pvrezende/Dashboard/public/img/rosqueadeira.png

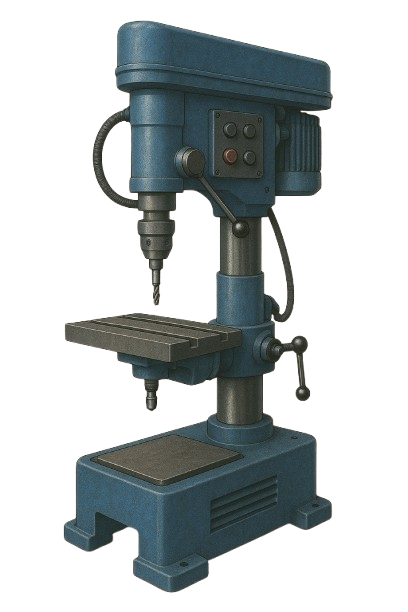
public/img/rosqueadeira.png
