pvrezende/Dashboard/public/img/torno.png

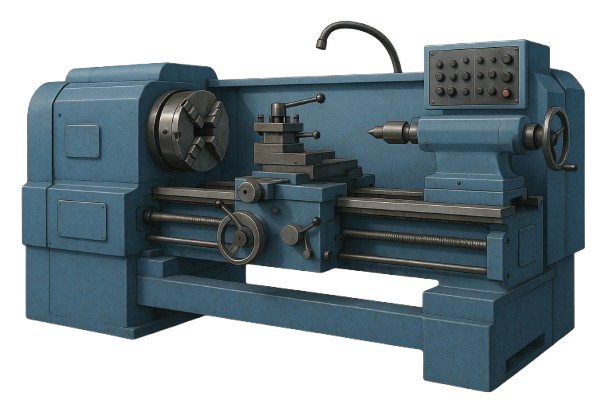
public/img/torno.png
