pvrezende/Dashboard/uploads/anexo-1752686390000-433832440.pdf

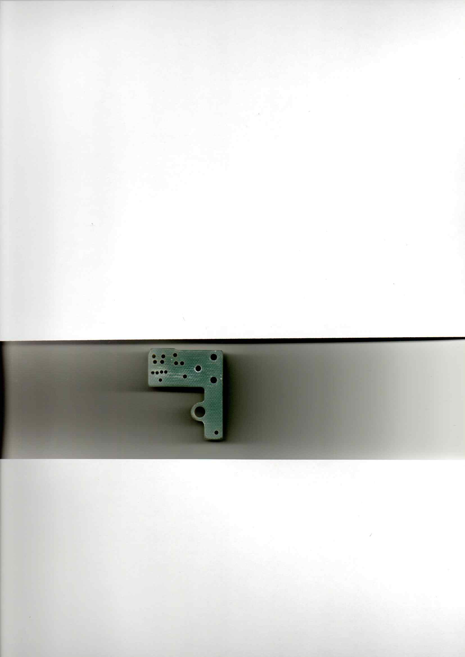
[picture p3: page 1]
