pvrezende/Dashboard/public/img/fresagem.png

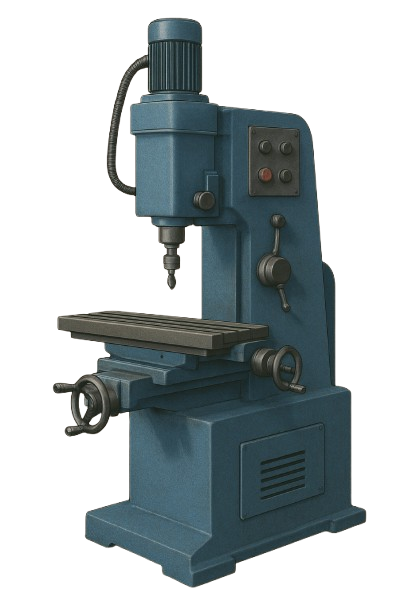
public/img/fresagem.png
