pvrezende/Dashboard/public/img/serra.png

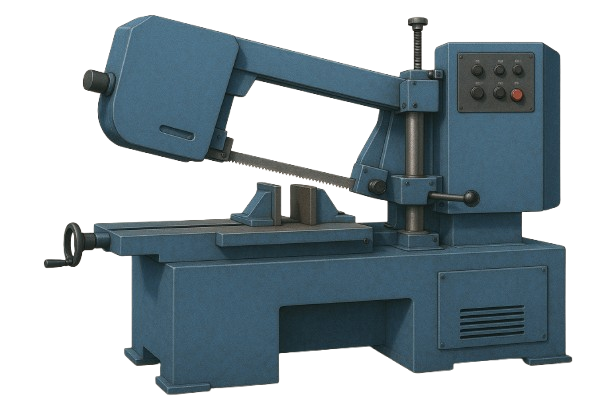
public/img/serra.png
