pvrezende/Dashboard/public/img/usinagem.png

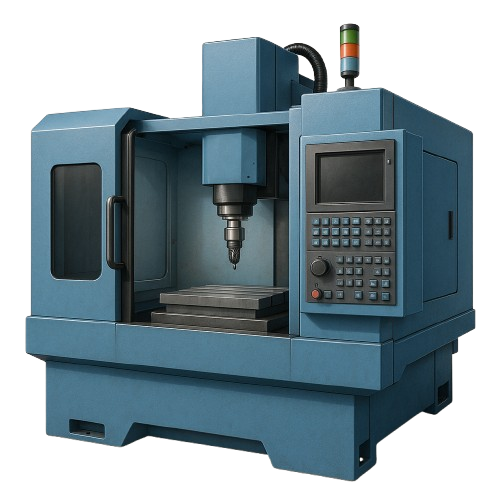
public/img/usinagem.png
