pvrezende/Dashboard/uploads/anexo-1753989220200-650113671.png

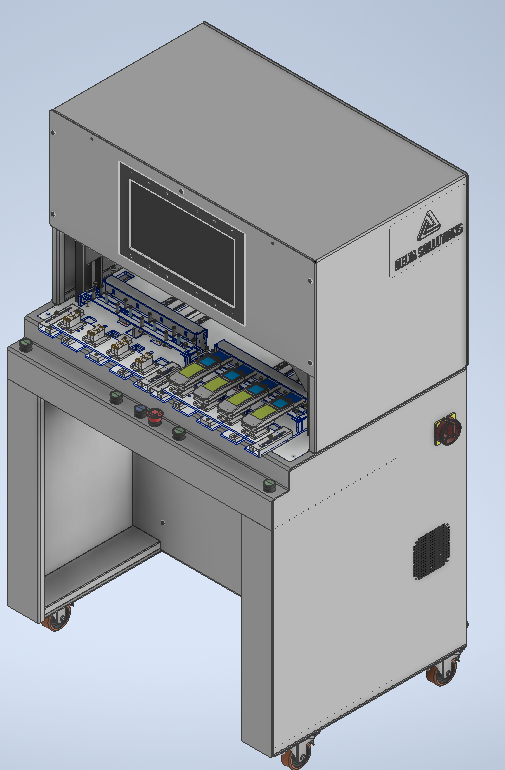
uploads/anexo-1753989220200-650113671.png
