pvrezende/Dashboard/uploads/shoppingFiles-1759435416785-901316125.xlsx

DOCUMENTO DE ESPECIFICAÇÃO DE COMPRAS |  |  |  | DATA: | 2024-10-07 | Codigo/ Revisão: FO-PR-005.A9/03
 |  |  |  | AREA SOLICITTANTE: | Automação
 |  |  |  | SOLICITANTE: | Matheus Coelho Cardoso
 |  |  |  | PROJETO: | TESTADOR DE CONTROLE - MIDEA
ITEM | CÓDIGO DO FABRICANTE | DESCRIÇÃO COMPLETA DO ITEM | U.M. | QUANTIDADE | FOTO DO ITEM | JUSTIFICATIVA DE AQUISIÇÃO | VALOR UNITÁRIO | VALOR TOTAL | STATUS
 | Ou Link | (Em caso de itens internacionais descrição em inglês)
1 | https://produto.mercadolivre.com.br/MLB-3895741120-modulo-pwm-de-alta-potncia-mosfet-400w-15a-_JM | Módulo Pwm De Alta Potência Mosfet 400w 15a |  | 10 |  | Relé PWM | R$15.99 | R$159.90
2 | https://produto.mercadolivre.com.br/MLB-2219533485-fonte-de-alimentaco-chaveada-120w-24v-5a-110-220v-_JM | Fonte De Alimentação Chaveada 120w 24v 5a 110-220v |  | 2 |  | Alimentação de 24V | R$33.90 | R$67.80
 | https://produto.mercadolivre.com.br/MLB-3361664873-fonte-chaveada-3v-colmeia-5a-industrial-bivolt-_JM | Fonte Chaveada 3v Colméia 5a Industrial Bivolt |  | 2 |  | Alimentação 3V | R$69.90 | R$139.80
 | https://www.mercadolivre.com.br/fonte-de-alimentaco-chaveada-500w-48v-10a-127-220v-bivolt/p/MLB29554100 | Fonte De Alimentação Chaveada 500w 48v 10a 127-220v Bivolt |  | 2 |  | Alimentação de 48V | R$125.00 | R$150.00
3 | https://www.mercadolivre.com.br/fonte-chaveada-5v-10a-50w-luckfoyu-tb-1605-bivolt-colmeia/p/MLB27683408 | Fonte Chaveada 5v 10a 50w Luckfoyu Tb-1605 Bivolt Colmeia |  | 2 |  | Alimentação de 5V | R$90.00 | R$180.00
 | https://produto.mercadolivre.com.br/MLB-3699531706-placa-mega-2560-pro-mini-atmega2560-compativel-com-arduino-_JM | Placa Mega 2560 Pro Mini Atmega2560 (compatível Com Arduino) |  | 2 |  | Microcontrolador | R$149.00 | R$298.00
 | https://produto.mercadolivre.com.br/MLB-1458934990-placa-nano-v3-com-suporte-borne-cabo-usb-compativel-arduino-_JM | Placa Nano V3 Com Suporte Borne, Cabo Usb Compatível Arduino |  | 8 |  | Arduinos Nano | R$53.57 | R$428.56
 | https://www.mercadolivre.com.br/boto-emergncia-cogumelo-vermelho-com-trava-1nf-22mm-1un/p/MLB29551151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 | Botão Emergência Cogumelo Vermelho Com Trava 1nf 22mm - 1un |  | 2 |  | Parada de Emergência | R$21.65 | R$43.30
 | https://www.mercadolivre.com.br/botao-de-impulso-plastico-verde-22mm-1na-brasiltec/p/MLB32004990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 | Botao De Impulso Plastico Verde 22mm 1na Brasiltec |  | 4 |  | Acionamento | R$17.50 | R$70.00
 | https://oceantech-automation.com.br/produtos/easy-servo-22kgf-nema-23-2-2n-m/ | Kit Motor De Passo 22kgf.cm Com Encoder (easy Servo)+ Driver |  | 2 |  | Servo Driver +Motor | R$640.00 | R$1280.00
 | https://produto.mercadolivre.com.br/MLB-3294397093-valvula-solenoidemola-52-vias-rosca-14-pneumatica-24v-dc-_JM | Válvula Solenoide/mola 5/2 Vias Rosca 1/4 Pneumática 24v Dc |  | 2 |  | Acionamento e Segurança do Pistão | R$63.89 | R$127.78
 | (NÃO ACHEI NA INTERNET PRA VENDA) | PLACA BORNE MEGA |  | 2 |  | Placa Borne para arduino mega |  | R$0.00
 | https://produto.mercadolivre.com.br/MLB-4553267862-micro-pc-lenovo-m900-i5-6500t-ddr4-16gb-ssd-512gb-wifi-_JM | Micro Pc Lenovo M900 I5-6500t, Ddr4 16gb, Ssd 512gb, Wifi |  | 2 |  | Mini-PC | R$1599.00 | R$3198.00
 | https://produto.mercadolivre.com.br/MLB-2727300538-tela-lcd-de-7-polegadas-para-raspberry-pi4-touch-1024x600-_JM | Tela Lcd De 7 Polegadas Para Raspberry Pi4 Touch 1024x600 |  | 2 |  | Tela | R$549.00 | R$1098.00
 | https://produto.mercadolivre.com.br/MLB-4379692838-kit-525x-resistores-17-valores-14w-1-0-ohm-1m-ohm-_JM | Kit 525x Resistores 17 Valores 1/4w 1% 0 Ohm ~ 1m Ohm |  | 2 |  | Kit de resistores | R$62.00 | R$124.00
 | https://produto.mercadolivre.com.br/MLB-1292249125-4x-fim-de-curso-optico-impressora-3d-cabo-50cm-endstop-_JM | 4x Fim De Curso Óptico Impressora 3d Cabo 50cm Endstop |  | 2 |  | Sensor optico | R$42.40 | R$84.80
 | https://www.mercadolivre.com.br/modulo-rele-1-canal-led-indicador-para-arduino-pi-pic-5v10a/p/MLB35503346 | Modulo Rele 1 Canal Led Indicador Para Arduino Pi Pic 5v/10a |  | 2 |  | Relé acionamento GND | R$12.35 | R$24.70
 | https://www.mercadolivre.com.br/chave-gangorra-iluminada-liga-desliga-4-polos-110220v/p/MLB23519608 | Chave Gangorra Iluminada Liga Desliga 4 Pólos 110/220v |  | 2 |  | Usinagem de peças para máquina | R$11.30 | R$22.60
 | Sinaleiro Led Vermelho Monobloco 127/220v 22mm | MercadoLivre (https://produto.mercadolivre.com.br/MLB-3207978312-sinaleiro-led-vermelho-monobloco-127220v-22mm-_JM) | Sinaleiro De Led Vermelho Weg 22mm 220vca Ip54 Cew-sm1-d23 |  | 2 |  | Sinalizador LED | R$15.00 | R$30.00
 | https://produto.mercadolivre.com.br/MLB-1710785661-par-conector-mike-gx12-plug-macho-fmea-6-pinos-cabo-cabo-_JM | Par Conector Mike Gx12 Plug Macho + Fêmea 6 Pinos Cabo-cabo |  | 2 |  | Conector Mike | R$32.81 | R$65.62
 | https://produto.mercadolivre.com.br/MLB-2751476071-micro-ventilador-cooler-80x80x25-cooler-24v-020a-80mm-_JM | Micro Ventilador Cooler 80x80x25 Cooler 24v 0,20a 80mm |  | 1 |  | Ventoinha | R$19.00 | R$19.00
 | https://www.mercadolivre.com.br/webcam-full-hd-logitech-c920s-com-microfone-embutido-cor-preto/p/MLB18351904 | Webcam Full Hd Logitech C920s Com Microfone Embutido Cor Preto |  | 8 |  | Câmeras | R$499.00 | R$3992.00
 | https://produto.mercadolivre.com.br/MLB-4545673406-borne-saki-de-passagem-25mm-eletrico-kit-100-unidades-_JM | Borne Saki De Passagem 2,5mm Elétrico - Kit 100 Unidades |  | 1 |  | Bornes | R$163.00 | R$163.00
 | https://produto.mercadolivre.com.br/MLB-3649127615-kit-alicate-crimpar-descascador-1200-terminais-ilhos-tubular-_JM | Kit Alicate Crimpar Descascador 1200 Terminais Ilhós Tubular |  | 1 |  | Materiais para manusear | R$124.99 | R$124.99
 | https://www.mercadolivre.com.br/ugreen-cabo-de-celular-carga-rapida-turbo-micro-usb-v8-1m/p/MLB22989129 | Ugreen Cabo De Celular Carga Rápida Turbo Micro Usb V8 1m |  | 4 |  | 1 Cabo pro arduino, outro cabo pro PC | R$29.35 | R$117.40
 | https://produto.mercadolivre.com.br/MLB-1773070278-conexo-pneumatica-emenda-passa-muro-unio-painel-6mm-4pcs-_JM | Conexão Pneumática Emenda Passa Muro União Painel Ø6mm 4pçs |  | 2 |  | Conexão Pneumatica | R$37.04 | R$74.08
 | https://www.mercadolivre.com.br/tomada-p-moveis-embutir-margirius-2p-t-branca-20a-250v/p/MLB22760926 | Tomada P/ Moveis Embutir Margirius 2p T Branca 20a 250v |  | 2 |  | Tomada pra fixar a alimentação do PC | R$16.97 | R$33.94
 |  |  |  |  |  |  |  | R$0.00
 |  |  |  |  |  |  |  | R$0.00
 |  |  |  |  |  |  |  | R$0.00
 |  |  |  |  |  |  |  | R$0.00
 |  |  |  |  |  |  |  | R$0.00
 |  |  |  |  |  |  | R$3.00 | R$0.00
 |  |  |  |  |  |  | R$4.00 | R$0.00
 |  |  |  |  |  |  | R$5.00 | R$0.00
