pvrezende/Dashboard/uploads/shoppingFiles-1759509647916-797304005.xlsx

Fornecedor | Material ou Produto | Quantidade | Valor Unitário (R$) | Valor Total (R$)
Fornecedor TechSoft | Licença Sistema ERP | 10 | 1200 | 12000
Fornecedor CloudX | Serviço de Hospedagem Cloud | 12 | 300 | 3600
Fornecedor HardPlus | Notebooks para Desenvolvedores | 5 | 4500 | 22500
Metalúrgica Alfa | Chapas de Aço Inox (m²) | 15 | 250 | 3750
Parafusos & Cia | Parafusos Allen M6 (caixa c/ 100) | 20 | 80 | 1600
Rolamentos Mundial | Rolamentos Industriais SKF 6205 | 50 | 45 | 2250
Usinagem Express | Serviço de Usinagem de Peças | 1 | 3500 | 3500
Pneumática Brasil | Cilindro Pneumático Dupla Ação | 10 | 180 | 1800
