pvrezende/Dashboard/uploads/anexo-1755619367089-582211943.stp

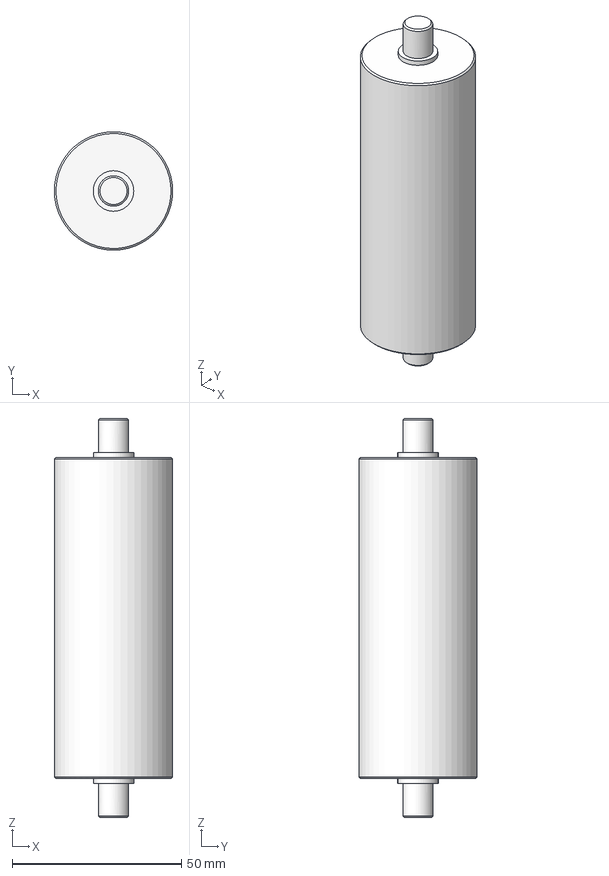
[picture p8: CAD file, 2025-12-10]
uploads/anexo-1755619367089-582211943.stp
35.0 x 35.0 x 118.0 mm
