pvrezende/Dashboard/uploads/anexo-1755977767421-222420170.stp

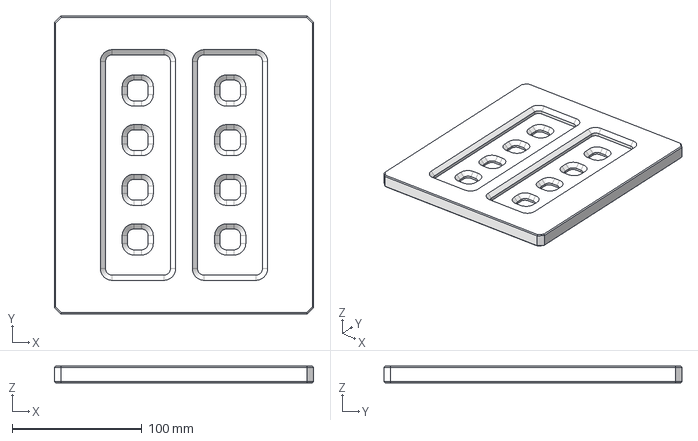
[picture p9: CAD file, 2025-12-10]
uploads/anexo-1755977767421-222420170.stp
200.0 x 230.0 x 13.0 mm
