pvrezende/Dashboard/uploads/anexo-1759258993743-352252495.stp

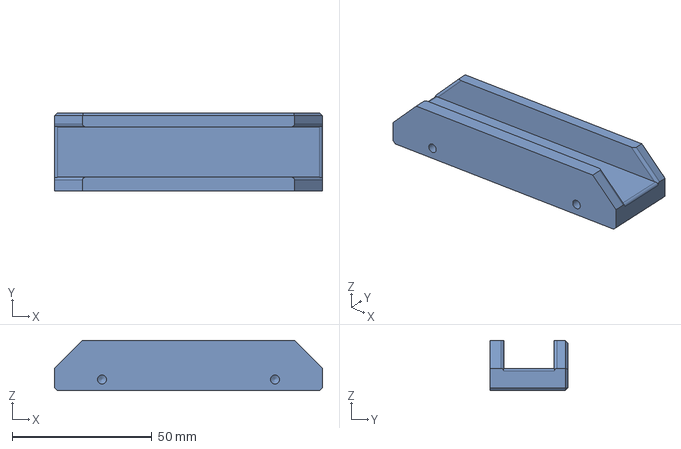
[picture p10: CAD file, 2025-12-10]
uploads/anexo-1759258993743-352252495.stp
96.0 x 28.0 x 18.0 mm
