pvrezende/Dashboard/uploads/anexo-1759407413389-112260703.stp

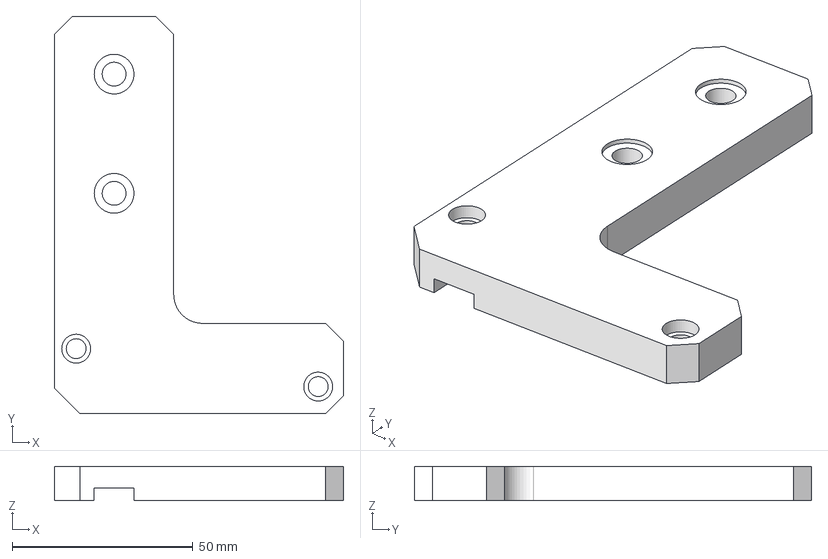
[picture p11: CAD file, 2025-12-10]
uploads/anexo-1759407413389-112260703.stp
80.0 x 110.0 x 9.50 mm
