pvrezende/Dashboard/uploads/anexo-1755277294046-452424517.stp

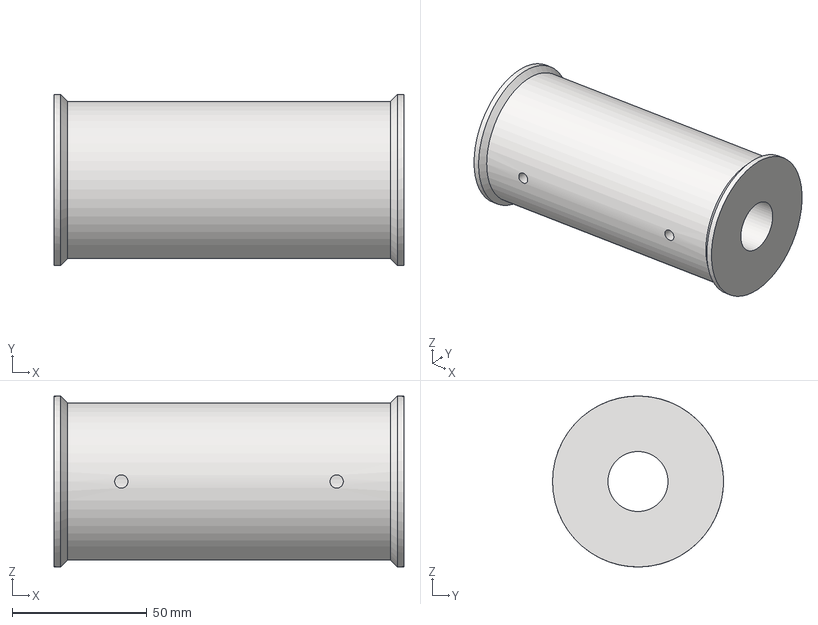
[picture p12: CAD file, 2025-12-10]
uploads/anexo-1755277294046-452424517.stp
130.0 x 63.5 x 63.5 mm
