pvrezende/Dashboard/uploads/anexo-1756152582463-837896890.stp

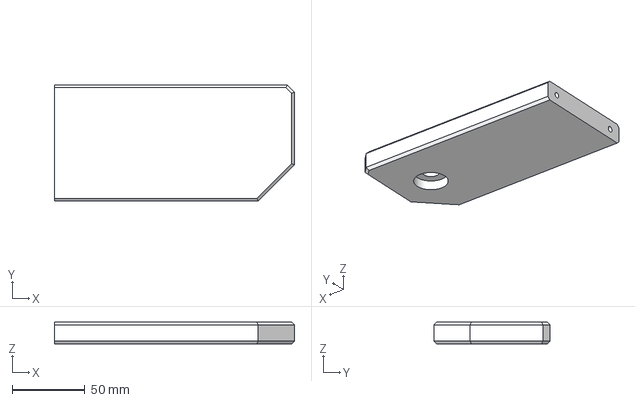
[picture p13: CAD file, 2025-12-10]
uploads/anexo-1756152582463-837896890.stp
165.0 x 80.0 x 15.0 mm
