pvrezende/Dashboard/uploads/anexo-1756211929346-225866010.stp

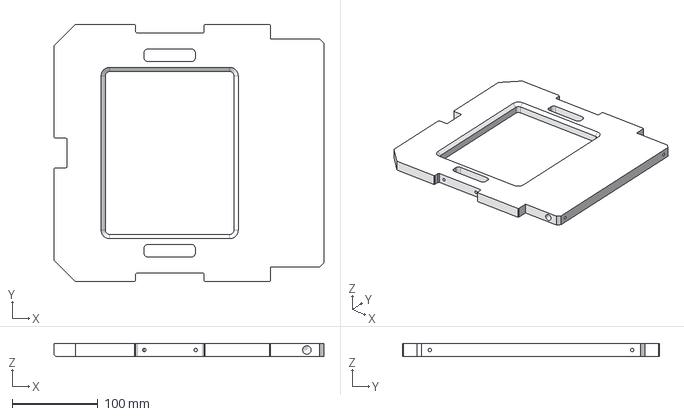
[picture p14: CAD file, 2025-12-10]
uploads/anexo-1756211929346-225866010.stp
315.0 x 300.0 x 15.0 mm
