pvrezende/Dashboard/uploads/anexo-1757349374916-749535354.stp

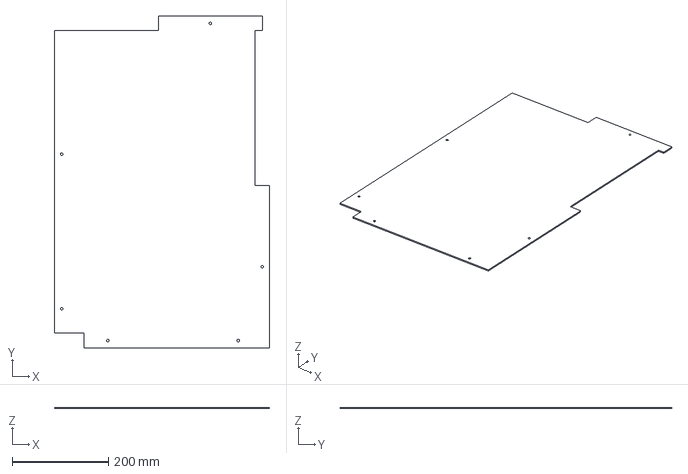
[picture p15: CAD file, 2025-12-10]
uploads/anexo-1757349374916-749535354.stp
447.5 x 690.0 x 3.00 mm
