pvrezende/Dashboard/uploads/anexo-1757426994277-990236841.stp

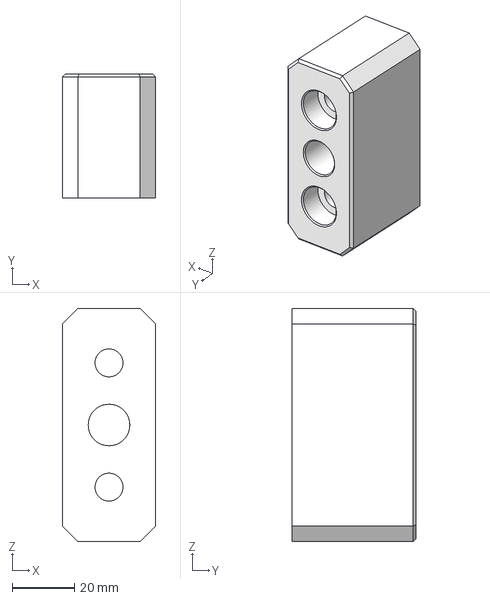
[picture p16: CAD file, 2025-12-10]
uploads/anexo-1757426994277-990236841.stp
30.0 x 40.0 x 75.0 mm
