pvrezende/Dashboard/uploads/anexo-1757960000784-294846937.stp

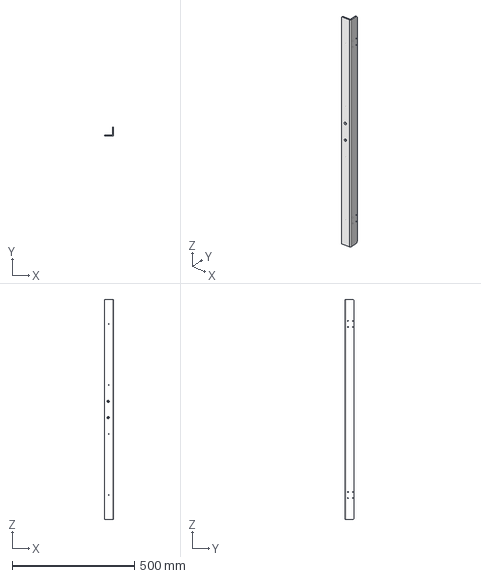
[picture p17: CAD file, 2025-12-10]
uploads/anexo-1757960000784-294846937.stp
38.0 x 38.0 x 900.0 mm
