pvrezende/Dashboard/uploads/anexo-1757949830074-938760294.stp

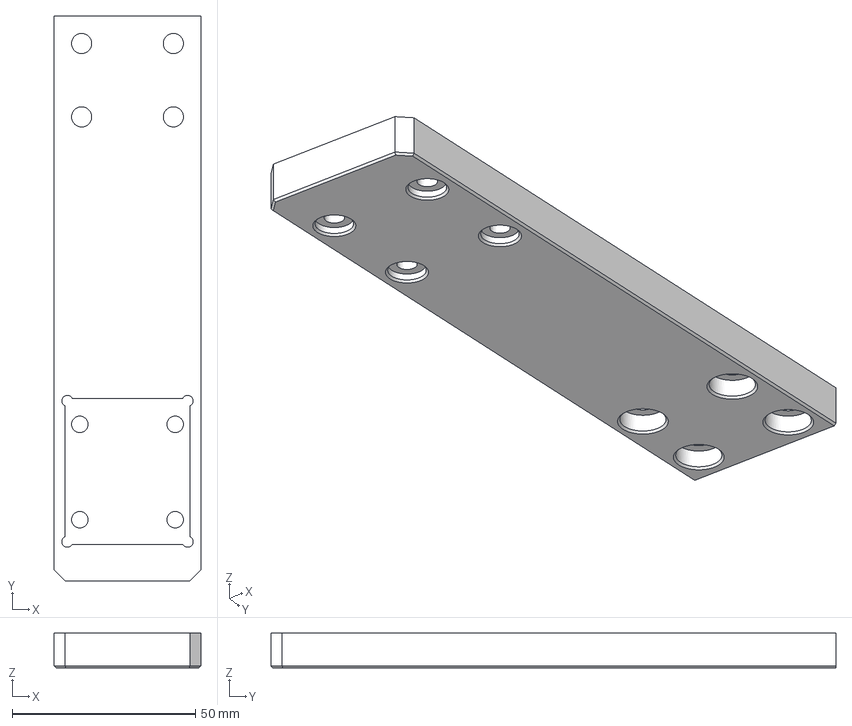
[picture p18: CAD file, 2025-12-10]
uploads/anexo-1757949830074-938760294.stp
40.0 x 154.0 x 9.50 mm
