pvrezende/Dashboard/uploads/anexo-1756295821508-154803163.stp

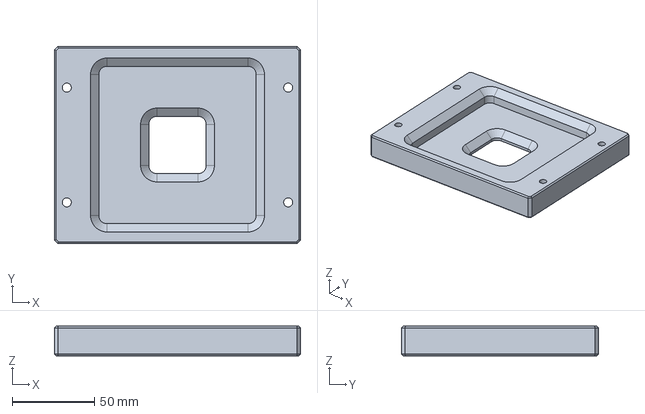
[picture p19: CAD file, 2025-12-10]
uploads/anexo-1756295821508-154803163.stp
150.0 x 120.0 x 18.0 mm
