pvrezende/Dashboard/uploads/anexo-1759337285169-542138132.stp

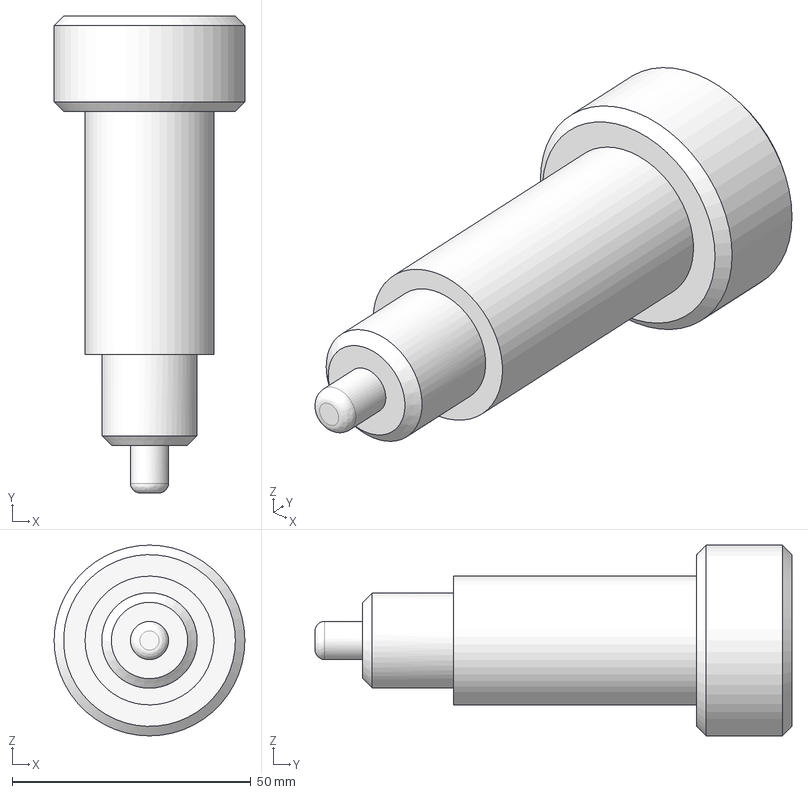
[picture p20: CAD file, 2025-12-10]
uploads/anexo-1759337285169-542138132.stp
40.0 x 100.0 x 40.0 mm
