pvrezende/Dashboard/uploads/anexo-1759334856701-153851195.stp

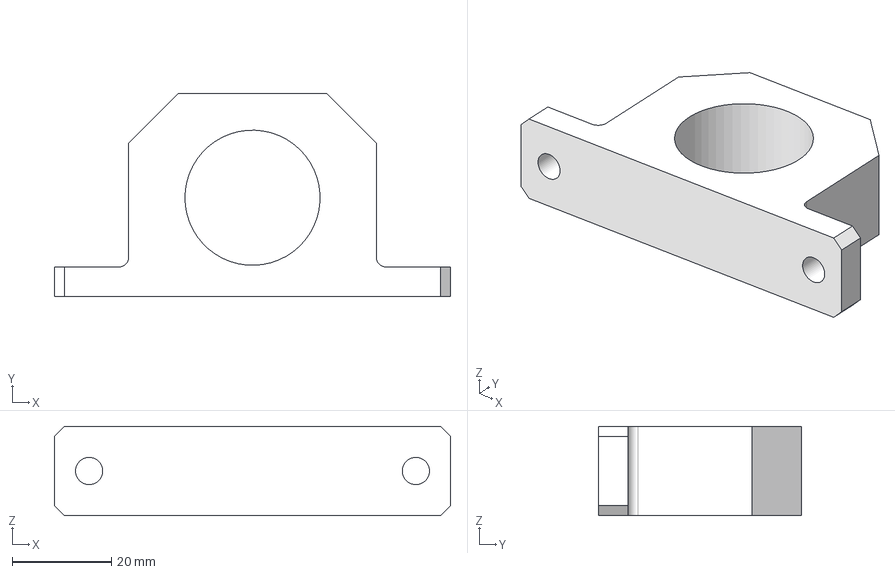
[picture p21: CAD file, 2025-12-10]
uploads/anexo-1759334856701-153851195.stp
80.0 x 41.1 x 18.0 mm
