pvrezende/Dashboard/uploads/anexo-1755618676830-448197962.stp

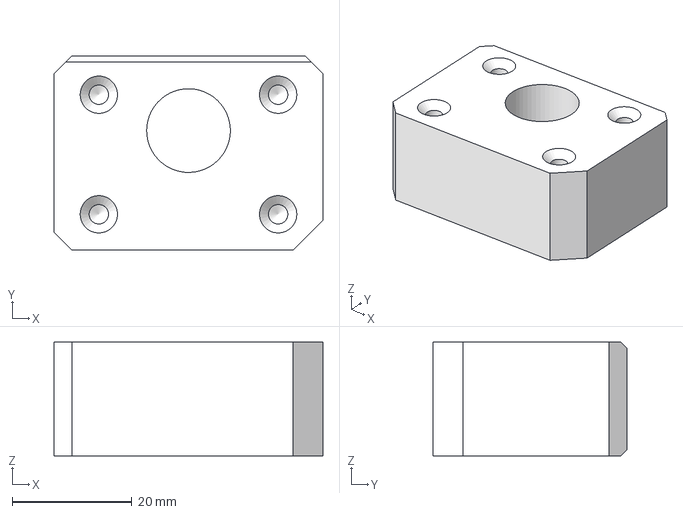
[picture p22: CAD file, 2025-12-10]
uploads/anexo-1755618676830-448197962.stp
45.0 x 32.5 x 19.0 mm
