pvrezende/Dashboard/uploads/anexo-1756234700509-750401032.stp

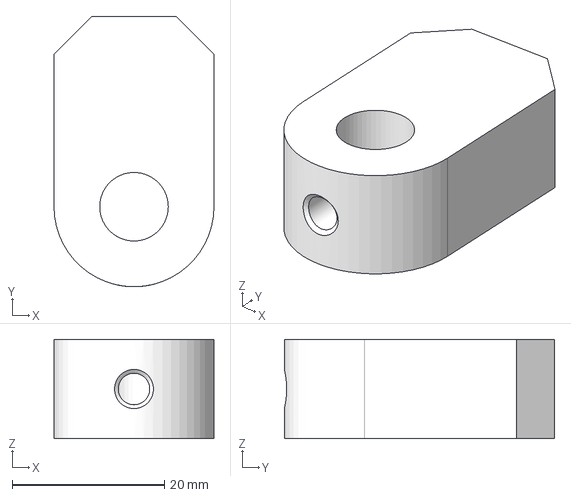
[picture p23: CAD file, 2025-12-10]
uploads/anexo-1756234700509-750401032.stp
21.0 x 35.5 x 13.0 mm
