pvrezende/Dashboard/uploads/anexo-1759334679638-42704749.stp

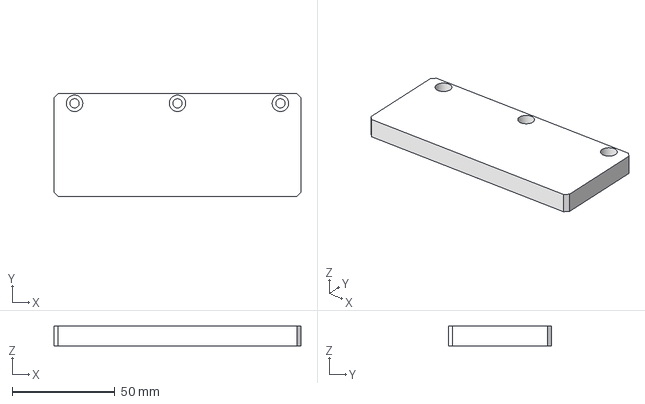
[picture p25: CAD file, 2025-12-10]
uploads/anexo-1759334679638-42704749.stp
120.0 x 50.0 x 9.50 mm
