pvrezende/Dashboard/uploads/anexo-1756231120353-109292809.stp

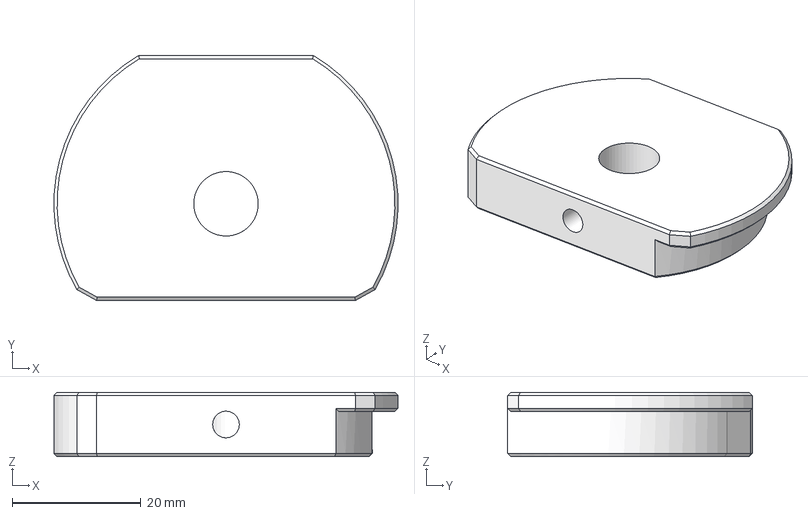
[picture p26: CAD file, 2025-12-10]
uploads/anexo-1756231120353-109292809.stp
53.4 x 38.0 x 10.0 mm
