pvrezende/Dashboard/uploads/anexo-1757434504783-396487660.stp

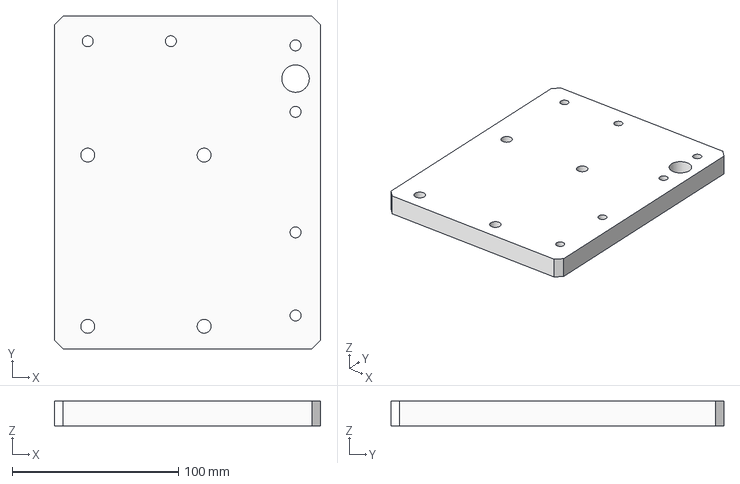
[picture p27: CAD file, 2025-12-10]
uploads/anexo-1757434504783-396487660.stp
160.0 x 200.0 x 15.0 mm
