pvrezende/Dashboard/uploads/anexo-1759259124389-321376581.stp

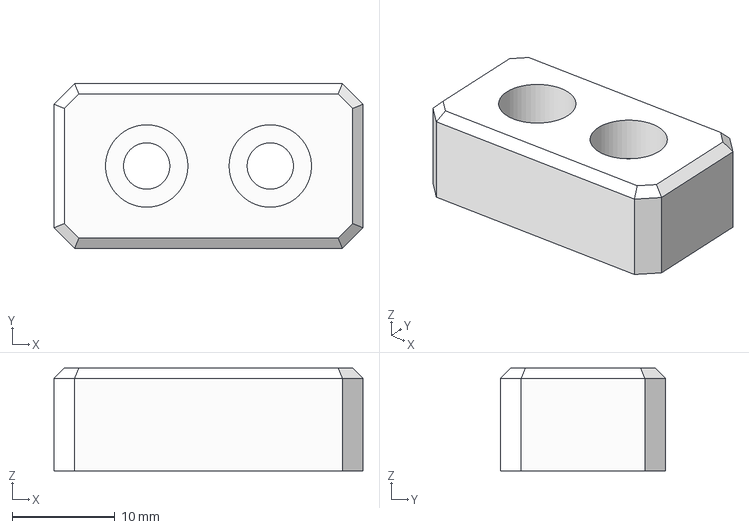
[picture p28: CAD file, 2025-12-10]
uploads/anexo-1759259124389-321376581.stp
30.0 x 16.0 x 10.0 mm
