pvrezende/Dashboard/uploads/anexo-1759259096695-601353581.stp

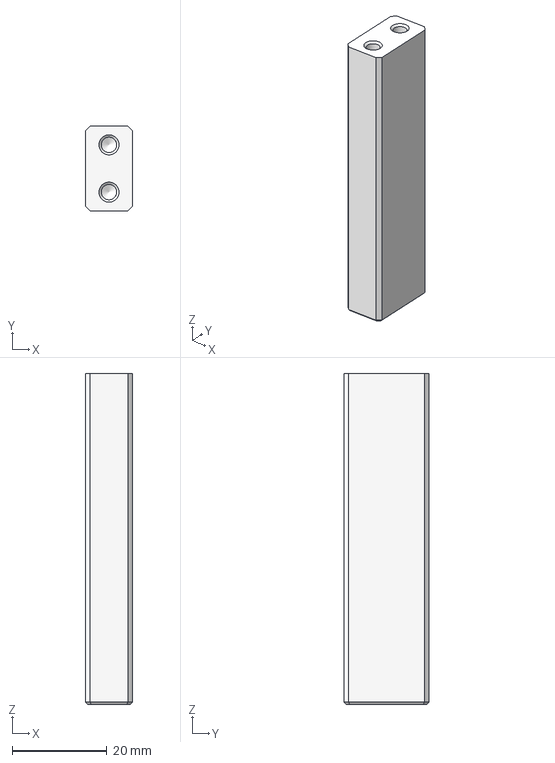
[picture p29: CAD file, 2025-12-10]
uploads/anexo-1759259096695-601353581.stp
10.0 x 18.0 x 70.0 mm
