pvrezende/Dashboard/uploads/anexo-1756388202260-343038873.stp

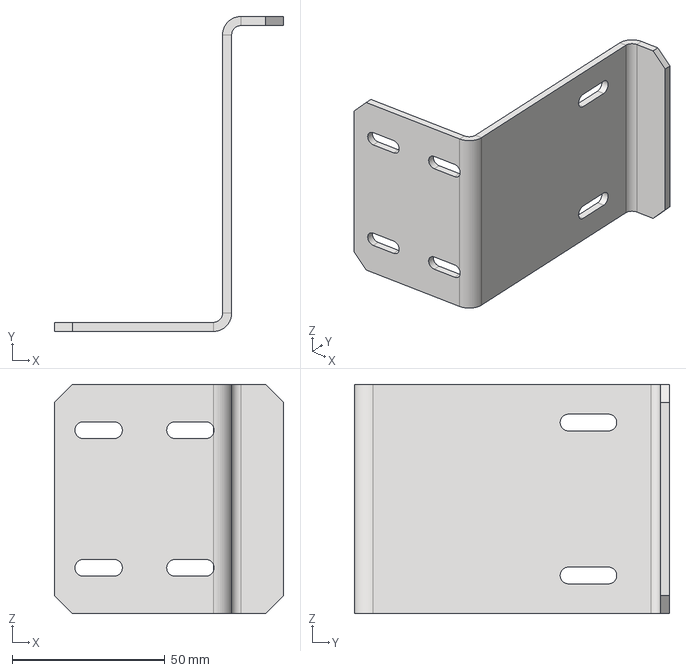
[picture p30: CAD file, 2025-12-10]
uploads/anexo-1756388202260-343038873.stp
75.0 x 103.0 x 75.0 mm
