pvrezende/Dashboard/uploads/anexo-1756215425746-165723948.stp

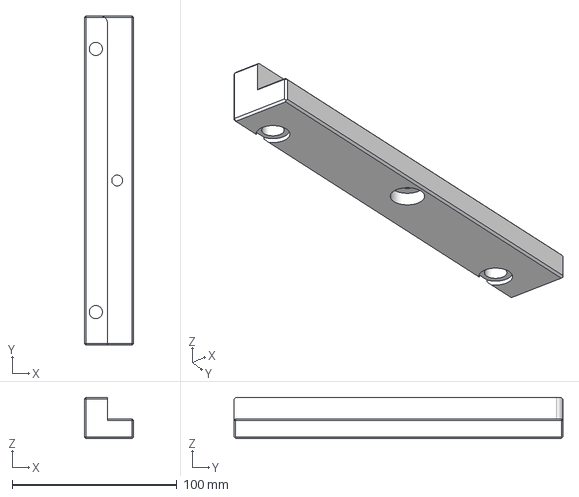
[picture p31: CAD file, 2025-12-10]
uploads/anexo-1756215425746-165723948.stp
30.0 x 200.0 x 25.0 mm
