pvrezende/Dashboard/uploads/anexo-1755282715223-240659663.stp

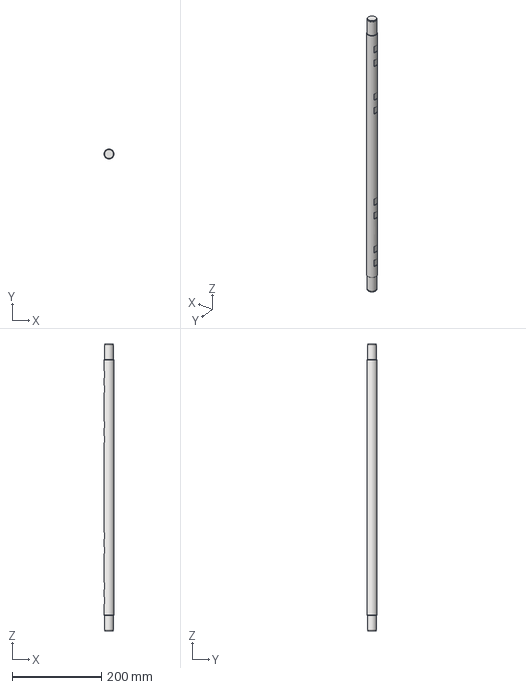
[picture p32: CAD file, 2025-12-10]
uploads/anexo-1755282715223-240659663.stp
22.3 x 22.3 x 644.0 mm
