pvrezende/Dashboard/uploads/anexo-1758050456845-185655093.stp

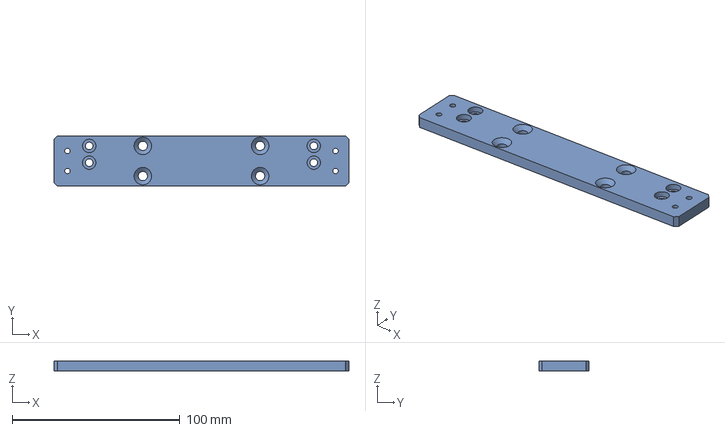
[picture p33: CAD file, 2025-12-10]
uploads/anexo-1758050456845-185655093.stp
176.0 x 30.0 x 6.00 mm
