pvrezende/Dashboard/uploads/anexo-1757961930850-707648905.stp

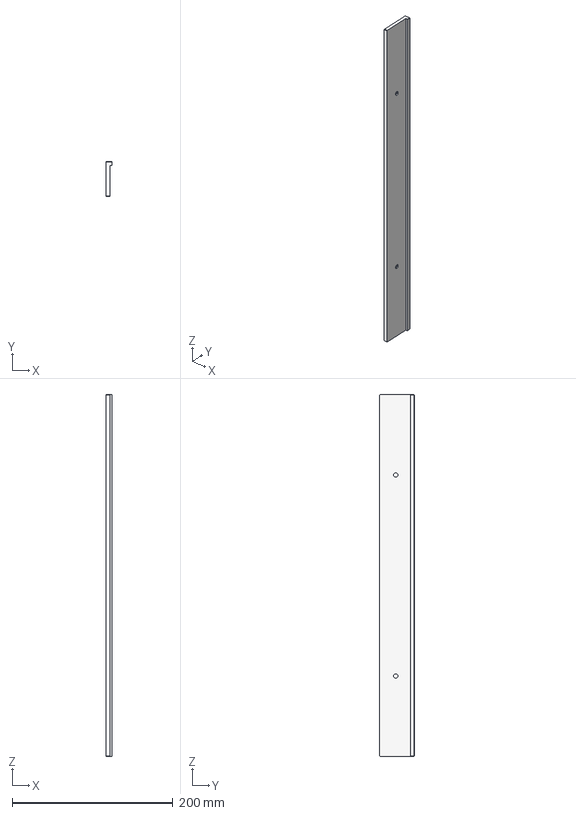
[picture p34: CAD file, 2025-12-10]
uploads/anexo-1757961930850-707648905.stp
8.00 x 43.0 x 450.0 mm
