pvrezende/Dashboard/uploads/anexo-1757965723555-153832355.stp

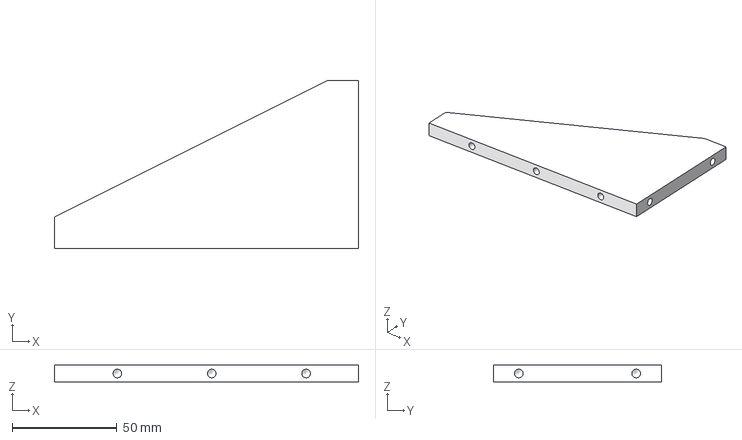
[picture p35: CAD file, 2025-12-10]
uploads/anexo-1757965723555-153832355.stp
145.0 x 80.0 x 8.00 mm
