pvrezende/Dashboard/uploads/anexo-1757431539895-93531511.stp

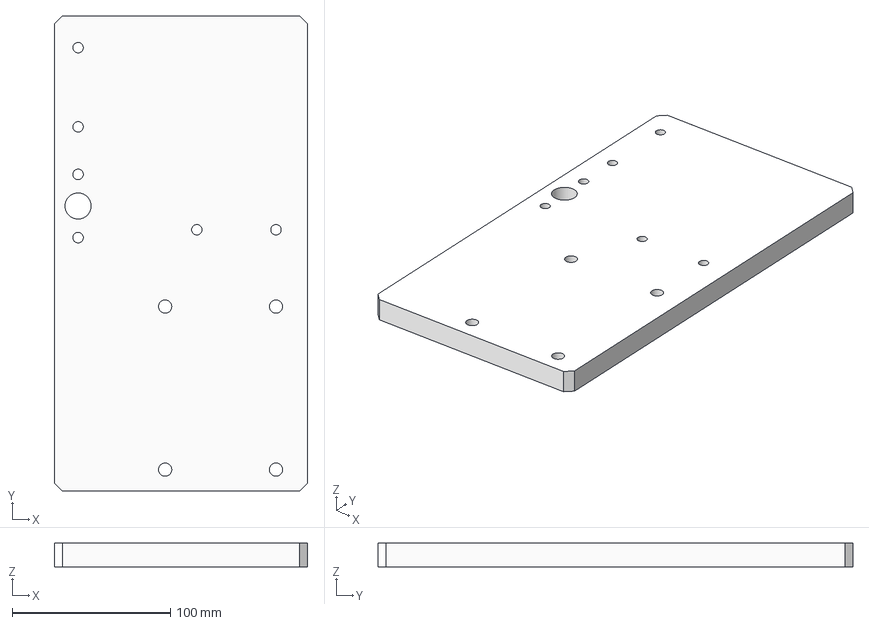
[picture p36: CAD file, 2025-12-10]
uploads/anexo-1757431539895-93531511.stp
160.0 x 300.0 x 15.0 mm
