pvrezende/Dashboard/uploads/anexo-1759258910165-679916647.stp

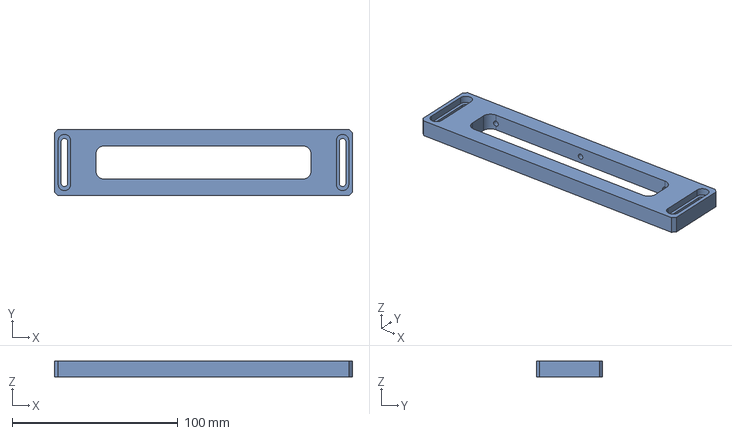
[picture p37: CAD file, 2025-12-10]
uploads/anexo-1759258910165-679916647.stp
180.0 x 40.0 x 9.50 mm
