pvrezende/Dashboard/uploads/anexo-1755960413573-520957161.stp

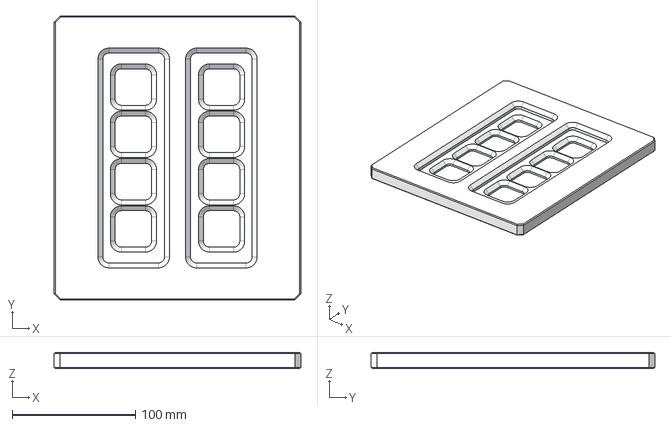
[picture p38: CAD file, 2025-12-10]
uploads/anexo-1755960413573-520957161.stp
200.0 x 230.0 x 13.0 mm
