pvrezende/Dashboard/uploads/anexo-1757965014062-793213751.stp

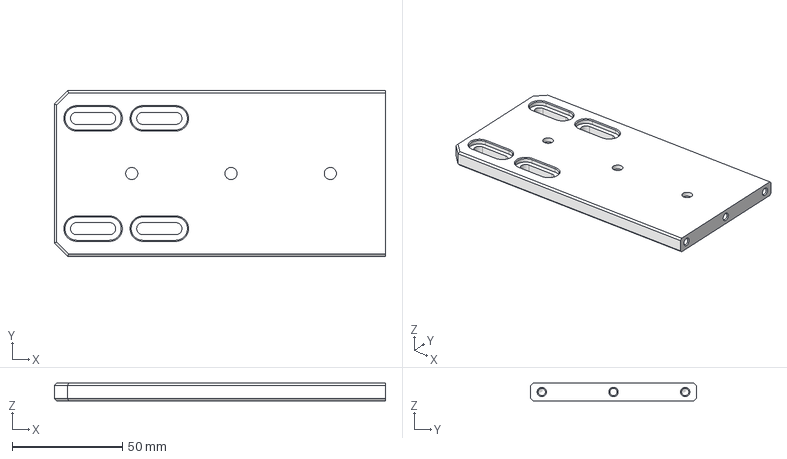
[picture p39: CAD file, 2025-12-10]
uploads/anexo-1757965014062-793213751.stp
150.0 x 75.0 x 8.00 mm
