pvrezende/Dashboard/uploads/anexo-1759335141929-791300150.stp

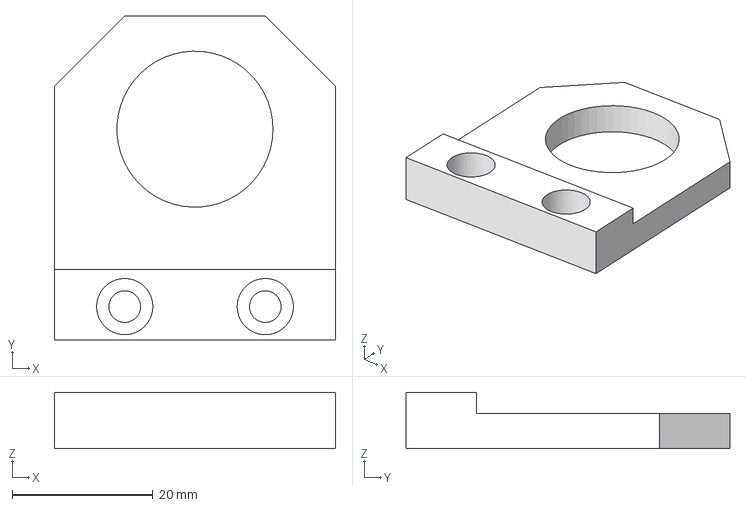
[picture p40: CAD file, 2025-12-10]
uploads/anexo-1759335141929-791300150.stp
40.0 x 46.1 x 8.00 mm
