pvrezende/Dashboard/uploads/anexo-1756920070701-269722857.stp

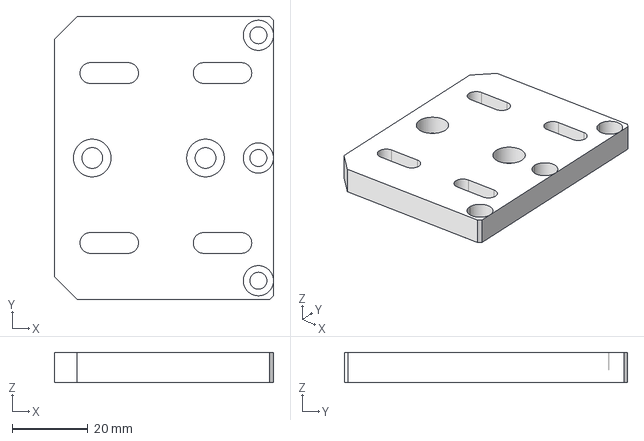
[picture p41: CAD file, 2025-12-10]
uploads/anexo-1756920070701-269722857.stp
58.0 x 75.0 x 8.00 mm
