pvrezende/Dashboard/uploads/anexo-1759942525839-402847594.stp

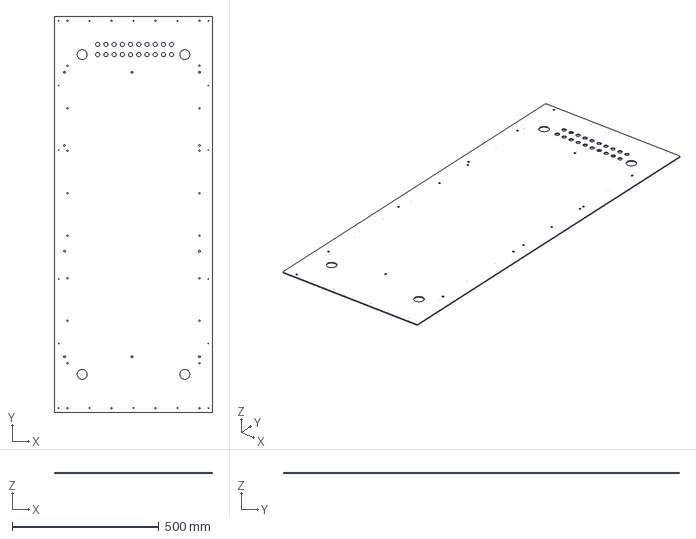
[picture p42: CAD file, 2025-12-10]
uploads/anexo-1759942525839-402847594.stp
540.0 x 1350.0 x 3.00 mm
