pvrezende/Dashboard/uploads/anexo-1755710686019-132028354.stp

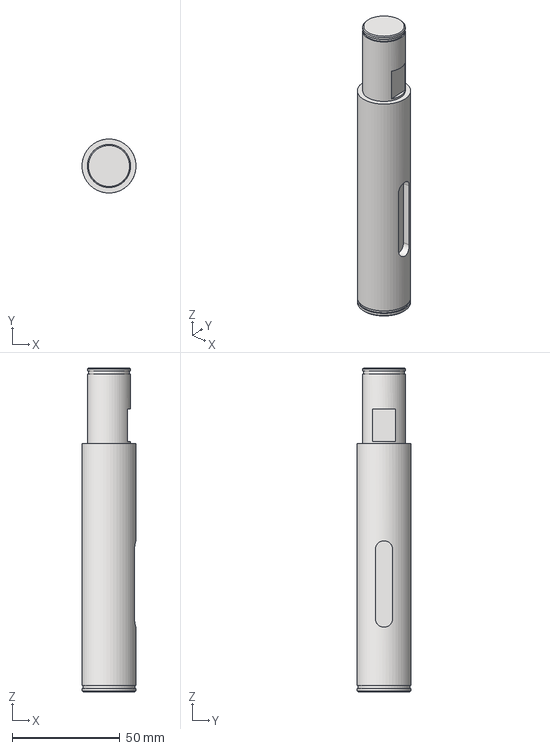
[picture p43: CAD file, 2025-12-10]
uploads/anexo-1755710686019-132028354.stp
25.0 x 25.0 x 150.0 mm
