pvrezende/Dashboard/uploads/anexo-1757962896268-849463138.stp

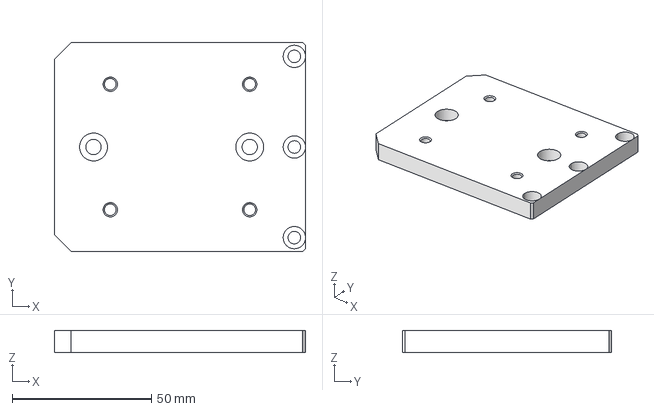
[picture p44: CAD file, 2025-12-10]
uploads/anexo-1757962896268-849463138.stp
90.0 x 75.0 x 8.00 mm
