pvrezende/Dashboard/uploads/anexo-1756301396644-289295940.stp

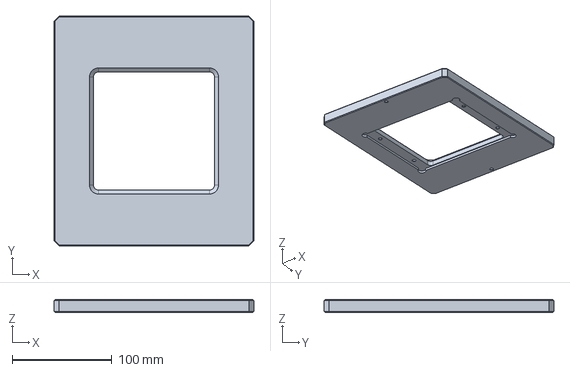
[picture p45: CAD file, 2025-12-10]
uploads/anexo-1756301396644-289295940.stp
200.0 x 230.0 x 13.0 mm
