pvrezende/Dashboard/uploads/anexo-1757945405982-827387971.stp

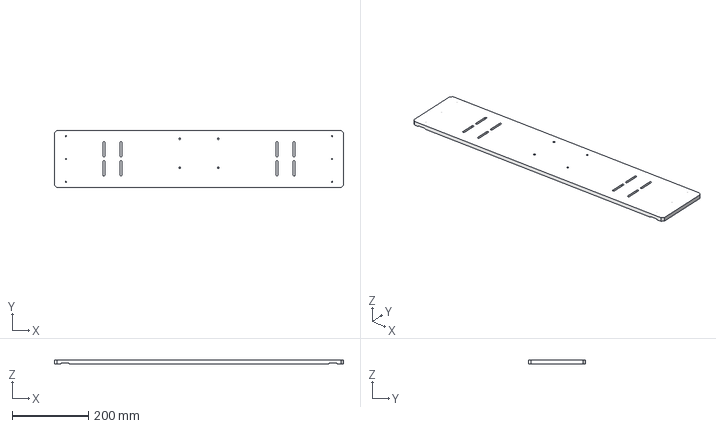
[picture p46: CAD file, 2025-12-10]
uploads/anexo-1757945405982-827387971.stp
760.0 x 150.0 x 10.0 mm
