pvrezende/Dashboard/uploads/anexo-1755284090802-26278536.stp

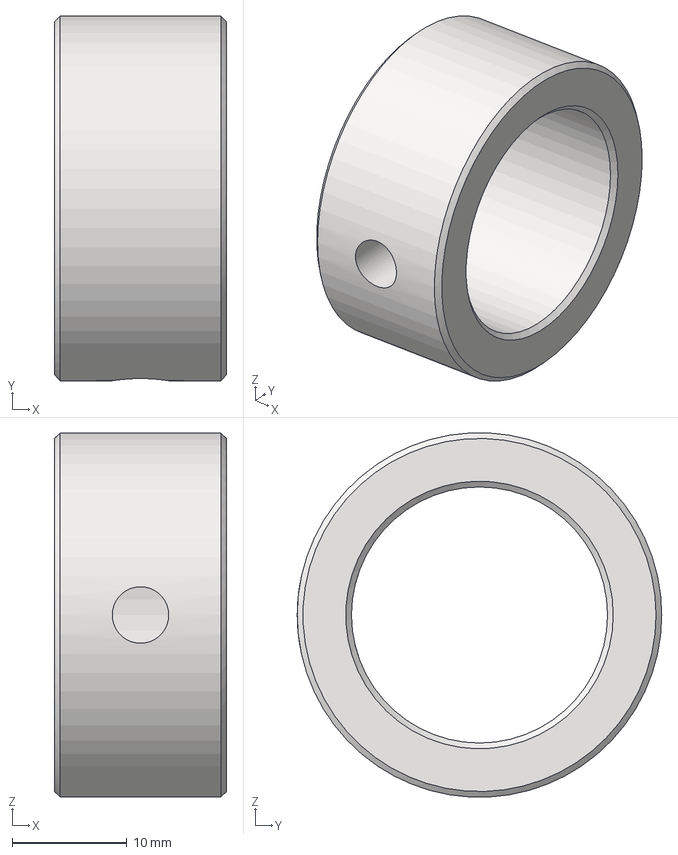
[picture p47: CAD file, 2025-12-10]
uploads/anexo-1755284090802-26278536.stp
15.0 x 31.8 x 31.7 mm
