pvrezende/Dashboard/uploads/anexo-1759334826198-582539110.stp

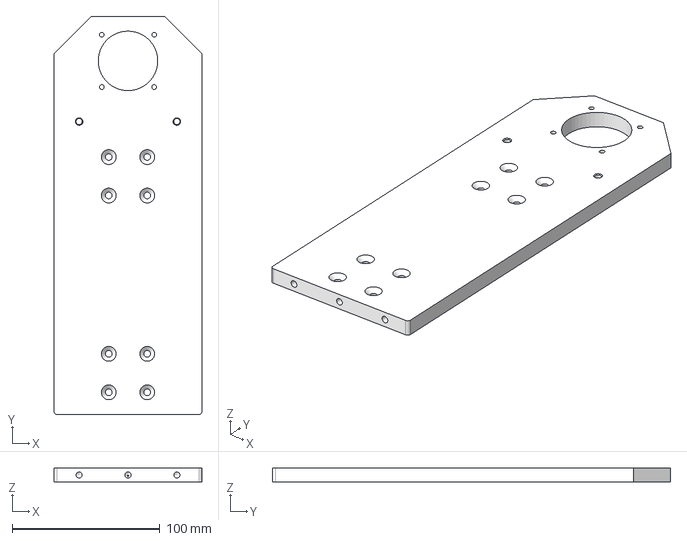
[picture p48: CAD file, 2025-12-10]
uploads/anexo-1759334826198-582539110.stp
100.0 x 269.0 x 9.50 mm
