pvrezende/Dashboard/uploads/anexo-1759334594509-304653331.stp

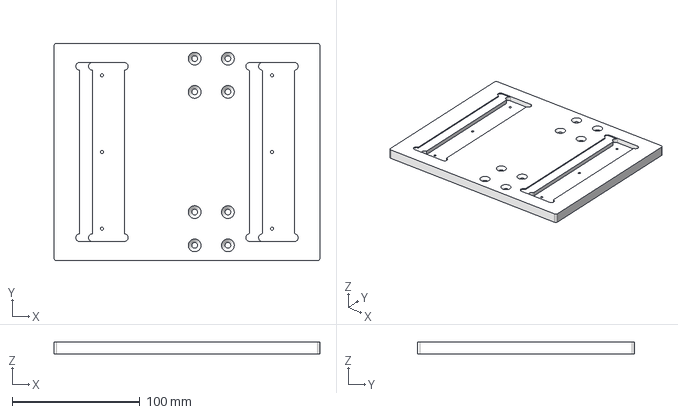
[picture p49: CAD file, 2025-12-10]
uploads/anexo-1759334594509-304653331.stp
208.0 x 170.0 x 9.50 mm
