pvrezende/Dashboard/uploads/anexo-1759334713700-940634273.stp

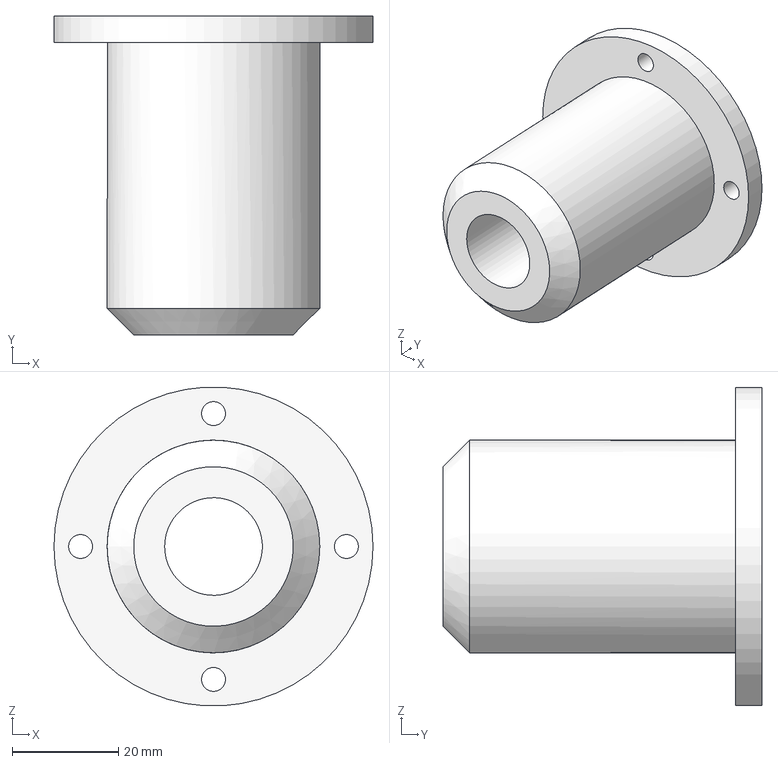
[picture p50: CAD file, 2025-12-10]
uploads/anexo-1759334713700-940634273.stp
60.0 x 60.0 x 59.9 mm
