pvrezende/Dashboard/uploads/anexo-1759963900780-953849092.stp

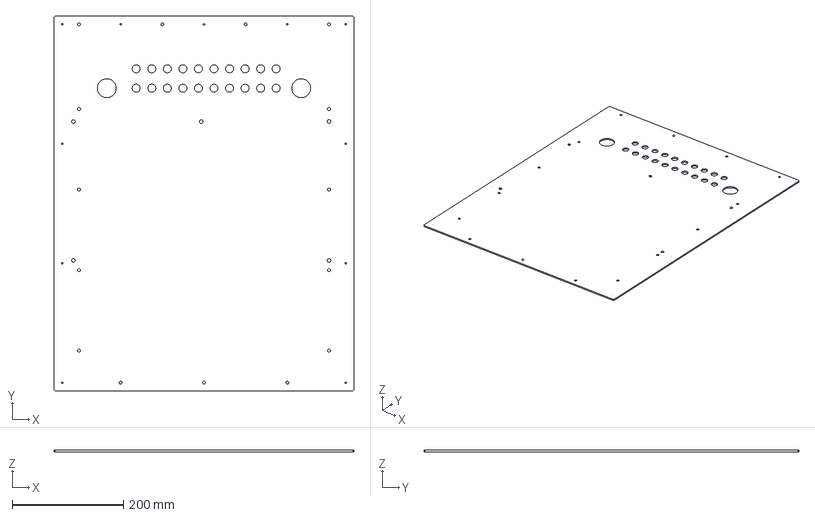
[picture p51: CAD file, 2025-12-10]
uploads/anexo-1759963900780-953849092.stp
540.0 x 675.0 x 3.00 mm
