pvrezende/Dashboard/uploads/anexo-1759435704824-352473999.stp

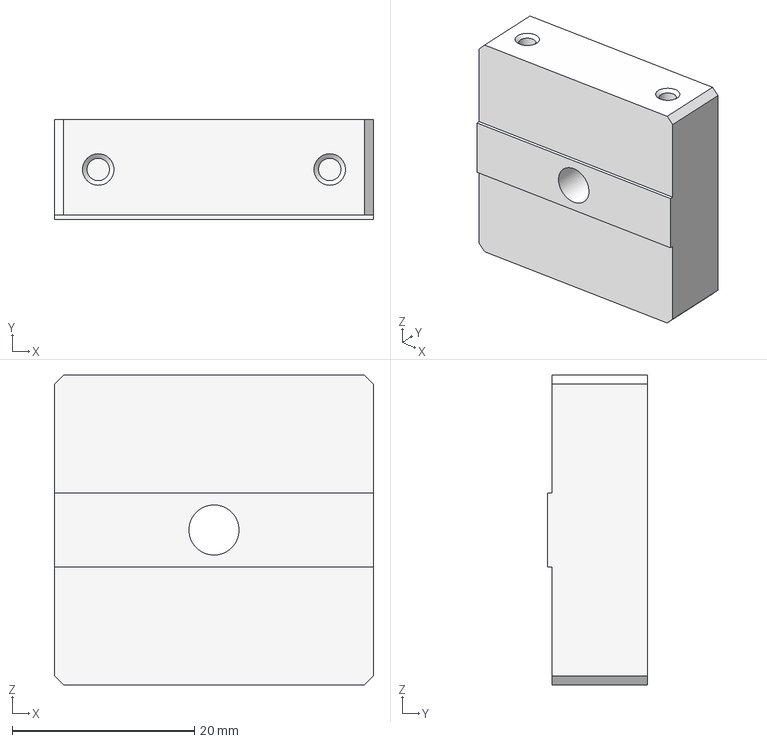
[picture p52: CAD file, 2025-12-10]
uploads/anexo-1759435704824-352473999.stp
35.0 x 11.0 x 34.0 mm
