pvrezende/Dashboard/uploads/anexo-1756920077284-315783341.stp

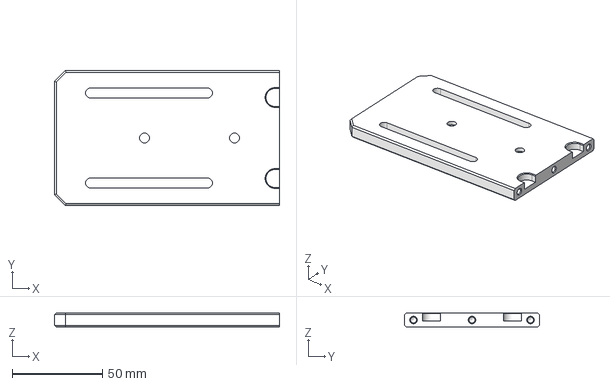
[picture p53: CAD file, 2025-12-10]
uploads/anexo-1756920077284-315783341.stp
125.0 x 75.0 x 8.00 mm
