pvrezende/Dashboard/uploads/anexo-1758555997940-475271792.stp

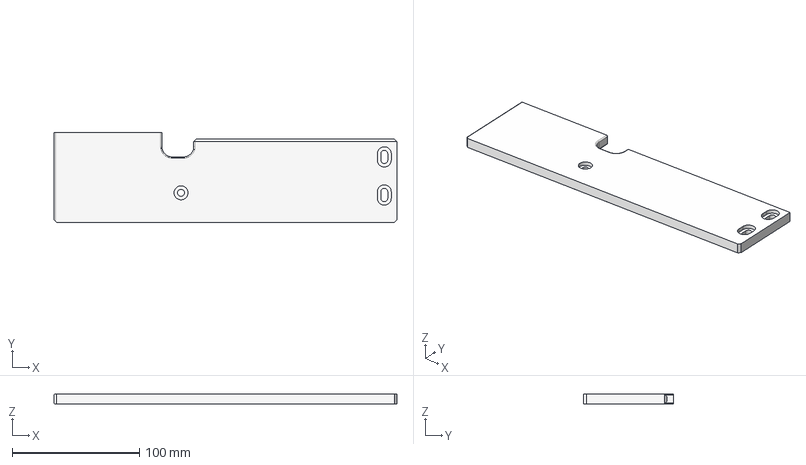
[picture p54: CAD file, 2025-12-10]
uploads/anexo-1758555997940-475271792.stp
270.0 x 70.5 x 8.00 mm
