pvrezende/Dashboard/uploads/anexo-1759258943508-12196623.stp

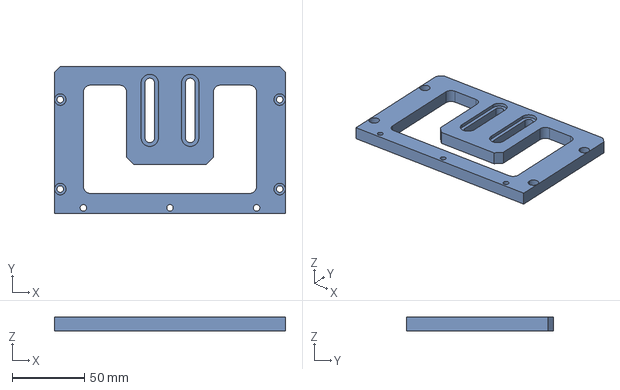
[picture p55: CAD file, 2025-12-10]
uploads/anexo-1759258943508-12196623.stp
160.0 x 102.0 x 9.50 mm
