pvrezende/Dashboard/uploads/anexo-1759334547615-96912203.stp

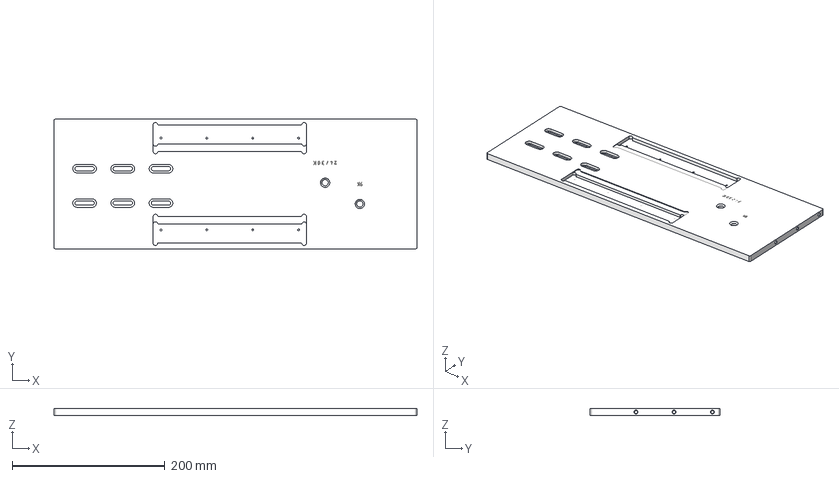
[picture p57: CAD file, 2025-12-10]
uploads/anexo-1759334547615-96912203.stp
475.0 x 170.0 x 9.50 mm
