pvrezende/Dashboard/uploads/anexo-1759437949928-755583433.stp

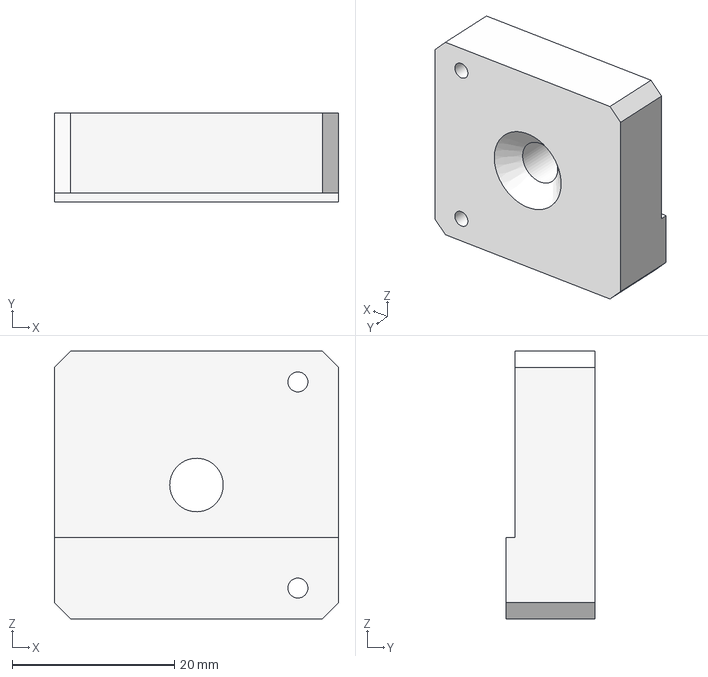
[picture p58: CAD file, 2025-12-10]
uploads/anexo-1759437949928-755583433.stp
35.0 x 11.0 x 33.0 mm
