pvrezende/Dashboard/uploads/anexo-1758135511730-156368243.stp

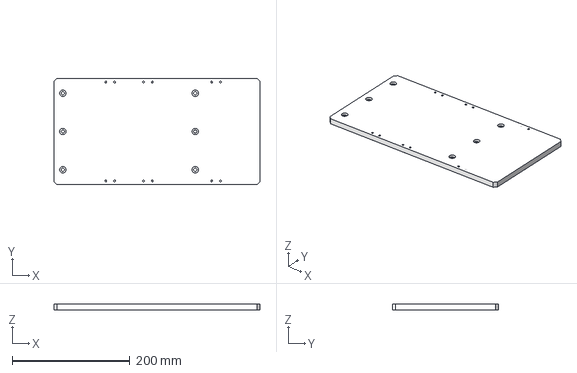
[picture p59: CAD file, 2025-12-10]
uploads/anexo-1758135511730-156368243.stp
350.0 x 180.0 x 9.50 mm
