pvrezende/Dashboard/uploads/anexo-1757946678741-464317667.stp

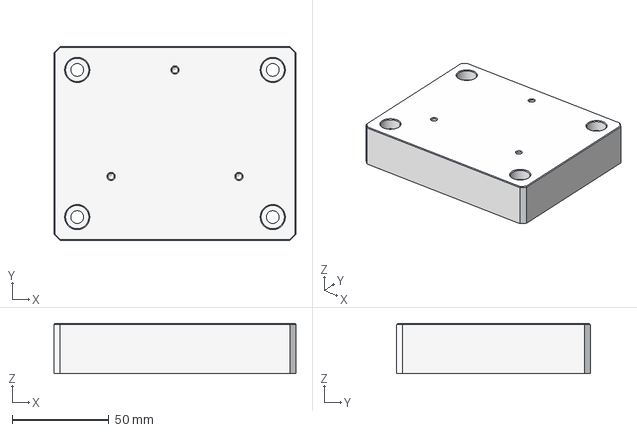
[picture p60: CAD file, 2025-12-10]
uploads/anexo-1757946678741-464317667.stp
125.0 x 100.0 x 26.0 mm
