pvrezende/Dashboard/uploads/anexo-1756210813488-745523543.stp

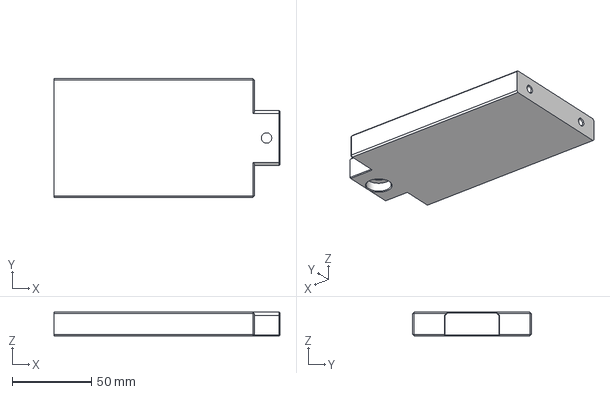
[picture p61: CAD file, 2025-12-10]
uploads/anexo-1756210813488-745523543.stp
142.8 x 75.0 x 15.0 mm
