pvrezende/Dashboard/uploads/anexo-1756228790973-410421975.stp

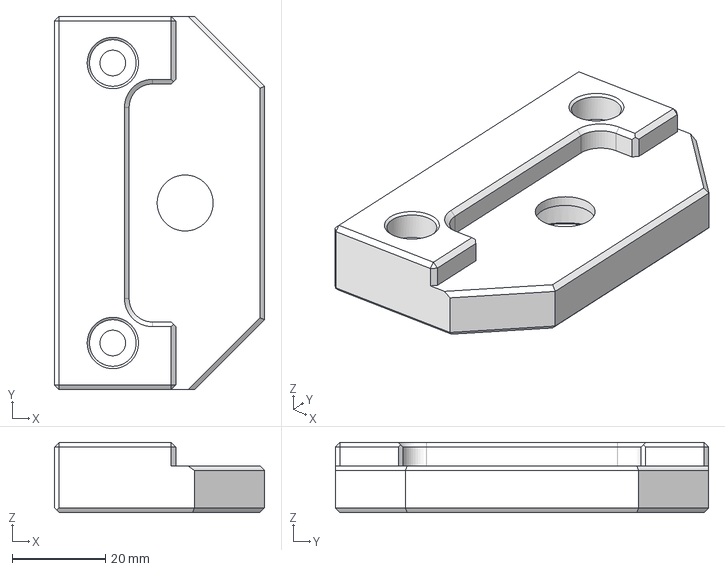
[picture p62: CAD file, 2025-12-10]
uploads/anexo-1756228790973-410421975.stp
45.0 x 80.0 x 15.0 mm
