pvrezende/Dashboard/uploads/anexo-1759335113068-788158933.stp

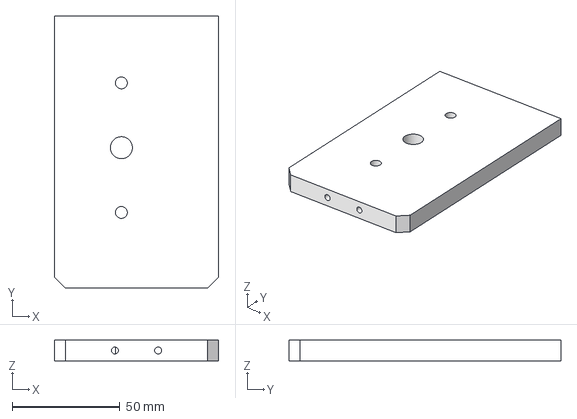
[picture p63: CAD file, 2025-12-10]
uploads/anexo-1759335113068-788158933.stp
76.0 x 126.0 x 9.50 mm
