pvrezende/Dashboard/uploads/anexo-1759432640523-292378508.stp

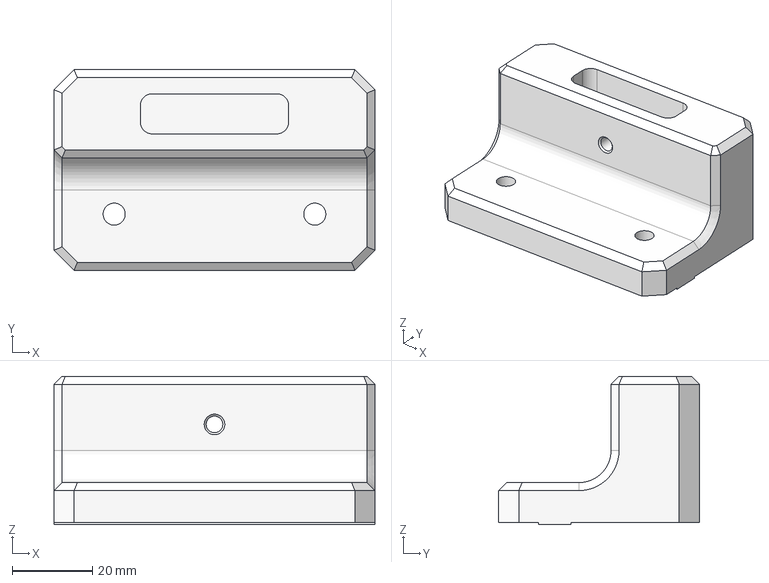
[picture p64: CAD file, 2025-12-10]
uploads/anexo-1759432640523-292378508.stp
80.0 x 50.0 x 37.0 mm
