pvrezende/Dashboard/uploads/anexo-1759335357282-104254621.stp

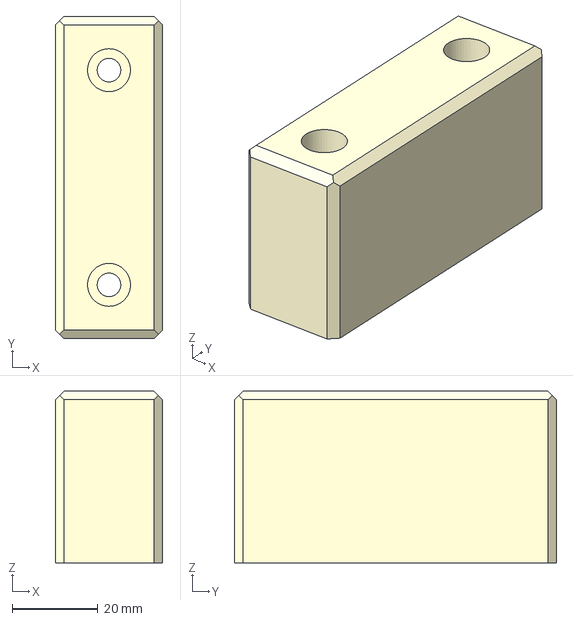
[picture p65: CAD file, 2025-12-10]
uploads/anexo-1759335357282-104254621.stp
25.0 x 75.0 x 40.0 mm
