pvrezende/Dashboard/uploads/anexo-1756297610844-194376924.stp

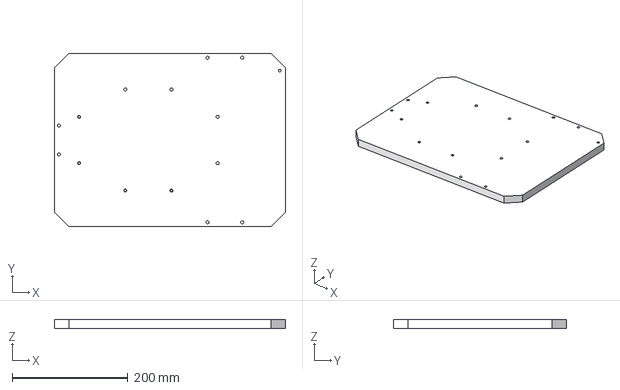
[picture p66: CAD file, 2025-12-10]
uploads/anexo-1756297610844-194376924.stp
400.0 x 300.0 x 15.0 mm
