pvrezende/Dashboard/uploads/anexo-1759335221474-754293433.stp

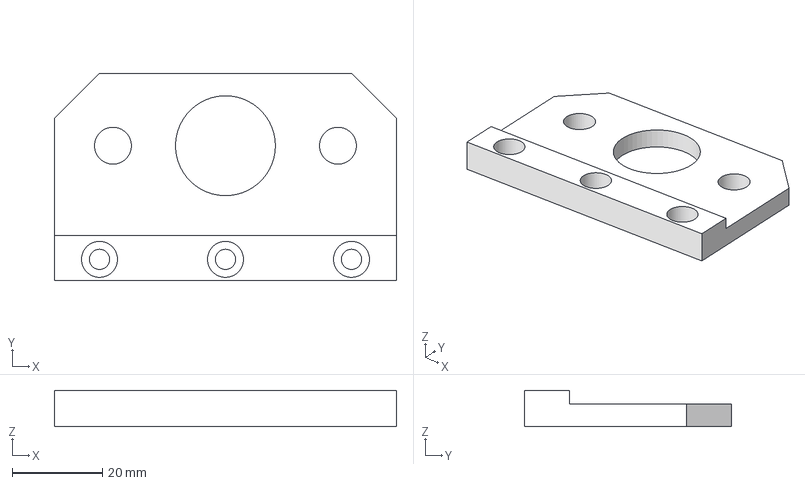
[picture p67: CAD file, 2025-12-10]
uploads/anexo-1759335221474-754293433.stp
76.0 x 46.1 x 8.00 mm
