pvrezende/Dashboard/uploads/anexo-1756920082647-276222125.stp

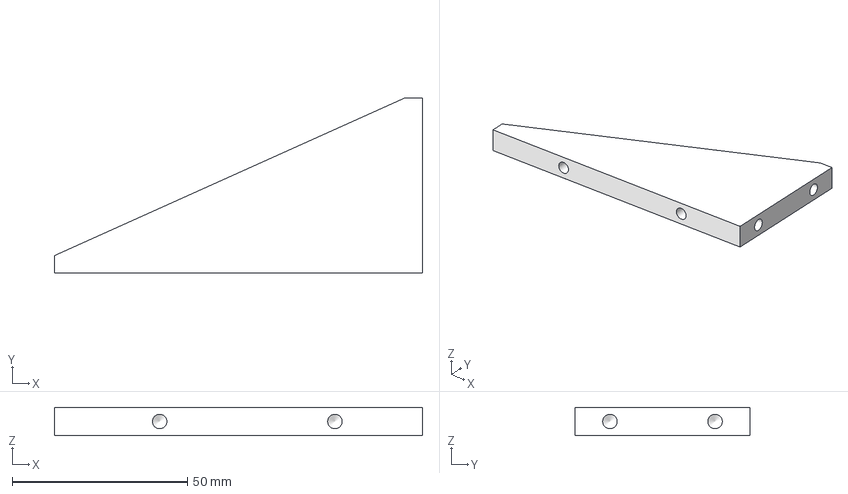
[picture p70: CAD file, 2025-12-10]
uploads/anexo-1756920082647-276222125.stp
105.0 x 50.0 x 8.00 mm
