pvrezende/Dashboard/uploads/anexo-1759334989191-909982024.stp

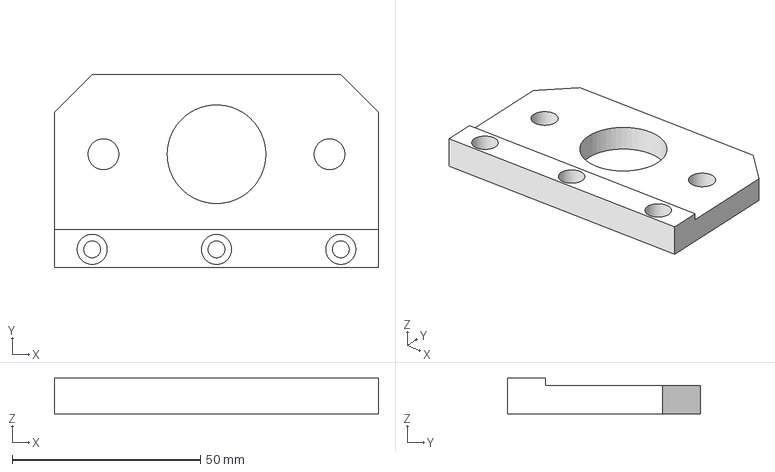
[picture p71: CAD file, 2025-12-10]
uploads/anexo-1759334989191-909982024.stp
86.0 x 51.1 x 9.50 mm
