pvrezende/Dashboard/uploads/anexo-1759407375107-412707076.stp

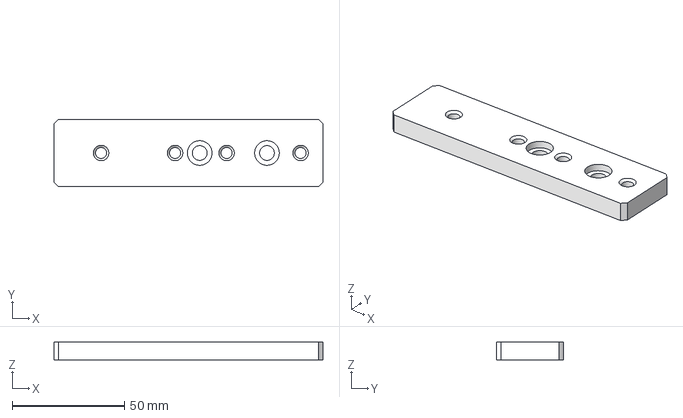
[picture p72: CAD file, 2025-12-10]
uploads/anexo-1759407375107-412707076.stp
120.0 x 30.0 x 8.00 mm
