pvrezende/Dashboard/uploads/anexo-1758549584420-658292167.stp

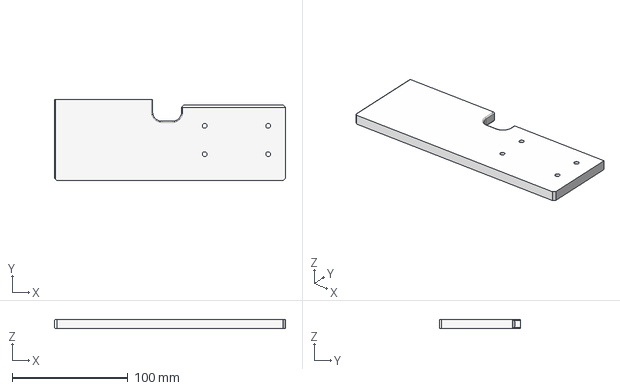
[picture p73: CAD file, 2025-12-10]
uploads/anexo-1758549584420-658292167.stp
200.0 x 70.5 x 8.00 mm
