pvrezende/Dashboard/uploads/anexo-1755620439878-759110121.stp

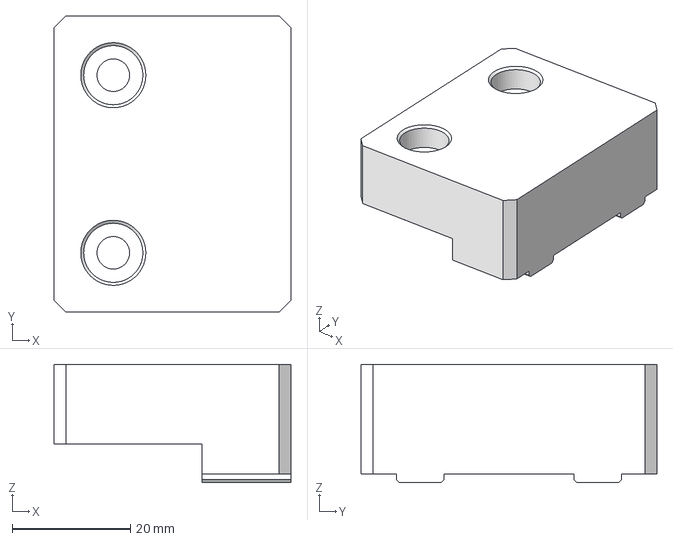
[picture p74: CAD file, 2025-12-10]
uploads/anexo-1755620439878-759110121.stp
40.0 x 50.0 x 20.0 mm
