pvrezende/Dashboard/(list of files, cad)

Other CAD files:
uploads/anexo-1756300203626-372849154.dwg
uploads/anexo-1755207723829-851298491.dwg
uploads/anexo-1756300366868-655113684.dwg
uploads/anexo-1756299749053-431599762.dwg
uploads/anexo-1757349369244-147135781.stp
uploads/anexo-1755977748348-672768302.stp
uploads/anexo-1755961721986-401825739.stp
uploads/anexo-1756392930473-783721214.dwg
uploads/anexo-1757689401082-137748192.dwg
uploads/anexo-1756303920654-768753859.stp
uploads/anexo-1756304509252-801308734.stp
uploads/anexo-1756388579732-116487602.dwg
uploads/anexo-1757435883144-365542811.stp
uploads/anexo-1755779397143-174385703.dwg
uploads/anexo-1756217301987-242266938.stp
uploads/anexo-1757432362297-431868836.stp
uploads/anexo-1756232515020-591331202.stp
uploads/anexo-1751643780337-355326594.dwg
uploads/anexo-1755961231381-717178888.stp
uploads/anexo-1759963781752-276285255.stp
uploads/anexo-1756302615128-791763898.stp
uploads/anexo-1758558685478-553491660.stp
uploads/anexo-1755977759114-412362983.stp
uploads/anexo-1756387456192-507777841.dwg
uploads/anexo-1756153958557-860773813.stp
uploads/anexo-1756299407525-825977218.dwg
uploads/anexo-1756305218704-330817245.stp
uploads/anexo-1756299374634-590915554.dwg
uploads/anexo-1751643768782-981930391.ipt
uploads/anexo-1753897428863-523399233.ipt
uploads/anexo-1753907579141-375331155.ipt
uploads/anexo-1753908394499-345636678.ipt
uploads/anexo-1753908779612-905146315.ipt
uploads/anexo-1753910552024-620583933.ipt
uploads/anexo-1753971729075-584286076.ipt
uploads/anexo-1754420265863-396477189.ipt
uploads/anexo-1754422505167-806029136.ipt
uploads/anexo-1754422539386-620684753.ipt
uploads/anexo-1754422569798-657018658.ipt
uploads/anexo-1754422599704-605467282.ipt
uploads/anexo-1754422631074-107505424.ipt
uploads/anexo-1754422679669-690528054.ipt
uploads/anexo-1754422701041-950043789.ipt
uploads/anexo-1754422727170-996949353.ipt
uploads/anexo-1754422754688-425430613.ipt
uploads/anexo-1754423014976-630523356.ipt
uploads/anexo-1754423031244-732493164.ipt
uploads/anexo-1755006239862-860619563.ipt
uploads/anexo-1755010958453-725234080.ipt
uploads/anexo-1755205028045-389999059.ipt
uploads/anexo-1755206565969-586536802.ipt
uploads/anexo-1755206613653-319775010.ipt
uploads/anexo-1755207512079-588485038.ipt
uploads/anexo-1755207557614-718809512.ipt
uploads/anexo-1755207574393-241125360.ipt
uploads/anexo-1755207626596-610985999.ipt
uploads/anexo-1755207641967-389559920.ipt
uploads/anexo-1755207688089-659143010.ipt
uploads/anexo-1755207715065-577295790.ipt
uploads/anexo-1755314687706-750312177.ipt
uploads/anexo-1755560499260-743064328.ipt
uploads/anexo-1755560568248-523500181.ipt
uploads/anexo-1755560634065-592579861.ipt
uploads/anexo-1755696794208-699378692.ipt
uploads/anexo-1755696847017-331000417.ipt
uploads/anexo-1755696919672-76768441.ipt
uploads/anexo-1755696969405-772619462.ipt
uploads/anexo-1755697093386-116873469.ipt
uploads/anexo-1755707839950-661687136.ipt
uploads/anexo-1755707896904-171446462.ipt
uploads/anexo-1755803577410-225455707.ipt
uploads/anexo-1755803648504-815081187.ipt
uploads/anexo-1755803748621-397410311.ipt
uploads/anexo-1755803773167-919470550.ipt
uploads/anexo-1755803934164-857622090.ipt
uploads/anexo-1755803969108-392910435.ipt
uploads/anexo-1755804018227-62746786.ipt
uploads/anexo-1755804103169-677855955.ipt
uploads/anexo-1755804159244-310923707.ipt
uploads/anexo-1755804201299-580387785.ipt
uploads/anexo-1755804436452-378456198.ipt
uploads/anexo-1755813444175-96442970.ipt
uploads/anexo-1755813500905-252303710.ipt
uploads/anexo-1755813710468-331937631.ipt
uploads/anexo-1755914041545-695033593.ipt
uploads/anexo-1756300762230-178304470.ipt
uploads/anexo-1756300777670-200904543.ipt
uploads/anexo-1757357936863-717887668.ipt
uploads/anexo-1757526830170-522576730.ipt
uploads/anexo-1757526846927-782003059.ipt
uploads/anexo-1757526866638-720850390.ipt
uploads/anexo-1757526876305-836211998.ipt
uploads/anexo-1757527381737-271611043.ipt
uploads/anexo-1757527400336-228696747.ipt
uploads/anexo-1757527473732-449181096.ipt
uploads/anexo-1757527495063-318803733.ipt
uploads/anexo-1757527775228-722110043.ipt
uploads/anexo-1757527792884-57061088.ipt
uploads/anexo-1757527805135-191212089.ipt
uploads/anexo-1757527814716-556836205.ipt
uploads/anexo-1757528384928-691329855.ipt
uploads/anexo-1757528397471-139017825.ipt
uploads/anexo-1757529200444-259637612.ipt
uploads/anexo-1758047851012-646131586.ipt
uploads/anexo-1758047897241-910664960.ipt
uploads/anexo-1758047940594-921075273.ipt
uploads/anexo-1758047993662-798985046.ipt
uploads/anexo-1758048014912-30405820.ipt
uploads/anexo-1758048048067-370268048.ipt
uploads/anexo-1758048083122-454527524.ipt
uploads/anexo-1758048139580-252901002.ipt
uploads/anexo-1758048182493-388655873.ipt
uploads/anexo-1758121991289-676144996.ipt
uploads/anexo-1758121992707-362455479.ipt
uploads/anexo-1758289755091-807226654.ipt
uploads/anexo-1758289819741-96146206.ipt
uploads/anexo-1758292559580-811773616.ipt
uploads/anexo-1759251913523-311285220.ipt
uploads/anexo-1759348857727-224855999.ipt
uploads/anexo-1759432069464-765632784.ipt
uploads/anexo-1759432082484-824966847.ipt
uploads/anexo-1759872512688-108245096.ipt
uploads/anexo-1759873716402-493271901.ipt
uploads/anexo-1759875354367-710581602.ipt
uploads/anexo-1759923695826-660965248.ipt
