pvrezende/Dashboard/uploads/anexo-1751643795369-149919795.pdf

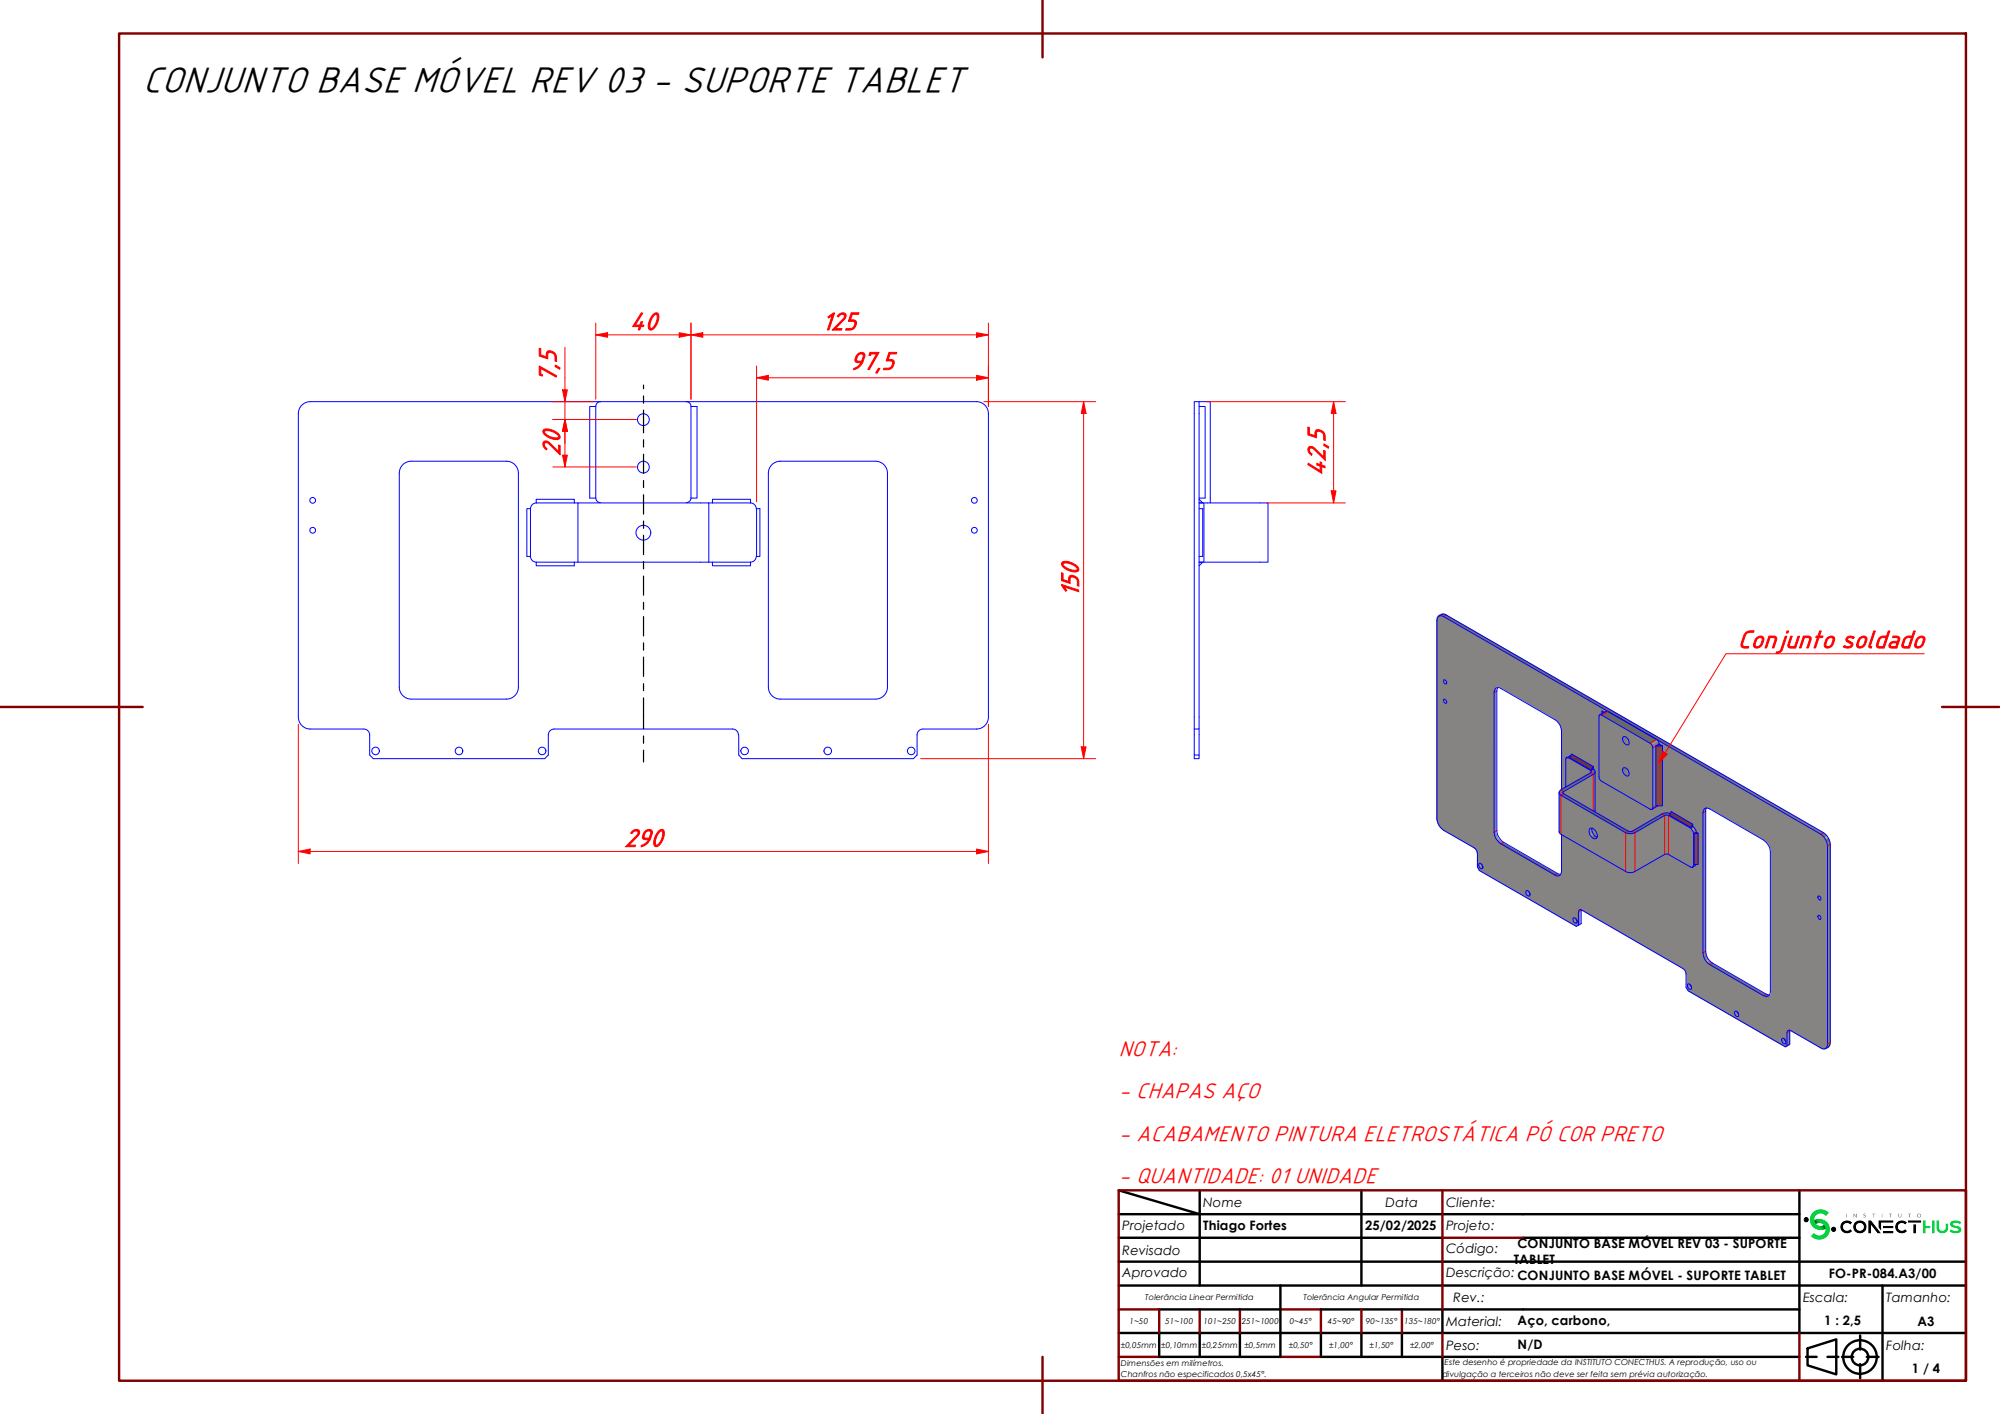
[picture p75: page 1]
- QUANTIDADE: 01 UNIDADE; Conjunto soldado

CONJUNTO BASE MÓVEL REV 03 - SUPORTE TABLET

- CHAPAS AÇO
- ACABAMENTO PINTURA ELETROSTÁTICA PÓ COR PRETO

Nome | Data | Cliente:

Projetado | Thiago Fortes | 25/02/2025 | Projeto:
Revisado | | | CONJUNTO BASE MÓVEL REV 03 - SUPORTE Código: TABLET

Aprovado | | | CONJUNTO BASE MÓVEL - SUPORTE TABLET Descrição: | FO-PR-084.A3/00

Tolerância Linear Permitida | Tolerância Angular Permitida | Rev.: | Escala: 1 : 2,5 | Tamanho: A3

0~45° | 45~90° | | Material: Aço, carbono,

±0,05mm | ±0,10mm | ±0,25mm | ±0,5mm | ±0,50° | ±1,00° | ±1,50° | Peso: N/D | Folha: 1 / 4

Dimensões em milímetros. Chanfros não especificados 0,5x45°. | | | | | | | Este desenho é propriedade da INSTITUTO CONECTHUS. A reprodução, uso ou divulgação a terceiros não deve ser feita sem prévia autorização.

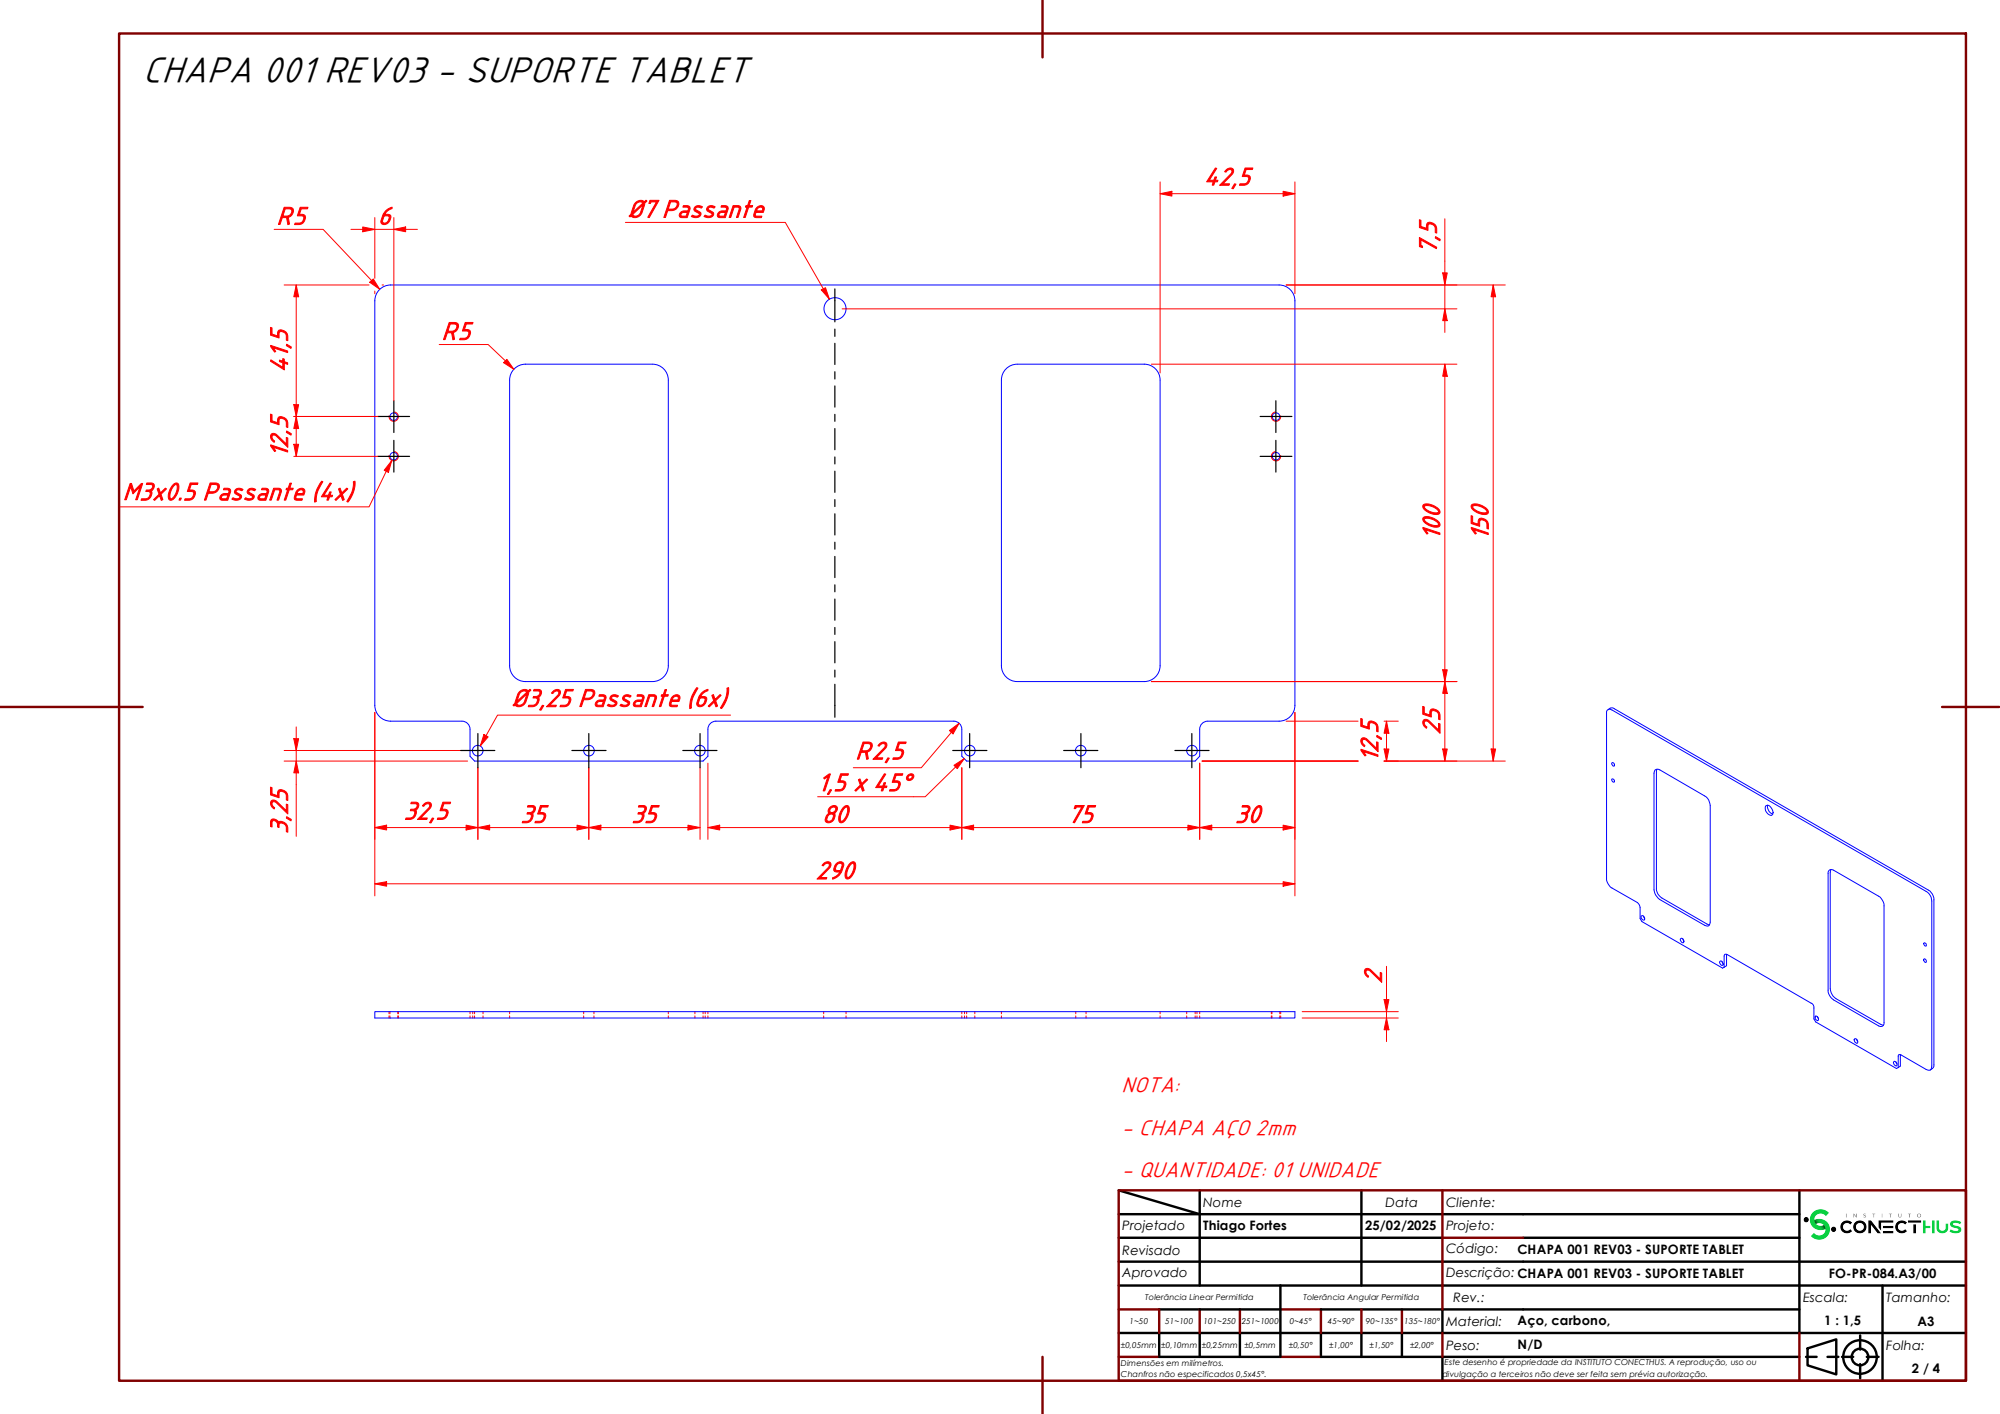
[picture p76: page 2]
Ø7 Passante; M3x0.5 Passante (4x); Ø3,25 Passante (6x); - CHAPA AÇO 2mm; - QUANTIDADE: 01 UNIDADE

CHAPA 001 REV03 - SUPORTE TABLET

Nome | Data | Cliente:

Projetado | Thiago Fortes | 25/02/2025 | Projeto:
Revisado | | | Código: CHAPA 001 REV03 - SUPORTE TABLET

Aprovado | | | Descrição: CHAPA 001 REV03 - SUPORTE TABLET | FO-PR-084.A3/00

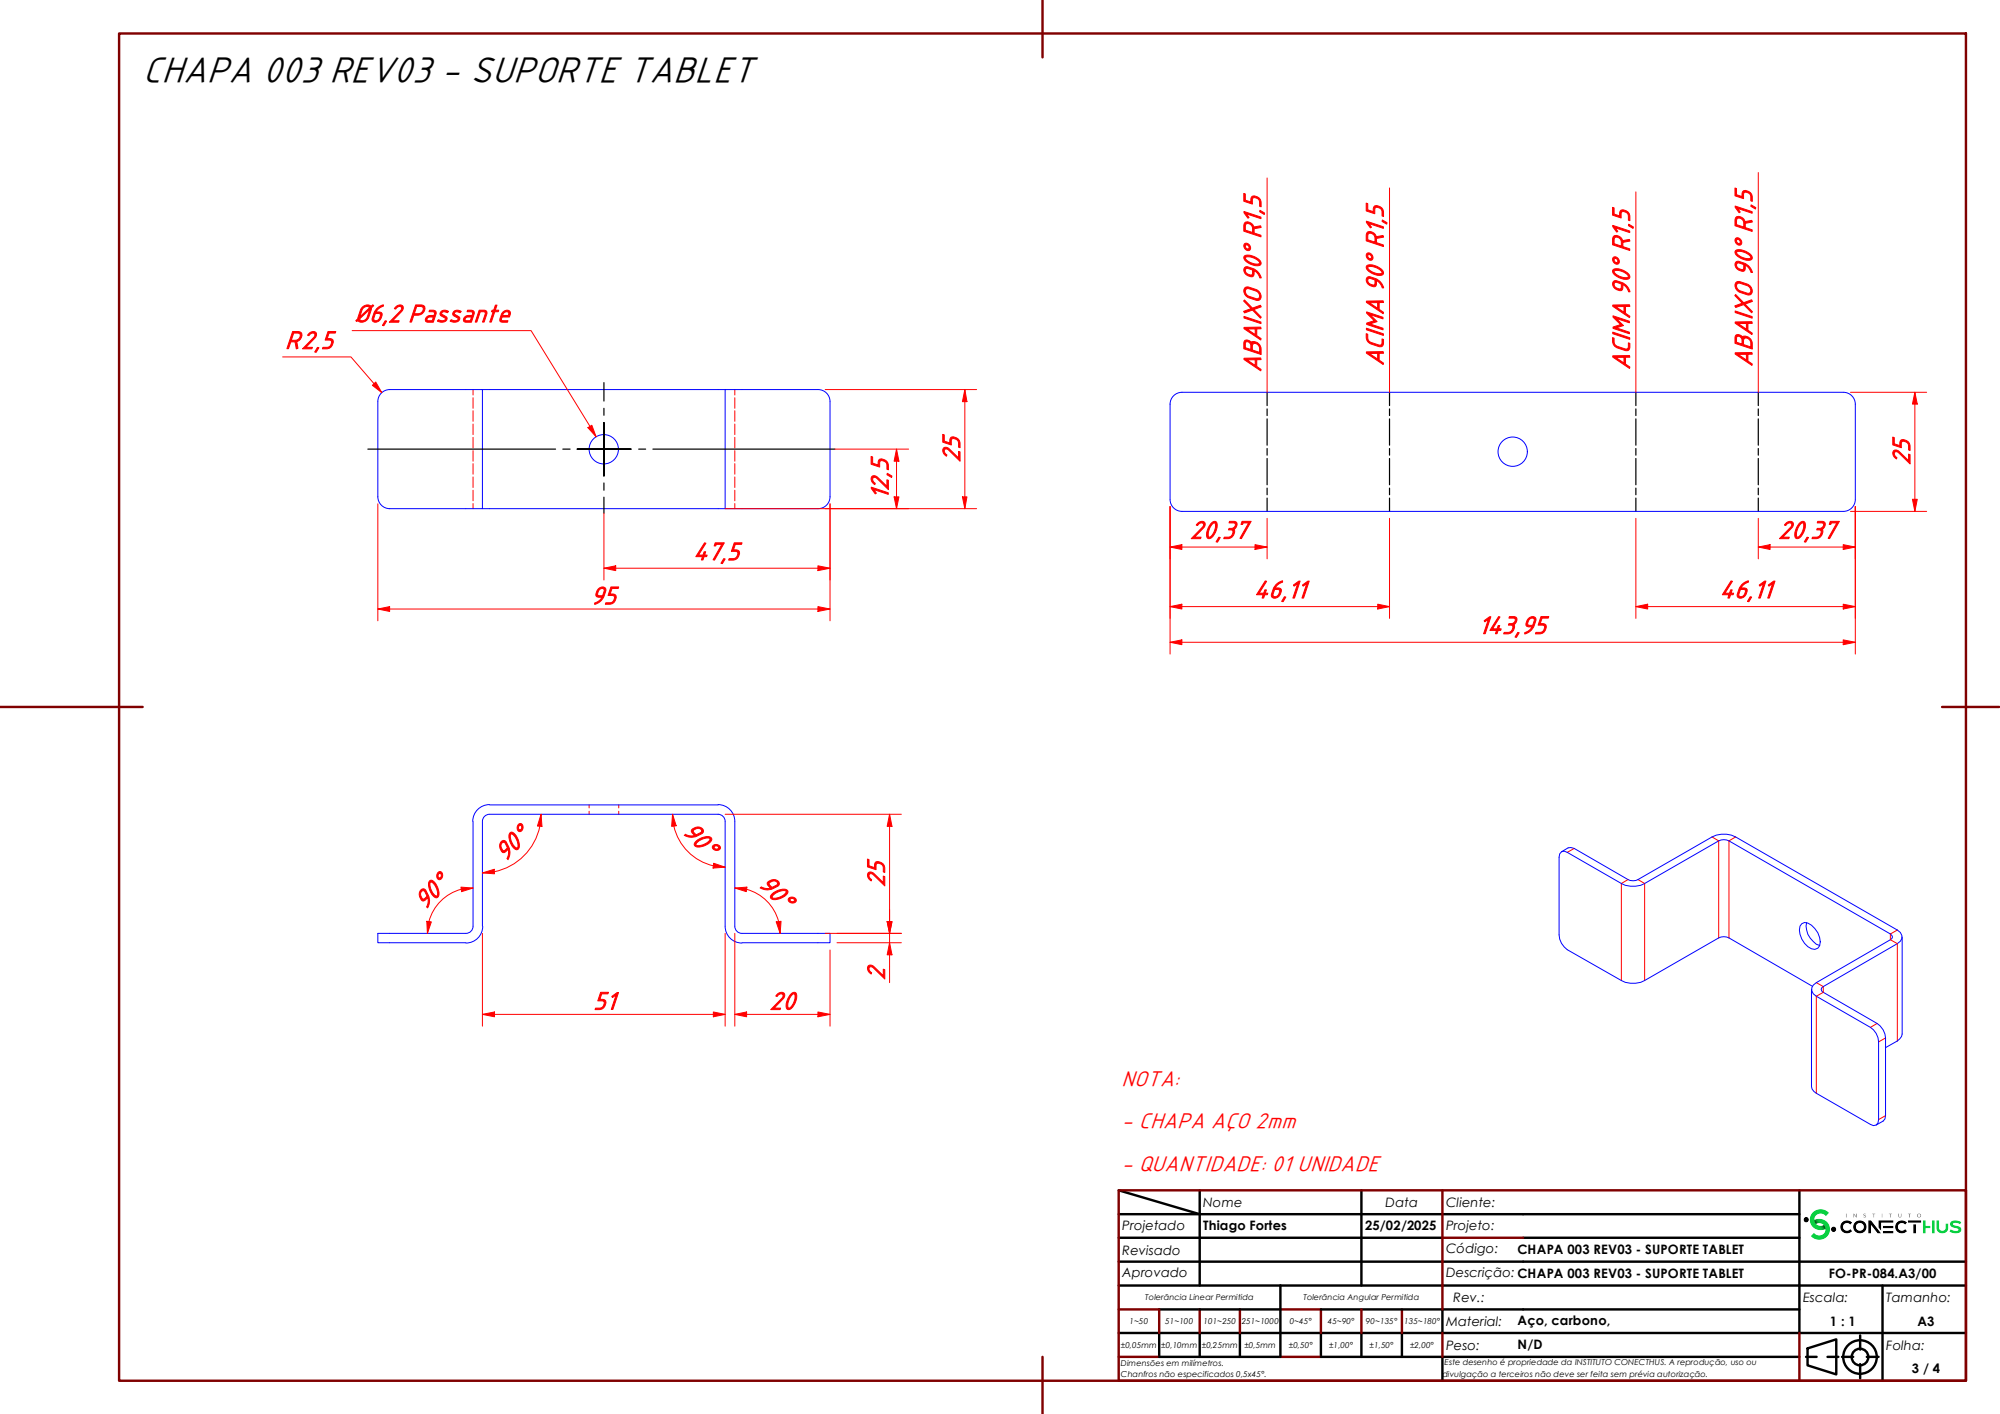
[picture p77: page 3]
Ø6,2 Passante; - CHAPA AÇO 2mm; - QUANTIDADE: 01 UNIDADE; ABAIXO 90; ACIMA 90

CHAPA 003 REV03 - SUPORTE TABLET

Nome | Data | Cliente:

Projetado | Thiago Fortes | 25/02/2025 | Projeto:
Revisado | | | Código: CHAPA 003 REV03 - SUPORTE TABLET

Aprovado | | | Descrição: CHAPA 003 REV03 - SUPORTE TABLET | FO-PR-084.A3/00

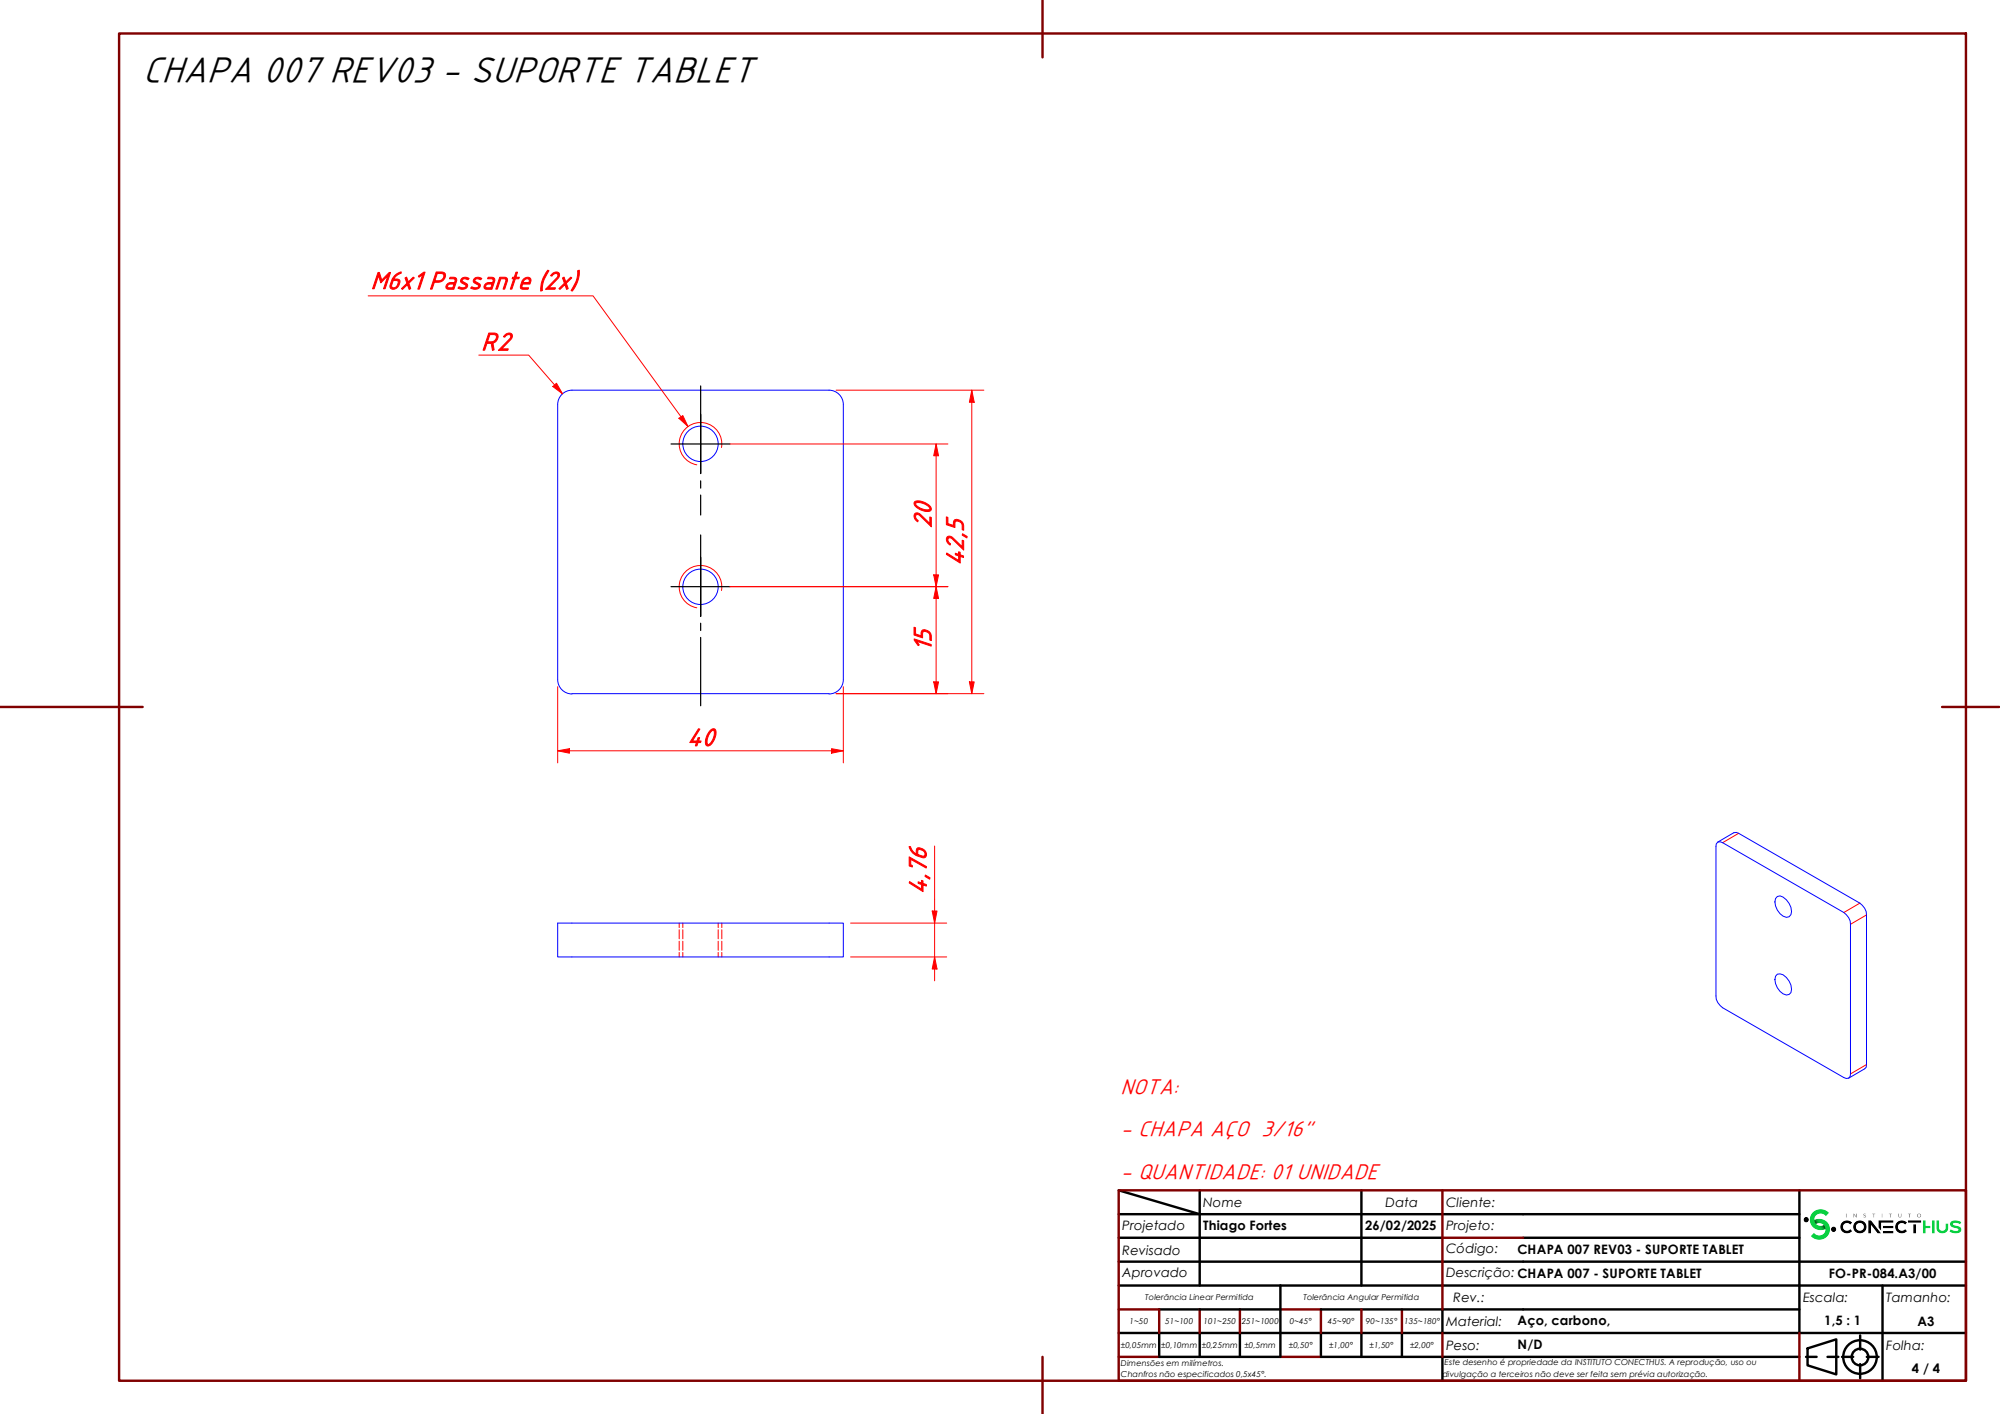
[picture p78: page 4]
- CHAPA AÇO 3/16"; - QUANTIDADE: 01 UNIDADE; M6x1 Passante (2x)

CHAPA 007 REV03 - SUPORTE TABLET

Nome | Data | Cliente:

Projetado | Thiago Fortes | 26/02/2025 | Projeto:
Revisado | | | Código: CHAPA 007 REV03 - SUPORTE TABLET

Aprovado | | | Descrição: CHAPA 007 - SUPORTE TABLET | FO-PR-084.A3/00
