pvrezende/Dashboard/uploads/anexo-1752159655271-445577570.pdf

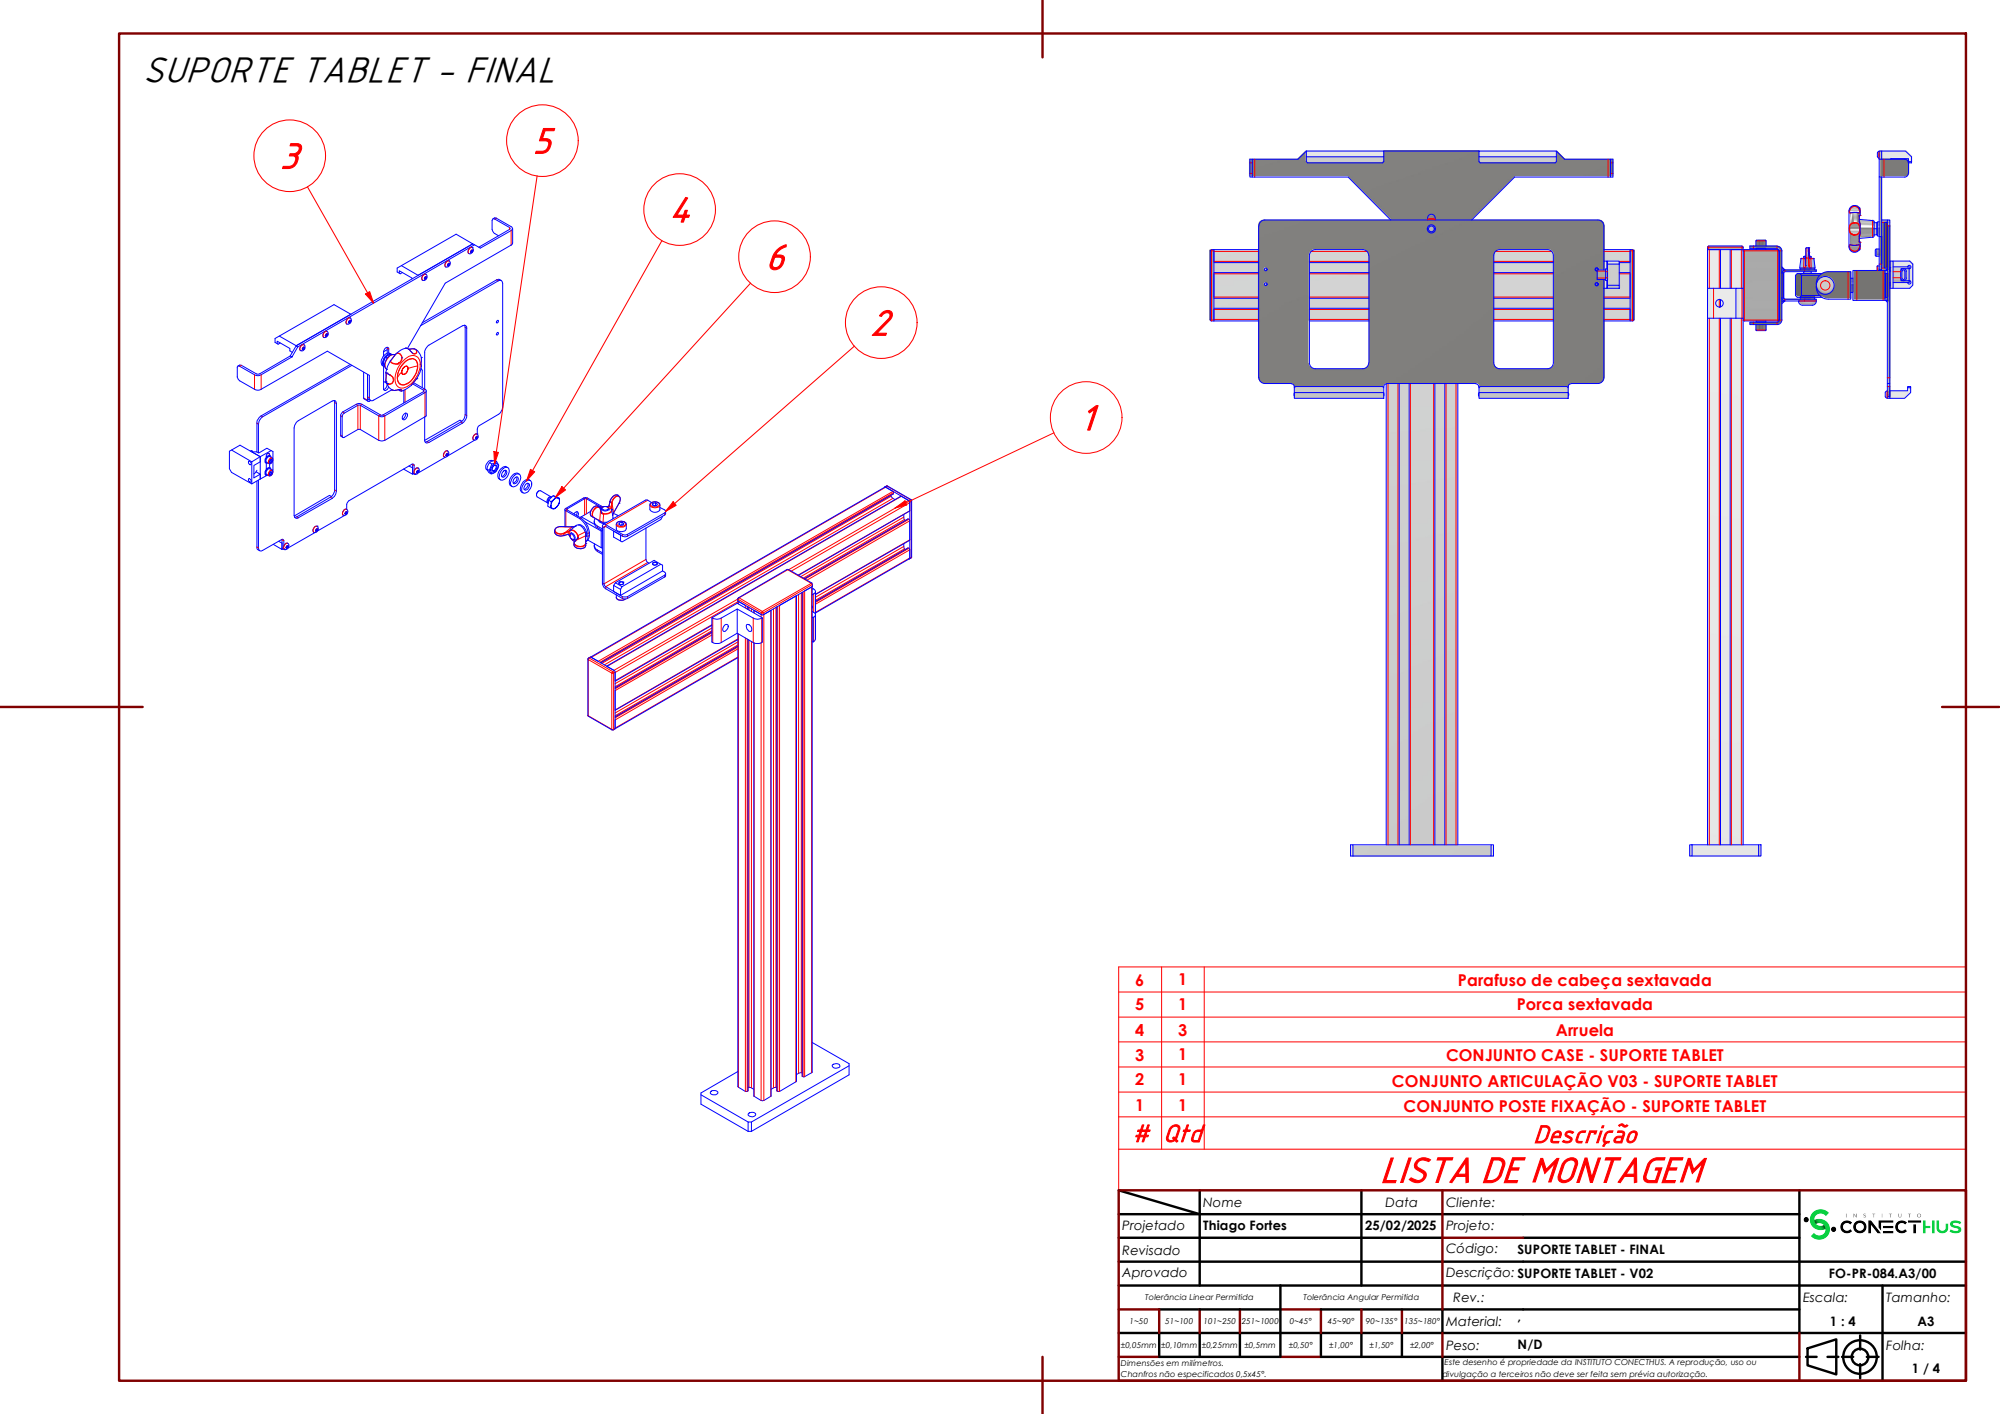
[picture p79: page 1]

SUPORTE TABLET - FINAL

6 | 1 | Parafuso de cabeça sextavada
5 | 1 | Porca sextavada
4 | 3 | Arruela
3 | 1 | CONJUNTO CASE - SUPORTE TABLET
2 | 1 | CONJUNTO ARTICULAÇÃO V03 - SUPORTE TABLET
1 | 1 | CONJUNTO POSTE FIXAÇÃO - SUPORTE TABLET
# Qtd | | Descrição

LISTA DE MONTAGEM

Nome | Data | Cliente:

Projetado | Thiago Fortes | 25/02/2025 | Projeto:
Revisado | | | Código: SUPORTE TABLET - FINAL

Aprovado | | | Descrição: SUPORTE TABLET - V02 | FO-PR-084.A3/00

Tolerância Linear Permitida | Tolerância Angular Permitida | Rev.: | Escala: 1 : 4 | Tamanho: A3

0~45° | 45~90° | | M , aterial:

±0,05mm | ±0,10mm | ±0,25mm | ±0,5mm | ±0,50° | ±1,00° | ±1,50° | Peso: N/D | Folha: 1 / 4

Dimensões em milímetros. Chanfros não especificados 0,5x45°. | | | | | | | Este desenho é propriedade da INSTITUTO CONECTHUS. A reprodução, uso ou divulgação a terceiros não deve ser feita sem prévia autorização.

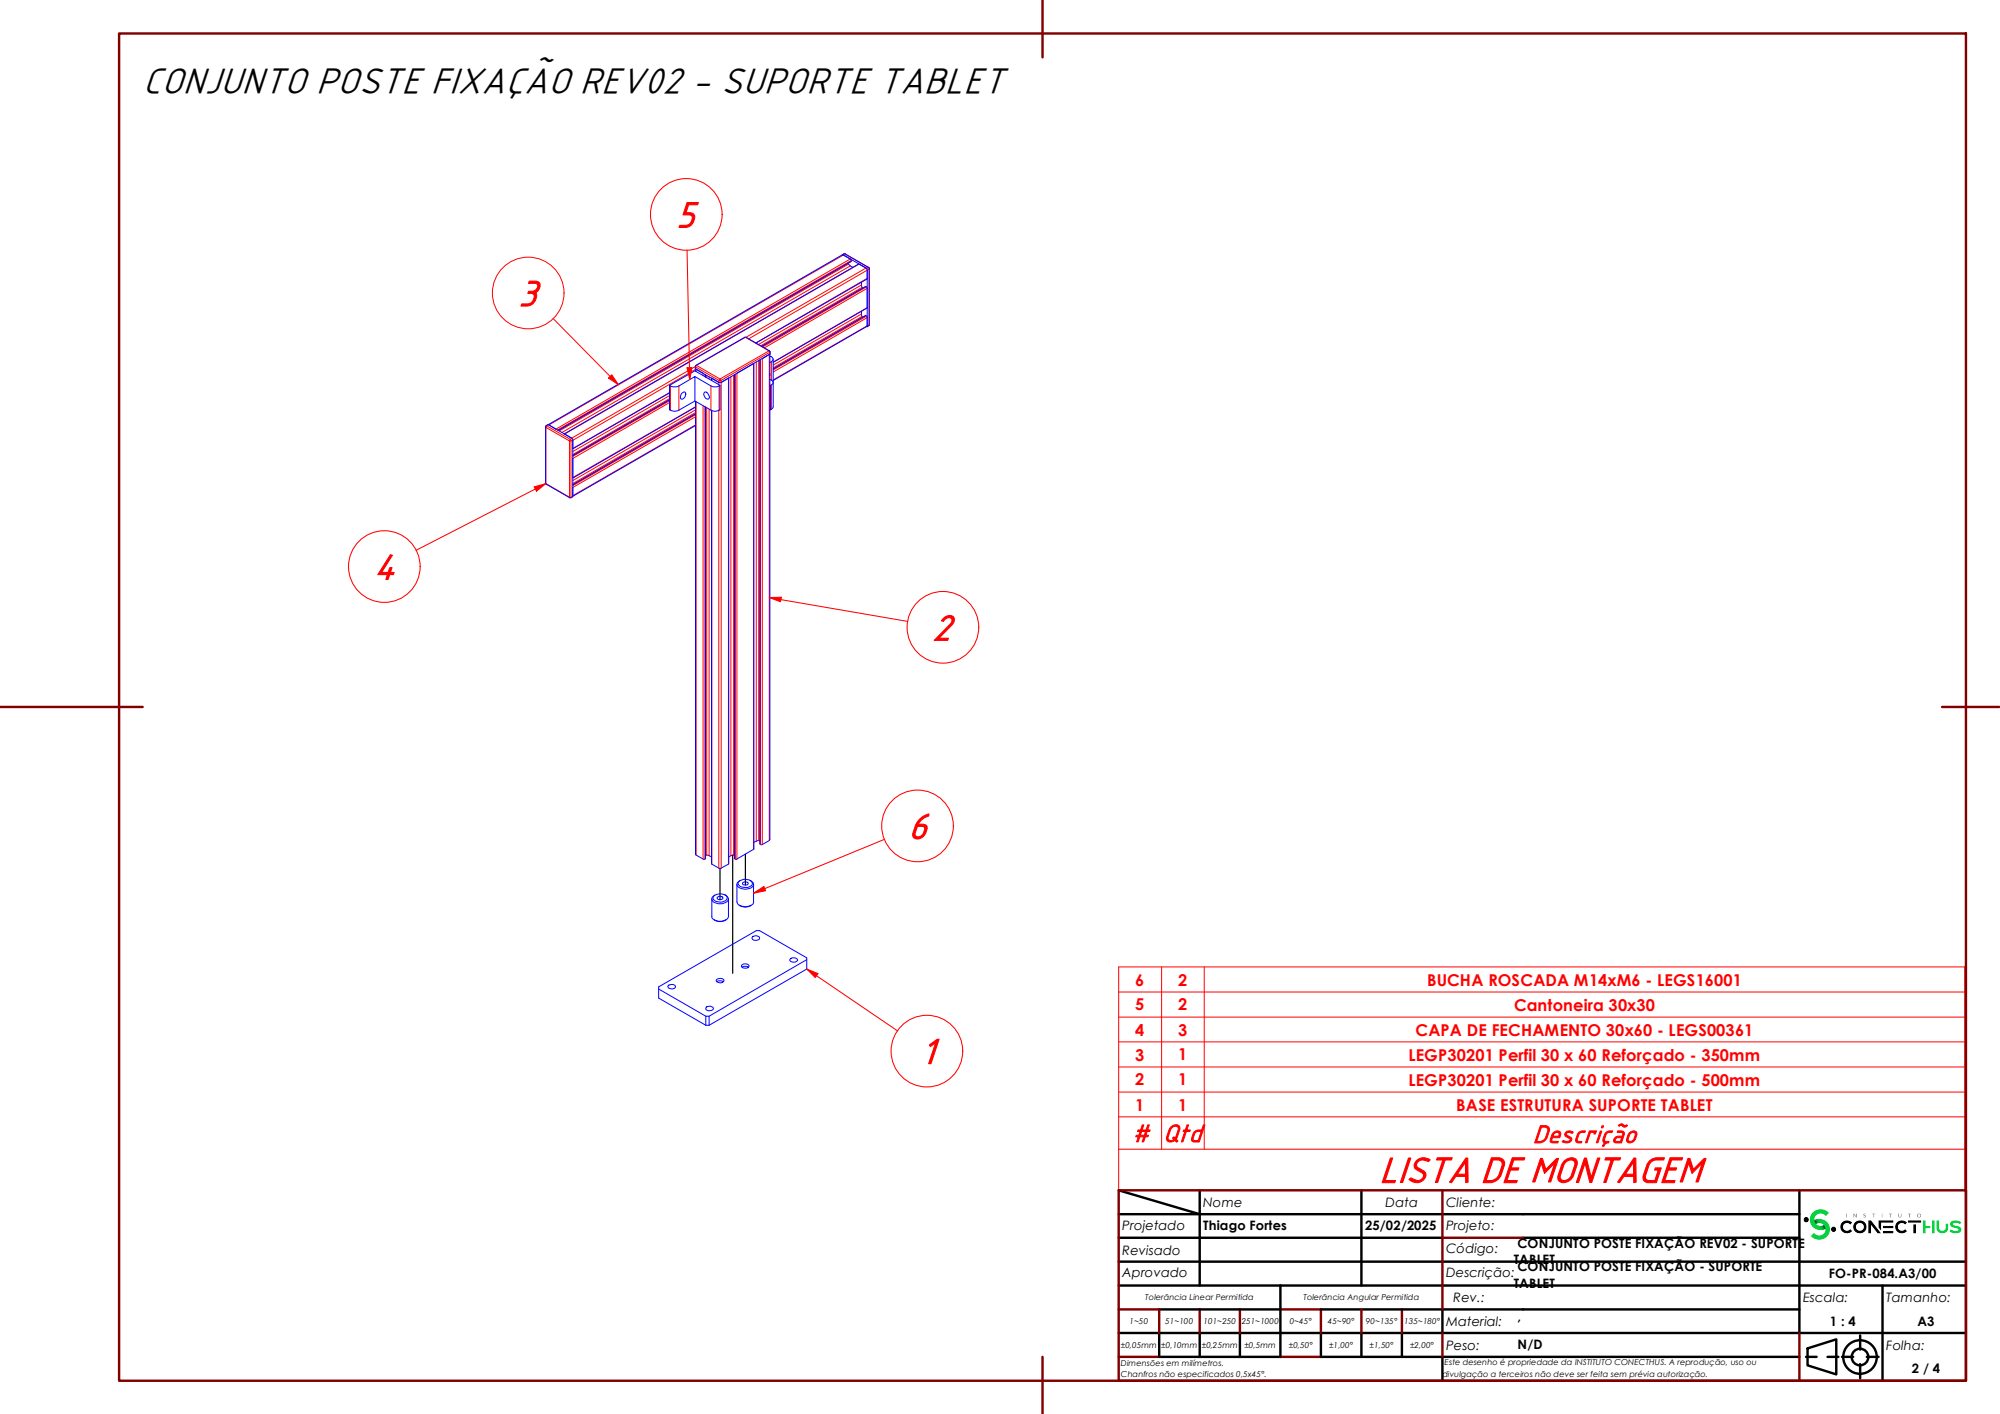
[picture p80: page 2]

CONJUNTO POSTE FIXAÇÃO REV02 - SUPORTE TABLET

6 | 2 | BUCHA ROSCADA M14xM6 - LEGS16001
5 | 2 | Cantoneira 30x30
4 | 3 | CAPA DE FECHAMENTO 30x60 - LEGS00361
3 | 1 | LEGP30201 Perfil 30 x 60 Reforçado - 350mm
2 | 1 | LEGP30201 Perfil 30 x 60 Reforçado - 500mm
1 | 1 | BASE ESTRUTURA SUPORTE TABLET
# Qtd | | Descrição

LISTA DE MONTAGEM

Nome | Data | Cliente:

Projetado | Thiago Fortes | 25/02/2025 | Projeto:
Revisado | | | CONJUNTO POSTE FIXAÇÃO REV02 - SUPORTE Código: TABLET
Aprovado | | | CONJUNTO POSTE FIXAÇÃO - SUPORTE Descrição: TABLET | FO-PR-084.A3/00

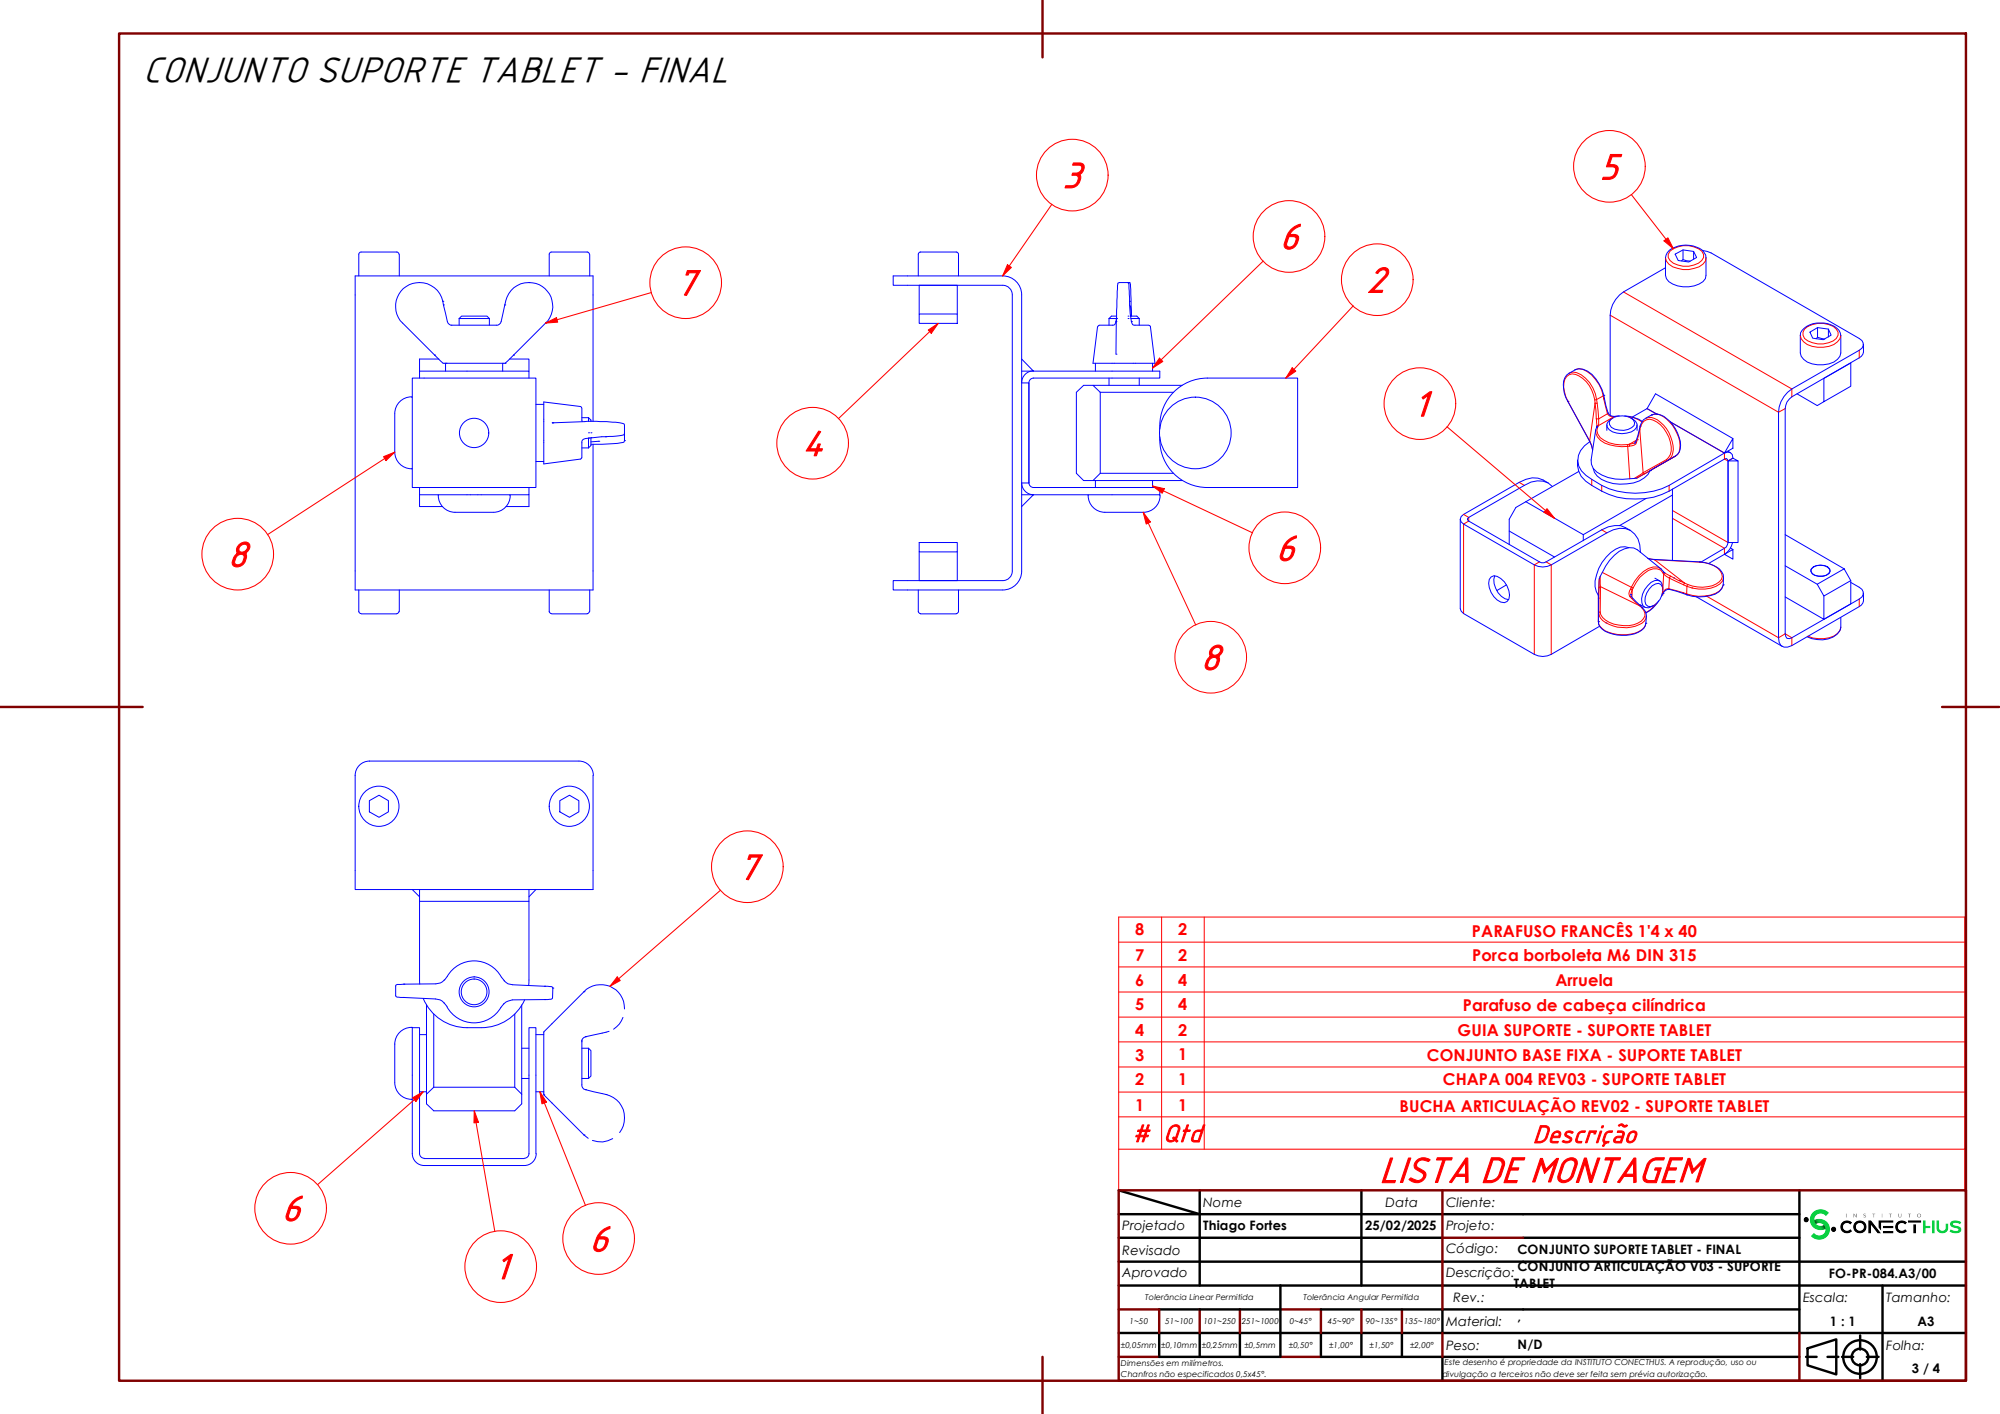
[picture p81: page 3]

CONJUNTO SUPORTE TABLET - FINAL

8 | 2 | PARAFUSO FRANCÊS 1'4 x 40
7 | 2 | Porca borboleta M6 DIN 315
6 | 4 | Arruela
5 | 4 | Parafuso de cabeça cilíndrica
4 | 2 | GUIA SUPORTE - SUPORTE TABLET
3 | 1 | CONJUNTO BASE FIXA - SUPORTE TABLET
2 | 1 | CHAPA 004 REV03 - SUPORTE TABLET
1 | 1 | BUCHA ARTICULAÇÃO REV02 - SUPORTE TABLET
# Qtd | | Descrição

LISTA DE MONTAGEM

Nome | Data | Cliente:

Projetado | Thiago Fortes | 25/02/2025 | Projeto:
Revisado | | | Código: CONJUNTO SUPORTE TABLET - FINAL
Aprovado | | | CONJUNTO ARTICULAÇÃO V03 - SUPORTE Descrição: TABLET | FO-PR-084.A3/00

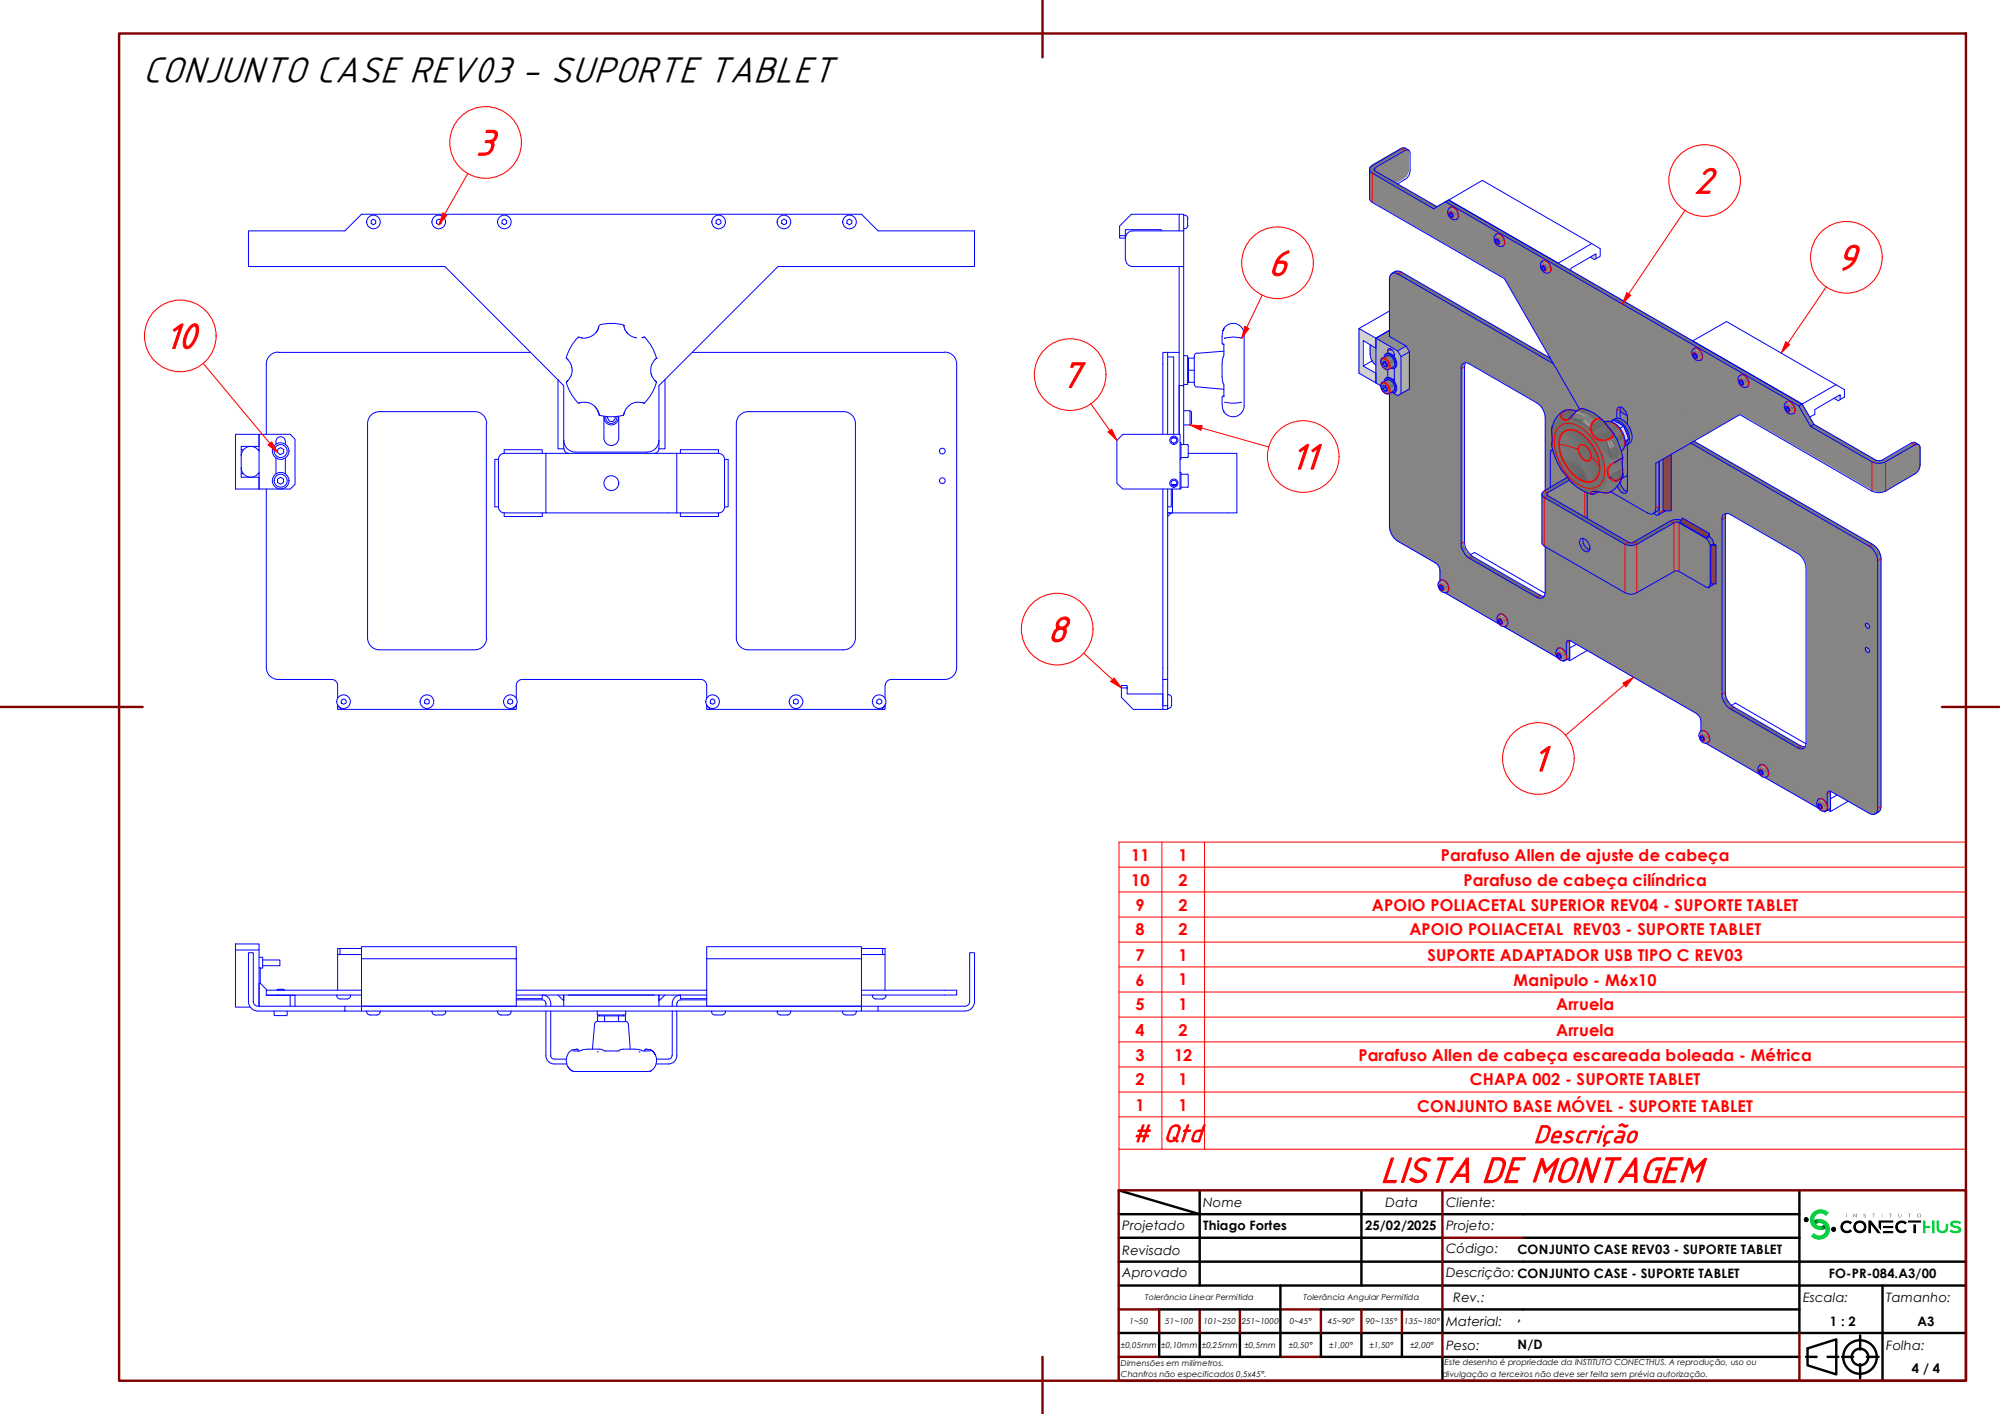
[picture p82: page 4]

CONJUNTO CASE REV03 - SUPORTE TABLET

11 | 1 | Parafuso Allen de ajuste de cabeça
10 | 2 | Parafuso de cabeça cilíndrica
9 | 2 | APOIO POLIACETAL SUPERIOR REV04 - SUPORTE TABLET
8 | 2 | APOIO POLIACETAL REV03 - SUPORTE TABLET
7 | 1 | SUPORTE ADAPTADOR USB TIPO C REV03
6 | 1 | Manipulo - M6x10
5 | 1 | Arruela
4 | 2 | Arruela
3 | 12 | Parafuso Allen de cabeça escareada boleada - Métrica
2 | 1 | CHAPA 002 - SUPORTE TABLET
1 | 1 | CONJUNTO BASE MÓVEL - SUPORTE TABLET
# Qtd | | Descrição

LISTA DE MONTAGEM

Nome | Data | Cliente:

Projetado | Thiago Fortes | 25/02/2025 | Projeto:
Revisado | | | Código: CONJUNTO CASE REV03 - SUPORTE TABLET

Aprovado | | | Descrição: CONJUNTO CASE - SUPORTE TABLET | FO-PR-084.A3/00
