pvrezende/Dashboard/uploads/anexo-1752853845808-228996785.pdf

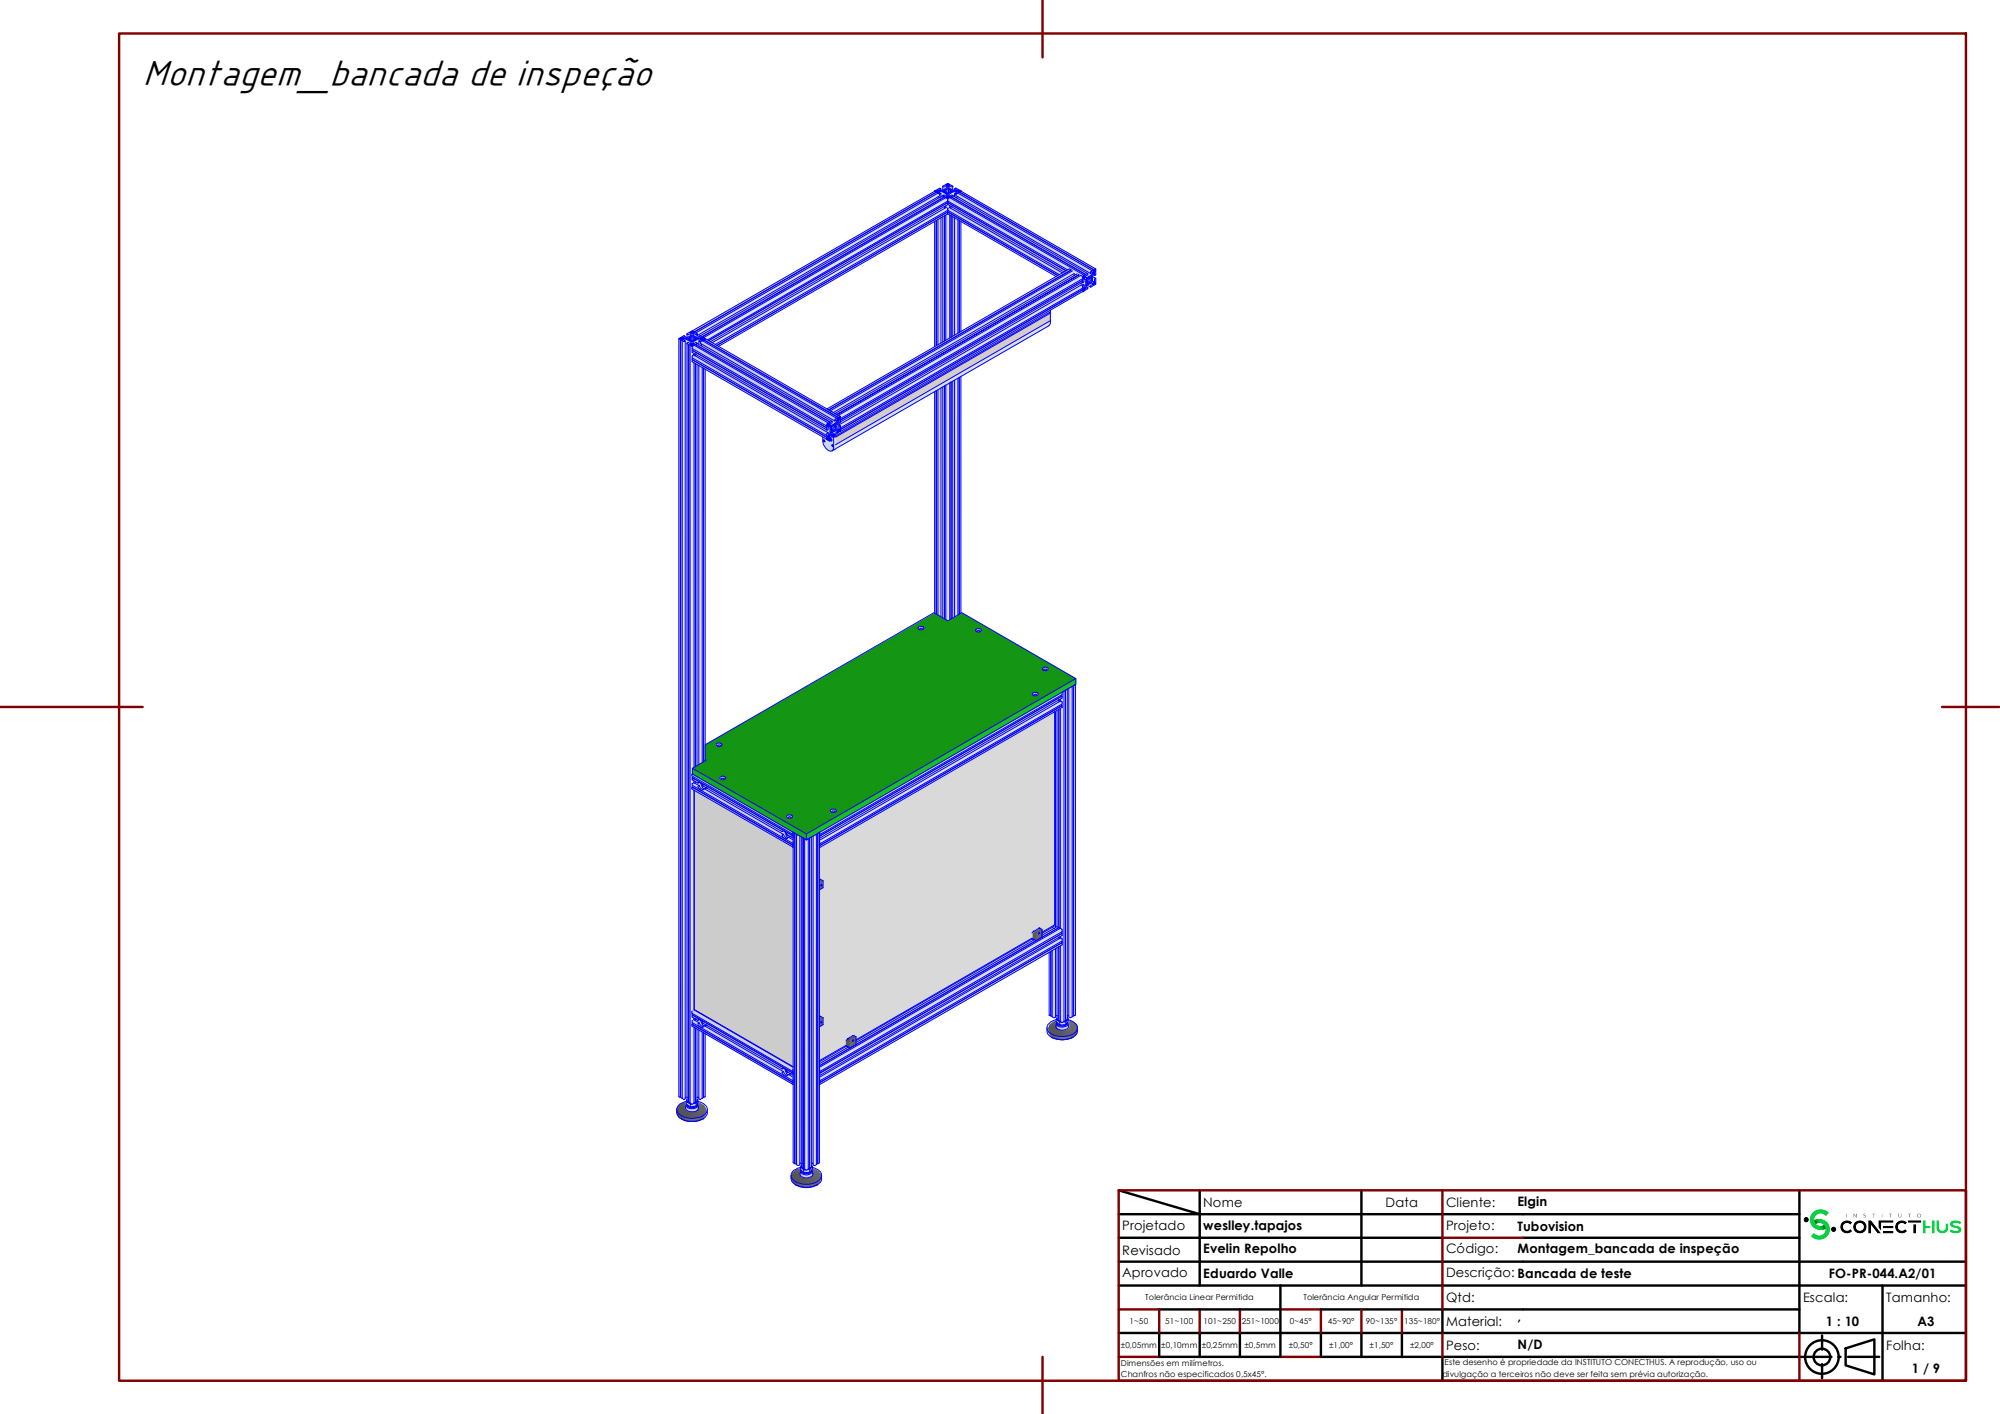
[picture p83: page 1]
Montagem_bancada de inspeção

Nome | Data | Cliente: Elgin

Projetado | weslley.tapajos | | Projeto: Tubovision
Revisado | Evelin Repolho | | Código: Montagem_bancada de inspeção

Aprovado | Eduardo Valle | | Descrição: Bancada de teste | FO-PR-044.A2/01

Tolerância Linear Permitida | Tolerância Angular Permitida | Qtd: | Escala: 1 : 10 | Tamanho: A3

0~45° | 45~90° | M , aterial:

Dimensões em milímetros. Chanfros não especificados 0,5x45°. | Peso: N/D Este desenho é propriedade da INSTITUTO CONECTHUS. A reprodução, uso ou divulgação a terceiros não deve ser feita sem prévia autorização. | | Folha: 1 / 9

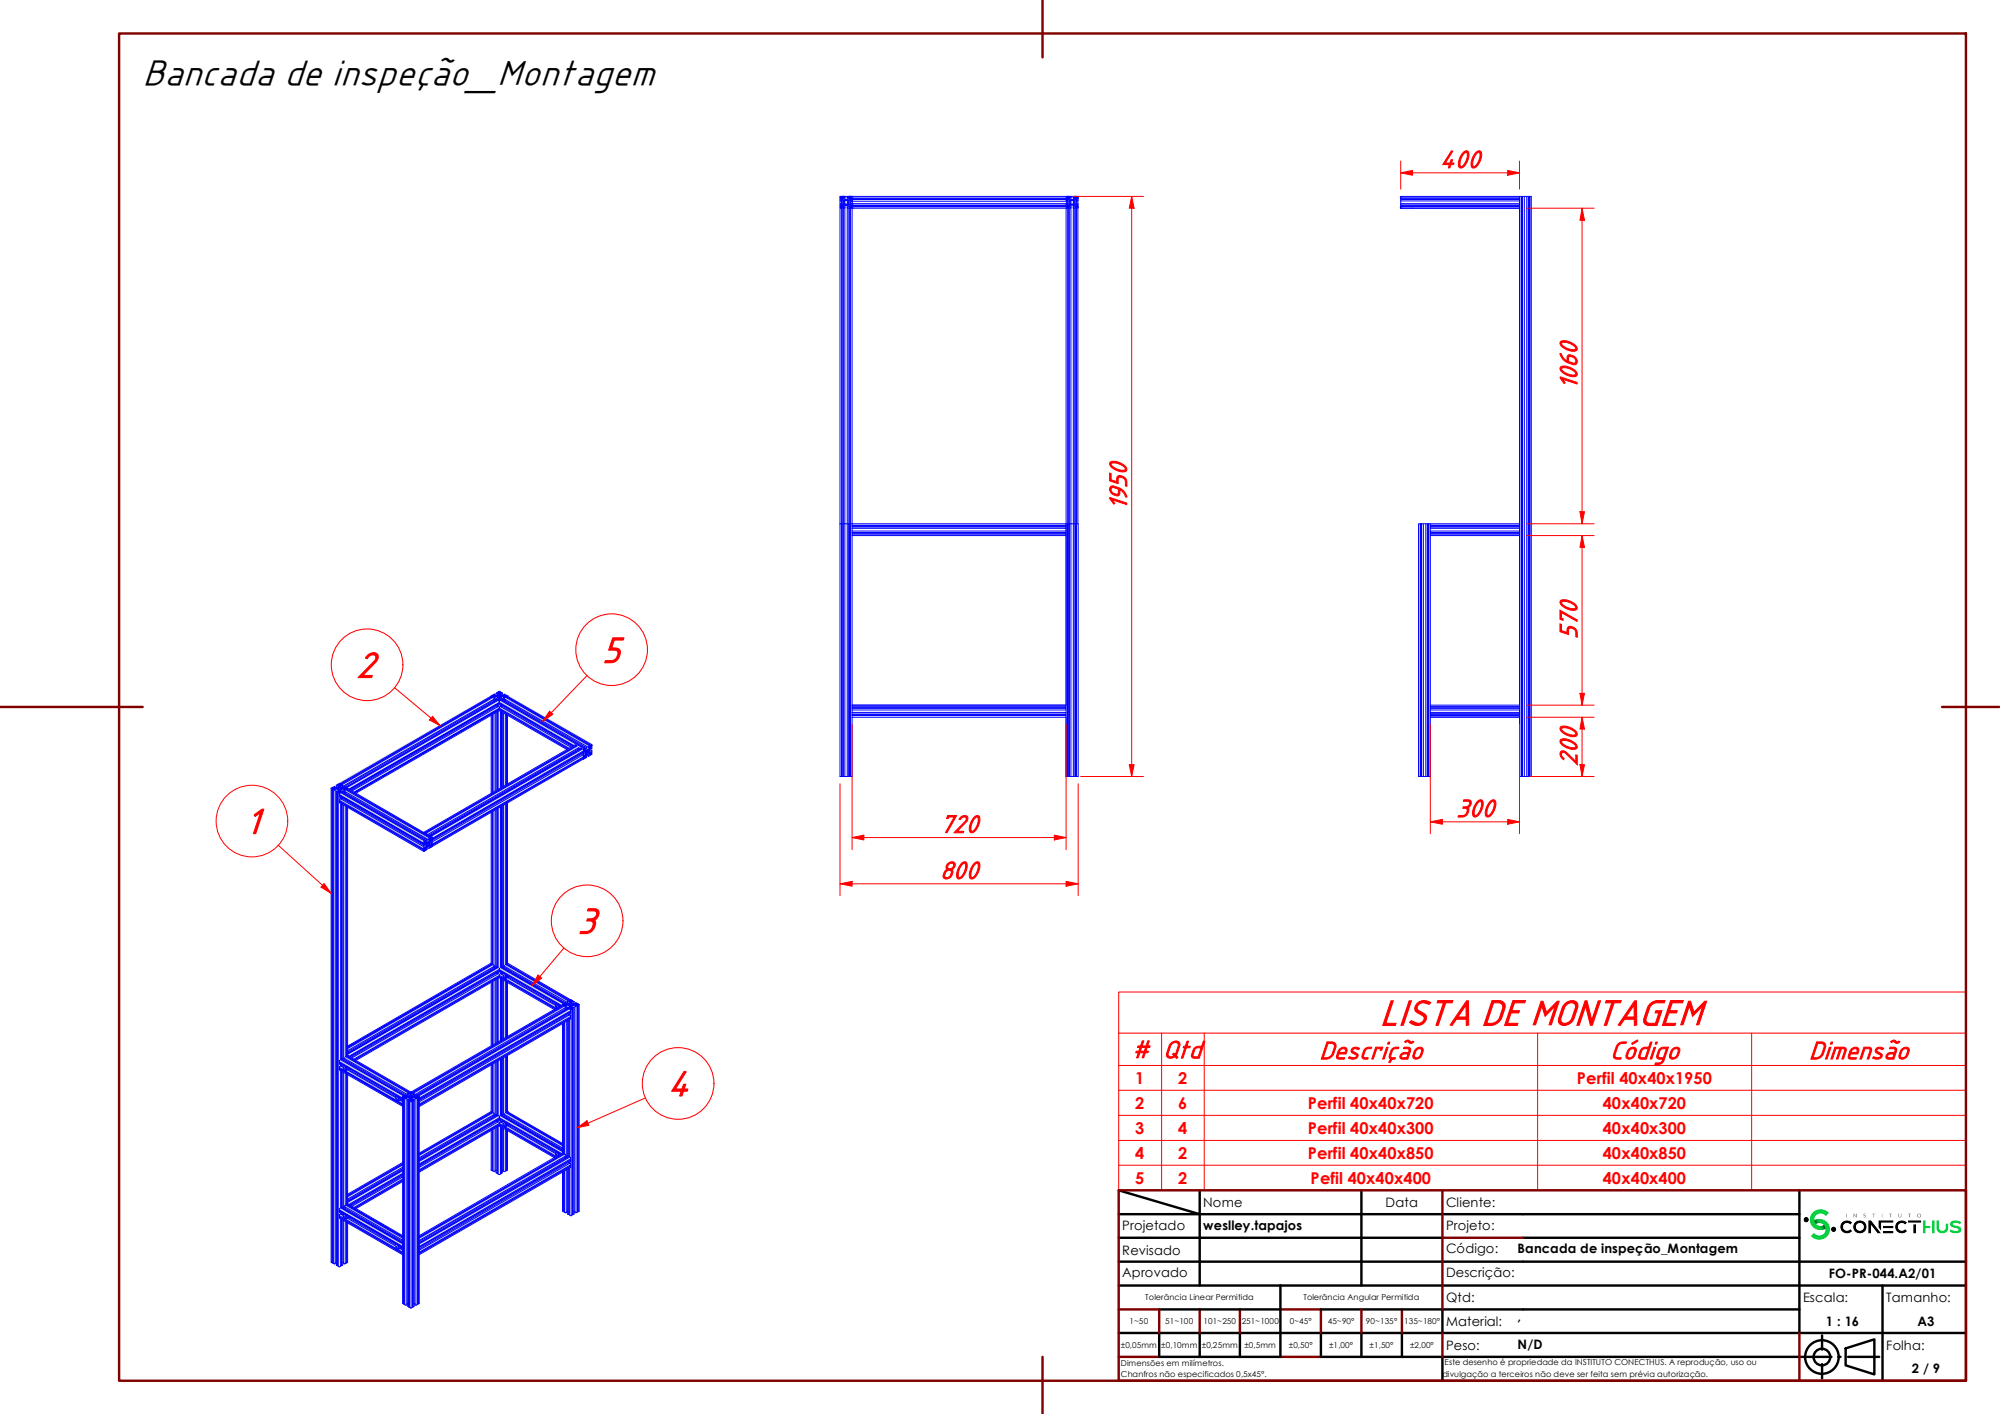
[picture p84: page 2]
Bancada de inspeção_Montagem

LISTA DE MONTAGEM

# Qtd | | Descrição | Código | Dimensão

1 | 2 | | Perfil 40x40x1950
2 | 6 | Perfil 40x40x720 | 40x40x720
3 | 4 | Perfil 40x40x300 | 40x40x300
4 | 2 | Perfil 40x40x850 | 40x40x850
5 | 2 | Pefil 40x40x400 | 40x40x400

Nome | Data | Cliente:

Projetado | weslley.tapajos | | Projeto:
Revisado | | | Código: Bancada de inspeção_Montagem

Aprovado | | | Descrição: | FO-PR-044.A2/01

M , aterial:

Peso: N/D | 2 / 9

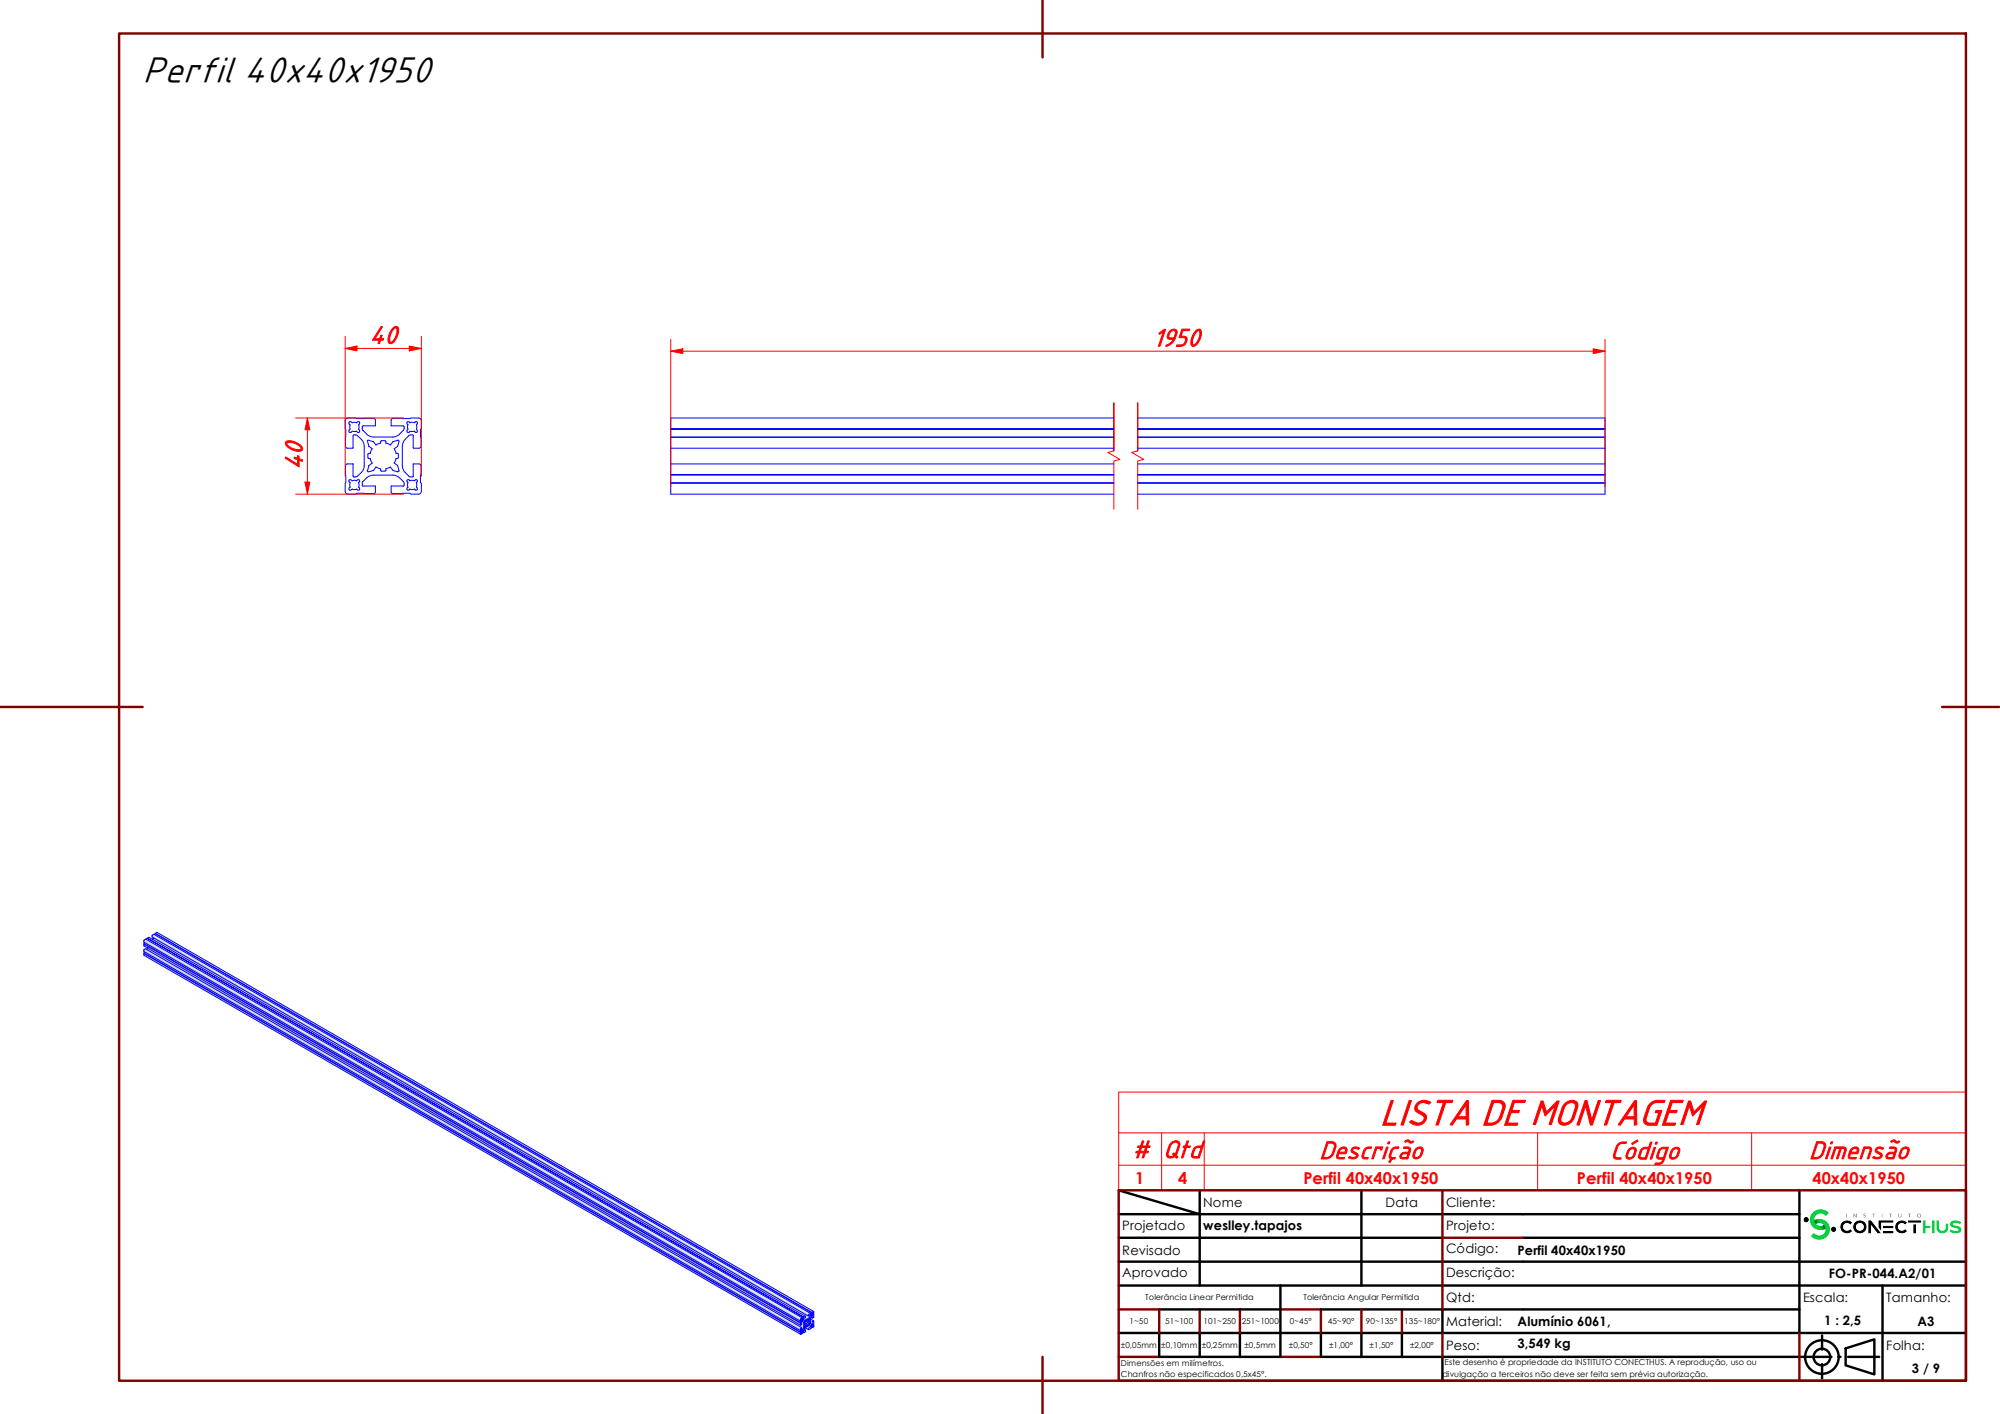
[picture p85: page 3]
Perfil 40x40x1950

LISTA DE MONTAGEM

# Qtd | | Descrição | Código | Dimensão

1 | 4 | Perfil 40x40x1950 | Perfil 40x40x1950 | 40x40x1950

Nome | Data | Cliente:

Projetado | weslley.tapajos | | Projeto:
Revisado | | | Código: Perfil 40x40x1950

Aprovado | | | Descrição: | FO-PR-044.A2/01

Material: Alumínio 6061,
Peso: 3,549 kg | 3 / 9

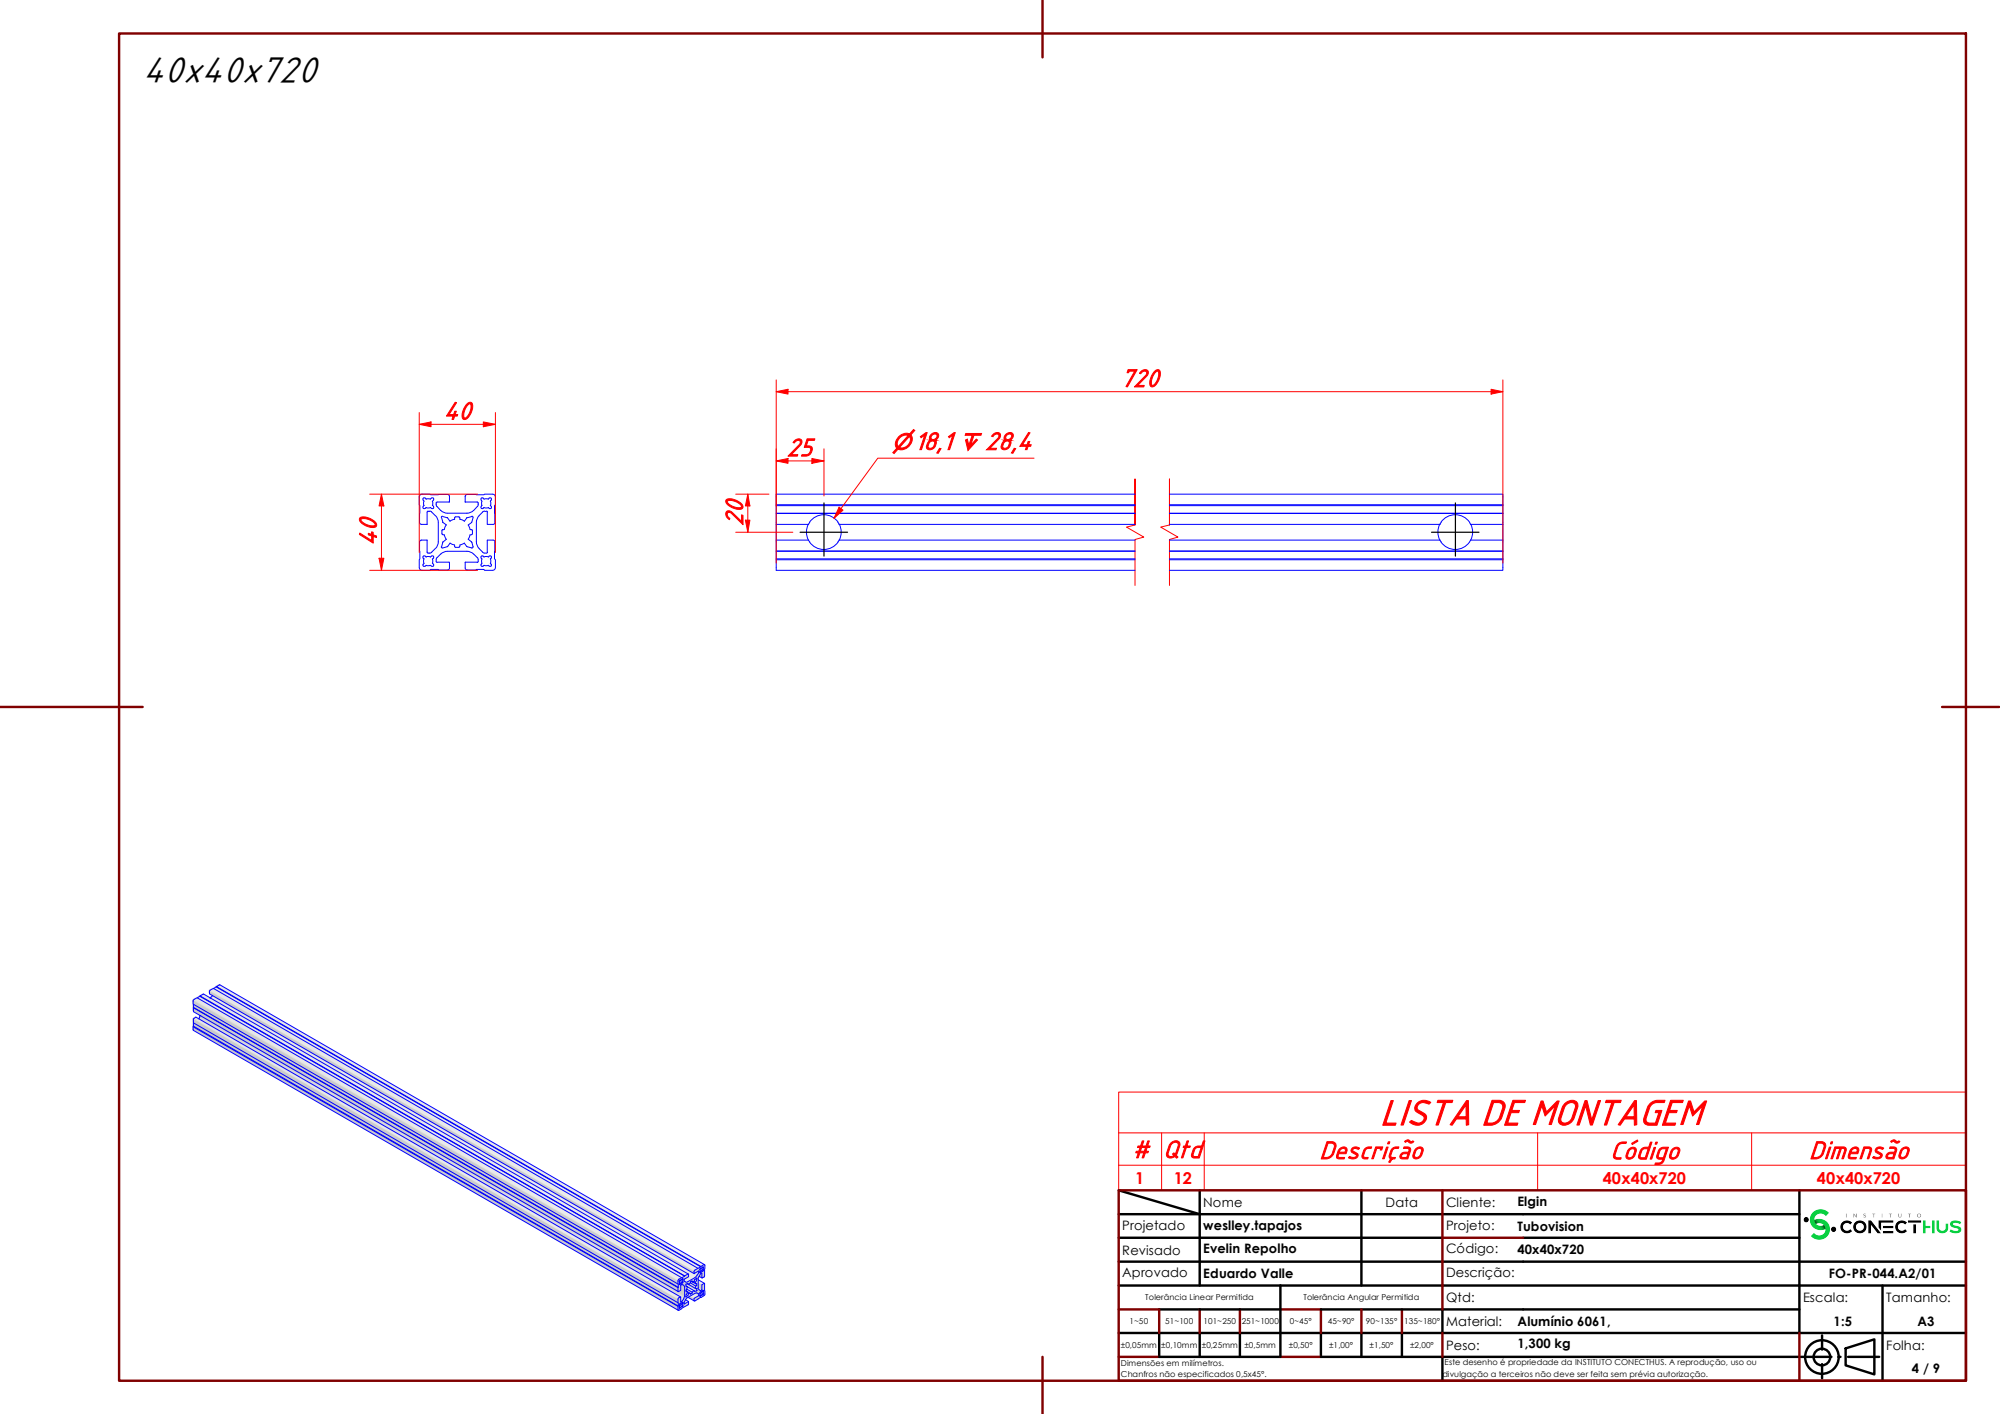
[picture p86: page 4]

LISTA DE MONTAGEM

# Qtd | | Descrição | Código | Dimensão

Nome | Data | Cliente: Elgin

Projetado | weslley.tapajos | | Projeto: Tubovision
Revisado | Evelin Repolho | | Código: 40x40x720

Aprovado | Eduardo Valle | | Descrição: | FO-PR-044.A2/01

Peso: 1,300 kg | | 4 / 9

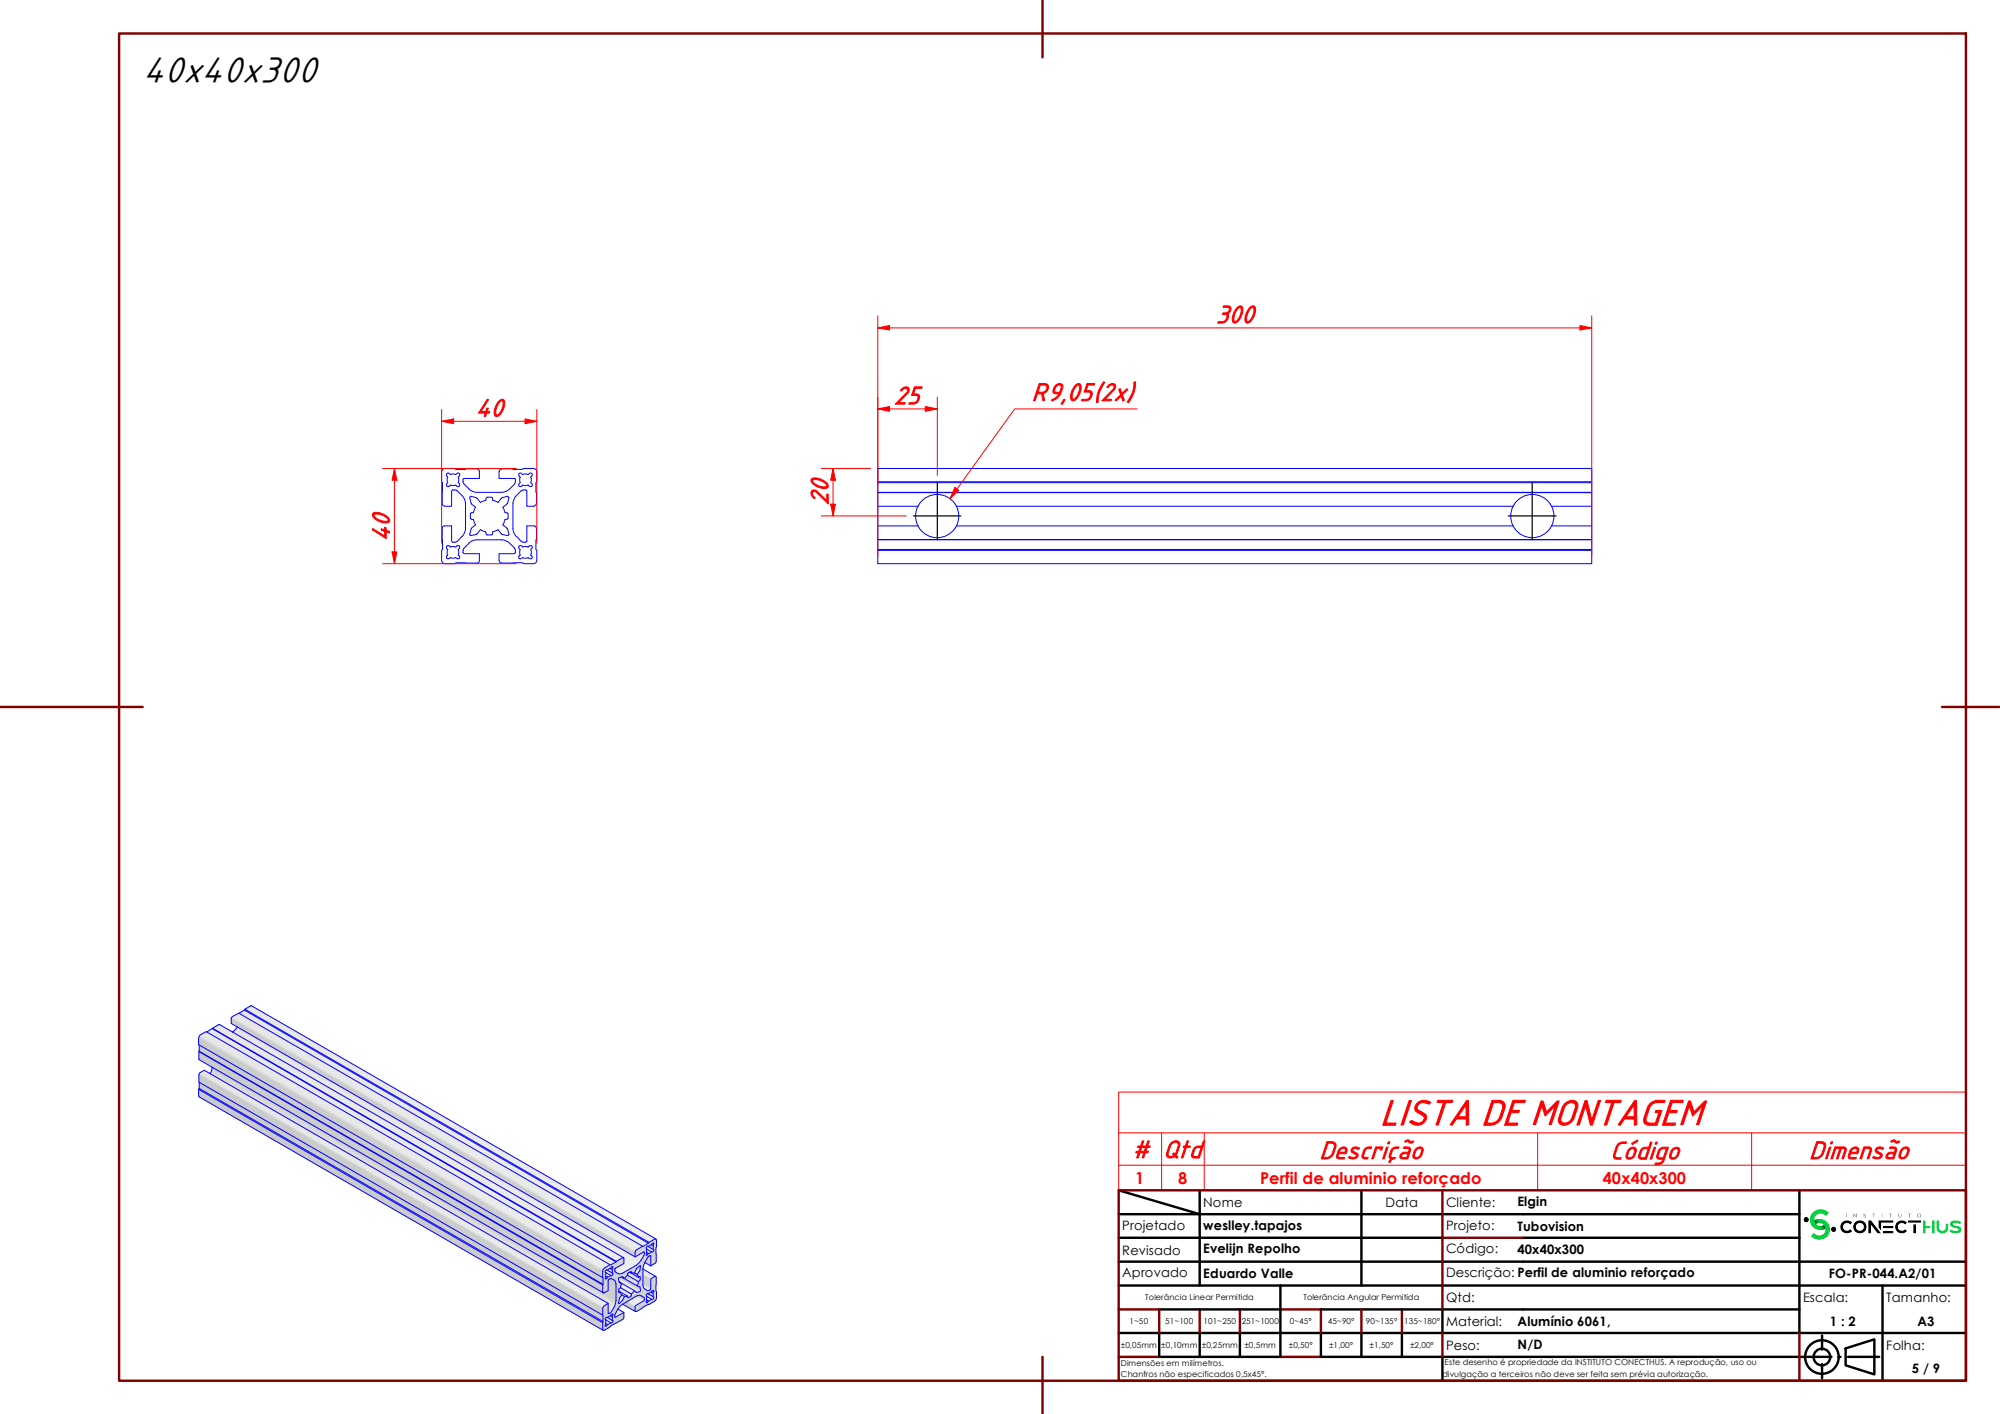
[picture p87: page 5]

LISTA DE MONTAGEM

# Qtd | | Descrição | Código | Dimensão

1 | 8 | Perfil de aluminio reforçado | 40x40x300

Nome | Data | Cliente: Elgin

Projetado | weslley.tapajos | | Projeto: Tubovision
Revisado | Evelijn Repolho | | Código: 40x40x300

Aprovado | Eduardo Valle | | Descrição: Perfil de aluminio reforçado | FO-PR-044.A2/01

Peso: N/D | | 5 / 9

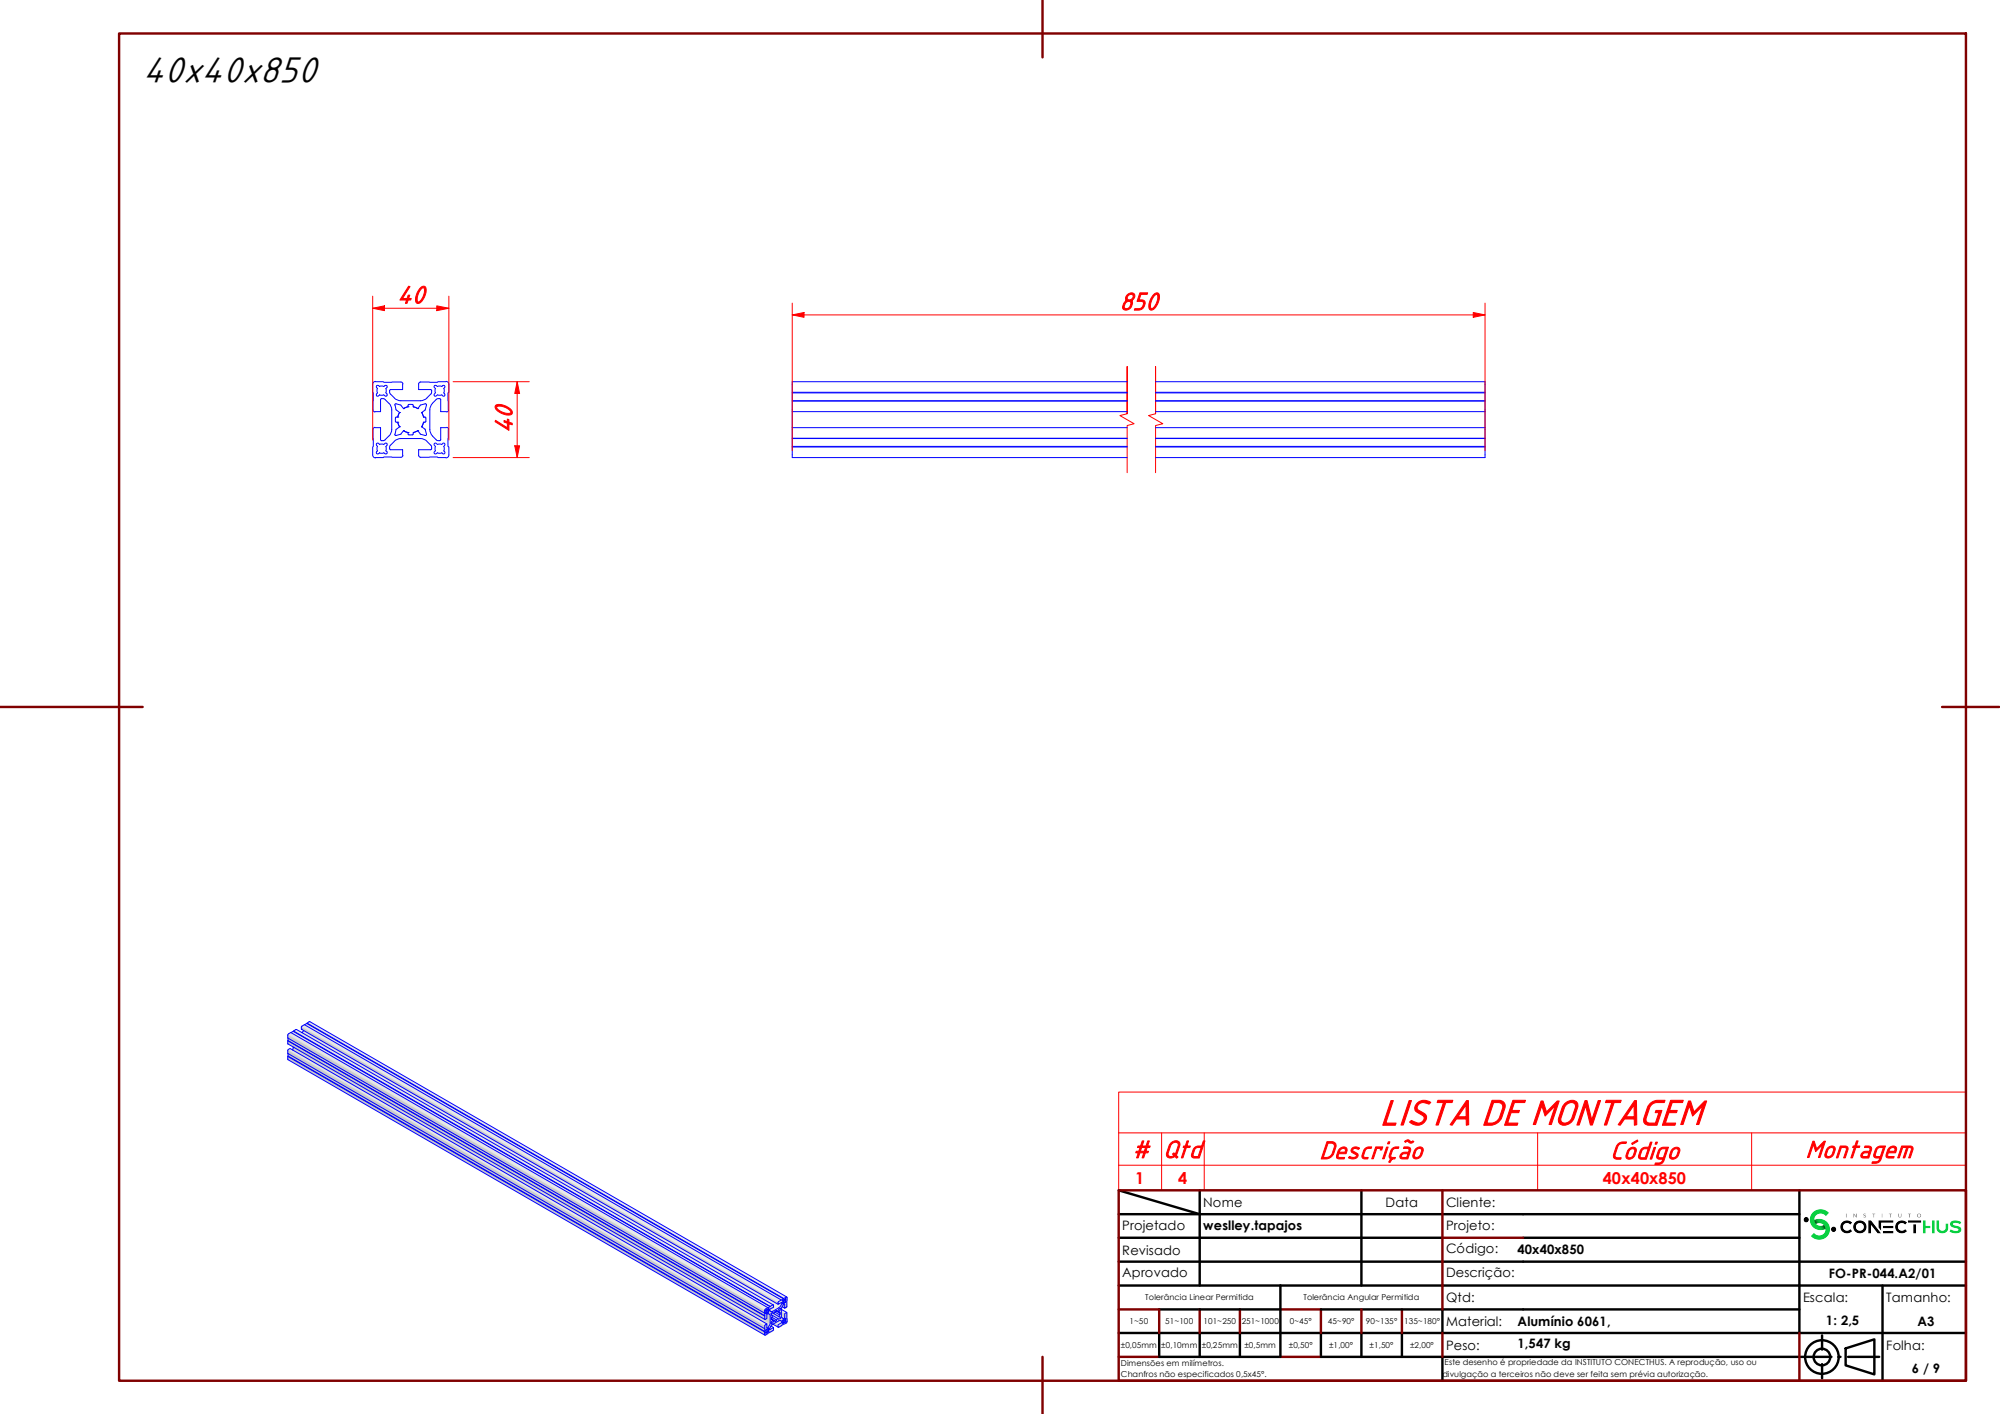
[picture p88: page 6]

LISTA DE MONTAGEM

# Qtd | | Descrição | Código | Montagem

Nome | Data | Cliente:

Projetado | weslley.tapajos | | Projeto:
Revisado | | | Código: 40x40x850

Aprovado | | | Descrição: | FO-PR-044.A2/01

Peso: 1,547 kg | | 6 / 9

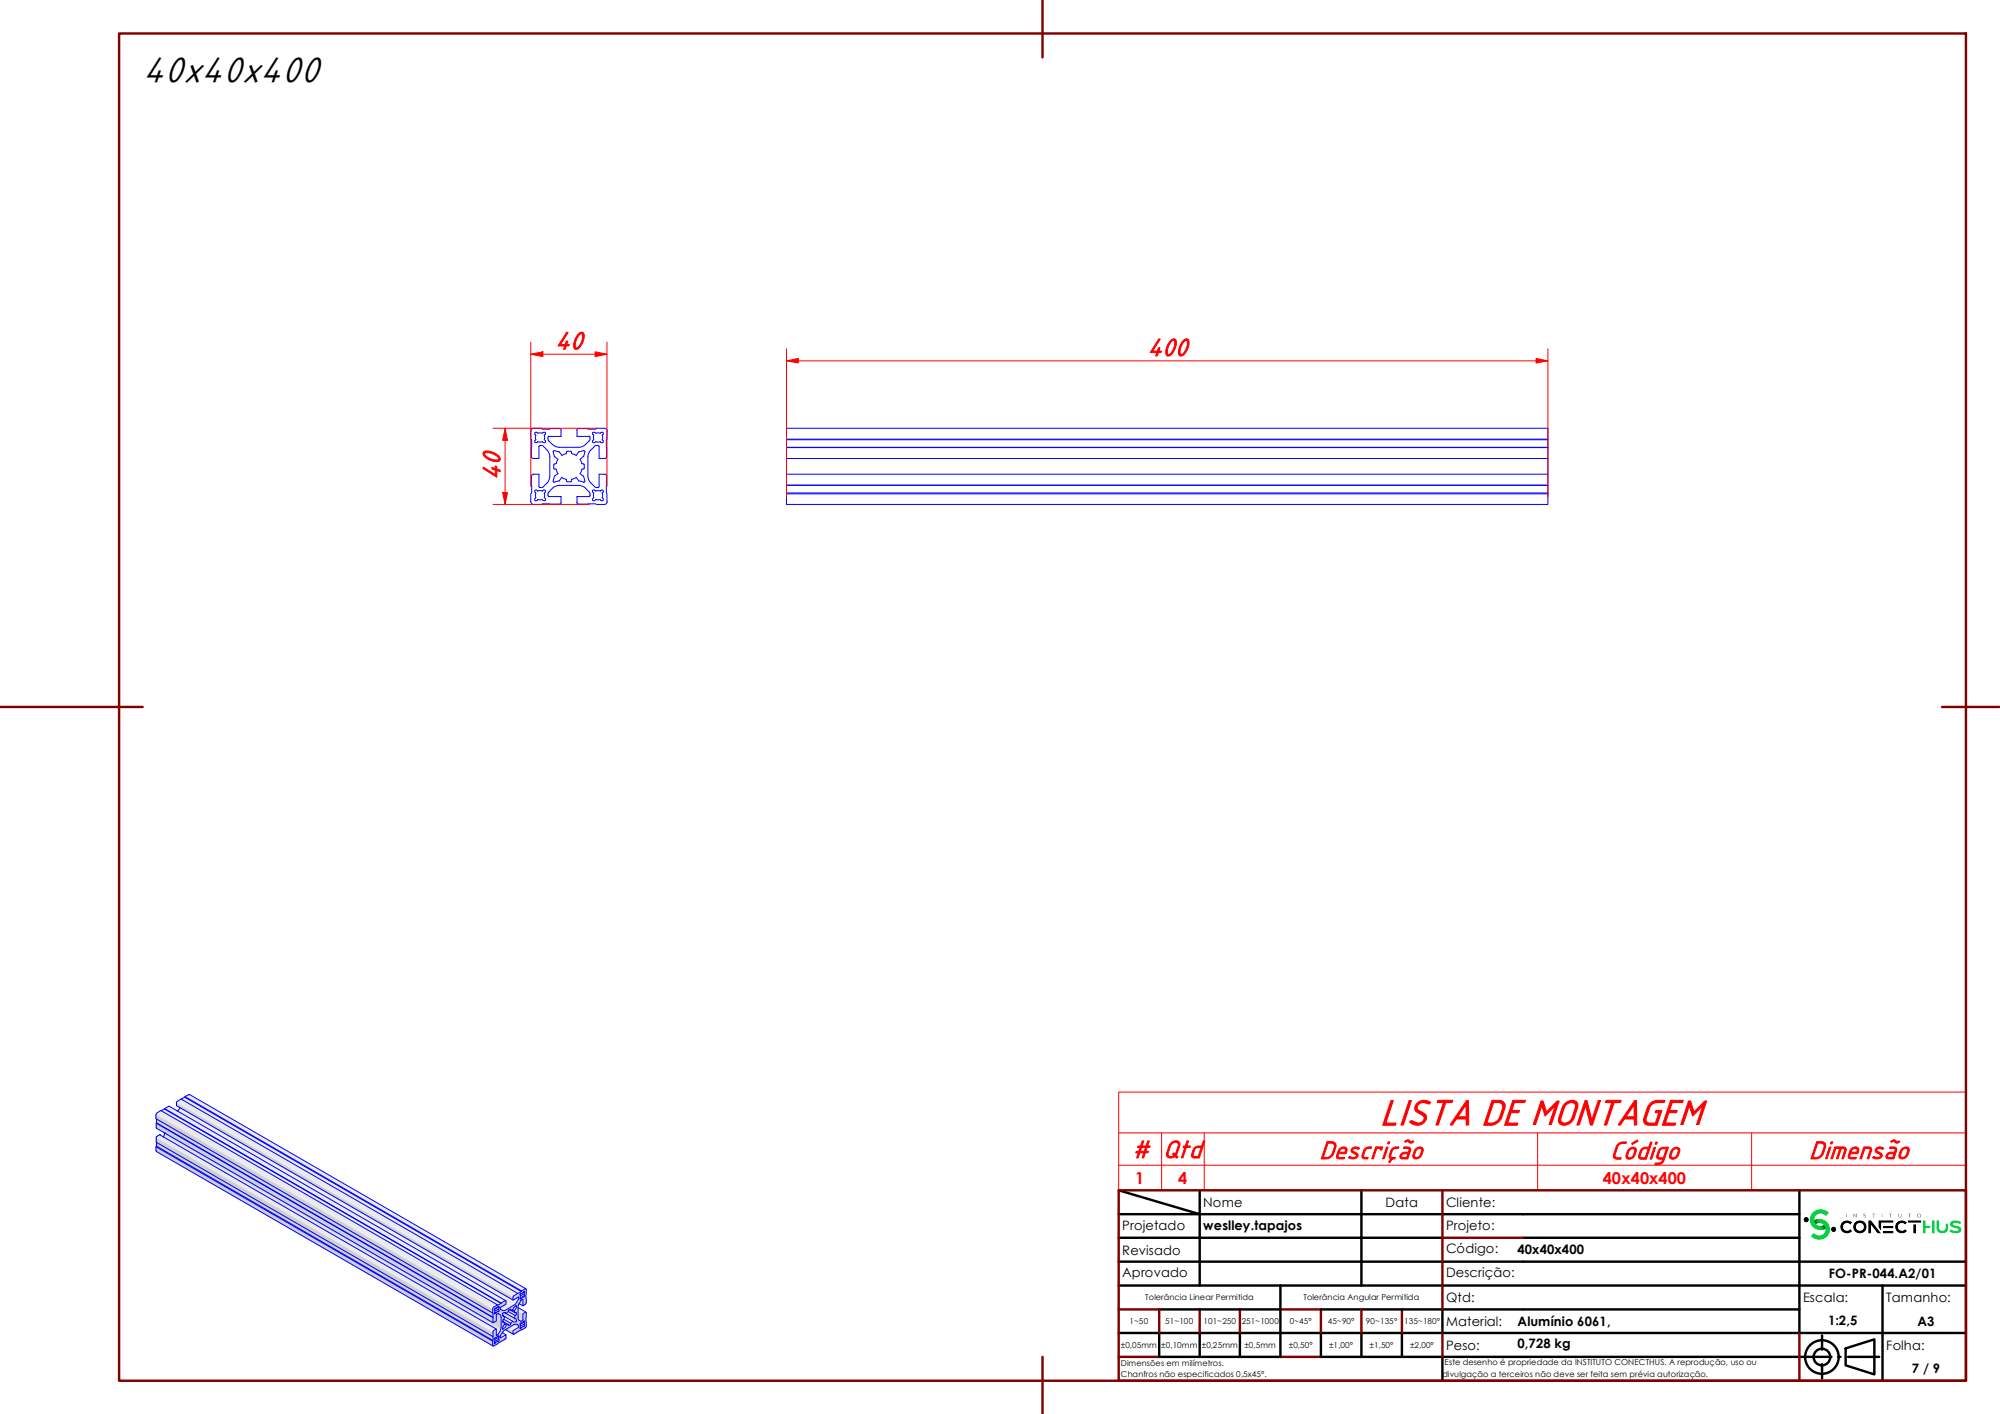
[picture p89: page 7]

LISTA DE MONTAGEM

# Qtd | | Descrição | Código | Dimensão

Nome | Data | Cliente:

Projetado | weslley.tapajos | | Projeto:
Revisado | | | Código: 40x40x400

Aprovado | | | Descrição: | FO-PR-044.A2/01

Peso: 0,728 kg | | 7 / 9

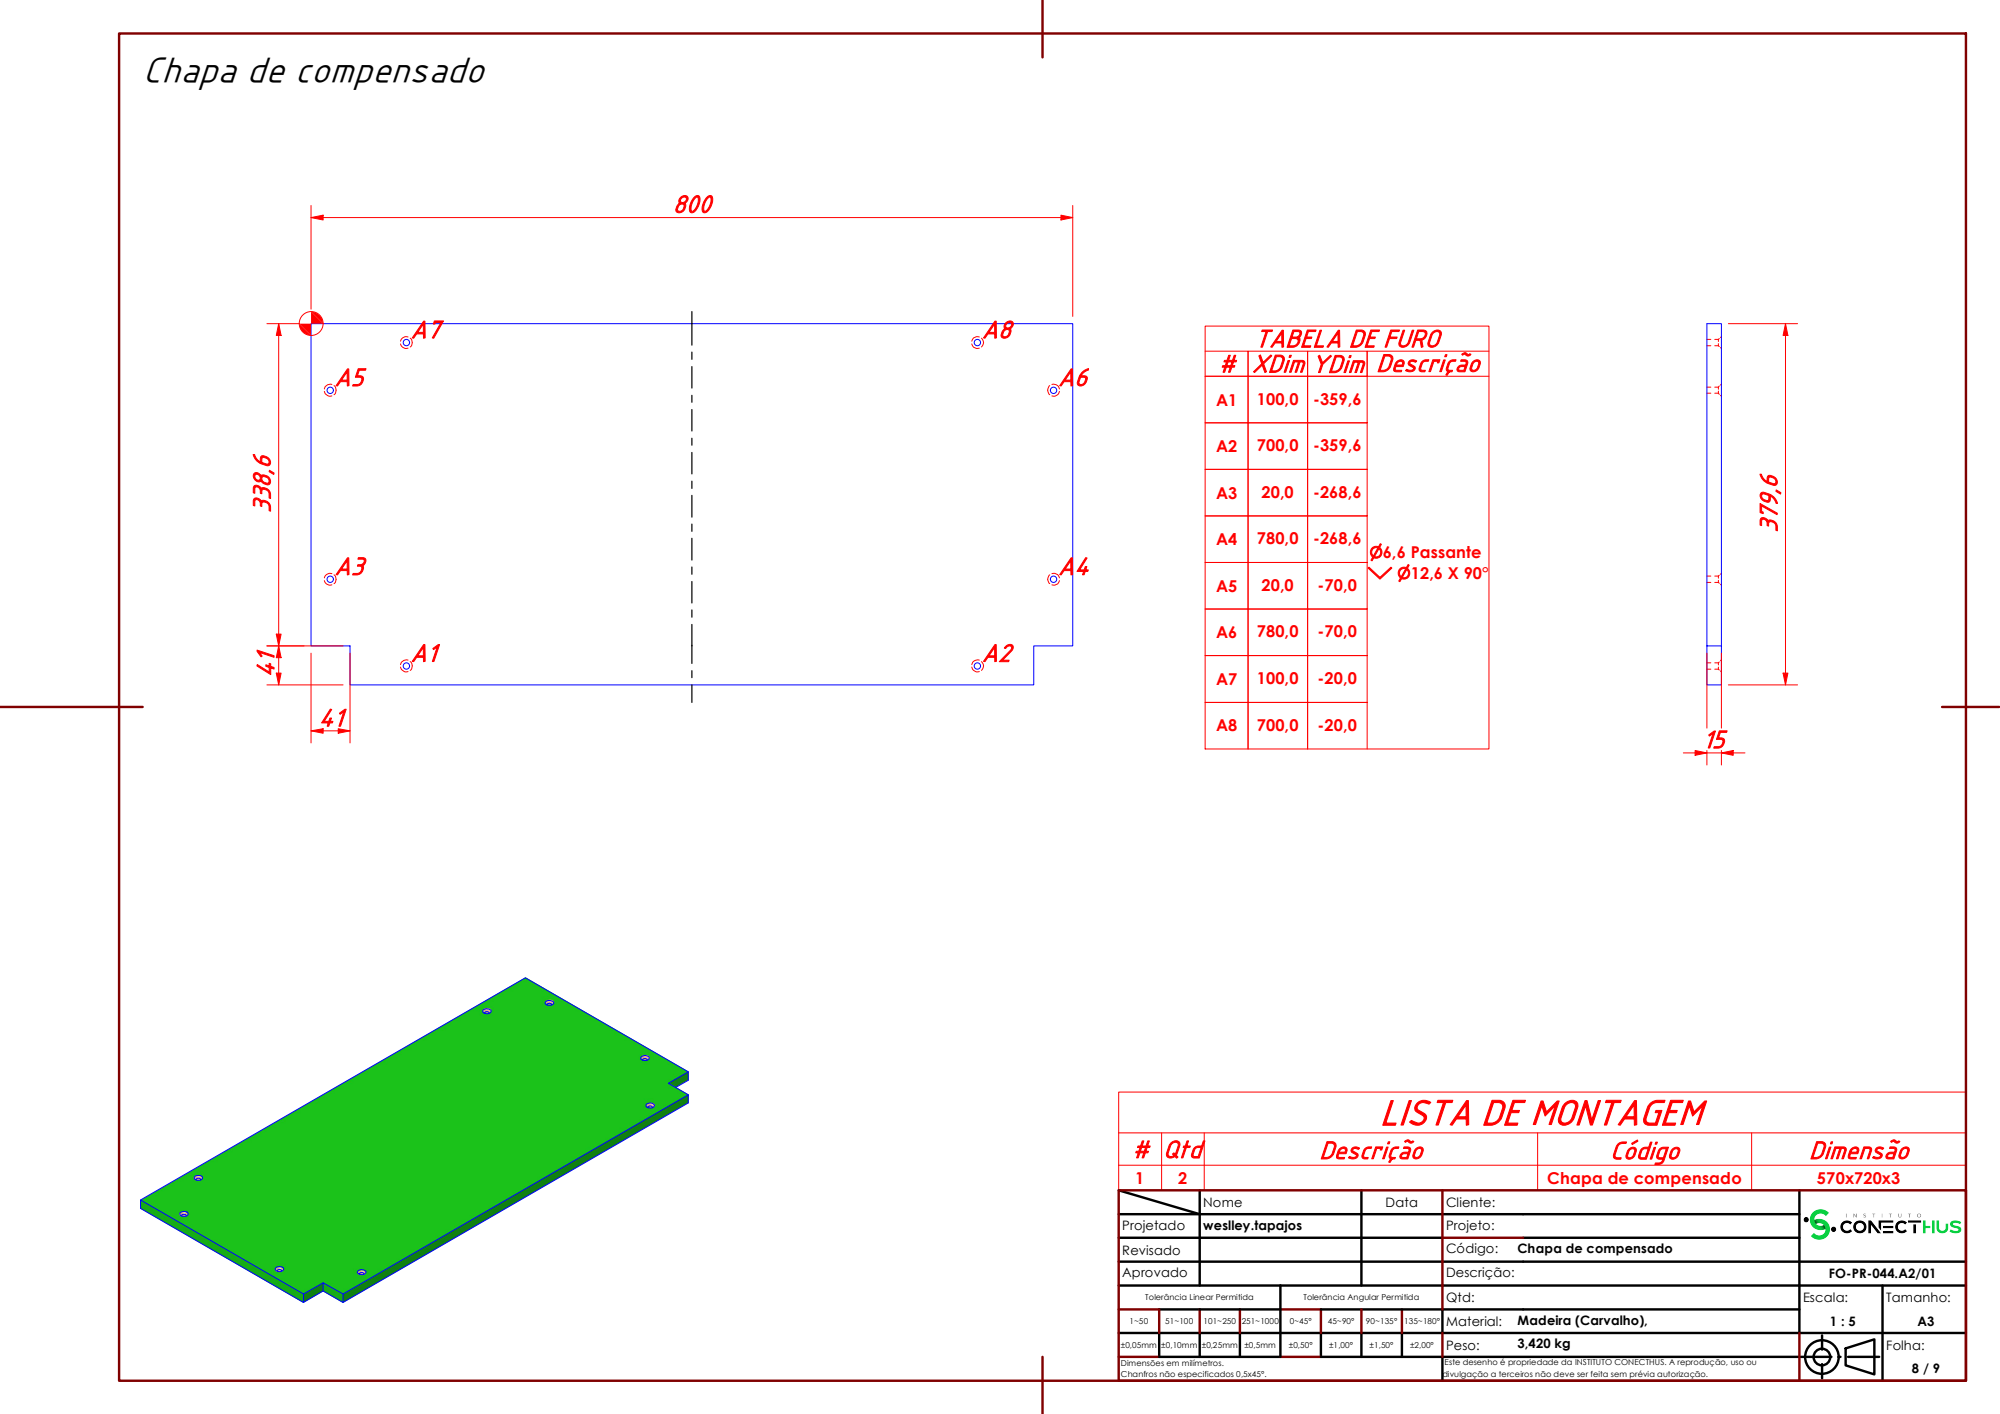
[picture p90: page 8]

Chapa de compensado

TABELA DE FURO

# | XDim YDim Descrição

A1 | 100,0 | -359,6 | ⌀6,6 Passante ⌵ ⌀12,6 X 90°

LISTA DE MONTAGEM

# Qtd | | Descrição | Código | Dimensão

1 | 2 | | Chapa de compensado | 570x720x3

Nome | Data | Cliente:

Projetado | weslley.tapajos | | Projeto:
Revisado | | | Código: Chapa de compensado

Aprovado | | | Descrição: | FO-PR-044.A2/01

Material: Madeira (Carvalho),
Peso: 3,420 kg | 8 / 9

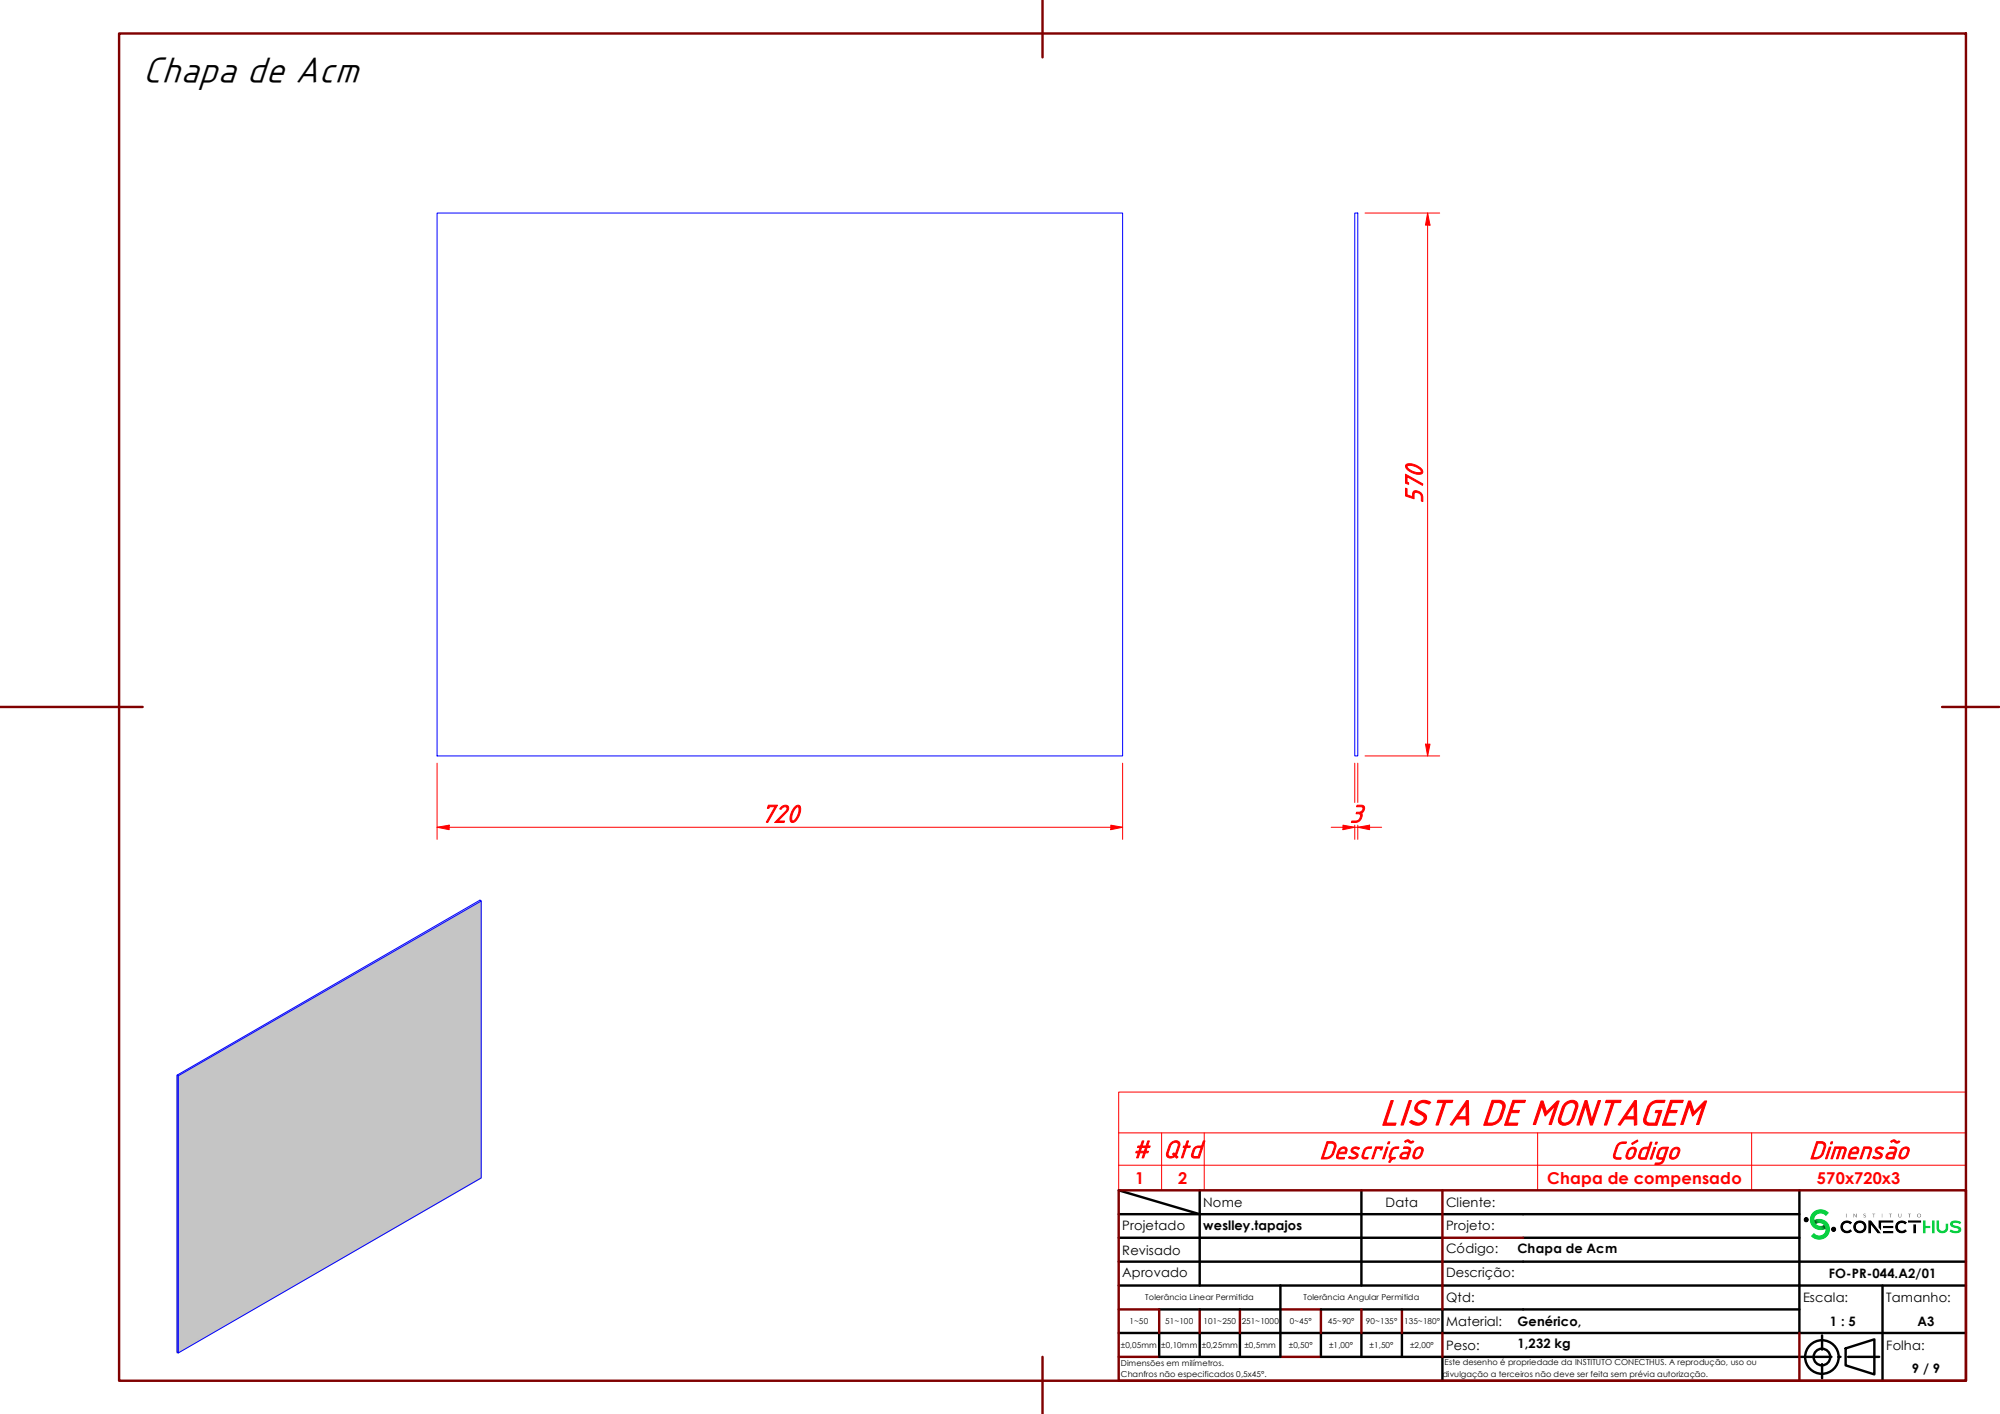
[picture p91: page 9]

Chapa de Acm

LISTA DE MONTAGEM

# Qtd | | Descrição | Código | Dimensão

1 | 2 | | Chapa de compensado | 570x720x3

Nome | Data | Cliente:

Projetado | weslley.tapajos | | Projeto:
Revisado | | | Código: Chapa de Acm

Aprovado | | | Descrição: | FO-PR-044.A2/01

Material: Genérico,
Peso: 1,232 kg | 9 / 9
