pvrezende/Dashboard/uploads/anexo-1753897478666-53587863.pdf

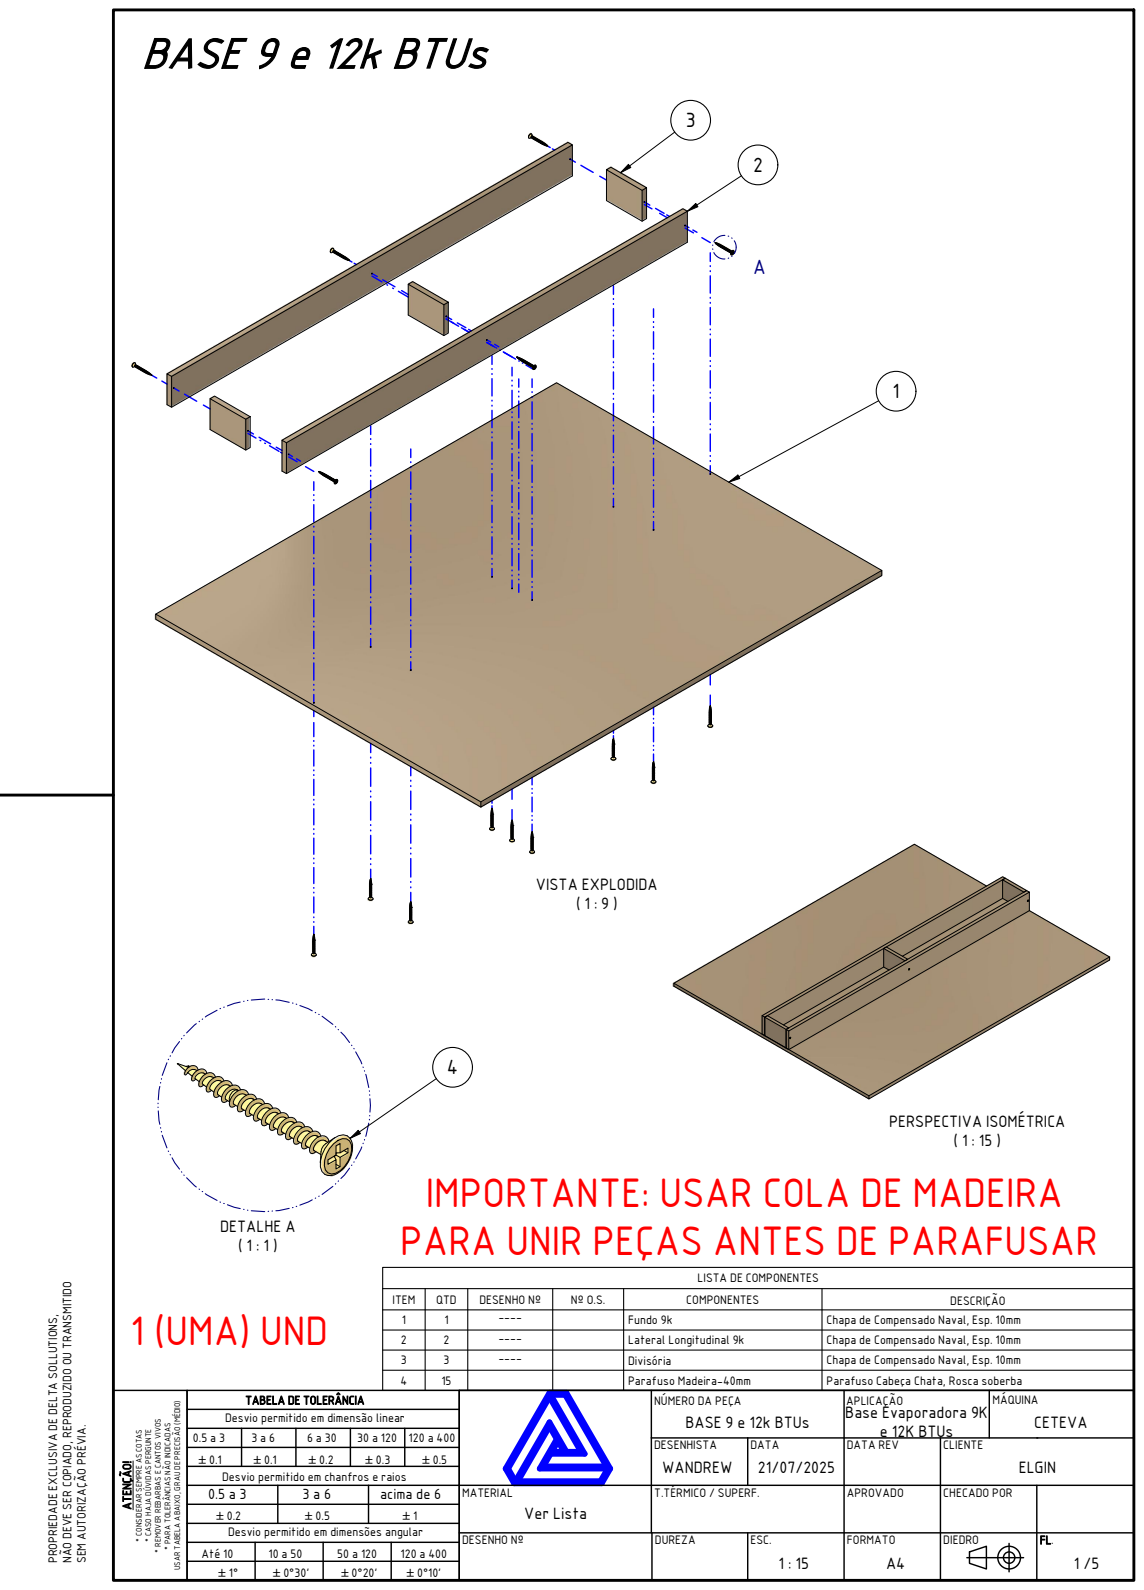
[picture p92: page 1]
PERSPECTIVA ISOMÉTRICA; VISTA EXPLODIDA ( 1 : 9 ); DETALHE A ( 1 : 1 ); BASE 9 e 12k BTUs

IMPORTANTE: USAR COLA DE MADEIRA
PARA UNIR PEÇAS ANTES DE PARAFUSAR

NÃO DEVE SER COPIADO, REPRODUZIDO OU TRANSMITIDO
1 (UMA) UND

LISTA DE COMPONENTES

ITEM | QTD | DESENHO Nº | Nº O.S. | COMPONENTES | DESCRIÇÃO
1 | 1 | ---- | | Fundo 9k | Chapa de Compensado Naval, Esp. 10mm
2 | 2 | ---- | | Lateral Longitudinal 9k | Chapa de Compensado Naval, Esp. 10mm
3 | 3 | ---- | | Divisória | Chapa de Compensado Naval, Esp. 10mm

PROPRIEDADE EXCLUSIVA DE DELTA SOLLUTIONS,

4 | 15 | | | Parafuso Madeira-40mm | Parafuso Cabeça Chata, Rosca soberba

USAR TABELA ABAIXO, GRAU DE PRECISÃO (MÉDIO)

TABELA DE TOLERÂNCIA | | NÚMERO DA PEÇA BASE 9 e 12k BTUs | APLICAÇÃO Base Evaporadora 9K e 12K BTUs | MÁQUINA CETEVA

Desvio permitido em dimensão linear

SEM AUTORIZAÇÃO PRÉVIA.

* CONSIDERAR SEMPRE AS COTAS

* CASO HAJA DÚVIDAS PERGUNTE

* REMOVER REBARBAS E CANTOS VIVOS

* PARA TOLERÂNCIAS NÃO INDICADAS

0.5 a 3 | 3 a 6 | 6 a 30 | 30 a 120 | 120 a 400
`0.1 | `0.1 | `0.2 | `0.3 | `0.5

DESENHISTA WANDREW | DATA 21/07/2025 | DATA REV | CLIENTE ELGIN

Desvio permitido em chanfros e raios

0.5 a 3 | 3 a 6 | acima de 6 | MATERIAL Ver Lista | T.TÉRMICO / SUPERF. | APROVADO | CHECADO POR

Desvio permitido em dimensões angular

DESENHO Nº | DUREZA | ESC. 1 : 15 | FORMATO A4 | DIEDRO | FL.

Até 10 | 10 a 50 | 50 a 120 | 120 a 400
`1° | `0°30' | `0°20' | `0°10'

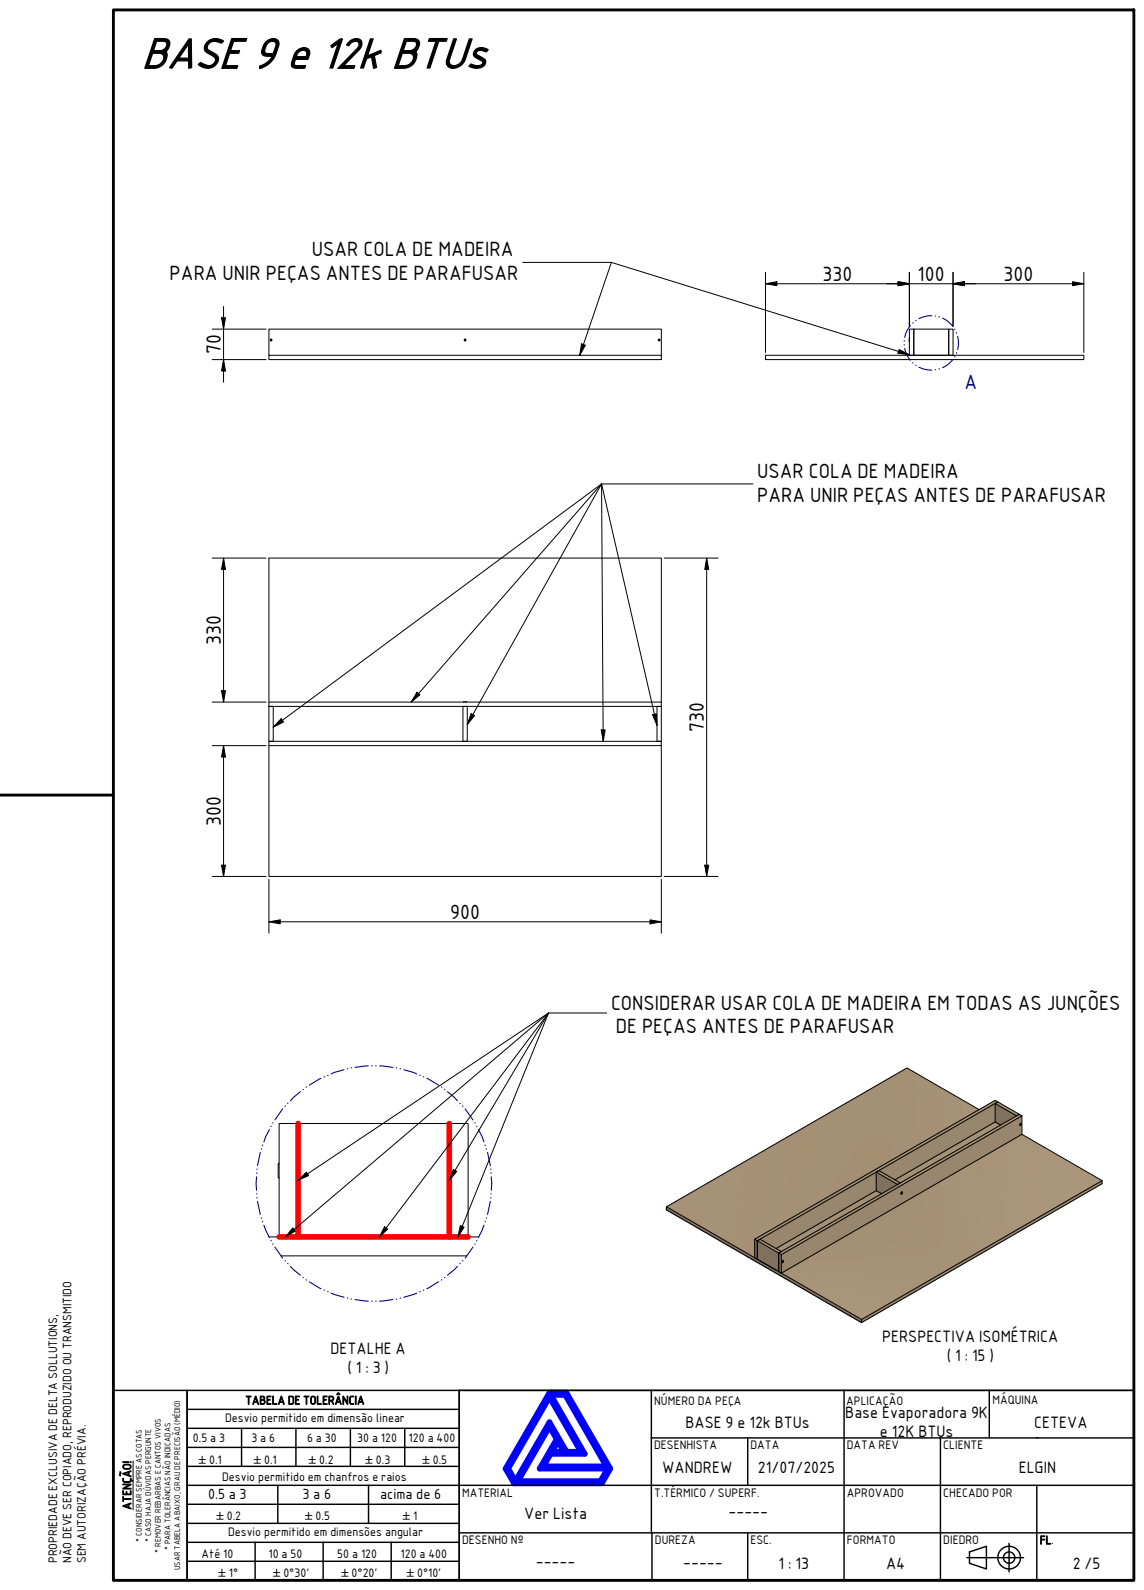
[picture p93: page 2]
PERSPECTIVA ISOMÉTRICA; DETALHE A ( 1 : 3 ); BASE 9 e 12k BTUs; NÚMERO DA PEÇA; APLICAÇÃO; MÁQUINA; Base Evaporadora 9K e 12K BTUs

USAR COLA DE MADEIRA

PARA UNIR PEÇAS ANTES DE PARAFUSAR

CONSIDERAR USAR COLA DE MADEIRA EM TODAS AS JUNÇÕES
DE PEÇAS ANTES DE PARAFUSAR

NÃO DEVE SER COPIADO, REPRODUZIDO OU TRANSMITIDO

PROPRIEDADE EXCLUSIVA DE DELTA SOLLUTIONS,

USAR TABELA ABAIXO, GRAU DE PRECISÃO (MÉDIO)

TABELA DE TOLERÂNCIA
Desvio permitido em dimensão linear

SEM AUTORIZAÇÃO PRÉVIA.

* CONSIDERAR SEMPRE AS COTAS

* CASO HAJA DÚVIDAS PERGUNTE

* REMOVER REBARBAS E CANTOS VIVOS

* PARA TOLERÂNCIAS NÃO INDICADAS

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

DESENHISTA WANDREW | DATA 21/07/2025 | DATA REV | CLIENTE ELGIN

Desvio permitido em chanfros e raios

MATERIAL Ver Lista | T.TÉRMICO / SUPERF. ----- | APROVADO

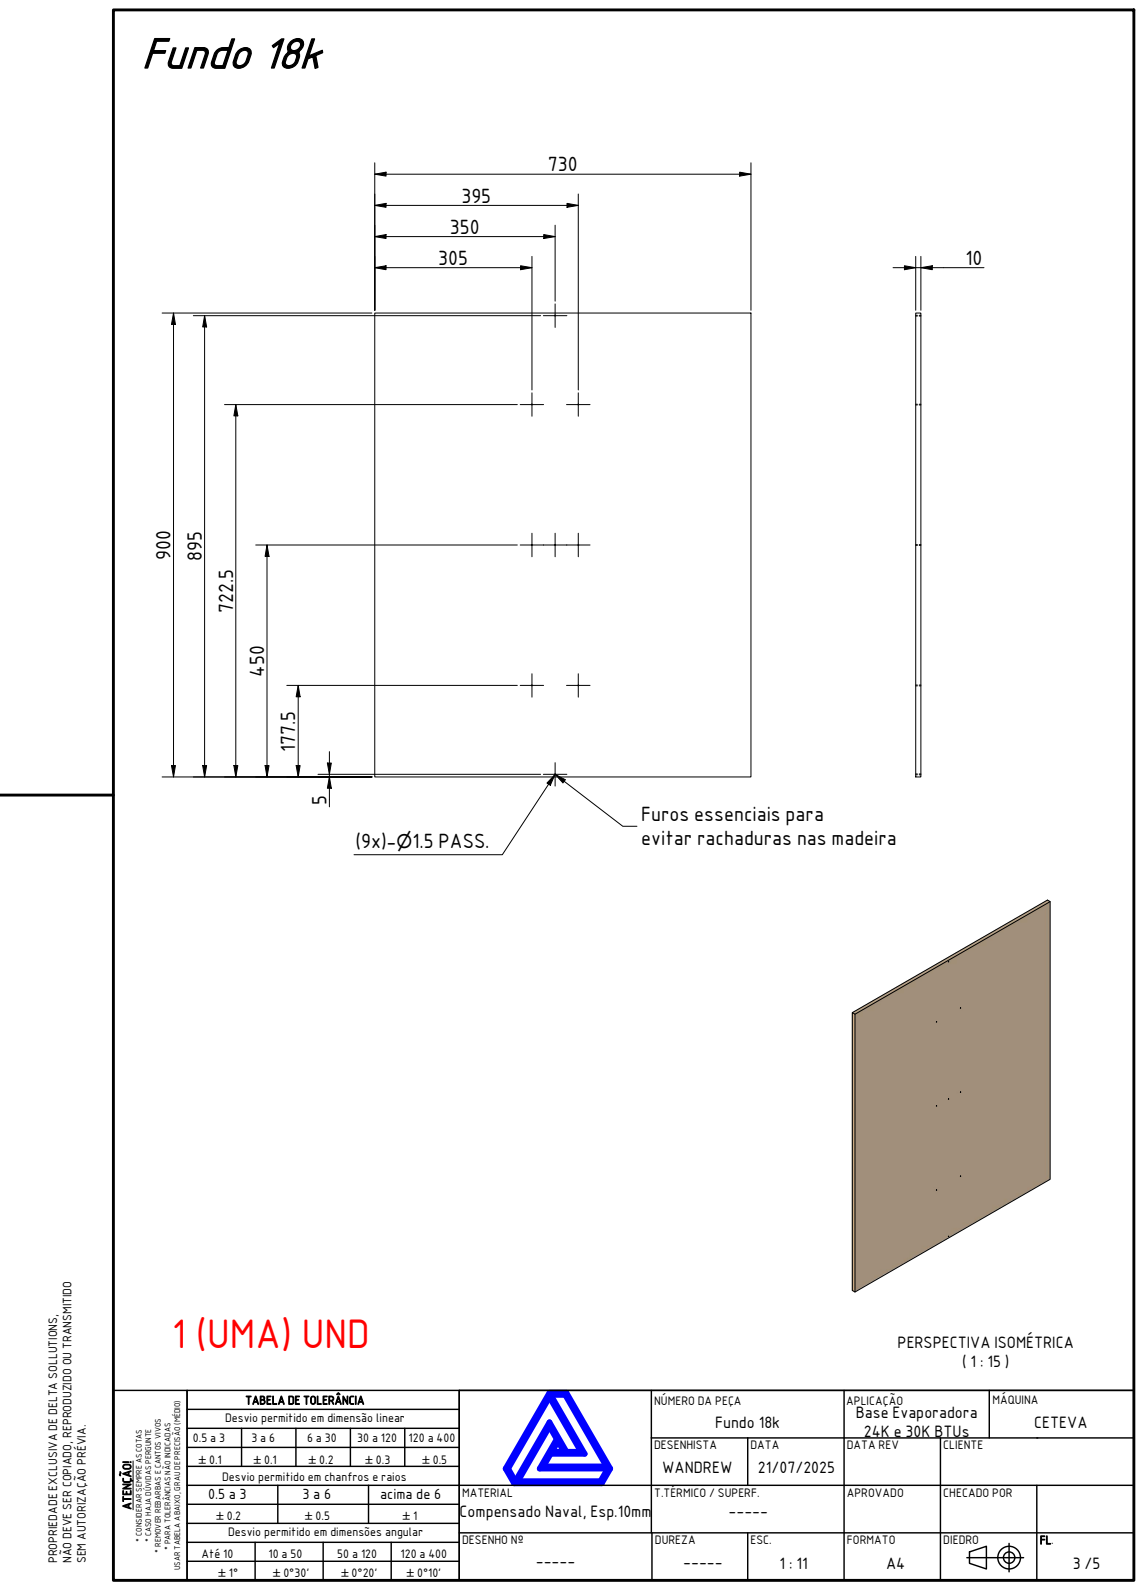
[picture p94: page 3]
PERSPECTIVA ISOMÉTRICA; Fundo 18k; NÚMERO DA PEÇA; APLICAÇÃO; MÁQUINA; Base Evaporadora 24K e 30K BTUs; 1 (UMA) UND; (9x)-⌀1.5 PASS.

Furos essenciais para
evitar rachaduras nas madeira

NÃO DEVE SER COPIADO, REPRODUZIDO OU TRANSMITIDO

PROPRIEDADE EXCLUSIVA DE DELTA SOLLUTIONS,

USAR TABELA ABAIXO, GRAU DE PRECISÃO (MÉDIO)

TABELA DE TOLERÂNCIA
Desvio permitido em dimensão linear

SEM AUTORIZAÇÃO PRÉVIA.

* CONSIDERAR SEMPRE AS COTAS

* CASO HAJA DÚVIDAS PERGUNTE

* REMOVER REBARBAS E CANTOS VIVOS

* PARA TOLERÂNCIAS NÃO INDICADAS

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

DESENHISTA WANDREW | DATA 21/07/2025 | DATA REV | CLIENTE

Desvio permitido em chanfros e raios

MATERIAL Compensado Naval, Esp.10mm | T.TÉRMICO / SUPERF. | APROVADO

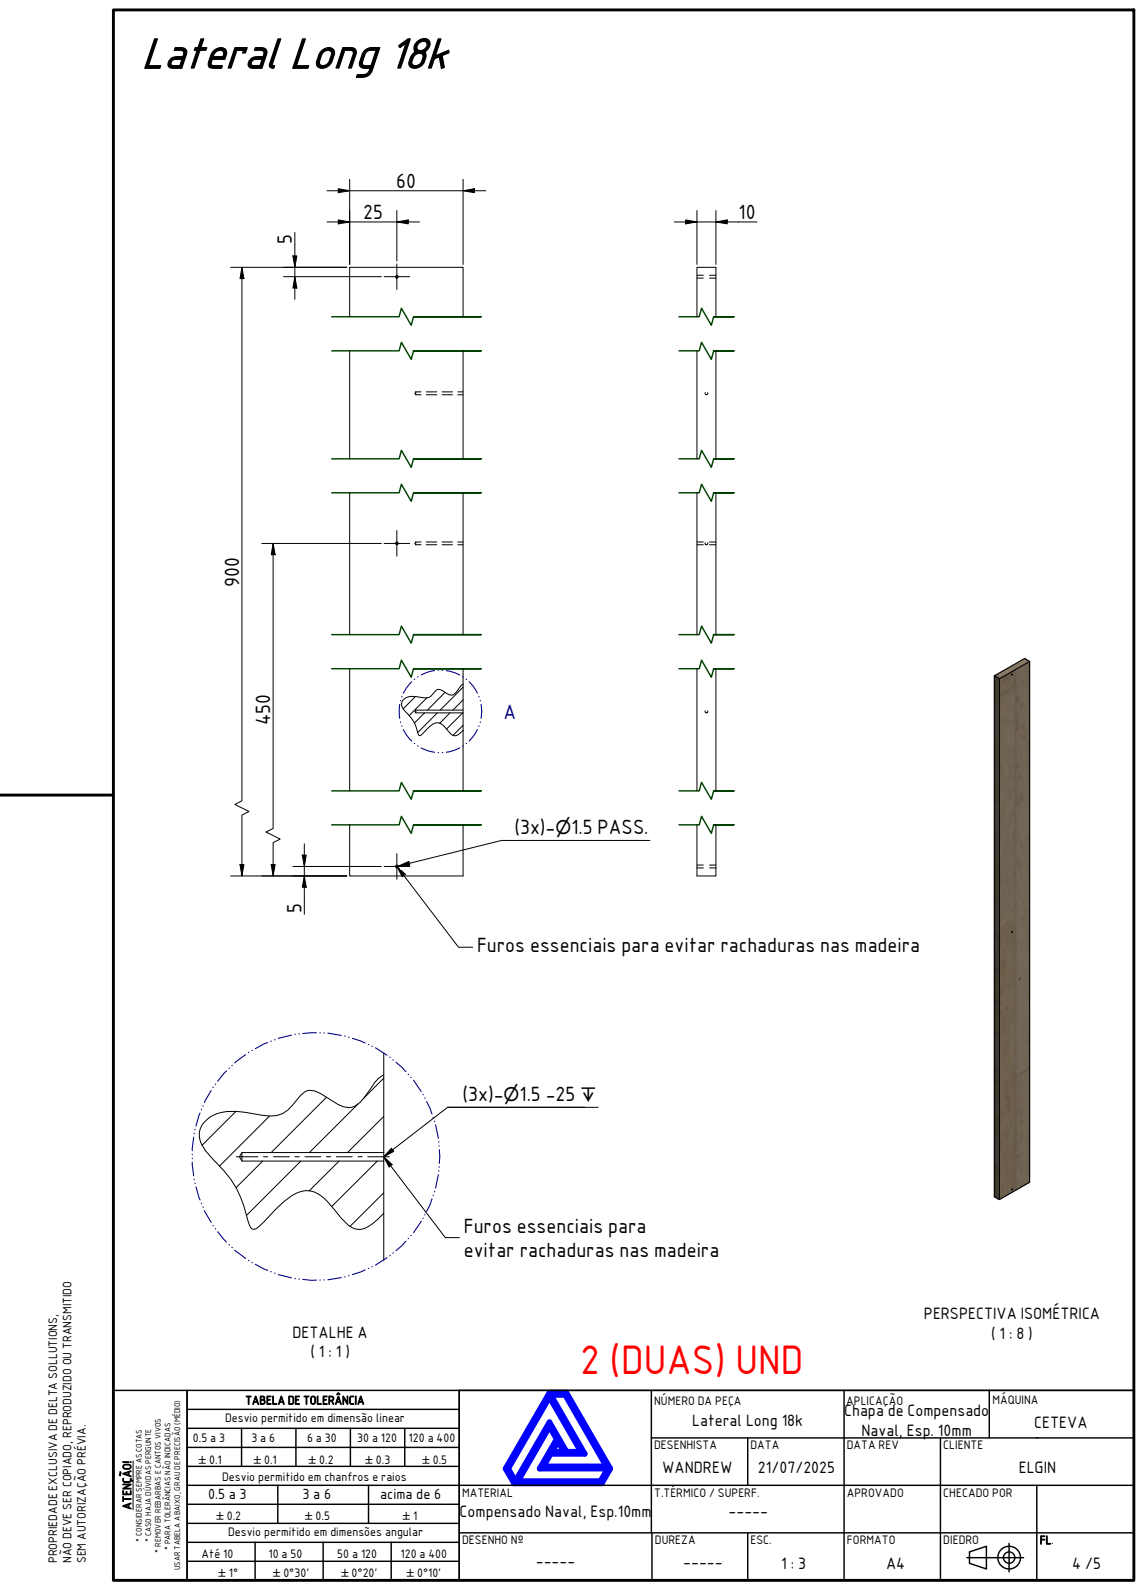
[picture p95: page 4]
PERSPECTIVA ISOMÉTRICA; DETALHE A; Lateral Long 18k; NÚMERO DA PEÇA; APLICAÇÃO; MÁQUINA; 2 (DUAS) UND; (3x)-⌀1.5 PASS.

Furos essenciais para evitar rachaduras nas madeira

Furos essenciais para
evitar rachaduras nas madeira

NÃO DEVE SER COPIADO, REPRODUZIDO OU TRANSMITIDO

PROPRIEDADE EXCLUSIVA DE DELTA SOLLUTIONS,

USAR TABELA ABAIXO, GRAU DE PRECISÃO (MÉDIO)

TABELA DE TOLERÂNCIA
Desvio permitido em dimensão linear

Chapa de Compensado
Naval, Esp. 10mm

SEM AUTORIZAÇÃO PRÉVIA.

* CONSIDERAR SEMPRE AS COTAS

* CASO HAJA DÚVIDAS PERGUNTE

* REMOVER REBARBAS E CANTOS VIVOS

* PARA TOLERÂNCIAS NÃO INDICADAS

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

DESENHISTA WANDREW | DATA 21/07/2025 | DATA REV | CLIENTE ELGIN

Desvio permitido em chanfros e raios

MATERIAL | T.TÉRMICO / SUPERF. | APROVADO

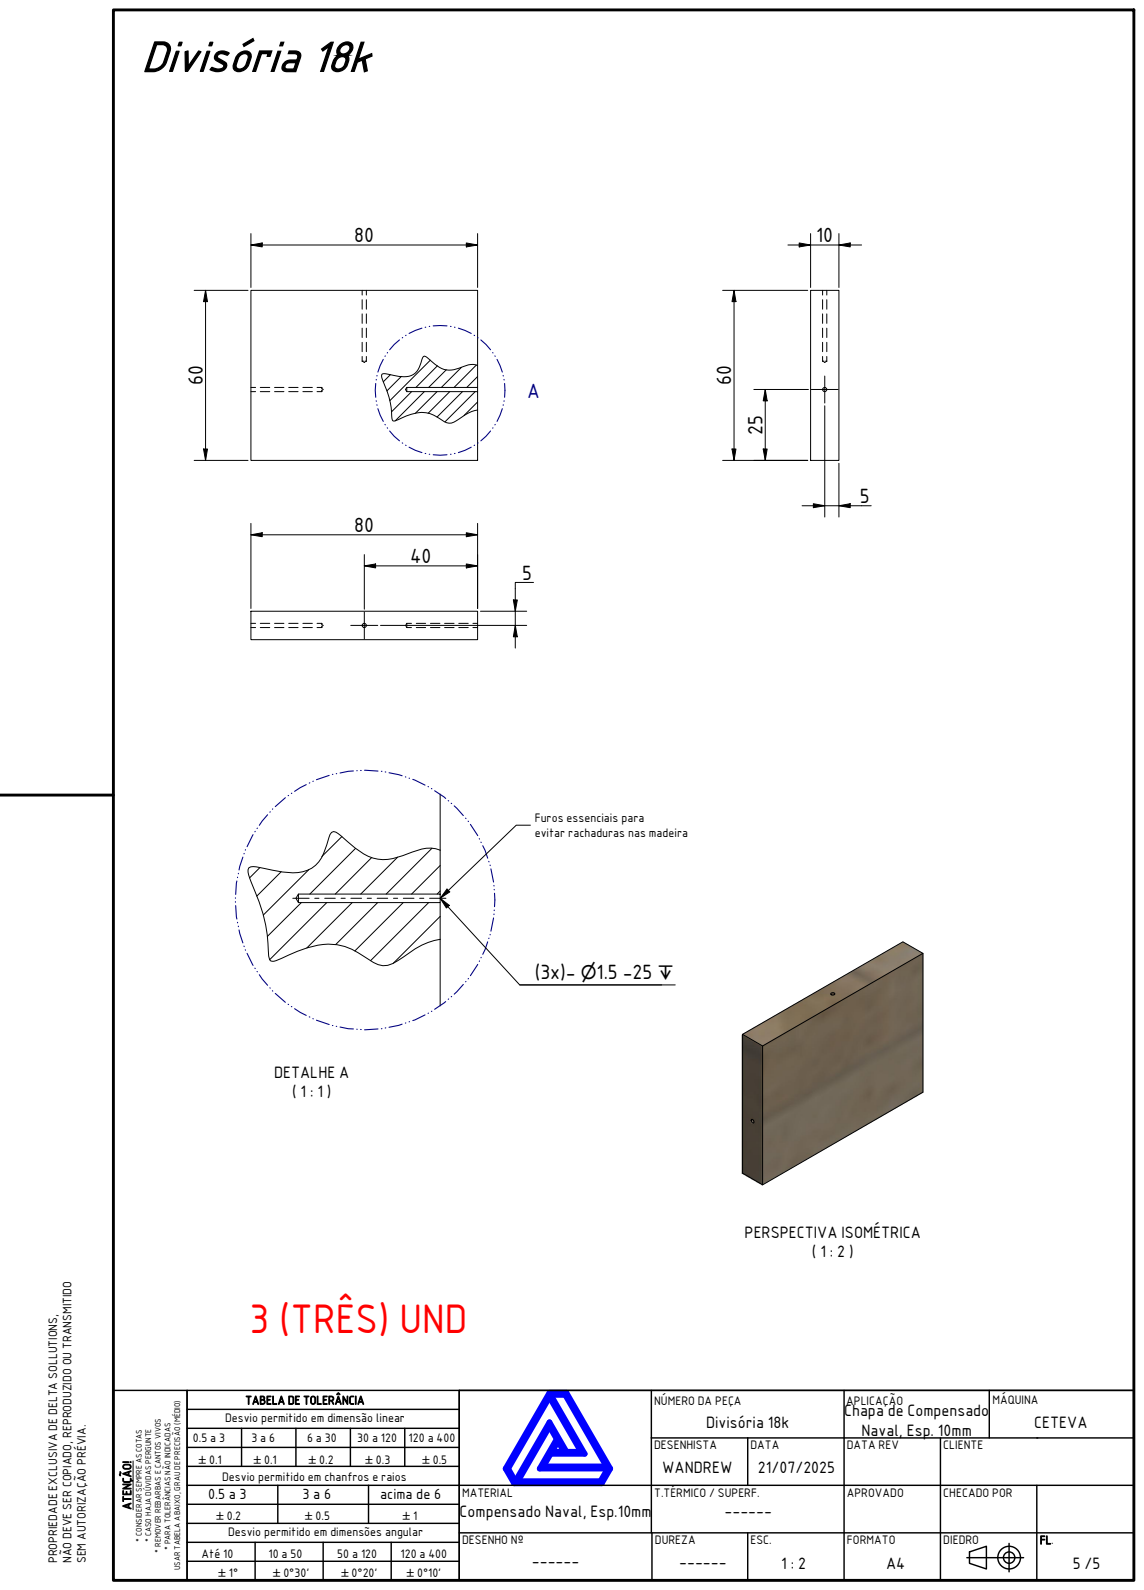
[picture p96: page 5]
PERSPECTIVA ISOMÉTRICA; DETALHE A ( 1 : 1 ); Divisória 18k; NÚMERO DA PEÇA; APLICAÇÃO; MÁQUINA; 3 (TRÊS) UND

Furos essenciais para
evitar rachaduras nas madeira

NÃO DEVE SER COPIADO, REPRODUZIDO OU TRANSMITIDO

PROPRIEDADE EXCLUSIVA DE DELTA SOLLUTIONS,

USAR TABELA ABAIXO, GRAU DE PRECISÃO (MÉDIO)

TABELA DE TOLERÂNCIA
Desvio permitido em dimensão linear

Chapa de Compensado
Naval, Esp. 10mm

SEM AUTORIZAÇÃO PRÉVIA.

* CONSIDERAR SEMPRE AS COTAS

* CASO HAJA DÚVIDAS PERGUNTE

* REMOVER REBARBAS E CANTOS VIVOS

* PARA TOLERÂNCIAS NÃO INDICADAS

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

DESENHISTA WANDREW | DATA 21/07/2025 | DATA REV | CLIENTE

Desvio permitido em chanfros e raios

MATERIAL | T.TÉRMICO / SUPERF. ------ | APROVADO
