pvrezende/Dashboard/uploads/anexo-1753902788569-329054379.pdf

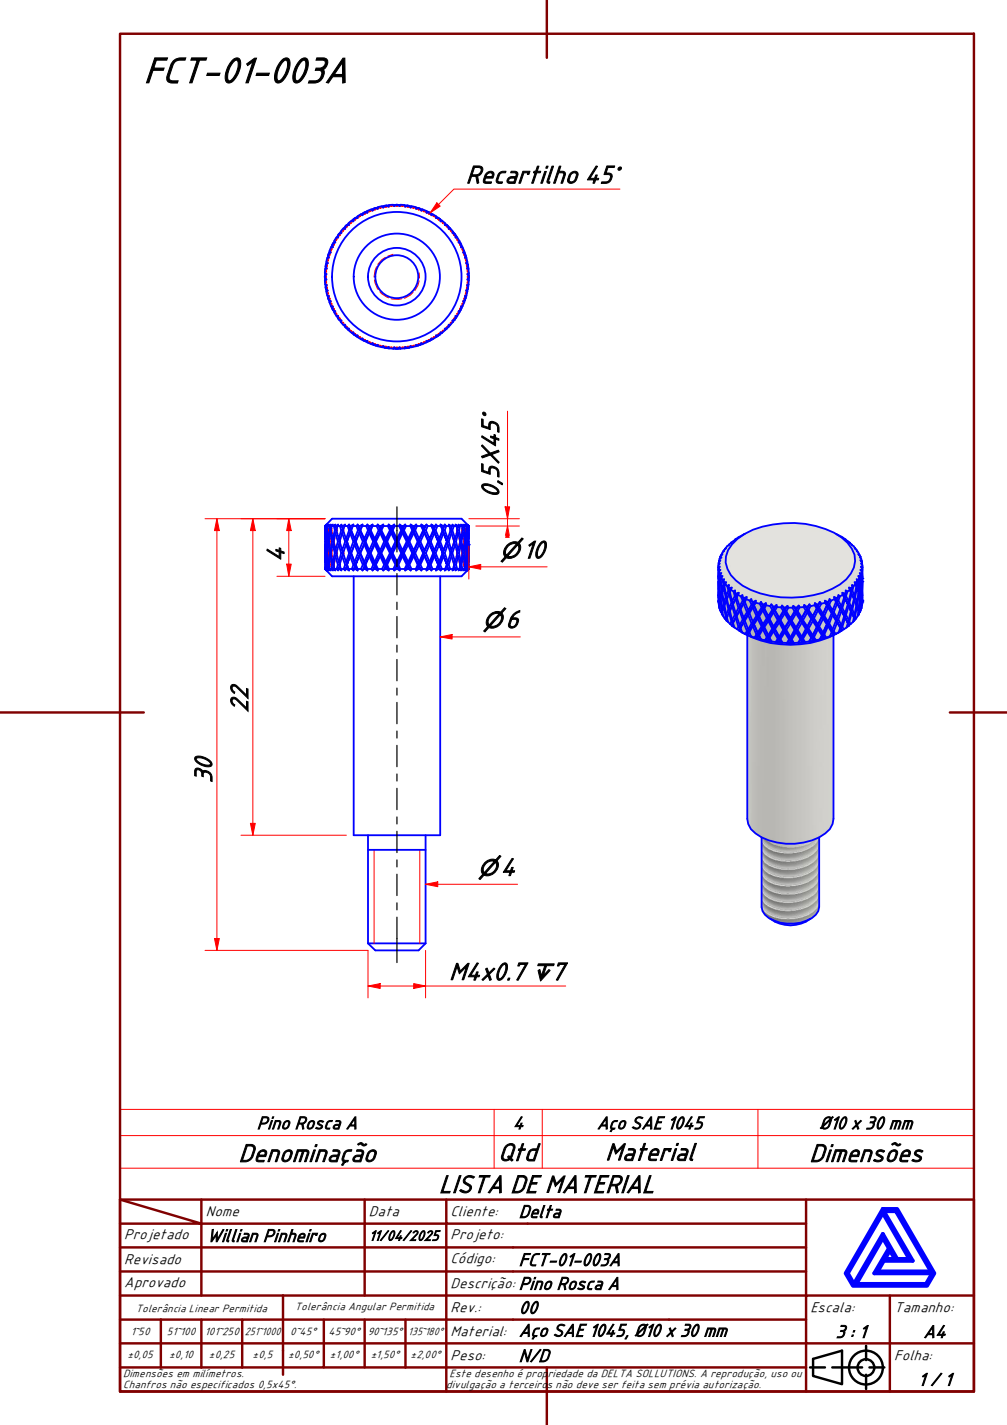
[picture p99: page 1]
Recartilho 45~

Pino Rosca A | 4 | Aço SAE 1045 | Ø10 x 30 mm
Denominação | Qtd | Material | Dimensões

LISTA DE MATERIAL

Projetado | Nome | Data | Cliente: Delta

Willian Pinheiro | 11/04/2025 | Projeto:

Revisado | | | Código: FCT-01-003A
Aprovado | | | Pino Rosca A Descrição:
Tolerância Linear Permitida | Tolerância Angular Permitida | Rev.: 00 | Escala: 3 : 1 | Tamanho: A4

1~50 | 51~100 | 101~250 | 251~1000 | 0~45° | 45~90° | 90~135° 135~180° | | Material: Aço SAE 1045, Ø10 x 30 mm
±0,05 | ±0,10 | ±0,25 | ±0,5 | ±0,50° | ±1,00° | ±1,50° | ±2,00° | Peso: N/D | Folha: 1 / 1
Chanfros não especificados 0,5x45°. | | Este desenho é propriedade da DELTA SOLLUTIONS. A reprodução, uso ou divulgação a terceiros não deve ser feita sem prévia autorização.

Dimensões em milímetros.
