pvrezende/Dashboard/uploads/anexo-1753907612233-17269929.pdf

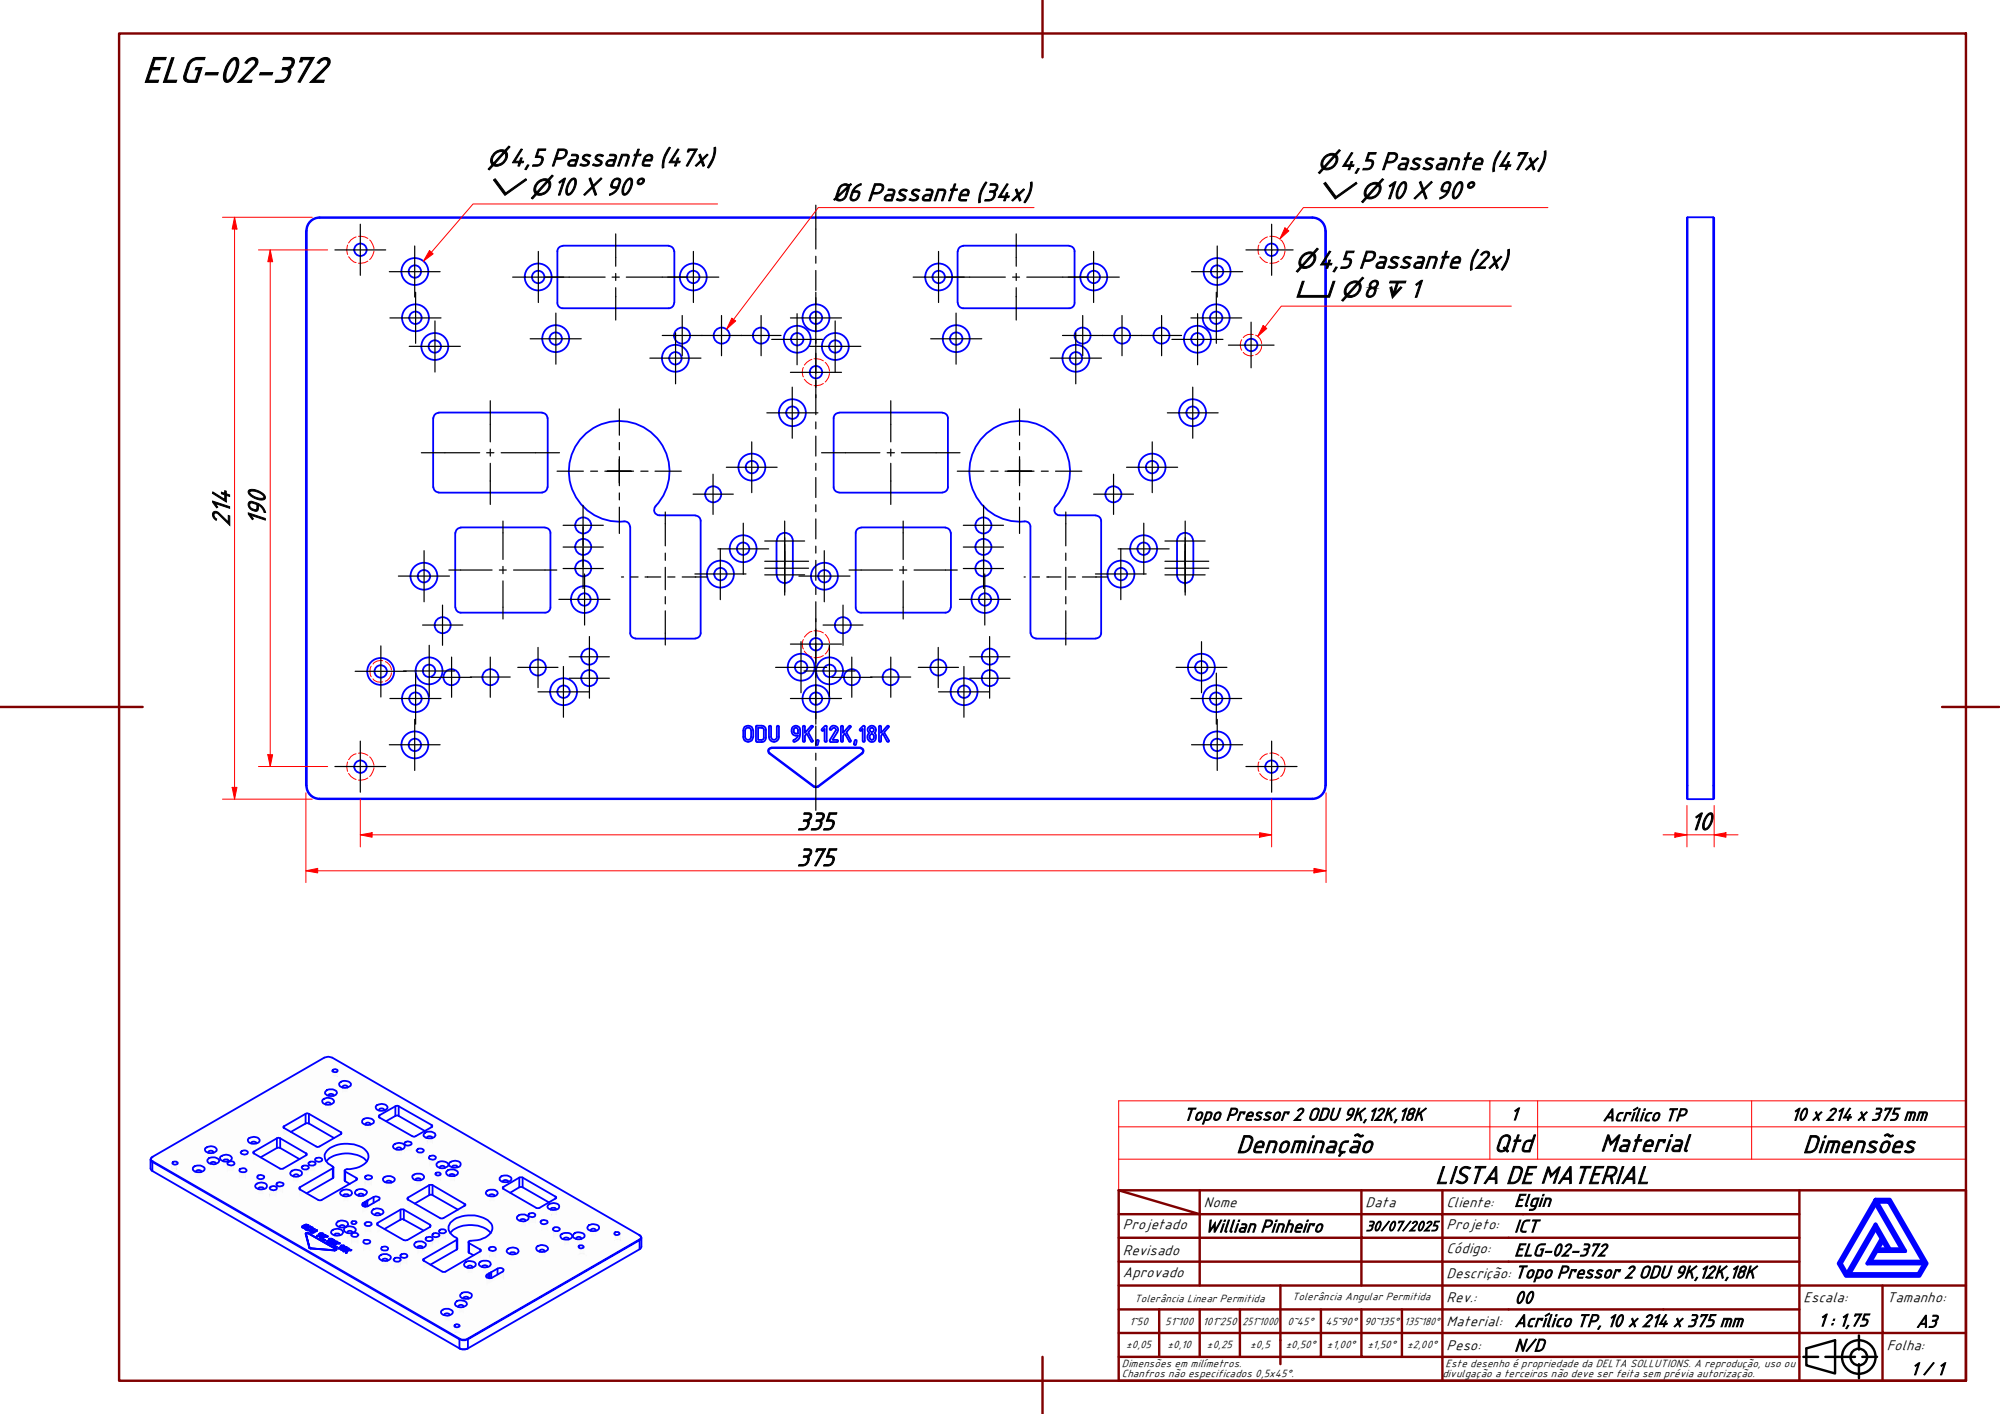
[picture p100: page 1]
⌀ 4,5 Passante (47x) ⌵ ⌀ 10 X 90°; ⌀ 4,5 Passante (2x) ⌴ ⌀ 8 ↧ 1; ⌀ 4,5 Passante (47x); Ø6 Passante (34x)

Topo Pressor 2 ODU 9K,12K,18K | 1 | Acrílico TP | 10 x 214 x 375 mm
Denominação | Qtd | Material | Dimensões

LISTA DE MATERIAL

Projetado | Nome | Data | Cliente: Elgin

Willian Pinheiro | 30/07/2025 | Projeto: ICT

Revisado | | | Código: ELG-02-372
Aprovado | | | Topo Pressor 2 ODU 9K,12K,18K Descrição:
Tolerância Linear Permitida | Tolerância Angular Permitida | Rev.: 00 | Escala: 1 : 1,75 | Tamanho: A3

1~50 | 51~100 | 101~250 | 251~1000 | 0~45° | 45~90° | 90~135° 135~180° | | Material: Acrílico TP, 10 x 214 x 375 mm
±0,05 | ±0,10 | ±0,25 | ±0,5 | ±0,50° | ±1,00° | ±1,50° | ±2,00° | Peso: N/D | Folha: 1 / 1
Chanfros não especificados 0,5x45°. | | | | | | | | Este desenho é propriedade da DELTA SOLLUTIONS. A reprodução, uso ou divulgação a terceiros não deve ser feita sem prévia autorização.

Dimensões em milímetros.
