pvrezende/Dashboard/uploads/anexo-1753908418481-164507317.pdf

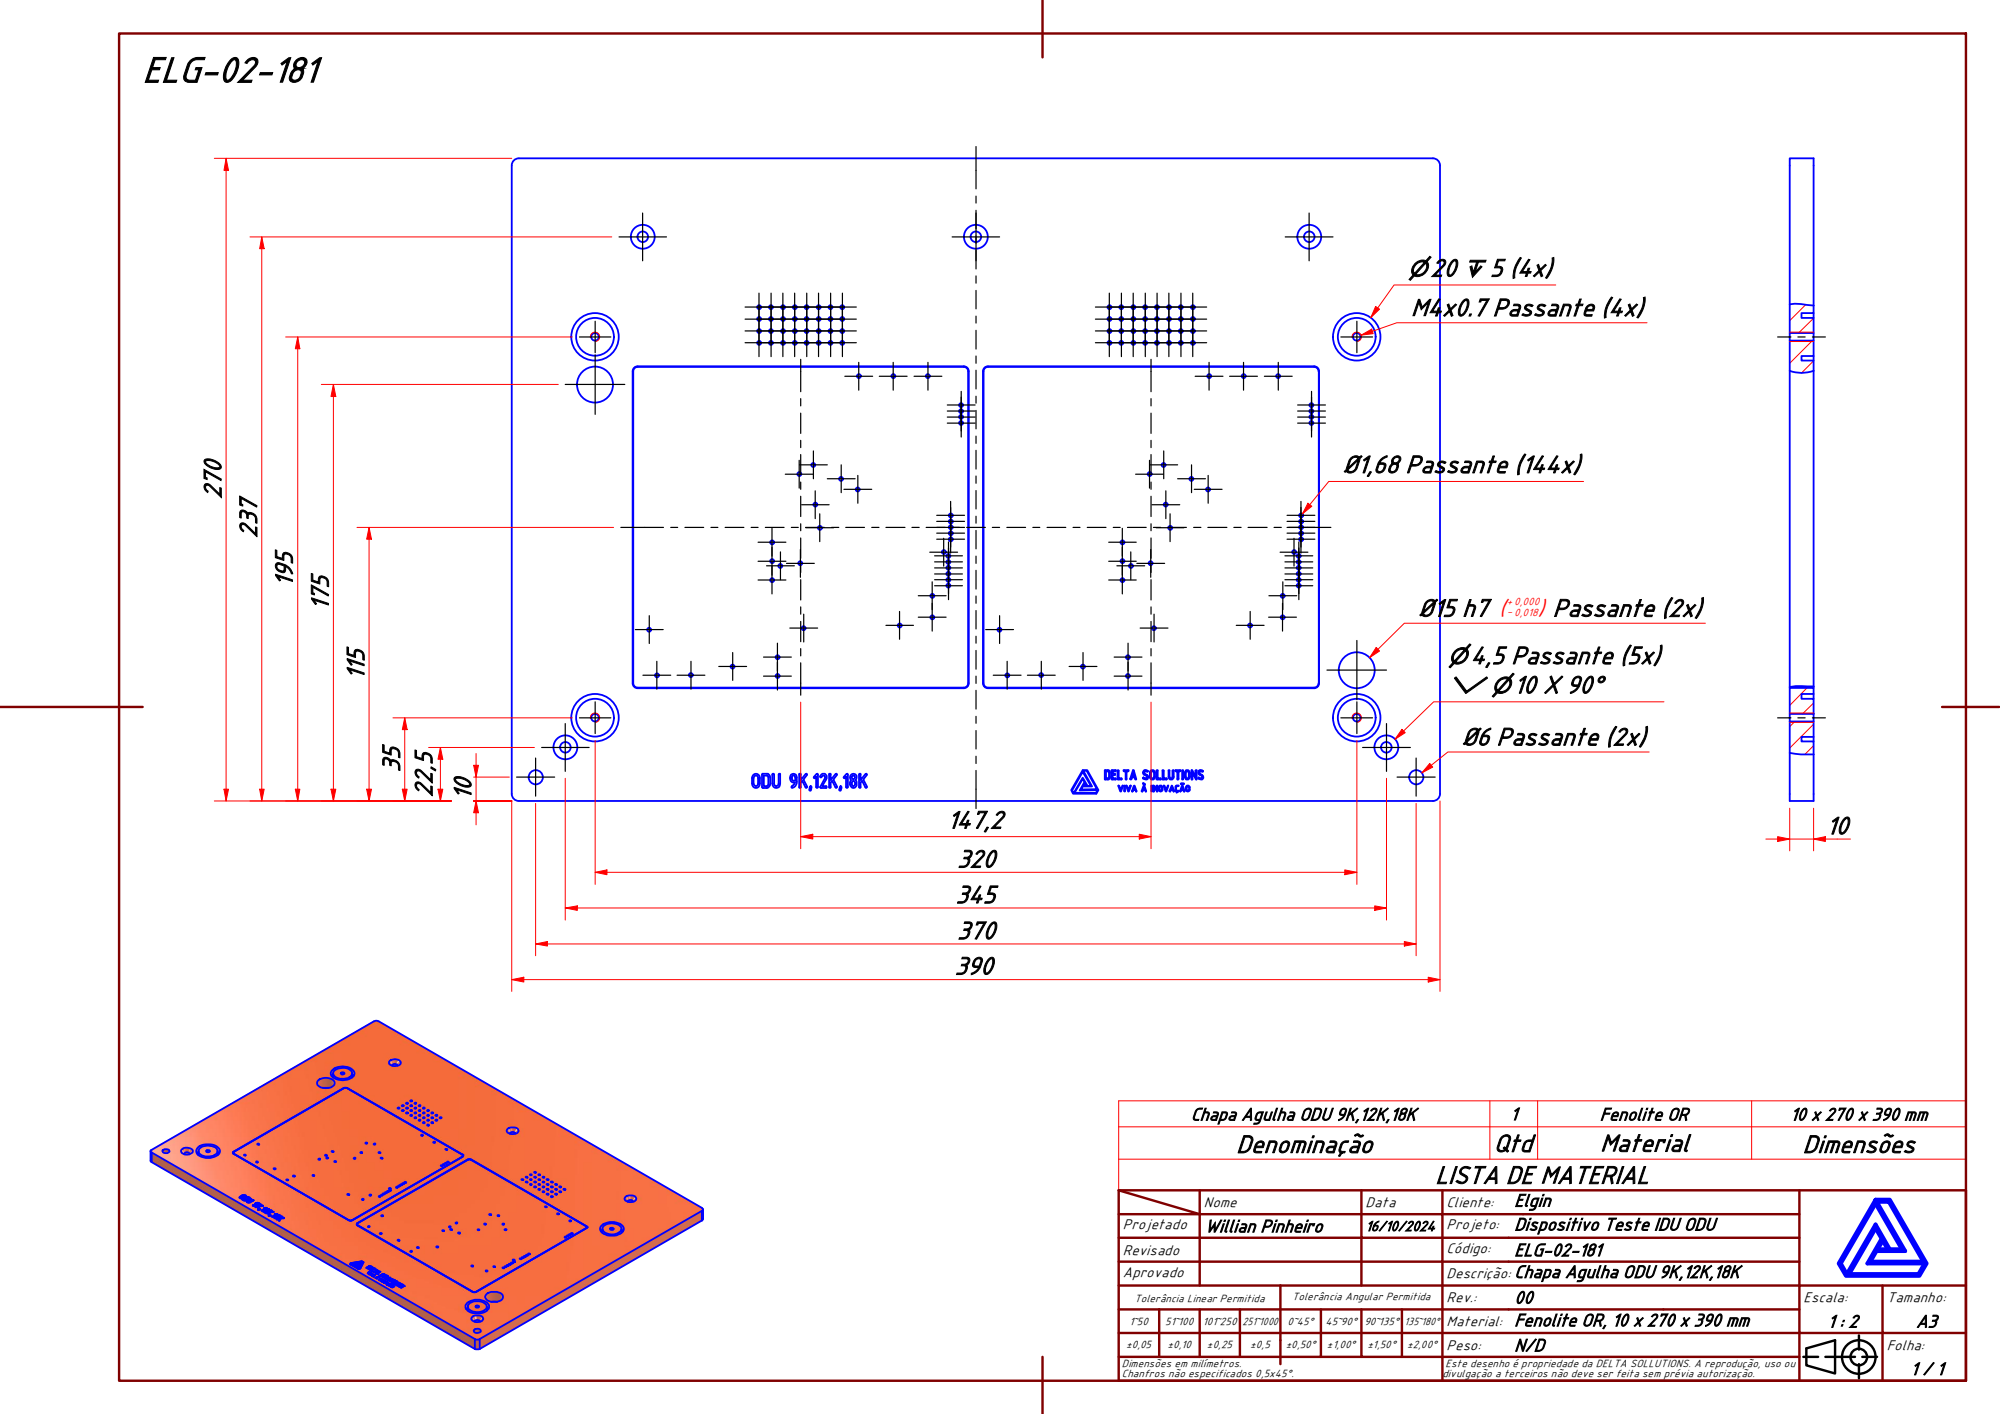
[picture p101: page 1]
Passante (2x); Ø6 Passante (2x); M4x0.7 Passante (4x); ⌀ 4,5 Passante (5x) ⌵ ⌀ 10 X 90°; Ø1,68 Passante (144x)

Chapa Agulha ODU 9K,12K,18K | 1 | Fenolite OR | 10 x 270 x 390 mm
Denominação | Qtd | Material | Dimensões

LISTA DE MATERIAL

Projetado | Nome | Data | Cliente: Elgin

Willian Pinheiro | 16/10/2024 | Projeto: Dispositivo Teste IDU ODU

Revisado | | | Código: ELG-02-181
Aprovado | | | Chapa Agulha ODU 9K,12K,18K Descrição:
Tolerância Linear Permitida | Tolerância Angular Permitida | Rev.: 00 | Escala: 1 : 2 | Tamanho: A3

1~50 | 51~100 | 101~250 | 251~1000 | 0~45° | 45~90° | 90~135° 135~180° | | Material: Fenolite OR, 10 x 270 x 390 mm
±0,05 | ±0,10 | ±0,25 | ±0,5 | ±0,50° | ±1,00° | ±1,50° | ±2,00° | Peso: N/D | Folha: 1 / 1
Chanfros não especificados 0,5x45°. | | | | | | | | Este desenho é propriedade da DELTA SOLLUTIONS. A reprodução, uso ou divulgação a terceiros não deve ser feita sem prévia autorização.

Dimensões em milímetros.
