pvrezende/Dashboard/uploads/anexo-1753908796619-514889876.pdf

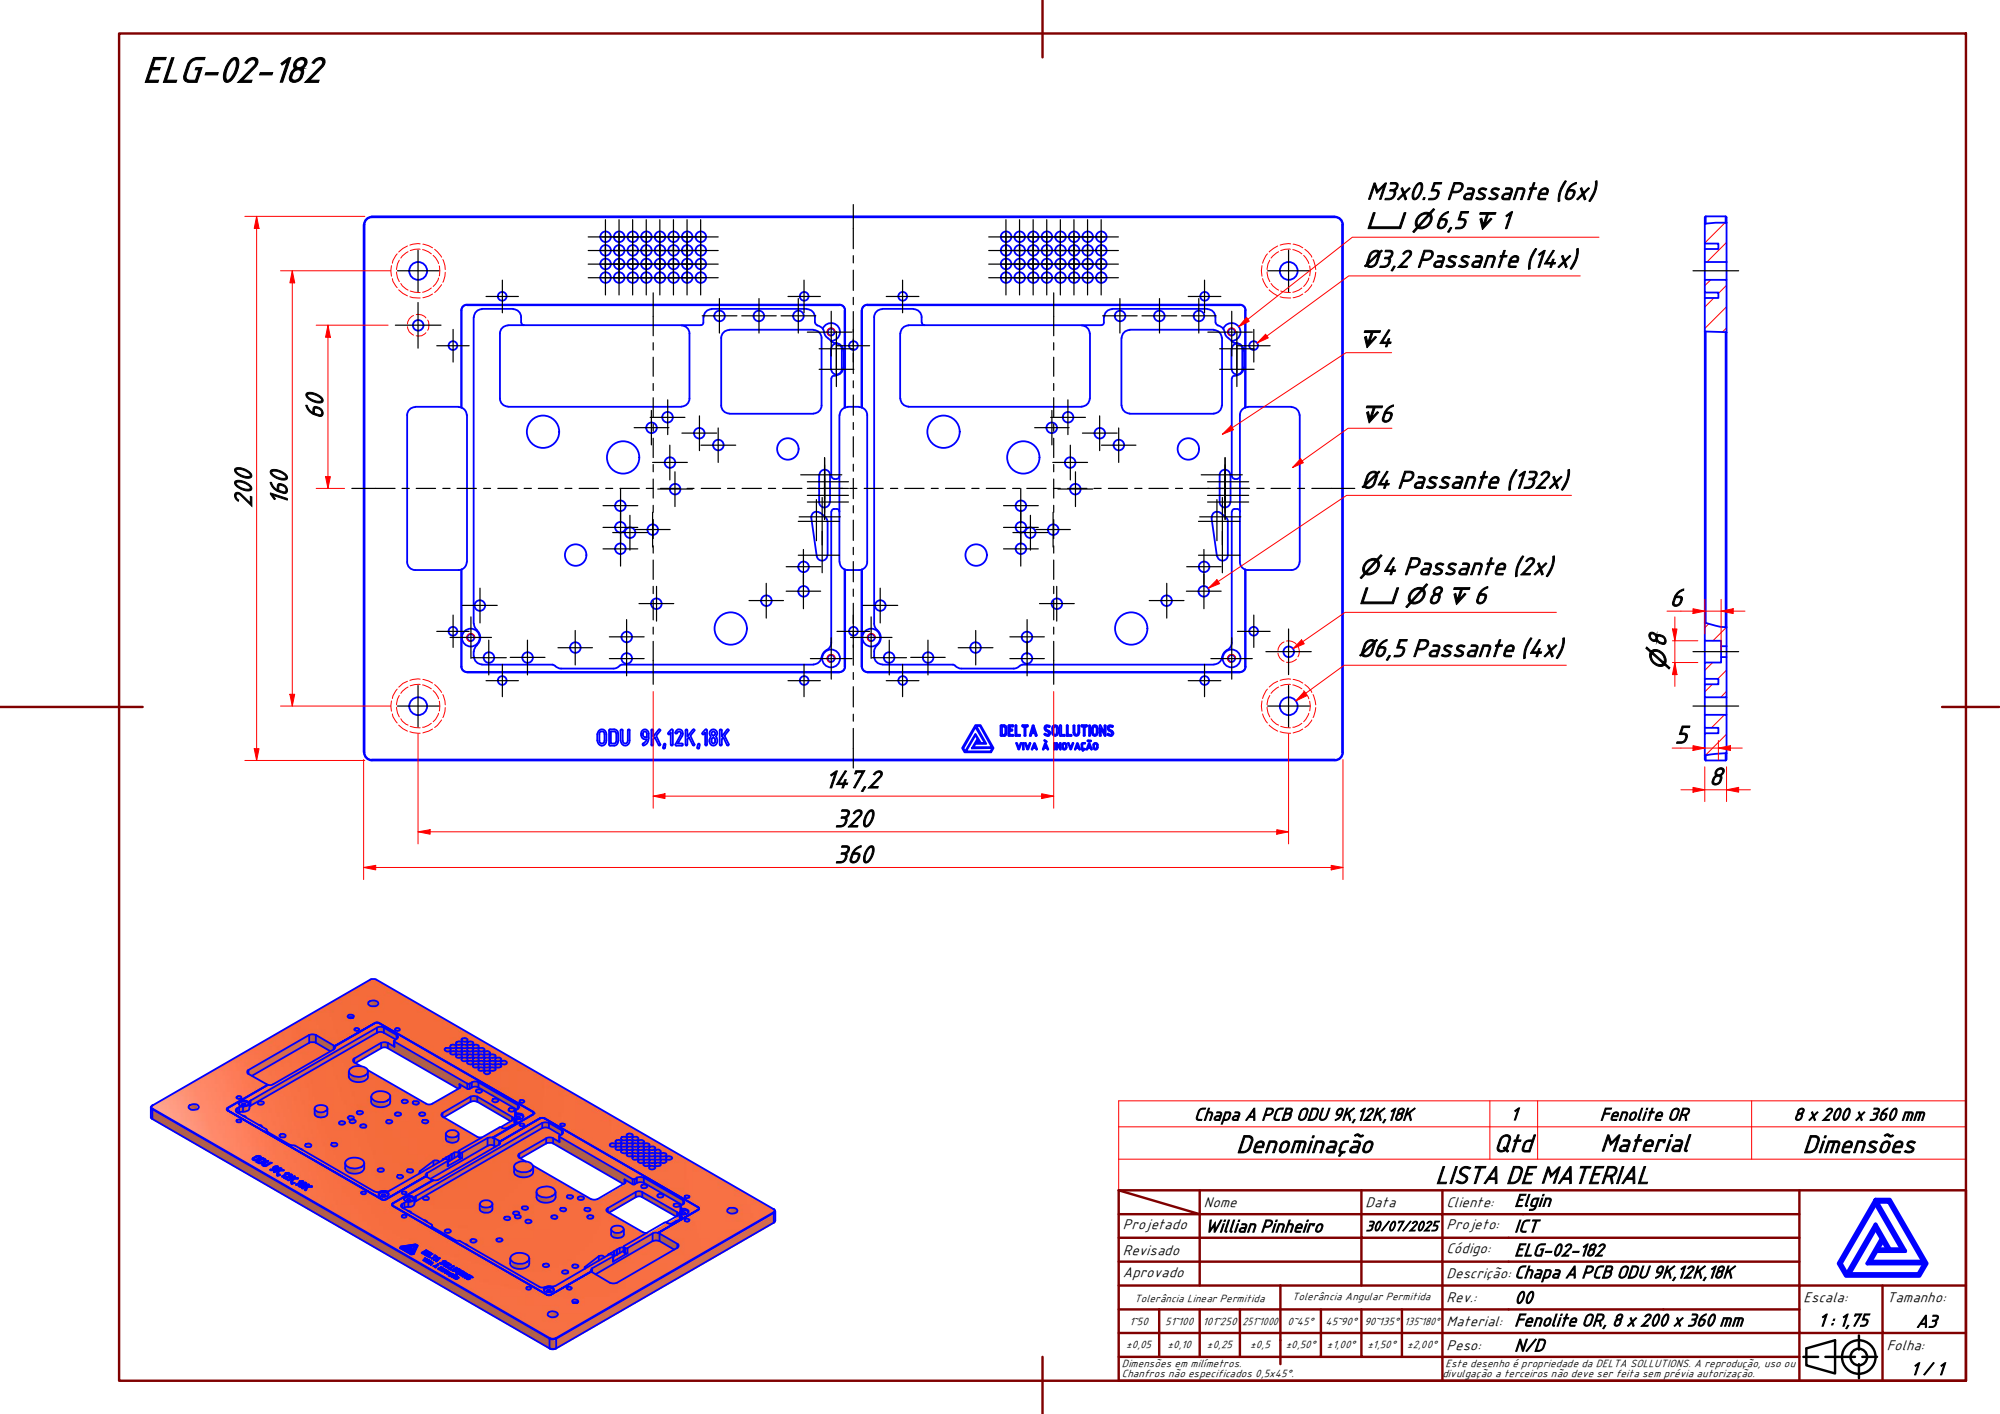
[picture p102: page 1]
Ø6,5 Passante (4x); ⌀ 4 Passante (2x) ⌴ ⌀ 8 ↧ 6; Ø3,2 Passante (14x); M3x0.5 Passante (6x) ⌴ ⌀ 6,5 ↧ 1; Ø4 Passante (132x)

Chapa A PCB ODU 9K,12K,18K | 1 | Fenolite OR | 8 x 200 x 360 mm
Denominação | Qtd | Material | Dimensões

LISTA DE MATERIAL

Projetado | Nome | Data | Cliente: Elgin

Willian Pinheiro | 30/07/2025 | Projeto: ICT

Revisado | | | Código: ELG-02-182
Aprovado | | | Chapa A PCB ODU 9K,12K,18K Descrição:
Tolerância Linear Permitida | Tolerância Angular Permitida | Rev.: 00 | Escala: 1 : 1,75 | Tamanho: A3

1~50 | 51~100 | 101~250 | 251~1000 | 0~45° | 45~90° | 90~135° 135~180° | | Material: Fenolite OR, 8 x 200 x 360 mm
±0,05 | ±0,10 | ±0,25 | ±0,5 | ±0,50° | ±1,00° | ±1,50° | ±2,00° | Peso: N/D | Folha: 1 / 1
Chanfros não especificados 0,5x45°. | | | | | | | | Este desenho é propriedade da DELTA SOLLUTIONS. A reprodução, uso ou divulgação a terceiros não deve ser feita sem prévia autorização.

Dimensões em milímetros.
