pvrezende/Dashboard/uploads/anexo-1753910565624-54018373.pdf

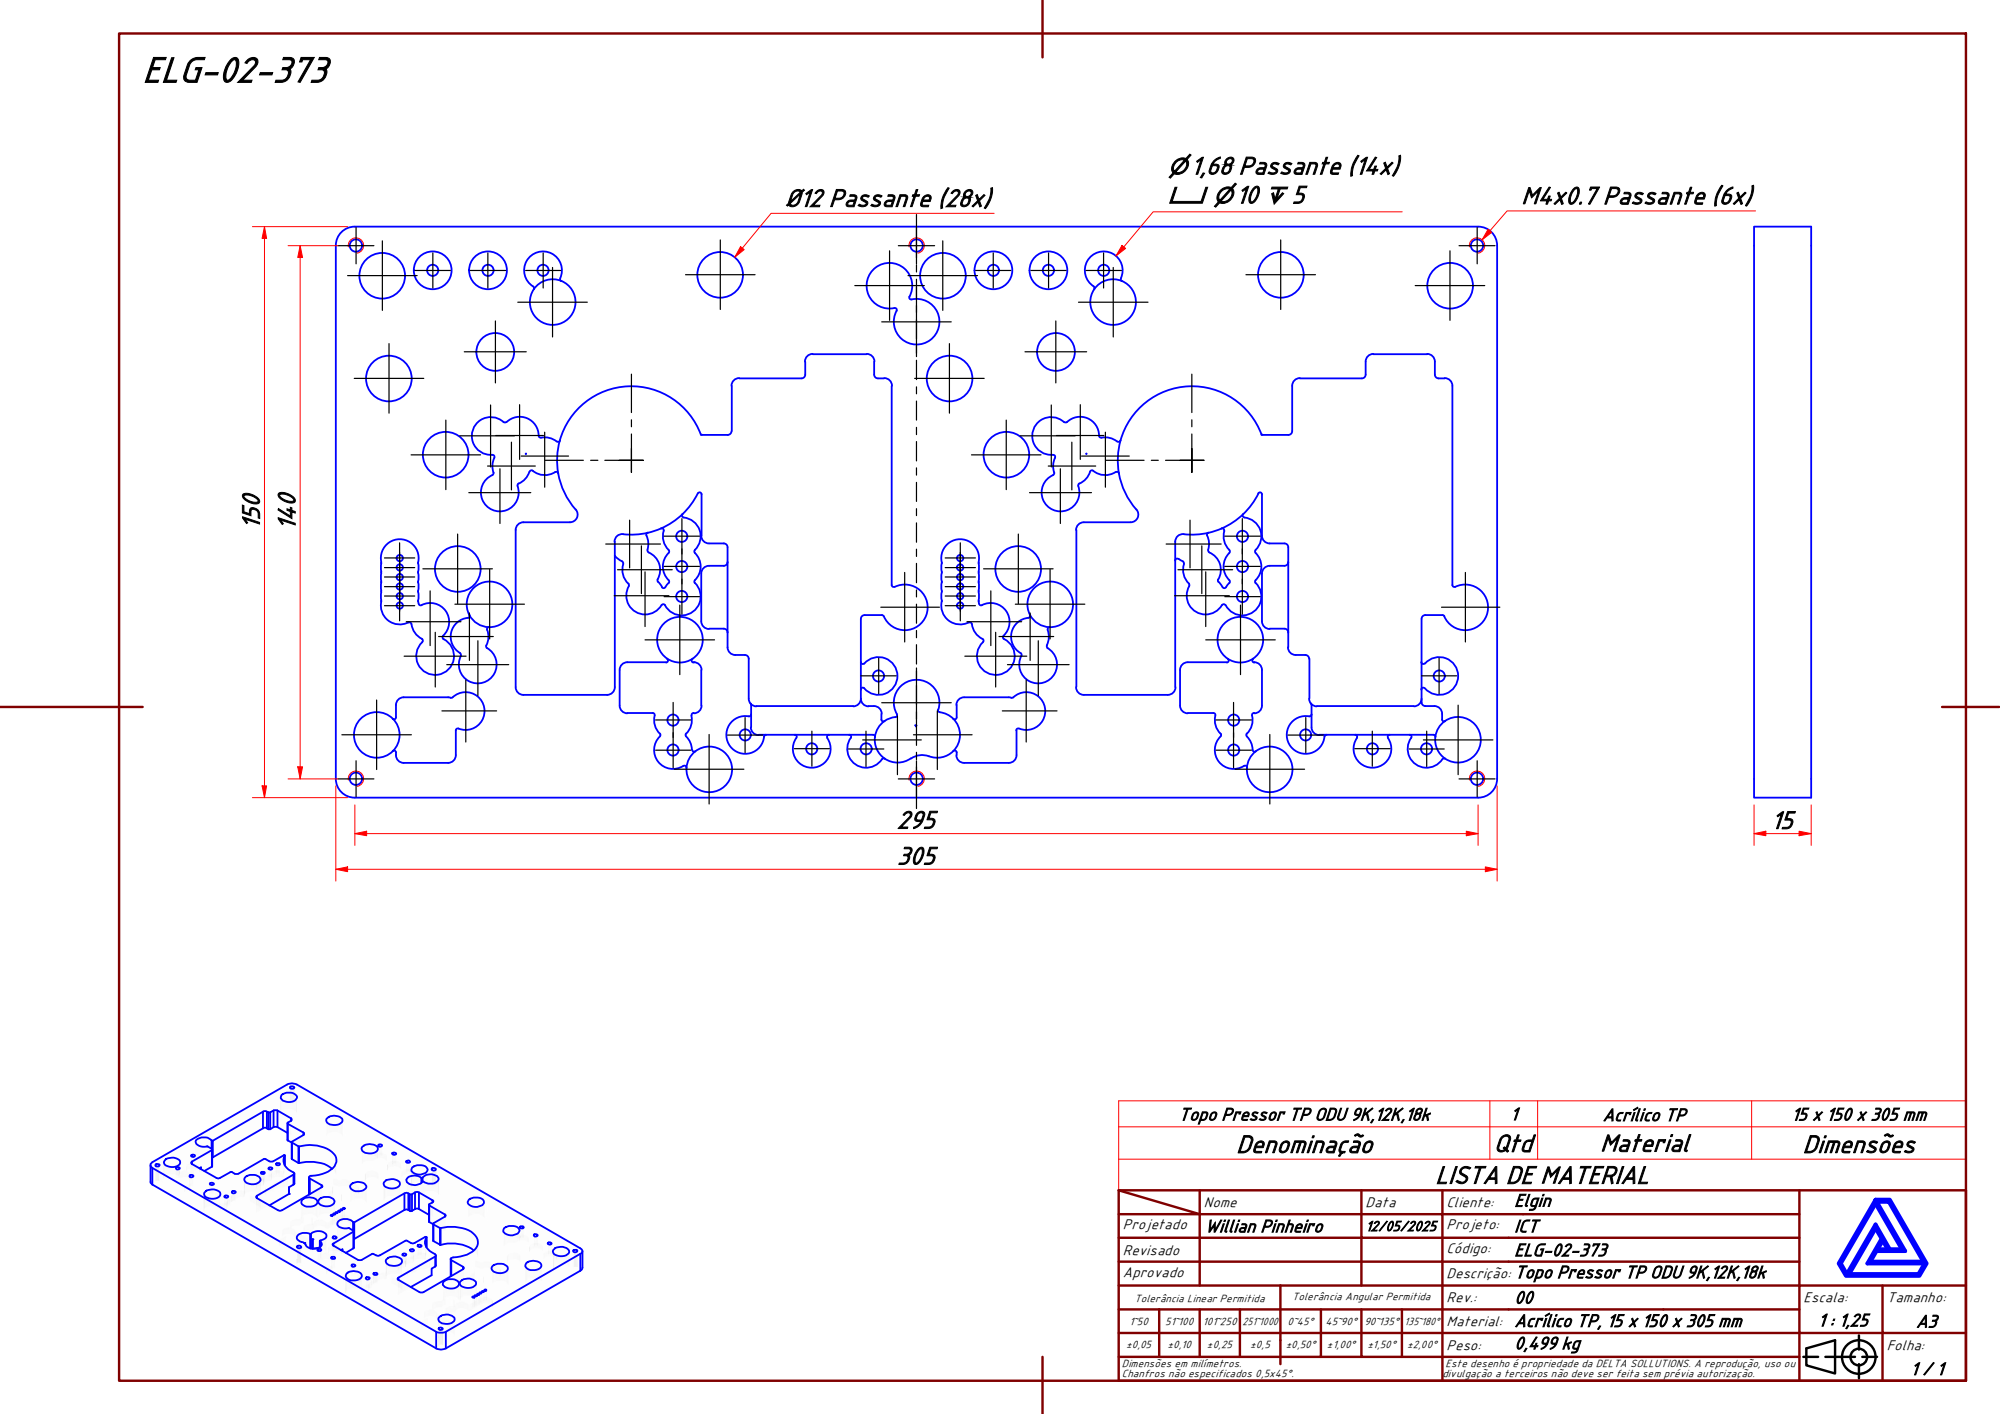
[picture p103: page 1]
M4x0.7 Passante (6x); ⌀ 1,68 Passante (14x); Ø12 Passante (28x)

Topo Pressor TP ODU 9K,12K,18k | 1 | Acrílico TP | 15 x 150 x 305 mm
Denominação | Qtd | Material | Dimensões

LISTA DE MATERIAL

Projetado | Nome | Data | Cliente: Elgin

Willian Pinheiro | 12/05/2025 | Projeto: ICT

Revisado | | | Código: ELG-02-373
Aprovado | | | Topo Pressor TP ODU 9K,12K,18k Descrição:
Tolerância Linear Permitida | Tolerância Angular Permitida | Rev.: 00 | Escala: 1 : 1,25 | Tamanho: A3

1~50 | 51~100 | 101~250 | 251~1000 | 0~45° | 45~90° | 90~135° 135~180° | | Material: Acrílico TP, 15 x 150 x 305 mm
±0,05 | ±0,10 | ±0,25 | ±0,5 | ±0,50° | ±1,00° | ±1,50° | ±2,00° | 0,499 kg Peso: | Folha: 1 / 1

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

Dimensões em milímetros.
