pvrezende/Dashboard/uploads/anexo-1753971740522-685443056.pdf

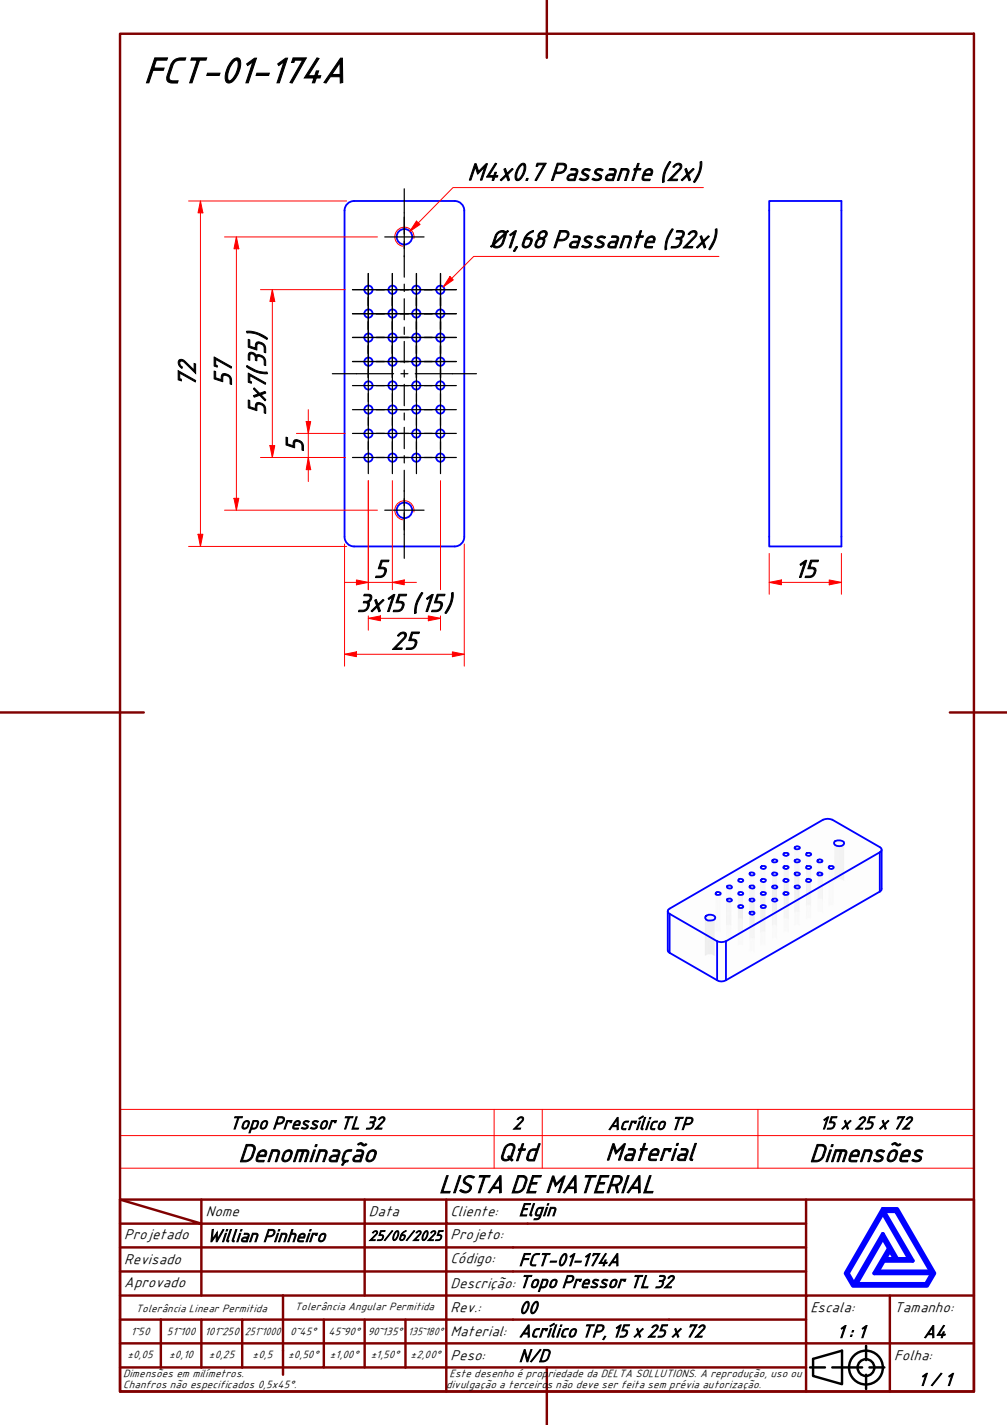
[picture p104: page 1]
M4x0.7 Passante (2x); Ø1,68 Passante (32x)

Topo Pressor TL 32 | 2 | Acrílico TP | 15 x 25 x 72
Denominação | Qtd | Material | Dimensões

LISTA DE MATERIAL

Projetado | Nome | Data | Cliente: Elgin

Willian Pinheiro | 25/06/2025 | Projeto:

Revisado | | | Código: FCT-01-174A
Aprovado | | | Topo Pressor TL 32 Descrição:
Tolerância Linear Permitida | Tolerância Angular Permitida | Rev.: 00 | Escala: 1 : 1 | Tamanho: A4

1~50 | 51~100 | 101~250 | 251~1000 | 0~45° | 45~90° | 90~135° 135~180° | | Material: Acrílico TP, 15 x 25 x 72
±0,05 | ±0,10 | ±0,25 | ±0,5 | ±0,50° | ±1,00° | ±1,50° | ±2,00° | Peso: N/D | Folha: 1 / 1
Chanfros não especificados 0,5x45°. | | Este desenho é propriedade da DELTA SOLLUTIONS. A reprodução, uso ou divulgação a terceiros não deve ser feita sem prévia autorização.

Dimensões em milímetros.
