pvrezende/Dashboard/uploads/anexo-1754420411650-971962797.pdf

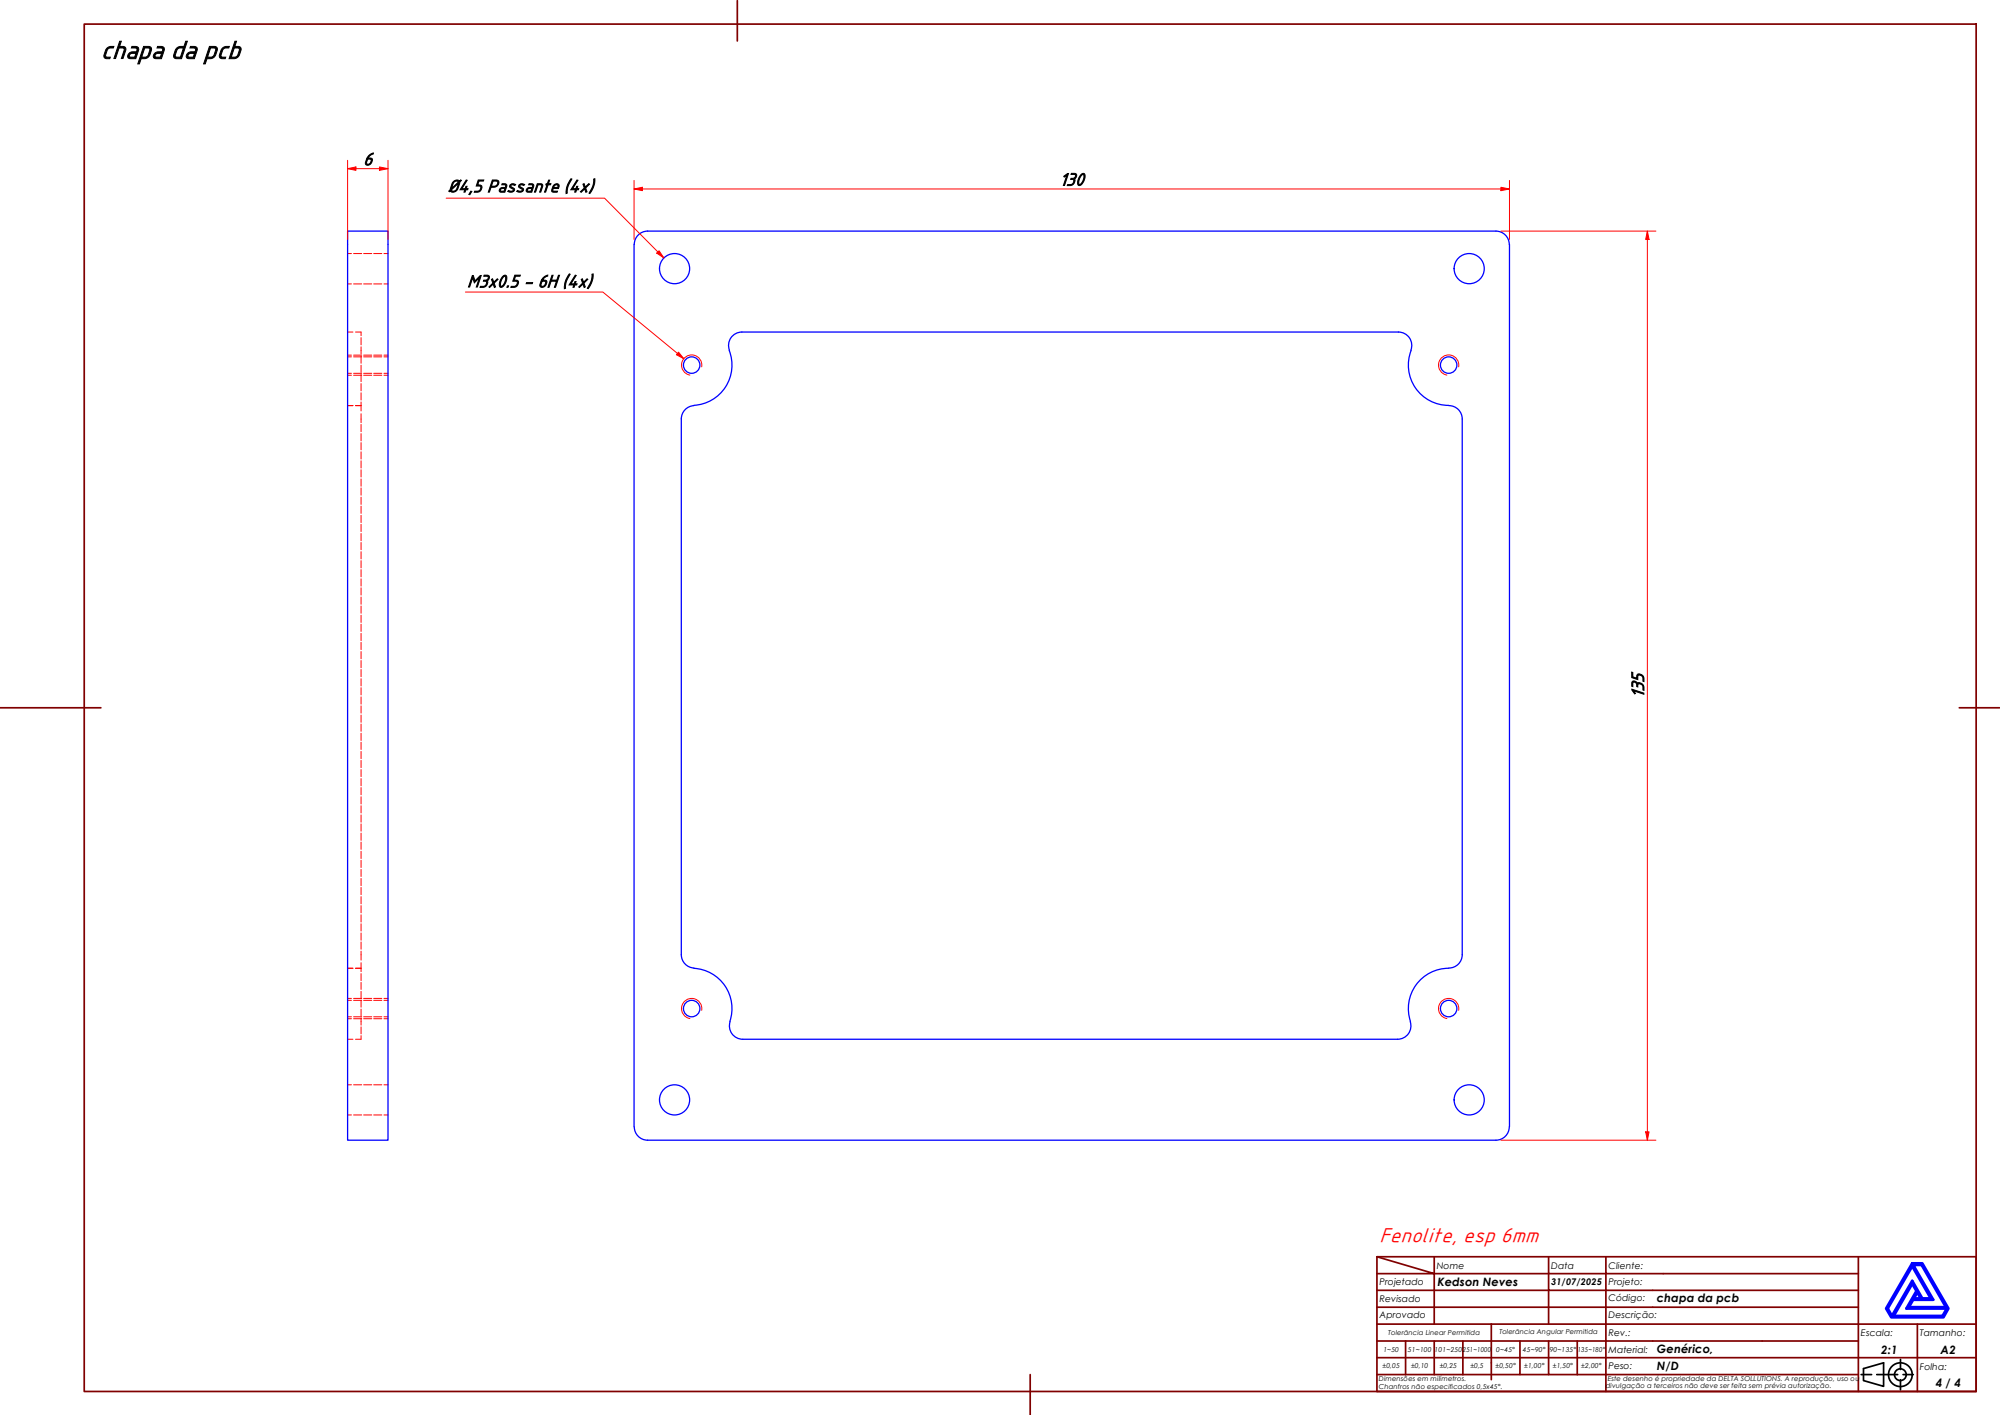
[picture p105: page 1]
Ø4,5 Passante (4x); Fenolite, esp 6mm

chapa da pcb

Projetado | Nome | Data | Cliente:

Kedson Neves | 31/07/2025 | Projeto:

Revisado | | | Código: chapa da pcb

Aprovado | | | Descrição:
Tolerância Linear Permitida | Tolerância Angular Permitida | Rev.: | Escala: 2:1 | Tamanho: A2

1~50 | 51~100 | 101~250 | 251~1000 | 0~45° | 45~90° | 90~135° 135~180° | | Genérico, Material:

±0,05 | ±0,10 | ±0,25 | ±0,5 | ±0,50° | ±1,00° | ±1,50° | ±2,00° | Peso: N/D | Folha: 4 / 4

Dimensões em milímetros.

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
