pvrezende/Dashboard/uploads/anexo-1754421963152-321463913.pdf

# DLT-01-231B

# M4x0.7 Passante (6x)

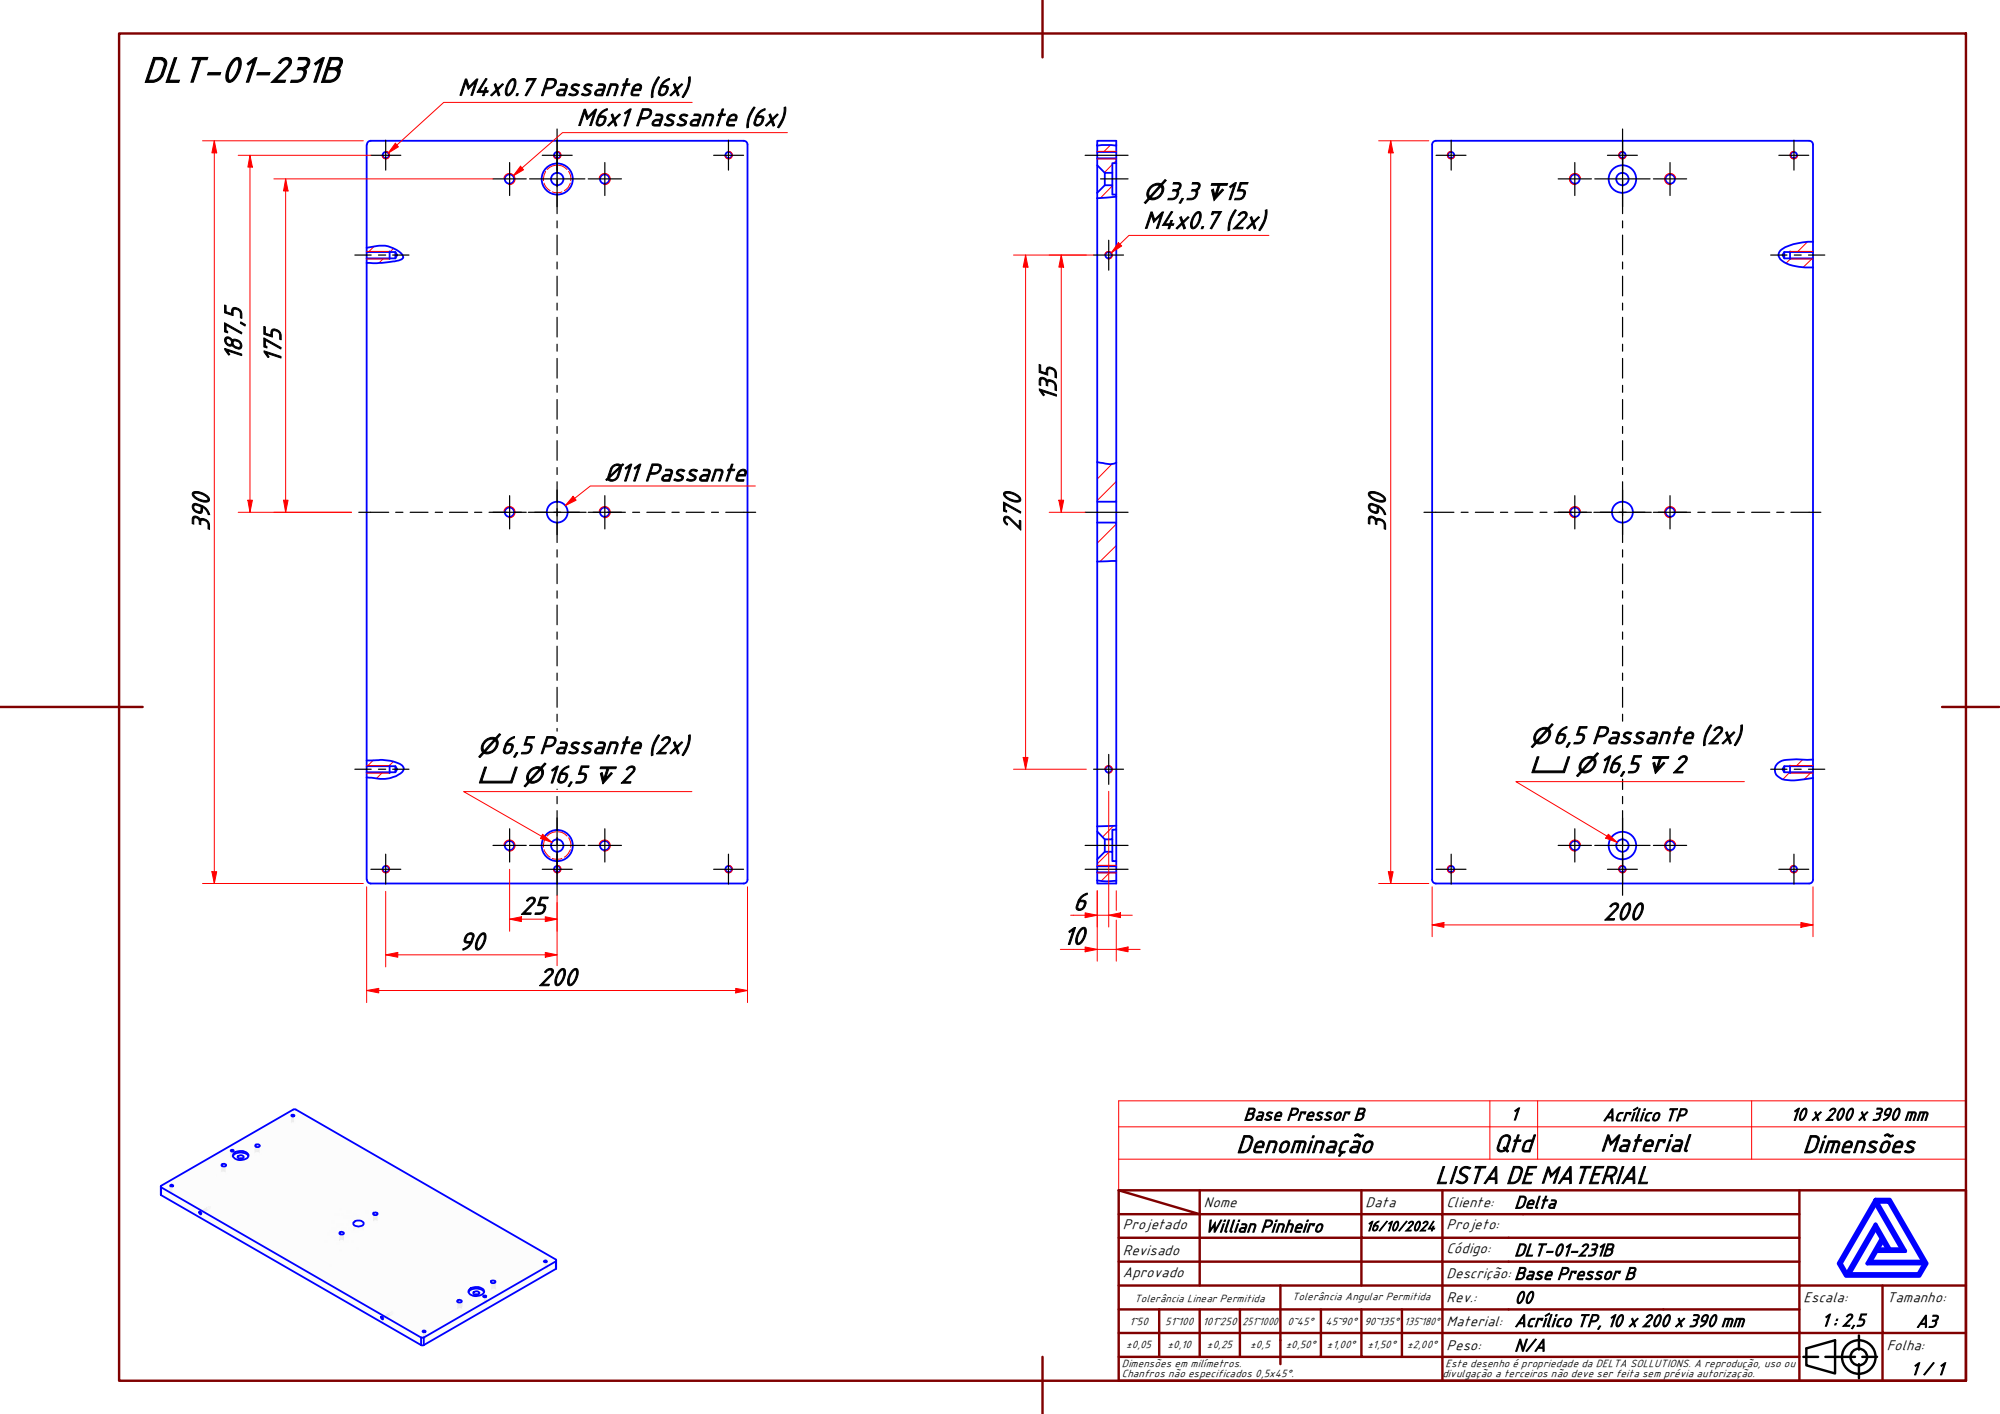
[picture p106: page 1]
Base Pressor B; Acrílico TP; Denominação; Qtd; Material; Dimensões; Folha:; Escala:; Tamanho:; Nome; Revisado; Projetado; Aprovado; Willian Pinheiro; Data; Rev.:; Delta; DLT-01-231B; M6x1 Passante (6x); Ø11 Passante; n 6,5 Passante (2x) v n 16,5 x 2

LISTA DE MATERIAL

Cliente:
Projeto:
Código:
Descrição:
Material:
Peso:
Este desenho é propriedade da DELTA SOLLUTIONS. A reprodução, uso ou
divulgação a terceiros não deve ser feita sem prévia autorização.

Tolerância Linear Permitida

Tolerância Angular Permitida

Acrílico TP, 10 x 200 x 390 mm

Dimensões em milímetros.
Chanfros não especificados 0,5x45°.

# DLT-01-232B

20

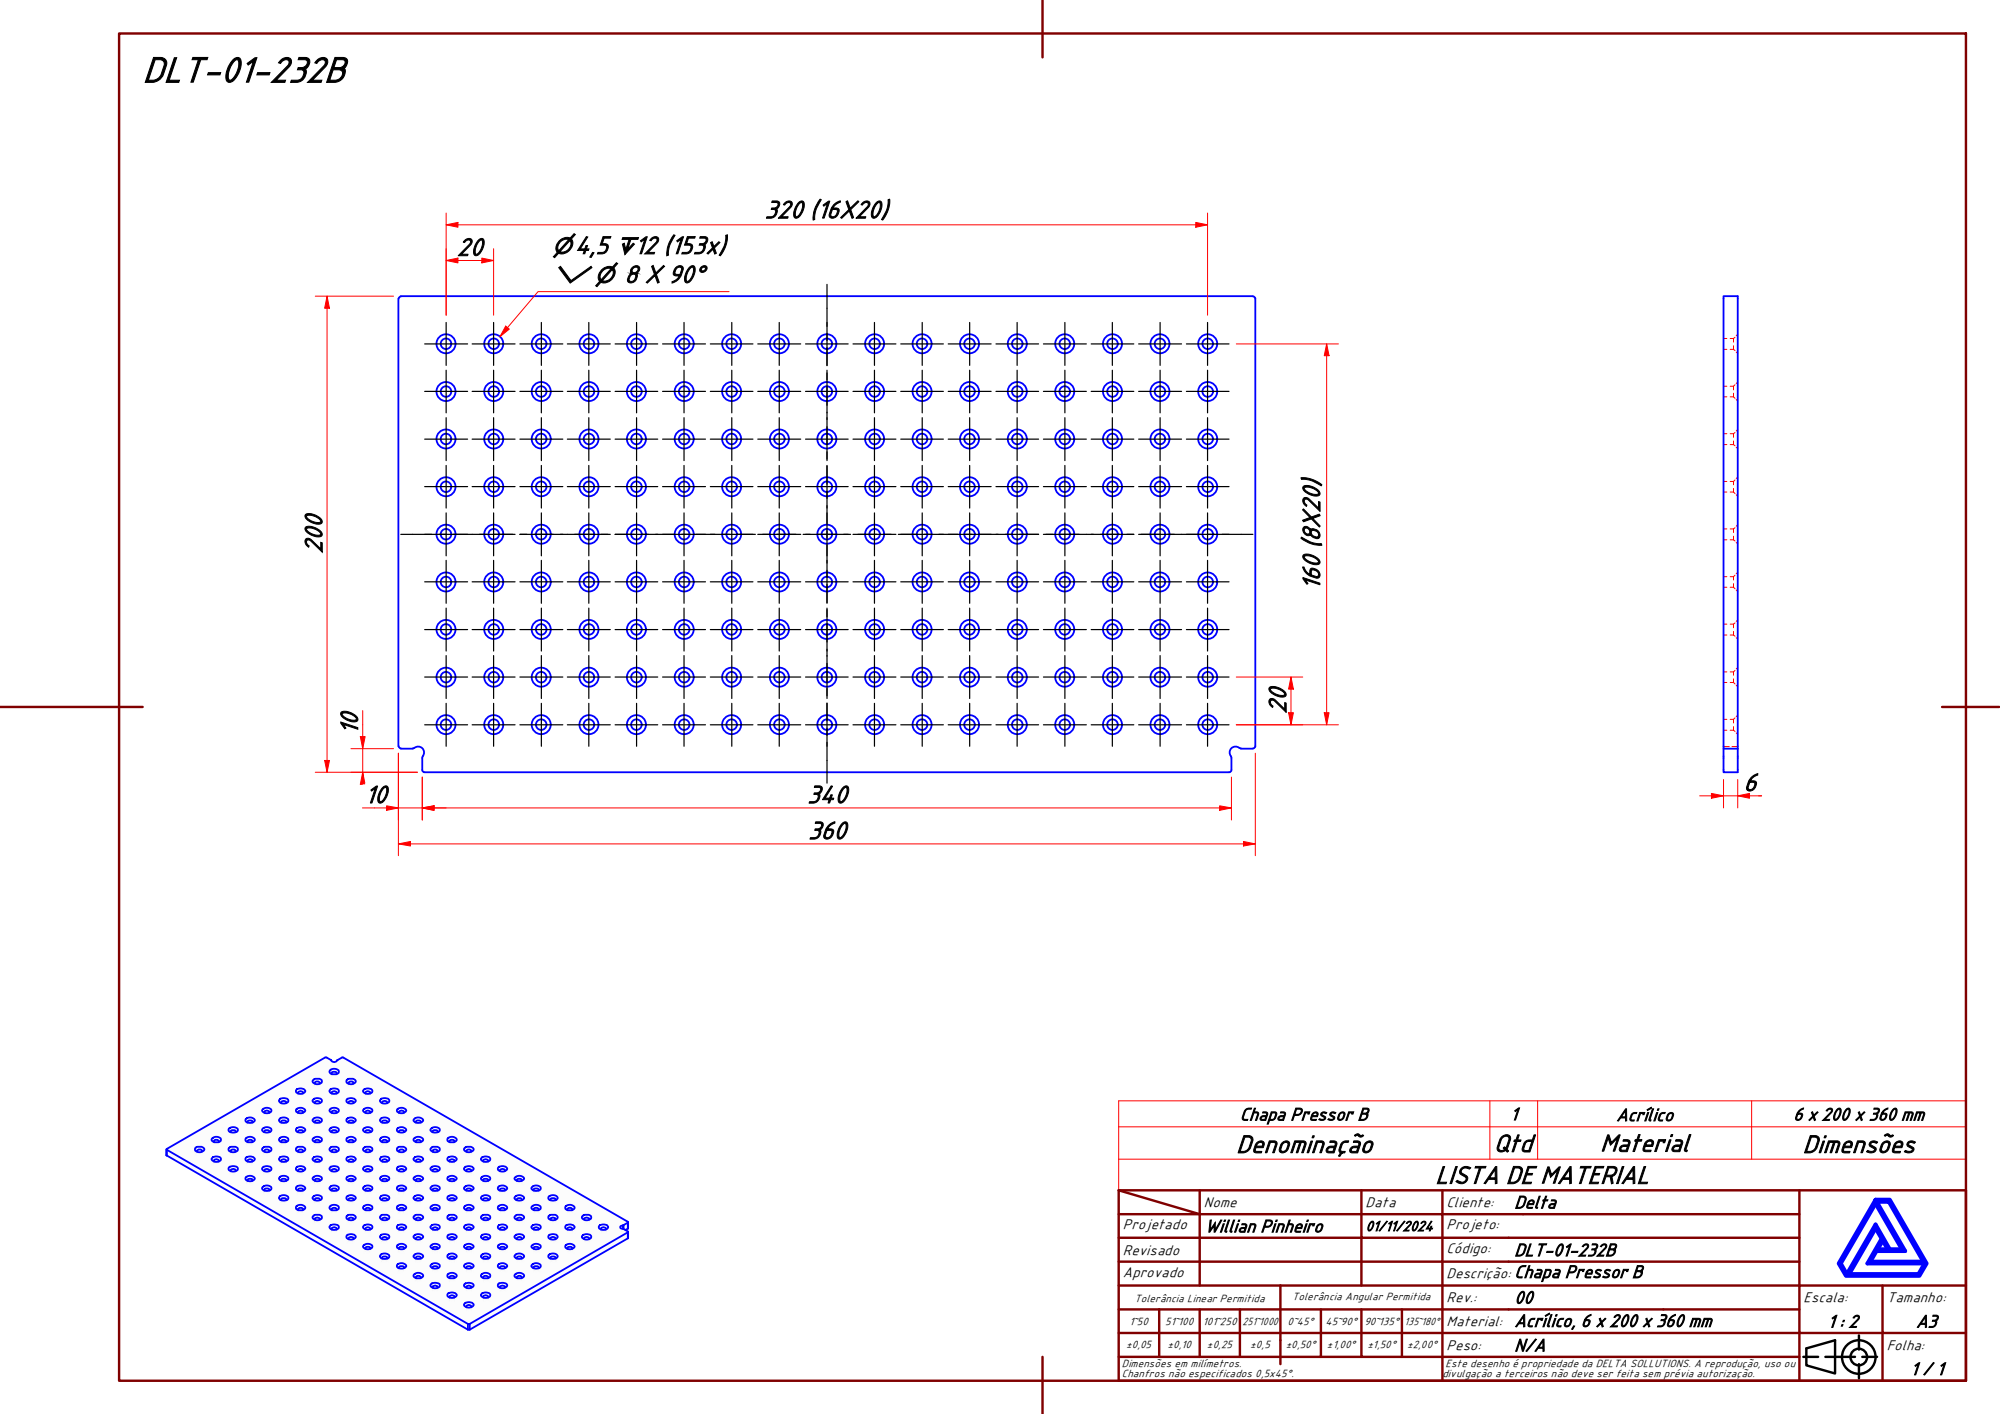
[picture p107: page 2]
Chapa Pressor B; Acrílico; Denominação; Qtd; Material; Dimensões; Nome; Revisado; Projetado; Aprovado; Willian Pinheiro; Cliente:; Descrição:; Código:; Projeto:; Data; Delta; DLT-01-232B; Acrílico, 6 x 200 x 360 mm

LISTA DE MATERIAL

# DLT-01-233

# n 4,5 Passante (3x)

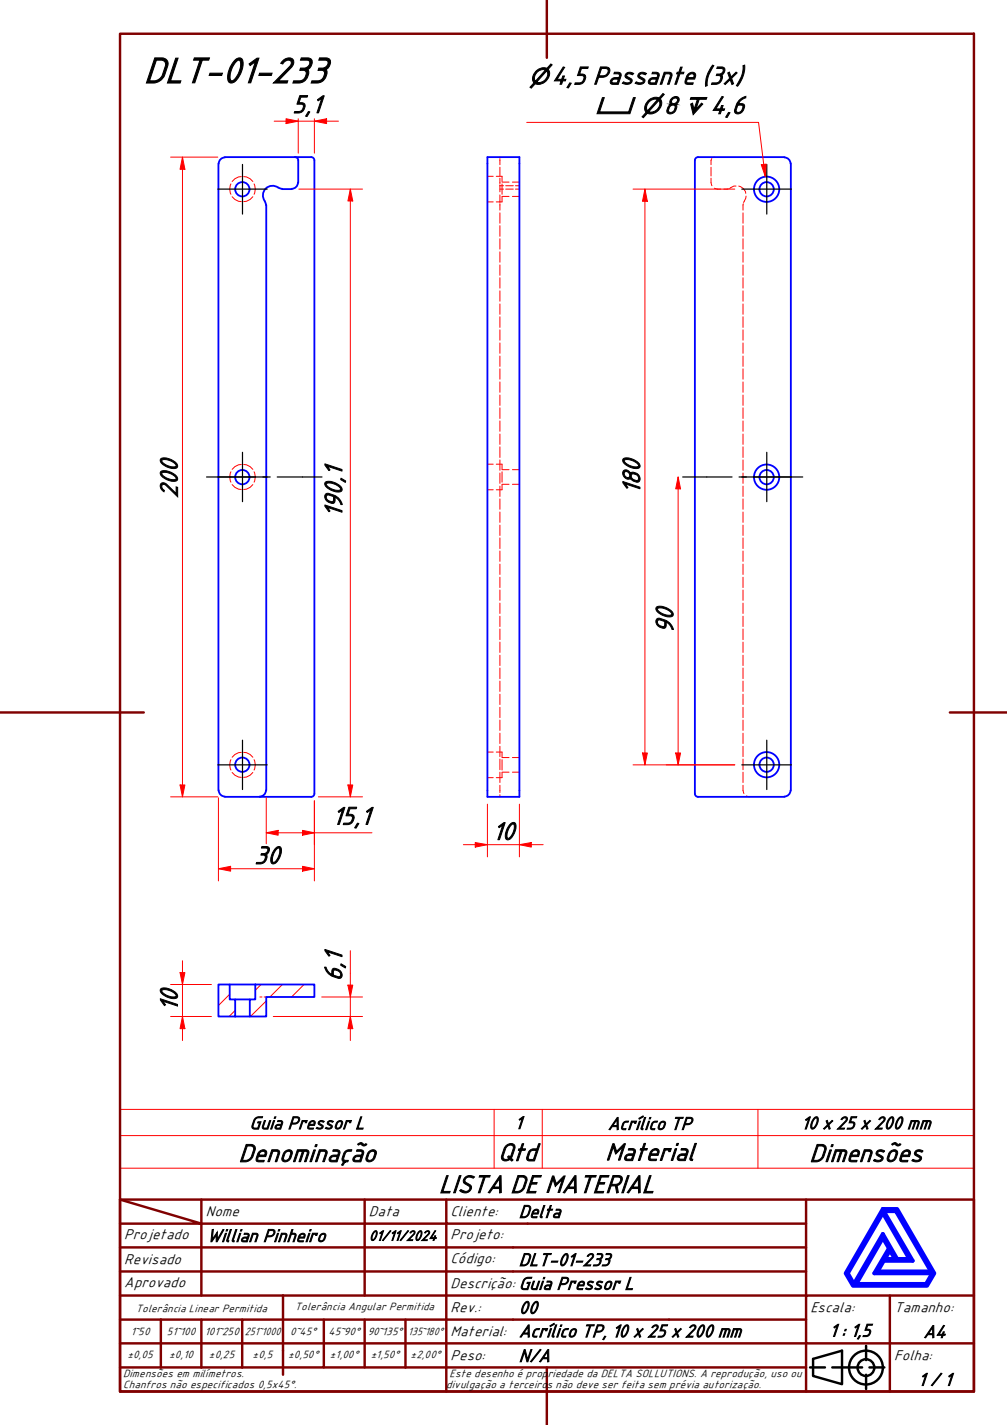
[picture p108: page 3]
Guia Pressor L; Acrílico TP; Denominação; Qtd; Material; Dimensões; Nome; Revisado; Projetado; Aprovado; Willian Pinheiro; Cliente:; Descrição:; Código:; Projeto:; Data; Delta; DLT-01-233

LISTA DE MATERIAL

Acrílico TP, 10 x 25 x 200 mm

# DLT-01-234

# n 4,5 Passante (3x)

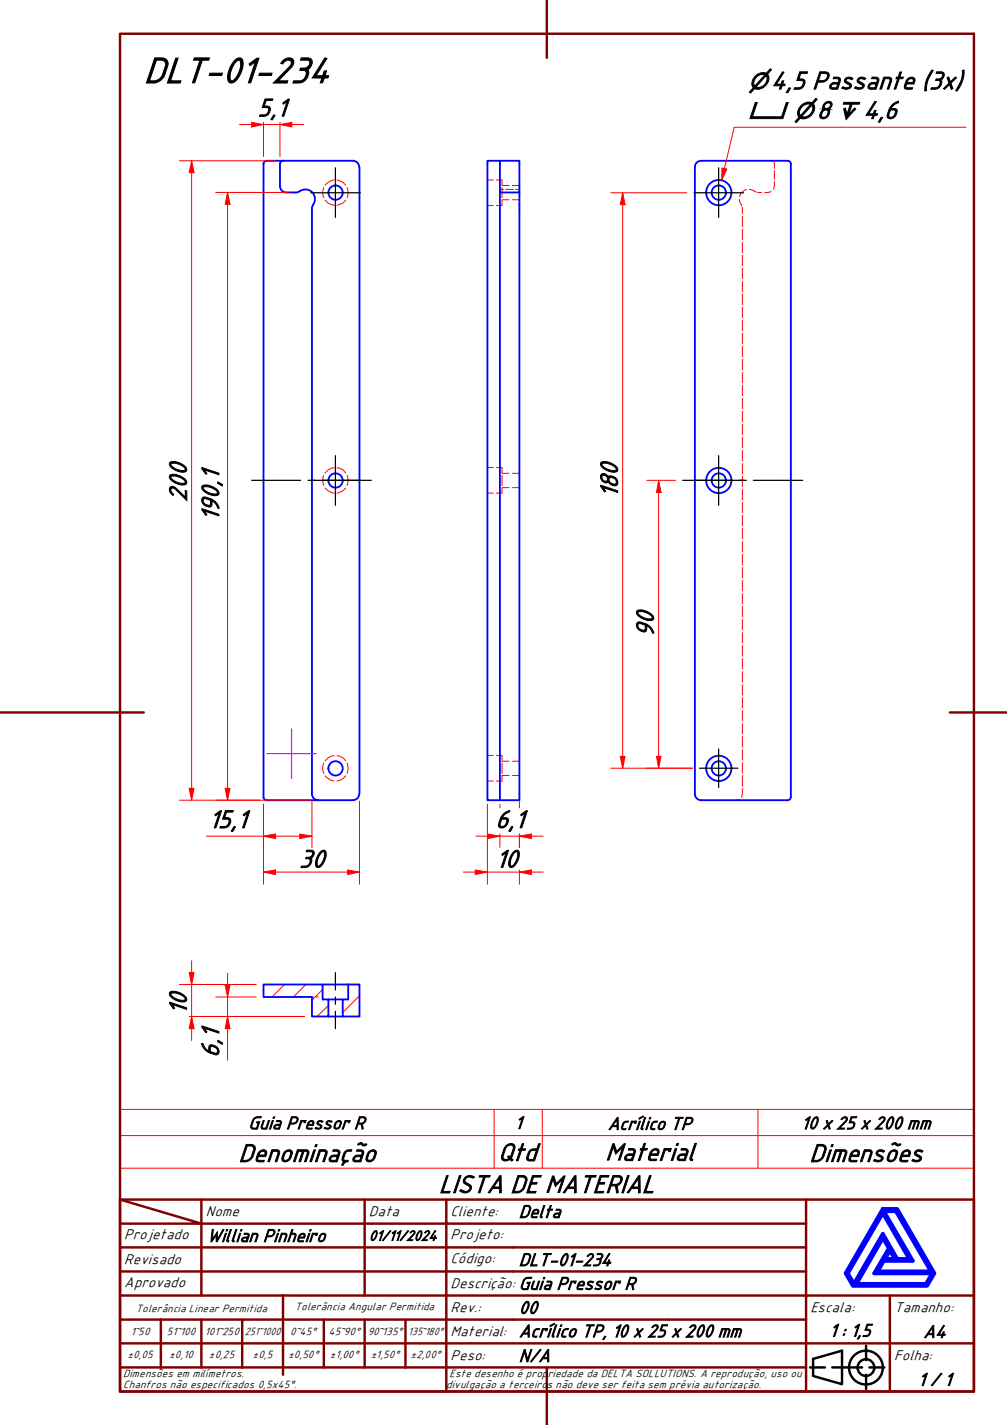
[picture p109: page 4]
Guia Pressor R; Acrílico TP; Denominação; Qtd; Material; Dimensões; Nome; Revisado; Projetado; Aprovado; Willian Pinheiro; Cliente:; Descrição:; Código:; Projeto:; Data; Delta; DLT-01-234

LISTA DE MATERIAL

Acrílico TP, 10 x 25 x 200 mm

# DLT-01-235B

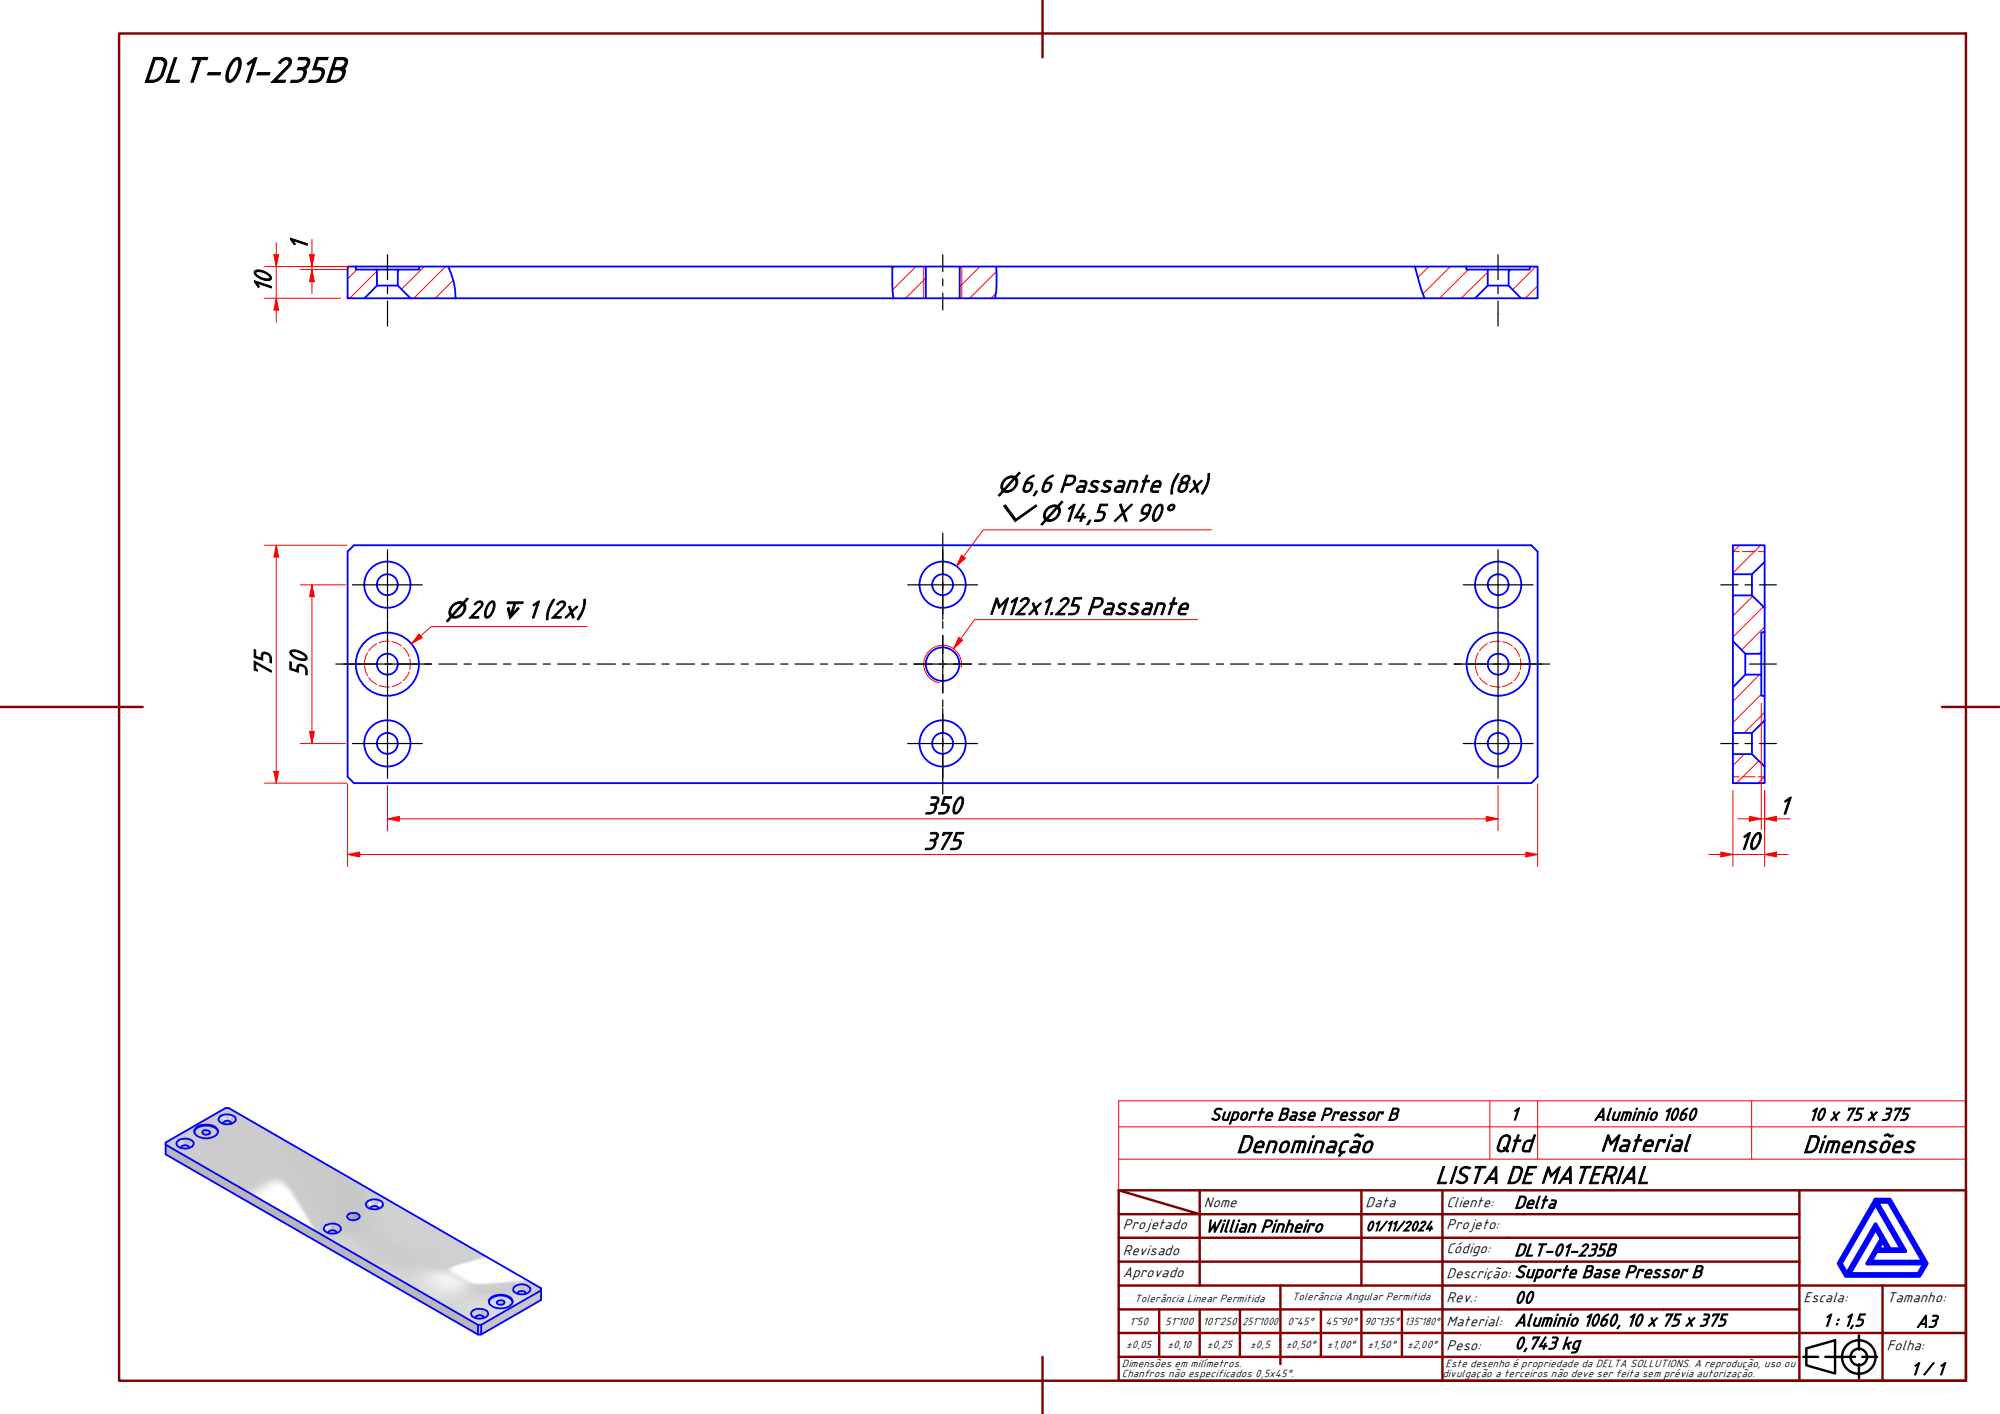
[picture p110: page 5]
Suporte Base Pressor B; Aluminio 1060; Denominação; Qtd; Material; Dimensões; Nome; Revisado; Projetado; Aprovado; Willian Pinheiro; Cliente:; Descrição:; Código:; Projeto:; Data; Delta; n 6,6 Passante (8x) w n 14,5 X 90°; M12x1.25 Passante

LISTA DE MATERIAL

DLT-01-235B
Suporte Base Pressor B

Aluminio 1060, 10 x 75 x 375
0,743 kg

# DLT-01-236B

n 20

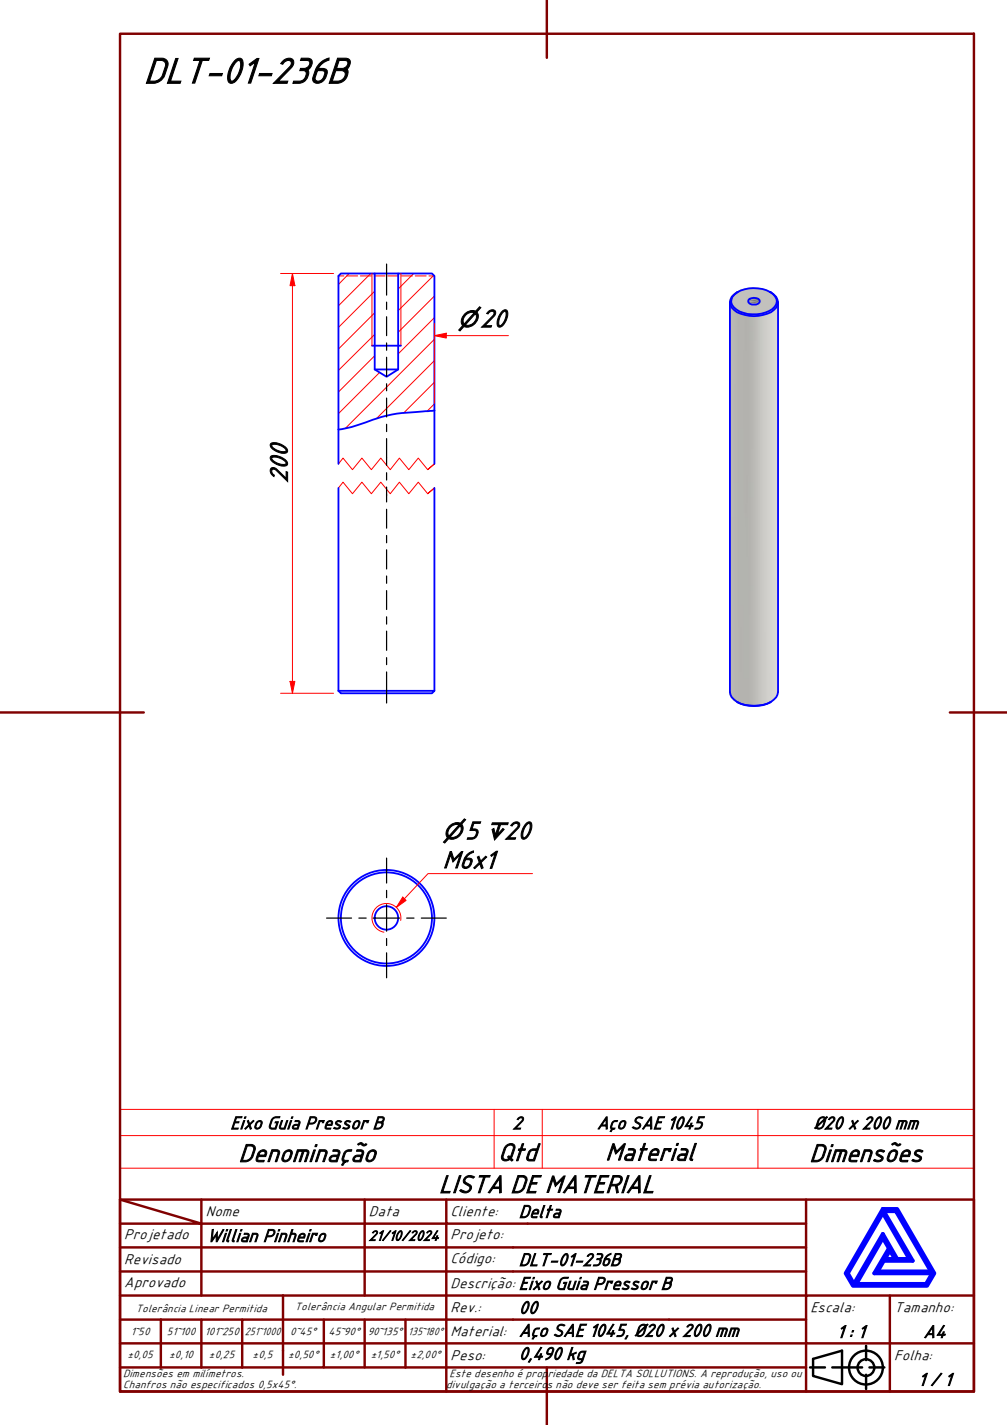
[picture p111: page 6]
Eixo Guia Pressor B; Aço SAE 1045; Denominação; Qtd; Material; Dimensões; Nome; Revisado; Projetado; Aprovado; Willian Pinheiro; Cliente:; Descrição:; Código:; Projeto:; Data; Delta

LISTA DE MATERIAL

DLT-01-236B
Eixo Guia Pressor B

Aço SAE 1045, Ø20 x 200 mm
0,490 kg

# DLT-01-237

9

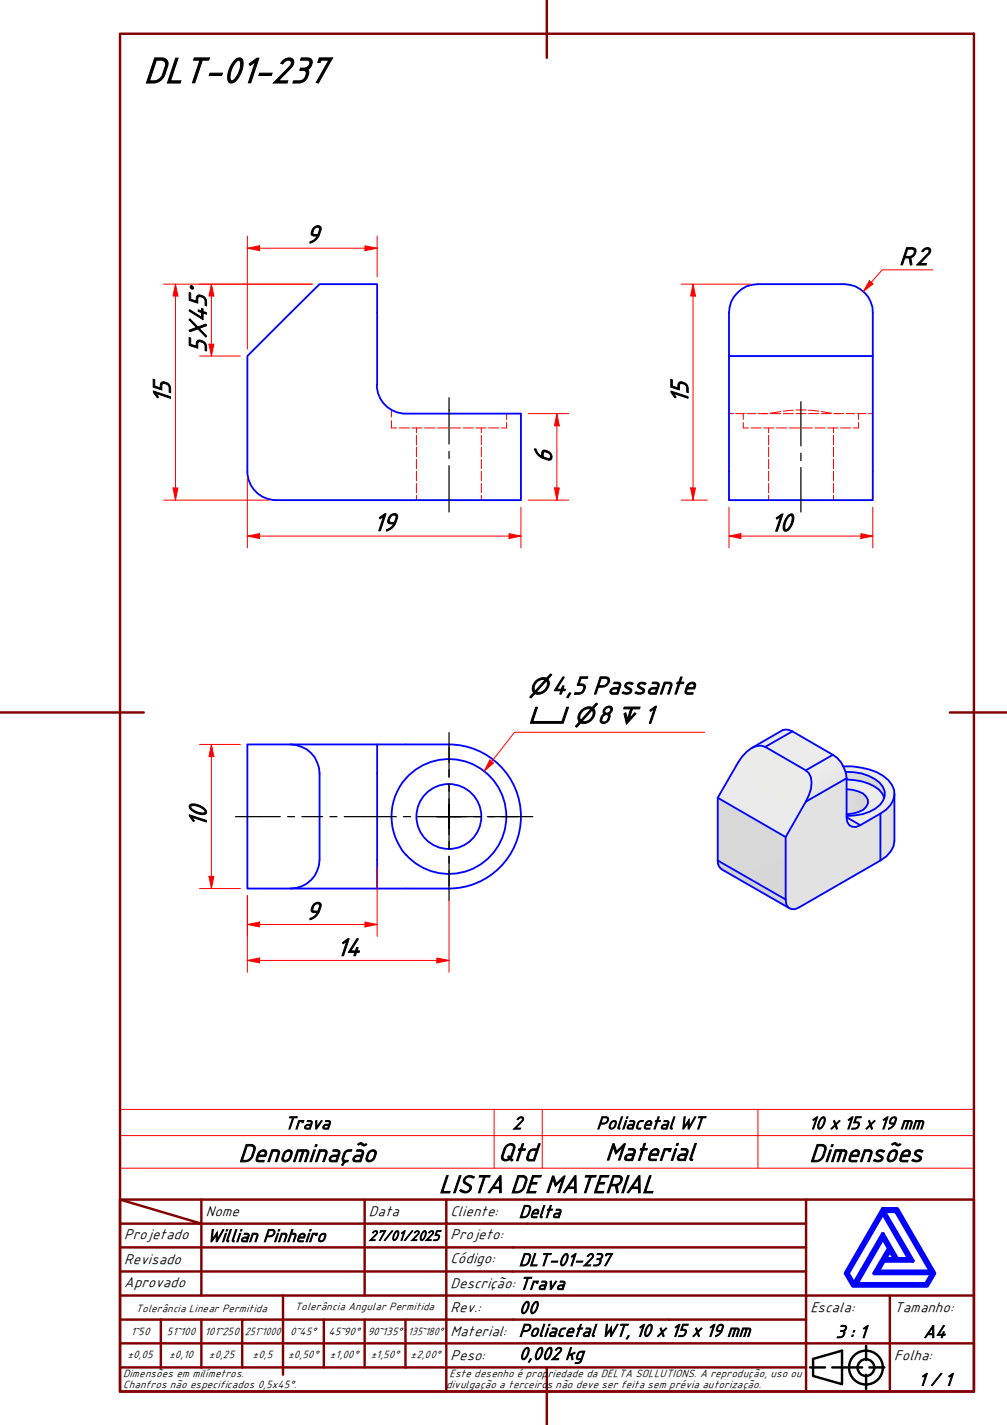
[picture p112: page 7]
Trava; Poliacetal WT; Denominação; Qtd; Material; Dimensões; Nome; Revisado; Projetado; Aprovado; Willian Pinheiro; Cliente:; Descrição:; Código:; Projeto:; Data; Delta; DLT-01-237; n 4,5 Passante v n 8 x 1

LISTA DE MATERIAL

Poliacetal WT, 10 x 15 x 19 mm
0,002 kg

# DLT-01-238B

n 10

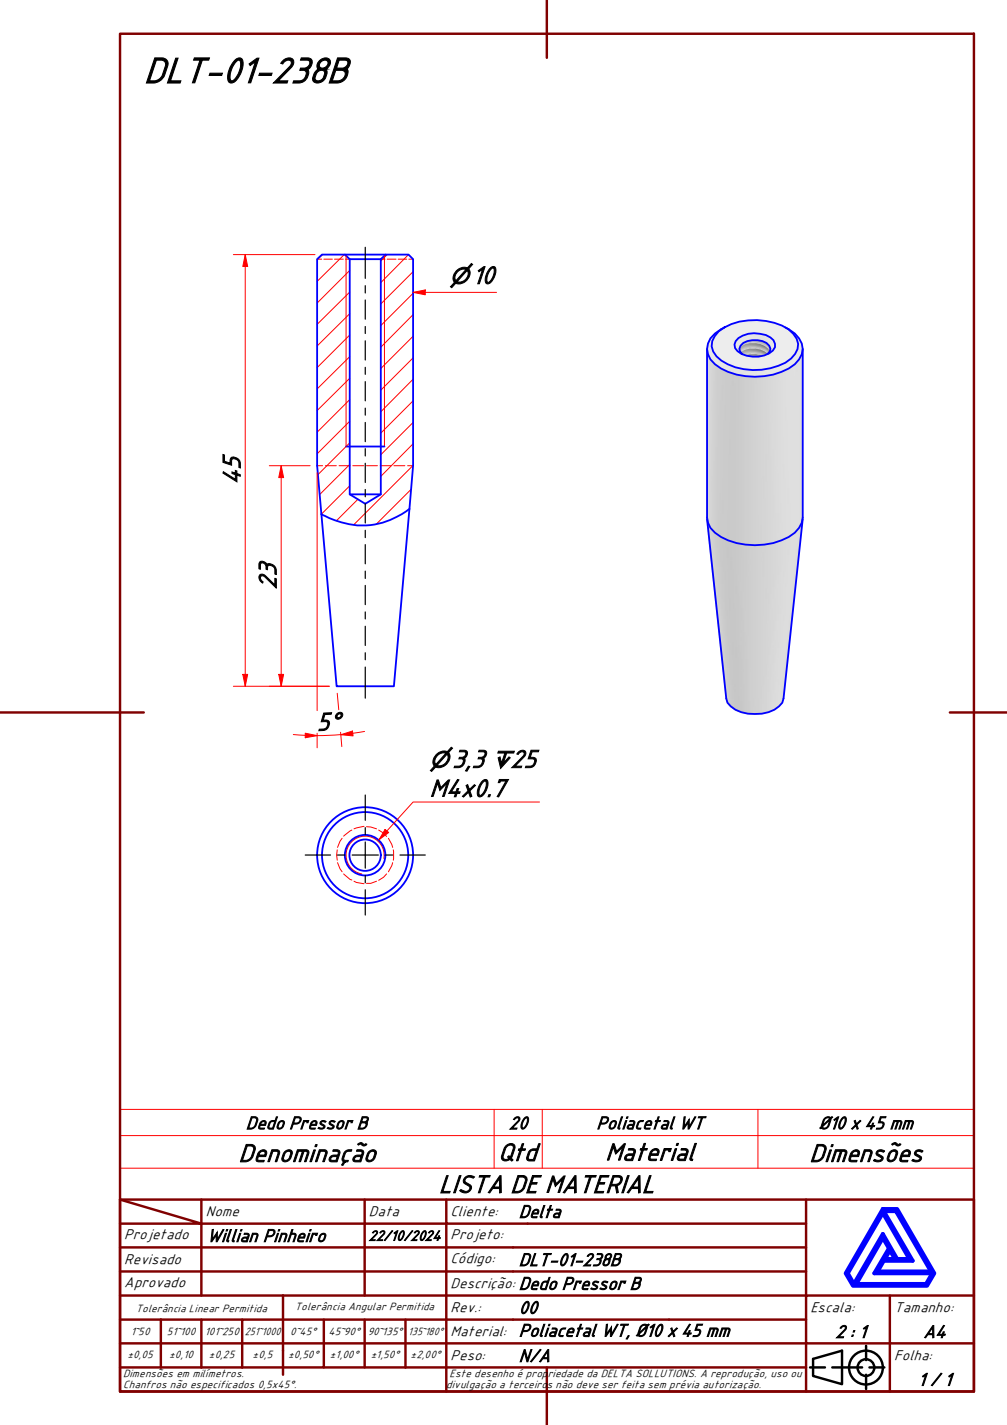
[picture p113: page 8]
Dedo Pressor B; Poliacetal WT; Denominação; Qtd; Material; Dimensões; Nome; Revisado; Projetado; Aprovado; Willian Pinheiro; Cliente:; Descrição:; Código:; Projeto:; Data; Delta; DLT-01-238B

LISTA DE MATERIAL

Poliacetal WT, Ø10 x 45 mm
