pvrezende/Dashboard/uploads/anexo-1754423061217-131169165.pdf

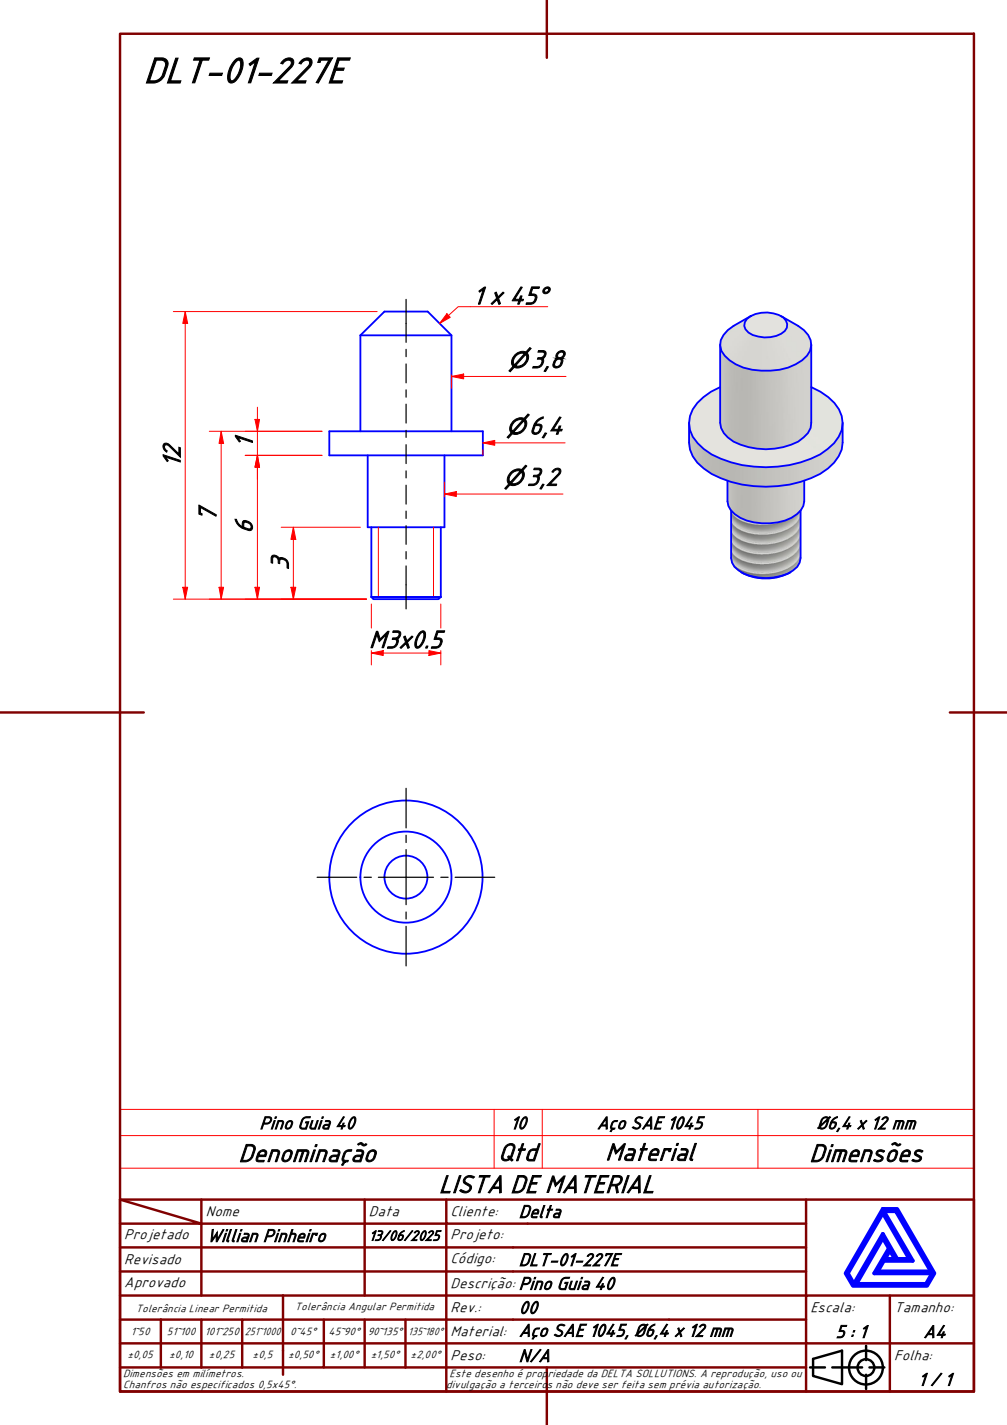
[picture p114: page 1]

Pino Guia 40 | 10 | Aço SAE 1045 | Ø6,4 x 12 mm
Denominação | Qtd | Material | Dimensões

LISTA DE MATERIAL

Projetado | Nome | Data | Cliente: Delta

Willian Pinheiro | 13/06/2025 | Projeto:

Revisado | | | Código: DLT-01-227E
Aprovado | | | Pino Guia 40 Descrição:
Tolerância Linear Permitida | Tolerância Angular Permitida | Rev.: 00 | Escala: 5 : 1 | Tamanho: A4

1~50 | 51~100 | 101~250 | 251~1000 | 0~45° | 45~90° | 90~135° 135~180° | | Material: Aço SAE 1045, Ø6,4 x 12 mm
±0,05 | ±0,10 | ±0,25 | ±0,5 | ±0,50° | ±1,00° | ±1,50° | ±2,00° | Peso: N/A | Folha: 1 / 1
Chanfros não especificados 0,5x45°. | | Este desenho é propriedade da DELTA SOLLUTIONS. A reprodução, uso ou divulgação a terceiros não deve ser feita sem prévia autorização.

Dimensões em milímetros.
