pvrezende/Dashboard/uploads/anexo-1754423129250-295077976.pdf

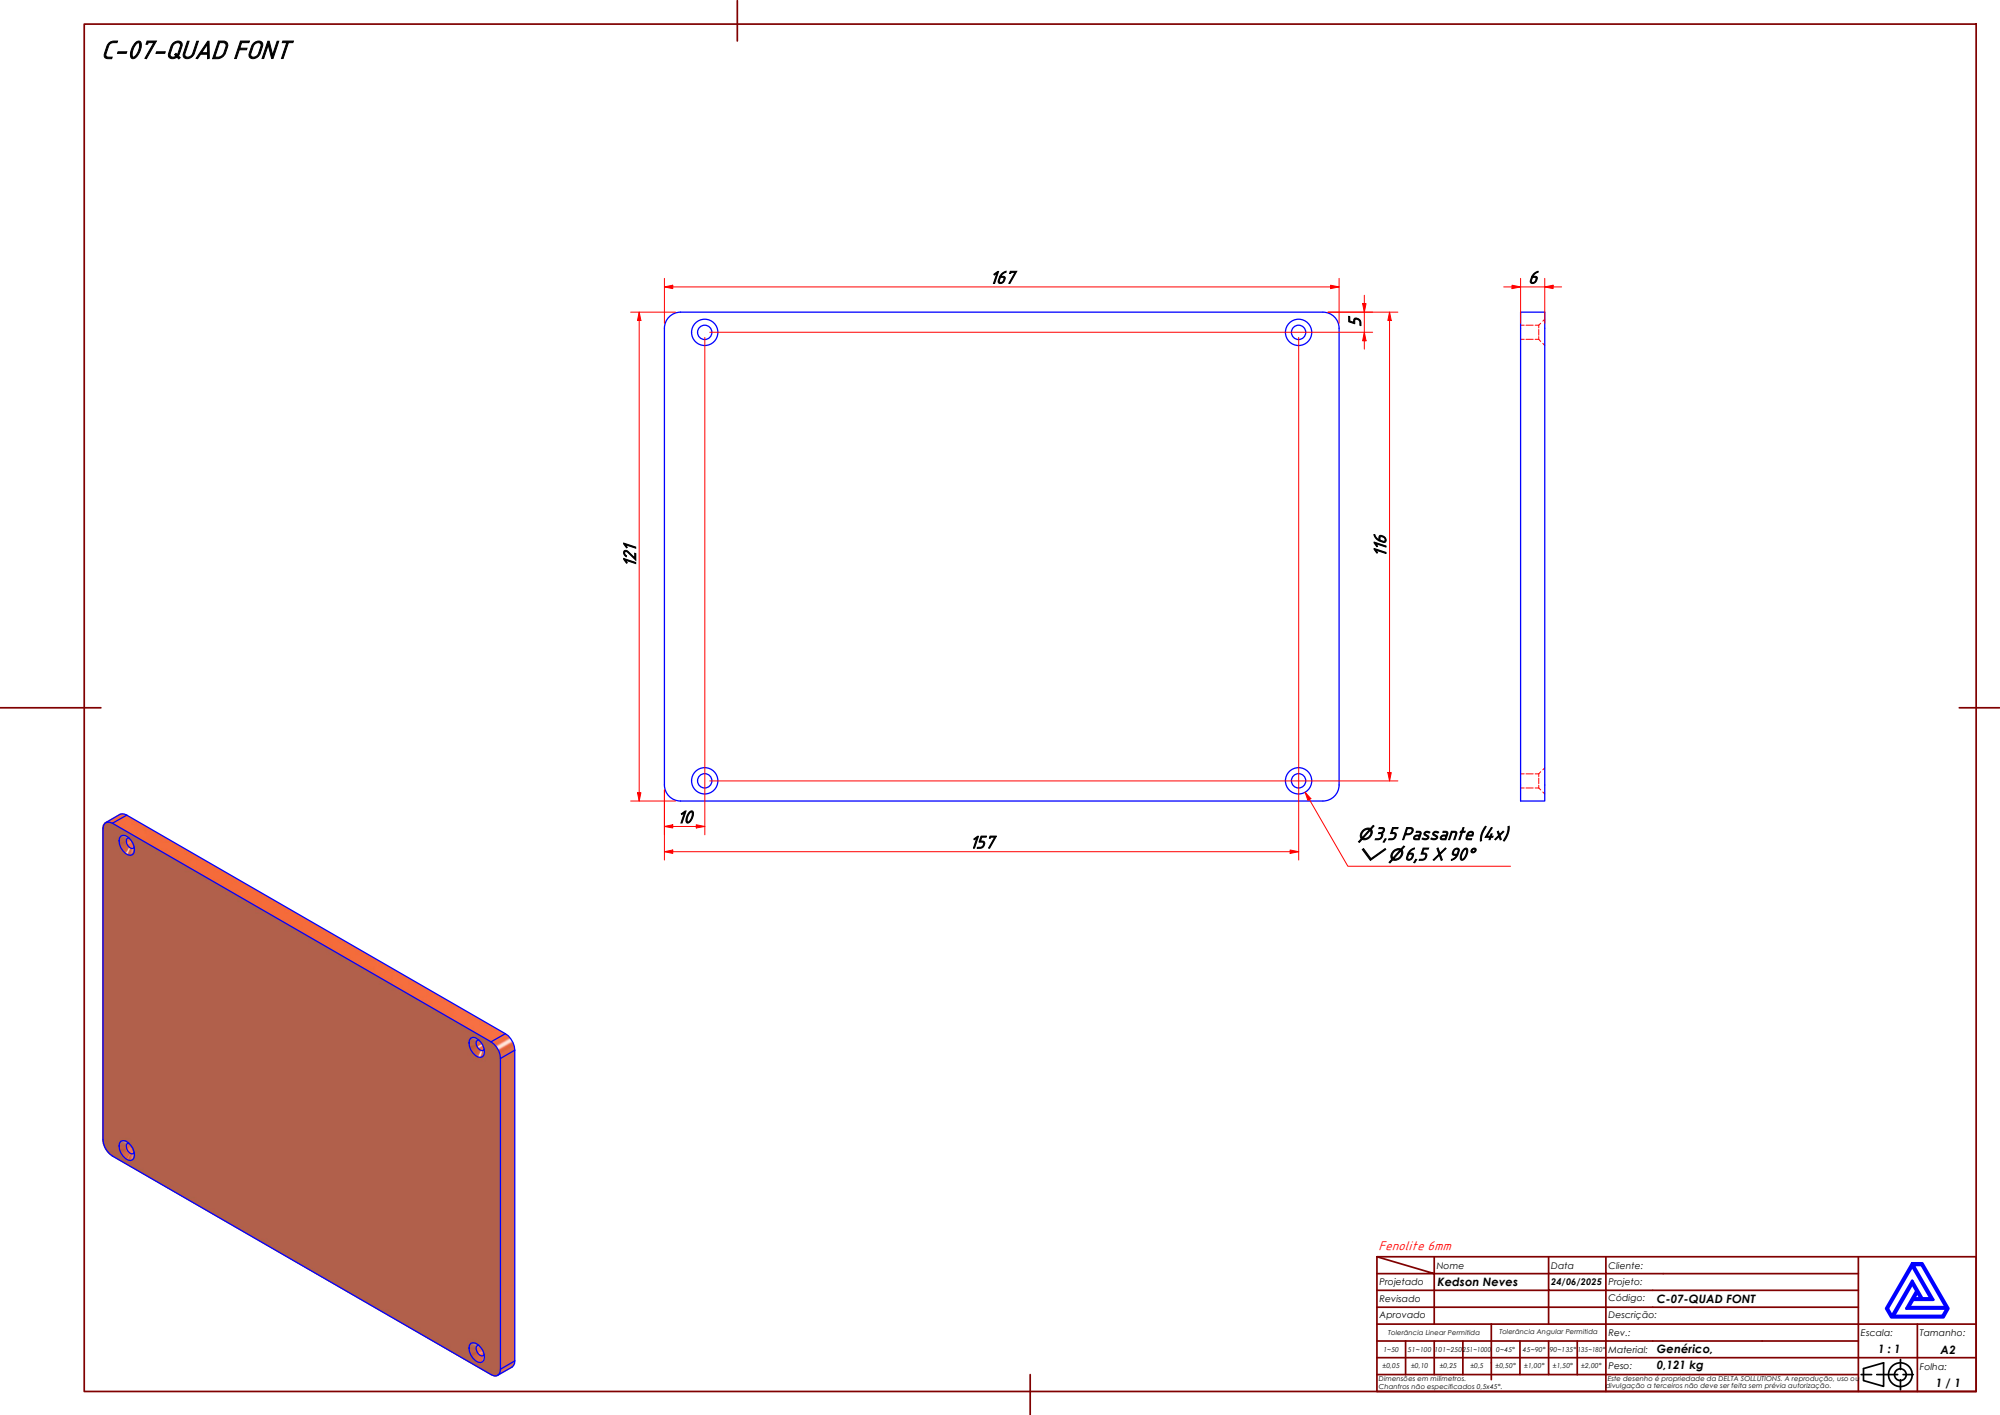
[picture p116: page 1]
C-07-QUAD FONT; ⌀ 3,5 Passante (4x) ⌵ ⌀ 6,5 X 90°; Fenolite 6mm

Projetado | Nome | Data | Cliente:

Kedson Neves | 24/06/2025 | Projeto:

Revisado | | | Código: C-07-QUAD FONT

Aprovado | | | Descrição:
Tolerância Linear Permitida | Tolerância Angular Permitida | Rev.: | Escala: 1 : 1 | Tamanho: A2

1~50 | 51~100 | 101~250 | 251~1000 | 0~45° | 45~90° | 90~135° 135~180° | | Genérico, Material:
±0,05 | ±0,10 | ±0,25 | ±0,5 | ±0,50° | ±1,00° | ±1,50° | ±2,00° | Peso: 0,121 kg | Folha: 1 / 1

Dimensões em milímetros.

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
