pvrezende/Dashboard/uploads/anexo-1755010821886-834416295.pdf

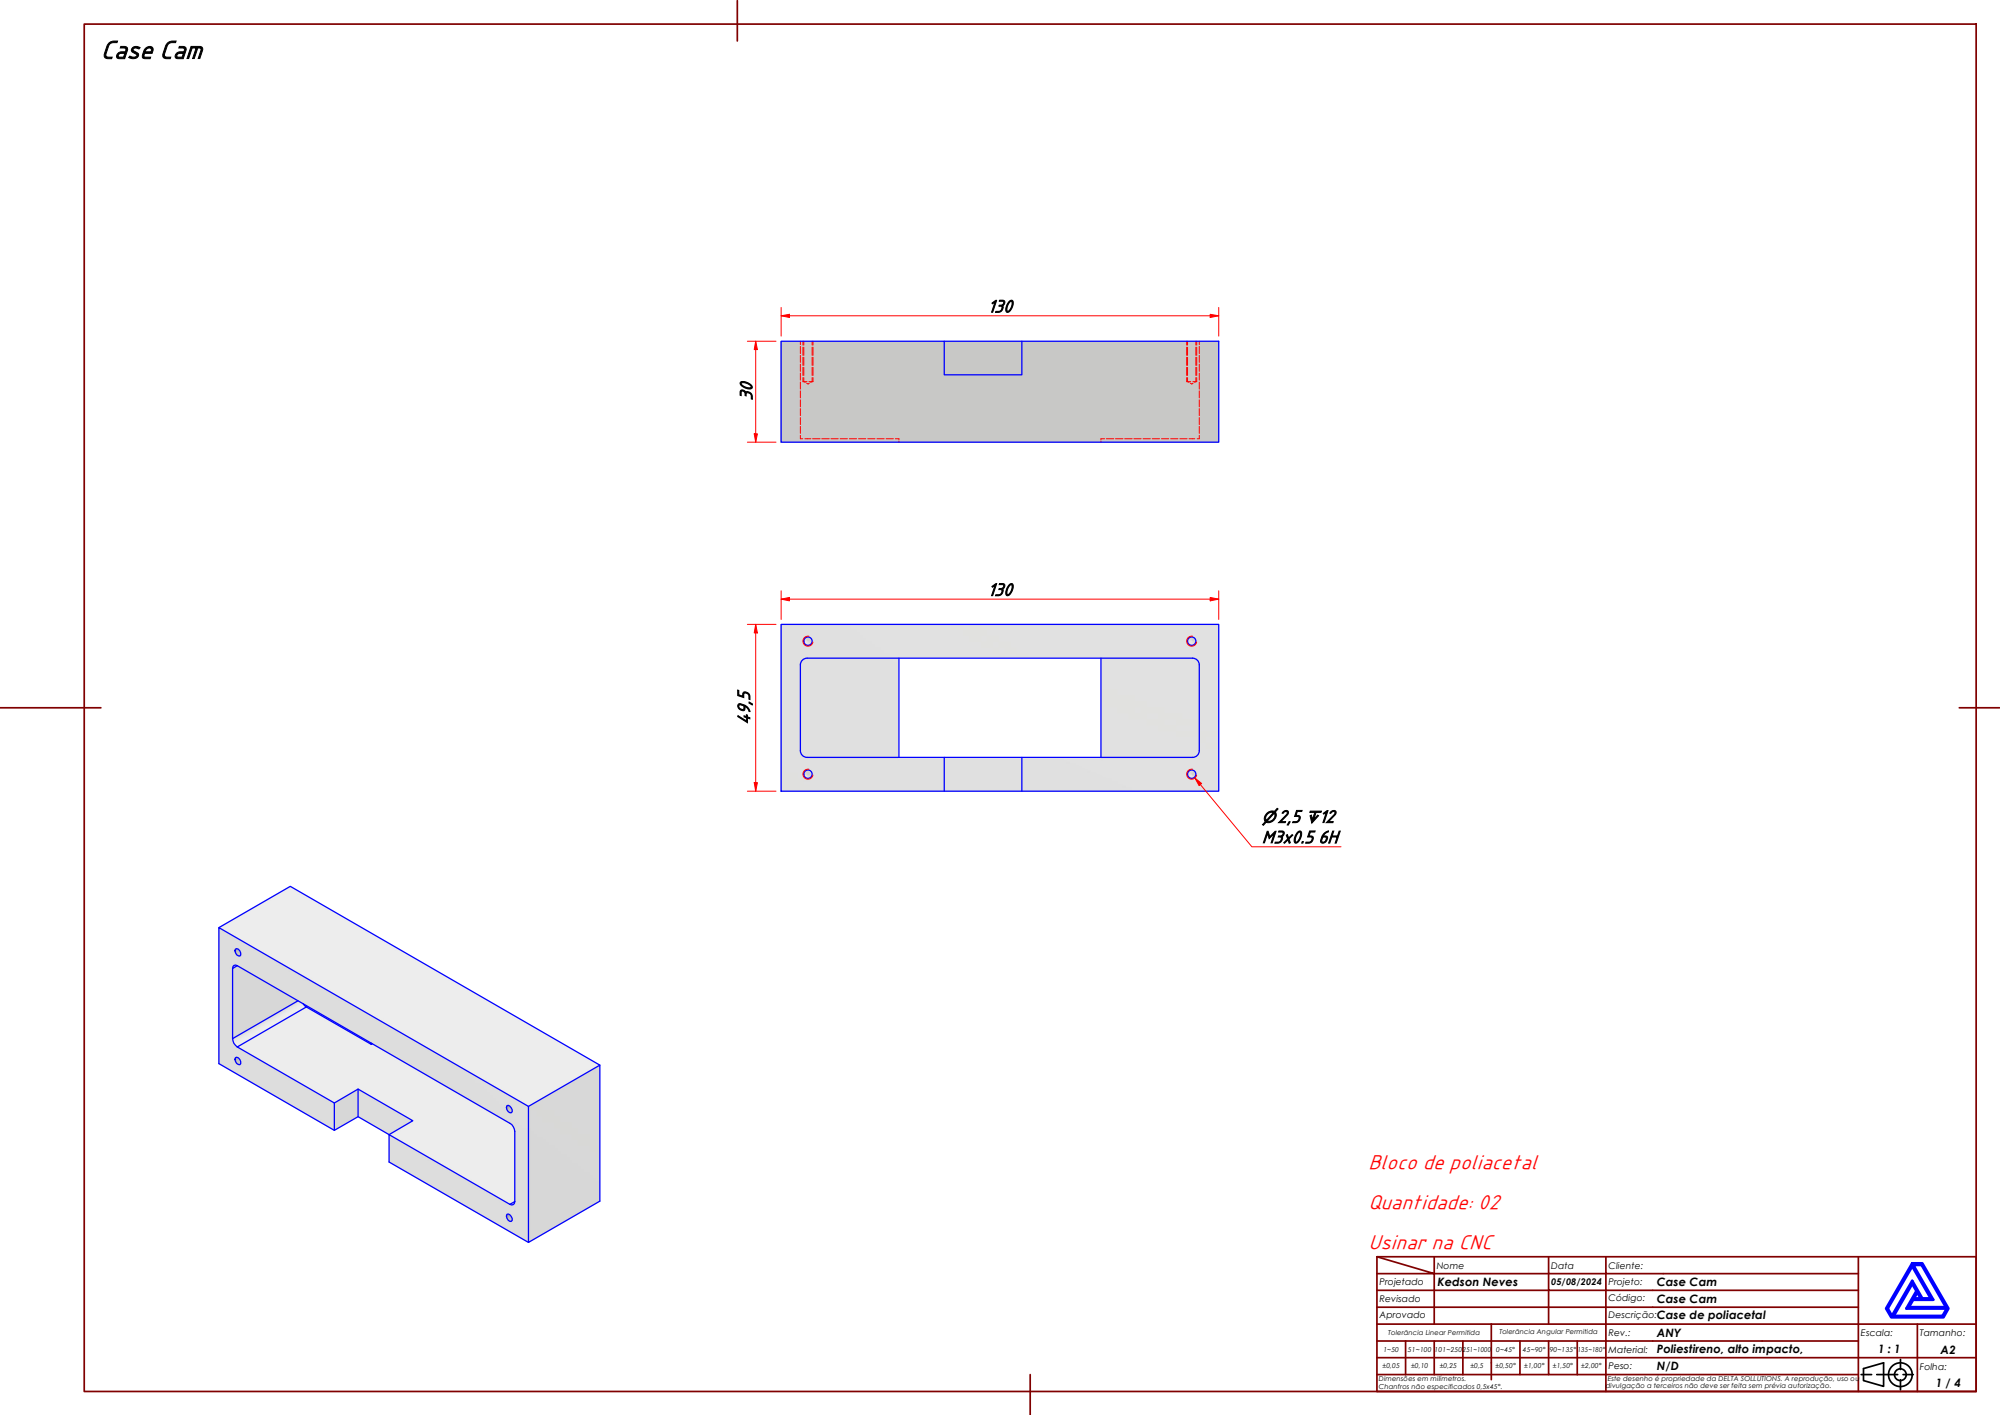
[picture p117: page 1]
Case Cam; Quantidade: 02

Bloco de poliacetal

Usinar na CNC

Projetado | Nome | Data | Cliente:

Kedson Neves | 05/08/2024 | Projeto: Case Cam

Revisado | | | Código: Case Cam
Aprovado | | | Descrição: Case de poliacetal
Tolerância Linear Permitida | Tolerância Angular Permitida | Rev.: ANY | Escala: 1 : 1 | Tamanho: A2

1~50 | 51~100 | 101~250 | | | | 90~135° 135~180° | | Poliestireno, alto impacto, Material:

±1,00° | | ±2,00° | Peso: N/D | Folha: 1 / 4

Dimensões em milímetros.

Chanfros não especificados 0,5x45°. | | | | | | | | Este desenho é propriedade da DELTA SOLLUTIONS. A reprodução, uso ou divulgação a terceiros não deve ser feita sem prévia autorização.

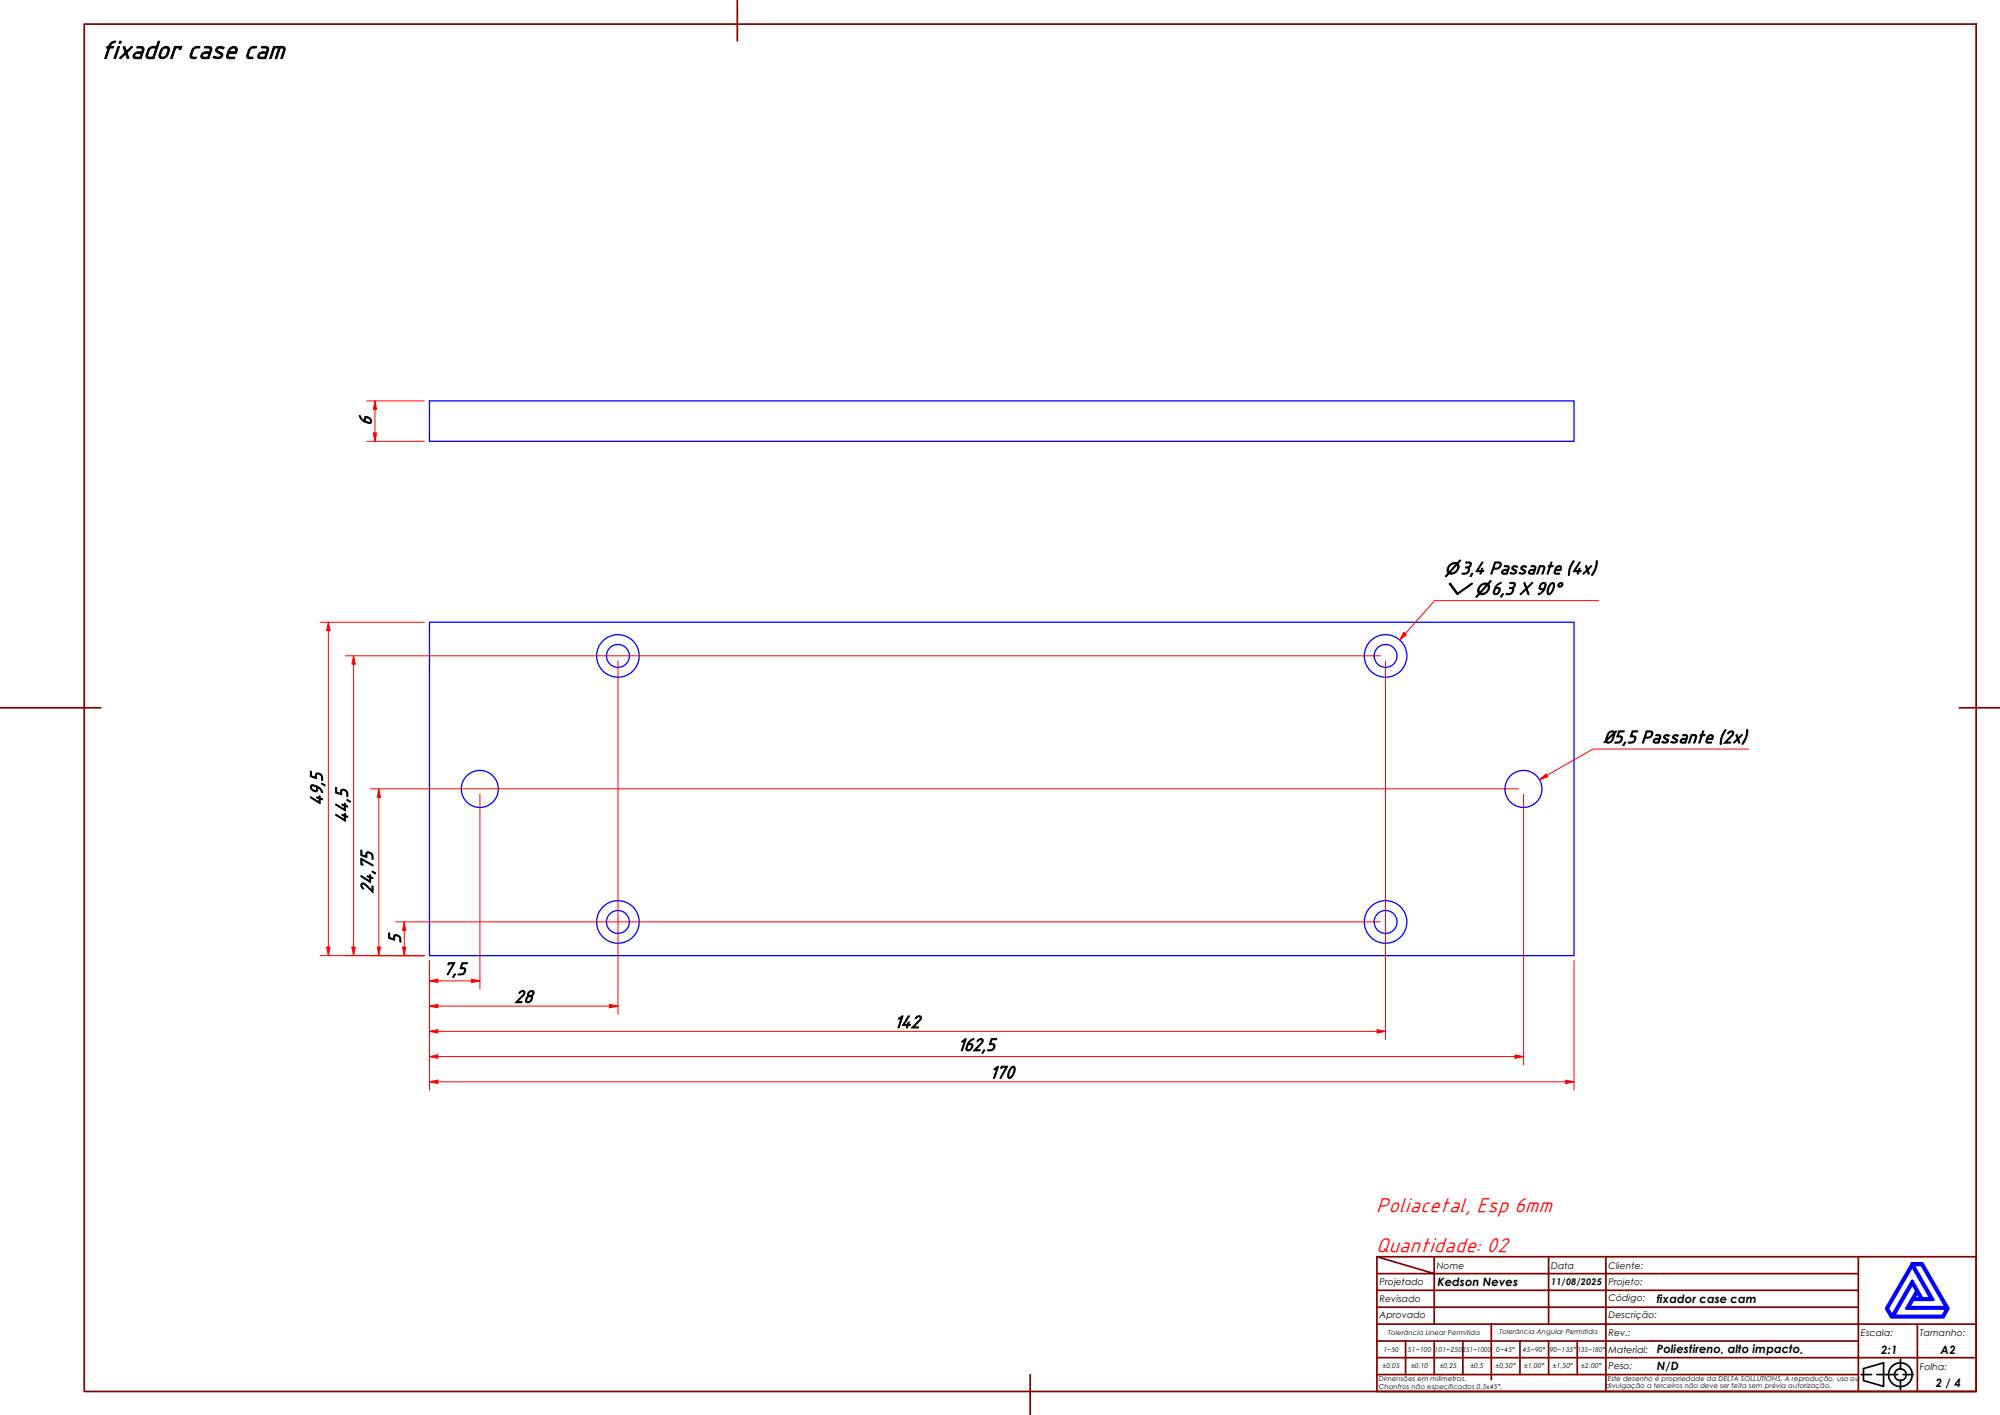
[picture p118: page 2]
⌀ 3,4 Passante (4x) ⌵ ⌀ 6,3 X 90°; Ø5,5 Passante (2x); Poliacetal, Esp 6mm; Quantidade: 02

fixador case cam

Projetado | Nome | Data | Cliente:

Kedson Neves | 11/08/2025 | Projeto:

Rev.: | 2:1

101~250 | | | Poliestireno, alto impacto,

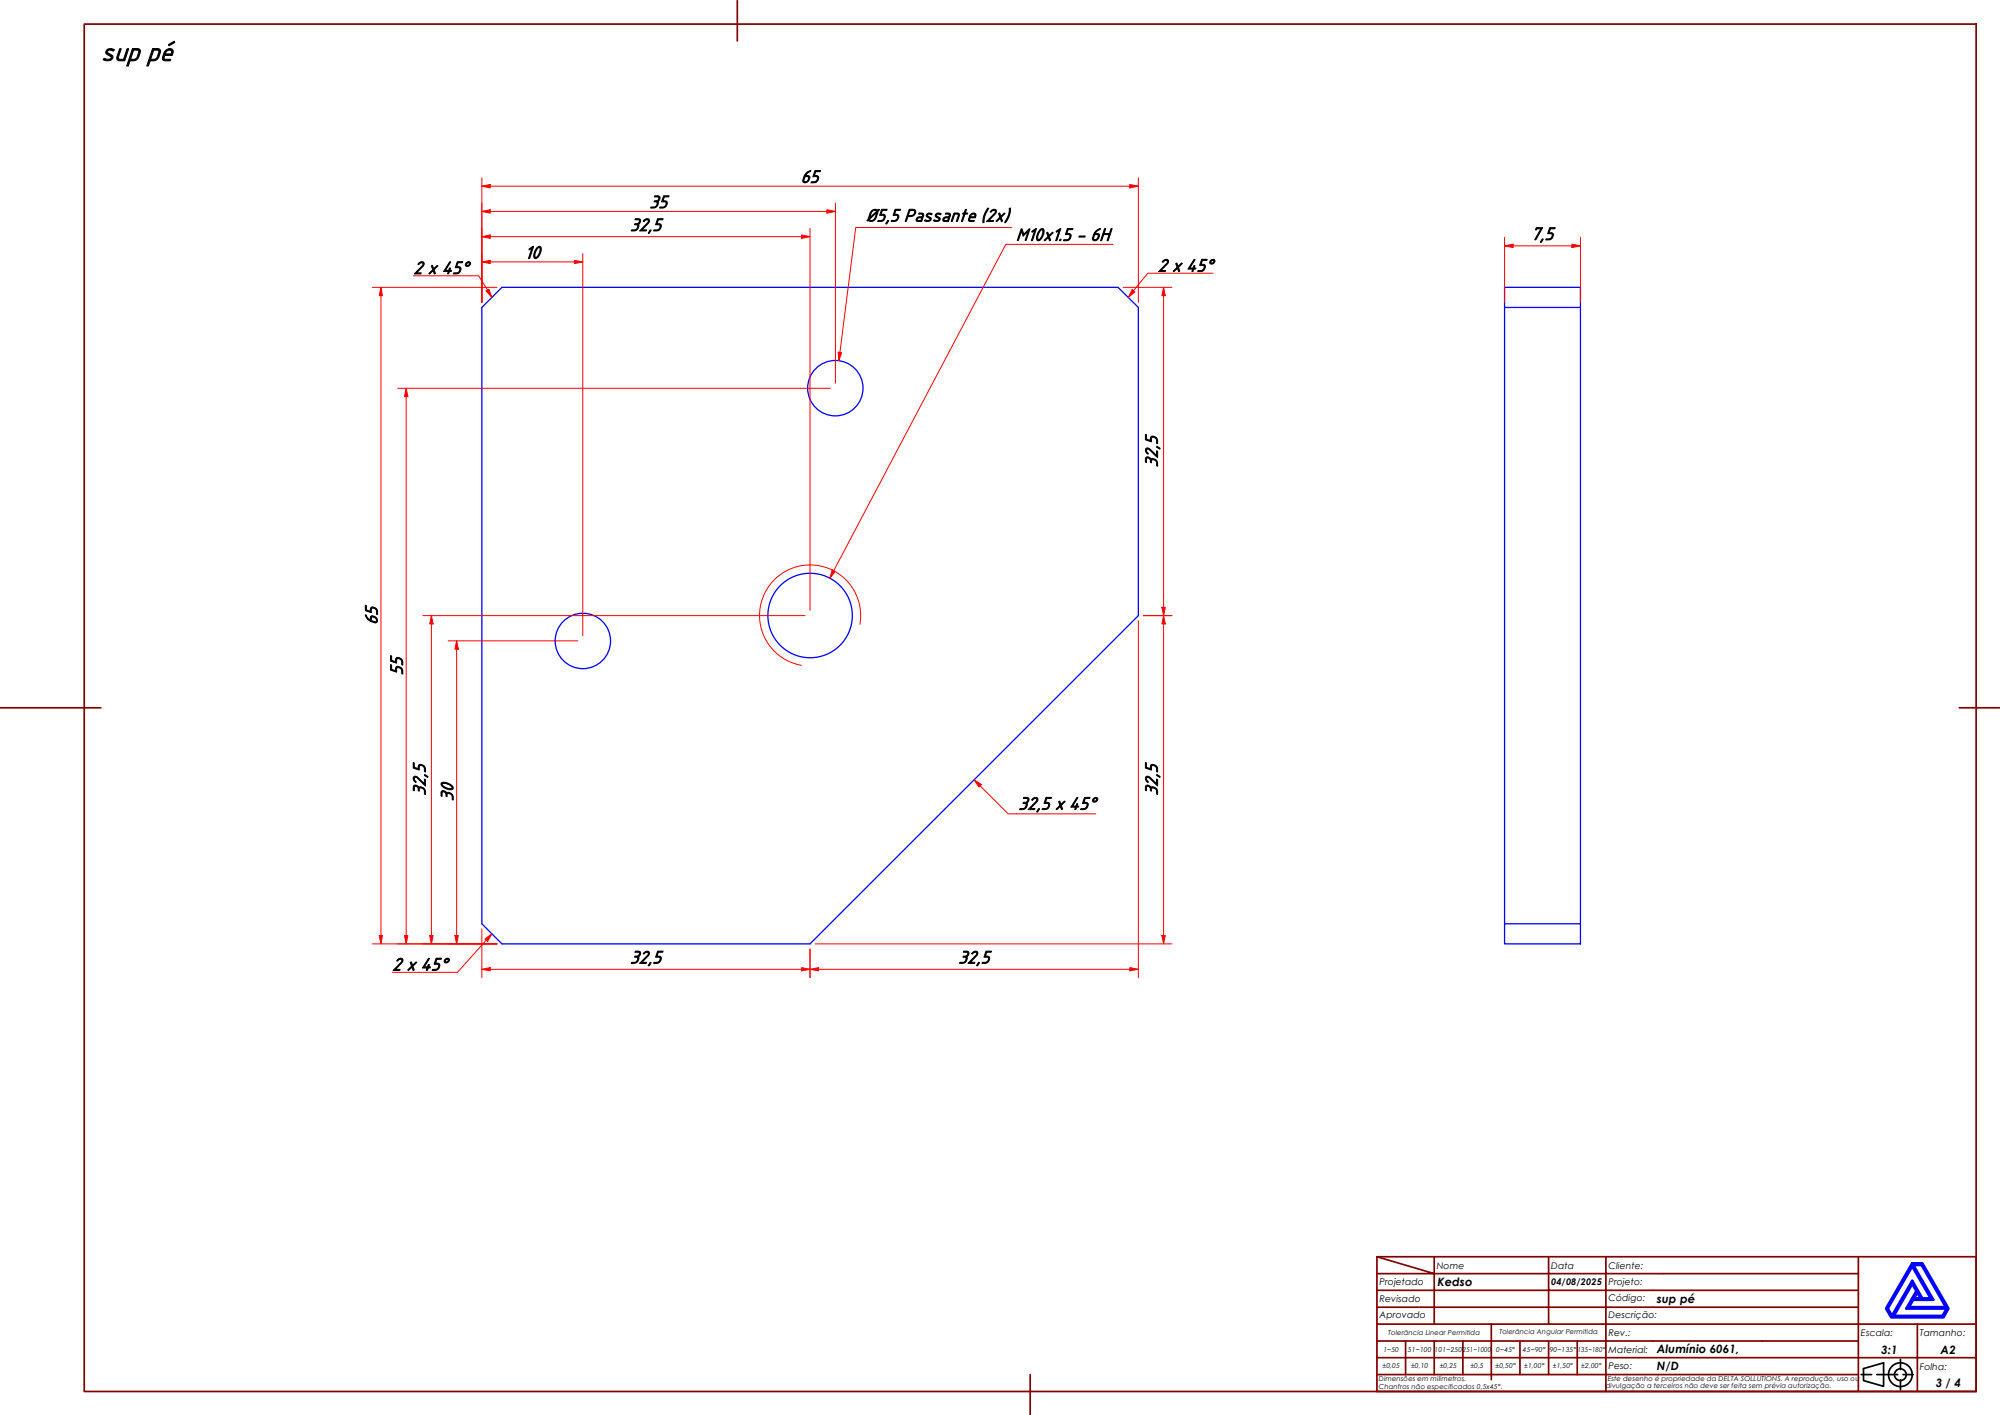
[picture p119: page 3]
sup pé; Ø5,5 Passante (2x)

Projetado | Nome | Data | Cliente:

Kedso | 04/08/2025 | Projeto:

sup pé

101~250 | | | Alumínio 6061,
3:1

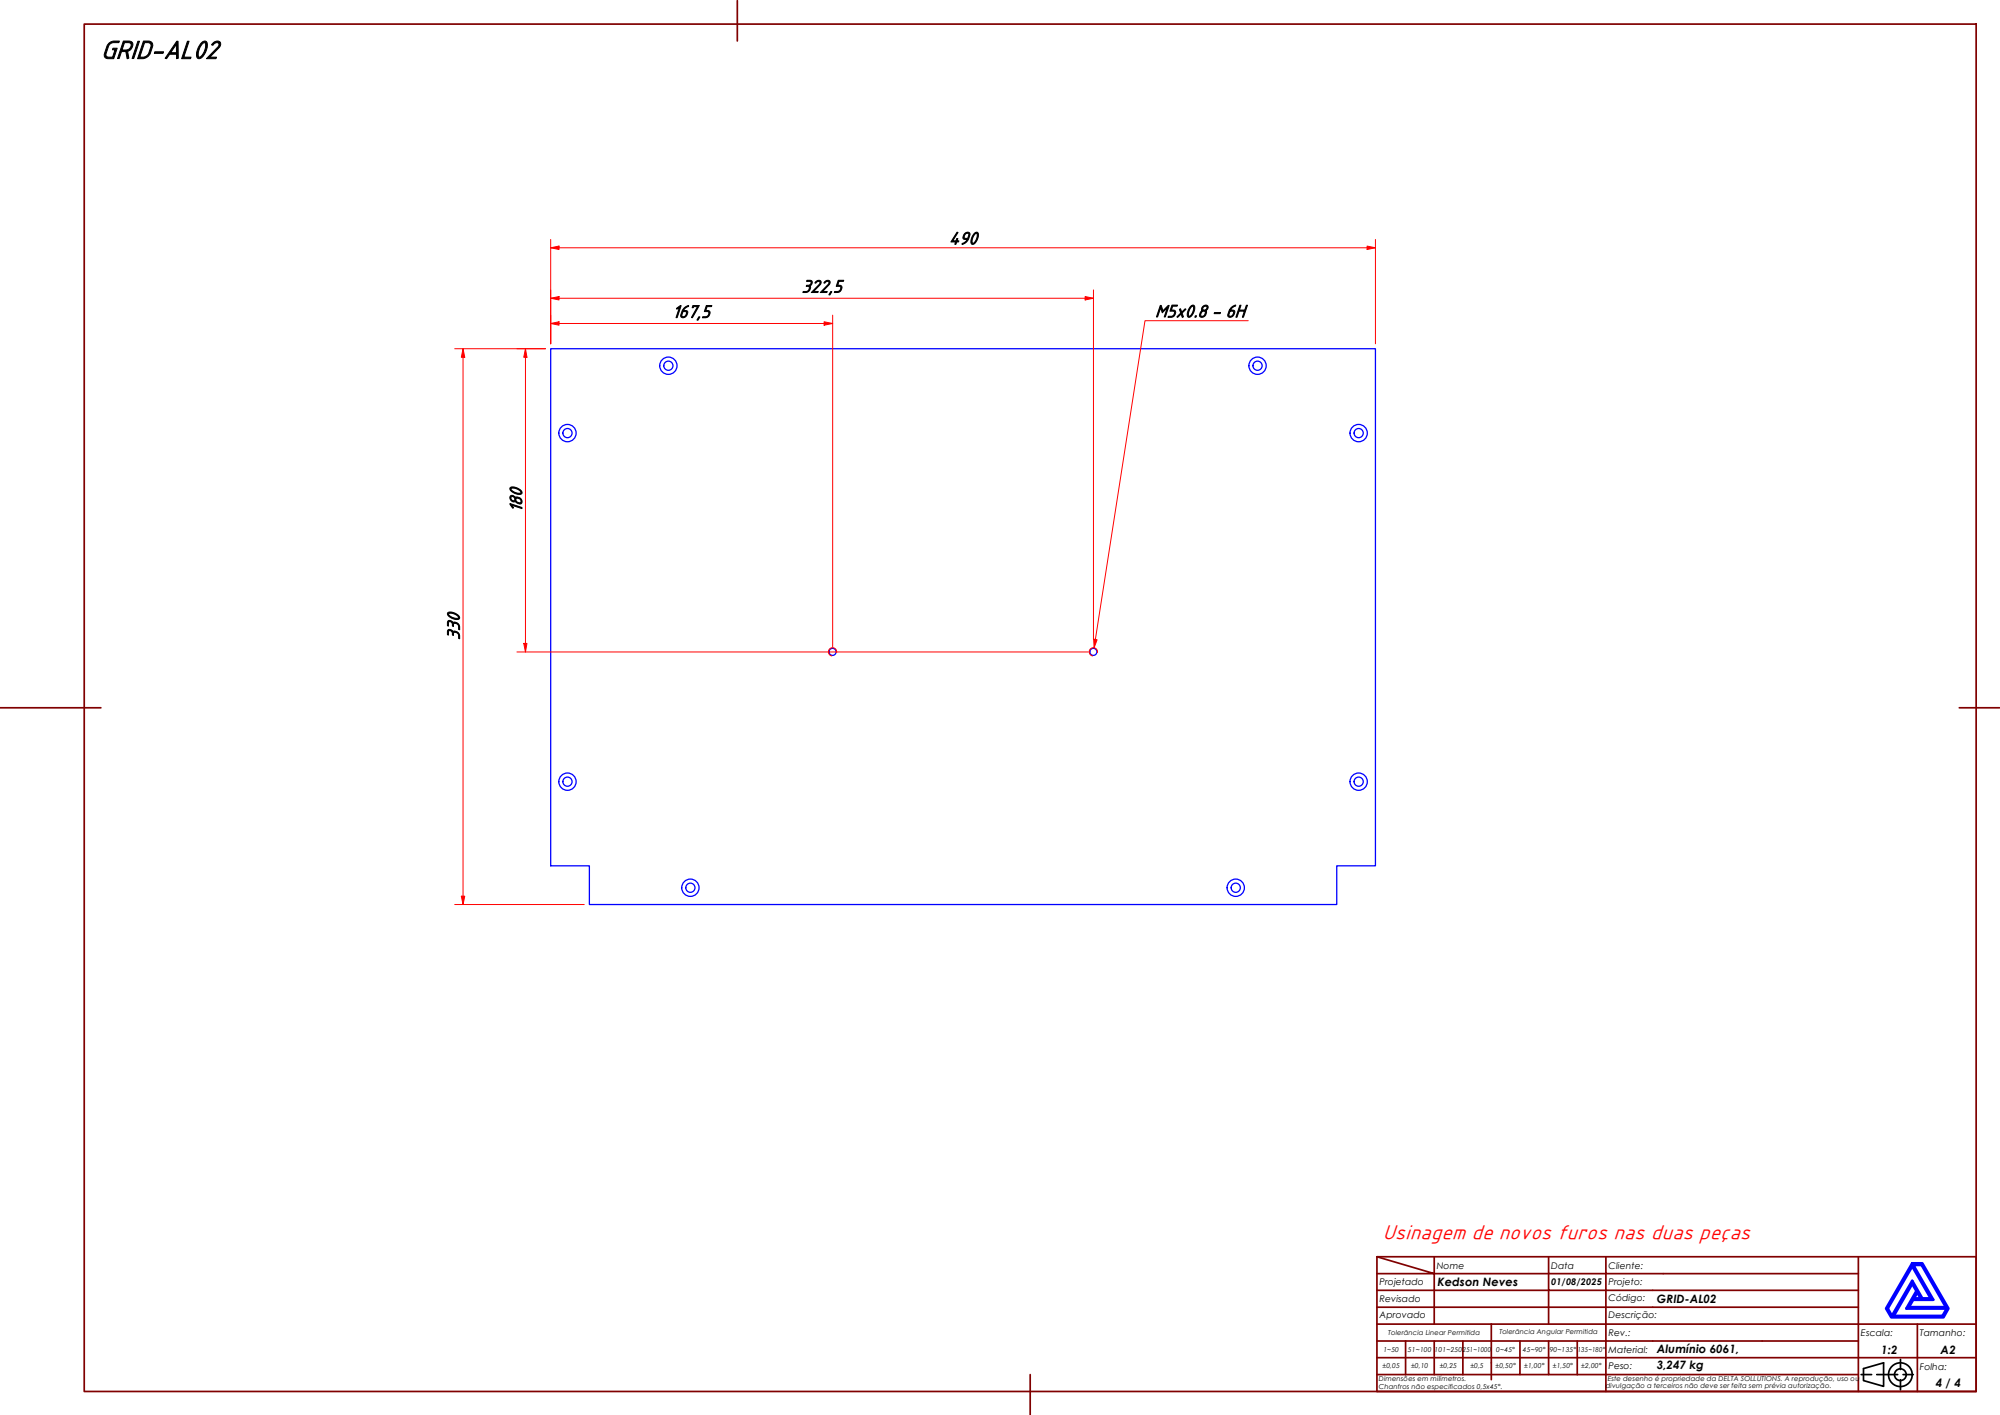
[picture p120: page 4]

Usinagem de novos furos nas duas peças

Projetado | Nome | Data | Cliente:

Kedson Neves | 01/08/2025 | Projeto:

GRID-AL02

101~250 | | Alumínio 6061,
1:2
