pvrezende/Dashboard/uploads/anexo-1755182310950-31331996.pdf

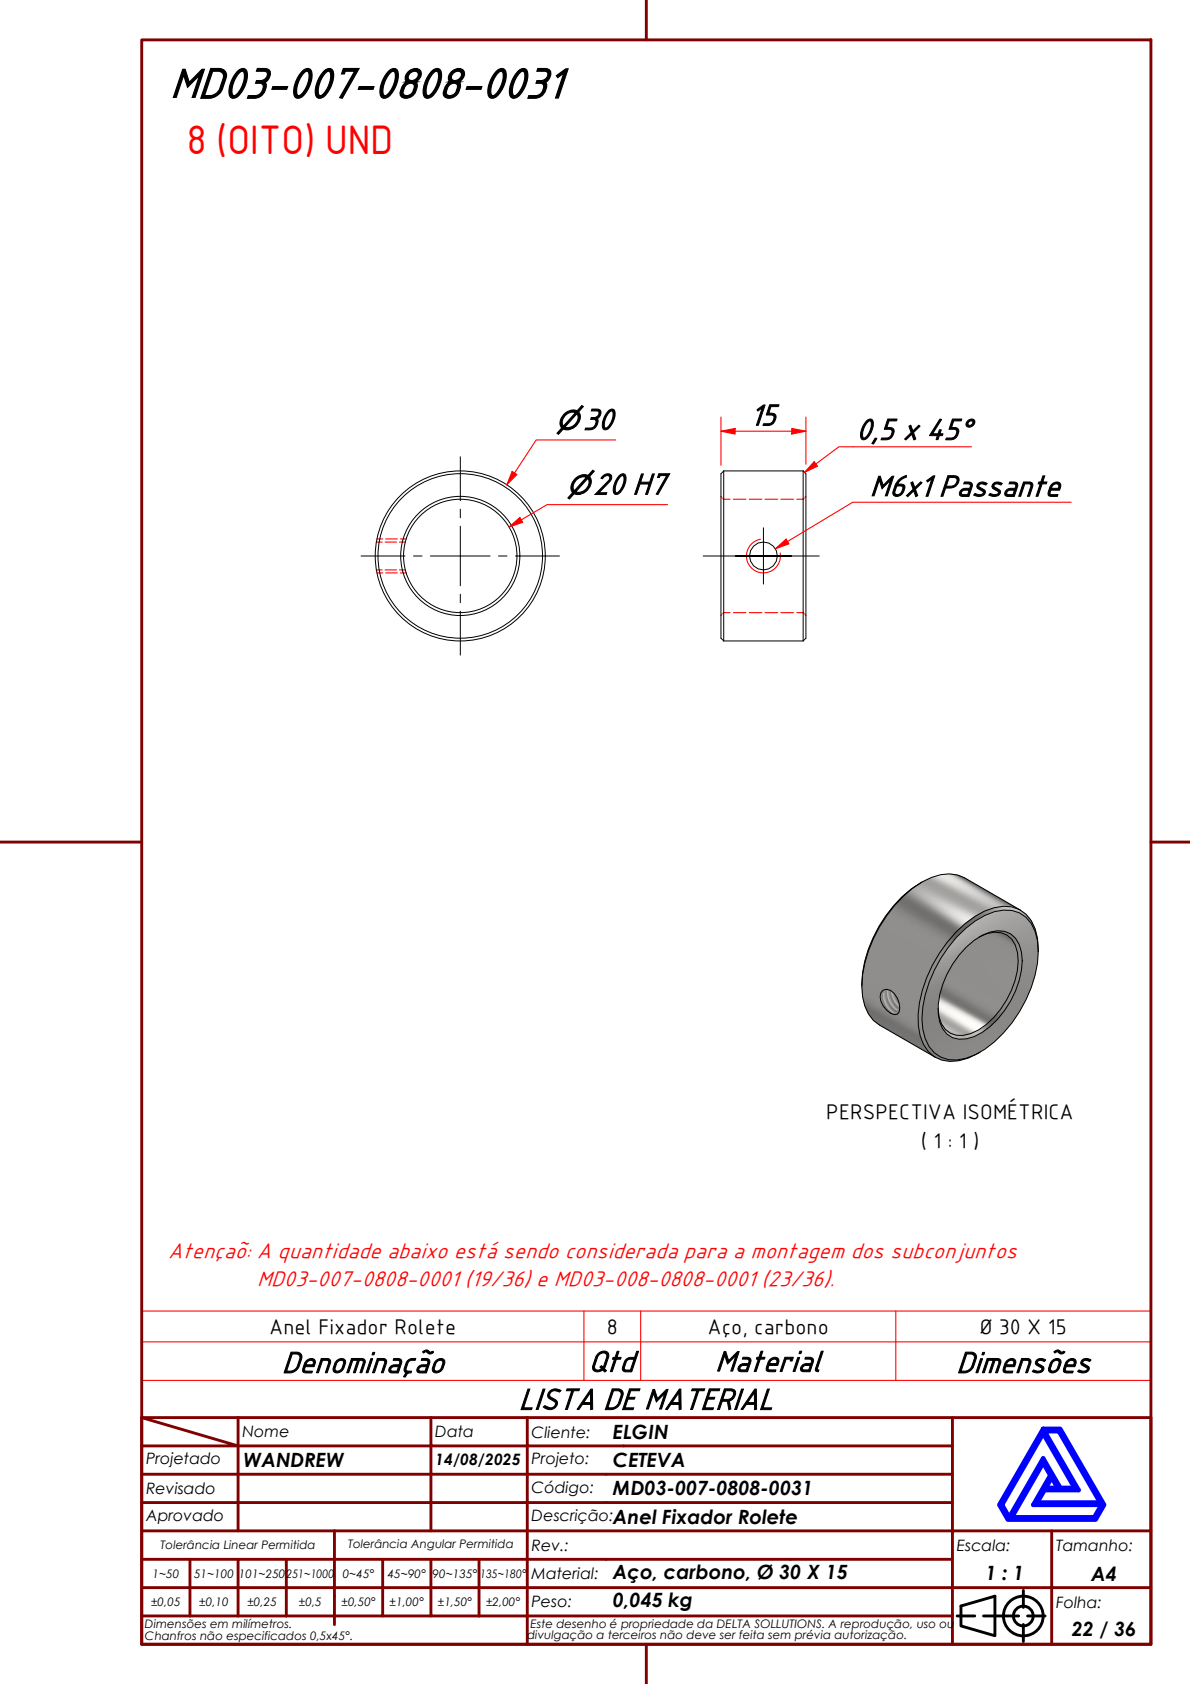
[picture p121: page 1]
PERSPECTIVA ISOMÉTRICA; 8 (OITO) UND; M6x1 Passante

Atençaõ: A quantidade abaixo está sendo considerada para a montagem dos subconjuntos

Anel Fixador Rolete | 8 | Aço, carbono | Ø 30 X 15
Denominação | Qtd | Material | Dimensões

LISTA DE MATERIAL

Projetado | Nome | Data | ELGIN Cliente:

WANDREW | 14/08/2025 | Projeto: CETEVA

Revisado | | | Código: MD03-007-0808-0031

Aprovado | | | Descrição: Anel Fixador Rolete
Tolerância Linear Permitida | Tolerância Angular Permitida | Rev.: | Escala: 1 : 1 | Tamanho: A4

1~50 | 51~100 | 101~250 | 251~1000 | 0~45° | 45~90° | 90~135° 135~180° | | Material: Aço, carbono, Ø 30 X 15
±0,05 | ±0,10 | ±0,25 | ±0,5 | ±0,50° | ±1,00° | ±1,50° | ±2,00° | 0,045 kg Peso: | Folha: 22 / 36

Dimensões em milímetros.

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
