pvrezende/Dashboard/uploads/anexo-1755205000780-339079271.pdf

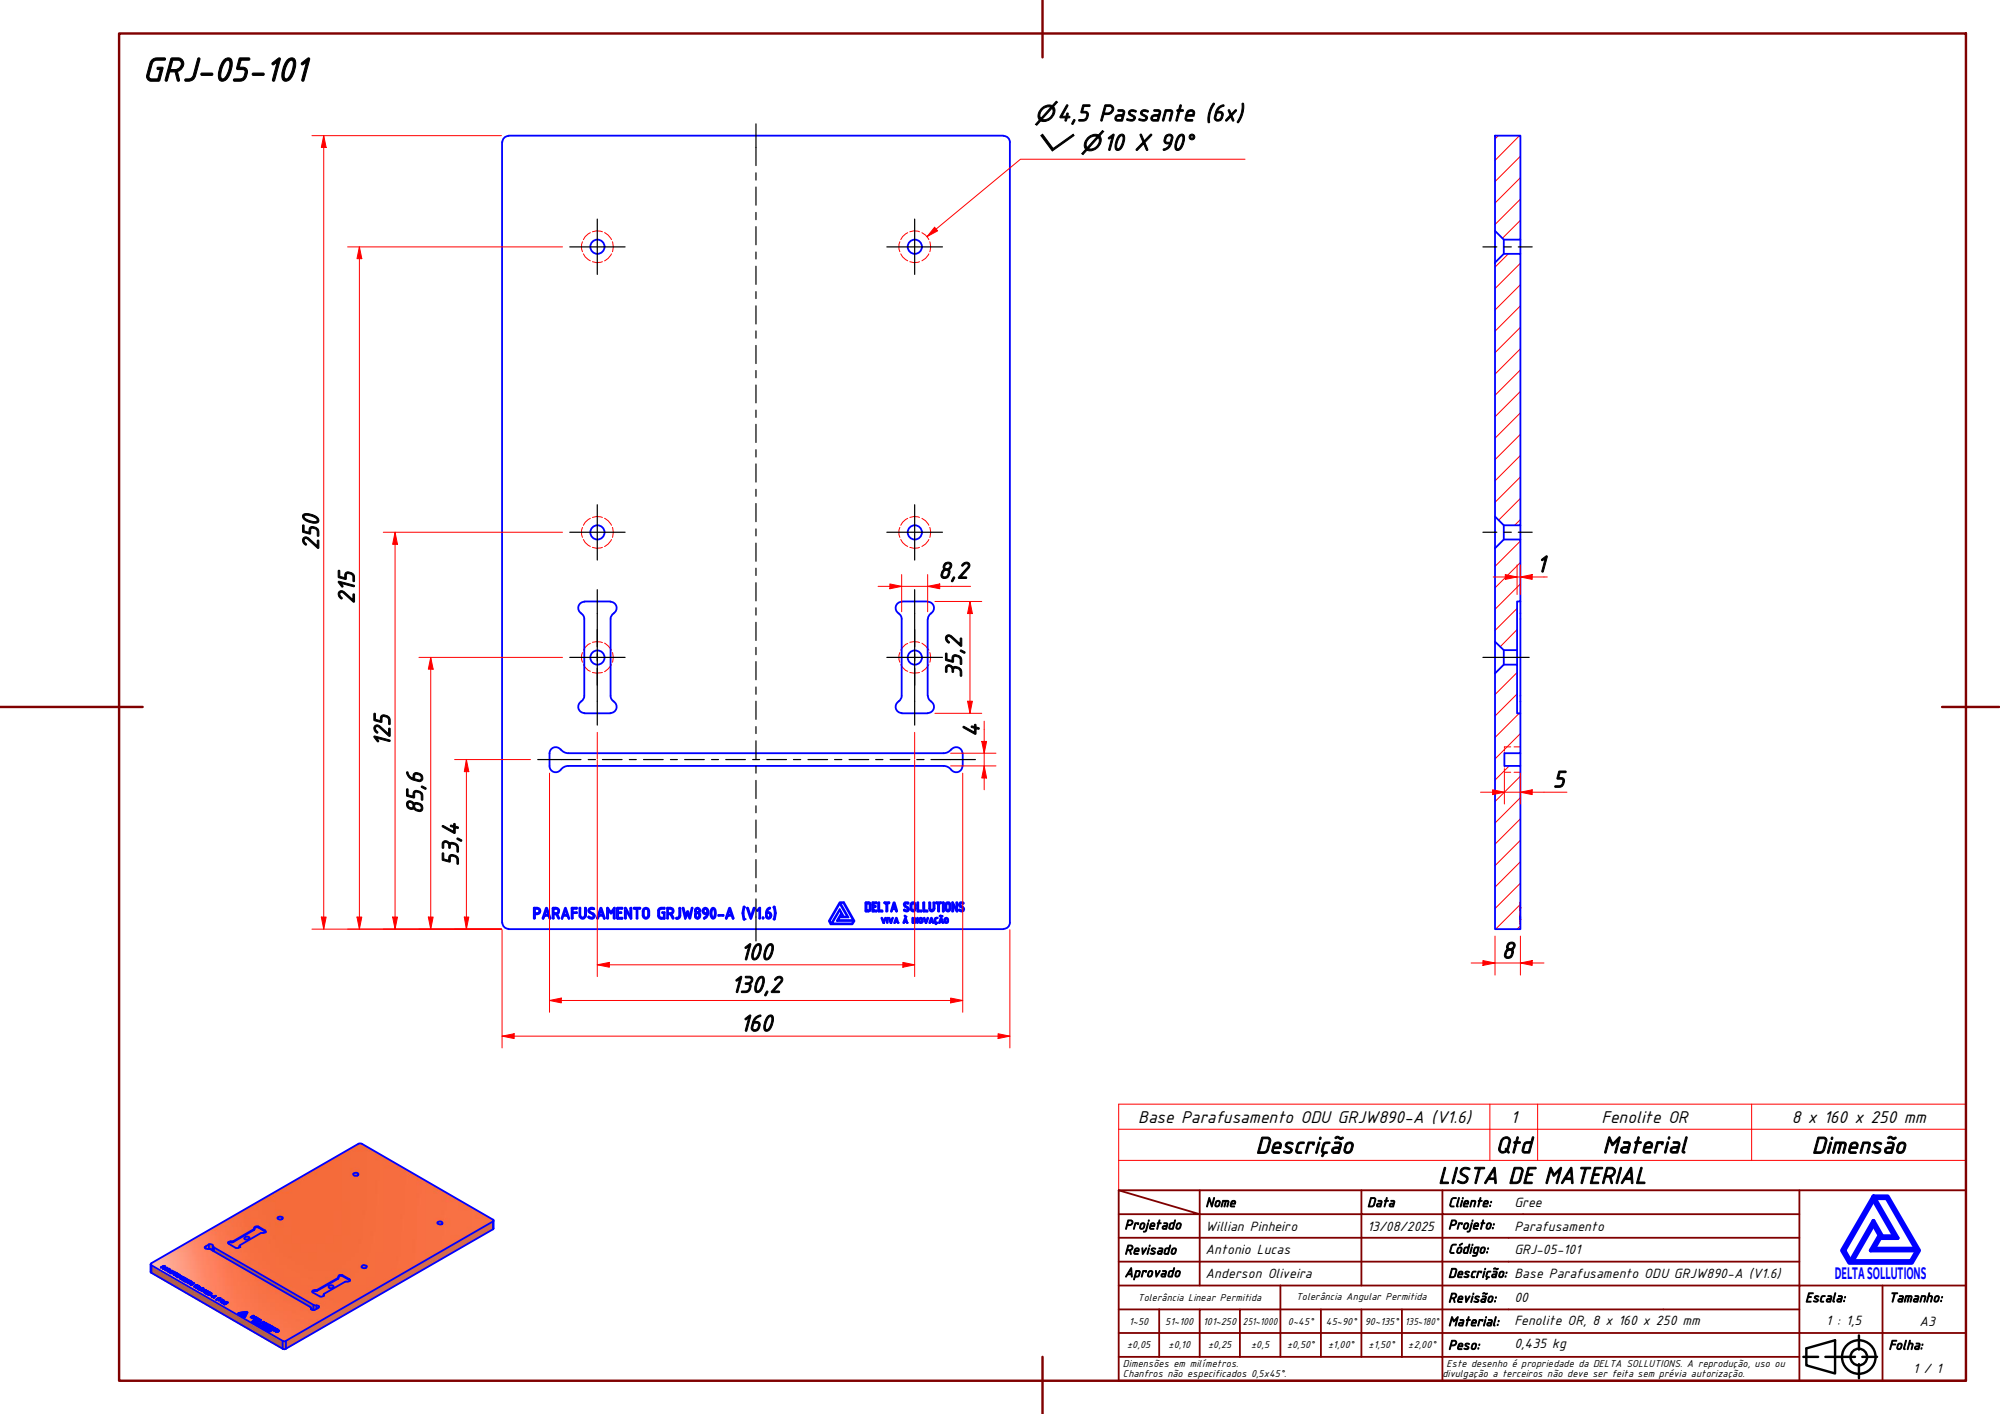
[picture p122: page 1]
⌀ 4,5 Passante (6x) ⌵ ⌀ 10 X 90°

Base Parafusamento ODU GRJW890-A (V1.6) | 1 | Fenolite OR | 8 x 160 x 250 mm

Descrição | Qtd | Material | Dimensão

LISTA DE MATERIAL

Projetado | Nome | Data | Cliente: Gree | | DELTA SOLLUTIONS

Willian Pinheiro | 13/08/2025 | Projeto: Parafusamento

Revisado | Antonio Lucas | | Código: GRJ-05-101

Aprovado | Anderson Oliveira | | Descrição: Base Parafusamento ODU GRJW890-A (V1.6)

Tolerância Linear Permitida | Tolerância Angular Permitida | Revisão: 00 | Escala: 1 : 1,5 | Tamanho: A3

1~50 | 51~100 | 101~250 | 251~1000 | 0~45° | 45~90° | 90~135° | 135~180° | Material: Fenolite OR, 8 x 160 x 250 mm

±0,05 | ±0,10 | ±0,25 | ±0,5 | ±0,50° | ±1,00° | ±1,50° | ±2,00° | Peso: 0,435 kg | Folha: 1 / 1

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
