pvrezende/Dashboard/uploads/anexo-1755206580162-498938564.pdf

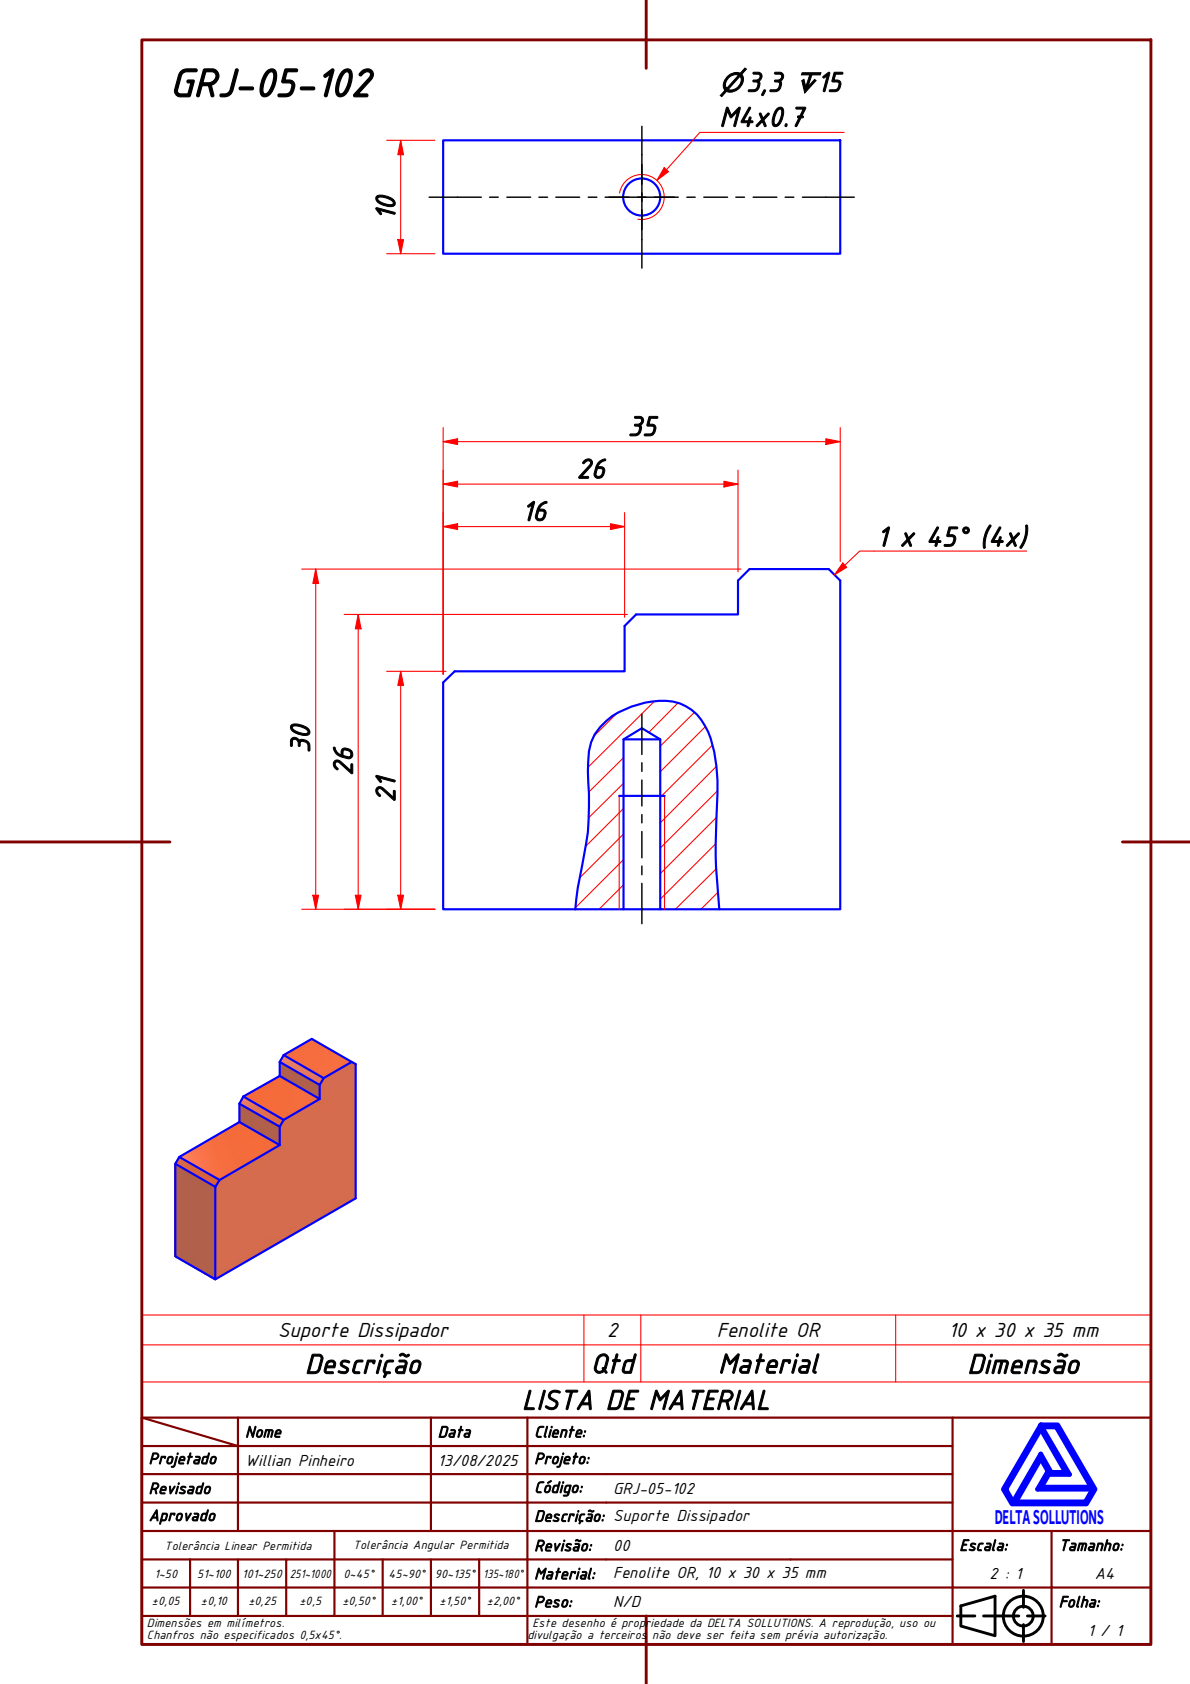
[picture p123: page 1]

Suporte Dissipador | 2 | Fenolite OR | 10 x 30 x 35 mm
Descrição | Qtd | Material | Dimensão

LISTA DE MATERIAL

Projetado | Nome | Data | Cliente: | | DELTA SOLLUTIONS

Willian Pinheiro | 13/08/2025 | Projeto:

Revisado | | | Código: GRJ-05-102

Aprovado | | | Descrição: Suporte Dissipador

Tolerância Linear Permitida | Tolerância Angular Permitida | Revisão: 00 | Escala: 2 : 1 | Tamanho: A4

1~50 | 51~100 | 101~250 | 251~1000 | 0~45° | 45~90° | 90~135° | 135~180° | Material: Fenolite OR, 10 x 30 x 35 mm

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
