pvrezende/Dashboard/uploads/anexo-1755206600350-181854117.pdf

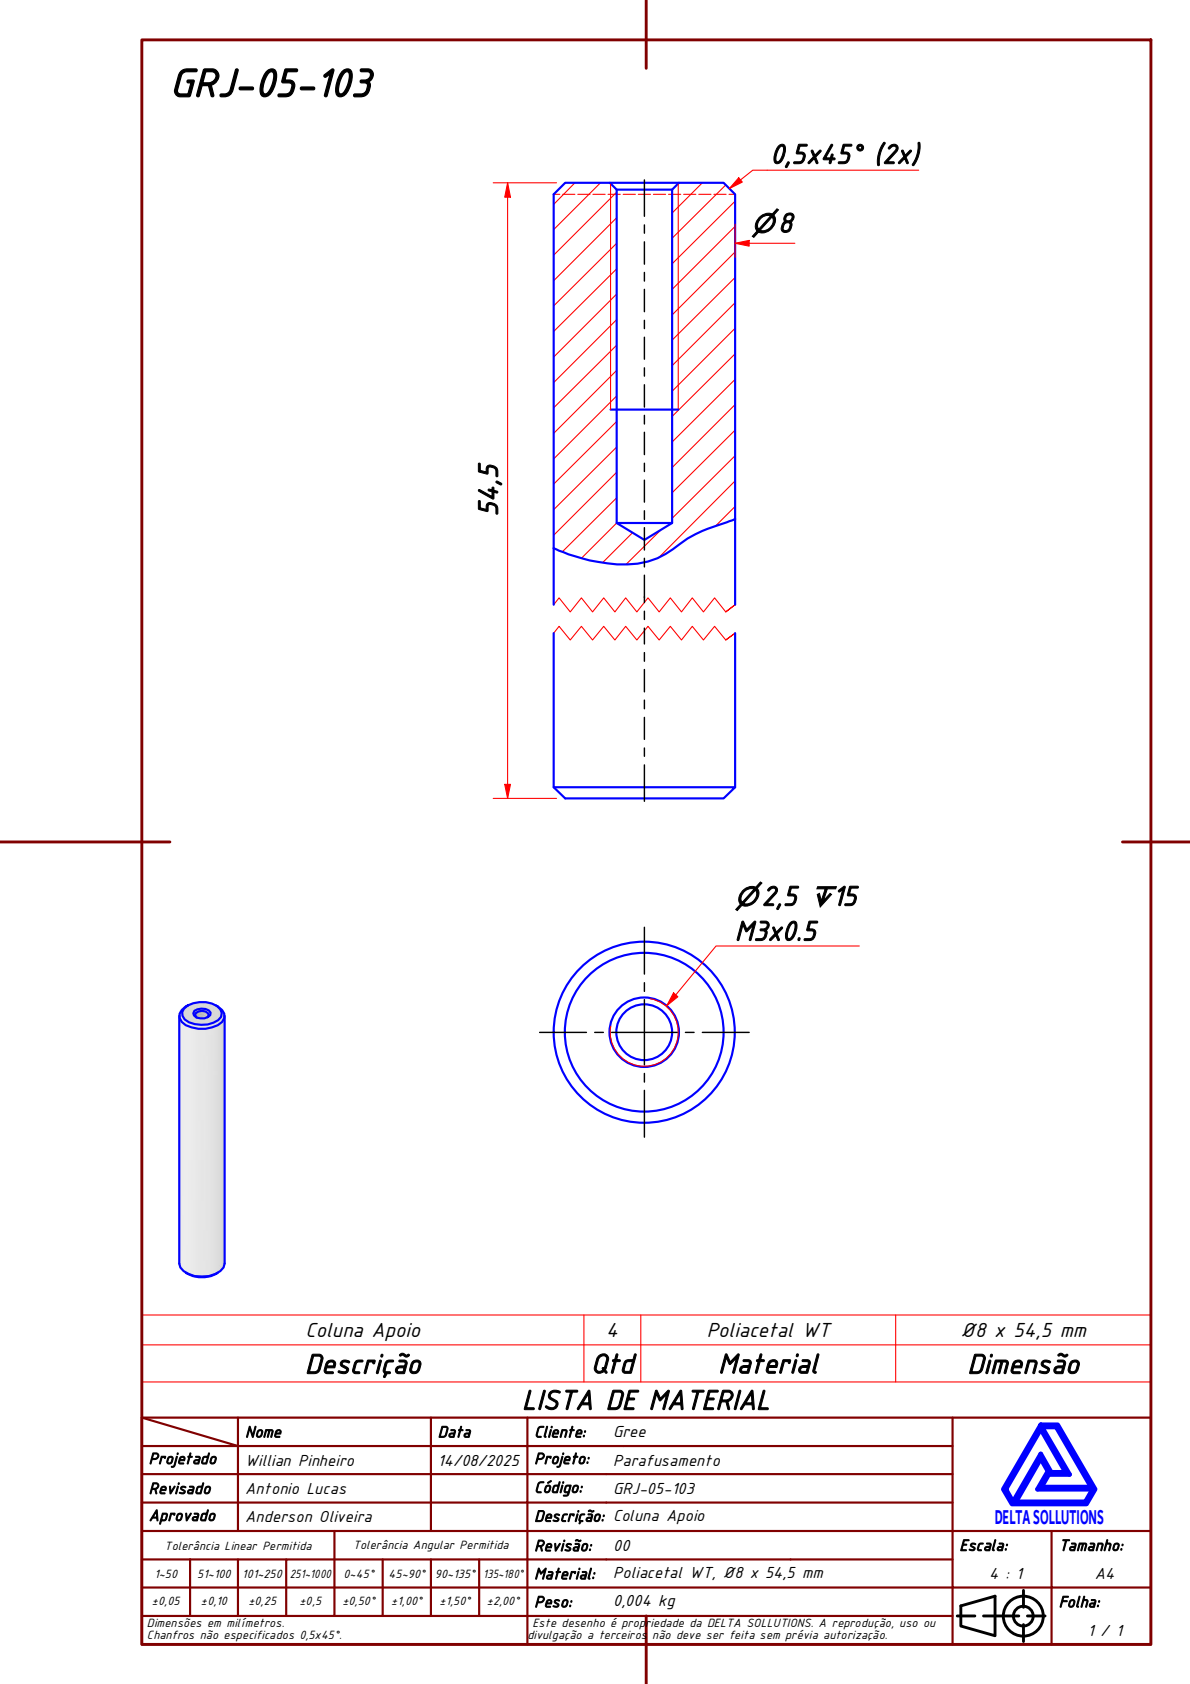
[picture p124: page 1]

Coluna Apoio | 4 | Poliacetal WT | Ø8 x 54,5 mm
Descrição | Qtd | Material | Dimensão

LISTA DE MATERIAL

Projetado | Nome | Data | Cliente: Gree | | DELTA SOLLUTIONS

Willian Pinheiro | 14/08/2025 | Projeto: Parafusamento

Revisado | Antonio Lucas | | Código: GRJ-05-103

Aprovado | Anderson Oliveira | | Descrição: Coluna Apoio

Tolerância Linear Permitida | Tolerância Angular Permitida | Revisão: 00 | Escala: 4 : 1 | Tamanho: A4

1~50 | 51~100 | 101~250 | 251~1000 | 0~45° | 45~90° | 90~135° | 135~180° | Material: Poliacetal WT, Ø8 x 54,5 mm

±0,05 | ±0,10 | ±0,25 | ±0,5 | ±0,50° | ±1,00° | ±1,50° | ±2,00° | Peso: 0,004 kg | Folha: 1 / 1

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
