pvrezende/Dashboard/uploads/anexo-1755207531590-808838062.pdf

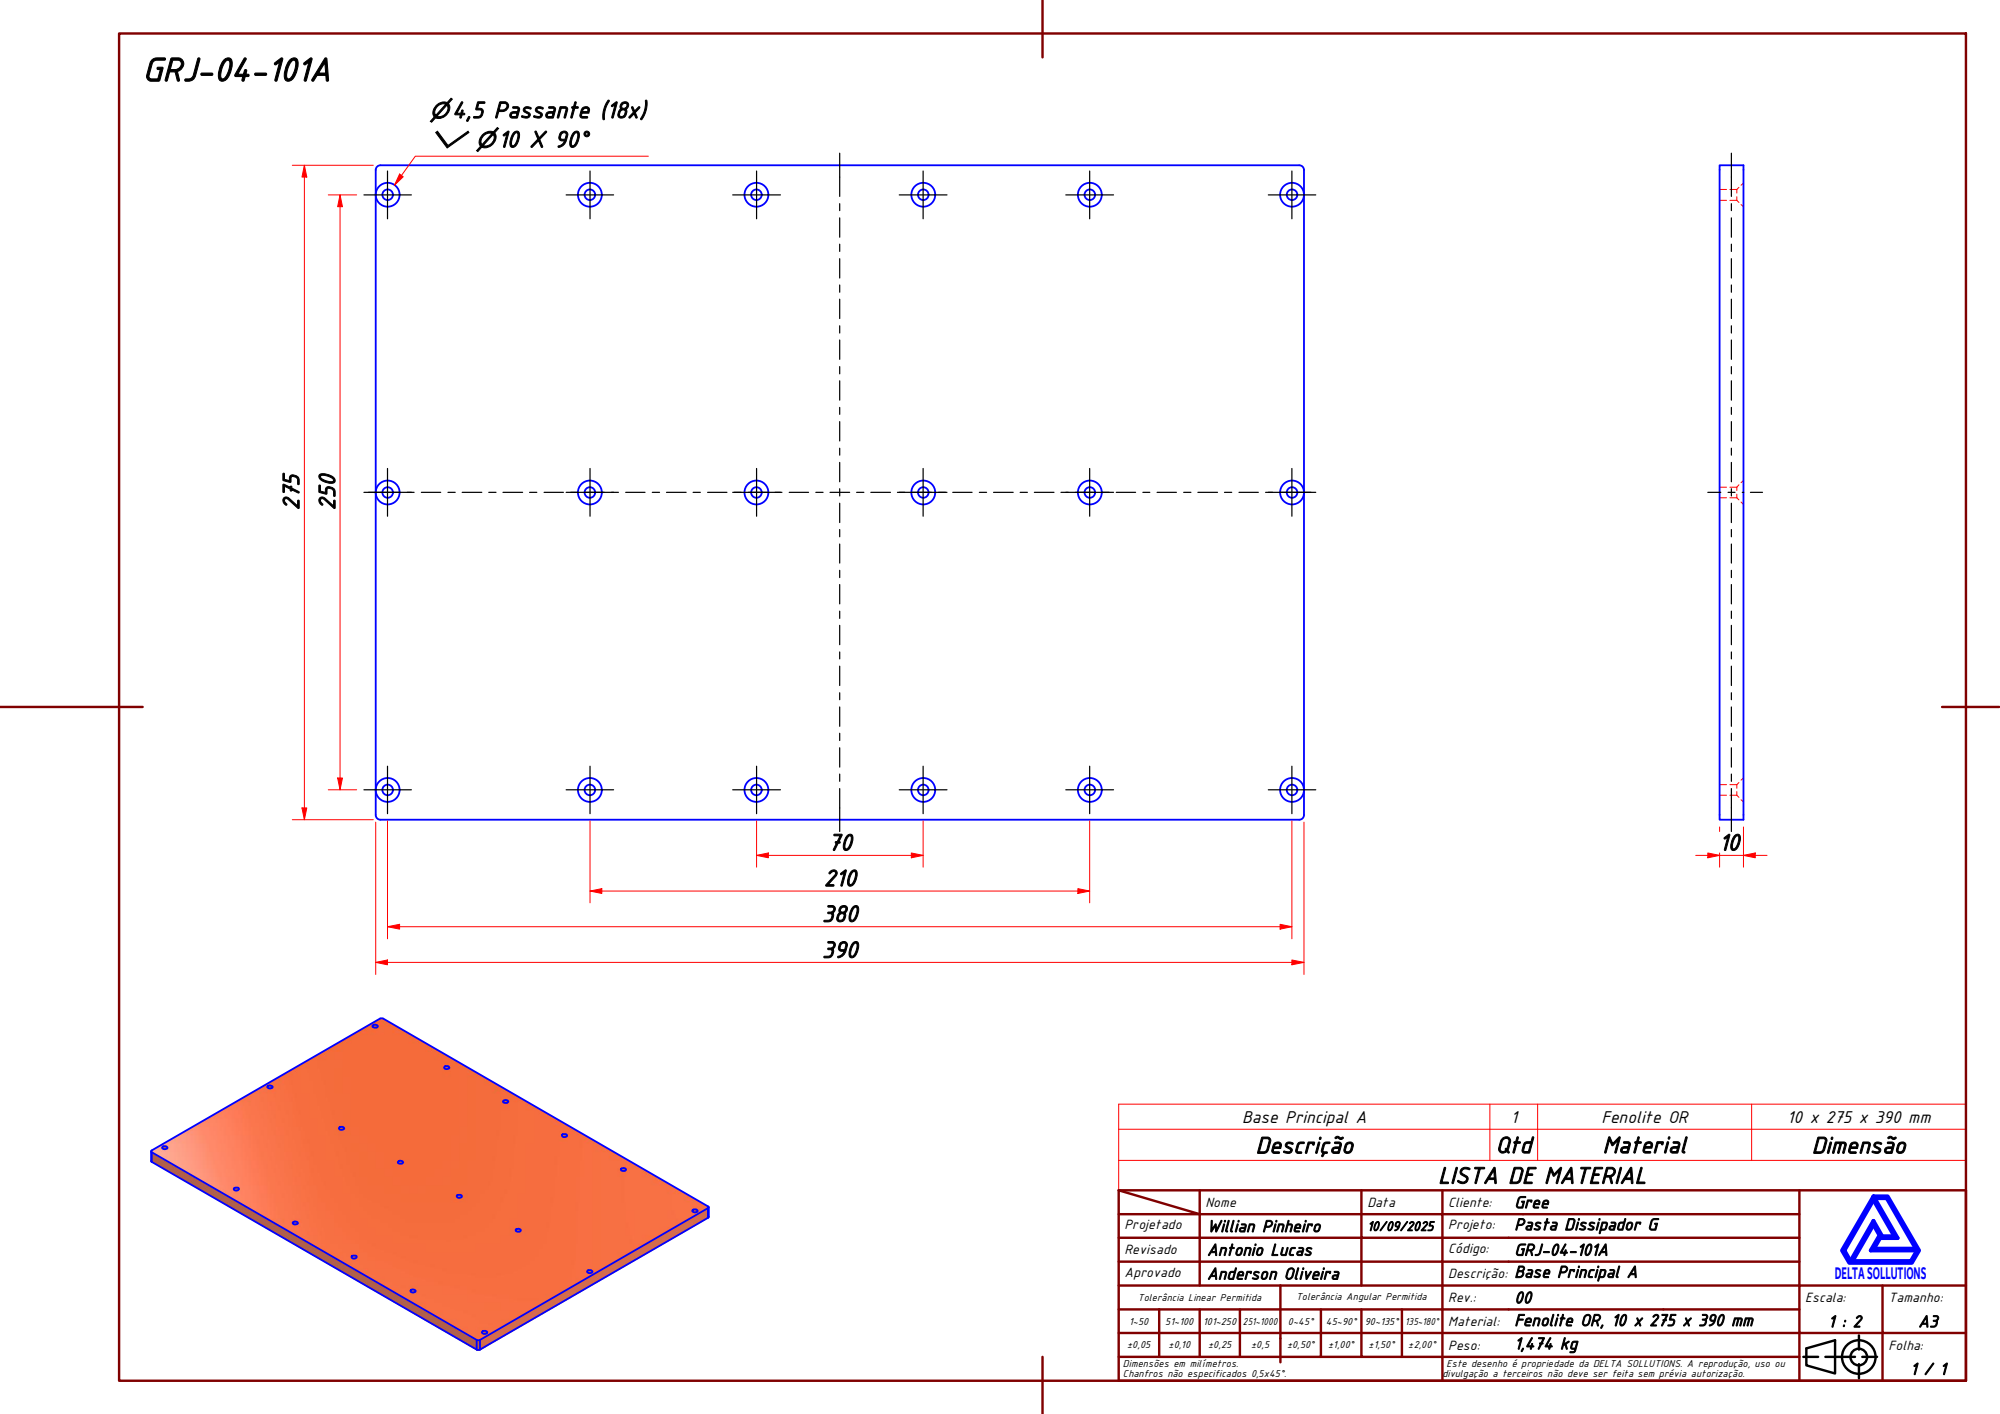
[picture p125: page 1]
⌀ 4,5 Passante (18x) ⌵ ⌀ 10 X 90°

Base Principal A | 1 | Fenolite OR | 10 x 275 x 390 mm
Descrição | Qtd | Material | Dimensão

LISTA DE MATERIAL

Projetado | Nome | Data | Gree Cliente: | | DELTA SOLLUTIONS

Willian Pinheiro | 10/09/2025 | Projeto: Pasta Dissipador G

Revisado | Antonio Lucas | | Código: GRJ-04-101A

Aprovado | Anderson Oliveira | | Base Principal A Descrição:
Tolerância Linear Permitida | Tolerância Angular Permitida | Rev.: 00 | Escala: 1 : 2 | Tamanho: A3

1~50 | 51~100 | 101~250 | 251~1000 | 0~45° | 45~90° | 90~135° | 135~180° | Material: Fenolite OR, 10 x 275 x 390 mm

±0,05 | ±0,10 | ±0,25 | ±0,5 | ±0,50° | ±1,00° | ±1,50° | ±2,00° | Peso: 1,474 kg | Folha: 1 / 1

Dimensões em milímetros.

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
