pvrezende/Dashboard/uploads/anexo-1755207672185-721261515.pdf

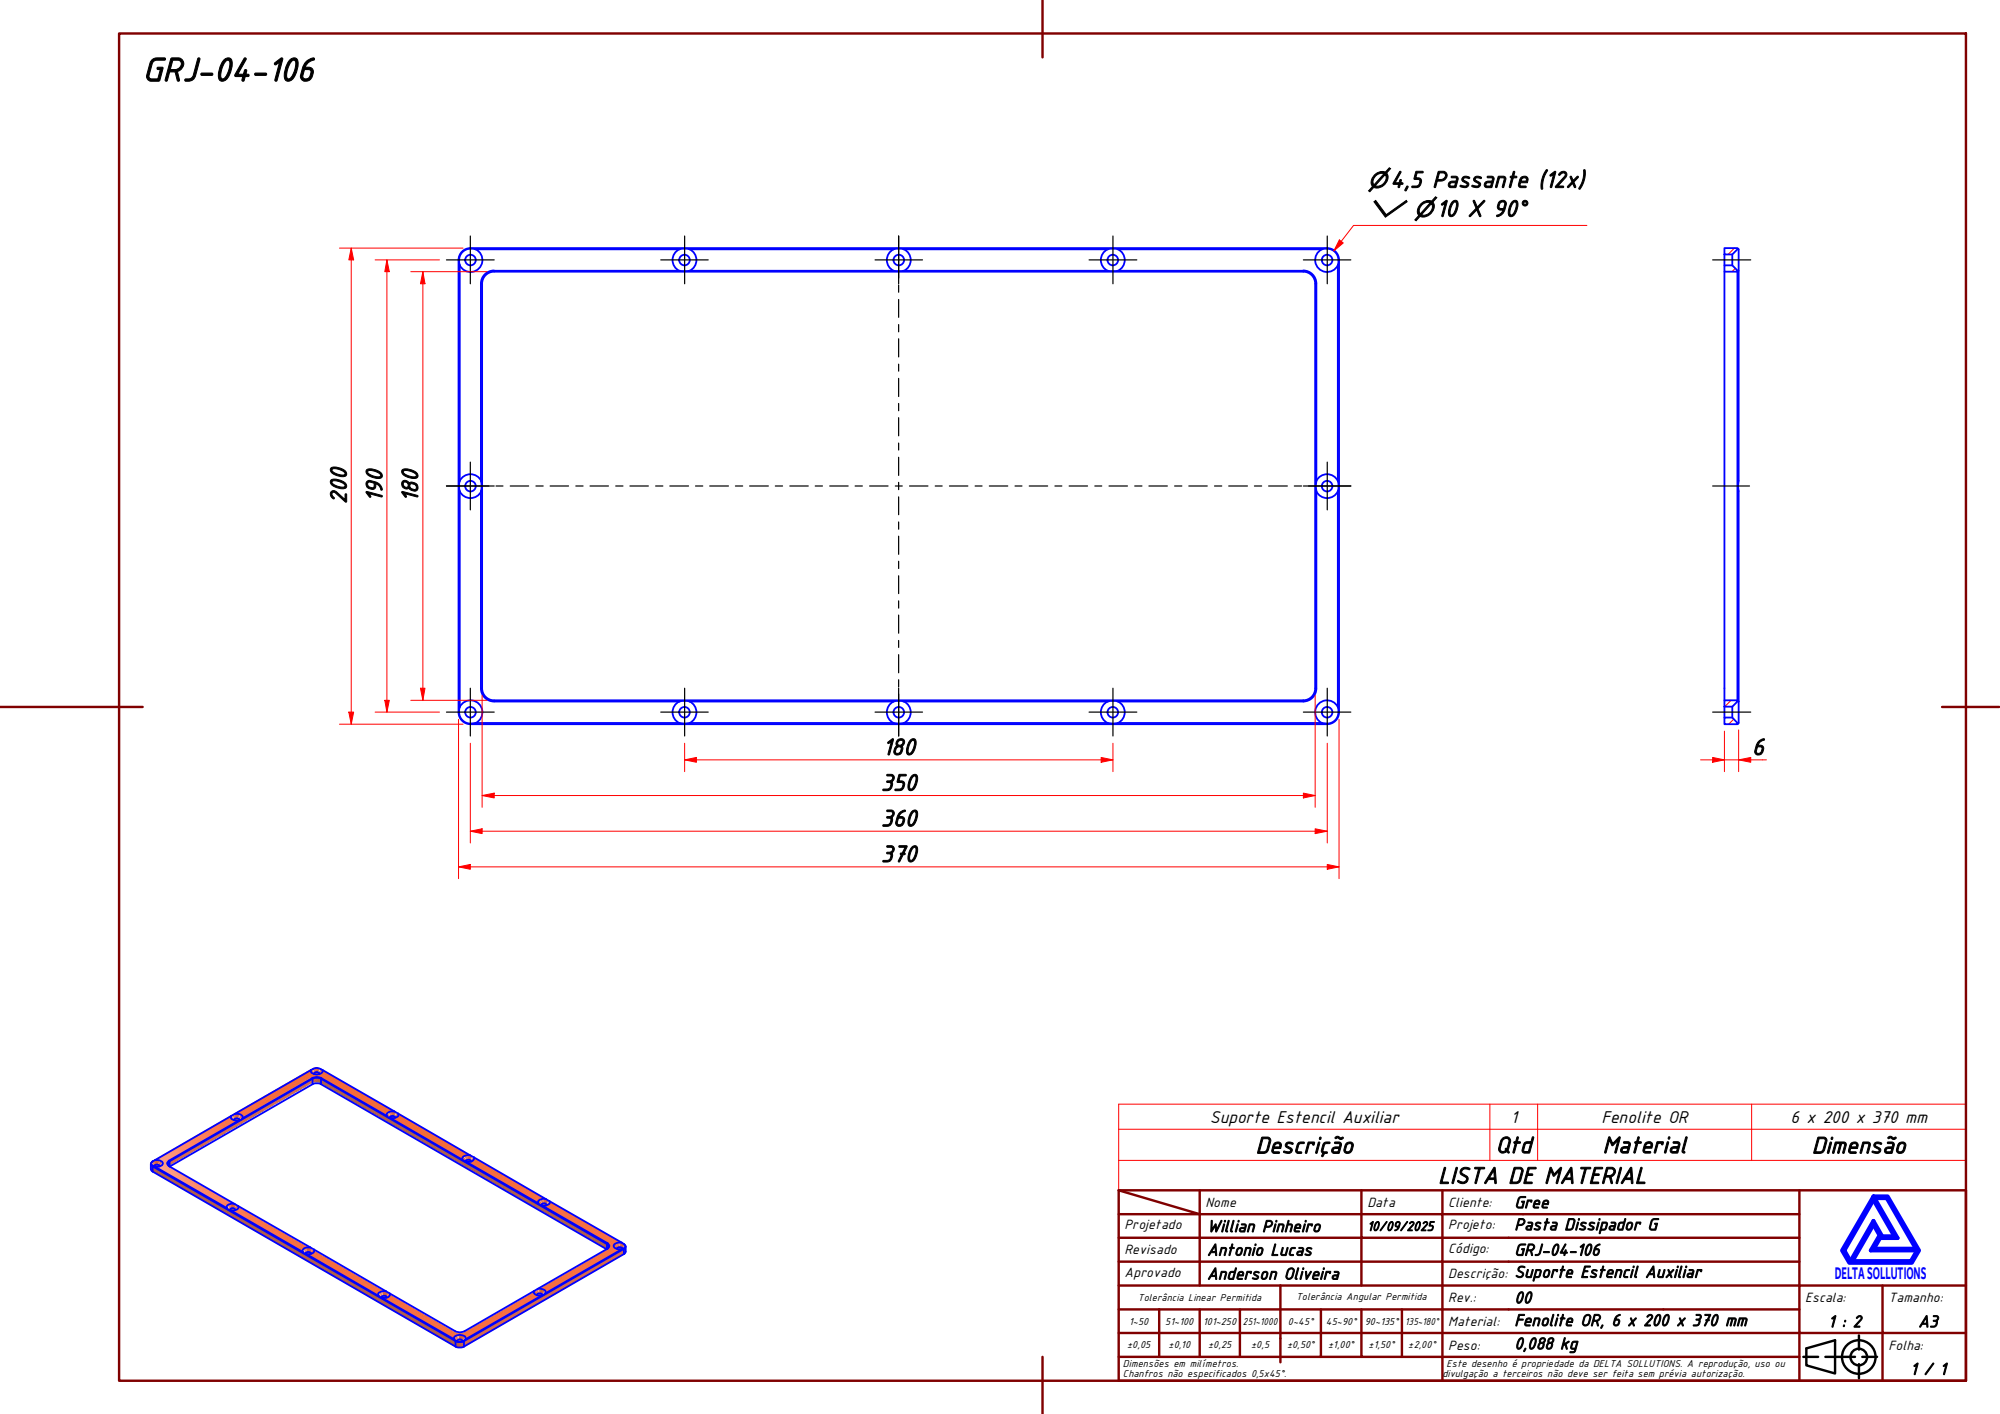
[picture p128: page 1]
⌀ 4,5 Passante (12x) ⌵ ⌀ 10 X 90°

Suporte Estencil Auxiliar | 1 | Fenolite OR | 6 x 200 x 370 mm
Descrição | Qtd | Material | Dimensão

LISTA DE MATERIAL

Projetado | Nome | Data | Gree Cliente: | | DELTA SOLLUTIONS

Willian Pinheiro | 10/09/2025 | Projeto: Pasta Dissipador G

Revisado | Antonio Lucas | | Código: GRJ-04-106

Aprovado | Anderson Oliveira | | Suporte Estencil Auxiliar Descrição:
Tolerância Linear Permitida | Tolerância Angular Permitida | Rev.: 00 | Escala: 1 : 2 | Tamanho: A3

1~50 | 51~100 | 101~250 | 251~1000 | 0~45° | 45~90° | 90~135° | 135~180° | Material: Fenolite OR, 6 x 200 x 370 mm

±0,05 | ±0,10 | ±0,25 | ±0,5 | ±0,50° | ±1,00° | ±1,50° | ±2,00° | Peso: 0,088 kg | Folha: 1 / 1

Dimensões em milímetros.

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
