pvrezende/Dashboard/uploads/anexo-1755207735695-363101173.pdf

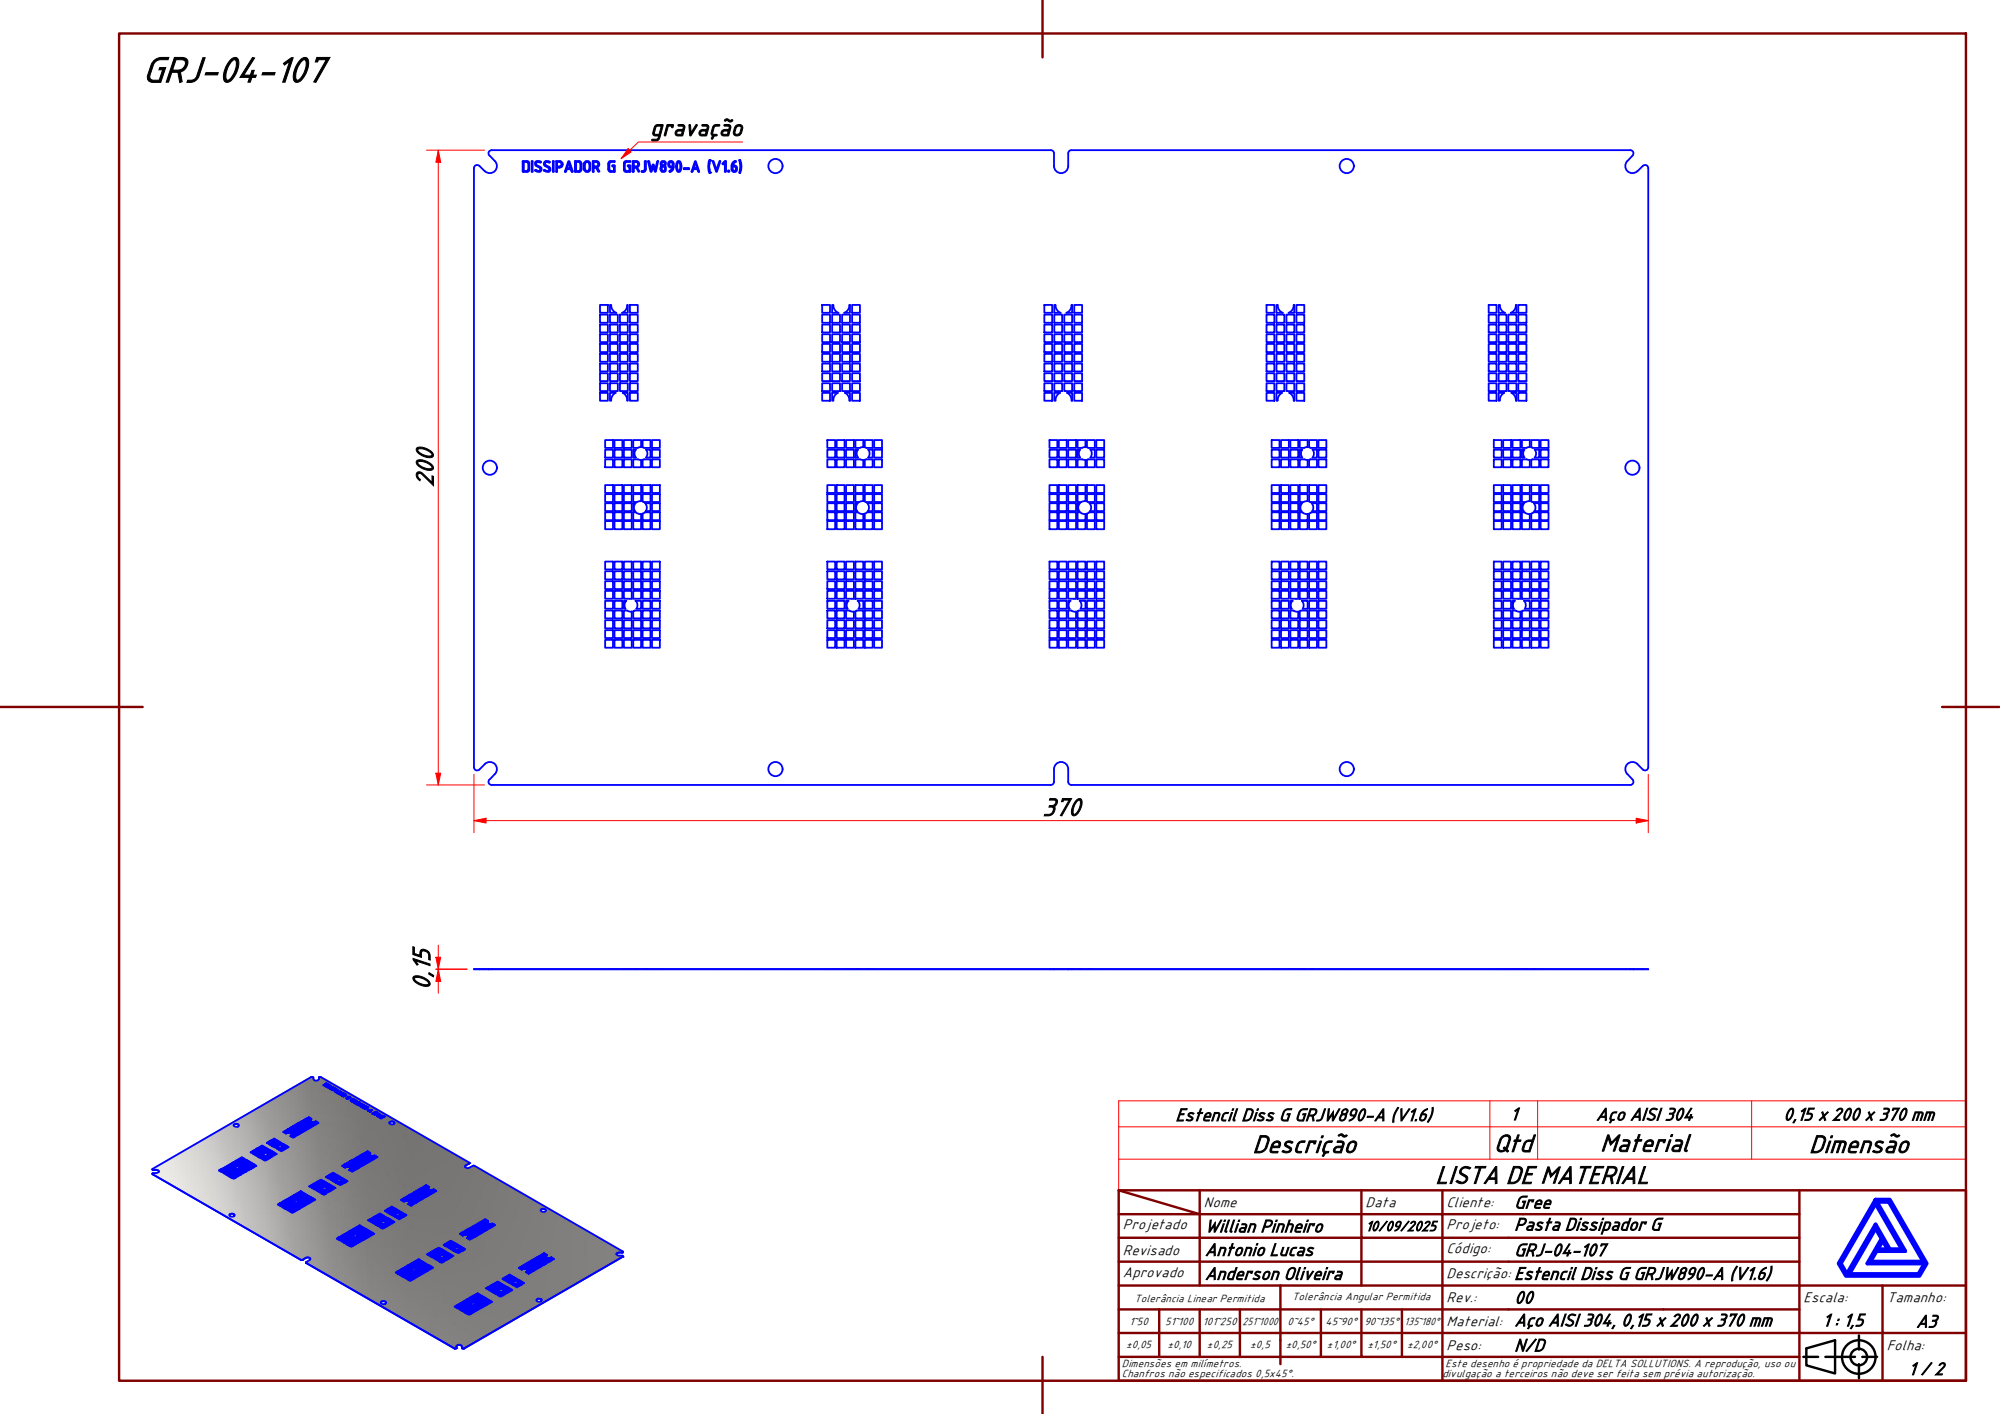
[picture p129: page 1]

Estencil Diss G GRJW890-A (V1.6) | 1 | Aço AISI 304 | 0,15 x 200 x 370 mm

Descrição | Qtd | Material | Dimensão

LISTA DE MATERIAL

Projetado | Nome | Data | Cliente: Gree

Willian Pinheiro | 10/09/2025 | Projeto: Pasta Dissipador G

Revisado | Antonio Lucas | | Código: GRJ-04-107
Aprovado | Anderson Oliveira | | Estencil Diss G GRJW890-A (V1.6) Descrição:
Tolerância Linear Permitida | Tolerância Angular Permitida | Rev.: 00 | Escala: 1 : 1,5 | Tamanho: A3

1~50 | 51~100 | 101~250 | 251~1000 | 0~45° | 45~90° | 90~135° 135~180° | | Material: Aço AISI 304, 0,15 x 200 x 370 mm
±0,05 | ±0,10 | ±0,25 | ±0,5 | ±0,50° | ±1,00° | ±1,50° | ±2,00° | Peso: N/D | Folha: 1 / 2
Chanfros não especificados 0,5x45°. | | | | | | | | Este desenho é propriedade da DELTA SOLLUTIONS. A reprodução, uso ou divulgação a terceiros não deve ser feita sem prévia autorização.

Dimensões em milímetros.

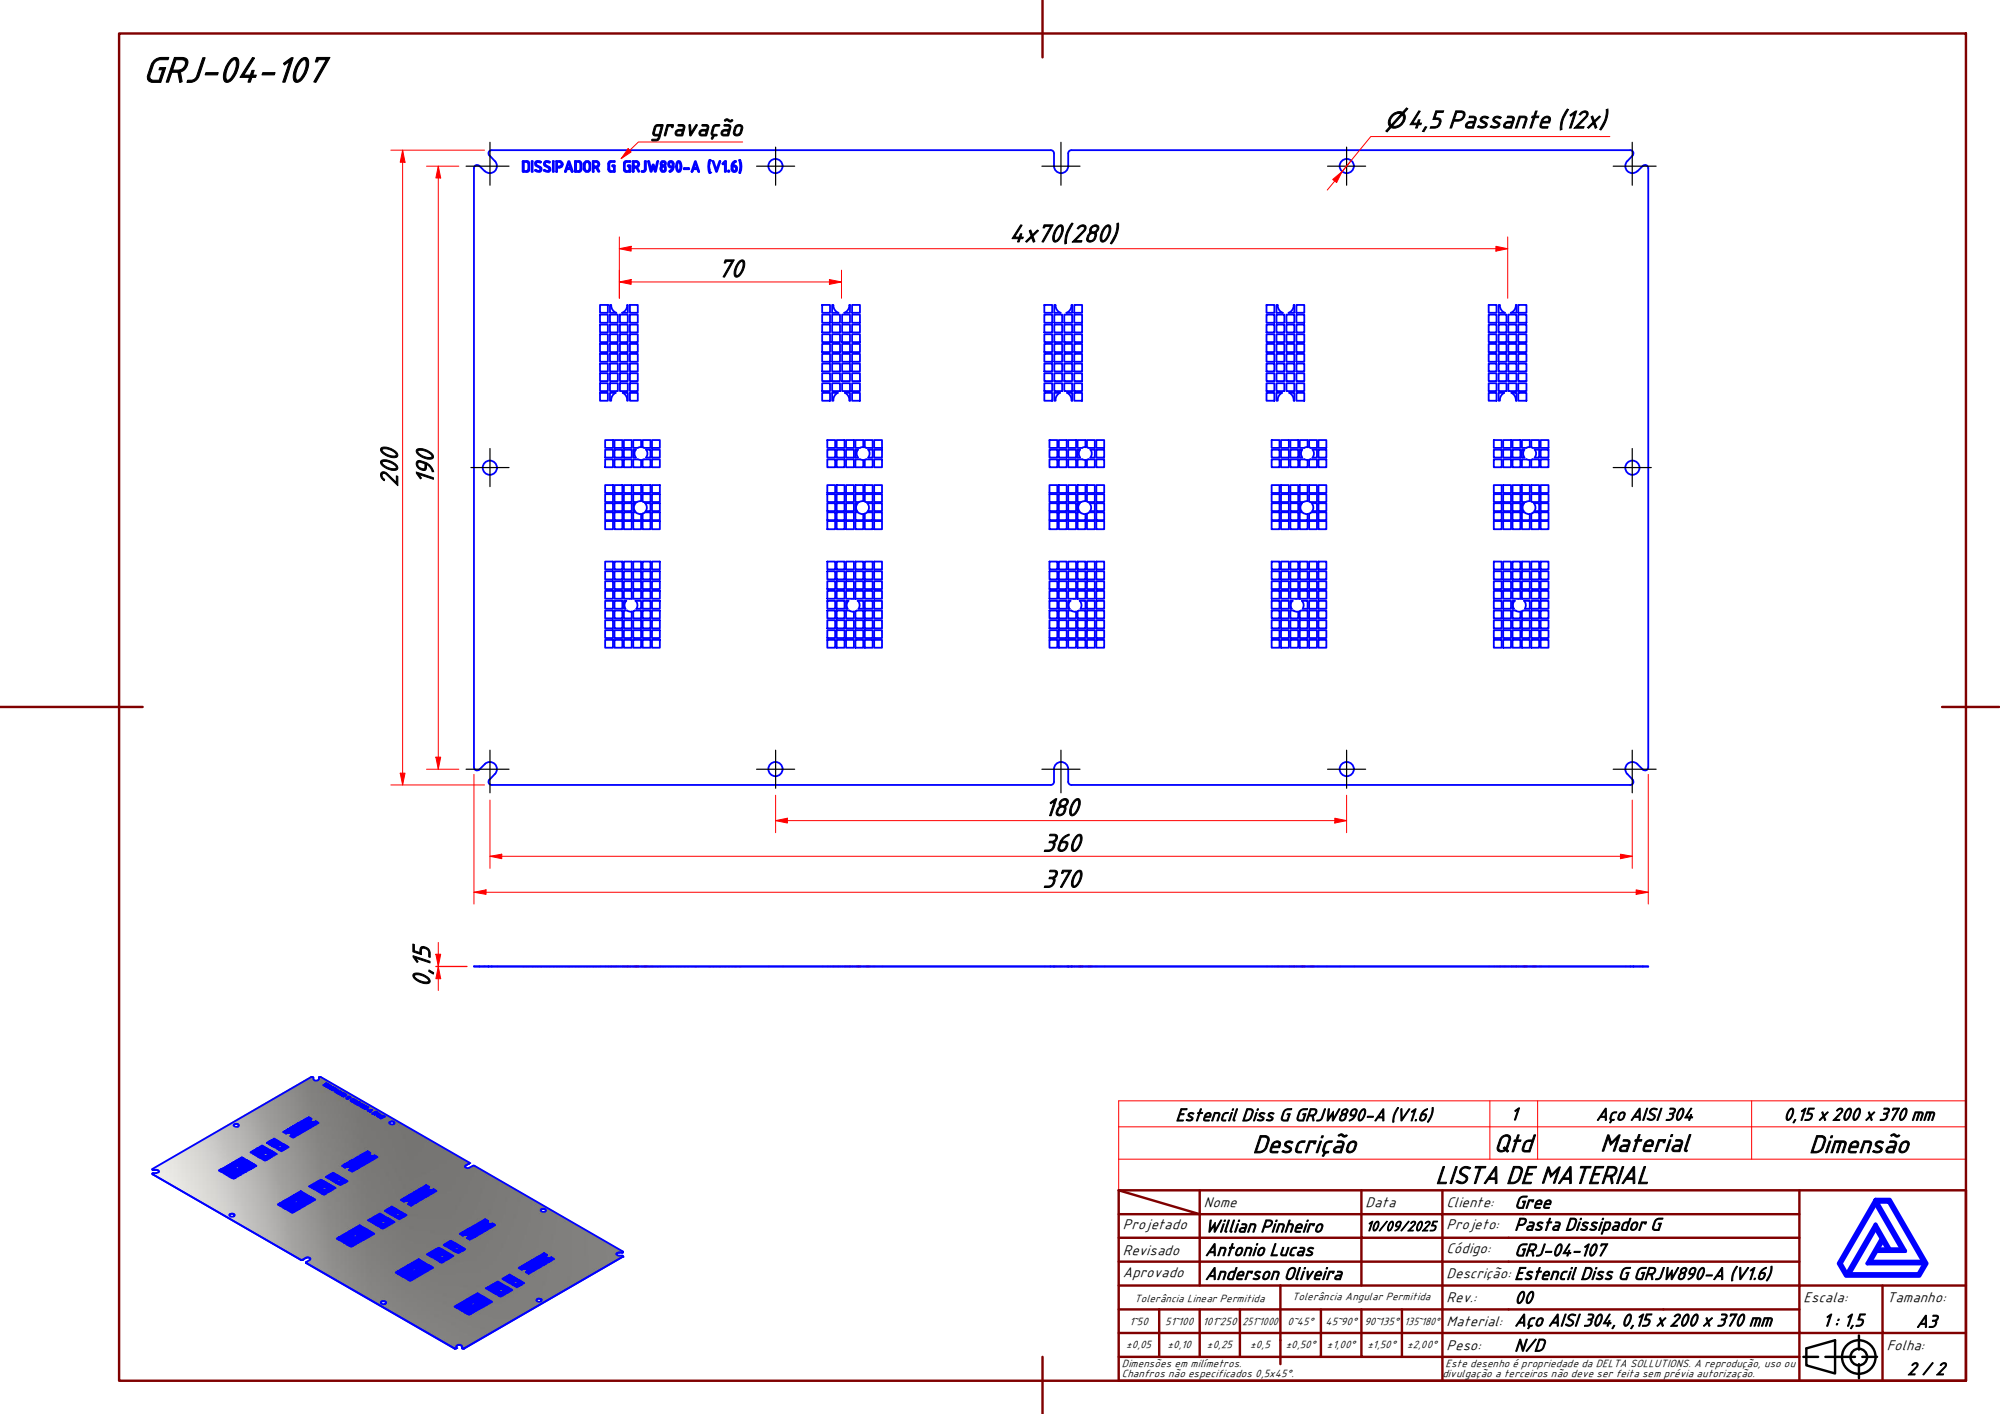
[picture p130: page 2]
⌀ 4,5 Passante (12x)

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

Descrição | Qtd | Material | Dimensão

LISTA DE MATERIAL

Projetado | Nome | Data | Cliente: Gree

Willian Pinheiro | 10/09/2025 | Projeto: Pasta Dissipador G

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

1~50 | 51~100 | 101~250 | 251~1000 | 0~45° | 45~90° | 90~135° 135~180° | | Material: Aço AISI 304, 0,15 x 200 x 370 mm
±0,05 | ±0,10 | ±0,25 | ±0,5 | ±0,50° | ±1,00° | ±1,50° | ±2,00° | Peso: N/D | Folha: 2 / 2
Chanfros não especificados 0,5x45°. | | | | | | | | Este desenho é propriedade da DELTA SOLLUTIONS. A reprodução, uso ou divulgação a terceiros não deve ser feita sem prévia autorização.

Dimensões em milímetros.
