pvrezende/Dashboard/uploads/anexo-1755263926340-187863126.pdf

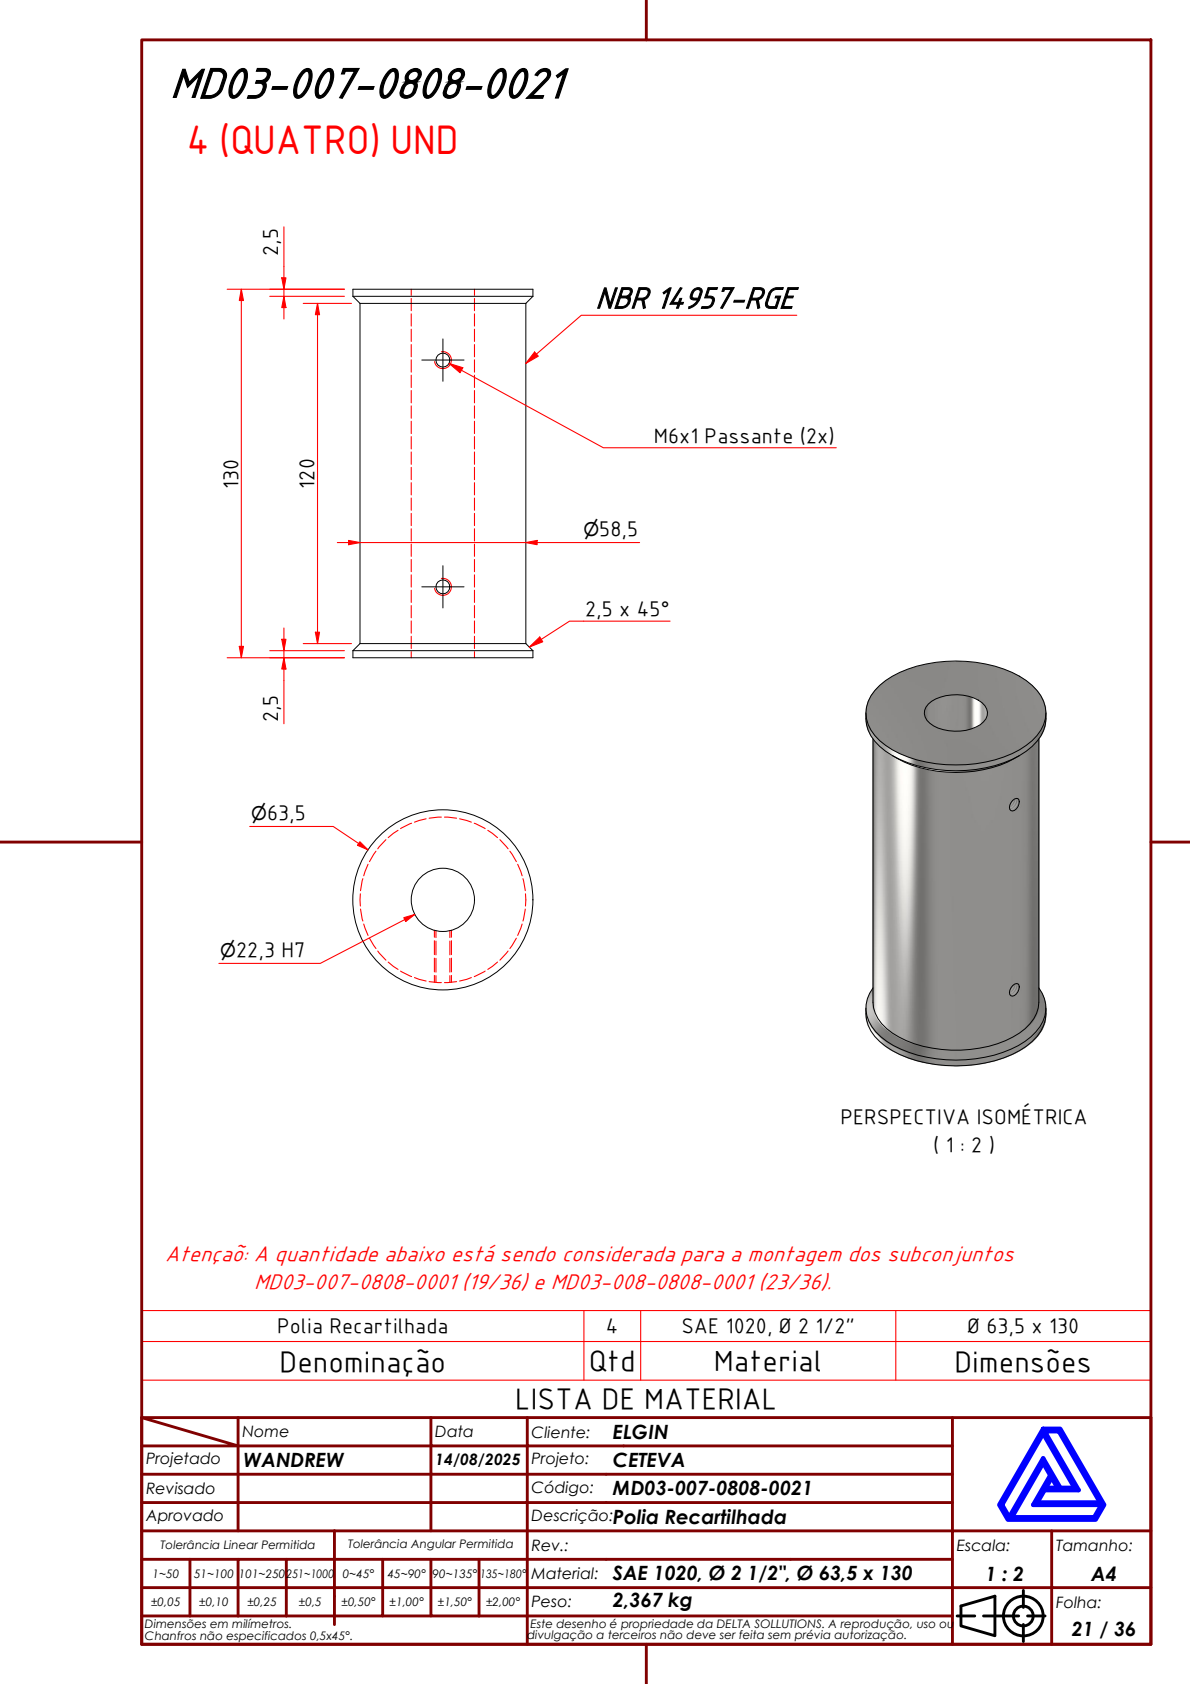
[picture p131: page 1]
PERSPECTIVA ISOMÉTRICA; 4 (QUATRO) UND; M6x1 Passante (2x); NBR 14957-RGE

Atençaõ: A quantidade abaixo está sendo considerada para a montagem dos subconjuntos

Polia Recartilhada | 4 | SAE 1020, Ø 2 1/2" | Ø 63,5 x 130
Denominação | Qtd | Material | Dimensões

LISTA DE MATERIAL

Projetado | Nome | Data | ELGIN Cliente:

WANDREW | 14/08/2025 | Projeto: CETEVA

Revisado | | | Código: MD03-007-0808-0021

Aprovado | | | Descrição: Polia Recartilhada
Tolerância Linear Permitida | Tolerância Angular Permitida | Rev.: | Escala: 1 : 2 | Tamanho: A4

1~50 | 51~100 | 101~250 | 251~1000 | 0~45° | 45~90° | 90~135° 135~180° | | Material: SAE 1020, Ø 2 1/2", Ø 63,5 x 130
±0,05 | ±0,10 | ±0,25 | ±0,5 | ±0,50° | ±1,00° | ±1,50° | ±2,00° | 2,367 kg Peso: | Folha: 21 / 36

Dimensões em milímetros.

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
