pvrezende/Dashboard/uploads/anexo-1755282655961-81065801.pdf

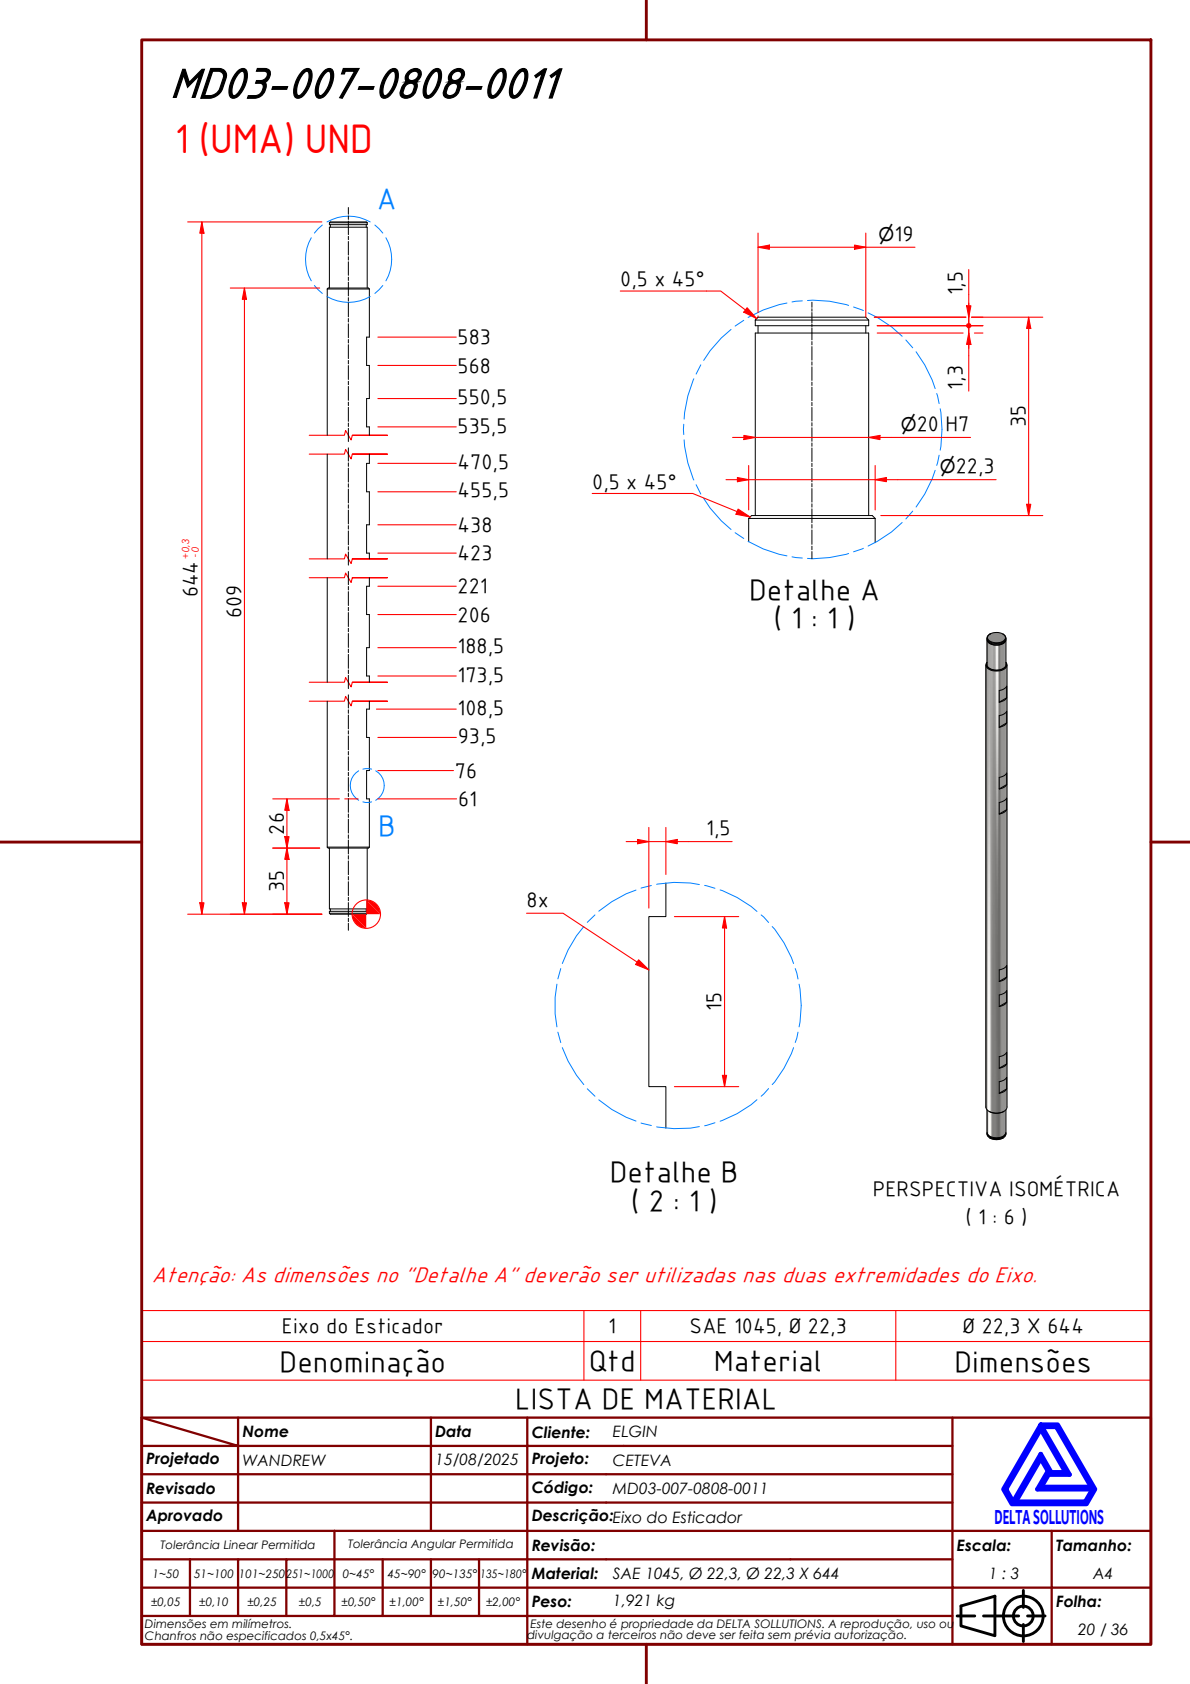
[picture p132: page 1]
PERSPECTIVA ISOMÉTRICA; Detalhe A ( 1 : 1 ); Detalhe B ( 2 : 1 ); 1 (UMA) UND

Atenção: As dimensões no "Detalhe A" deverão ser utilizadas nas duas extremidades do Eixo.

Eixo do Esticador | 1 | SAE 1045, Ø 22,3 | Ø 22,3 X 644
Denominação | Qtd | Material | Dimensões

LISTA DE MATERIAL

Projetado | Nome | Data | Cliente: ELGIN | | DELTA SOLLUTIONS

WANDREW | 15/08/2025 | Projeto: CETEVA

Revisado | | | Código: MD03-007-0808-0011

Aprovado | | | Descrição: Eixo do Esticador

Tolerância Linear Permitida | Tolerância Angular Permitida | Revisão: | Escala: 1 : 3 | Tamanho: A4

1~50 | 51~100 | 101~250 | 251~1000 | 0~45° | 45~90° | 90~135° 135~180° | | Material: SAE 1045, Ø 22,3, Ø 22,3 X 644
±0,05 | ±0,10 | ±0,25 | ±0,5 | ±0,50° | ±1,00° | ±1,50° | ±2,00° | Peso: 1,921 kg | Folha: 20 / 36

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
