pvrezende/Dashboard/uploads/anexo-1755283943849-80767861.pdf

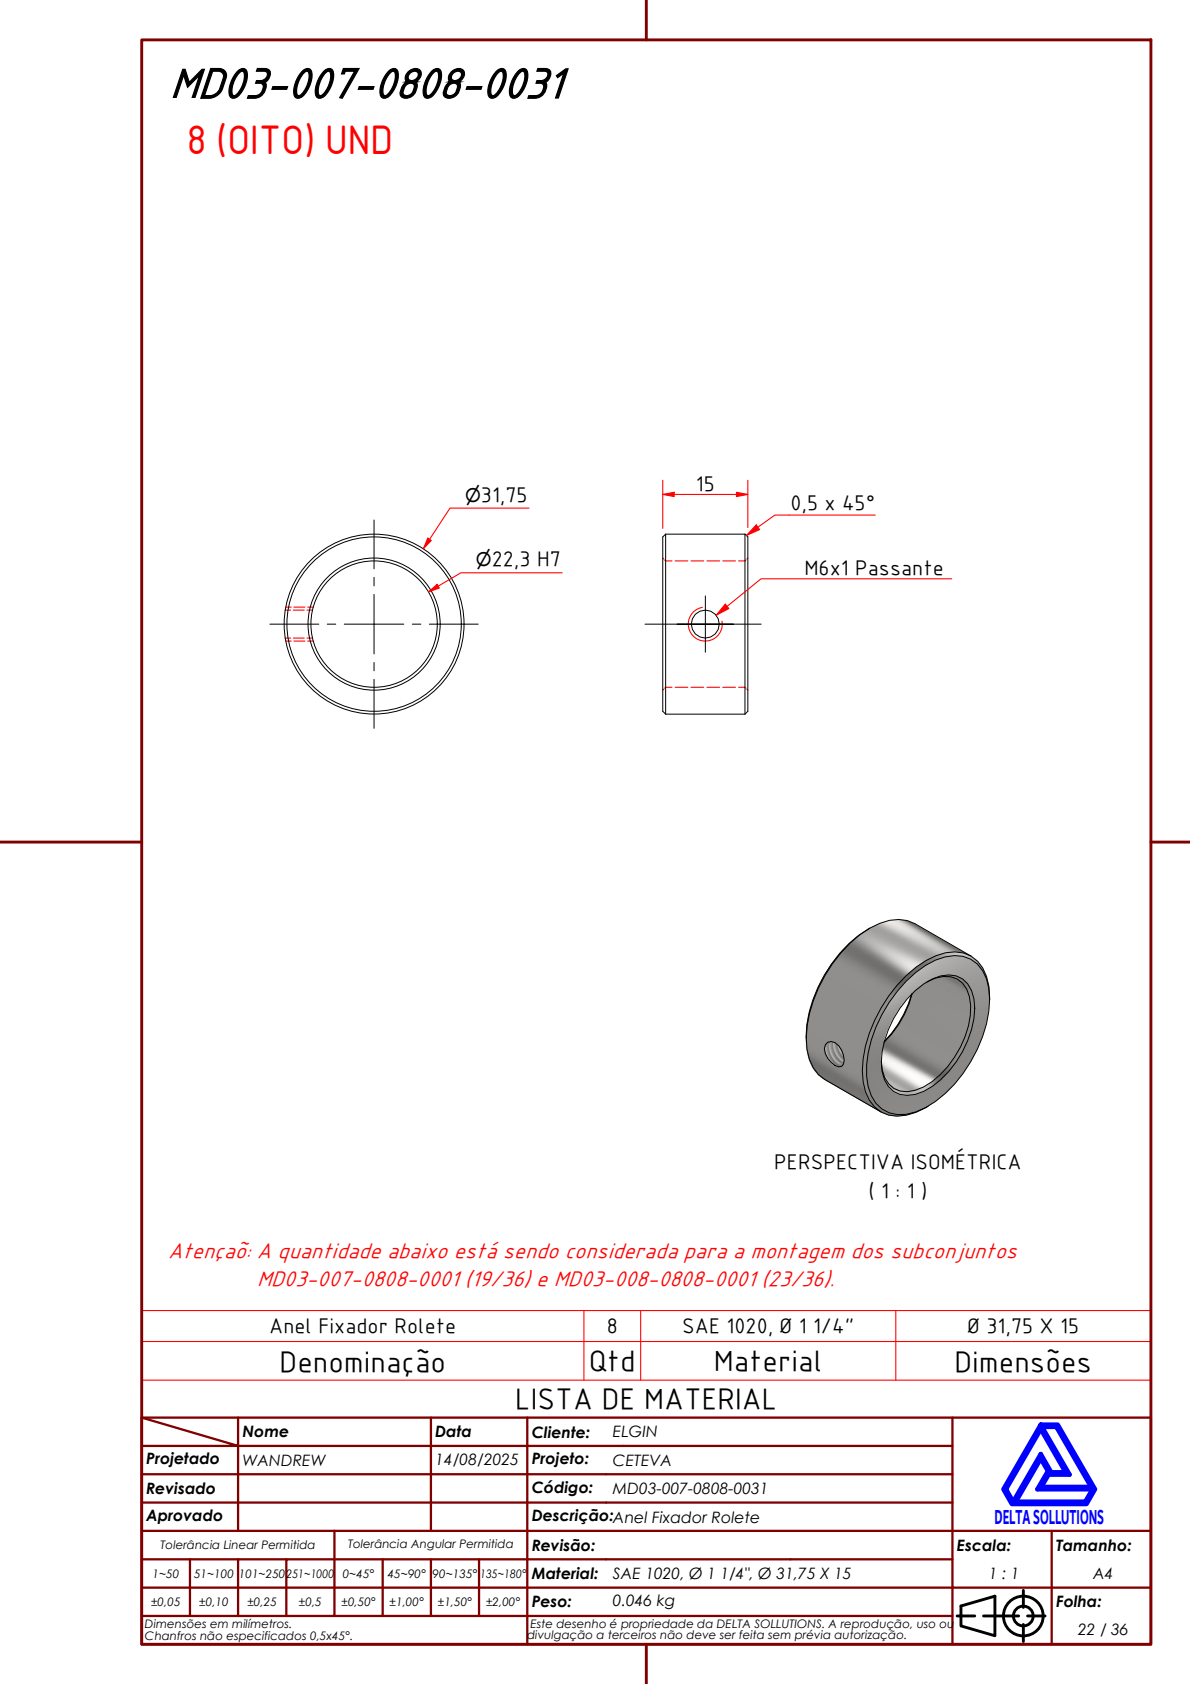
[picture p133: page 1]
PERSPECTIVA ISOMÉTRICA; 8 (OITO) UND; M6x1 Passante

Atençaõ: A quantidade abaixo está sendo considerada para a montagem dos subconjuntos

Anel Fixador Rolete | 8 | SAE 1020, Ø 1 1/4" | Ø 31,75 X 15
Denominação | Qtd | Material | Dimensões

LISTA DE MATERIAL

Projetado | Nome | Data | Cliente: ELGIN | | DELTA SOLLUTIONS

WANDREW | 14/08/2025 | Projeto: CETEVA

Revisado | | | Código: MD03-007-0808-0031

Aprovado | | | Descrição: Anel Fixador Rolete

Tolerância Linear Permitida | Tolerância Angular Permitida | Revisão: | Escala: 1 : 1 | Tamanho: A4

1~50 | 51~100 | 101~250 | 251~1000 | 0~45° | 45~90° | 90~135° 135~180° | | Material: SAE 1020, Ø 1 1/4", Ø 31,75 X 15
±0,05 | ±0,10 | ±0,25 | ±0,5 | ±0,50° | ±1,00° | ±1,50° | ±2,00° | Peso: 0.046 kg | Folha: 22 / 36

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
