pvrezende/Dashboard/uploads/anexo-1755314674623-281470734.pdf

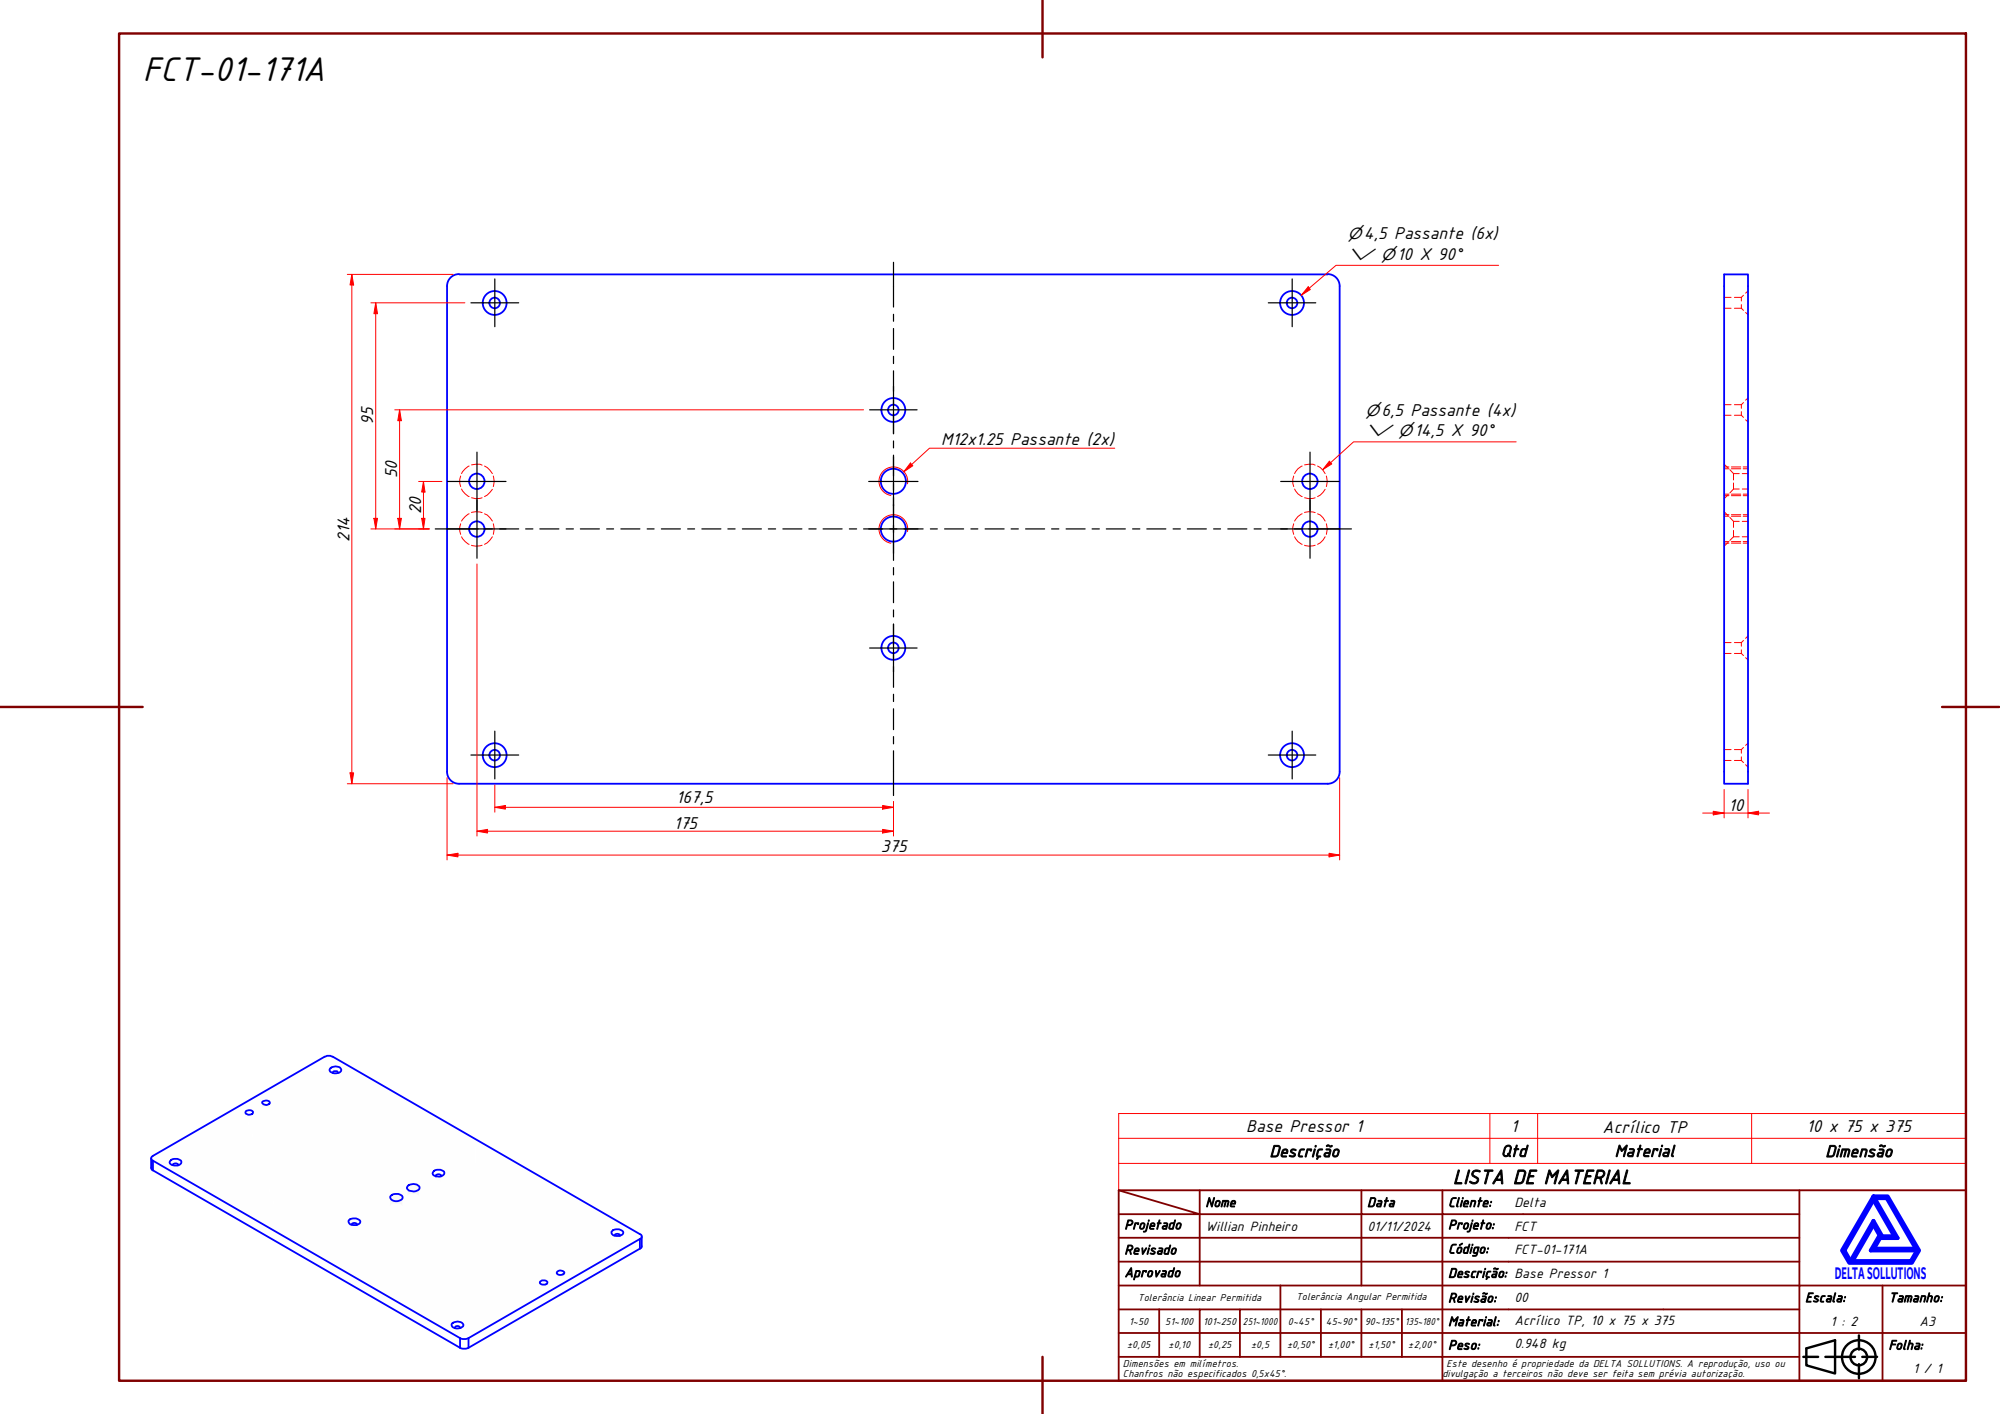
[picture p134: page 1]
M12x1.25 Passante (2x); ⌀ 4,5 Passante (6x) ⌵ ⌀ 10 X 90°; ⌀ 6,5 Passante (4x) ⌵ ⌀ 14,5 X 90°

Base Pressor 1 | 1 | Acrílico TP | 10 x 75 x 375
Descrição | Qtd | Material | Dimensão

LISTA DE MATERIAL

Projetado | Nome | Data | Cliente: Delta | | DELTA SOLLUTIONS

Willian Pinheiro | 01/11/2024 | Projeto: FCT

Revisado | | | Código: FCT-01-171A

Aprovado | | | Descrição: Base Pressor 1

Tolerância Linear Permitida | Tolerância Angular Permitida | Revisão: 00 | Escala: 1 : 2 | Tamanho: A3

1~50 | 51~100 | 101~250 | 251~1000 | 0~45° | 45~90° | 90~135° | 135~180° | Material: Acrílico TP, 10 x 75 x 375

±0,05 | ±0,10 | ±0,25 | ±0,5 | ±0,50° | ±1,00° | ±1,50° | ±2,00° | Peso: 0.948 kg | Folha: 1 / 1

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
