pvrezende/Dashboard/uploads/anexo-1755560470410-782723669.pdf

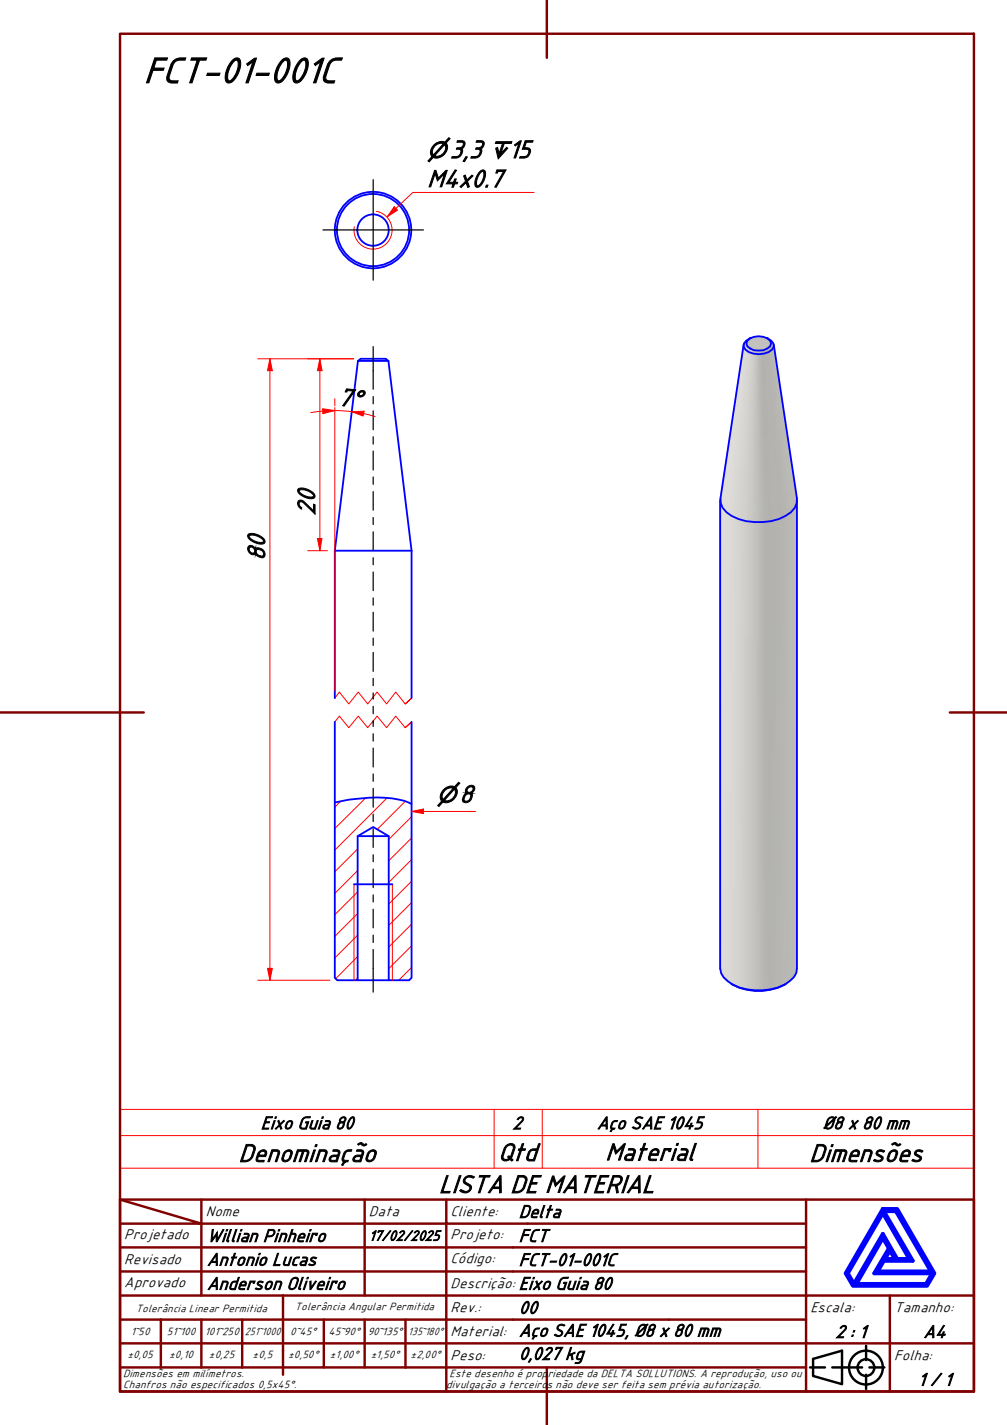
[picture p135: page 1]

Eixo Guia 80 | 2 | Aço SAE 1045 | Ø8 x 80 mm
Denominação | Qtd | Material | Dimensões

LISTA DE MATERIAL

Projetado | Nome | Data | Cliente: Delta

Willian Pinheiro | 17/02/2025 | Projeto: FCT

Revisado | Antonio Lucas | | Código: FCT-01-001C
Aprovado | Anderson Oliveiro | | Eixo Guia 80 Descrição:
Tolerância Linear Permitida | Tolerância Angular Permitida | Rev.: 00 | Escala: 2 : 1 | Tamanho: A4

1~50 | 51~100 | 101~250 | 251~1000 | 0~45° | 45~90° | 90~135° 135~180° | | Material: Aço SAE 1045, Ø8 x 80 mm
±0,05 | ±0,10 | ±0,25 | ±0,5 | ±0,50° | ±1,00° | ±1,50° | ±2,00° | 0,027 kg Peso: | Folha: 1 / 1

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

Dimensões em milímetros.
