pvrezende/Dashboard/uploads/anexo-1755560615862-714143424.pdf

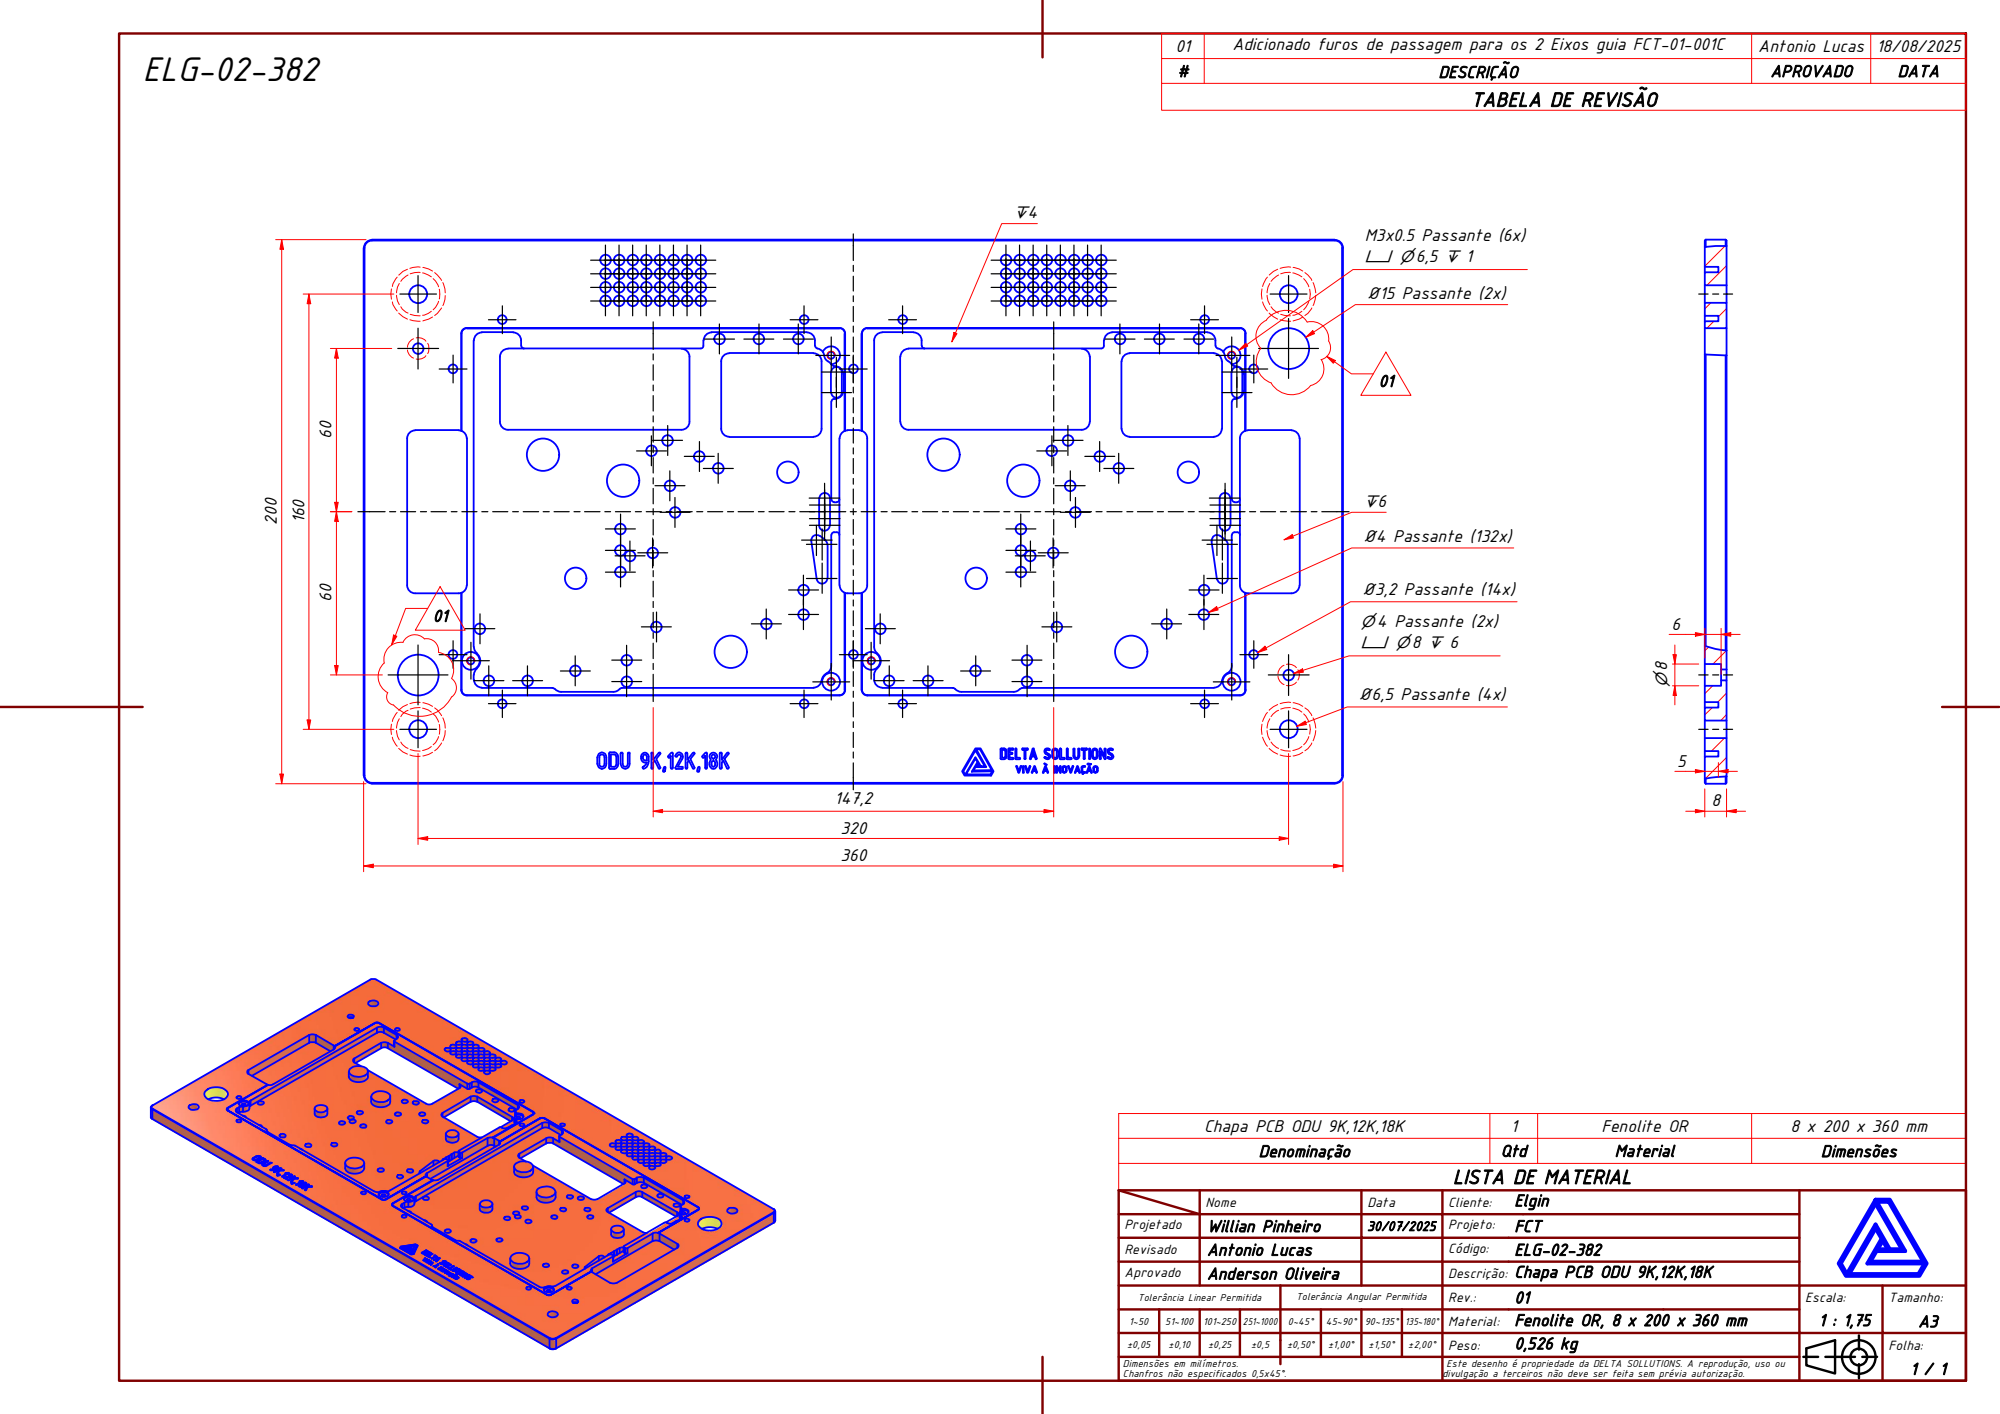
[picture p136: page 1]
Ø6,5 Passante (4x); ⌀ 4 Passante (2x) ⌴ ⌀ 8 ↧ 6; Ø3,2 Passante (14x); M3x0.5 Passante (6x) ⌴ ⌀ 6,5 ↧ 1; Ø4 Passante (132x); Ø15 Passante (2x)

01 | Adicionado furos de passagem para os 2 Eixos guia FCT-01-001C | Antonio Lucas | 18/08/2025
# | DESCRIÇÃO | APROVADO | DATA

TABELA DE REVISÃO

Chapa PCB ODU 9K,12K,18K | 1 | Fenolite OR | 8 x 200 x 360 mm

Denominação | Qtd | Material | Dimensões

LISTA DE MATERIAL

Projetado | Nome | Data | Elgin Cliente:

Willian Pinheiro | 30/07/2025 | Projeto: FCT

Revisado | Antonio Lucas | | Código: ELG-02-382

Aprovado | Anderson Oliveira | | Chapa PCB ODU 9K,12K,18K Descrição:
Tolerância Linear Permitida | Tolerância Angular Permitida | Rev.: 01 | Escala: 1 : 1,75 | Tamanho: A3

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

±0,05 | ±0,10 | ±0,25 | ±0,5 | ±0,50° | ±1,00° | ±1,50° | ±2,00° | Peso: 0,526 kg | Folha: 1 / 1

Dimensões em milímetros.

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
