pvrezende/Dashboard/uploads/anexo-1755614885548-539179821.pdf

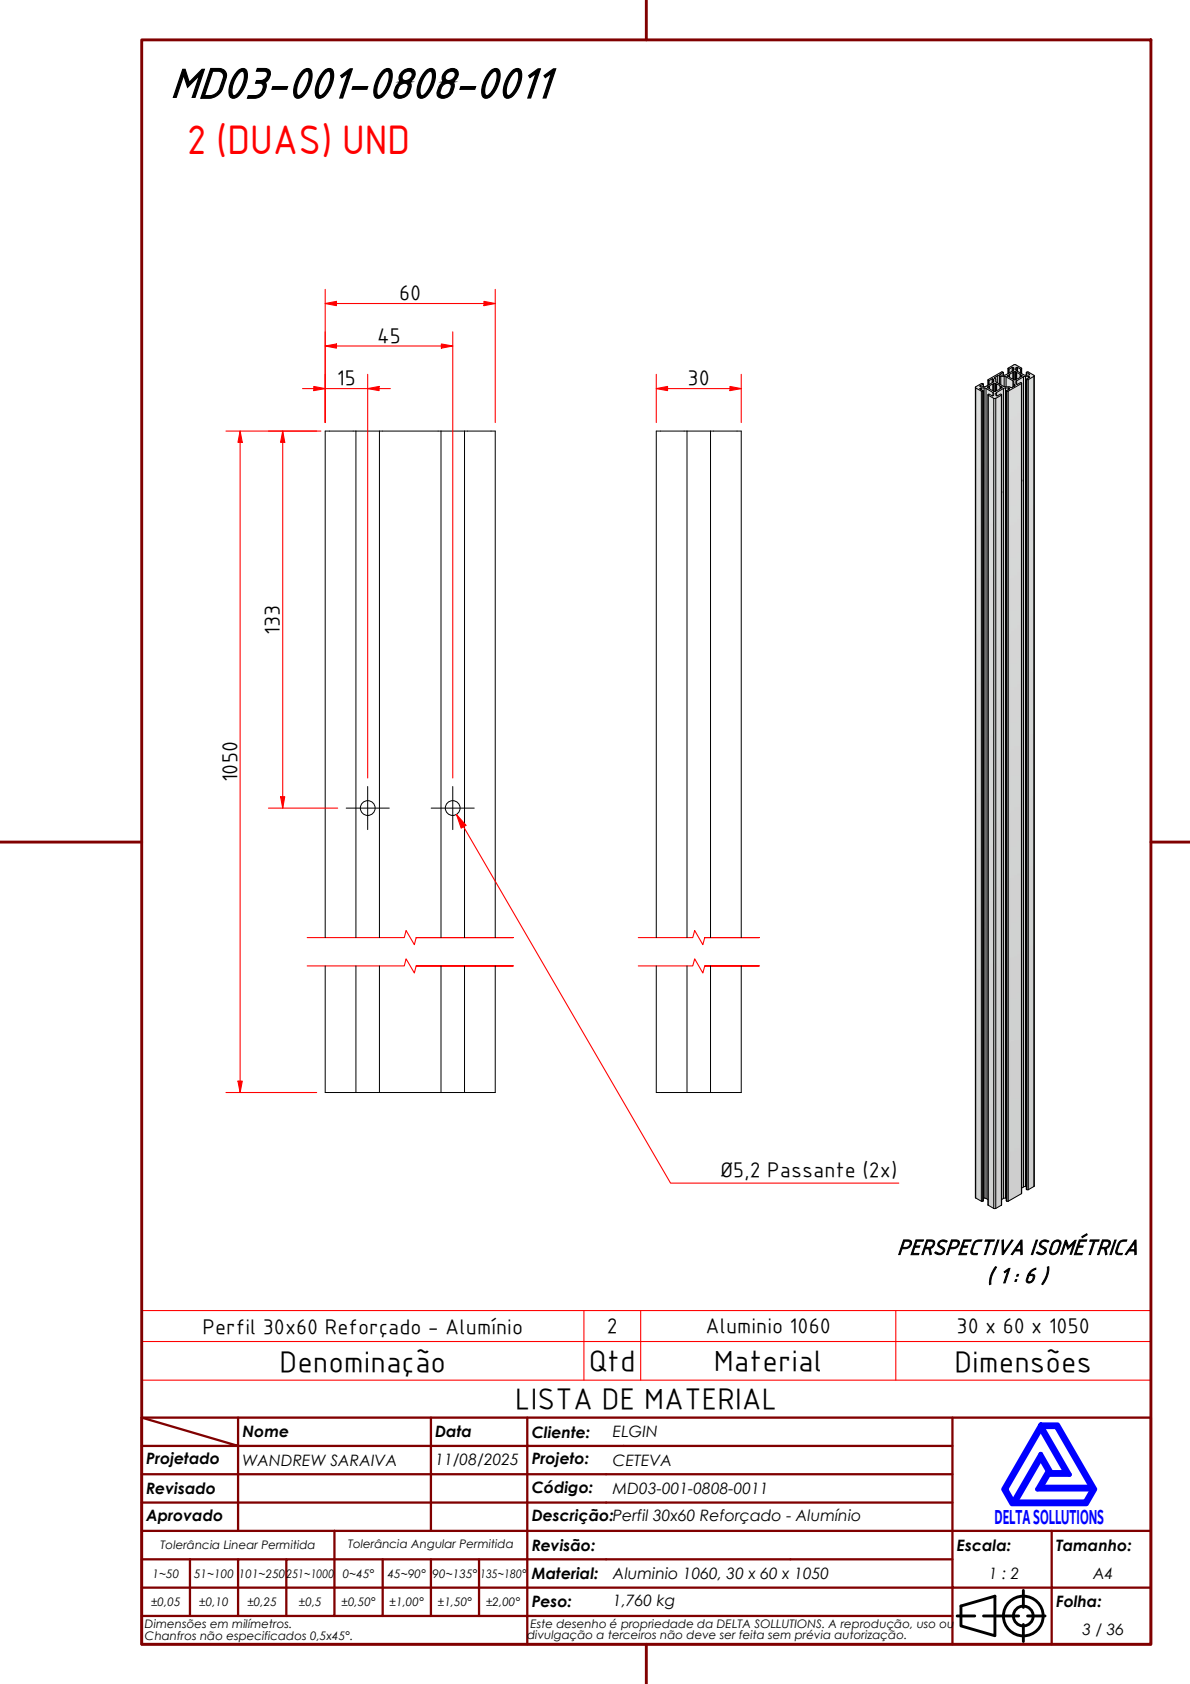
[picture p137: page 1]
PERSPECTIVA ISOMÉTRICA; 2 (DUAS) UND; Ø5,2 Passante (2x)

Perfil 30x60 Reforçado - Alumínio | 2 | Aluminio 1060 | 30 x 60 x 1050
Denominação | Qtd | Material | Dimensões

LISTA DE MATERIAL

Projetado | Nome | Data | Cliente: ELGIN | | DELTA SOLLUTIONS

WANDREW SARAIVA | 11/08/2025 | Projeto: CETEVA

Revisado | | | Código: MD03-001-0808-0011

Aprovado | | | Perfil 30x60 Reforçado - Alumínio Descrição:

Tolerância Linear Permitida | Tolerância Angular Permitida | Revisão: | Escala: 1 : 2 | Tamanho: A4

1~50 | 51~100 | 101~250 | 251~1000 | 0~45° | 45~90° | 90~135° 135~180° | | Material: Aluminio 1060, 30 x 60 x 1050
±0,05 | ±0,10 | ±0,25 | ±0,5 | ±0,50° | ±1,00° | ±1,50° | ±2,00° | Peso: 1,760 kg | Folha: 3 / 36

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
