pvrezende/Dashboard/uploads/anexo-1755614939702-724172208.pdf

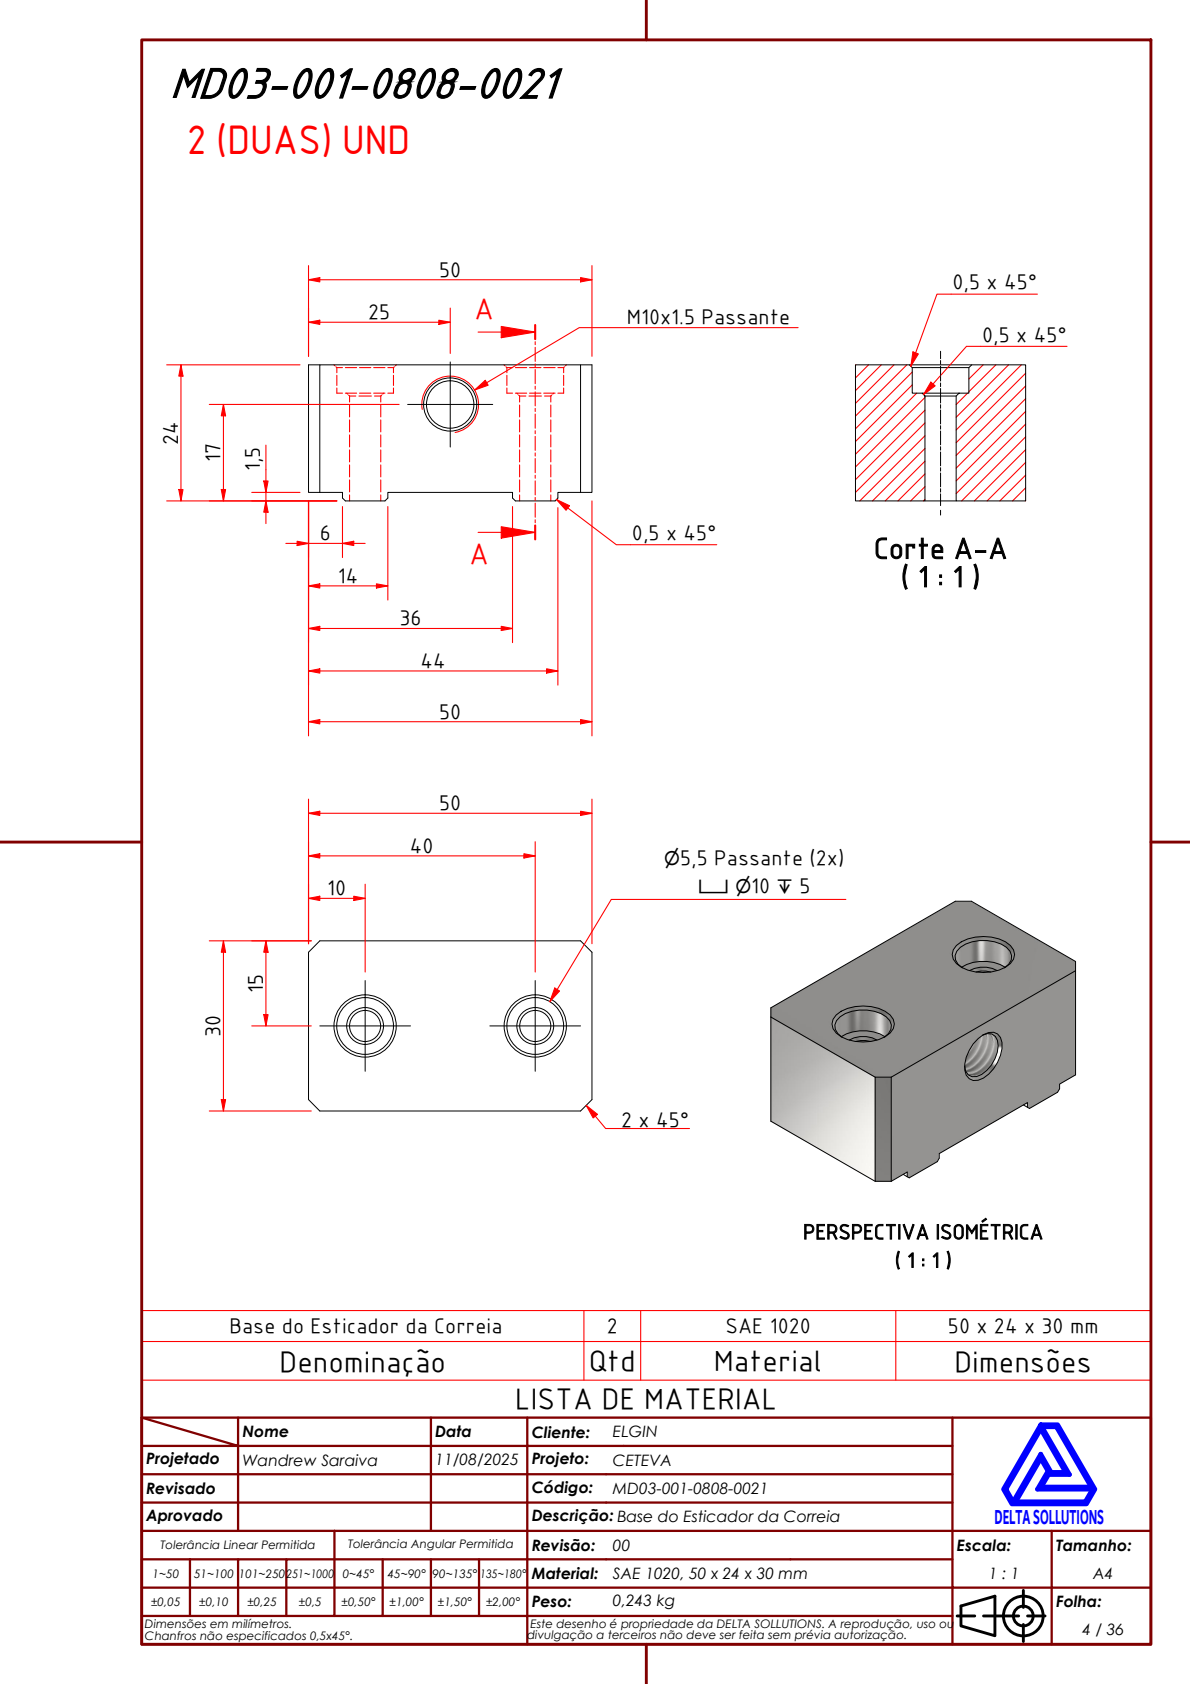
[picture p138: page 1]
PERSPECTIVA ISOMÉTRICA; Corte A-A ( 1 : 1 ); 2 (DUAS) UND; M10x1.5 Passante; ⌀5,5 Passante (2x) ⌴ ⌀10 ↧ 5

Base do Esticador da Correia | 2 | SAE 1020 | 50 x 24 x 30 mm
Denominação | Qtd | Material | Dimensões

LISTA DE MATERIAL

Projetado | Nome | Data | Cliente: ELGIN | | DELTA SOLLUTIONS

Wandrew Saraiva | 11/08/2025 | Projeto: CETEVA

Revisado | | | Código: MD03-001-0808-0021

Aprovado | | | Descrição: Base do Esticador da Correia

Tolerância Linear Permitida | Tolerância Angular Permitida | Revisão: 00 | Escala: 1 : 1 | Tamanho: A4

1~50 | 51~100 | 101~250 | 251~1000 | 0~45° | 45~90° | 90~135° 135~180° | | Material: SAE 1020, 50 x 24 x 30 mm
±0,05 | ±0,10 | ±0,25 | ±0,5 | ±0,50° | ±1,00° | ±1,50° | ±2,00° | Peso: 0,243 kg | Folha: 4 / 36

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
