pvrezende/Dashboard/uploads/anexo-1755618542630-73055914.pdf

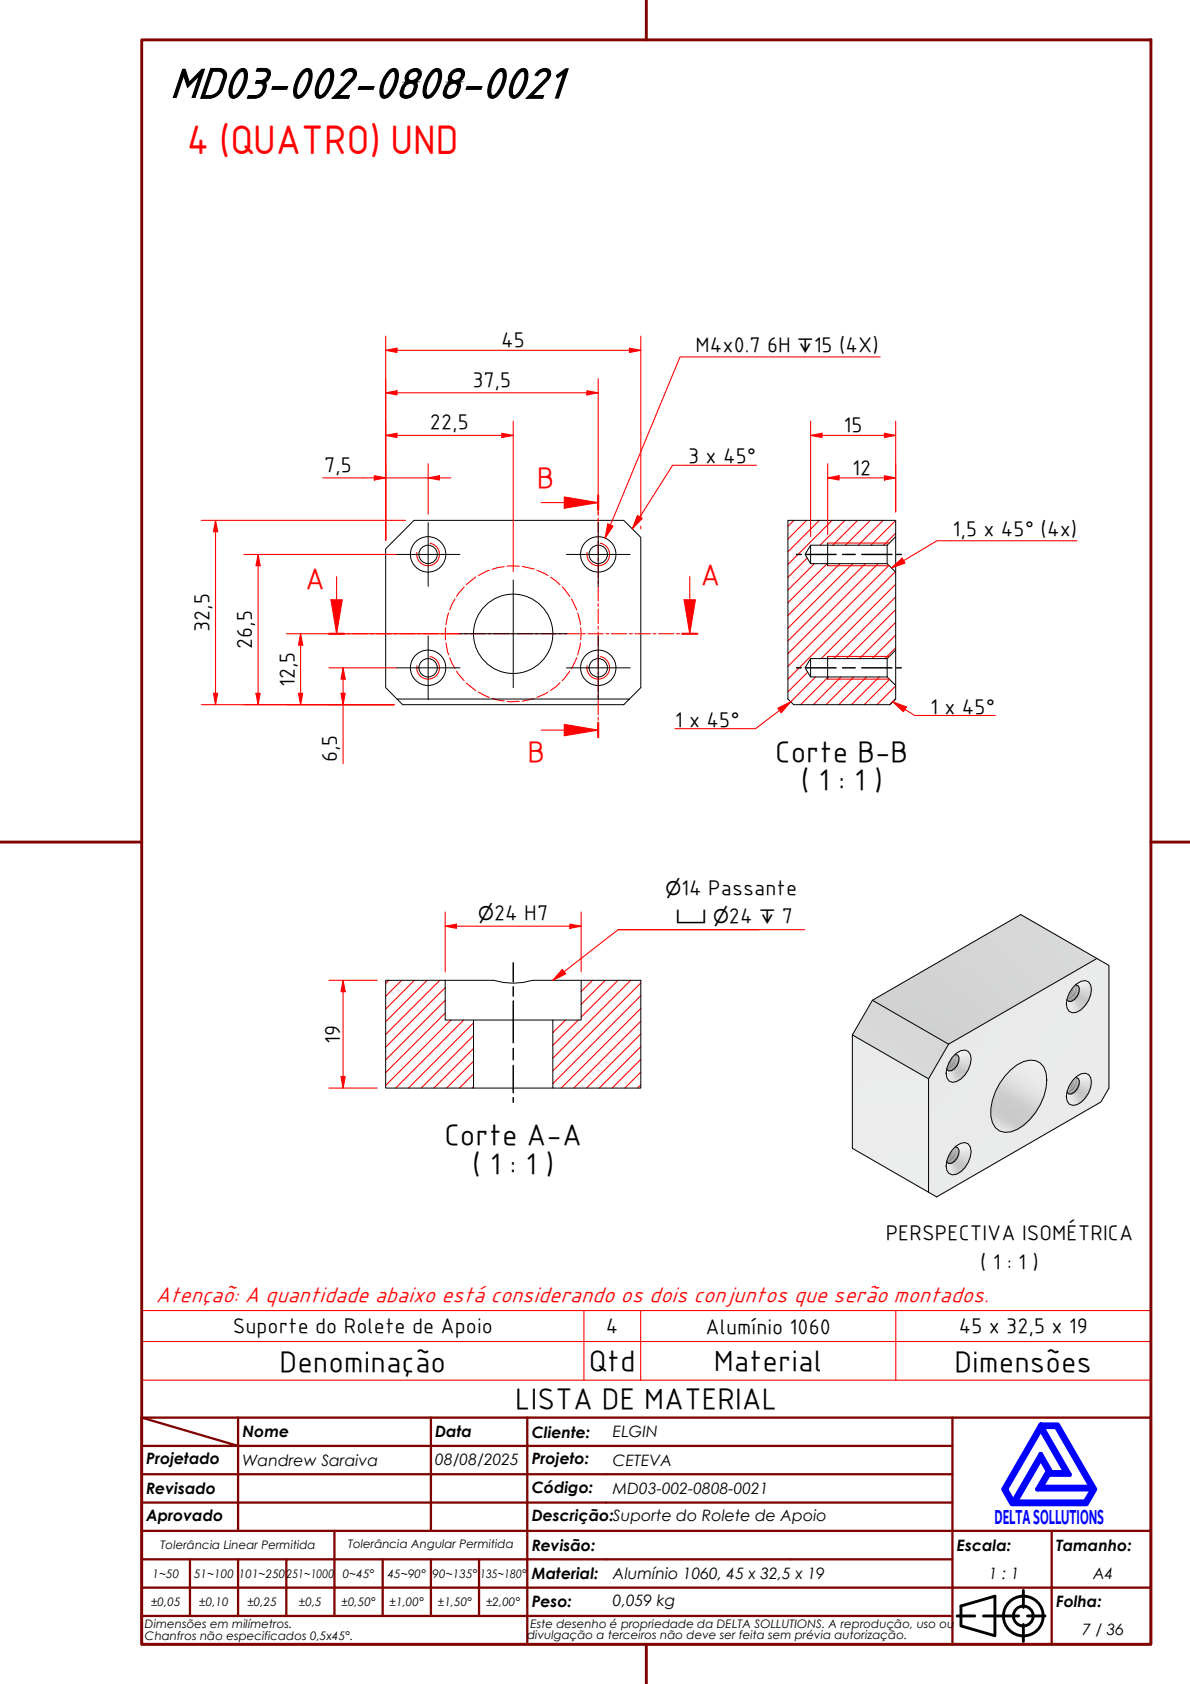
[picture p139: page 1]
Corte A-A ( 1 : 1 ); PERSPECTIVA ISOMÉTRICA; Corte B-B ( 1 : 1 ); 4 (QUATRO) UND; ⌀14 Passante ⌴ ⌀24 ↧ 7

Atençaõ: A quantidade abaixo está considerando os dois conjuntos que serão montados.

Suporte do Rolete de Apoio | 4 | Alumínio 1060 | 45 x 32,5 x 19
Denominação | Qtd | Material | Dimensões

LISTA DE MATERIAL

Projetado | Nome | Data | Cliente: ELGIN | | DELTA SOLLUTIONS

Wandrew Saraiva | 08/08/2025 | Projeto: CETEVA

Revisado | | | Código: MD03-002-0808-0021

Aprovado | | | Descrição: Suporte do Rolete de Apoio

Tolerância Linear Permitida | Tolerância Angular Permitida | Revisão: | Escala: 1 : 1 | Tamanho: A4

1~50 | 51~100 | 101~250 | 251~1000 | 0~45° | 45~90° | 90~135° 135~180° | | Material: Alumínio 1060, 45 x 32,5 x 19
±0,05 | ±0,10 | ±0,25 | ±0,5 | ±0,50° | ±1,00° | ±1,50° | ±2,00° | Peso: 0,059 kg | Folha: 7 / 36

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
