pvrezende/Dashboard/uploads/anexo-1755619329686-466632472.pdf

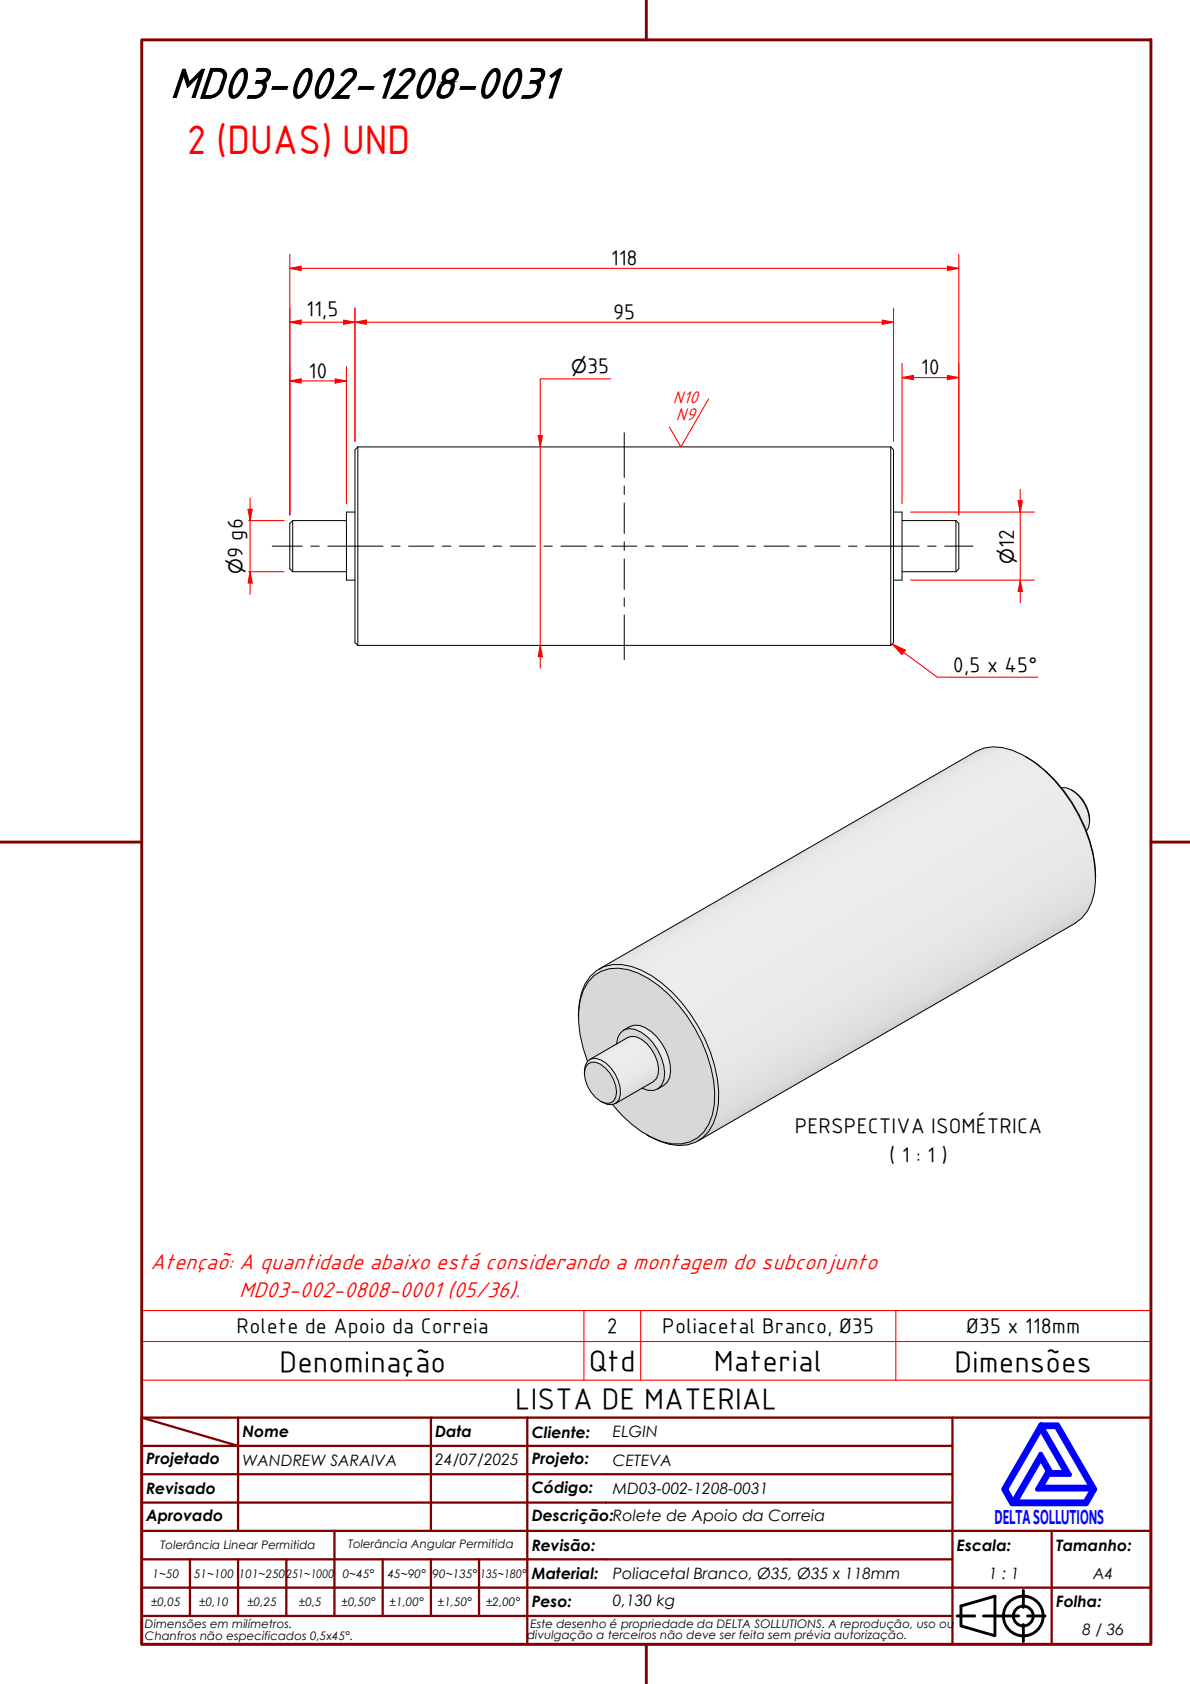
[picture p140: page 1]
PERSPECTIVA ISOMÉTRICA; 2 (DUAS) UND

Atençaõ: A quantidade abaixo está considerando a montagem do subconjunto

Rolete de Apoio da Correia | 2 | Poliacetal Branco, Ø35 | Ø35 x 118mm
Denominação | Qtd | Material | Dimensões

LISTA DE MATERIAL

Projetado | Nome | Data | Cliente: ELGIN | | DELTA SOLLUTIONS

WANDREW SARAIVA | 24/07/2025 | Projeto: CETEVA

Revisado | | | Código: MD03-002-1208-0031

Aprovado | | | Descrição: Rolete de Apoio da Correia

Tolerância Linear Permitida | Tolerância Angular Permitida | Revisão: | Escala: 1 : 1 | Tamanho: A4

1~50 | 51~100 | 101~250 | 251~1000 | 0~45° | 45~90° | 90~135° 135~180° | | Material: Poliacetal Branco, Ø35, Ø35 x 118mm
±0,05 | ±0,10 | ±0,25 | ±0,5 | ±0,50° | ±1,00° | ±1,50° | ±2,00° | Peso: 0,130 kg | Folha: 8 / 36

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
