pvrezende/Dashboard/uploads/anexo-1755620276909-704813279.pdf

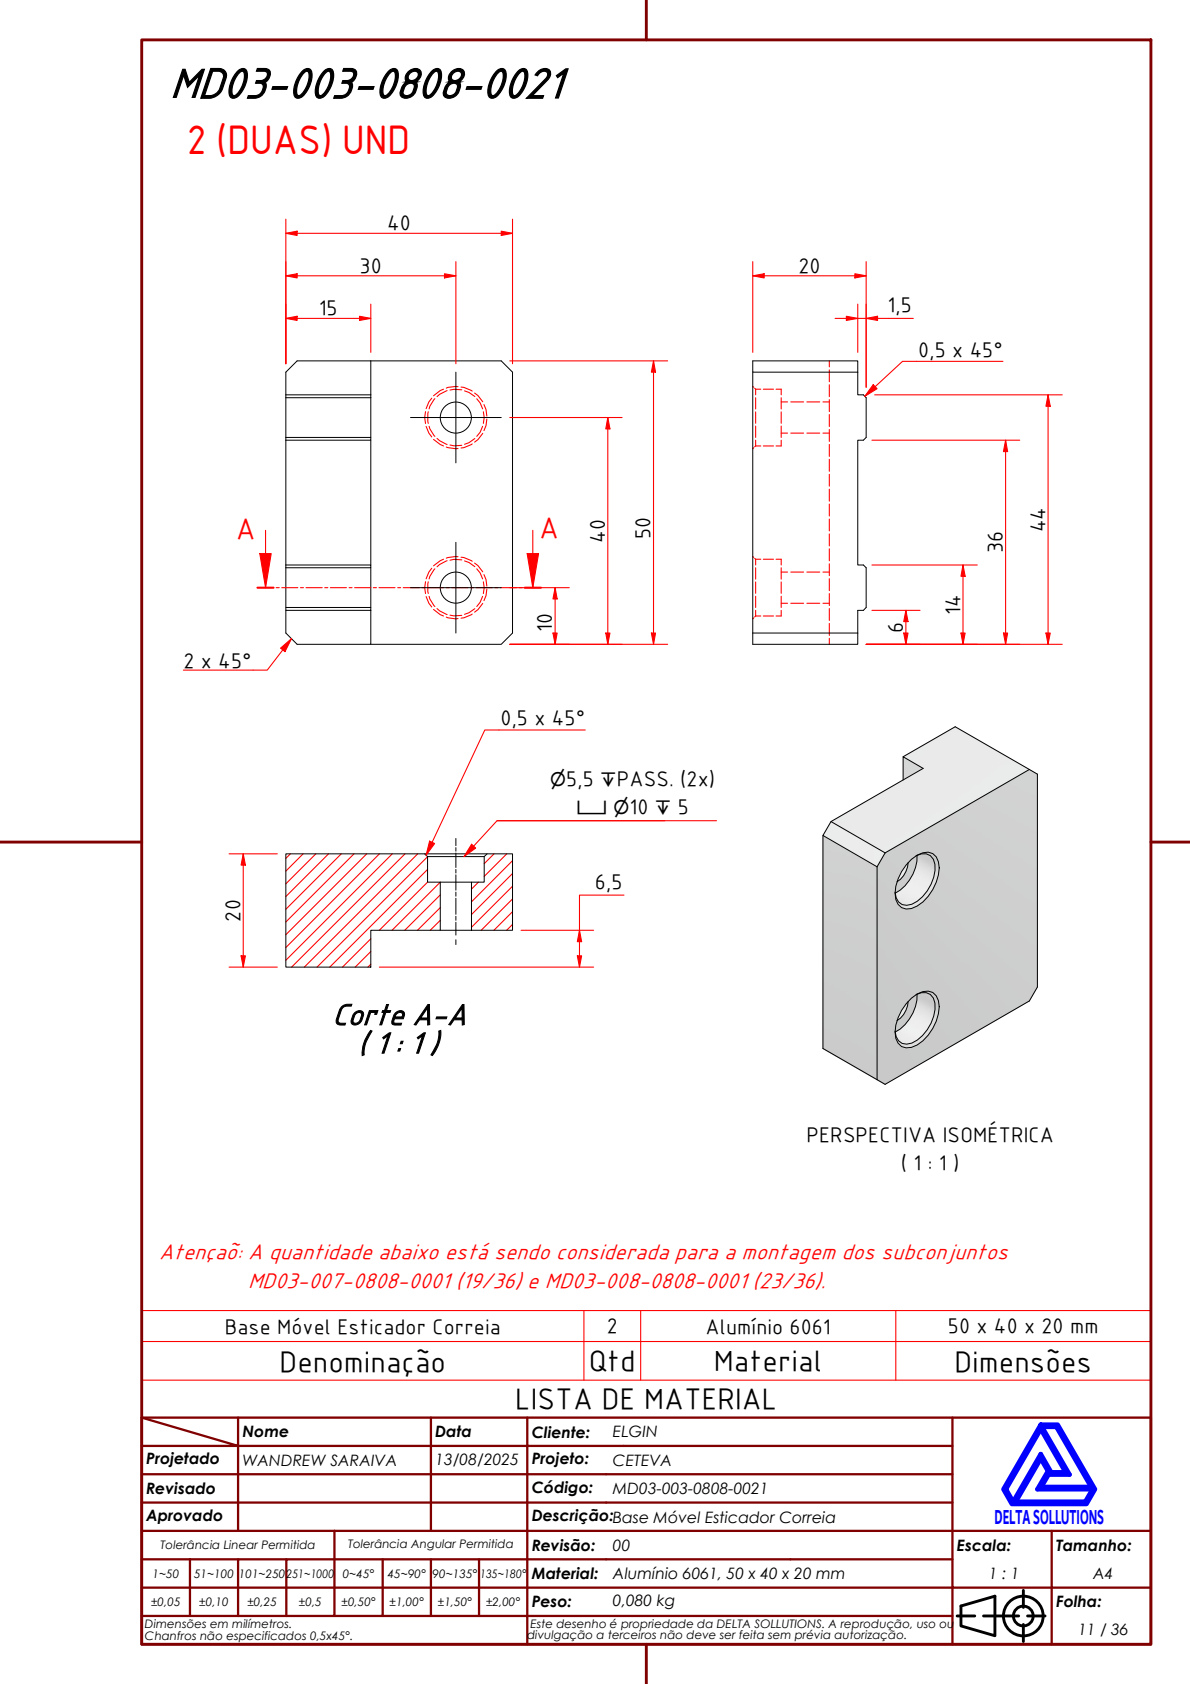
[picture p141: page 1]
PERSPECTIVA ISOMÉTRICA; Corte A-A ( 1 : 1 ); 2 (DUAS) UND; ⌀5,5 ↧PASS. (2x) ⌴ ⌀10 ↧ 5

Atençaõ: A quantidade abaixo está sendo considerada para a montagem dos subconjuntos

Base Móvel Esticador Correia | 2 | Alumínio 6061 | 50 x 40 x 20 mm
Denominação | Qtd | Material | Dimensões

LISTA DE MATERIAL

Projetado | Nome | Data | Cliente: ELGIN | | DELTA SOLLUTIONS

WANDREW SARAIVA | 13/08/2025 | Projeto: CETEVA

Revisado | | | Código: MD03-003-0808-0021

Aprovado | | | Descrição: Base Móvel Esticador Correia

Tolerância Linear Permitida | Tolerância Angular Permitida | Revisão: 00 | Escala: 1 : 1 | Tamanho: A4

1~50 | 51~100 | 101~250 | 251~1000 | 0~45° | 45~90° | 90~135° 135~180° | | Material: Alumínio 6061, 50 x 40 x 20 mm
±0,05 | ±0,10 | ±0,25 | ±0,5 | ±0,50° | ±1,00° | ±1,50° | ±2,00° | Peso: 0,080 kg | Folha: 11 / 36

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
