pvrezende/Dashboard/uploads/anexo-1755638368175-566173506.pdf

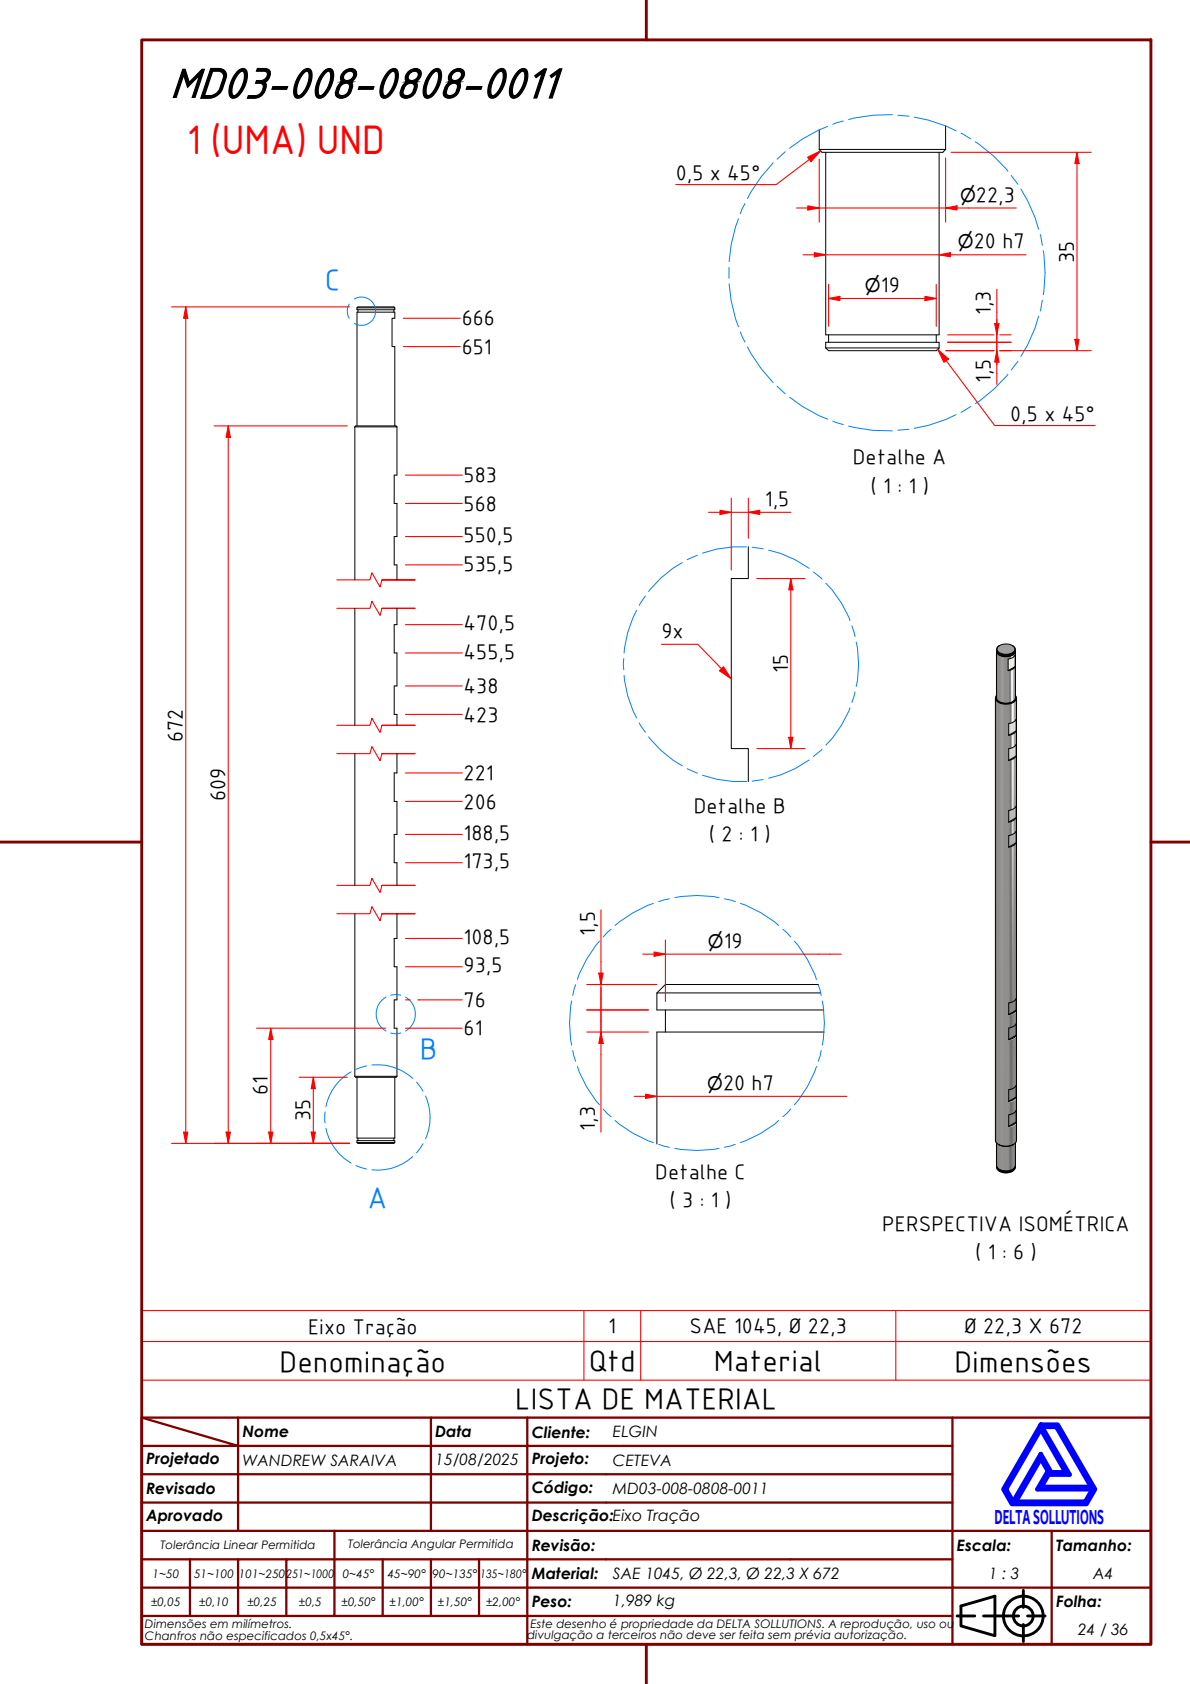
[picture p142: page 1]
PERSPECTIVA ISOMÉTRICA; Detalhe A ( 1 : 1 ); Detalhe B ( 2 : 1 ); Detalhe C; 1 (UMA) UND

Eixo Tração | 1 | SAE 1045, Ø 22,3 | Ø 22,3 X 672
Denominação | Qtd | Material | Dimensões

LISTA DE MATERIAL

Projetado | Nome | Data | Cliente: ELGIN | | DELTA SOLLUTIONS

WANDREW SARAIVA | 15/08/2025 | Projeto: CETEVA

Revisado | | | Código: MD03-008-0808-0011

Aprovado | | | Descrição: Eixo Tração

Tolerância Linear Permitida | Tolerância Angular Permitida | Revisão: | Escala: 1 : 3 | Tamanho: A4

1~50 | 51~100 | 101~250 | 251~1000 | 0~45° | 45~90° | 90~135° 135~180° | | Material: SAE 1045, Ø 22,3, Ø 22,3 X 672
±0,05 | ±0,10 | ±0,25 | ±0,5 | ±0,50° | ±1,00° | ±1,50° | ±2,00° | Peso: 1,989 kg | Folha: 24 / 36

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
