pvrezende/Dashboard/uploads/anexo-1755692262153-734813458.pdf

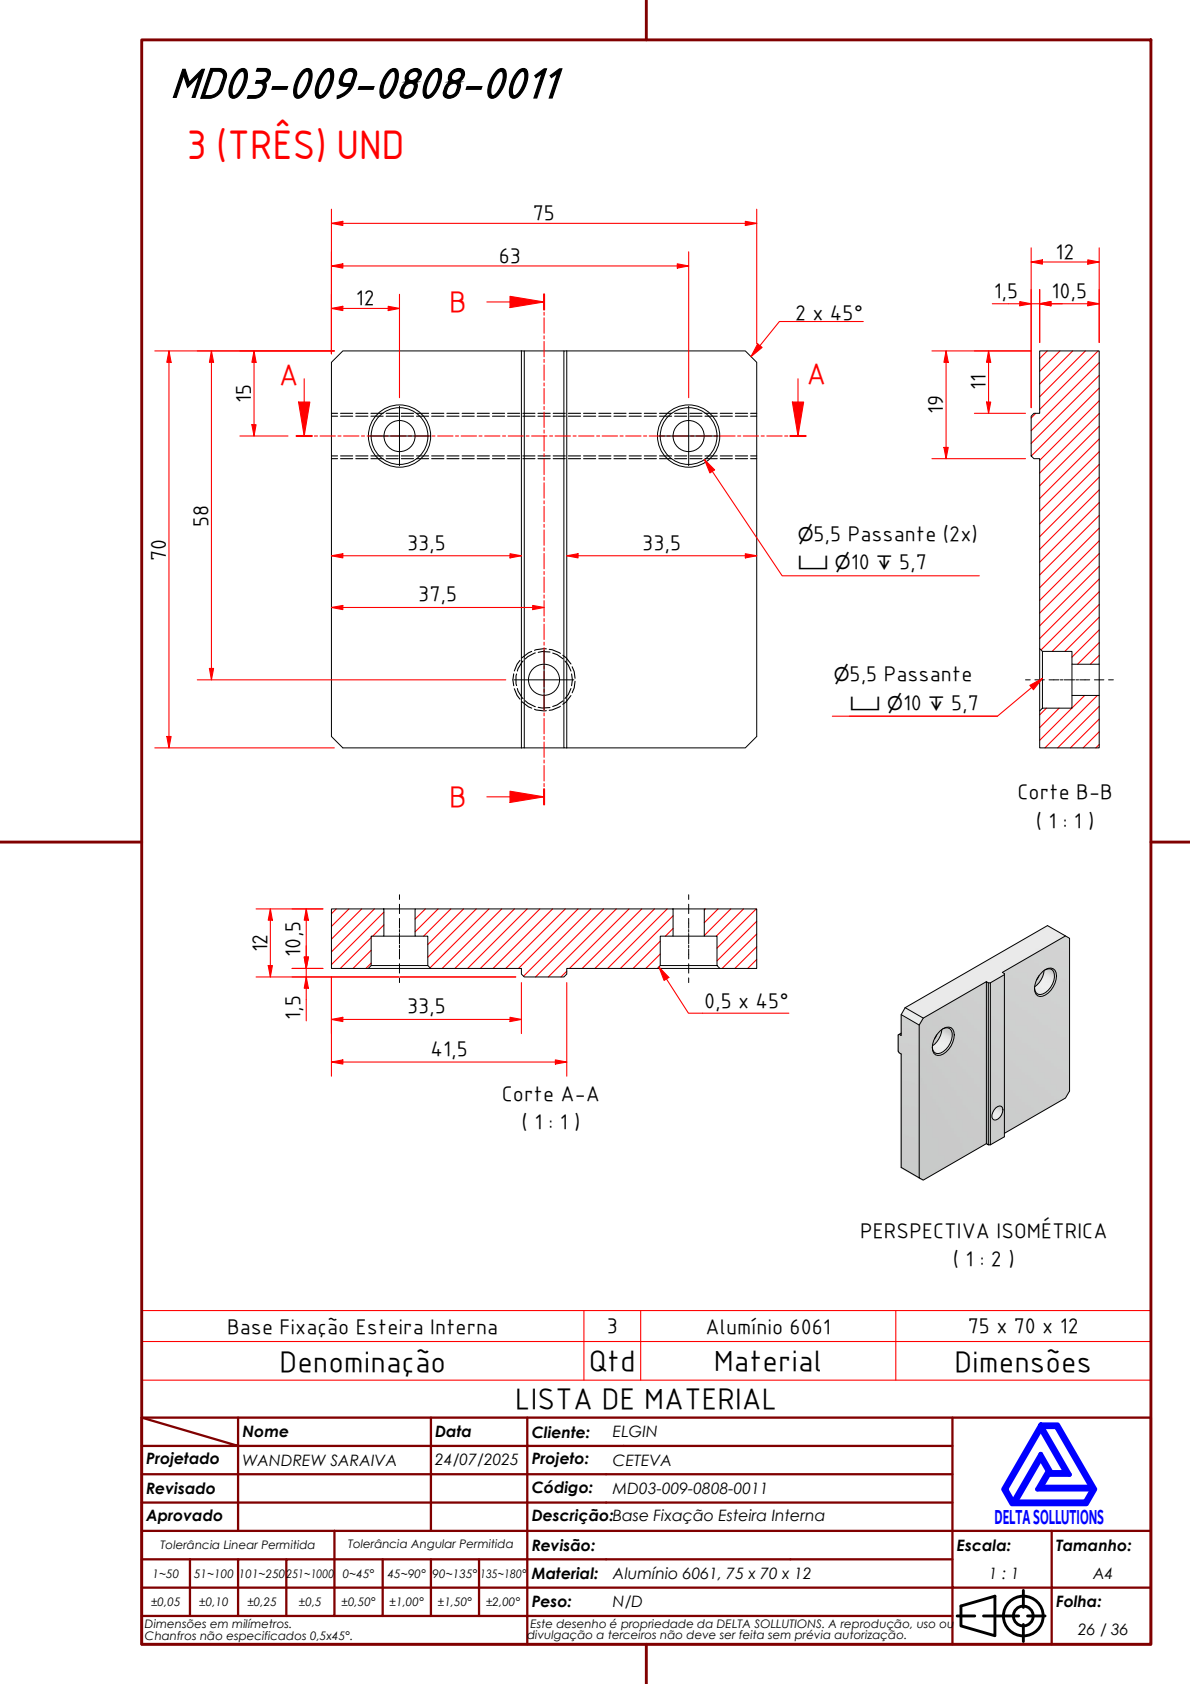
[picture p143: page 1]
PERSPECTIVA ISOMÉTRICA; Corte A-A ( 1 : 1 ); Corte B-B ( 1 : 1 ); 3 (TRÊS) UND; ⌀5,5 Passante (2x) ⌴ ⌀10 ↧ 5,7; ⌀5,5 Passante ⌴ ⌀10 ↧ 5,7

Base Fixação Esteira Interna | 3 | Alumínio 6061 | 75 x 70 x 12
Denominação | Qtd | Material | Dimensões

LISTA DE MATERIAL

Projetado | Nome | Data | Cliente: ELGIN

WANDREW SARAIVA | 24/07/2025 | Projeto: CETEVA

Revisado | | | Código: MD03-009-0808-0011 | | DELTA SOLLUTIONS

Aprovado | | | Descrição: Base Fixação Esteira Interna

Tolerância Linear Permitida | Tolerância Angular Permitida | Revisão: | Escala: 1 : 1 | Tamanho: A4

1~50 | 51~100 | 101~250 | 251~1000 | 0~45° | 45~90° | 90~135° 135~180° | | Material: Alumínio 6061, 75 x 70 x 12

±0,05 | ±0,10 | ±0,25 | ±0,5 | ±0,50° | ±1,00° | ±1,50° | ±2,00° | Peso: N/D | Folha: 26 / 36

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
