pvrezende/Dashboard/uploads/anexo-1755696607328-188033799.pdf

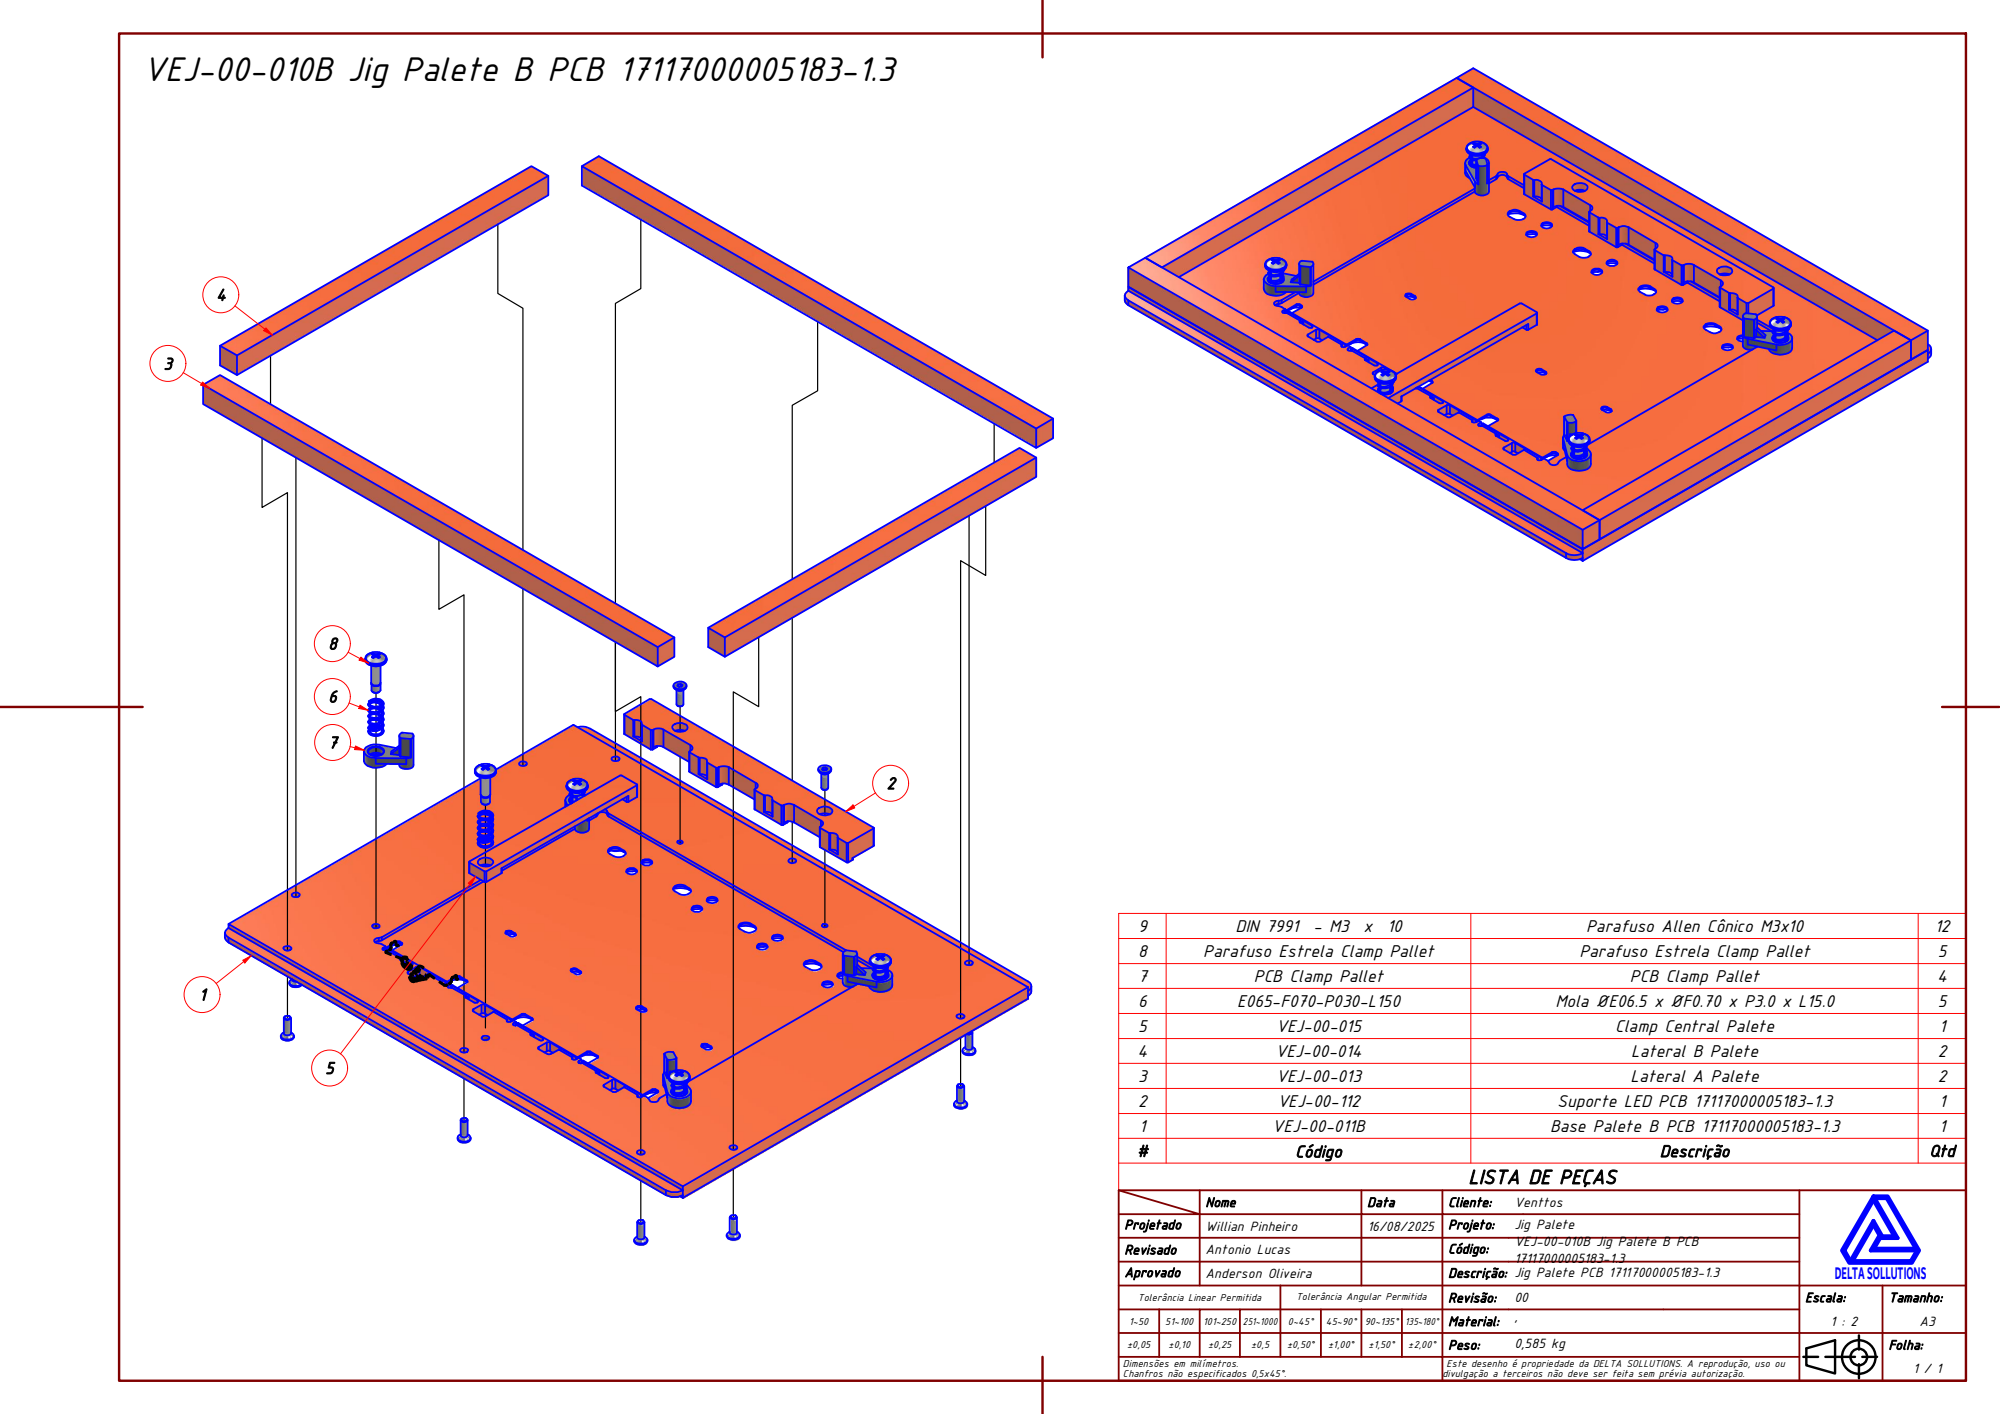
[picture p144: page 1]

VEJ-00-010B Jig Palete B PCB 17117000005183-1.3

9 | DIN 7991 - M3 x 10 | Parafuso Allen Cônico M3x10 | 12
8 | Parafuso Estrela Clamp Pallet | Parafuso Estrela Clamp Pallet | 5
7 | PCB Clamp Pallet | PCB Clamp Pallet | 4
6 | E065-F070-P030-L150 | Mola ØE06.5 x ØF0.70 x P3.0 x L15.0 | 5
5 | VEJ-00-015 | Clamp Central Palete | 1
4 | VEJ-00-014 | Lateral B Palete | 2
3 | VEJ-00-013 | Lateral A Palete | 2
2 | VEJ-00-112 | Suporte LED PCB 17117000005183-1.3 | 1
1 | VEJ-00-011B | Base Palete B PCB 17117000005183-1.3 | 1
# | Código | Descrição | Qtd

LISTA DE PEÇAS

Projetado | Nome | Data | Cliente: Venttos | | DELTA SOLLUTIONS

Willian Pinheiro | 16/08/2025 | Projeto: Jig Palete

Revisado | Antonio Lucas | | VEJ-00-010B Jig Palete B PCB Código: 17117000005183-1.3

Aprovado | Anderson Oliveira | | Descrição: Jig Palete PCB 17117000005183-1.3

Tolerância Linear Permitida | Tolerância Angular Permitida | Revisão: 00 | Escala: 1 : 2 | Tamanho: A3

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

±0,05 | ±0,10 | ±0,25 | ±0,5 | ±0,50° | ±1,00° | ±1,50° | ±2,00° | Peso: 0,585 kg | Folha: 1 / 1

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
