pvrezende/Dashboard/uploads/anexo-1755696776265-68003031.pdf

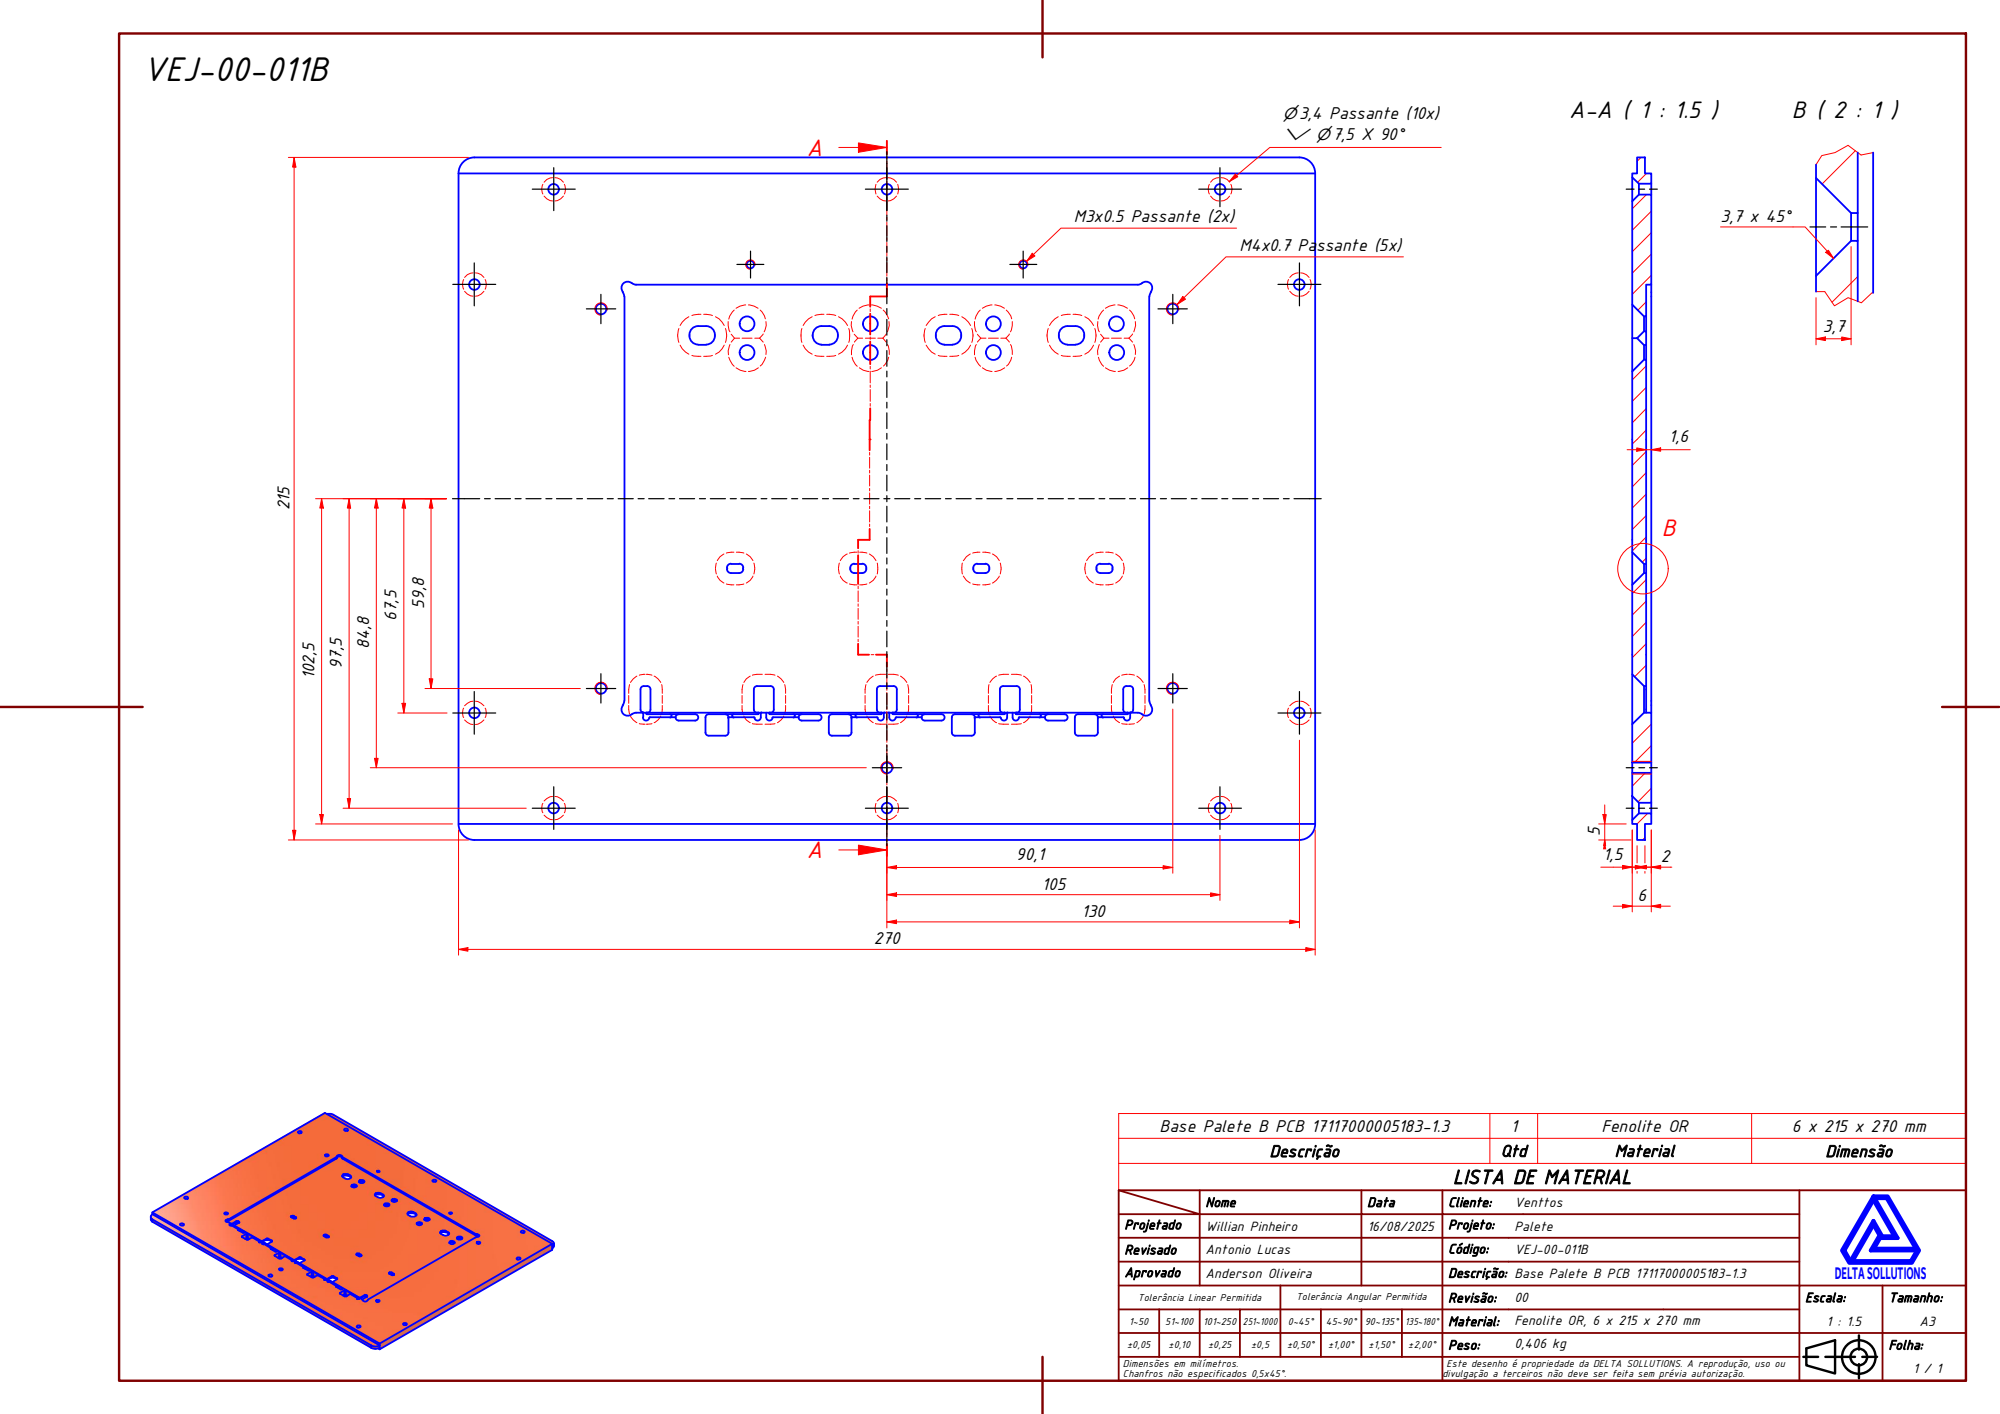
[picture p145: page 1]
⌀ 3,4 Passante (10x) ⌵ ⌀ 7,5 X 90°; M4x0.7 Passante (5x); M3x0.5 Passante (2x)

Base Palete B PCB 17117000005183-1.3 | 1 | Fenolite OR | 6 x 215 x 270 mm

Descrição | Qtd | Material | Dimensão

LISTA DE MATERIAL

Projetado | Nome | Data | Cliente: Venttos | | DELTA SOLLUTIONS

Willian Pinheiro | 16/08/2025 | Projeto: Palete

Revisado | Antonio Lucas | | Código: VEJ-00-011B

Aprovado | Anderson Oliveira | | Descrição: Base Palete B PCB 17117000005183-1.3

Tolerância Linear Permitida | Tolerância Angular Permitida | Revisão: 00 | Escala: 1 : 1.5 | Tamanho: A3

1~50 | 51~100 | 101~250 | 251~1000 | 0~45° | 45~90° | 90~135° | 135~180° | Material: Fenolite OR, 6 x 215 x 270 mm

±0,05 | ±0,10 | ±0,25 | ±0,5 | ±0,50° | ±1,00° | ±1,50° | ±2,00° | Peso: 0,406 kg | Folha: 1 / 1

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
