pvrezende/Dashboard/uploads/anexo-1755696858132-934853387.pdf

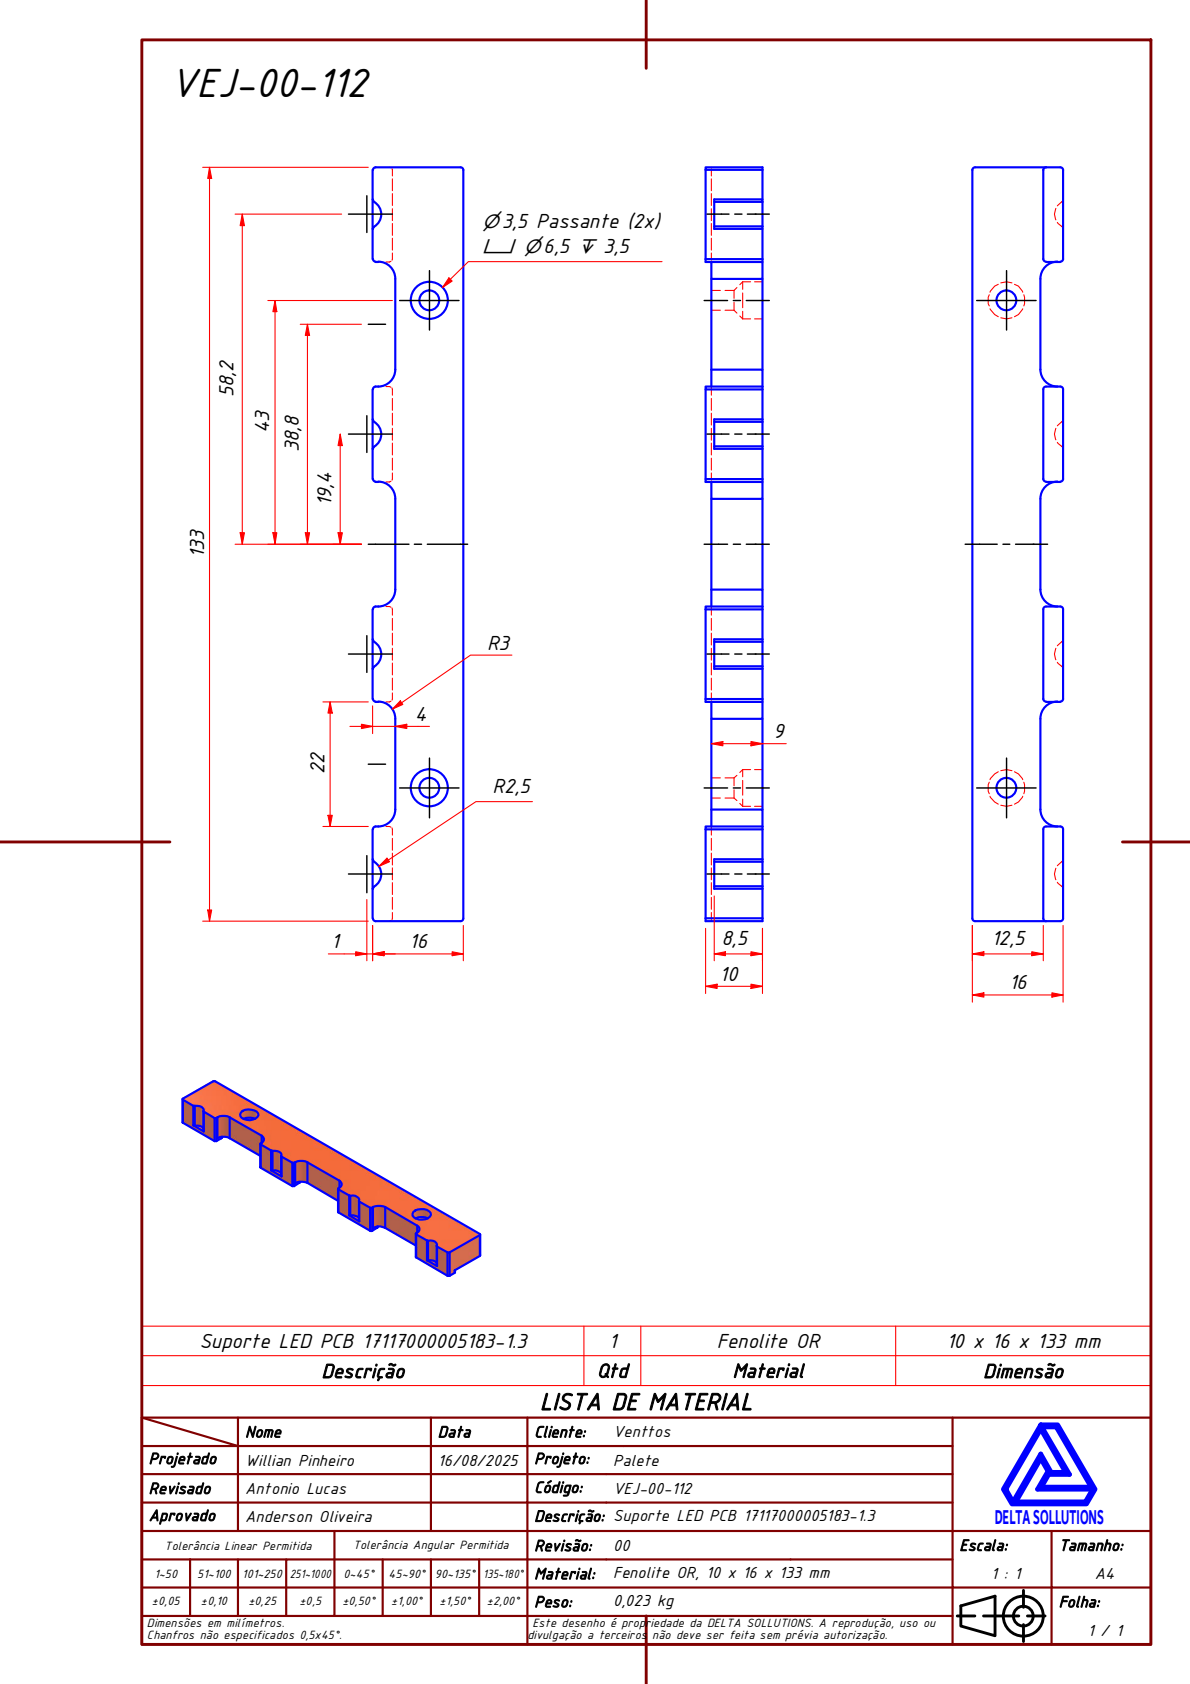
[picture p146: page 1]
⌀ 3,5 Passante (2x) ⌴ ⌀ 6,5 ↧ 3,5

Suporte LED PCB 17117000005183-1.3 | 1 | Fenolite OR | 10 x 16 x 133 mm

Descrição | Qtd | Material | Dimensão

LISTA DE MATERIAL

Projetado | Nome | Data | Cliente: Venttos

Willian Pinheiro | 16/08/2025 | Projeto: Palete

Revisado | Antonio Lucas | | Código: VEJ-00-112 | | DELTA SOLLUTIONS

Aprovado | Anderson Oliveira | | Descrição: Suporte LED PCB 17117000005183-1.3

Tolerância Linear Permitida | Tolerância Angular Permitida | Revisão: 00 | Escala: 1 : 1 | Tamanho: A4

1~50 | 51~100 | 101~250 | 251~1000 | 0~45° | 45~90° | 90~135° | 135~180° | Material: Fenolite OR, 10 x 16 x 133 mm

±0,05 | ±0,10 | ±0,25 | ±0,5 | ±0,50° | ±1,00° | ±1,50° | ±2,00° | Peso: 0,023 kg | Folha: 1 / 1

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
