pvrezende/Dashboard/uploads/anexo-1755696901931-371487412.pdf

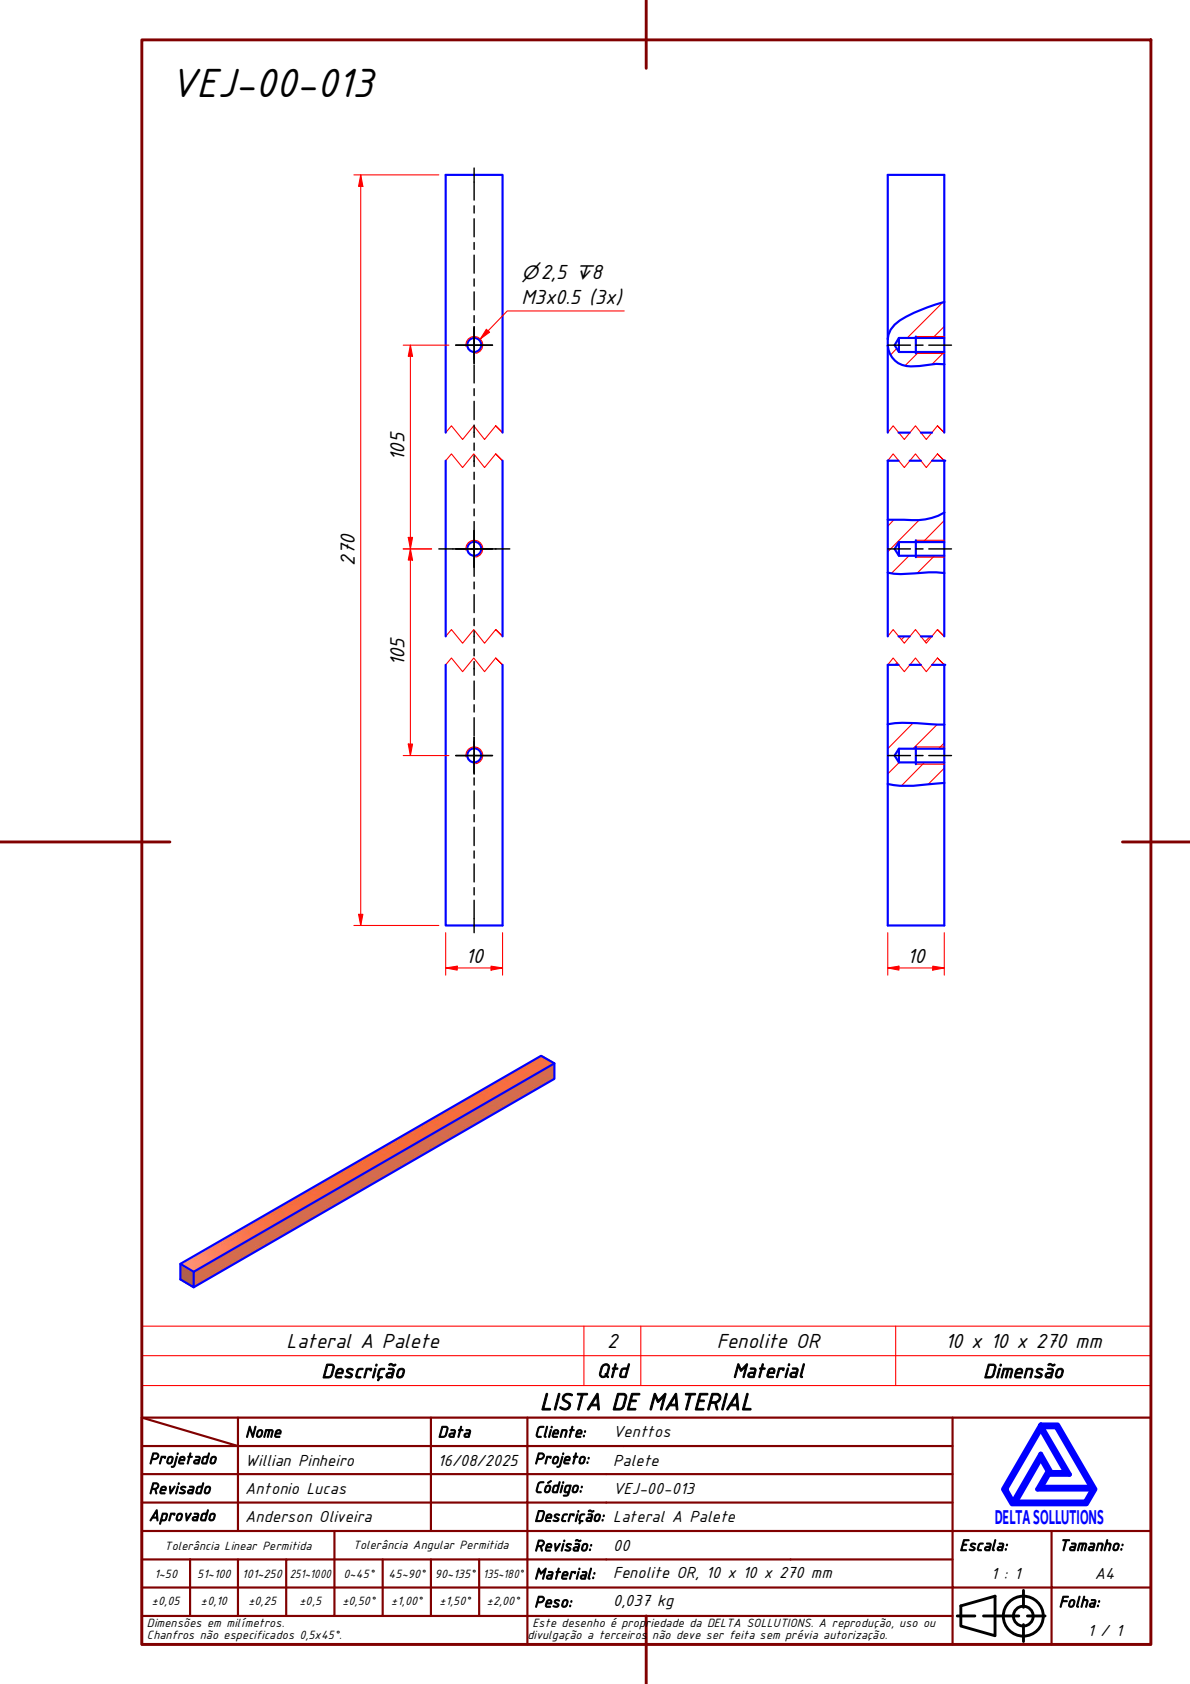
[picture p147: page 1]

Lateral A Palete | 2 | Fenolite OR | 10 x 10 x 270 mm
Descrição | Qtd | Material | Dimensão

LISTA DE MATERIAL

Projetado | Nome | Data | Cliente: Venttos | | DELTA SOLLUTIONS

Willian Pinheiro | 16/08/2025 | Projeto: Palete

Revisado | Antonio Lucas | | Código: VEJ-00-013

Aprovado | Anderson Oliveira | | Descrição: Lateral A Palete

Tolerância Linear Permitida | Tolerância Angular Permitida | Revisão: 00 | Escala: 1 : 1 | Tamanho: A4

1~50 | 51~100 | 101~250 | 251~1000 | 0~45° | 45~90° | 90~135° | 135~180° | Material: Fenolite OR, 10 x 10 x 270 mm

±0,05 | ±0,10 | ±0,25 | ±0,5 | ±0,50° | ±1,00° | ±1,50° | ±2,00° | Peso: 0,037 kg | Folha: 1 / 1

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
