pvrezende/Dashboard/uploads/anexo-1755697009065-676382024.pdf

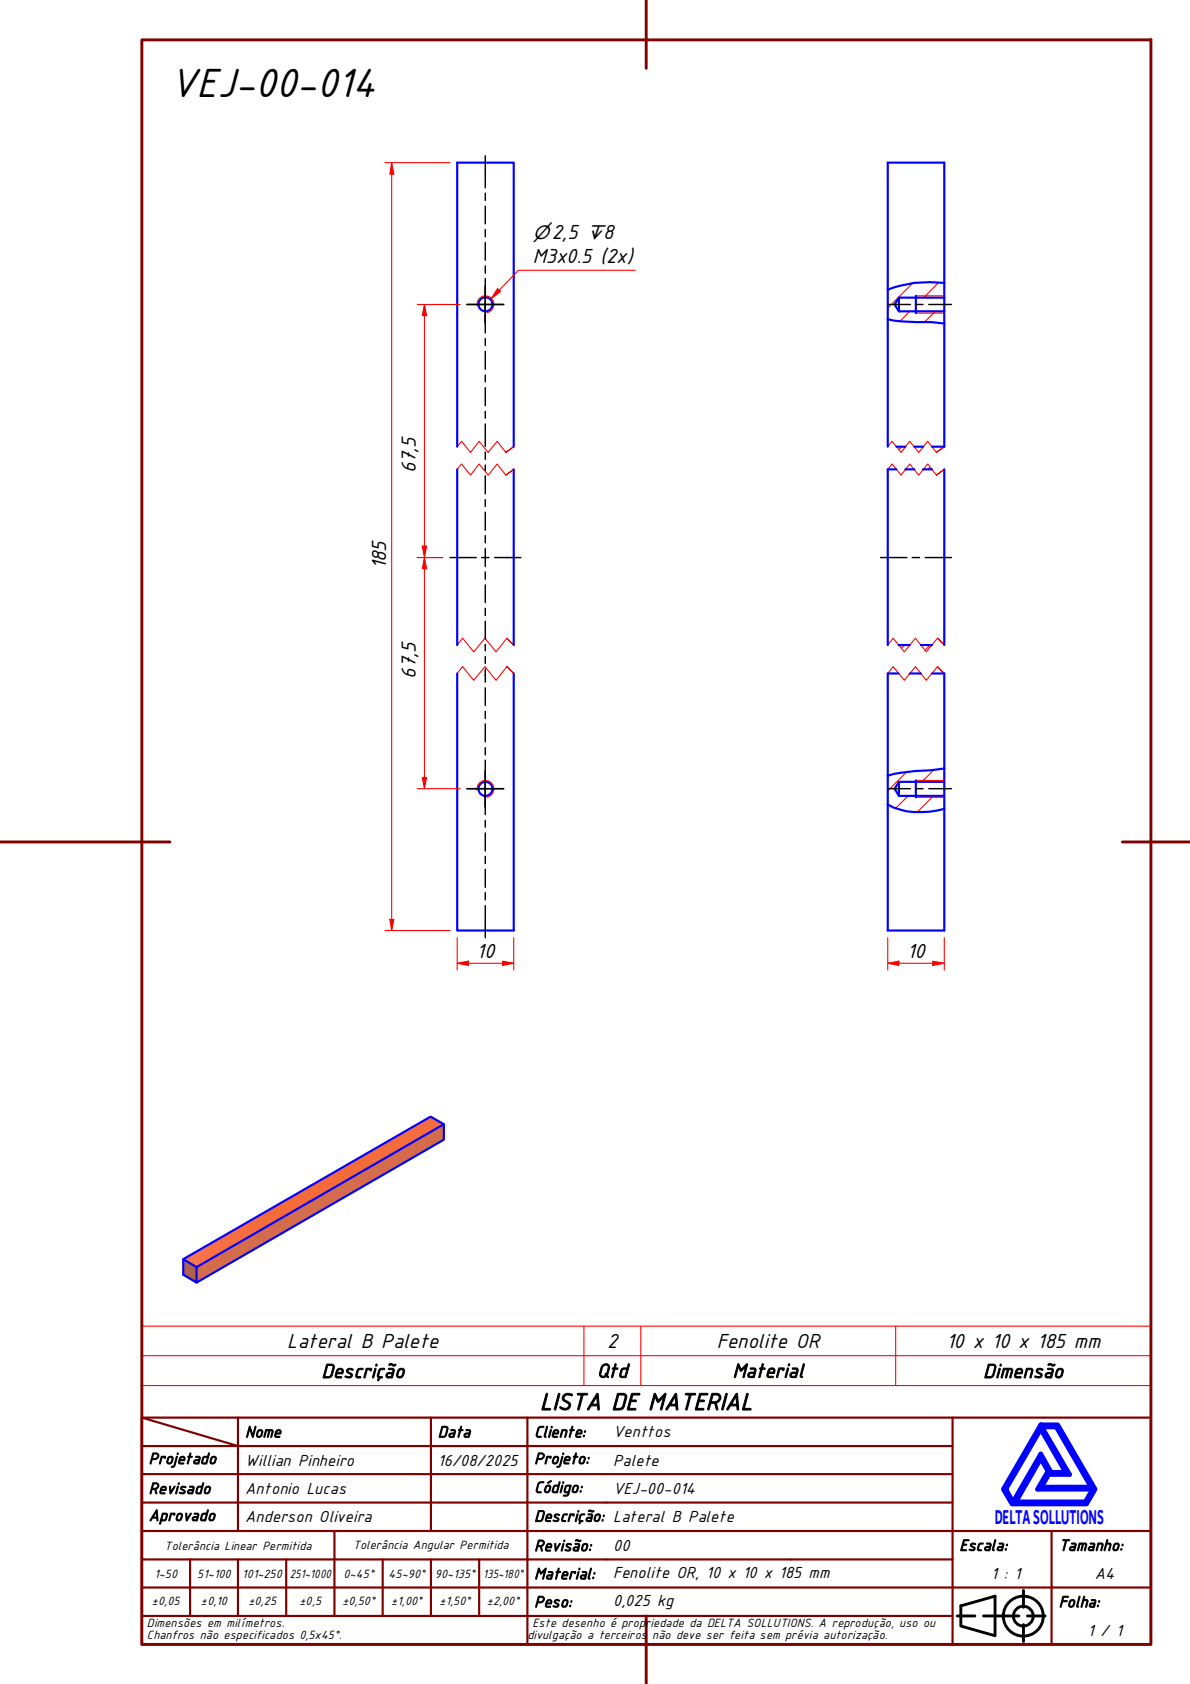
[picture p148: page 1]

Lateral B Palete | 2 | Fenolite OR | 10 x 10 x 185 mm
Descrição | Qtd | Material | Dimensão

LISTA DE MATERIAL

Projetado | Nome | Data | Cliente: Venttos | | DELTA SOLLUTIONS

Willian Pinheiro | 16/08/2025 | Projeto: Palete

Revisado | Antonio Lucas | | Código: VEJ-00-014

Aprovado | Anderson Oliveira | | Descrição: Lateral B Palete

Tolerância Linear Permitida | Tolerância Angular Permitida | Revisão: 00 | Escala: 1 : 1 | Tamanho: A4

1~50 | 51~100 | 101~250 | 251~1000 | 0~45° | 45~90° | 90~135° | 135~180° | Material: Fenolite OR, 10 x 10 x 185 mm

±0,05 | ±0,10 | ±0,25 | ±0,5 | ±0,50° | ±1,00° | ±1,50° | ±2,00° | Peso: 0,025 kg | Folha: 1 / 1

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
