pvrezende/Dashboard/uploads/anexo-1755697089160-420882086.pdf

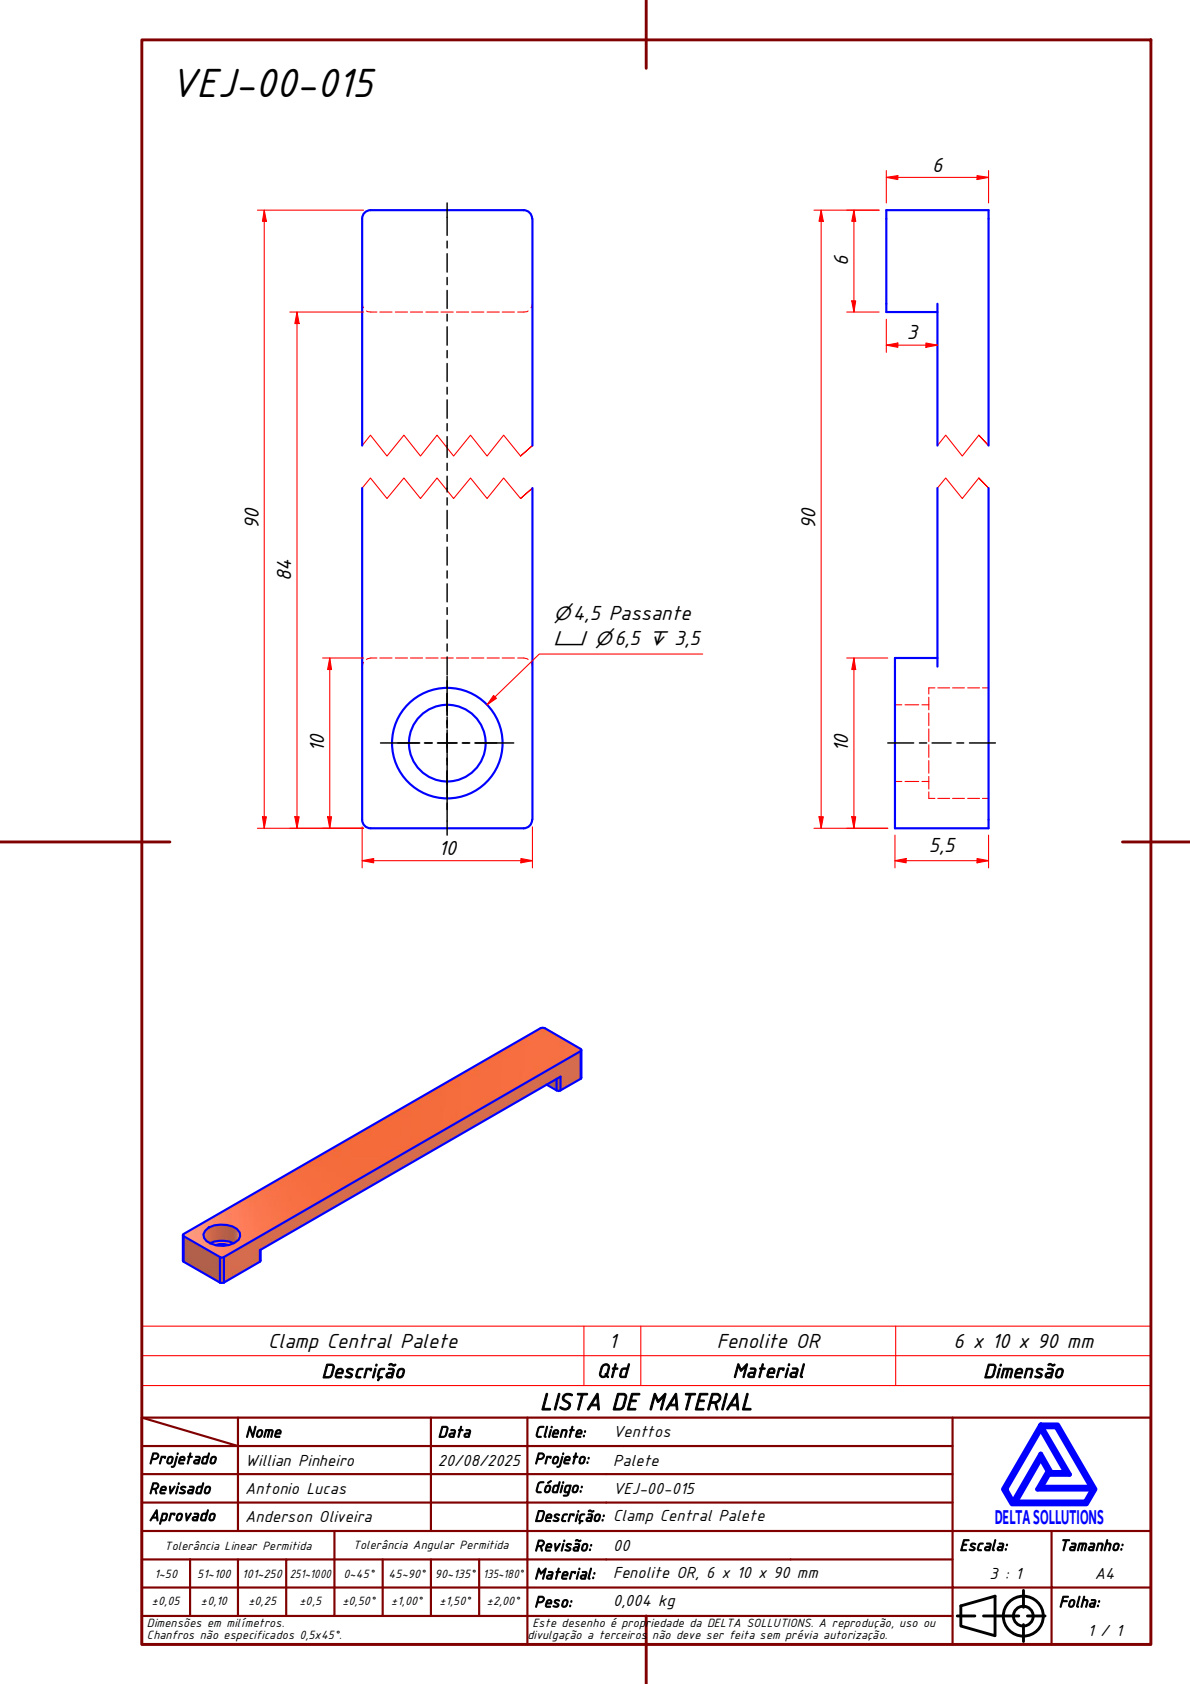
[picture p149: page 1]
⌀ 4,5 Passante ⌴ ⌀ 6,5 ↧ 3,5

Clamp Central Palete | 1 | Fenolite OR | 6 x 10 x 90 mm
Descrição | Qtd | Material | Dimensão

LISTA DE MATERIAL

Projetado | Nome | Data | Cliente: Venttos | | DELTA SOLLUTIONS

Willian Pinheiro | 20/08/2025 | Projeto: Palete

Revisado | Antonio Lucas | | Código: VEJ-00-015

Aprovado | Anderson Oliveira | | Descrição: Clamp Central Palete

Tolerância Linear Permitida | Tolerância Angular Permitida | Revisão: 00 | Escala: 3 : 1 | Tamanho: A4

1~50 | 51~100 | 101~250 | 251~1000 | 0~45° | 45~90° | 90~135° | 135~180° | Material: Fenolite OR, 6 x 10 x 90 mm

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
