pvrezende/Dashboard/uploads/anexo-1754421971421-132405894.pdf

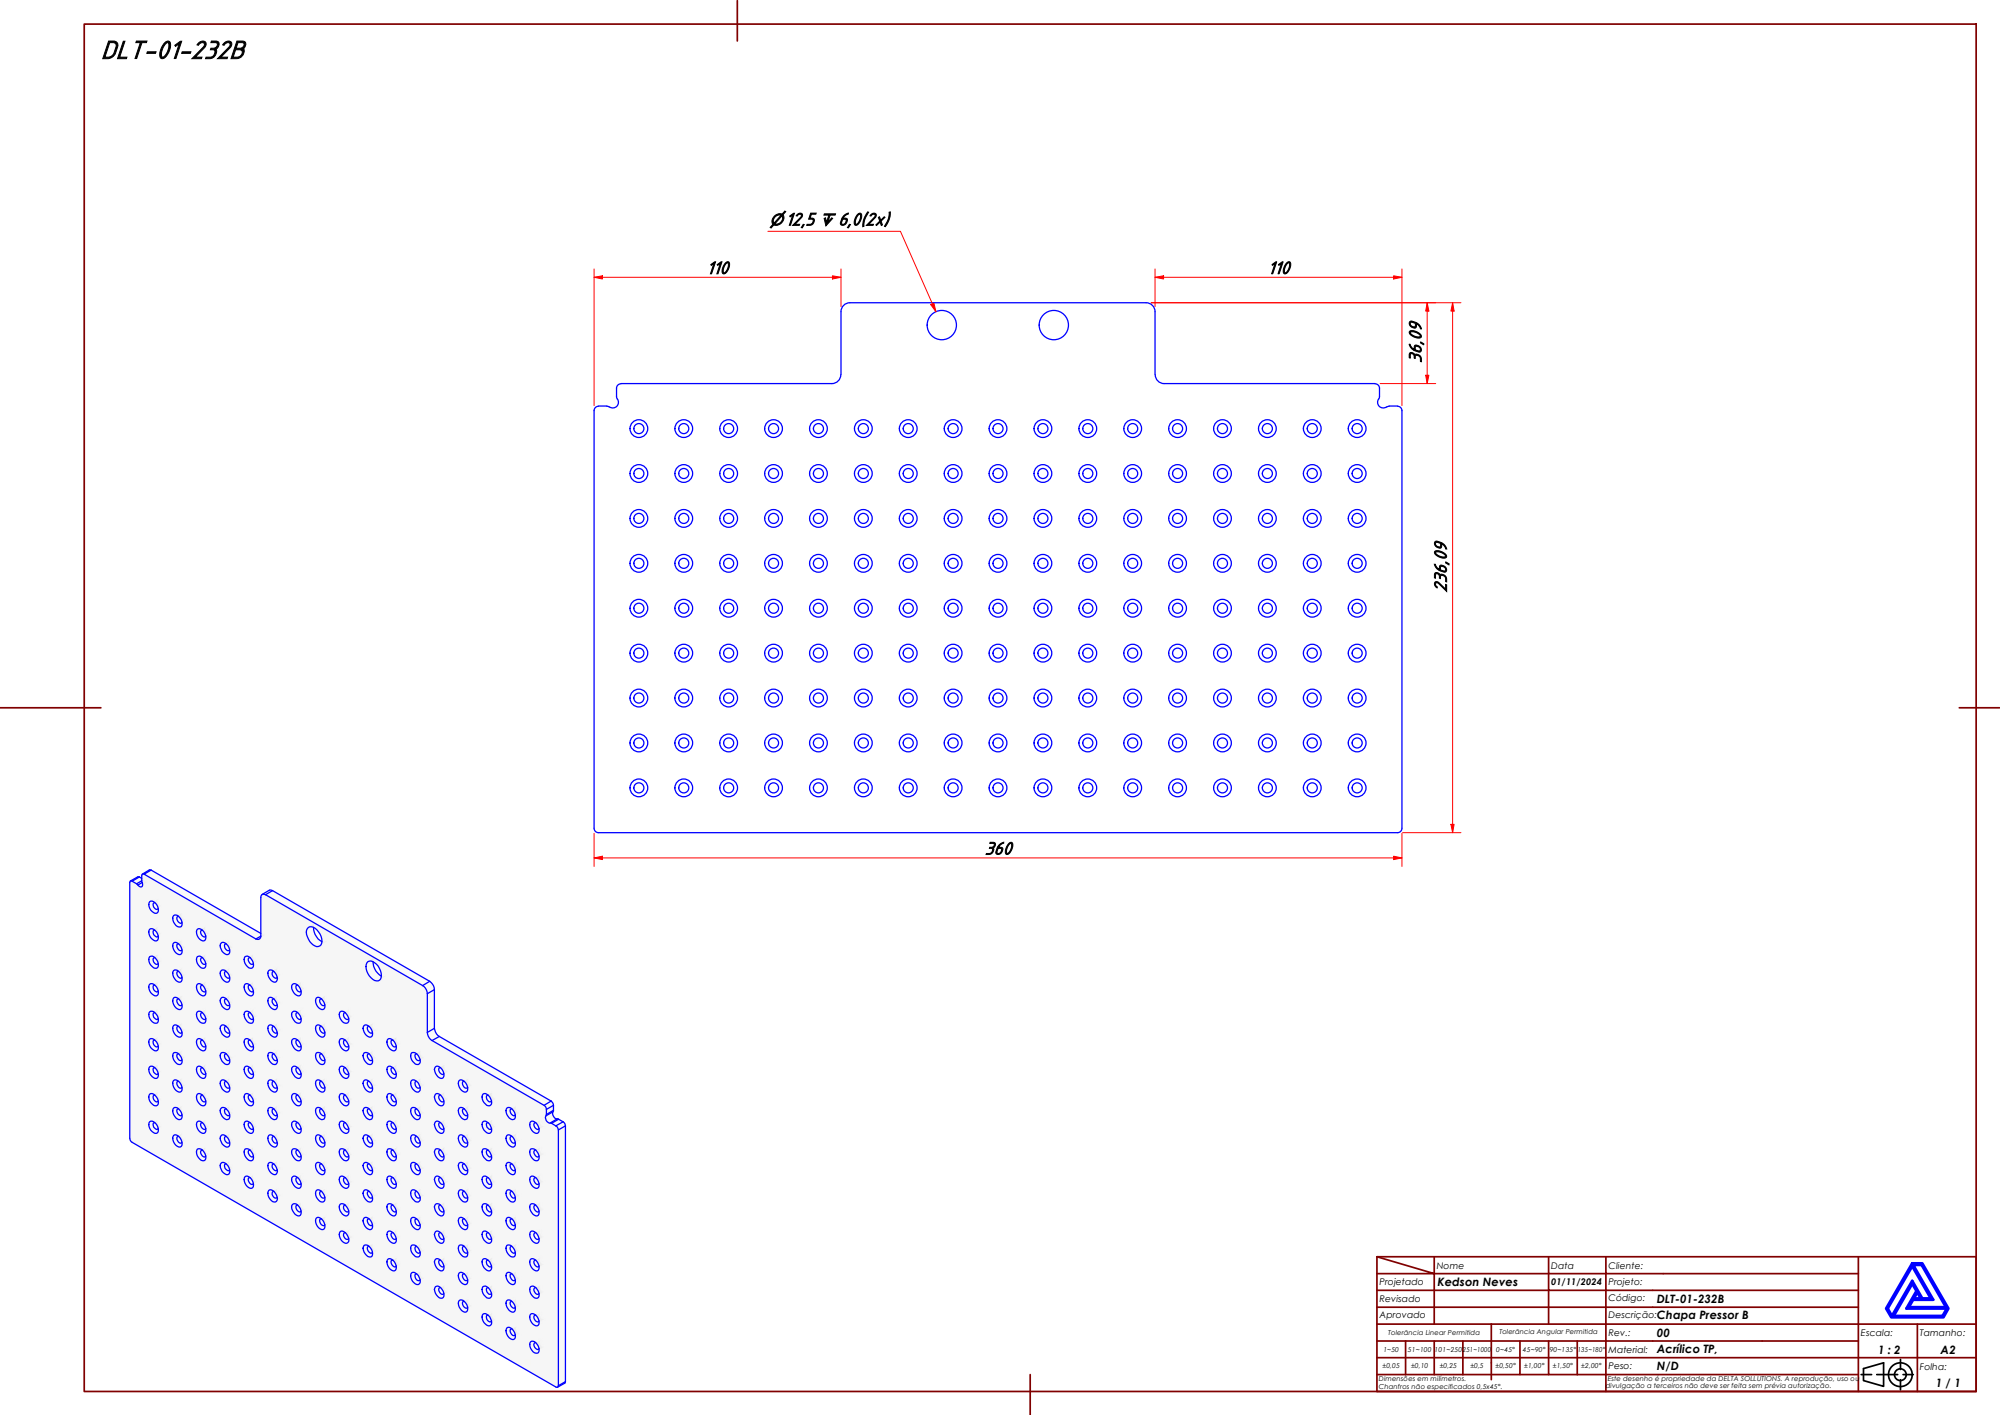
[picture p150: page 1]

Projetado | Nome | Data | Cliente:

Kedson Neves | 01/11/2024 | Projeto:

Revisado | | | Código: DLT-01-232B
Aprovado | | | Descrição: Chapa Pressor B
Tolerância Linear Permitida | Tolerância Angular Permitida | Rev.: 00 | Escala: 1 : 2 | Tamanho: A2

1~50 | 51~100 | 101~250 | 251~1000 | 0~45° | 45~90° | 90~135° 135~180° | | Acrílico TP, Material:

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

Dimensões em milímetros.

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
