pvrezende/Dashboard/uploads/anexo-1754492755353-317194720.pdf

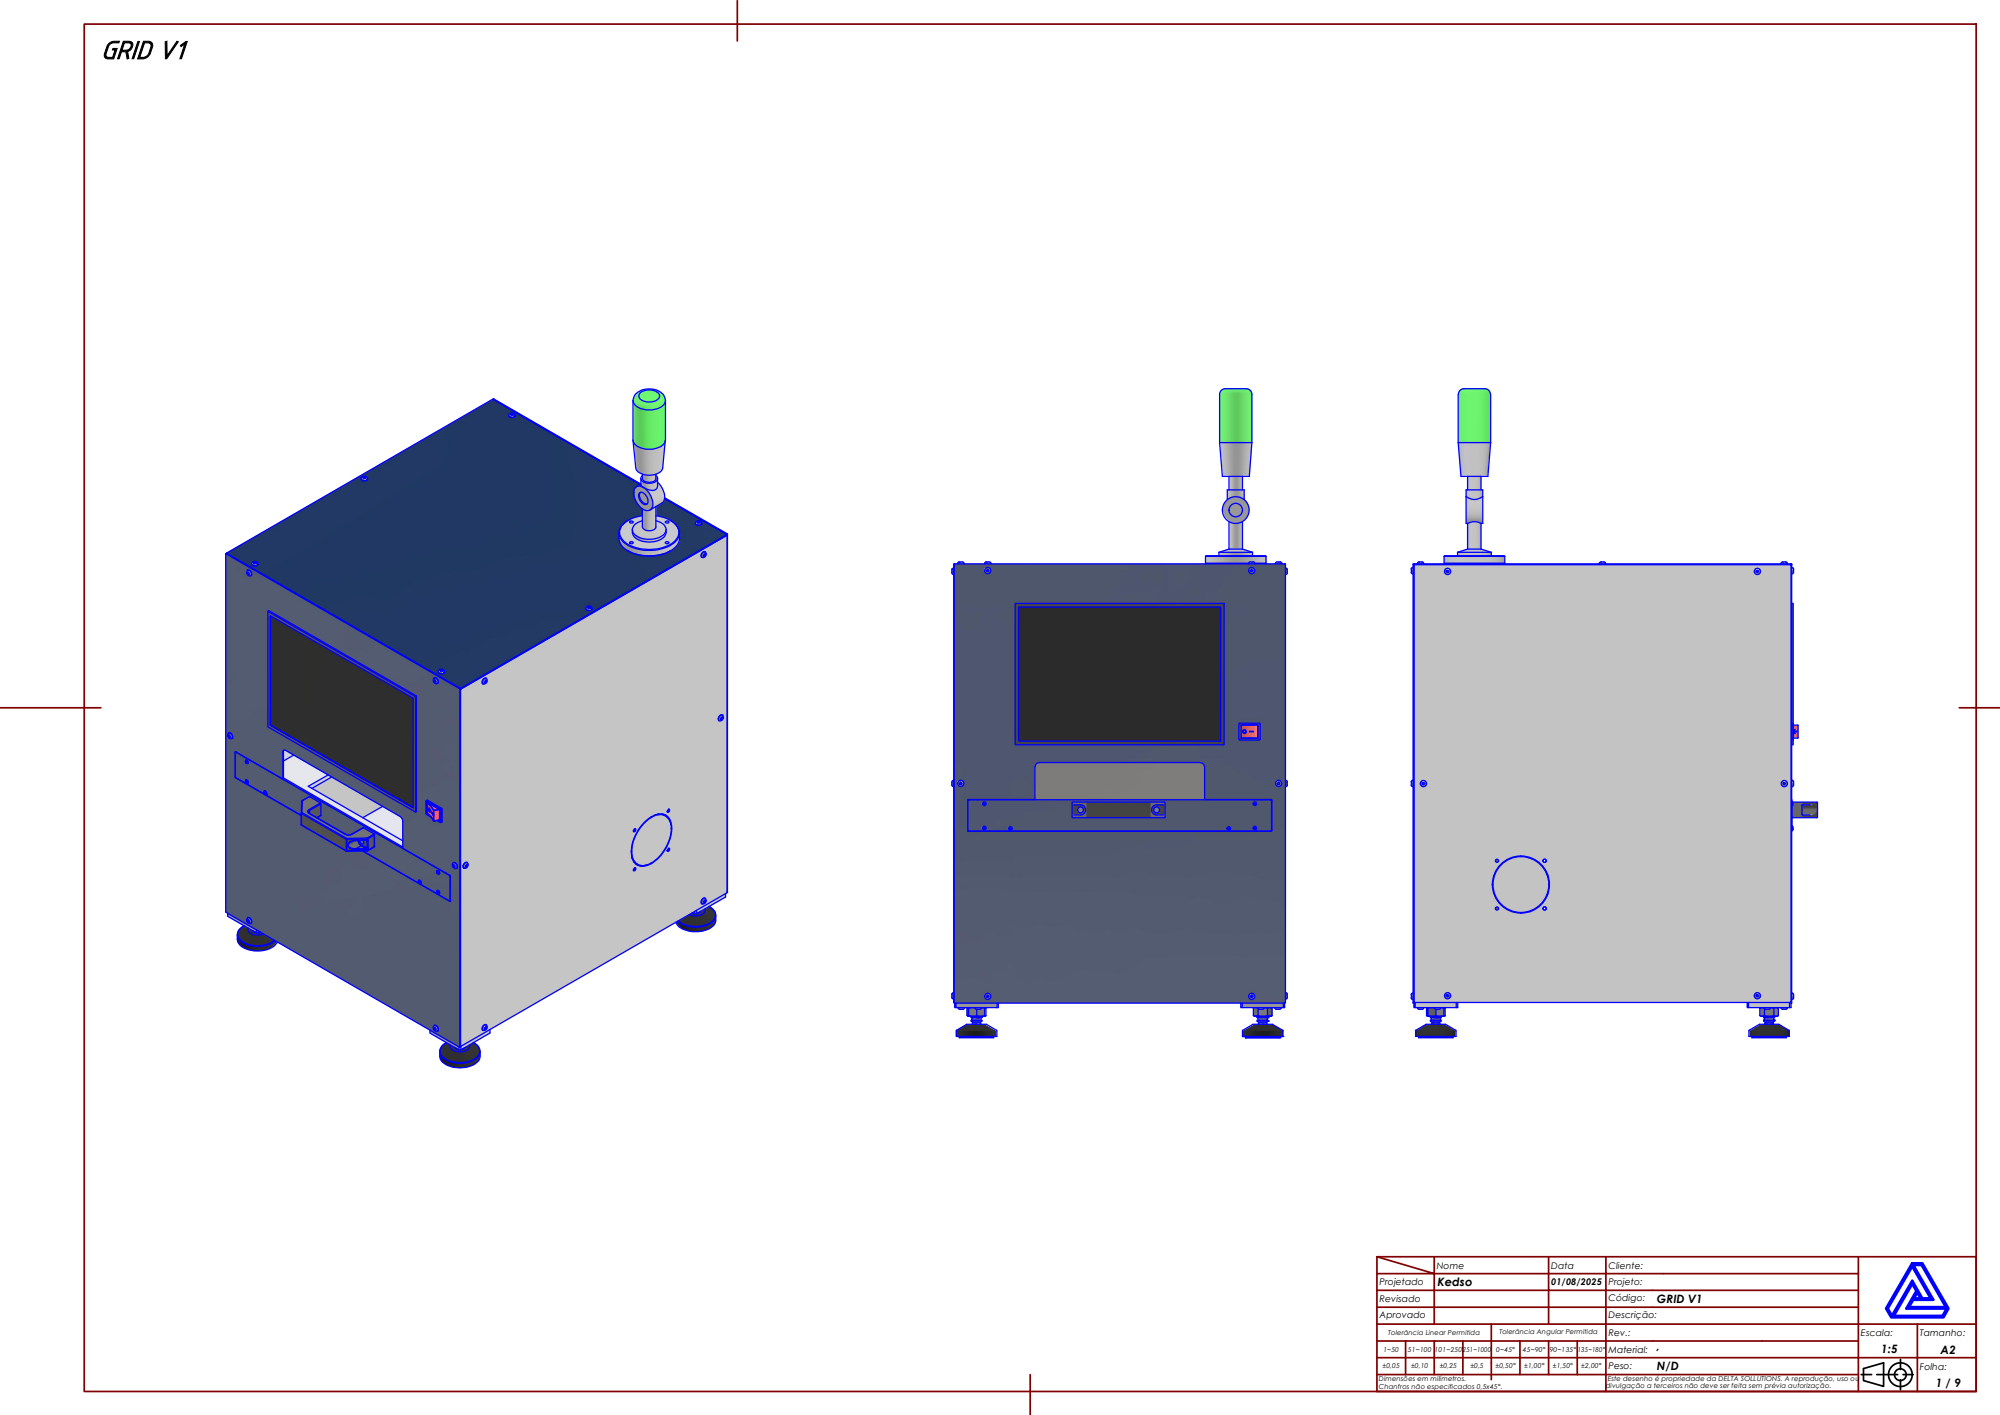
[picture p151: page 1]
GRID V1

Projetado | Nome | Data | Cliente:

Kedso | 01/08/2025 | Projeto:

Revisado | | | Código: GRID V1

Aprovado | | | Descrição:
Tolerância Linear Permitida | Tolerância Angular Permitida | Rev.: | Escala: 1:5 | Tamanho: A2
1~50 | 51~100 | 101~250 | | | | 90~135° 135~180° | | , Material:

±1,00° | | ±2,00° | Peso: N/D | Folha: 1 / 9

Dimensões em milímetros.

Chanfros não especificados 0,5x45°. | | | | | | | | Este desenho é propriedade da DELTA SOLLUTIONS. A reprodução, uso ou divulgação a terceiros não deve ser feita sem prévia autorização.

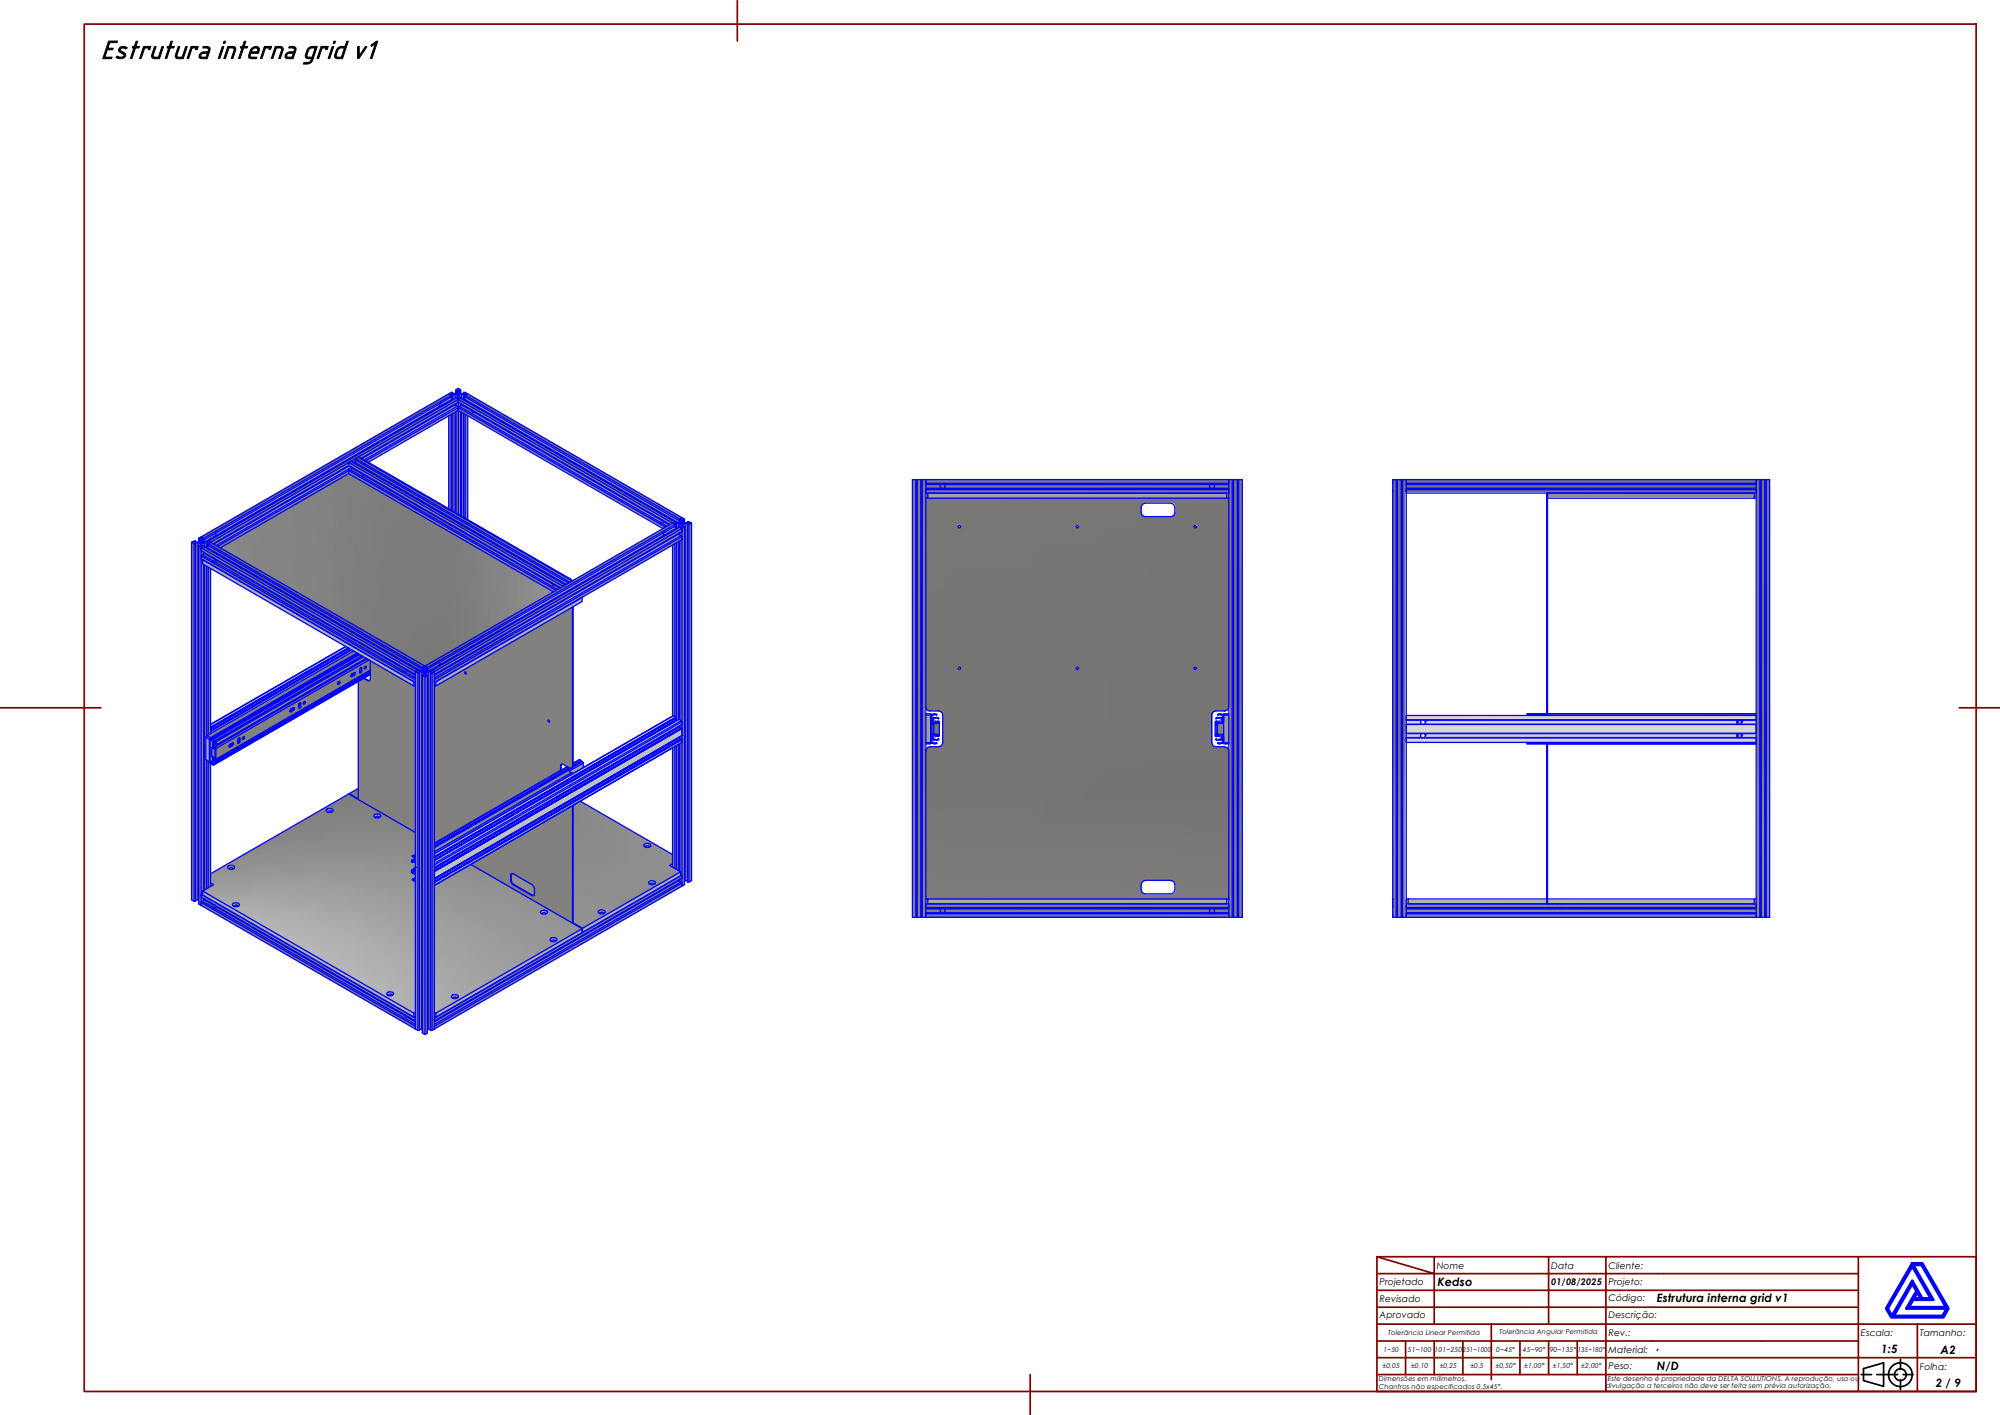
[picture p152: page 2]

Estrutura interna grid v1

Projetado | Nome | Data | Cliente:

Kedso | 01/08/2025 | Projeto:

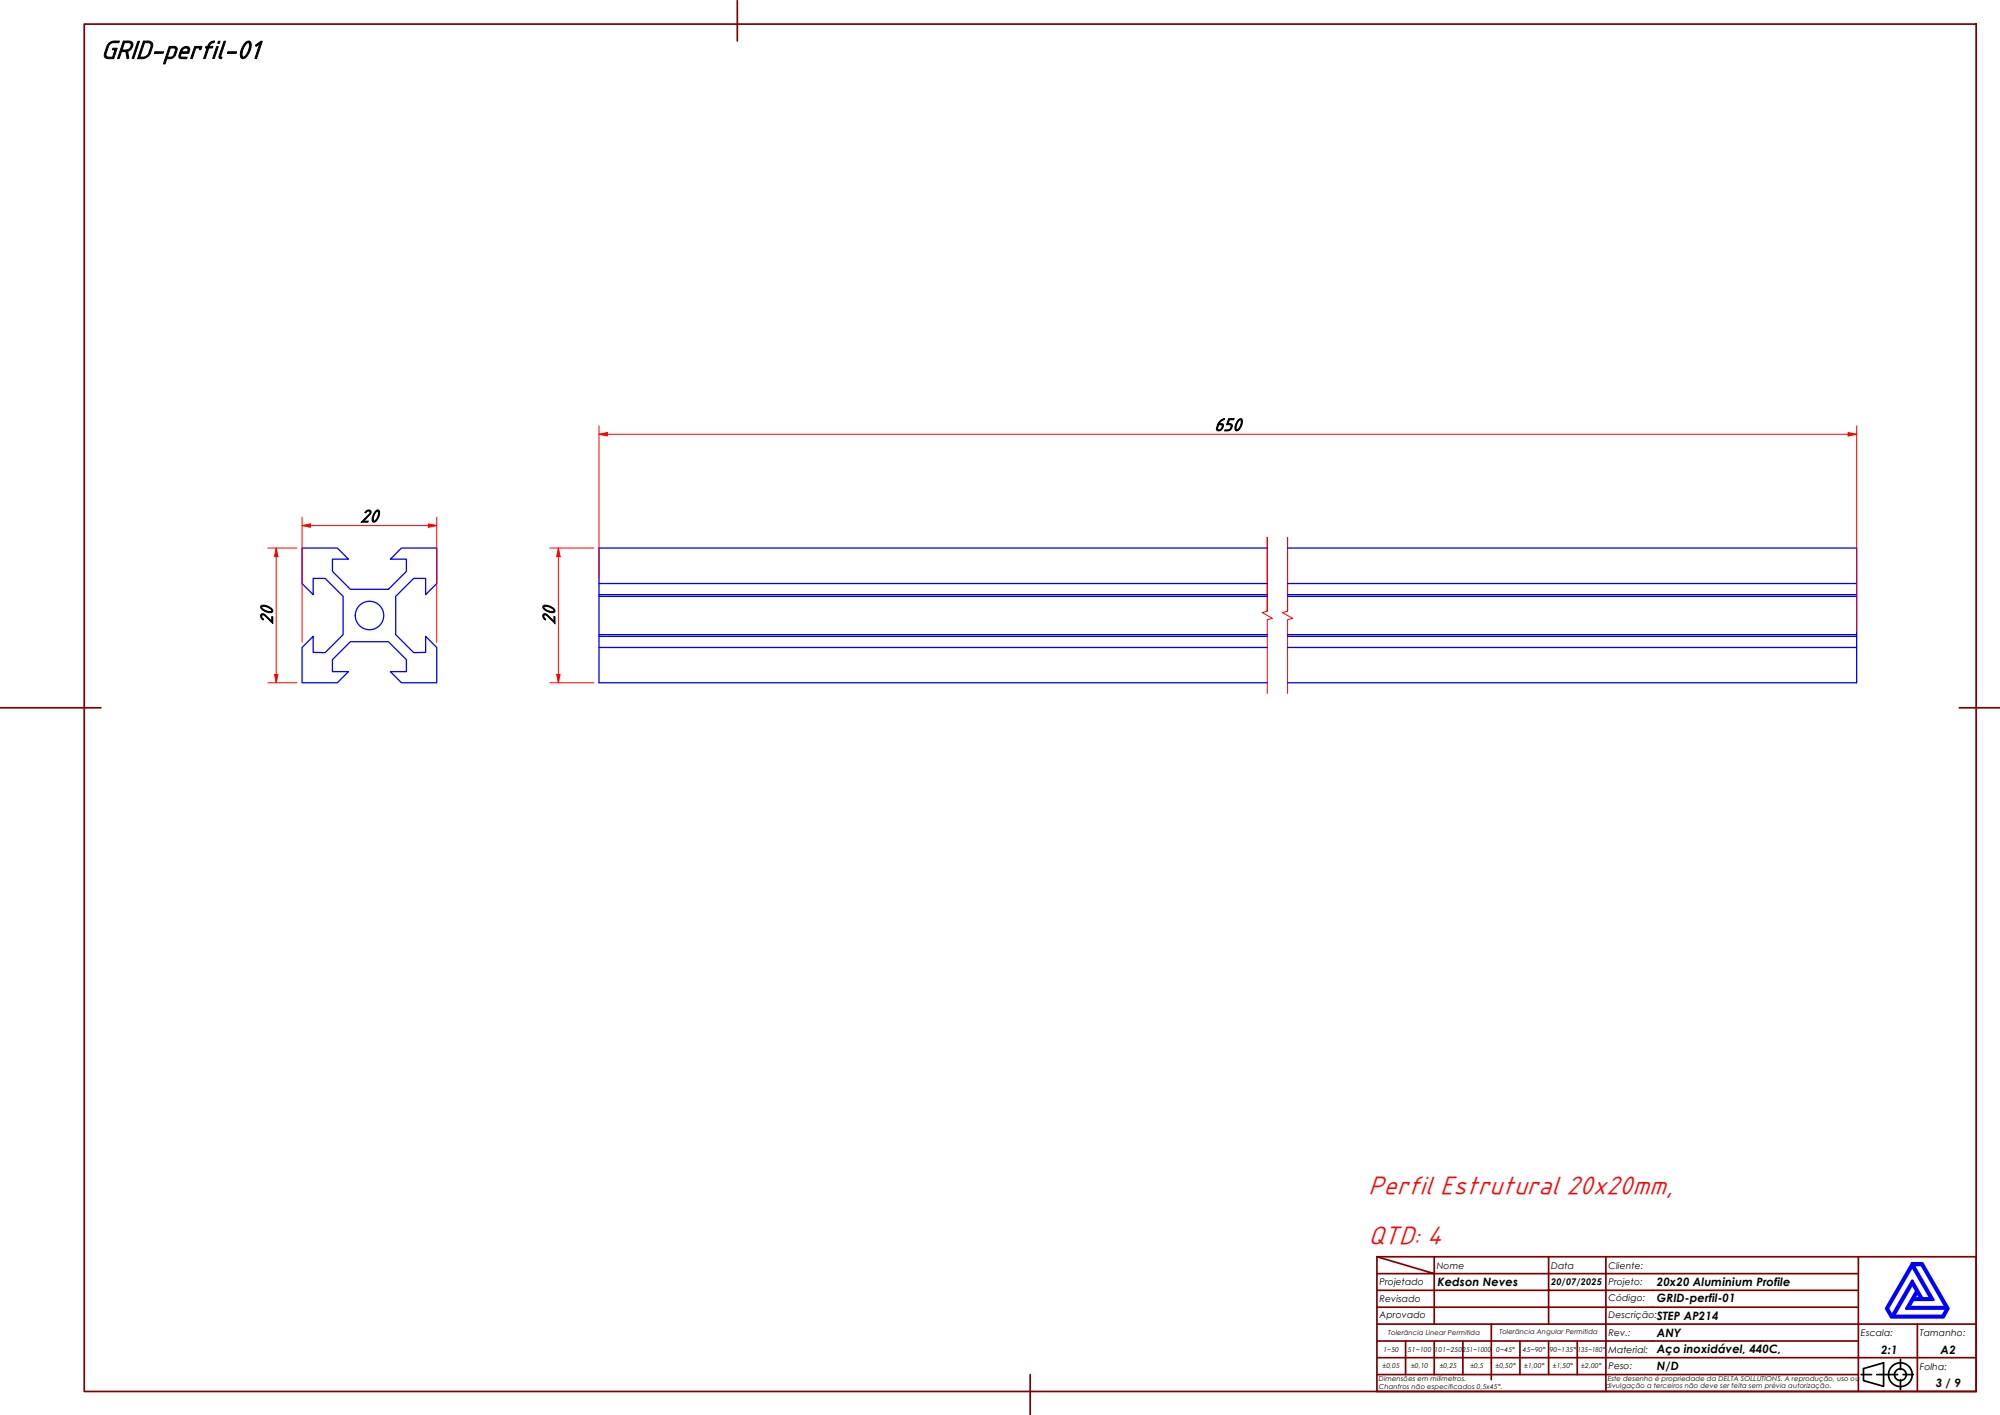
[picture p153: page 3]
Perfil Estrutural 20x20mm,; QTD: 4

Projetado | Nome | Data | Cliente:

Kedson Neves | 20/07/2025 | Projeto: 20x20 Aluminium Profile

GRID-perfil-01
STEP AP214

Rev.: ANY | 2:1

101~250 | | | Aço inoxidável, 440C,

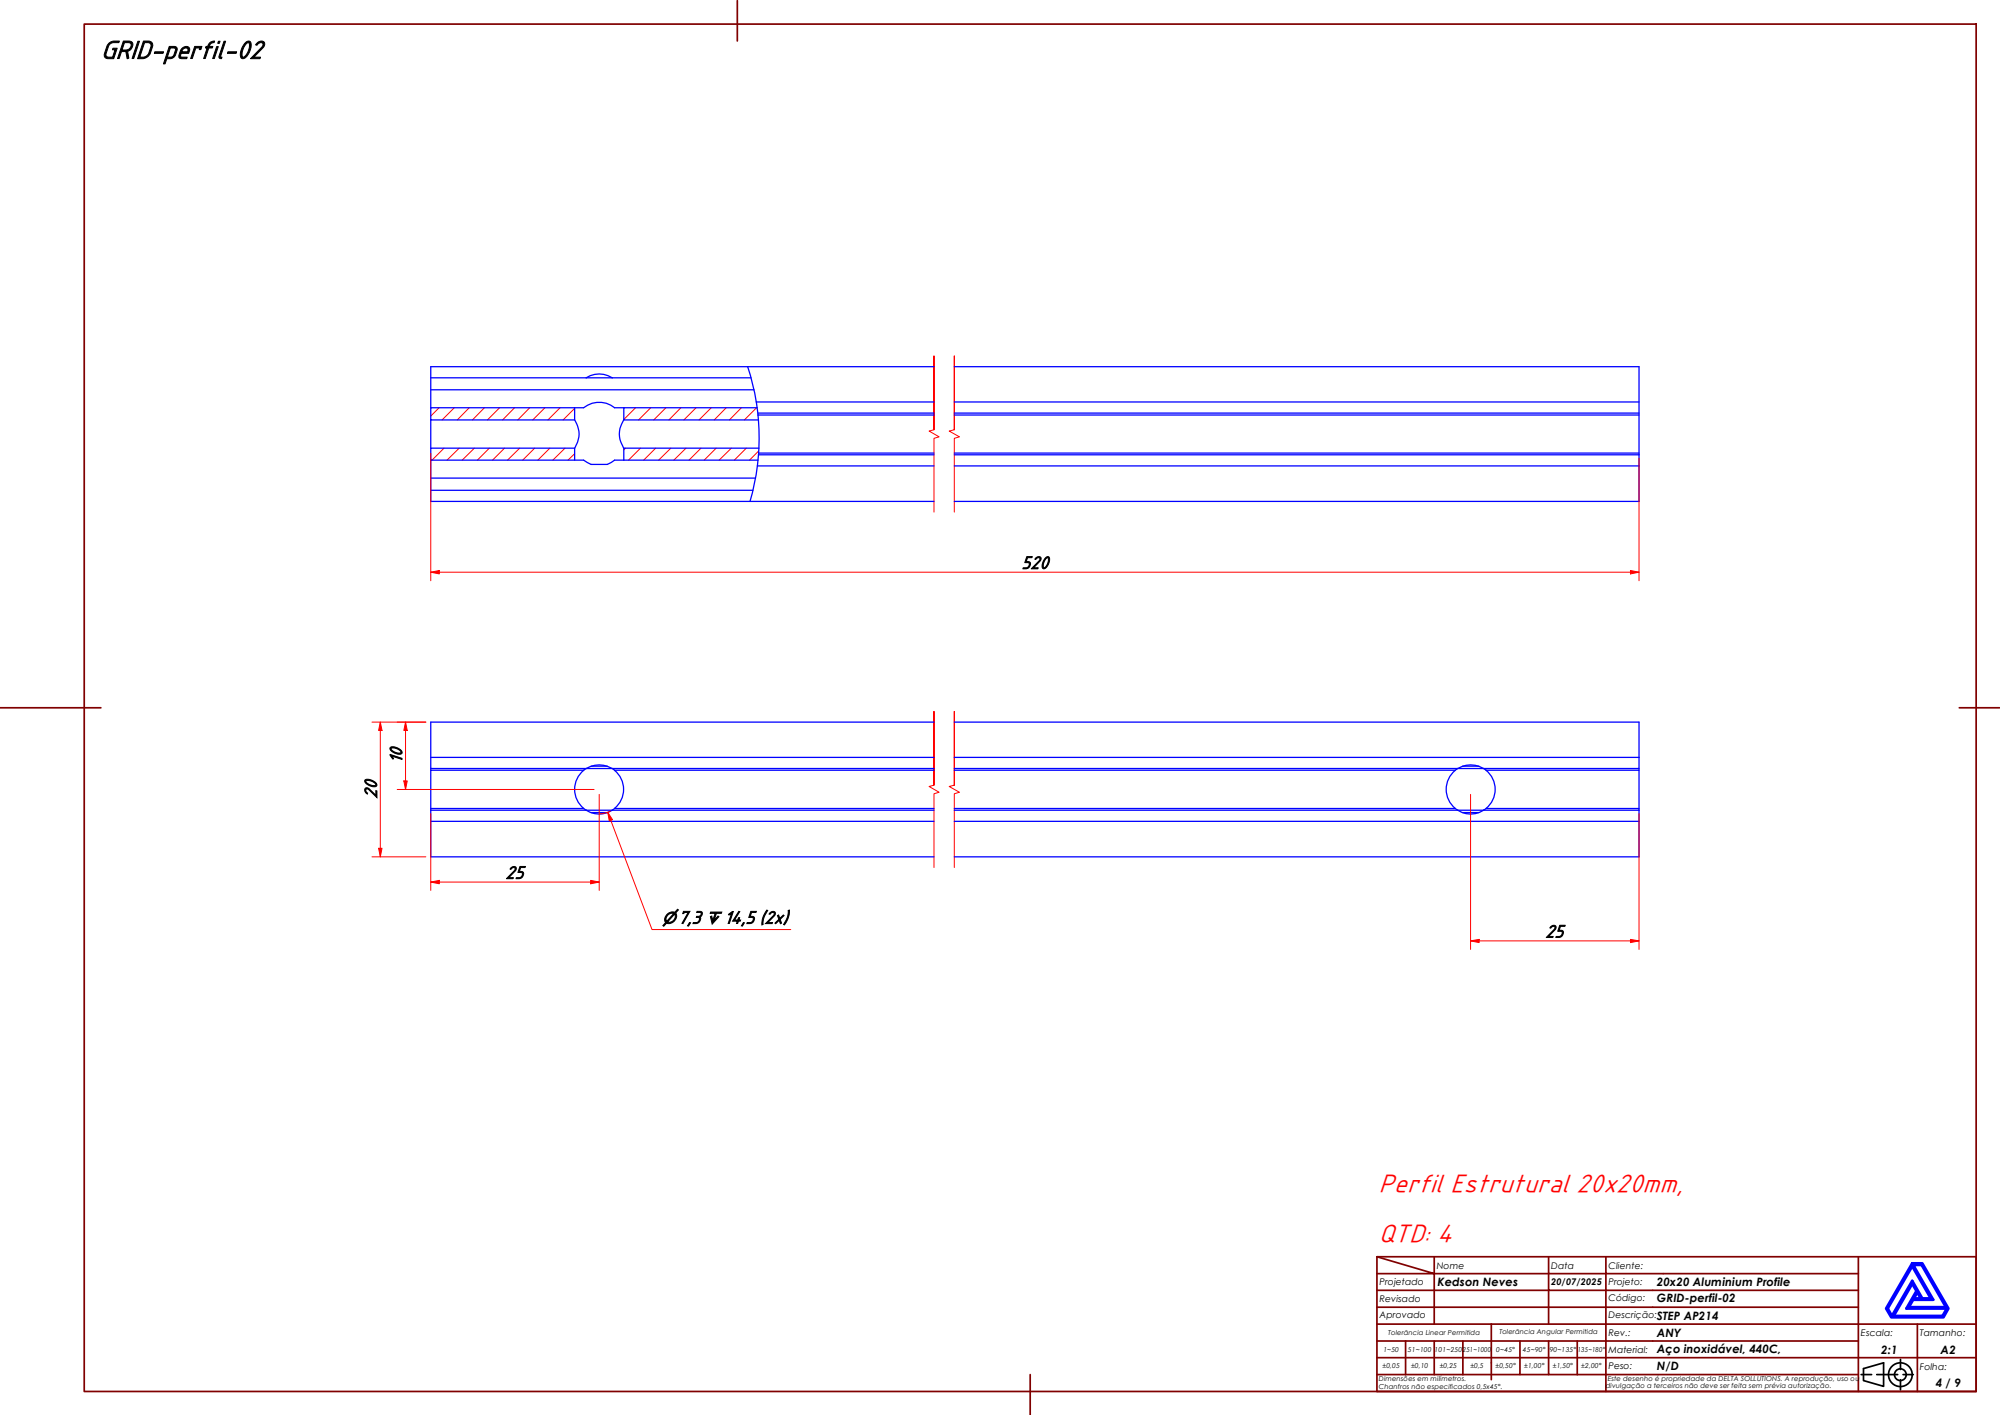
[picture p154: page 4]
Perfil Estrutural 20x20mm,; QTD: 4

Projetado | Nome | Data | Cliente:

Kedson Neves | 20/07/2025 | Projeto: 20x20 Aluminium Profile

GRID-perfil-02
STEP AP214

Rev.: ANY

Aço inoxidável, 440C,

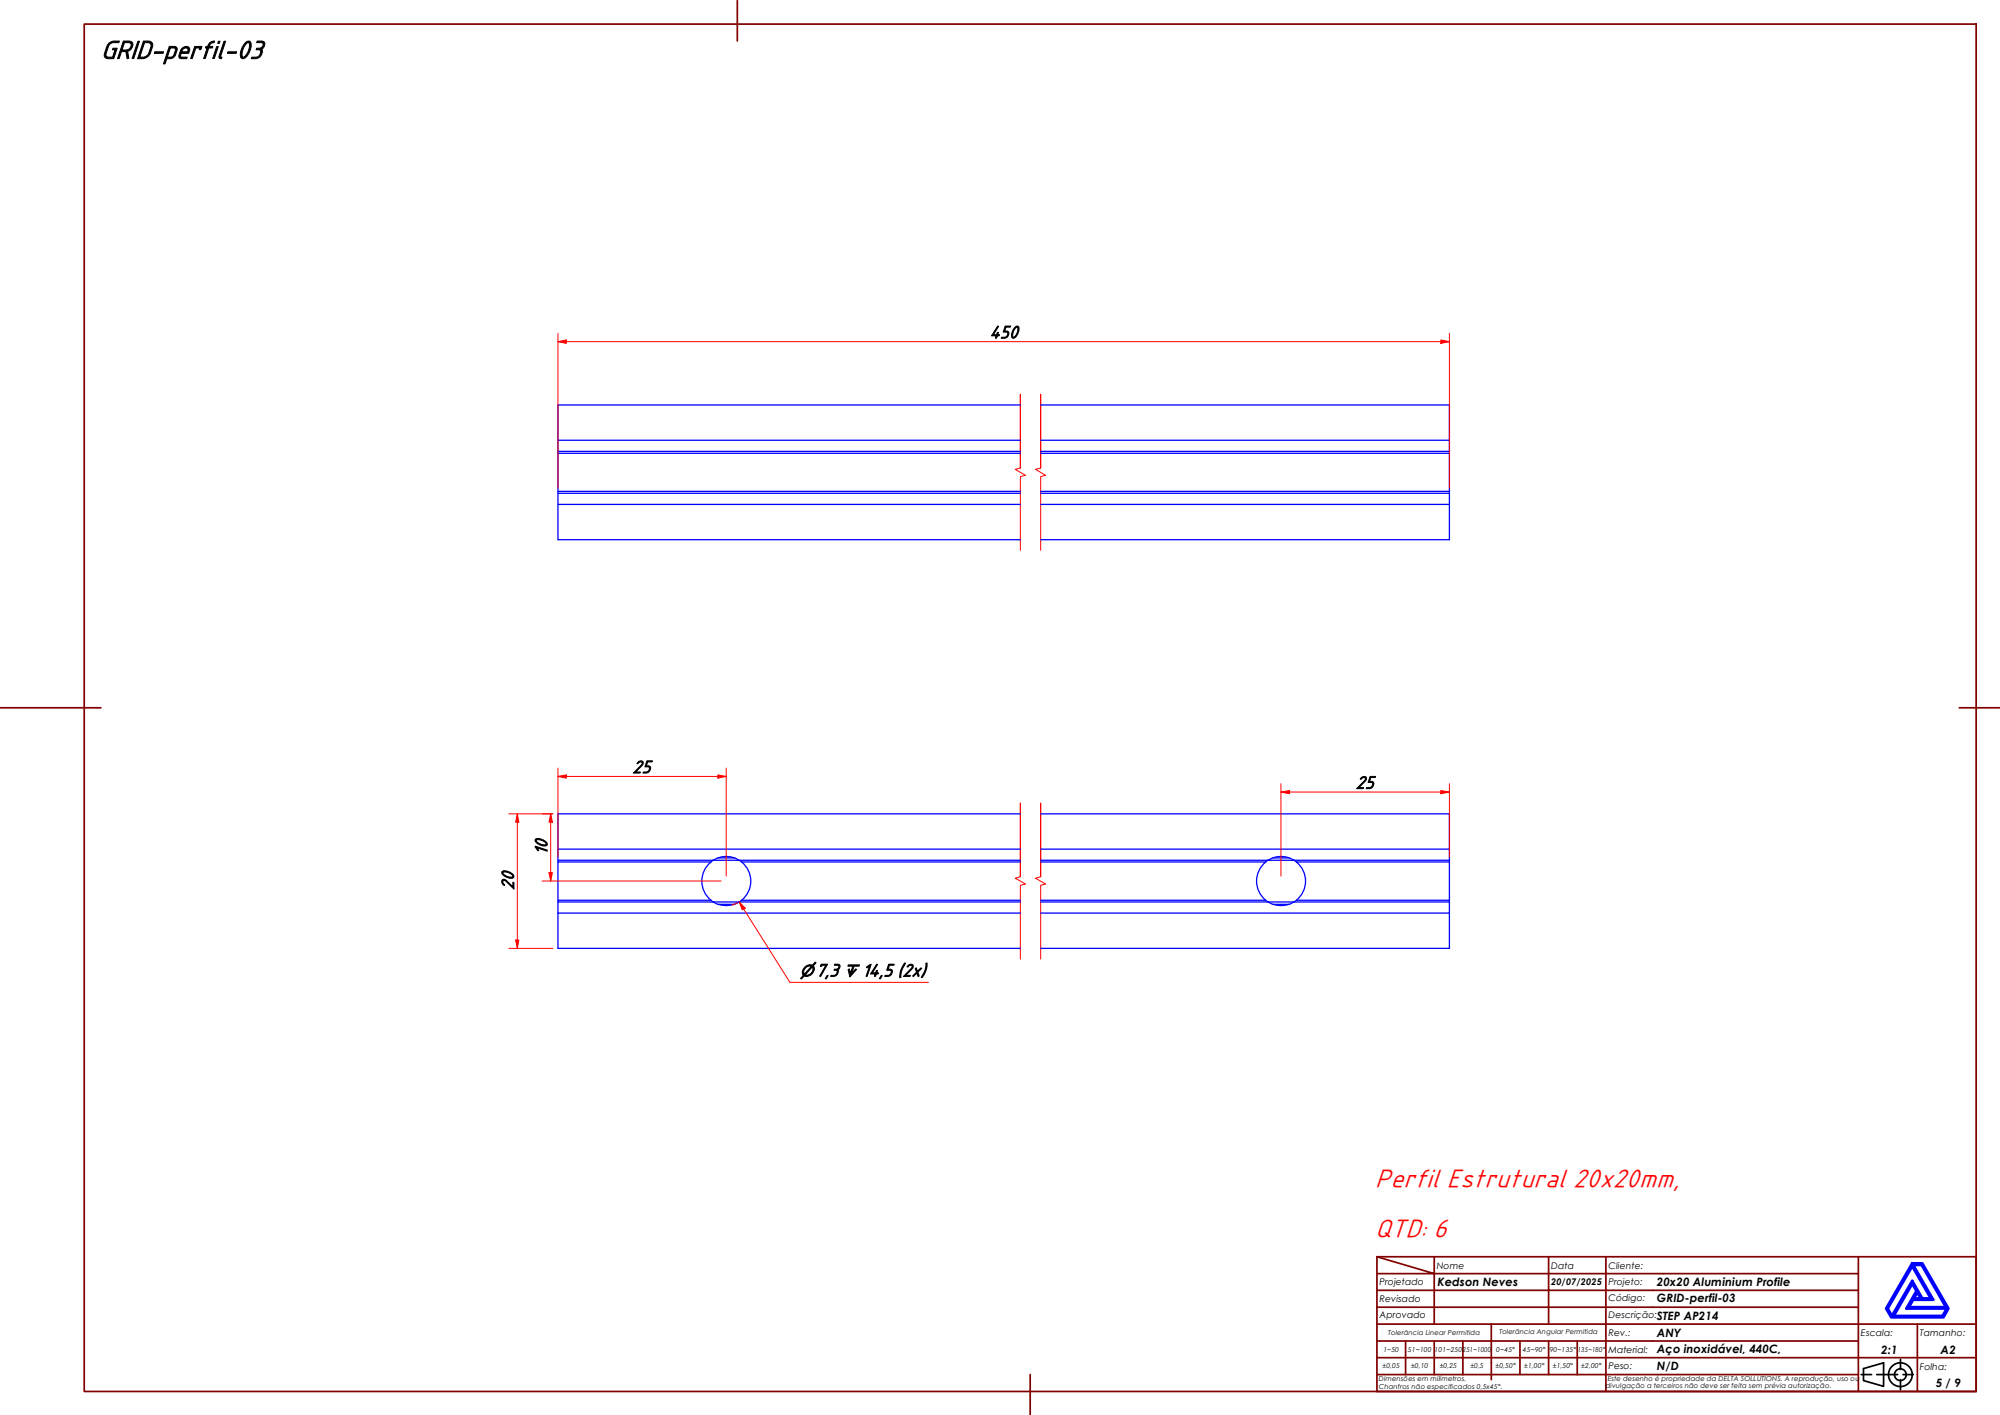
[picture p155: page 5]
Perfil Estrutural 20x20mm,; QTD: 6

Projetado | Nome | Data | Cliente:

Kedson Neves | 20/07/2025 | Projeto: 20x20 Aluminium Profile

GRID-perfil-03
STEP AP214

Rev.: ANY

Aço inoxidável, 440C,

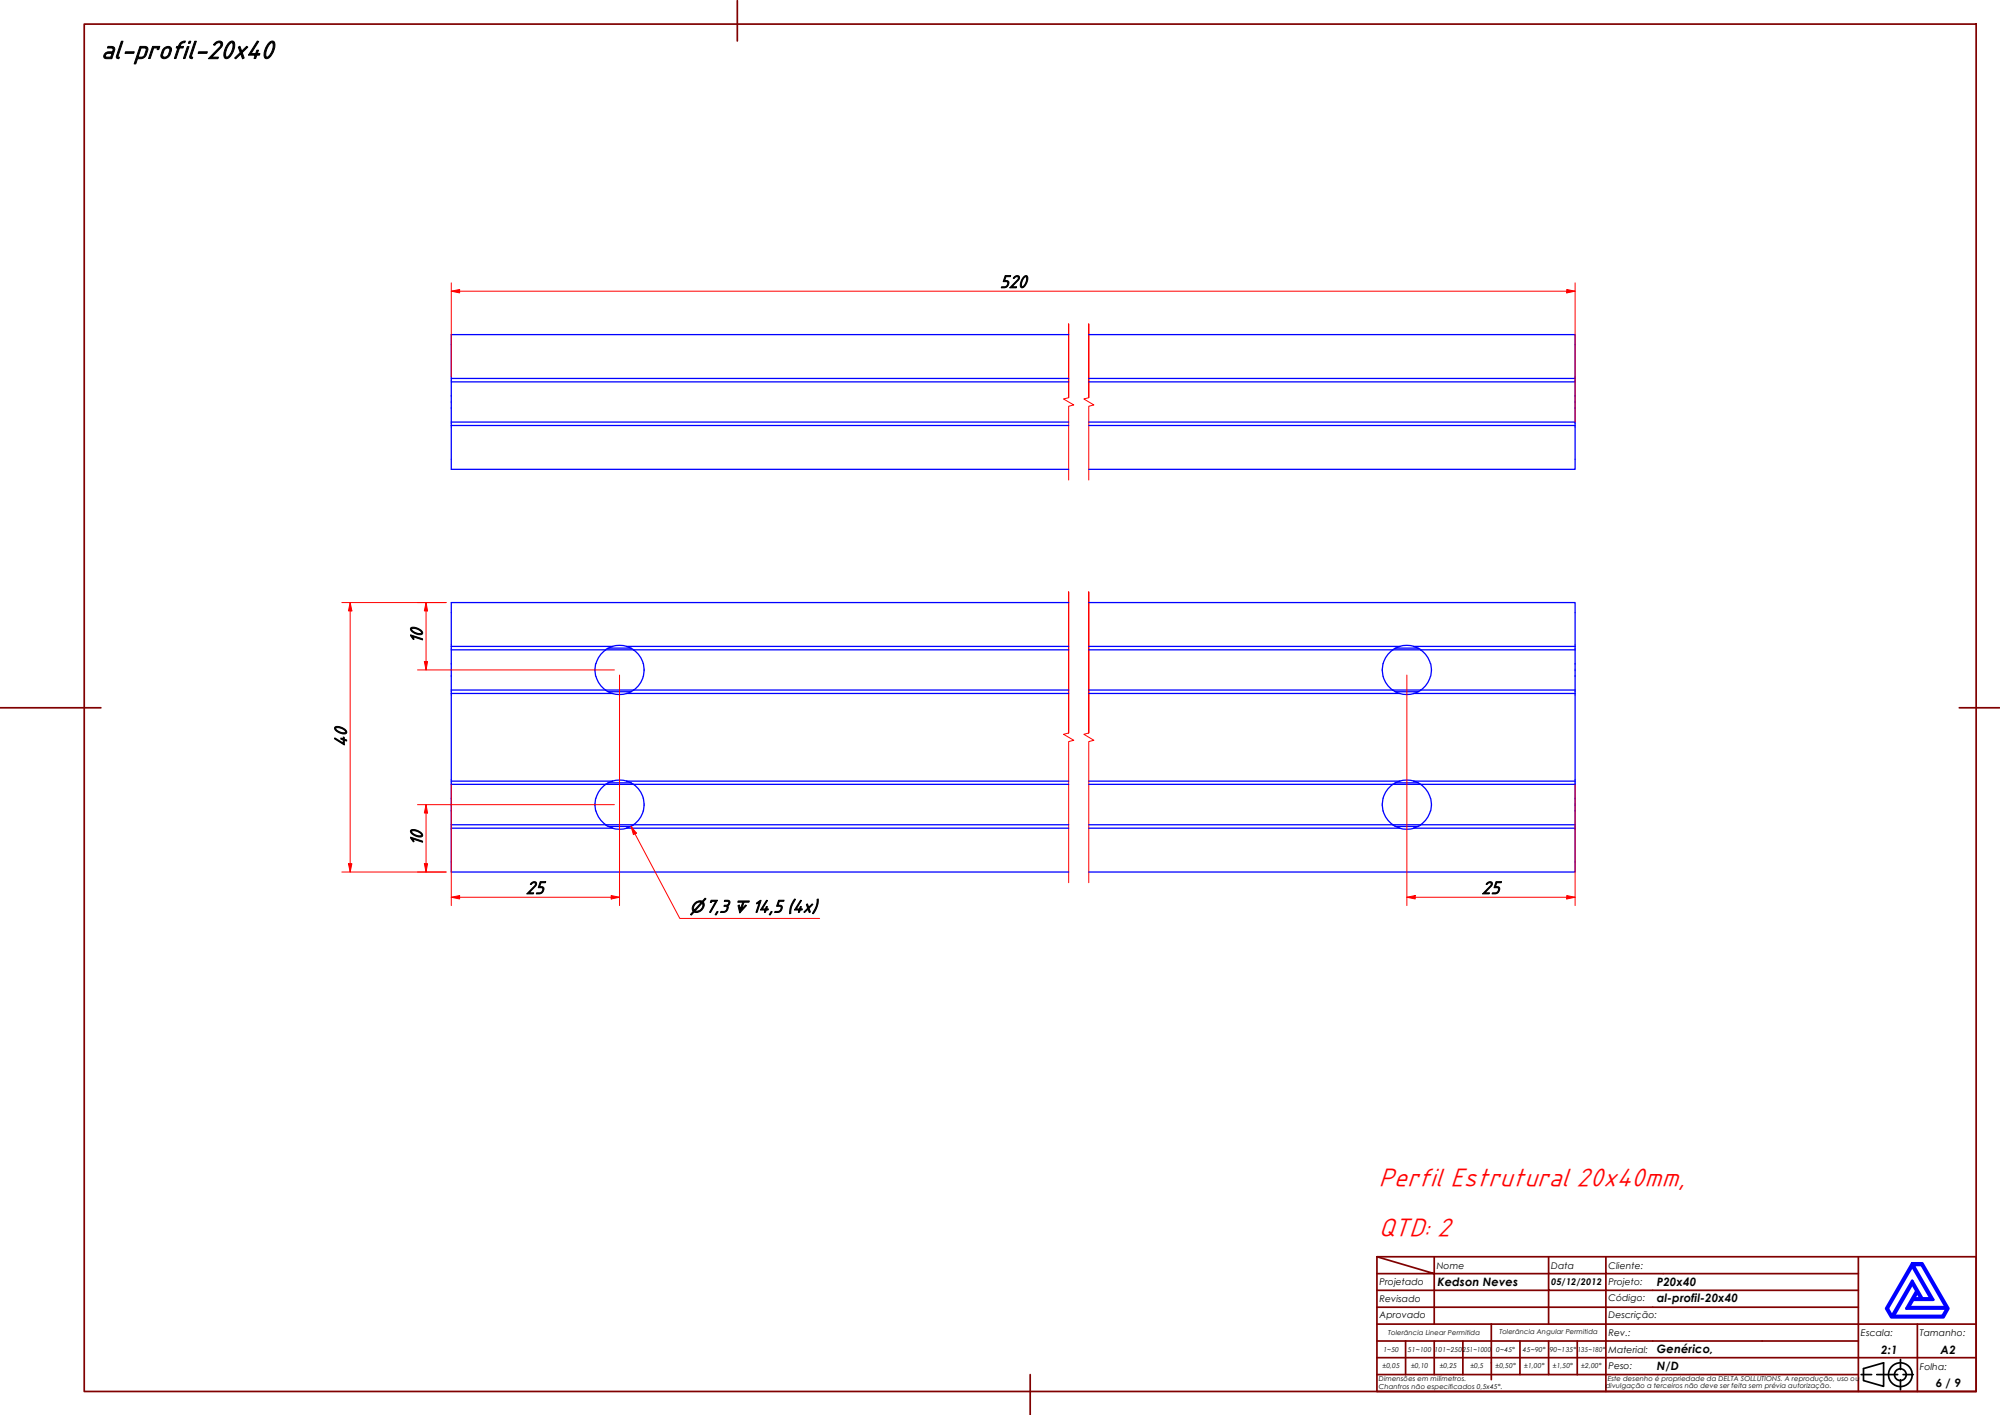
[picture p156: page 6]
Perfil Estrutural 20x40mm,; QTD: 2

Projetado | Nome | Data | Cliente:

Kedson Neves | 05/12/2012 | Projeto: P20x40

al-profil-20x40

Genérico,

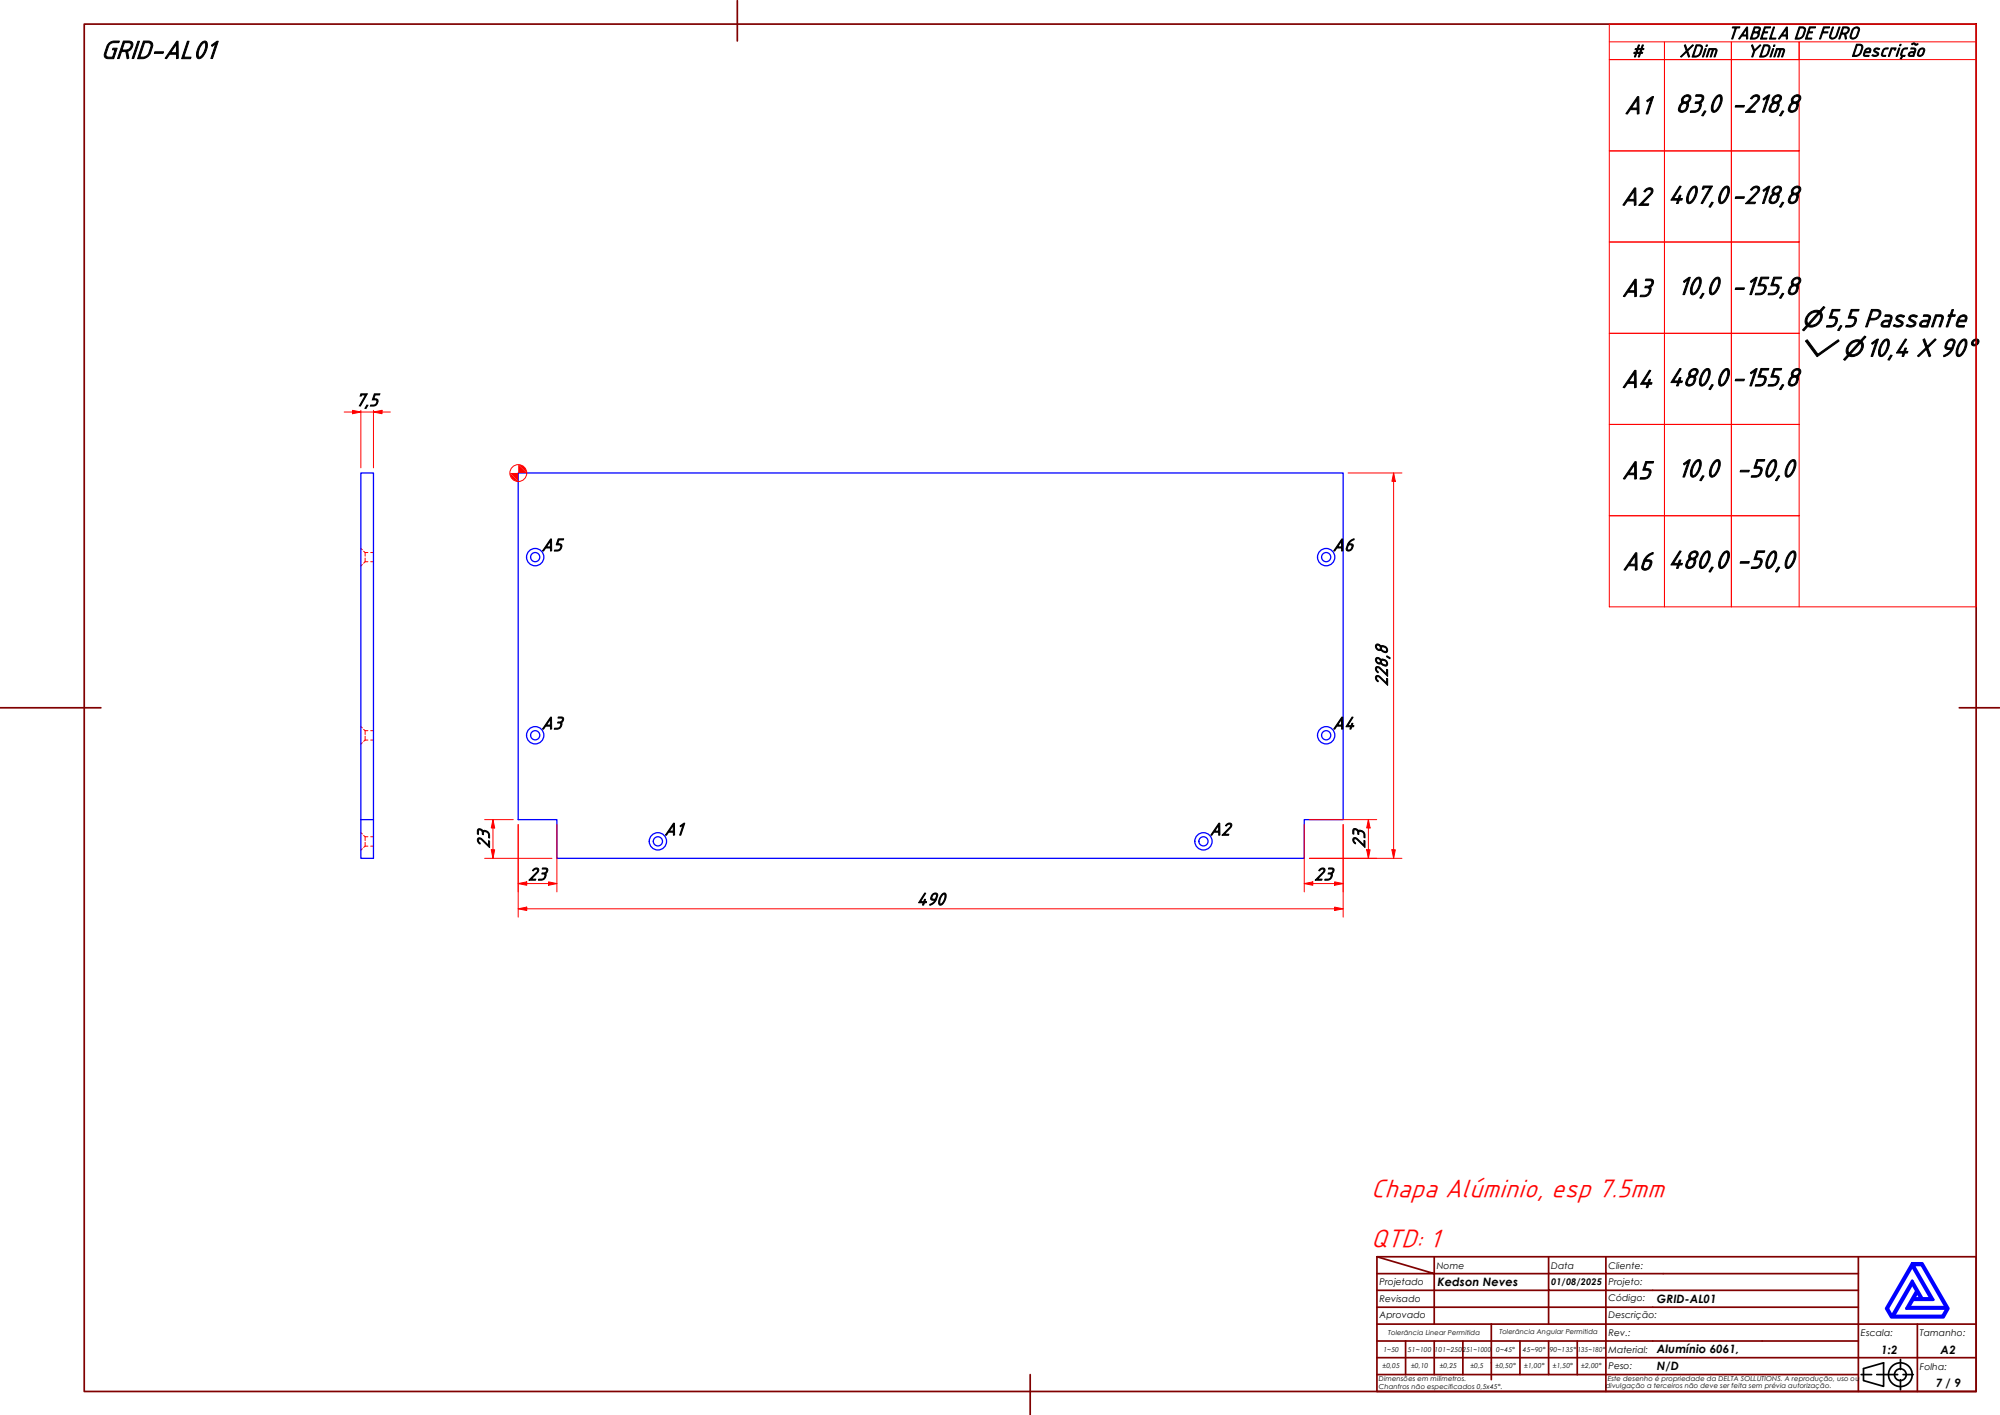
[picture p157: page 7]
⌀ 5,5 Passante ⌵ ⌀ 10,4 X 90°; QTD: 1

TABELA DE FURO

# | XDim | YDim | Descrição

Chapa Alúminio, esp 7.5mm

Projetado | Nome | Data | Cliente:

Kedson Neves | 01/08/2025 | Projeto:

GRID-AL01

Alumínio 6061,

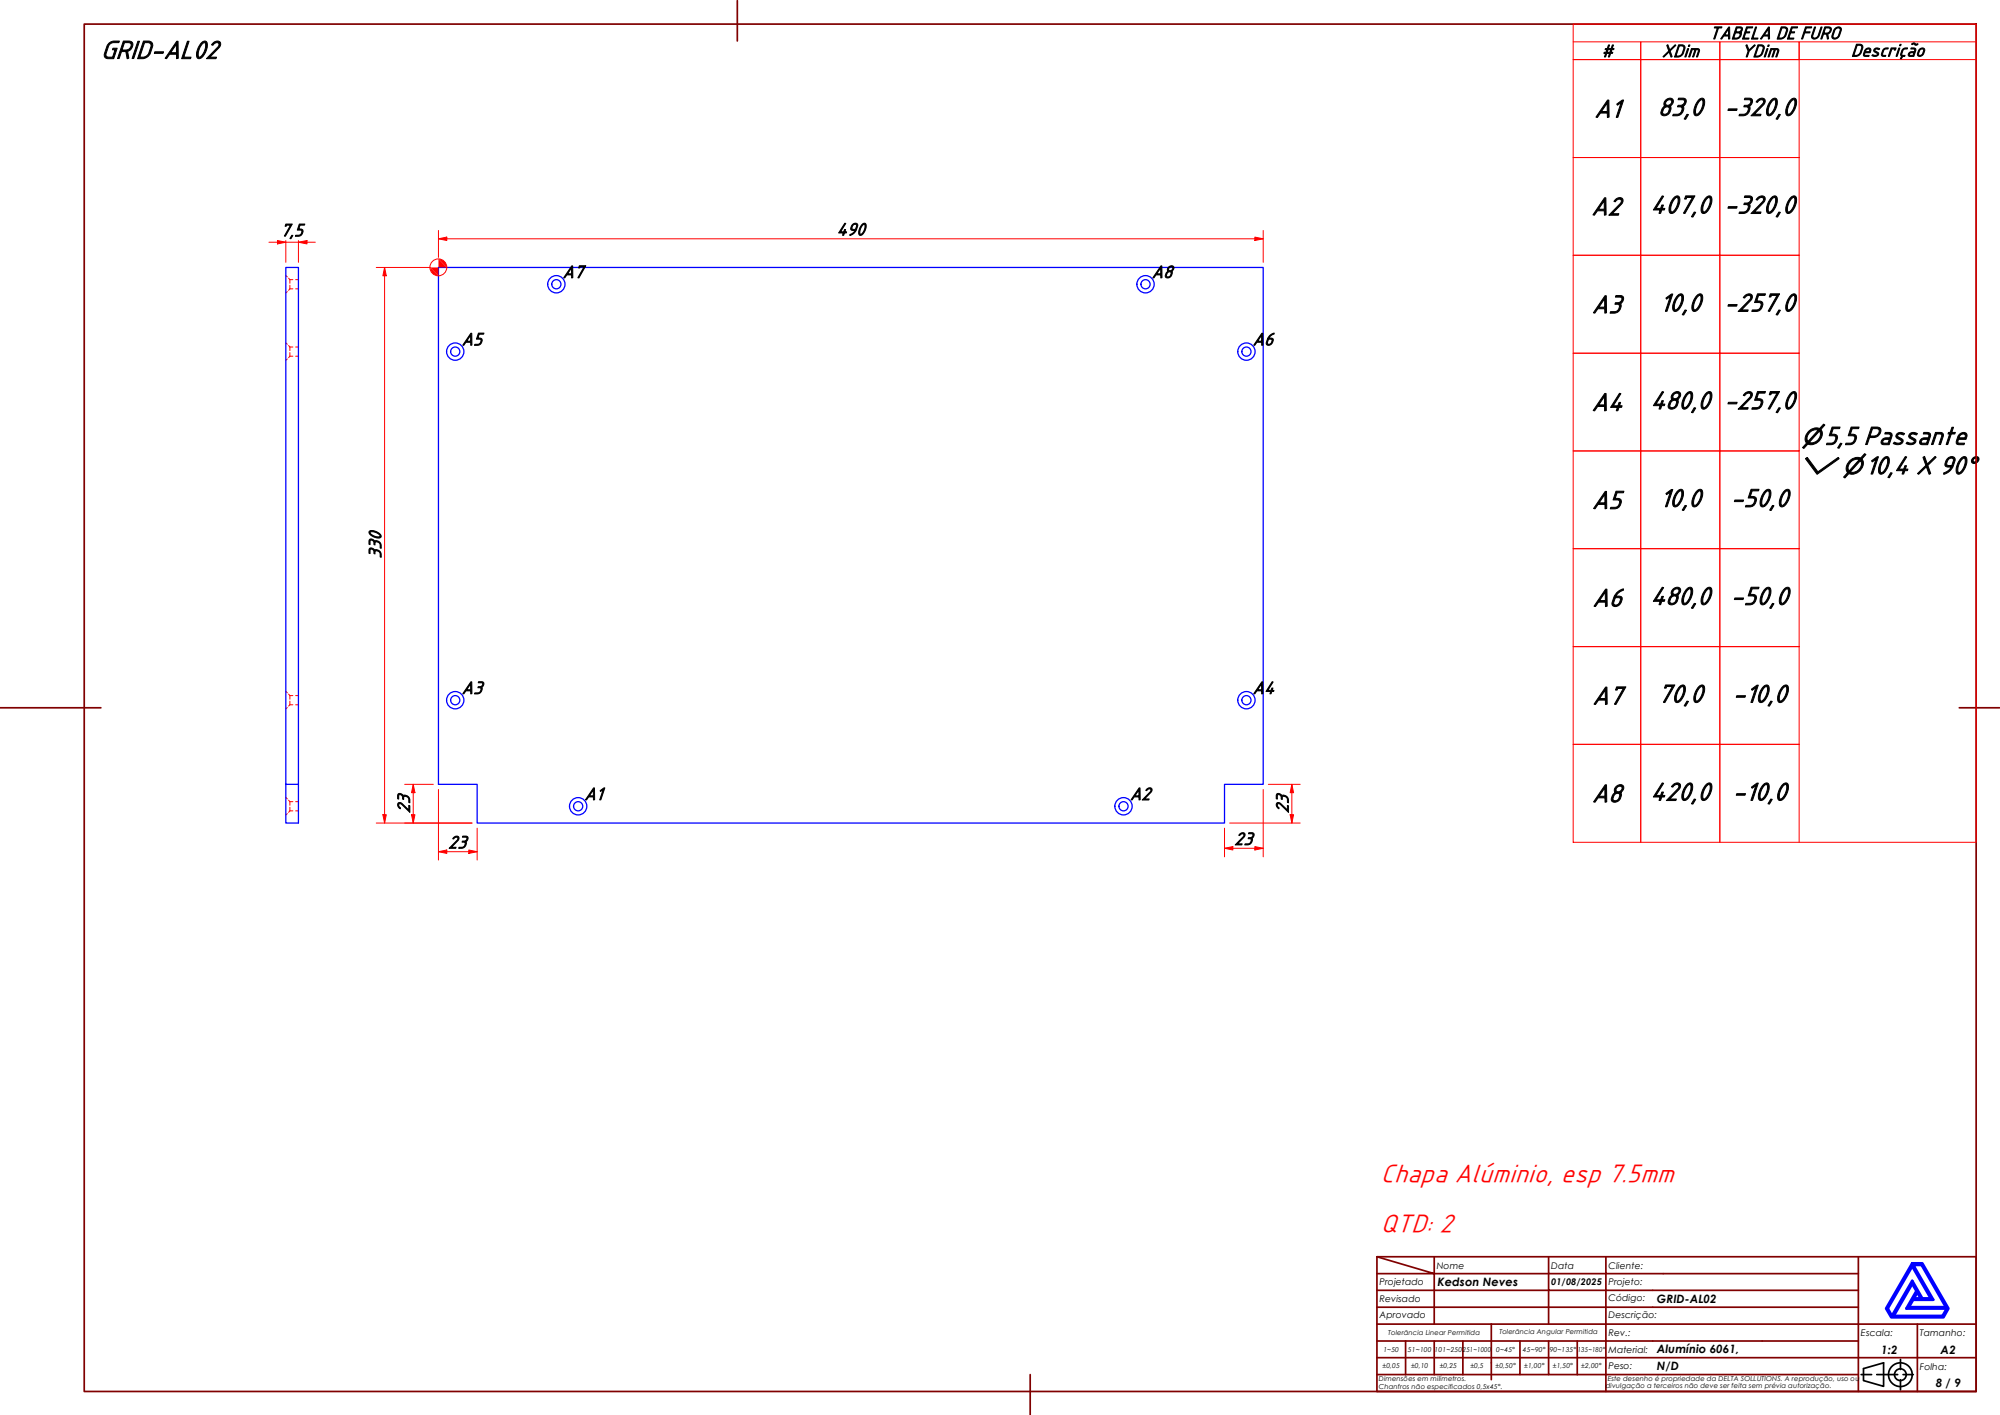
[picture p158: page 8]
⌀ 5,5 Passante ⌵ ⌀ 10,4 X 90°; QTD: 2

TABELA DE FURO

# | XDim | YDim | Descrição

Chapa Alúminio, esp 7.5mm

Projetado | Nome | Data | Cliente:

Kedson Neves | 01/08/2025 | Projeto:

GRID-AL02

Alumínio 6061,

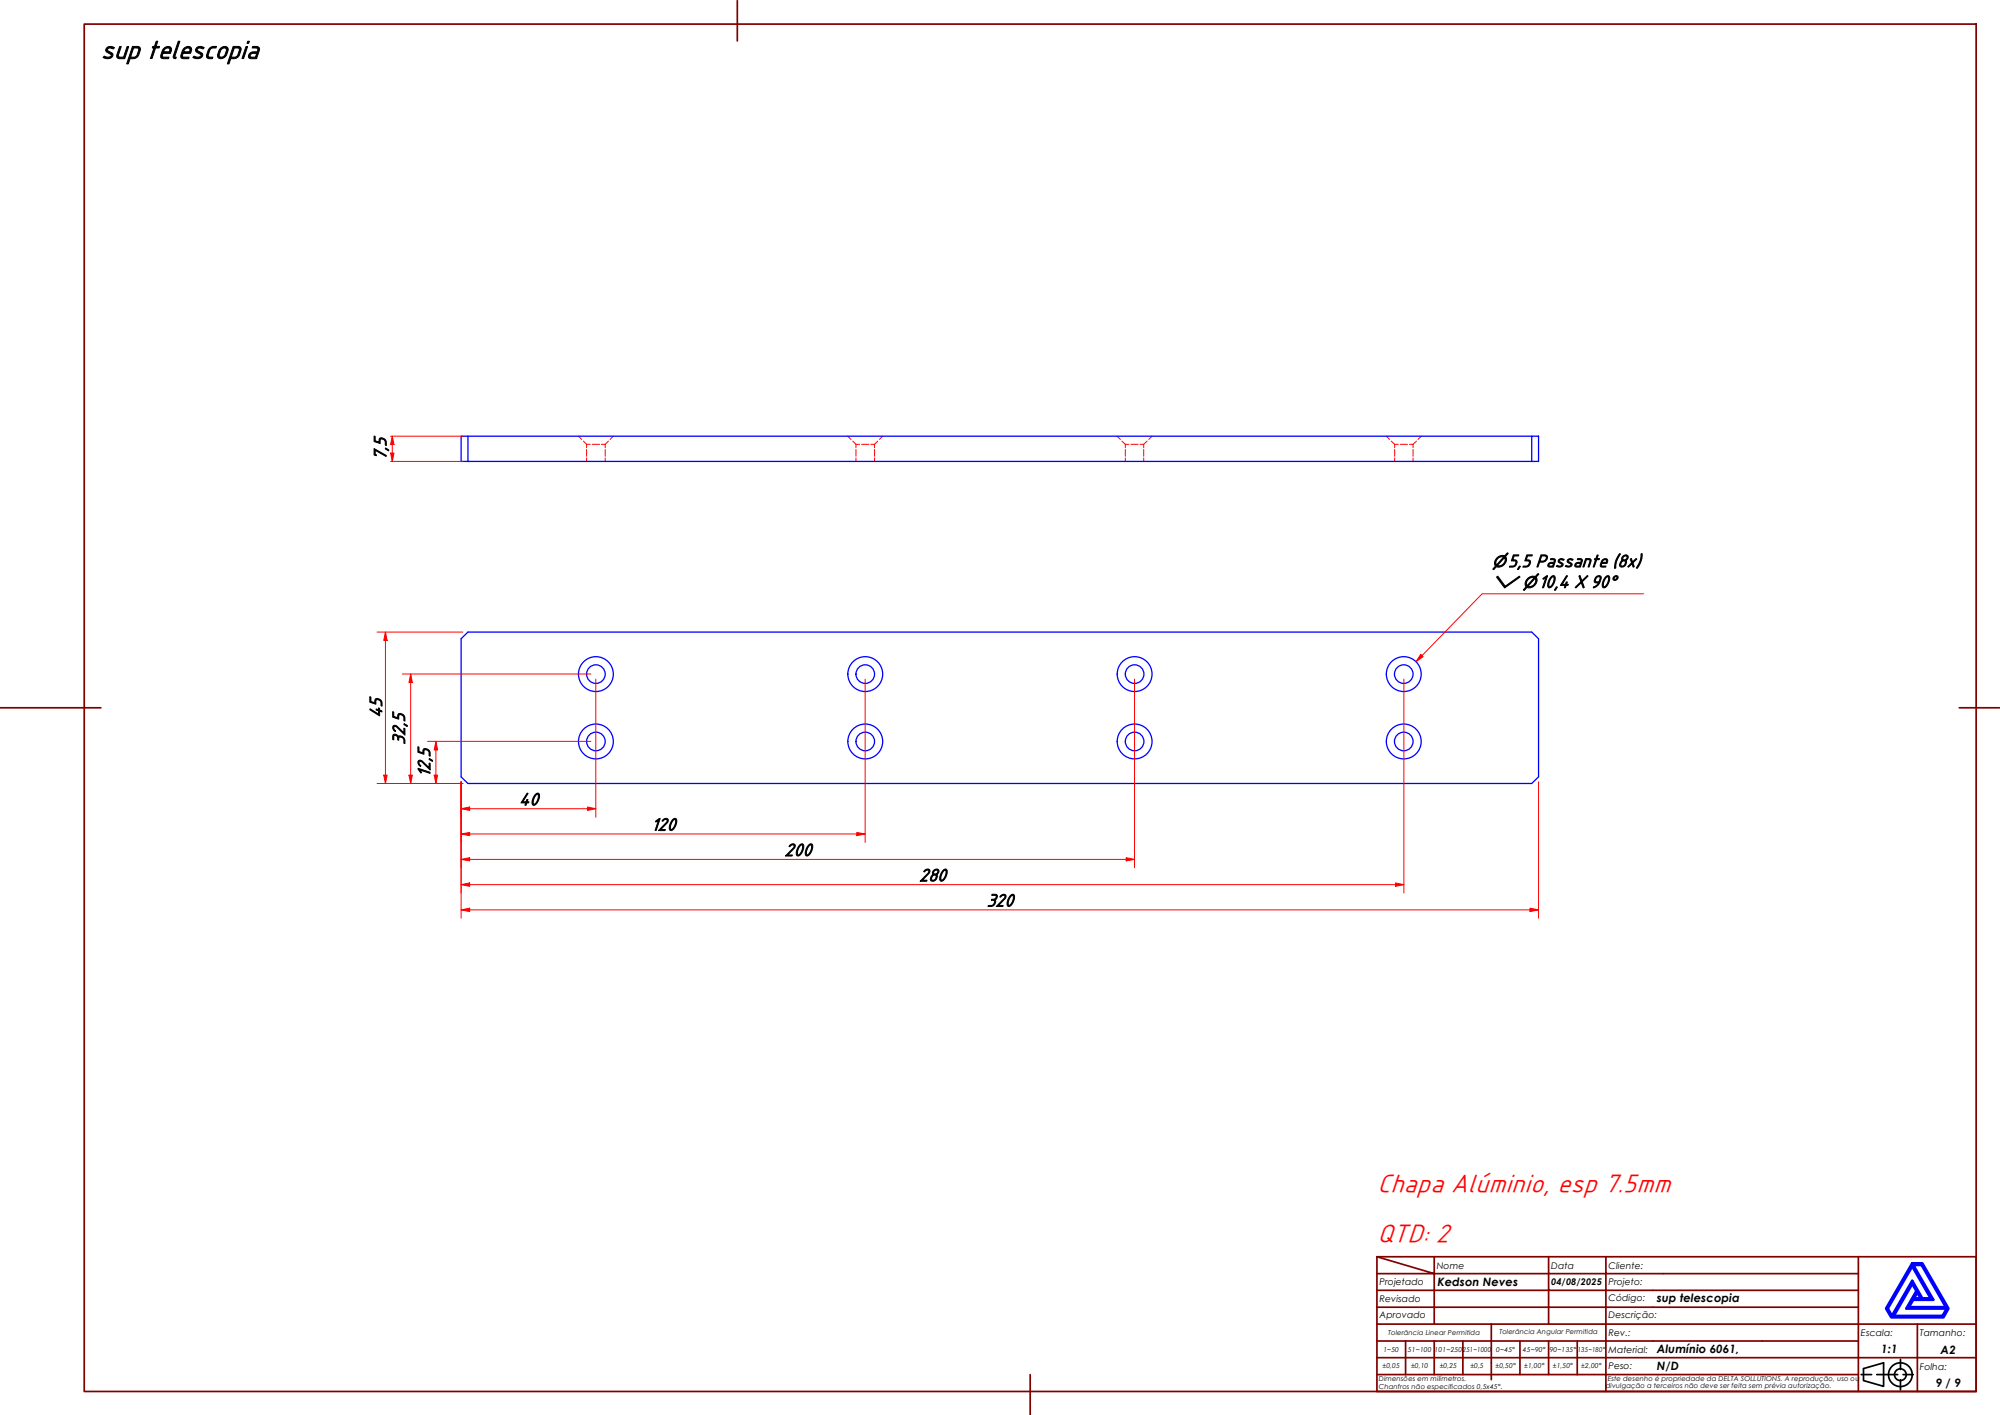
[picture p159: page 9]
sup telescopia; ⌀ 5,5 Passante (8x) ⌵ ⌀ 10,4 X 90°; QTD: 2

Chapa Alúminio, esp 7.5mm

Projetado | Nome | Data | Cliente:

Kedson Neves | 04/08/2025 | Projeto:

sup telescopia

Alumínio 6061,
