pvrezende/Dashboard/uploads/anexo-1754501003001-34338003.pdf

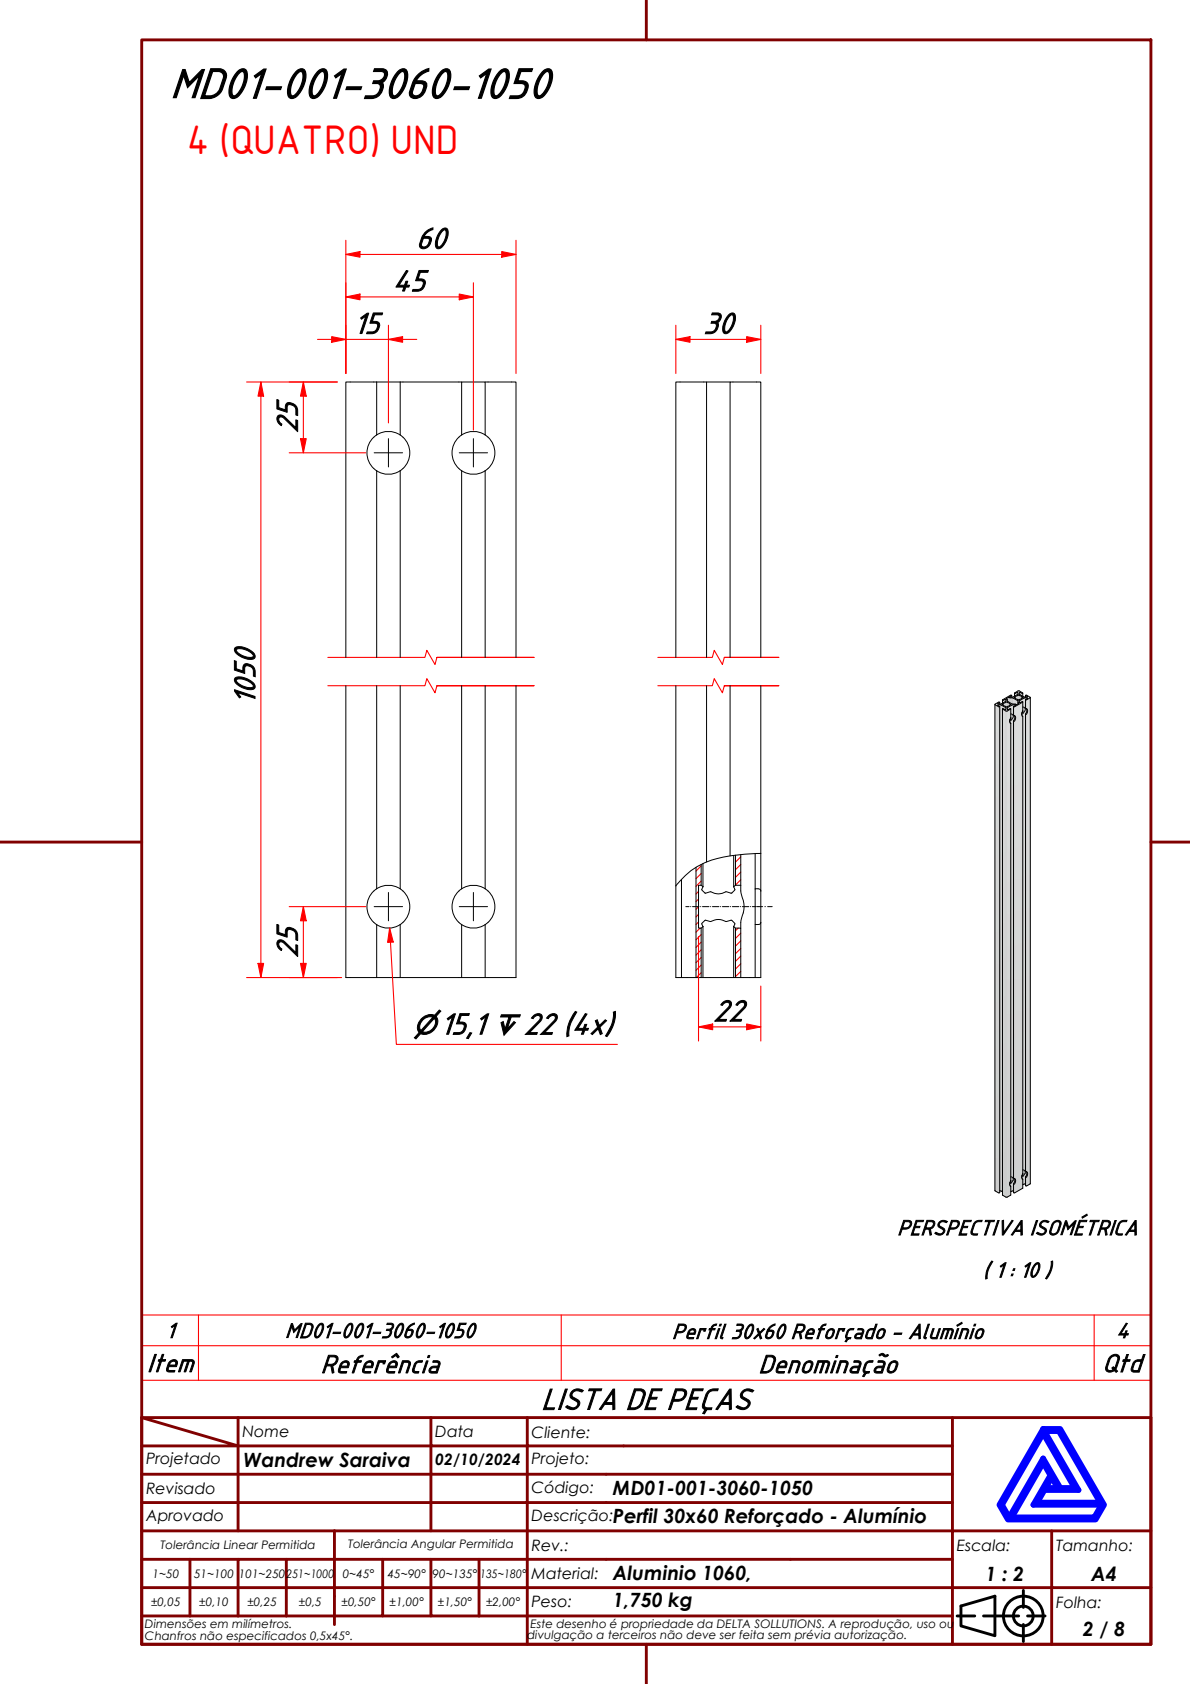
[picture p160: page 1]
PERSPECTIVA ISOMÉTRICA; 4 (QUATRO) UND

1 | MD01-001-3060-1050 | Perfil 30x60 Reforçado - Alumínio | 4
Item | Referência | Denominação | Qtd

LISTA DE PEÇAS

Projetado | Nome | Data | Cliente:

Wandrew Saraiva | 02/10/2024 | Projeto:

Revisado | | | Código: MD01-001-3060-1050
Aprovado | | | Perfil 30x60 Reforçado - Alumínio Descrição:
Tolerância Linear Permitida | Tolerância Angular Permitida | Rev.: | Escala: 1 : 2 | Tamanho: A4

1~50 | 51~100 | 101~250 | 251~1000 | 0~45° | 45~90° | 90~135° 135~180° | | Material: Aluminio 1060,
±0,05 | ±0,10 | ±0,25 | ±0,5 | ±0,50° | ±1,00° | ±1,50° | ±2,00° | 1,750 kg Peso: | Folha: 2 / 8

Dimensões em milímetros.

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
