pvrezende/Dashboard/uploads/anexo-1755005885229-127230934.pdf

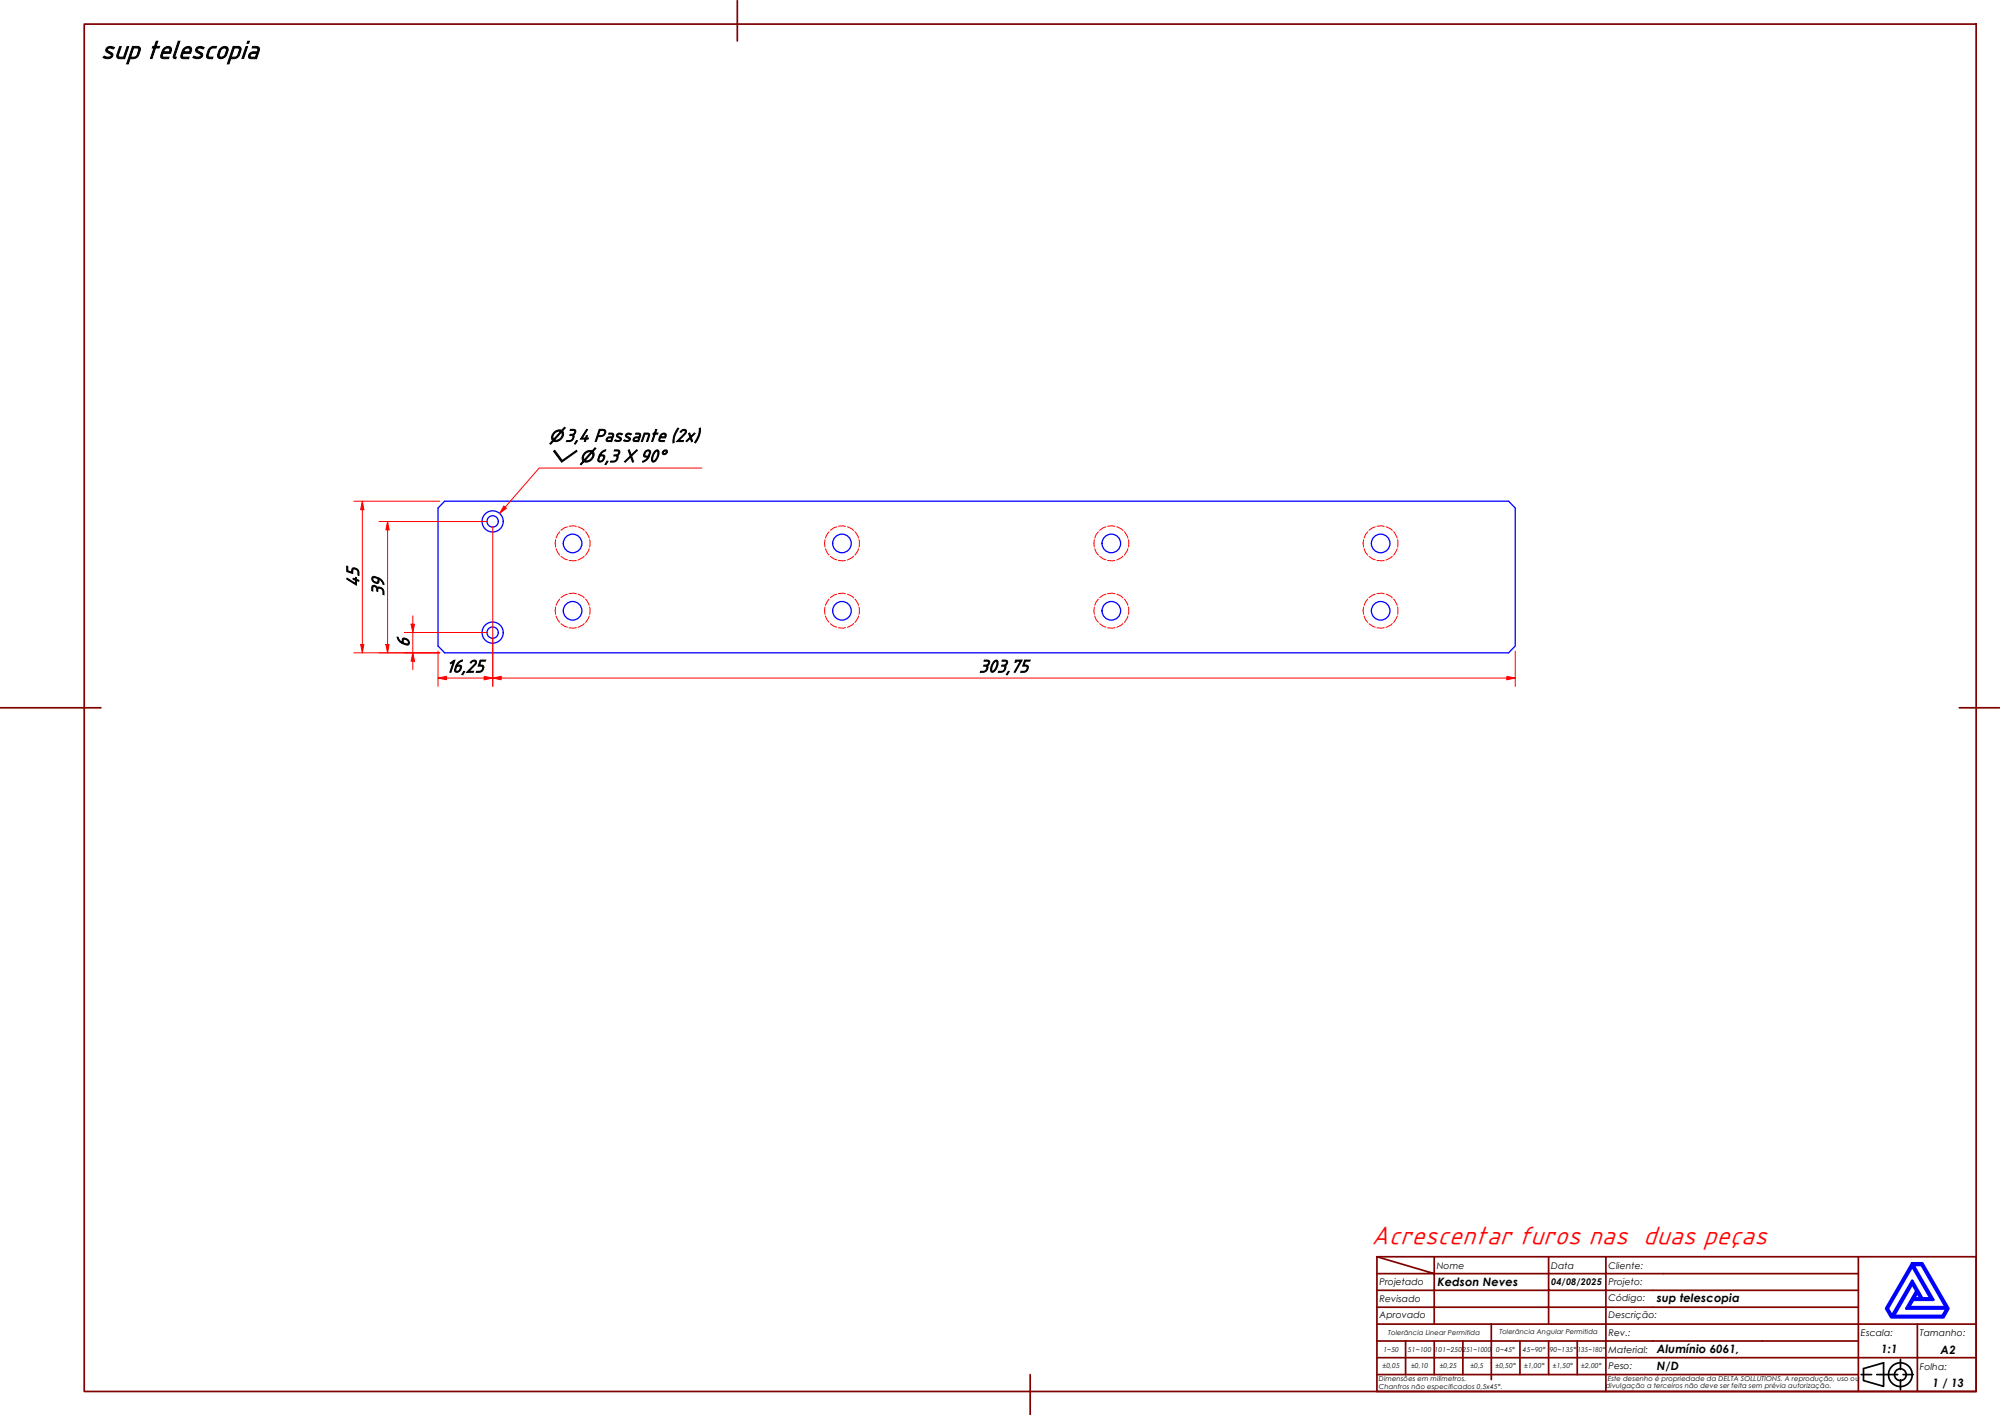
[picture p164: page 1]
sup telescopia; ⌀ 3,4 Passante (2x) ⌵ ⌀ 6,3 X 90°

Acrescentar furos nas duas peças

Projetado | Nome | Data | Cliente:

Kedson Neves | 04/08/2025 | Projeto:

Revisado | | | Código: sup telescopia

Aprovado | | | Descrição:
Tolerância Linear Permitida | Tolerância Angular Permitida | Rev.: | Escala: 1:1 | Tamanho: A2

1~50 | 51~100 | 101~250 | | | | 90~135° 135~180° | | Alumínio 6061, Material:

±1,00° | | ±2,00° | Peso: N/D | Folha: 1 / 13

Dimensões em milímetros.

Chanfros não especificados 0,5x45°. | | | | | | | | Este desenho é propriedade da DELTA SOLLUTIONS. A reprodução, uso ou divulgação a terceiros não deve ser feita sem prévia autorização.

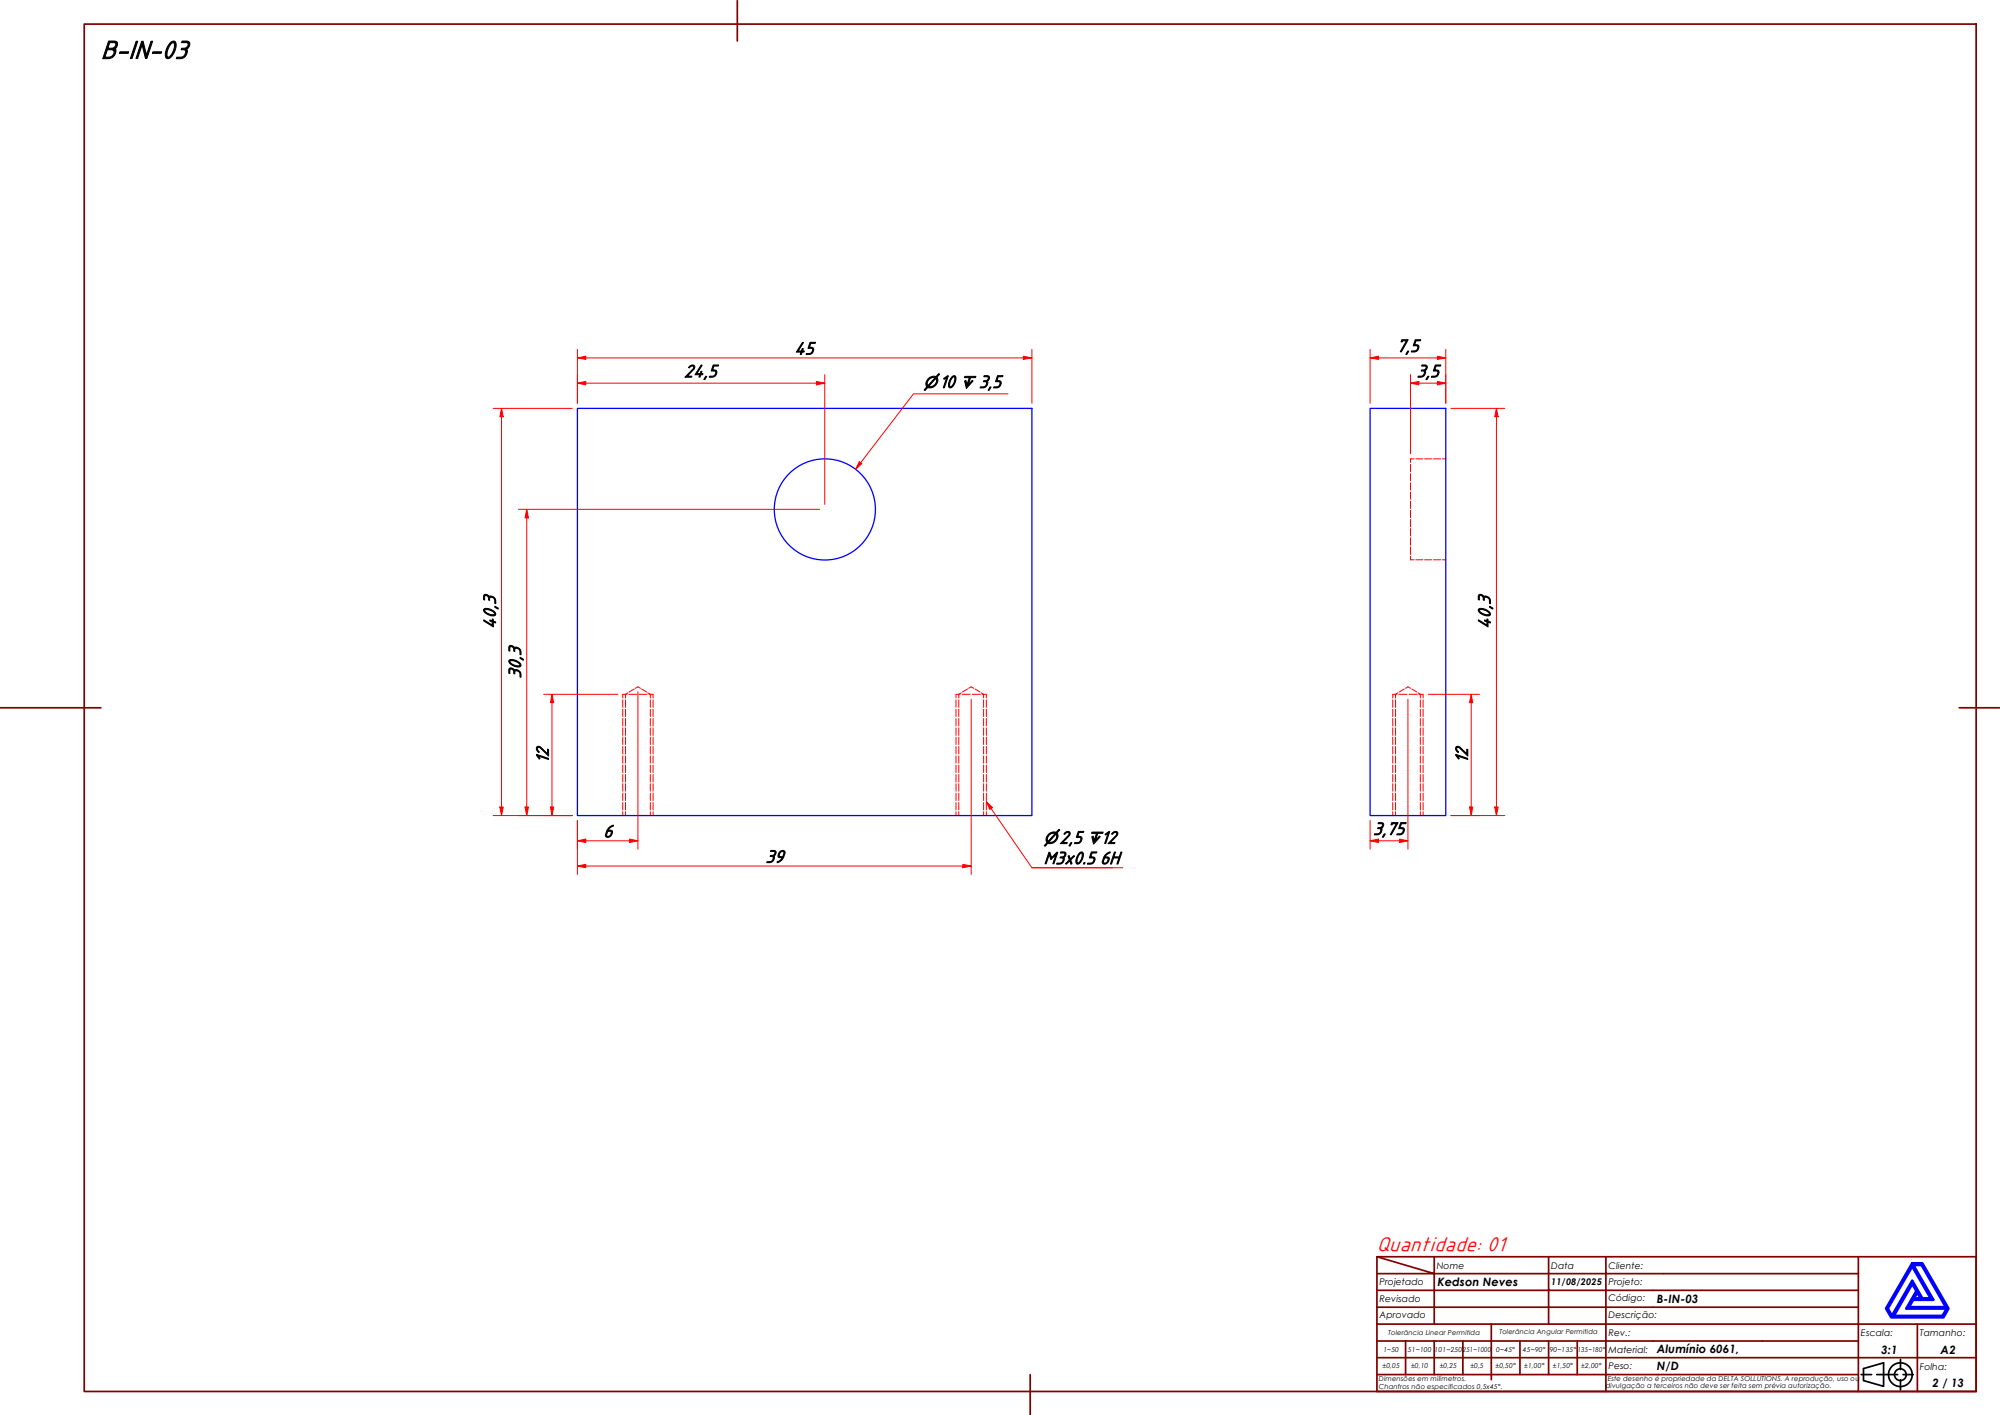
[picture p165: page 2]
Quantidade: 01

Projetado | Nome | Data | Cliente:

Kedson Neves | 11/08/2025 | Projeto:

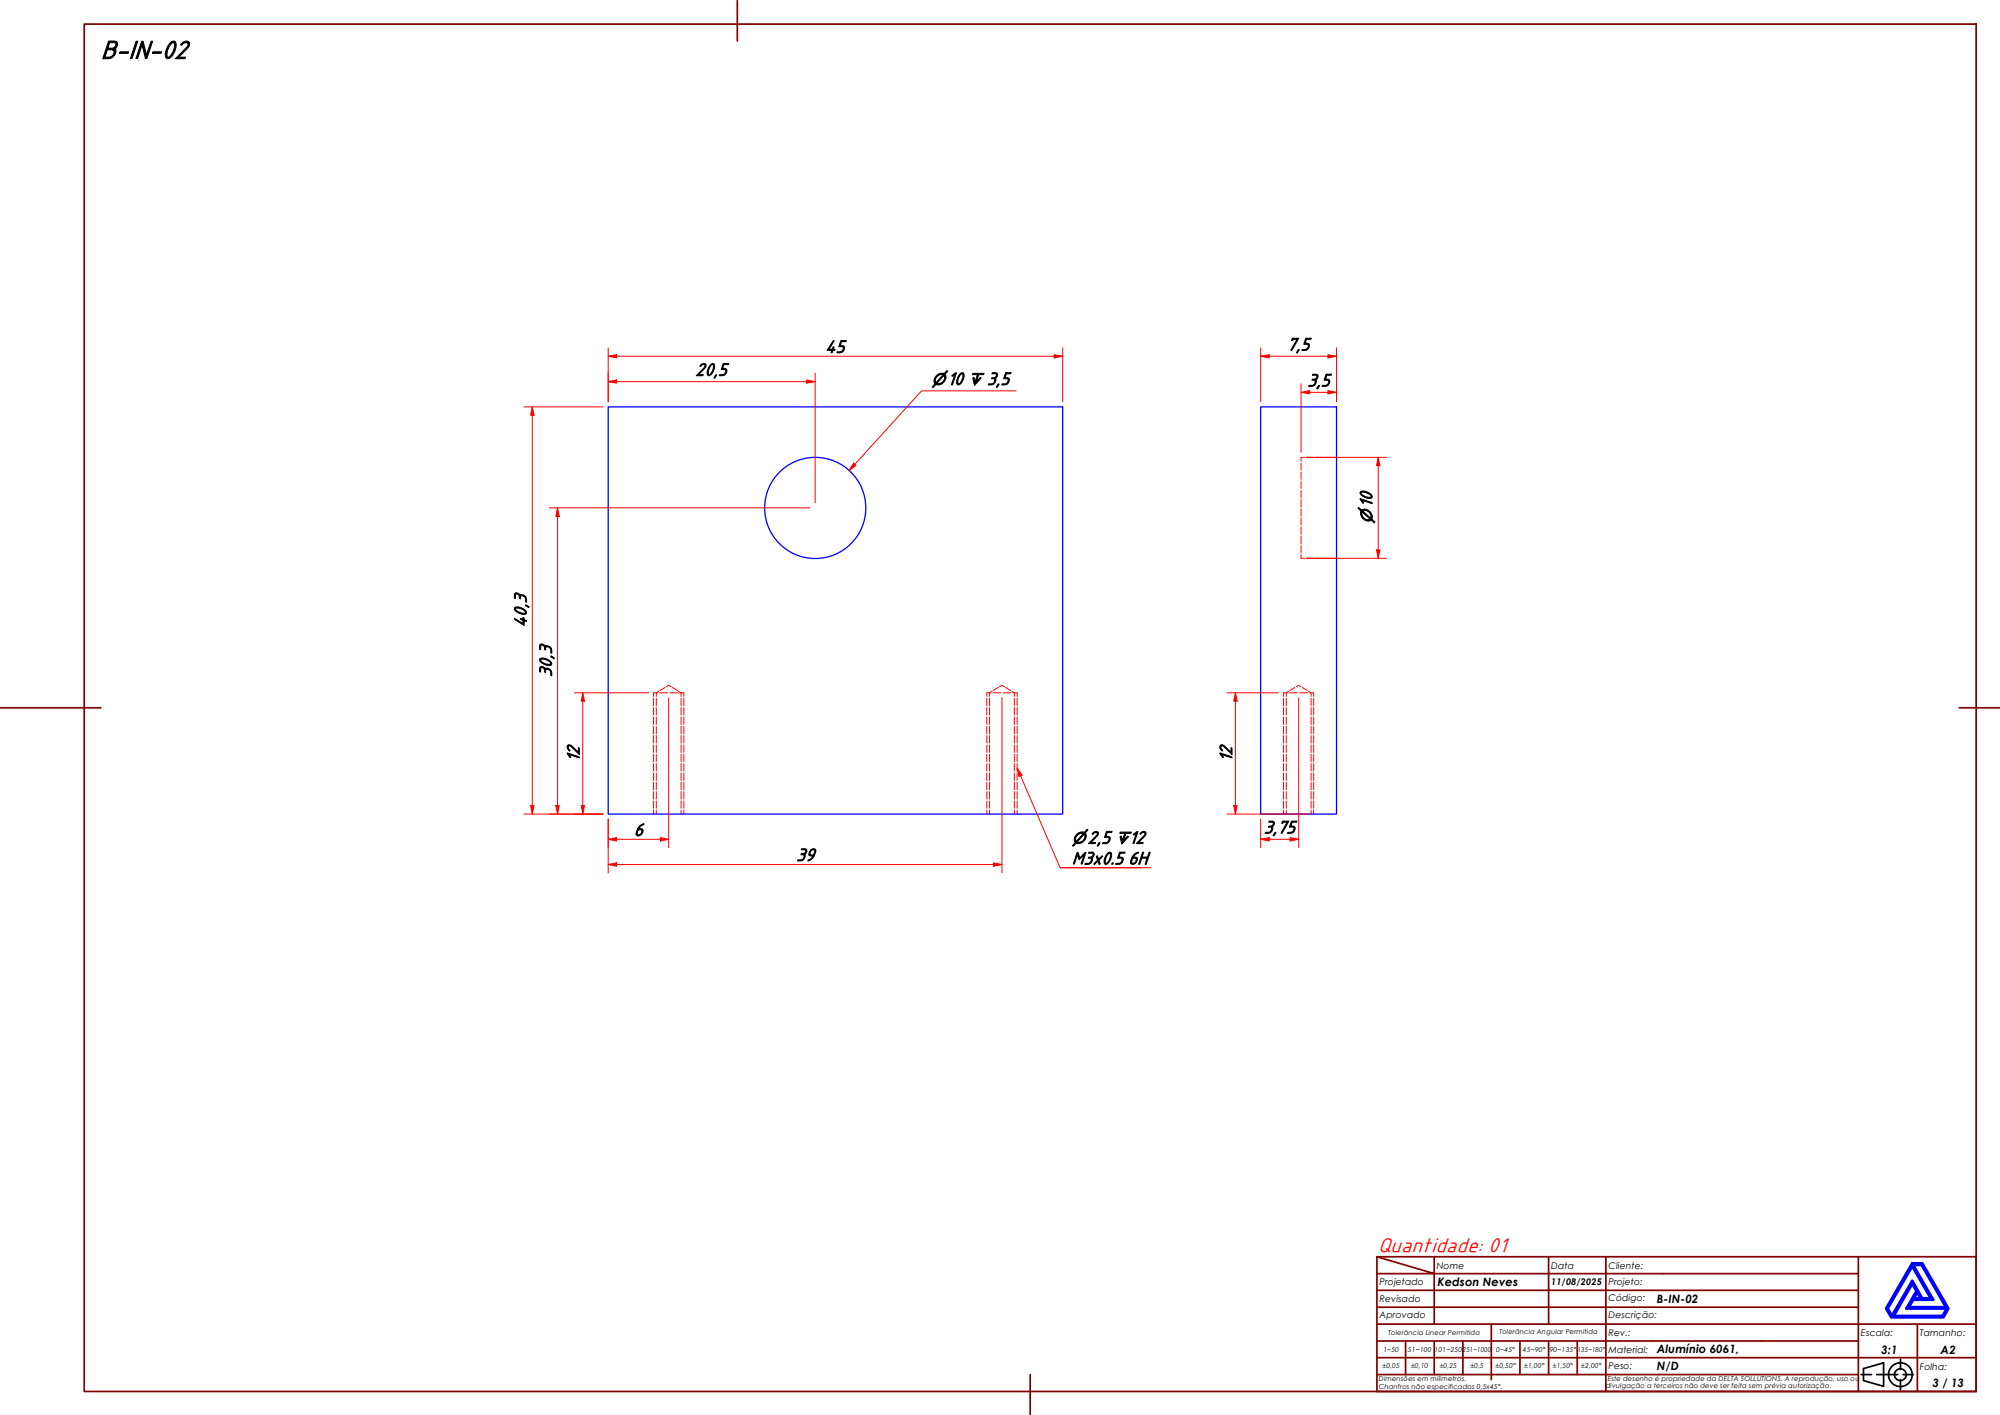
[picture p166: page 3]
Quantidade: 01

Projetado | Nome | Data | Cliente:

Kedson Neves | 11/08/2025 | Projeto:

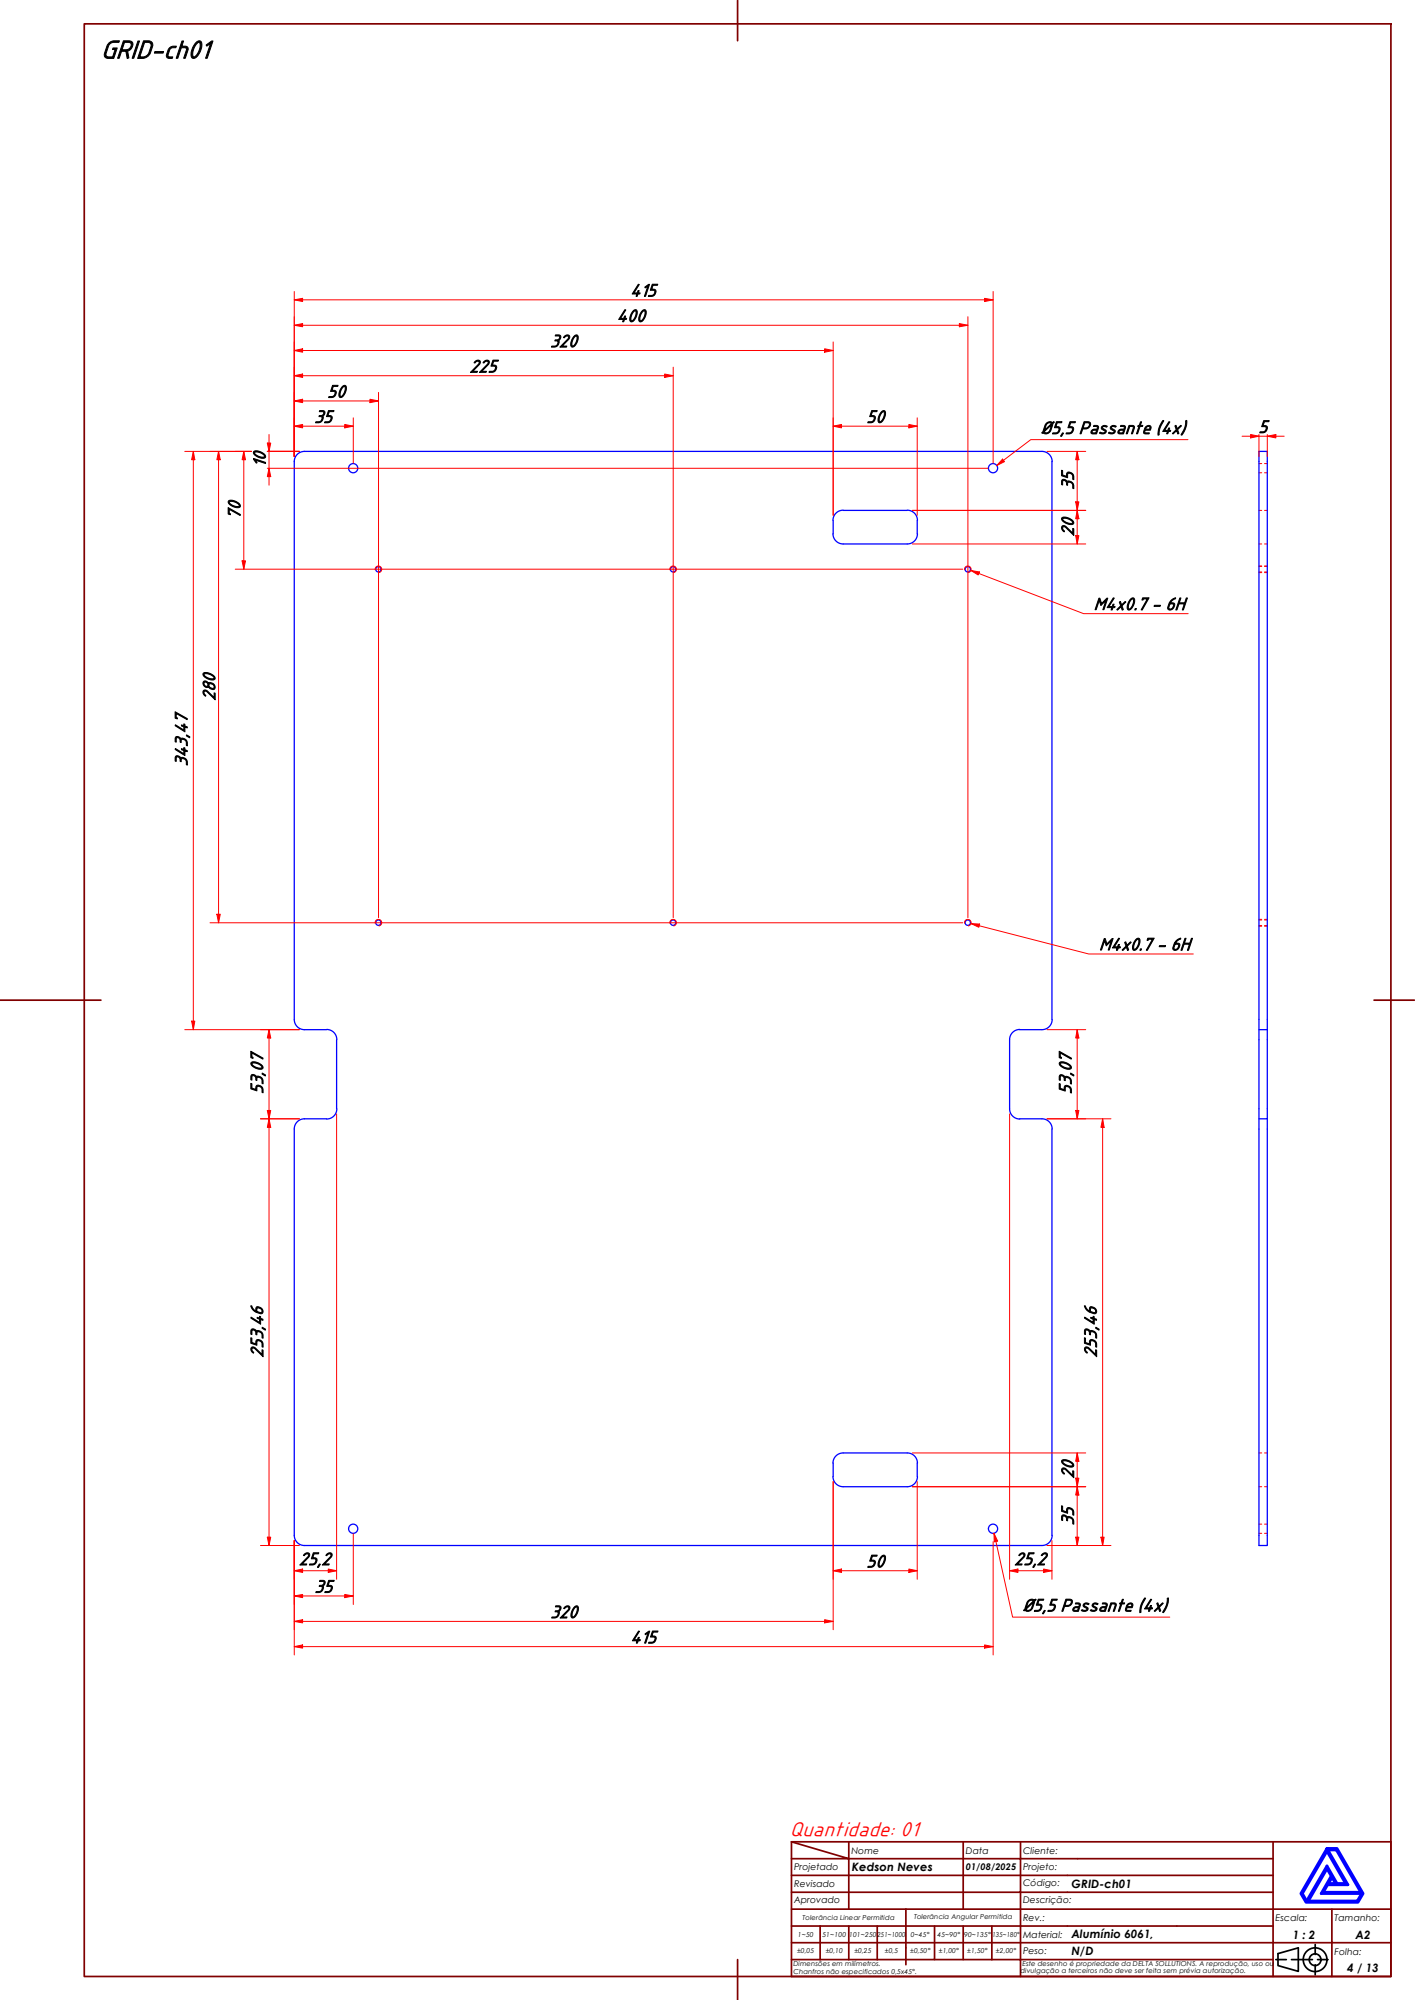
[picture p167: page 4]
Ø5,5 Passante (4x); Quantidade: 01

Projetado | Nome | Data | Cliente:

Kedson Neves | 01/08/2025 | Projeto:

GRID-ch01

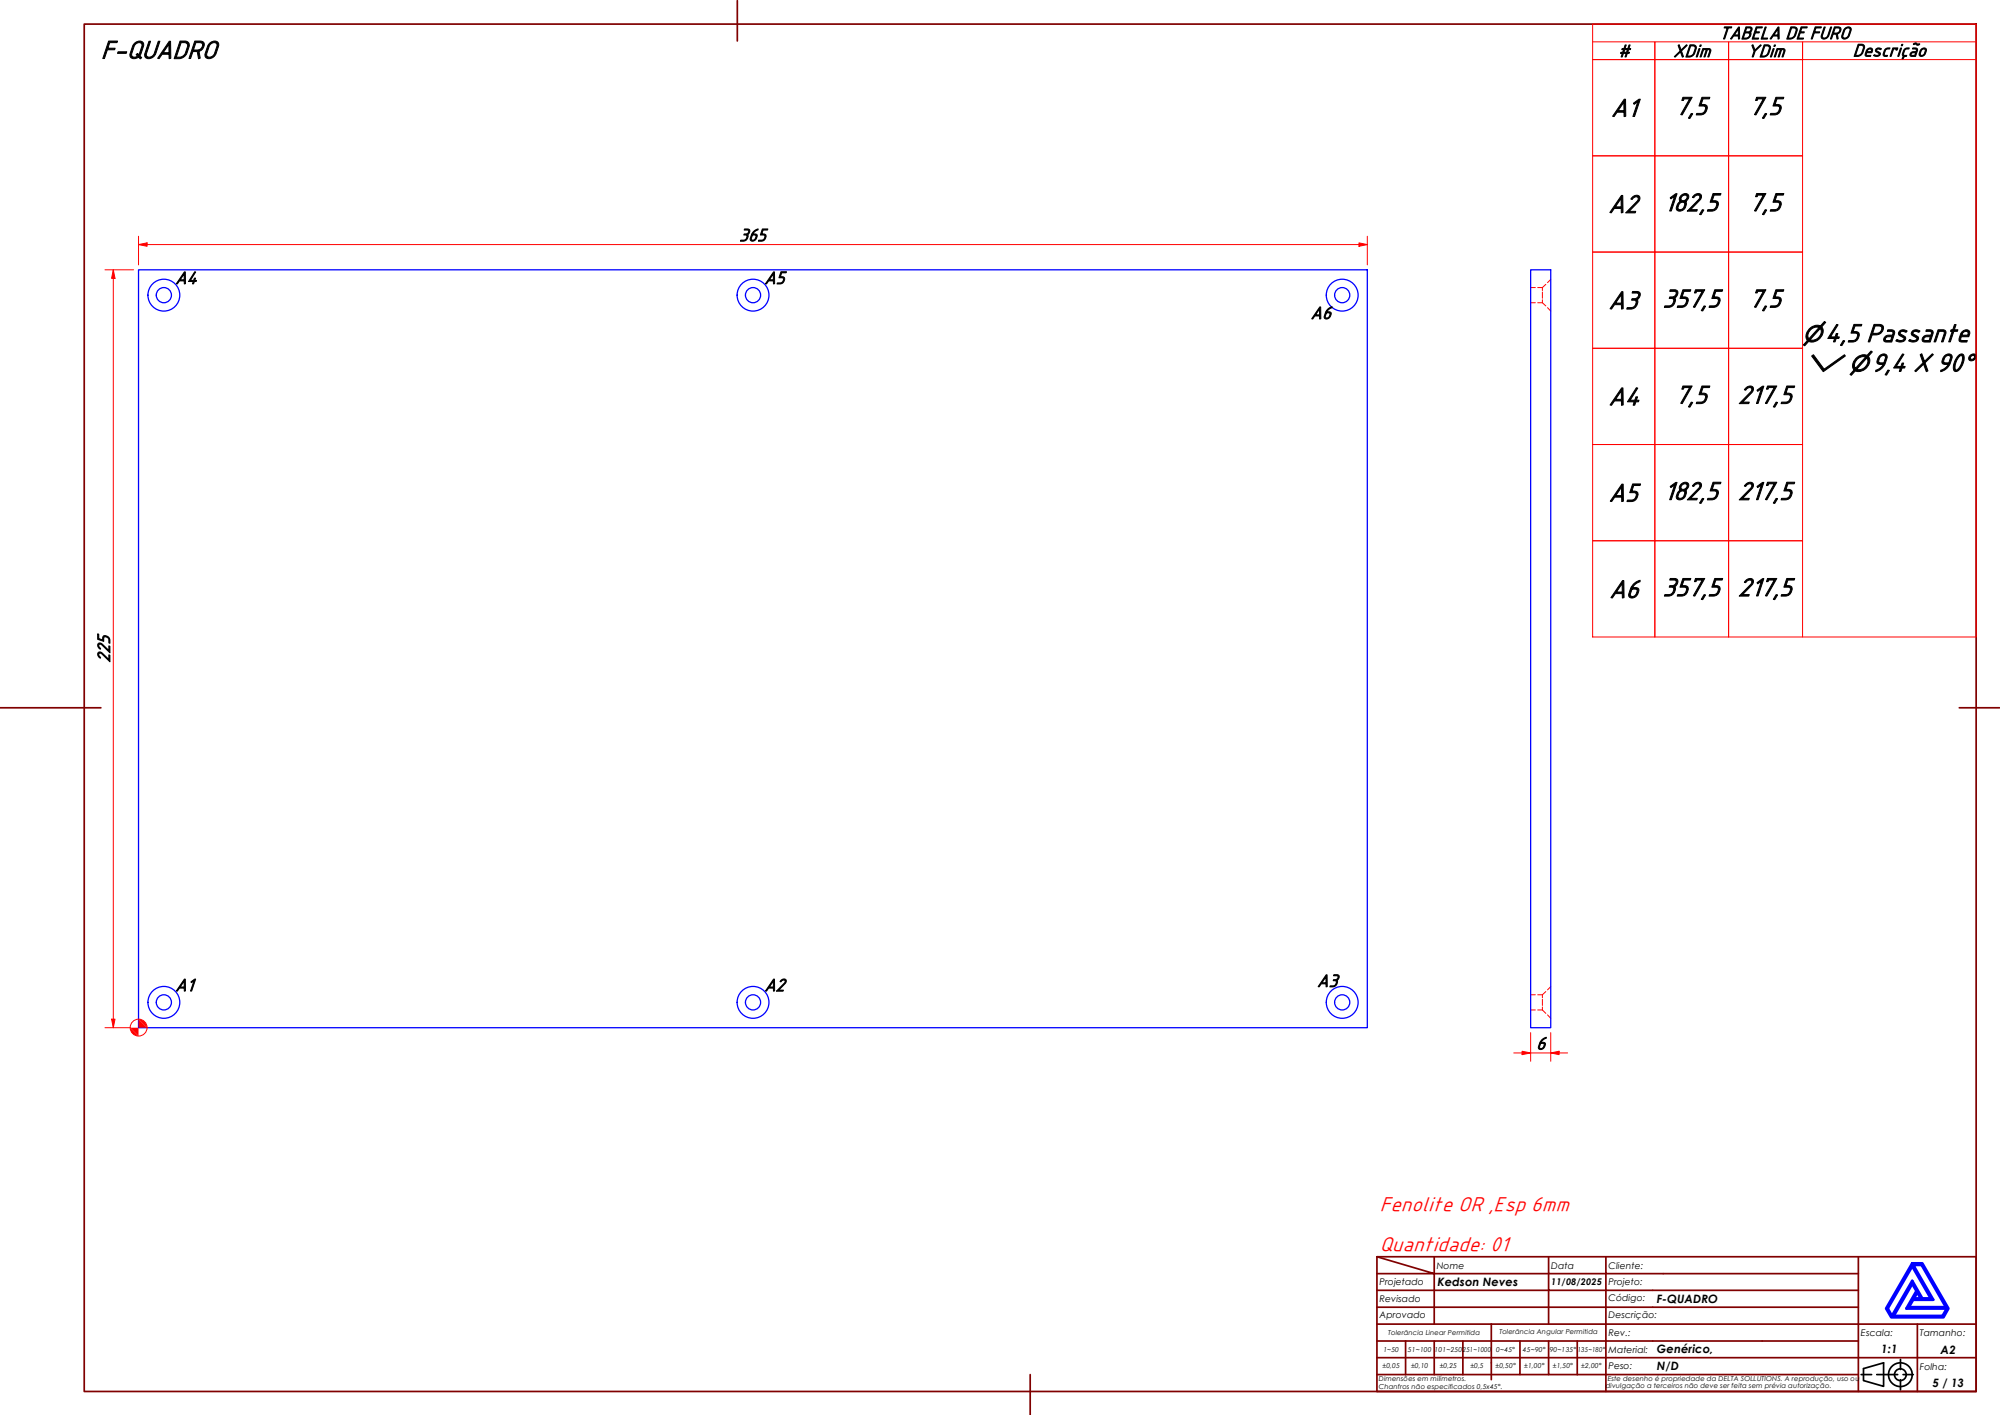
[picture p168: page 5]
⌀ 4,5 Passante ⌵ ⌀ 9,4 X 90°; Quantidade: 01

TABELA DE FURO

# | XDim | YDim | Descrição

Fenolite OR ,Esp 6mm

Projetado | Nome | Data | Cliente:

Kedson Neves | 11/08/2025 | Projeto:

F-QUADRO

Genérico,

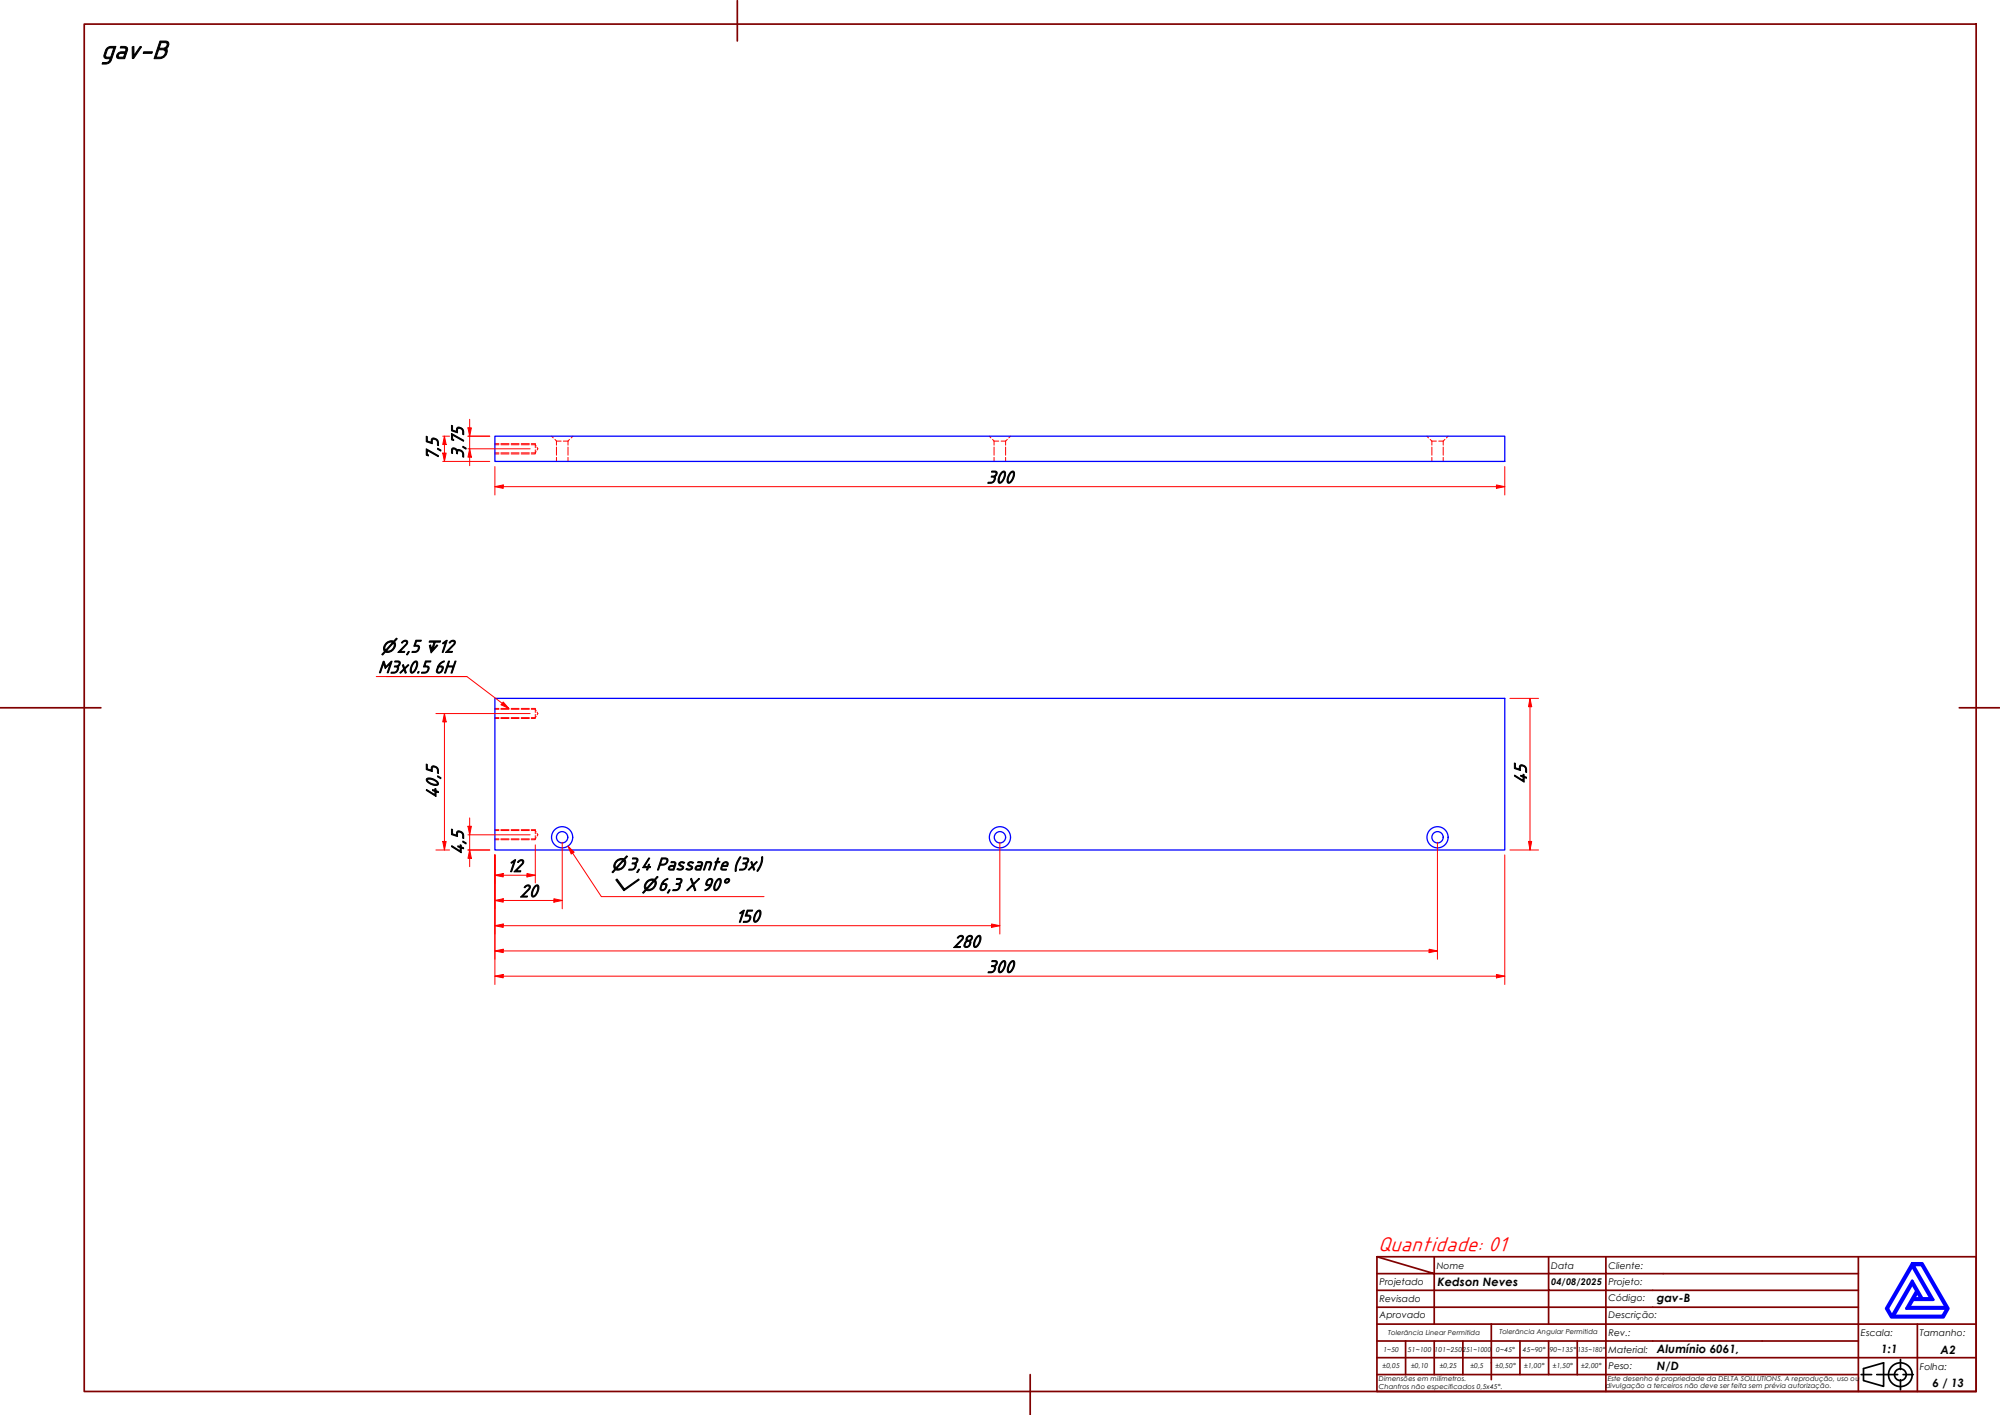
[picture p169: page 6]
⌀ 3,4 Passante (3x) ⌵ ⌀ 6,3 X 90°; Quantidade: 01

Projetado | Nome | Data | Cliente:

Kedson Neves | 04/08/2025 | Projeto:

gav-B

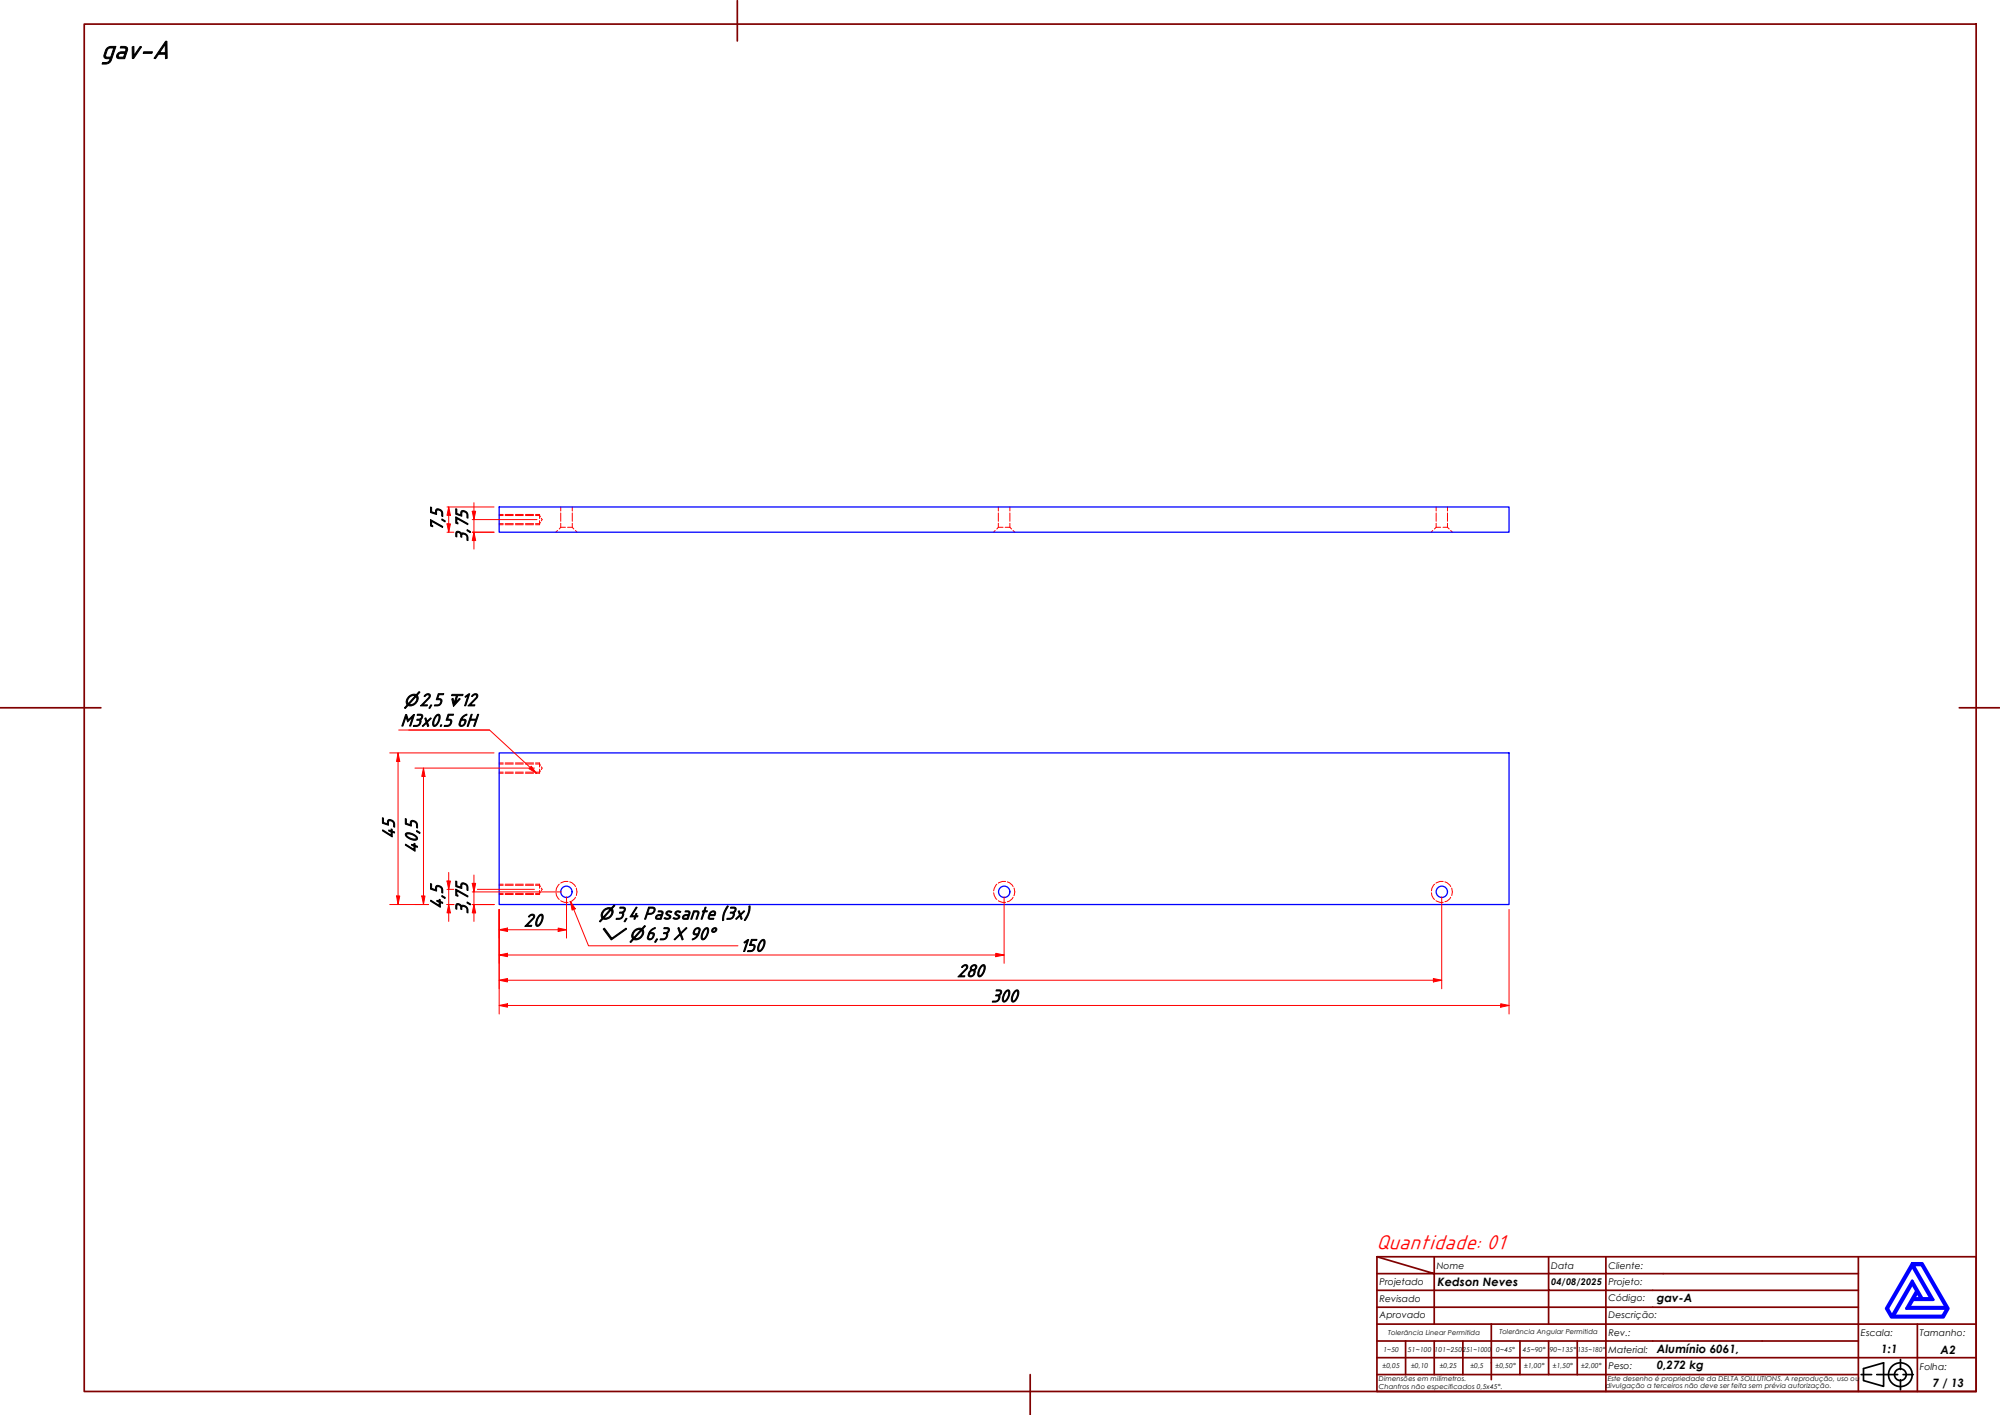
[picture p170: page 7]
⌀ 3,4 Passante (3x) ⌵ ⌀ 6,3 X 90°; Quantidade: 01

Projetado | Nome | Data | Cliente:

Kedson Neves | 04/08/2025 | Projeto:

gav-A

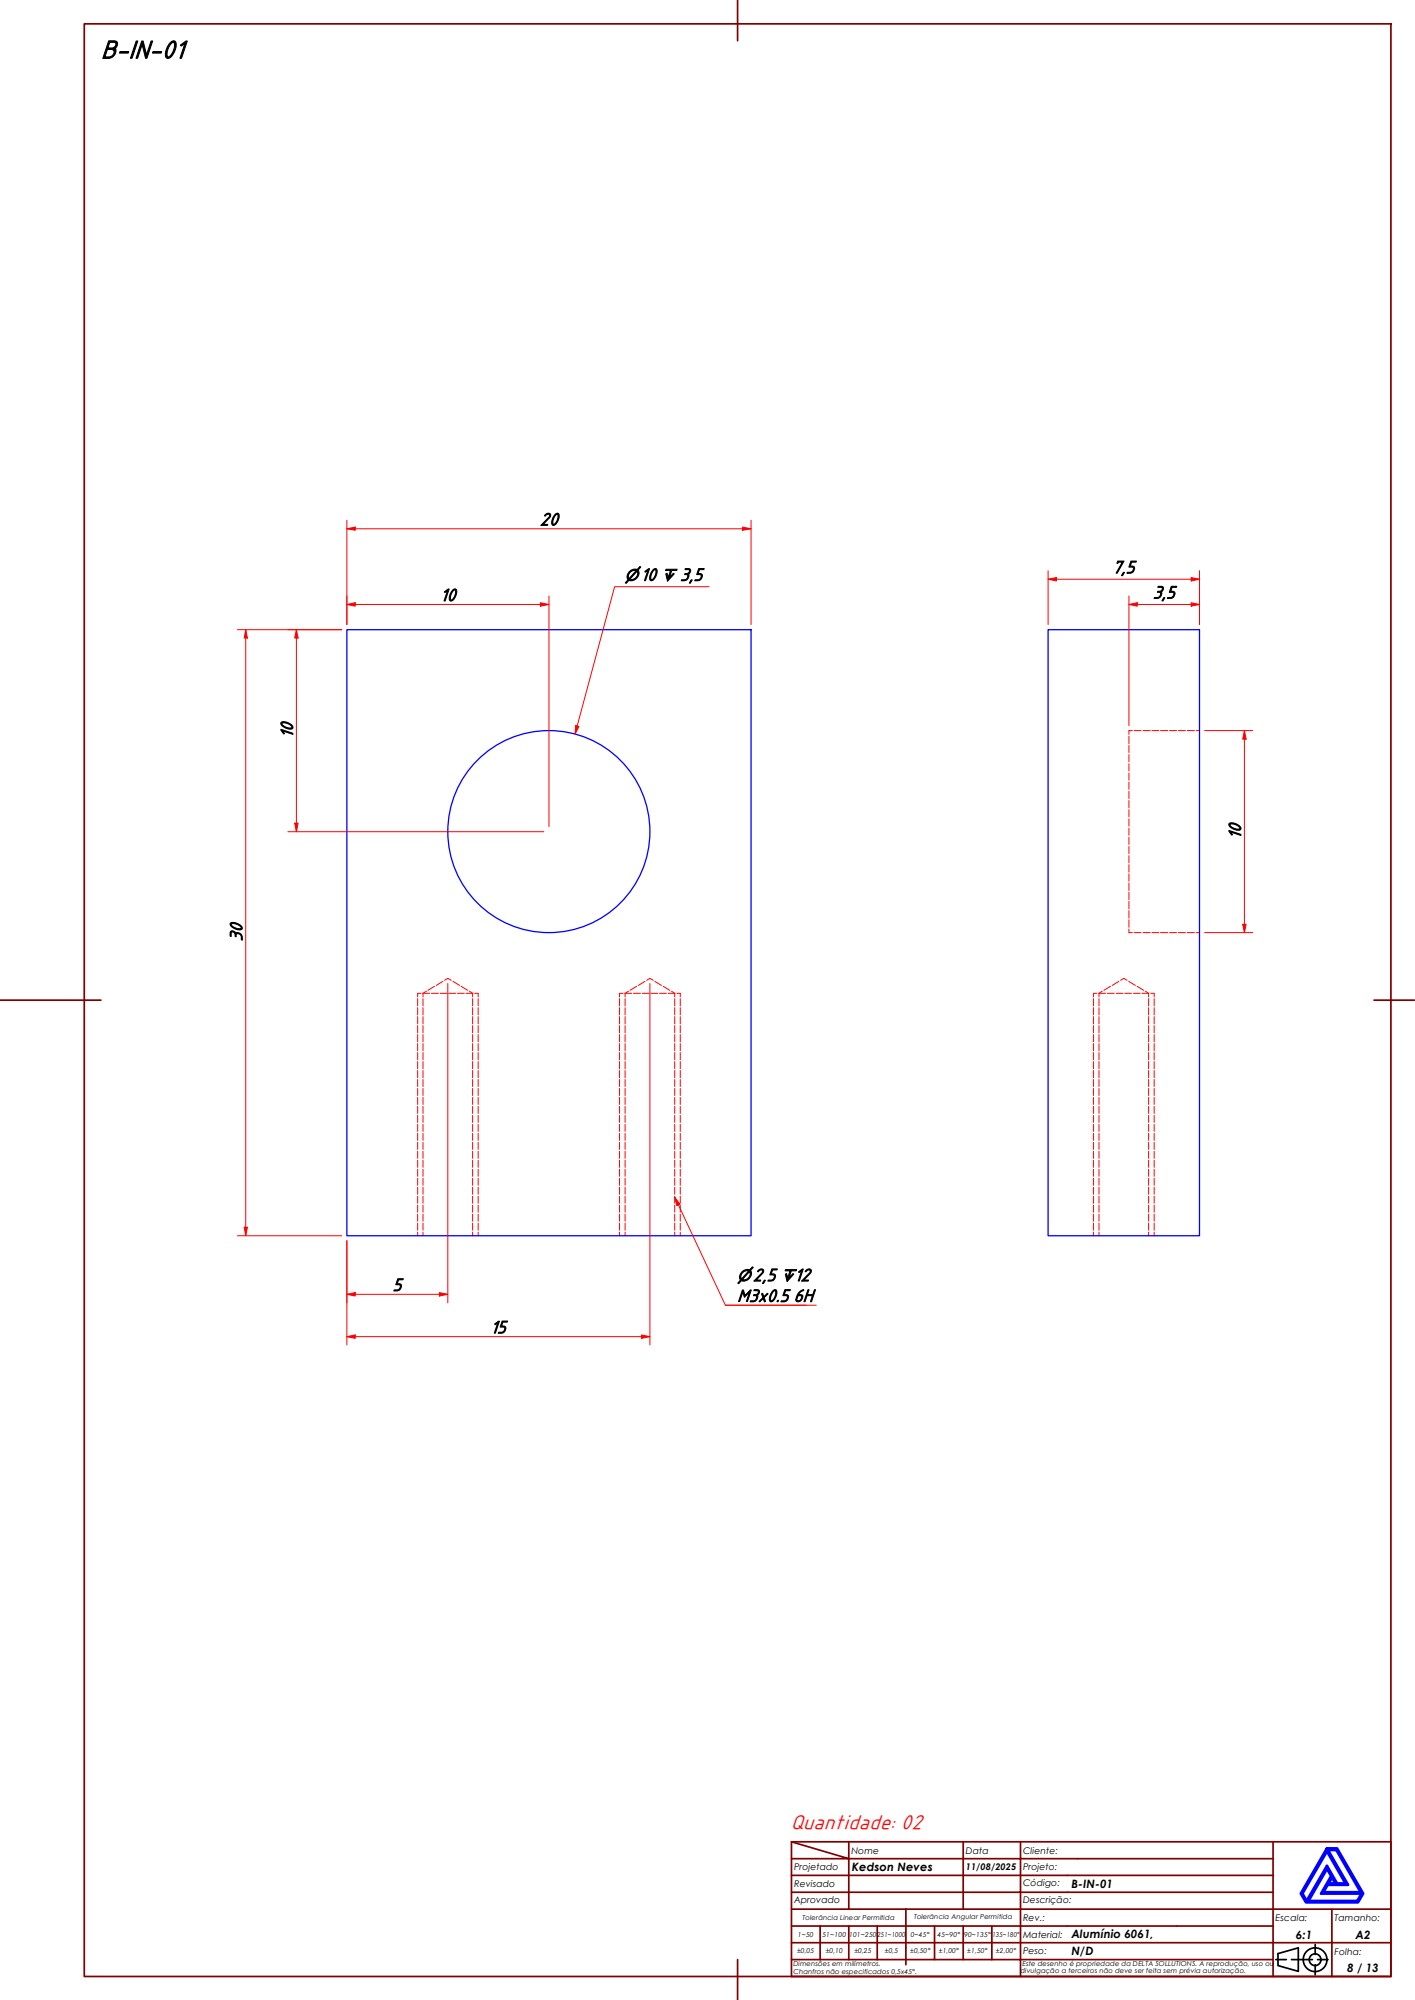
[picture p171: page 8]
Quantidade: 02

Projetado | Nome | Data | Cliente:

Kedson Neves | 11/08/2025 | Projeto:

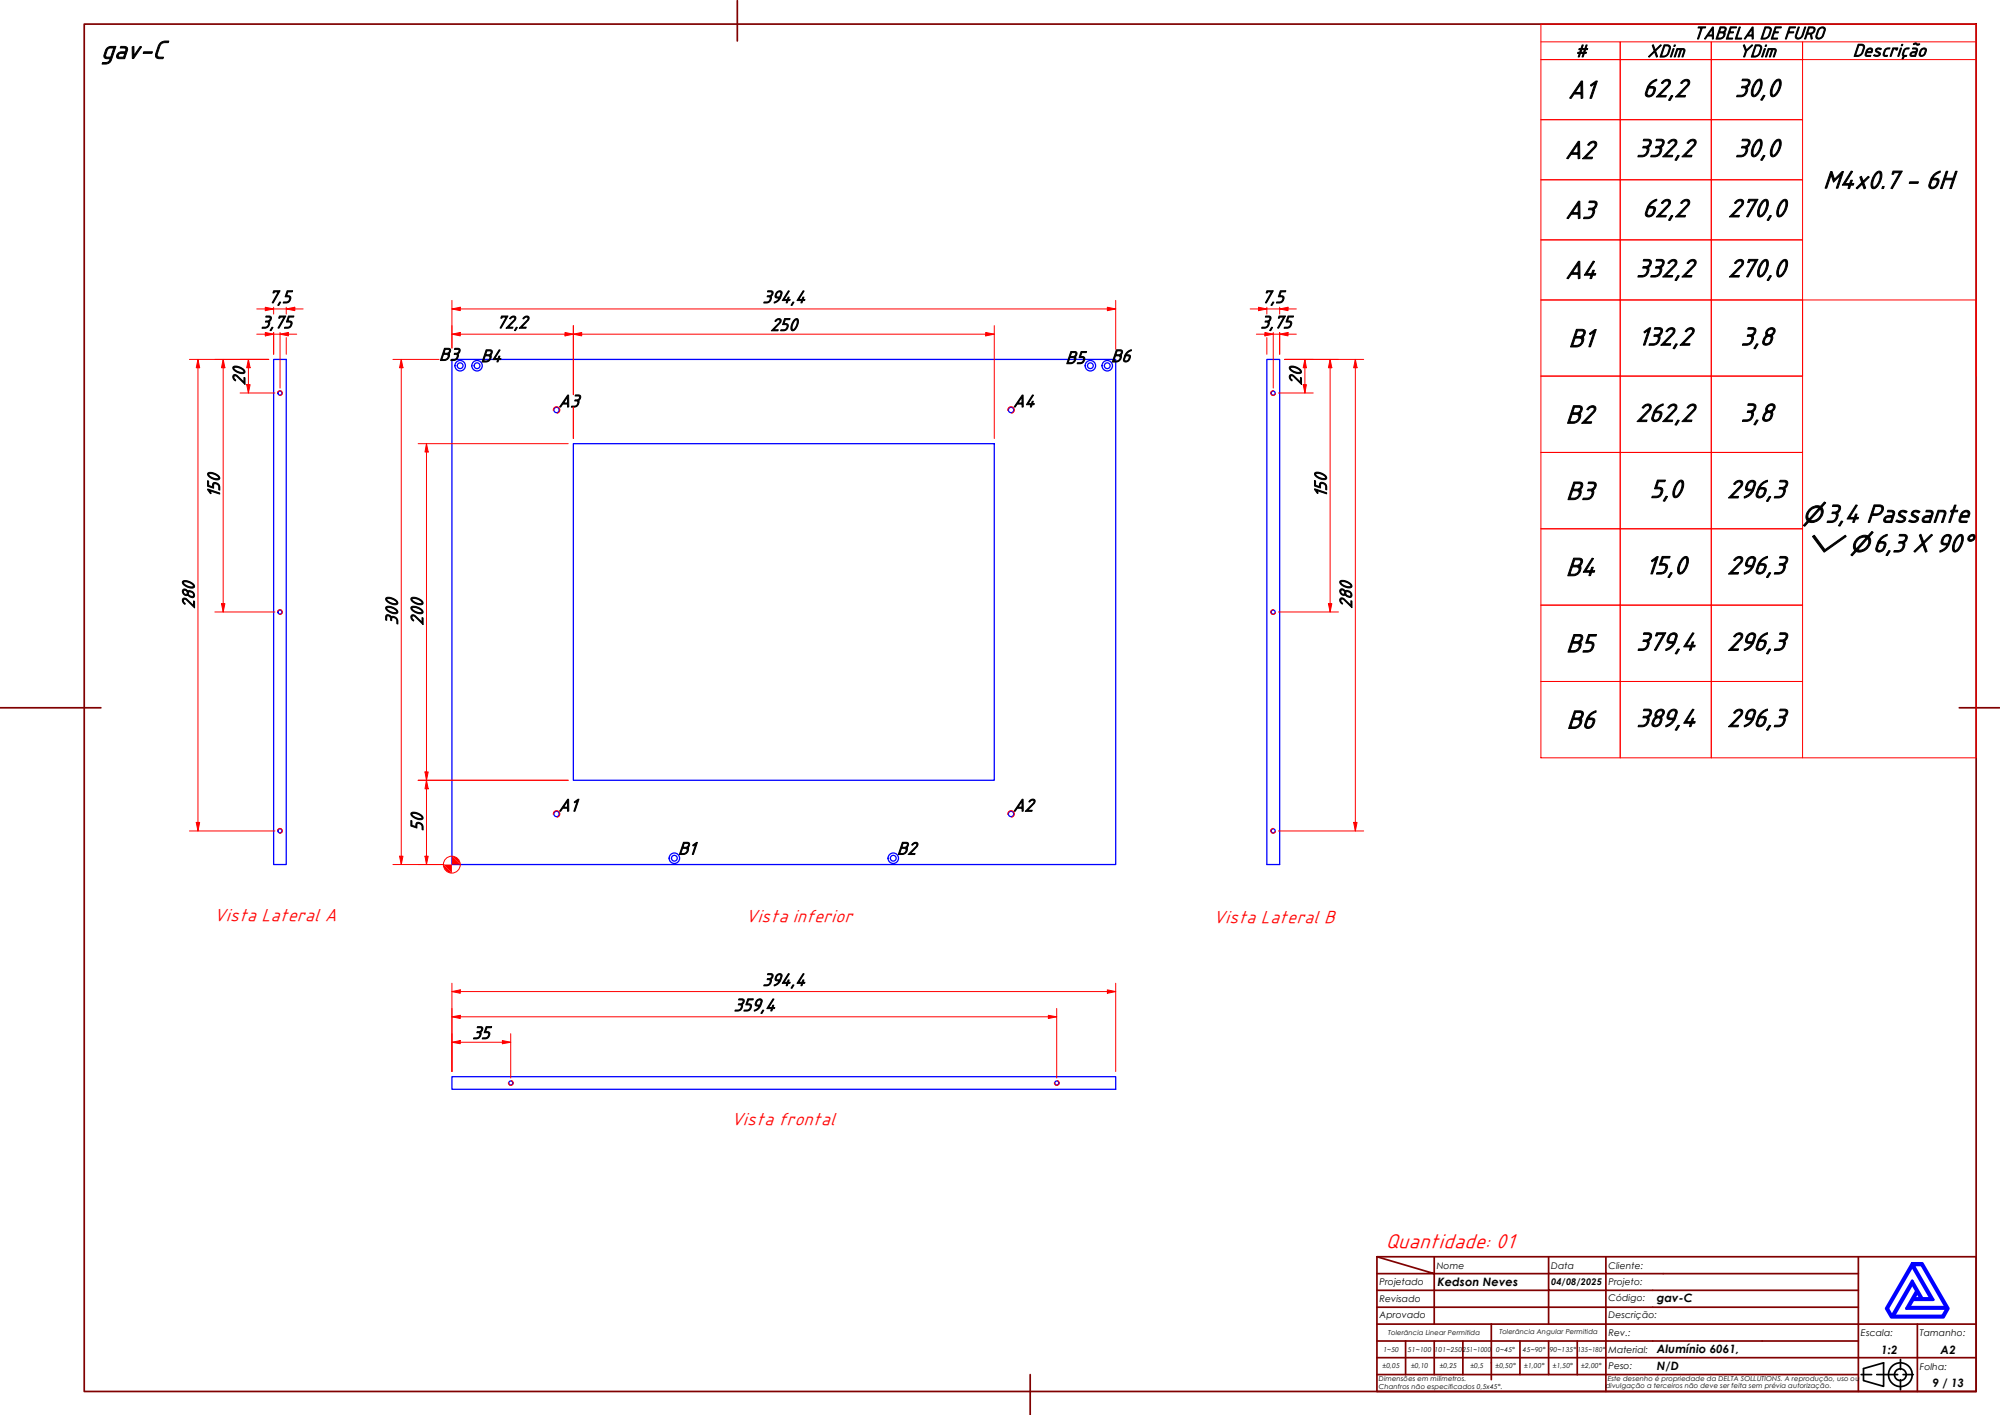
[picture p172: page 9]
Vista frontal; Vista Lateral A; Vista inferior; Vista Lateral B; Quantidade: 01

TABELA DE FURO

# | XDim | YDim | Descrição
A1 | 62,2 | 30,0 | M4x0.7 - 6H

B2 | 262,2 | 3,8 ⌀ 3,4 Passante

Projetado | Nome | Data | Cliente:

Kedson Neves | 04/08/2025 | Projeto:

gav-C

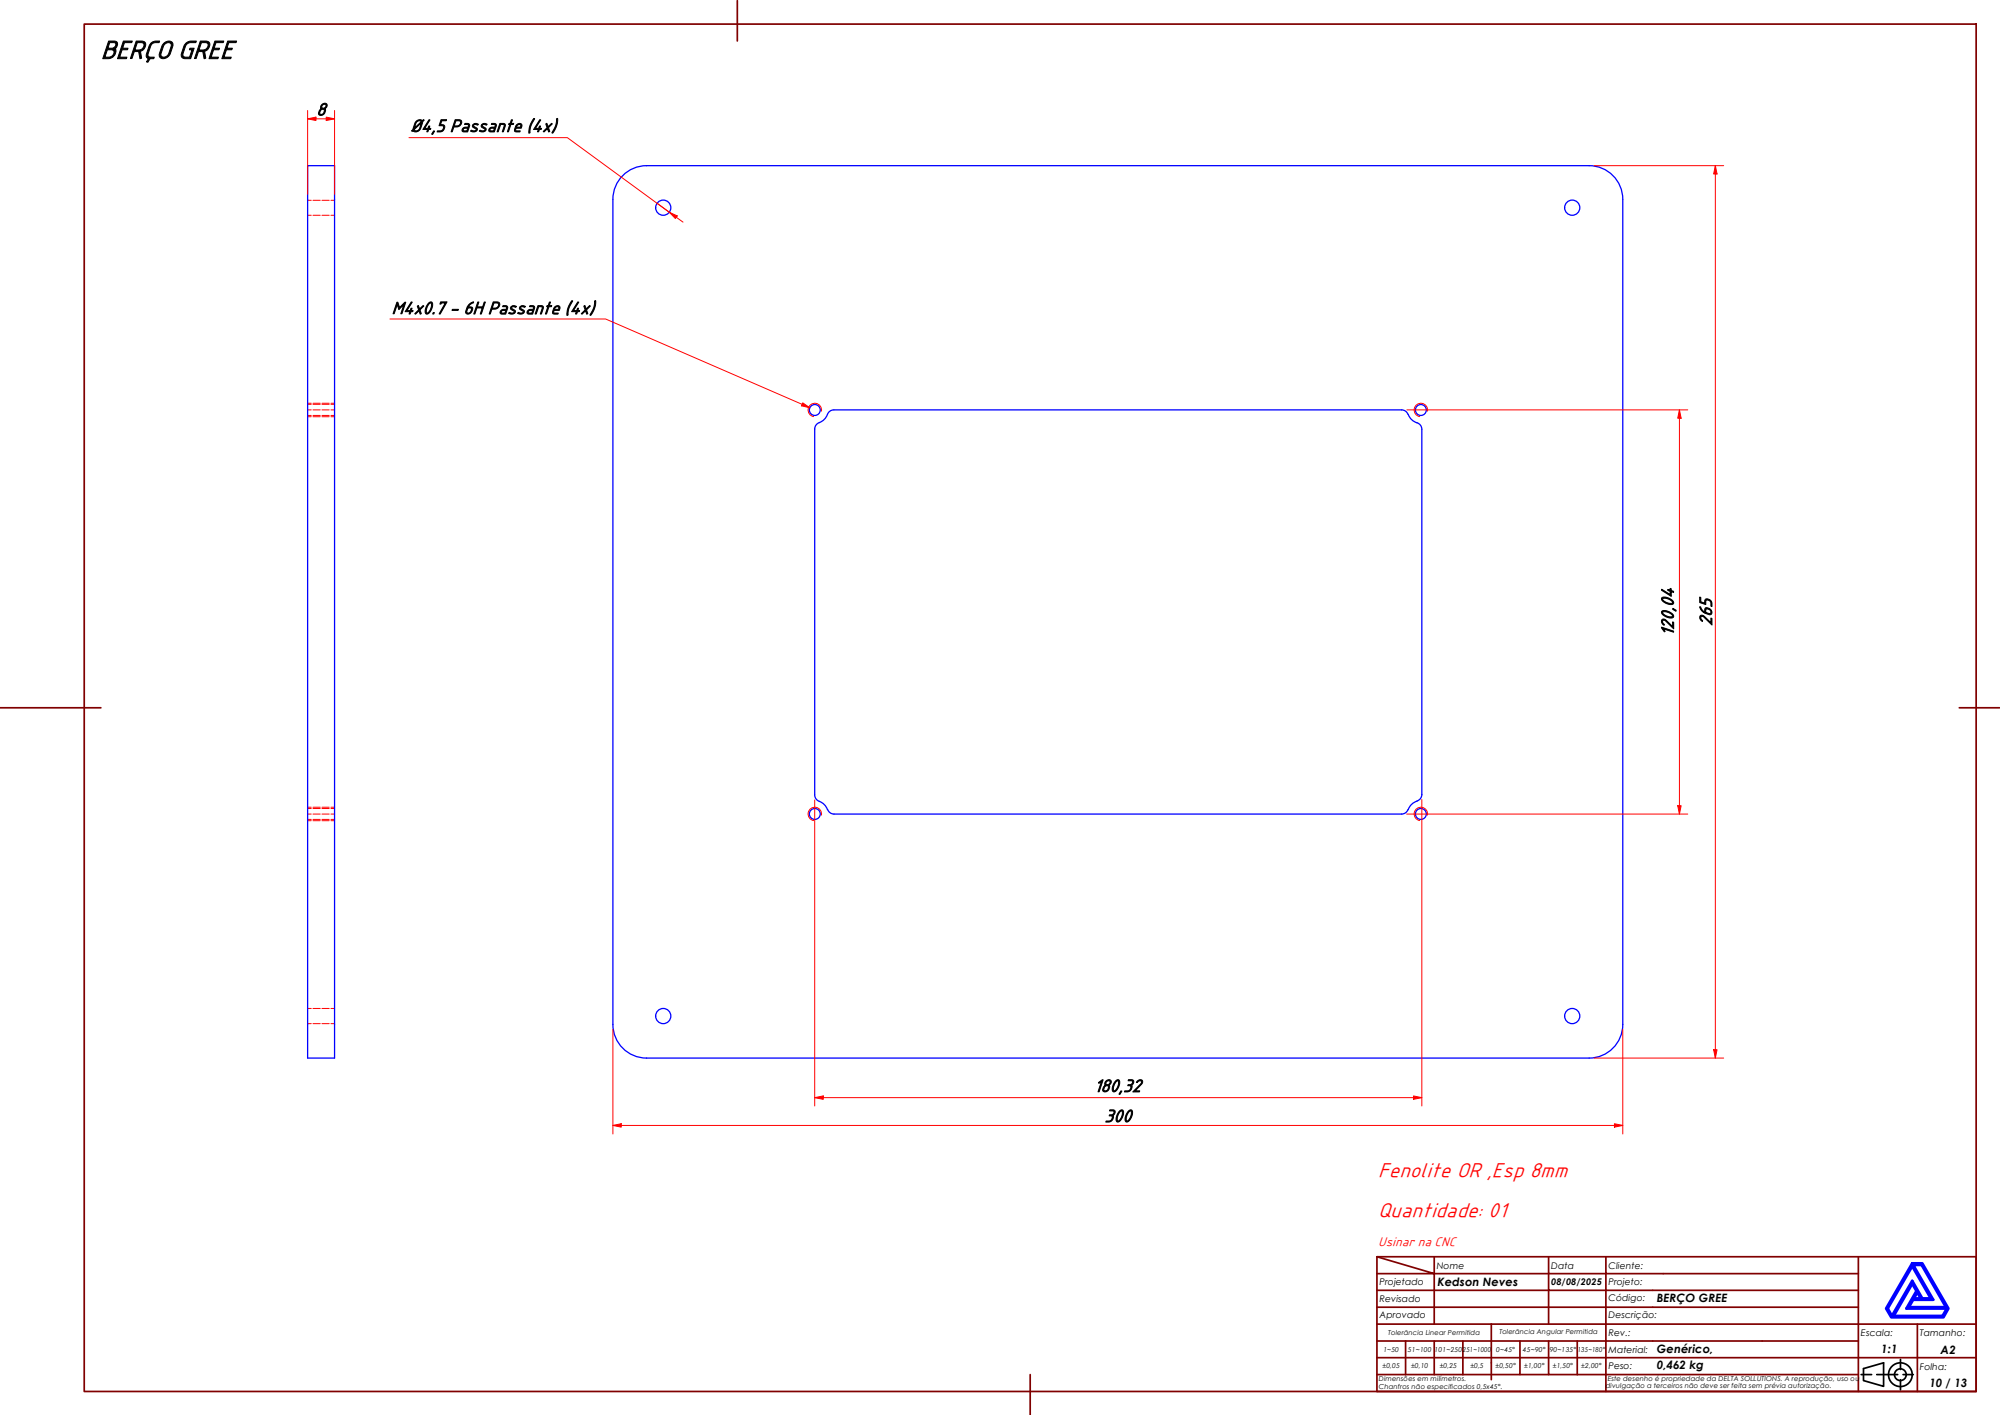
[picture p173: page 10]
BERÇO GREE; M4x0.7 - 6H Passante (4x); Ø4,5 Passante (4x); Quantidade: 01

Fenolite OR ,Esp 8mm

Usinar na CNC

Projetado | Nome | Data | Cliente:

Kedson Neves | 08/08/2025 | Projeto:

BERÇO GREE

Genérico,
0,462 kg | 10 / 13

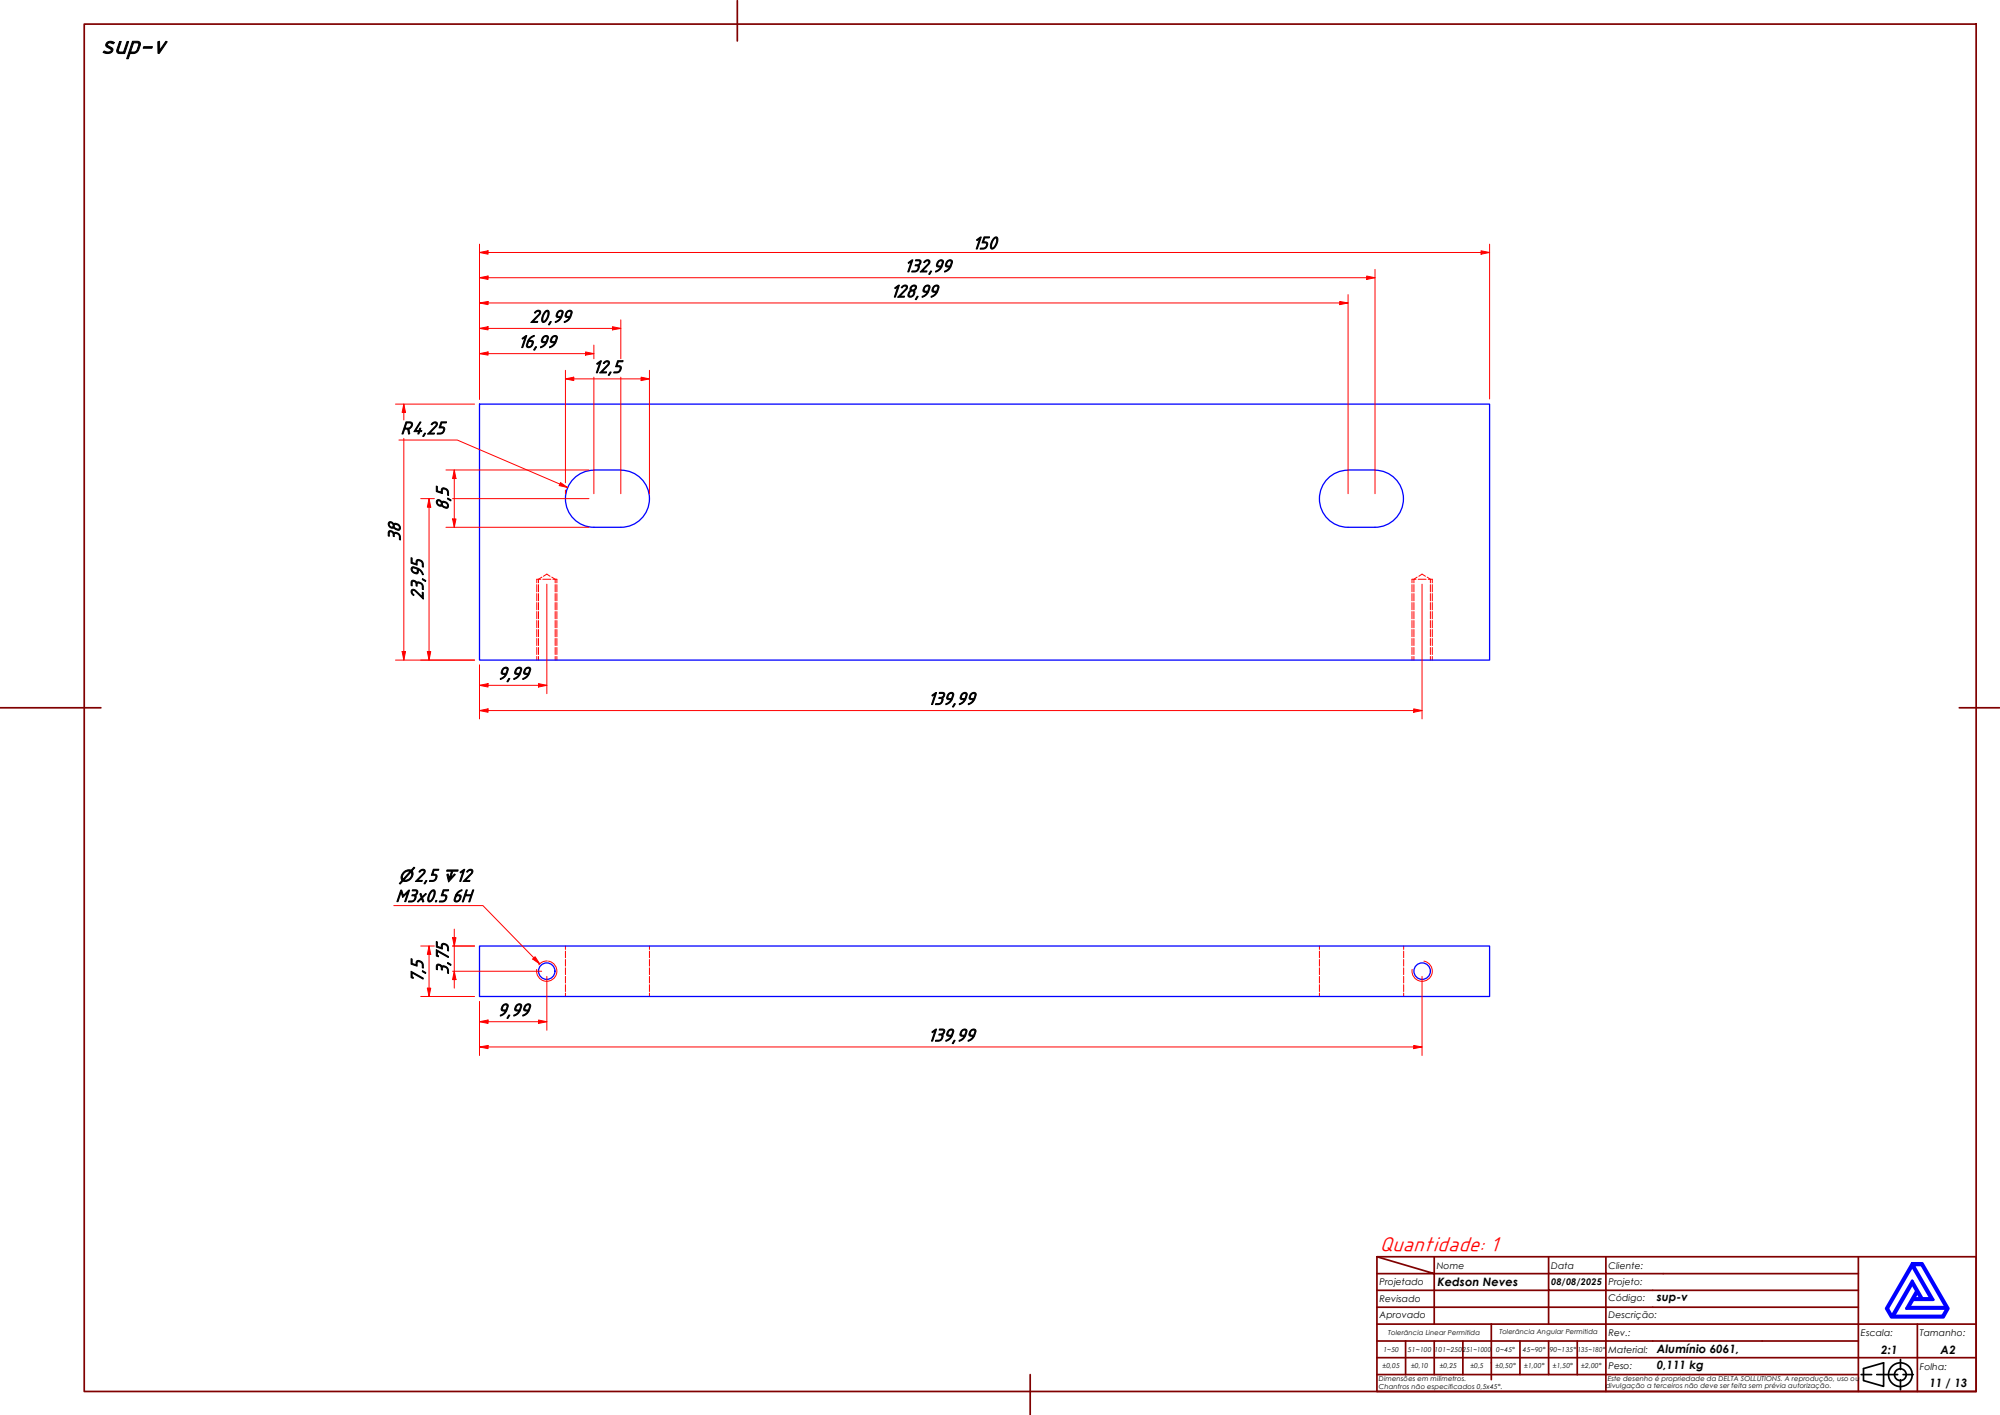
[picture p174: page 11]
Quantidade: 1

Projetado | Nome | Data | Cliente:

Kedson Neves | 08/08/2025 | Projeto:

sup-v

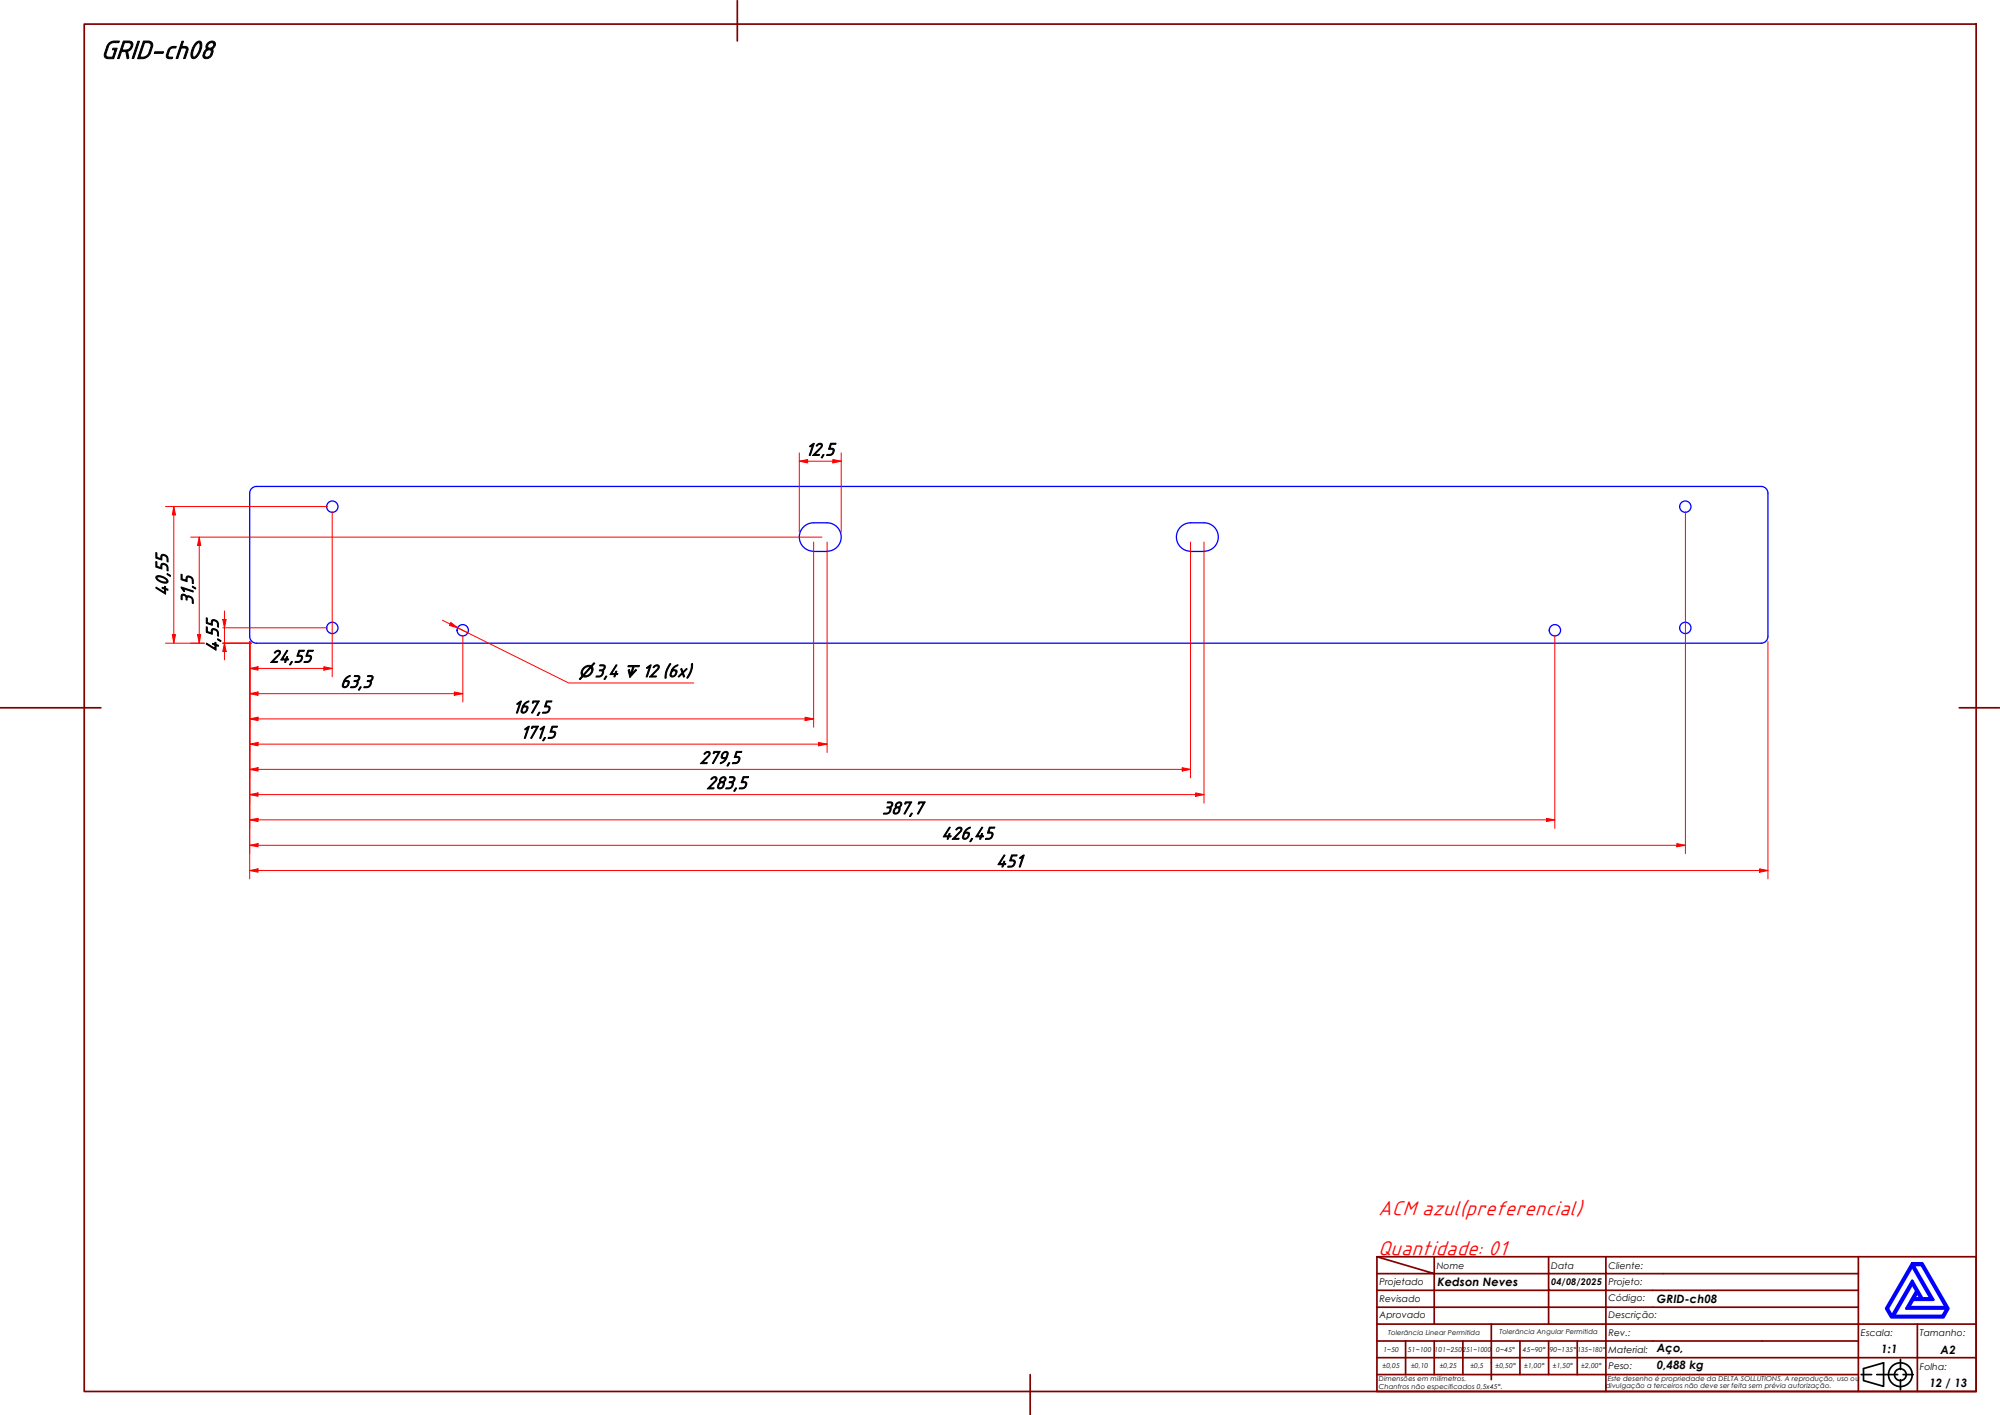
[picture p175: page 12]
Quantidade: 01

ACM azul(preferencial)

Projetado | Nome | Data | Cliente:

Kedson Neves | 04/08/2025 | Projeto:

GRID-ch08

Aço,
0,488 kg | 12 / 13

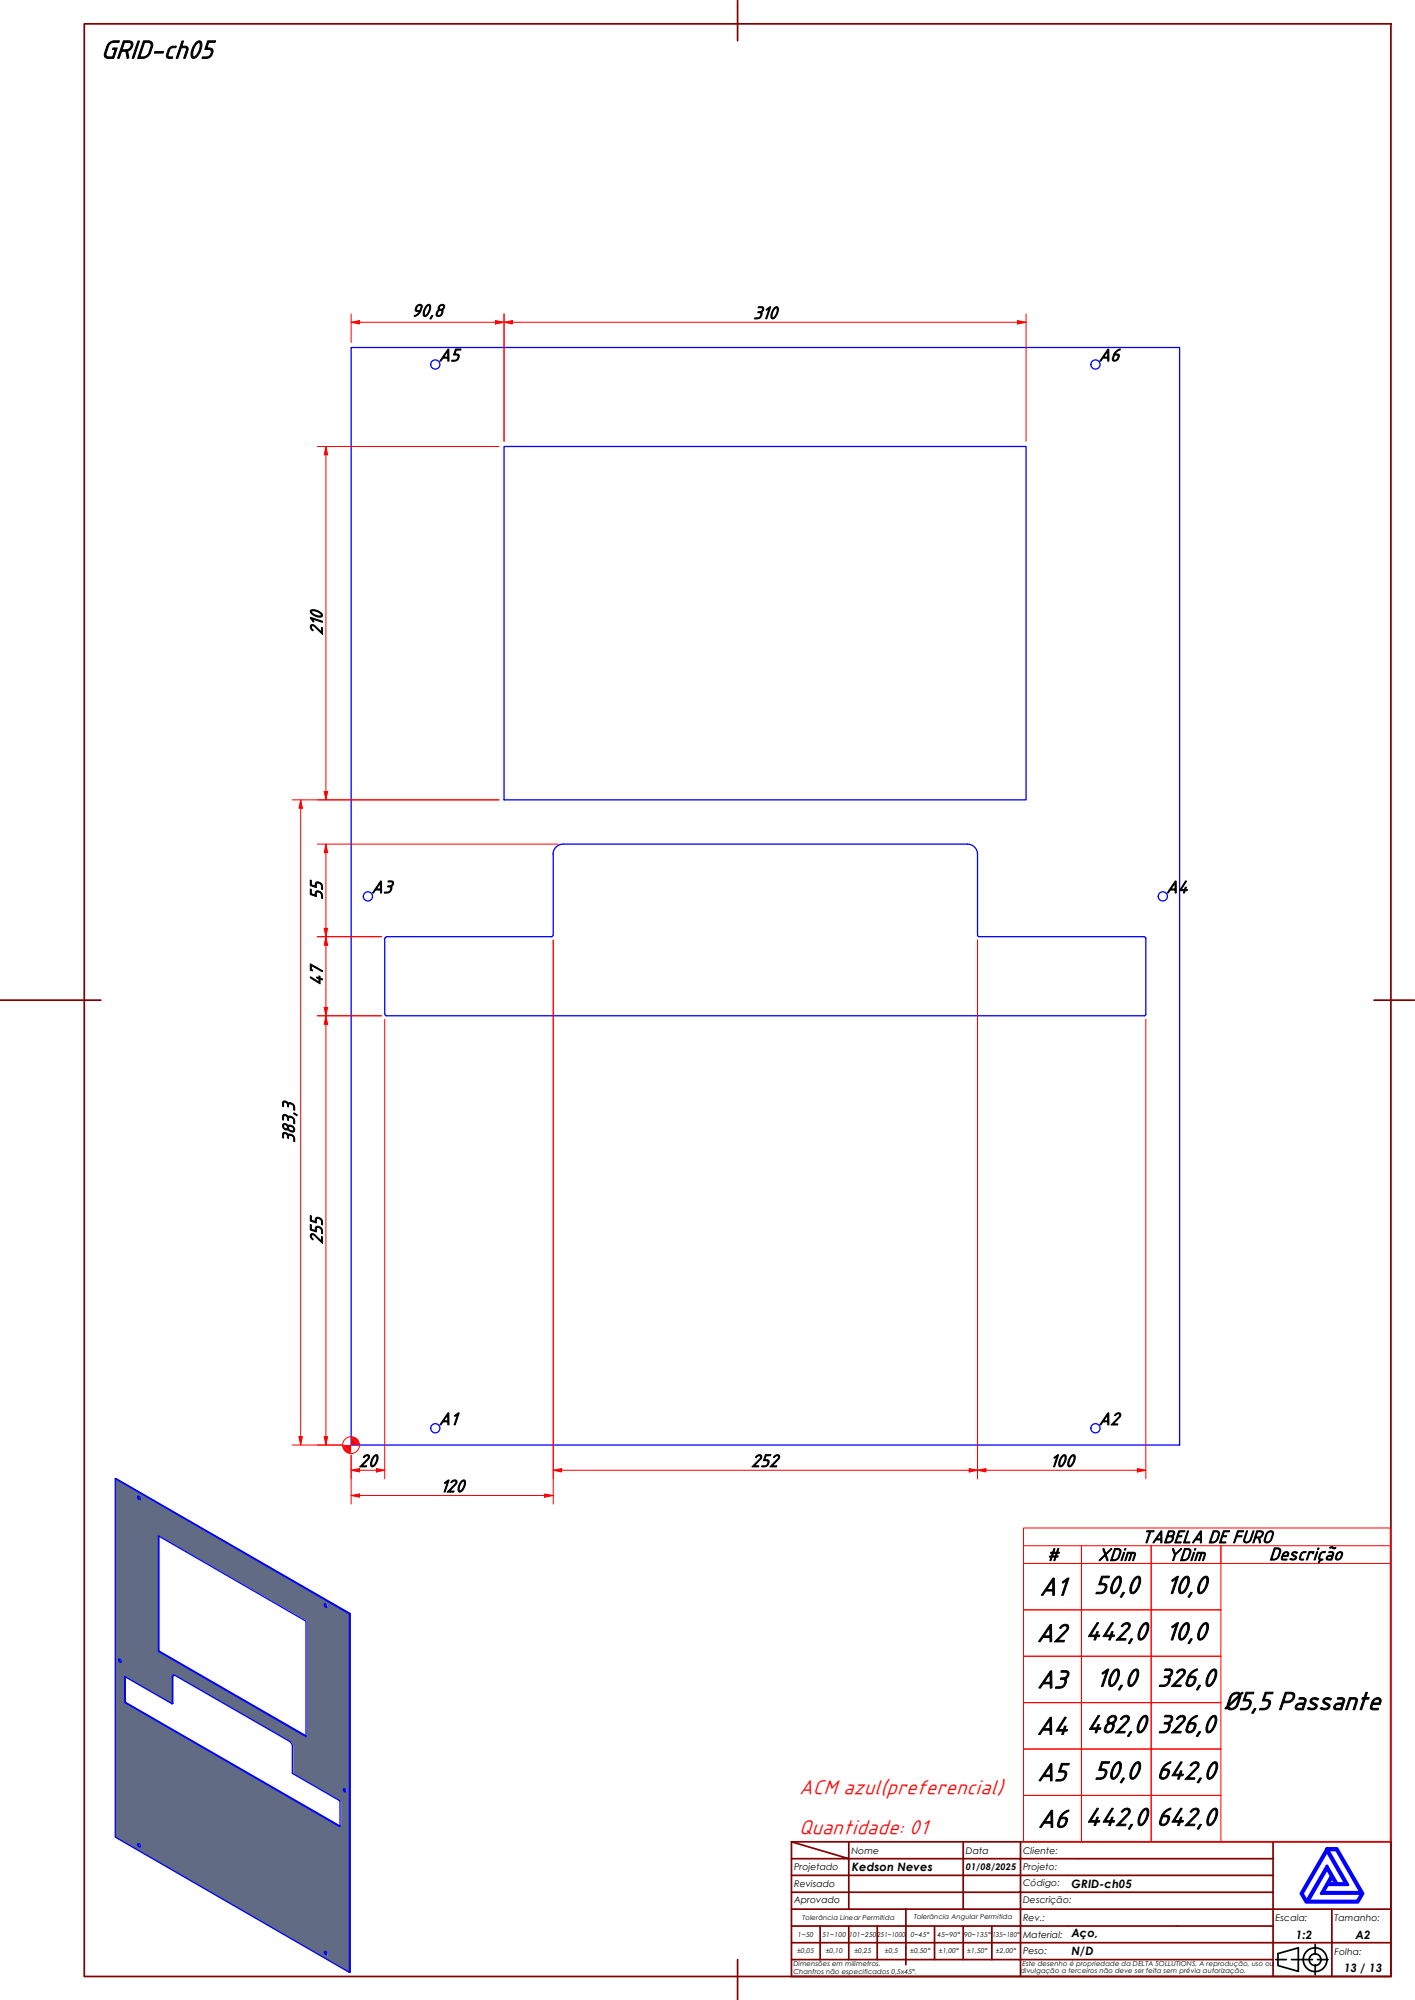
[picture p176: page 13]
Quantidade: 01

TABELA DE FURO

# | XDim | YDim | Descrição
A1 | 50,0 | 10,0 | Ø5,5 Passante
A2 | 442,0 10,0
A3 | 10,0 | 326,0
A4 | 482,0 326,0
A5 | 50,0 | 642,0
A6 | 442,0 642,0

ACM azul(preferencial)

Projetado | Nome | Data | Cliente:

Kedson Neves | 01/08/2025 | Projeto:

GRID-ch05

Aço,
