pvrezende/Dashboard/uploads/anexo-1755183981198-150319139.pdf

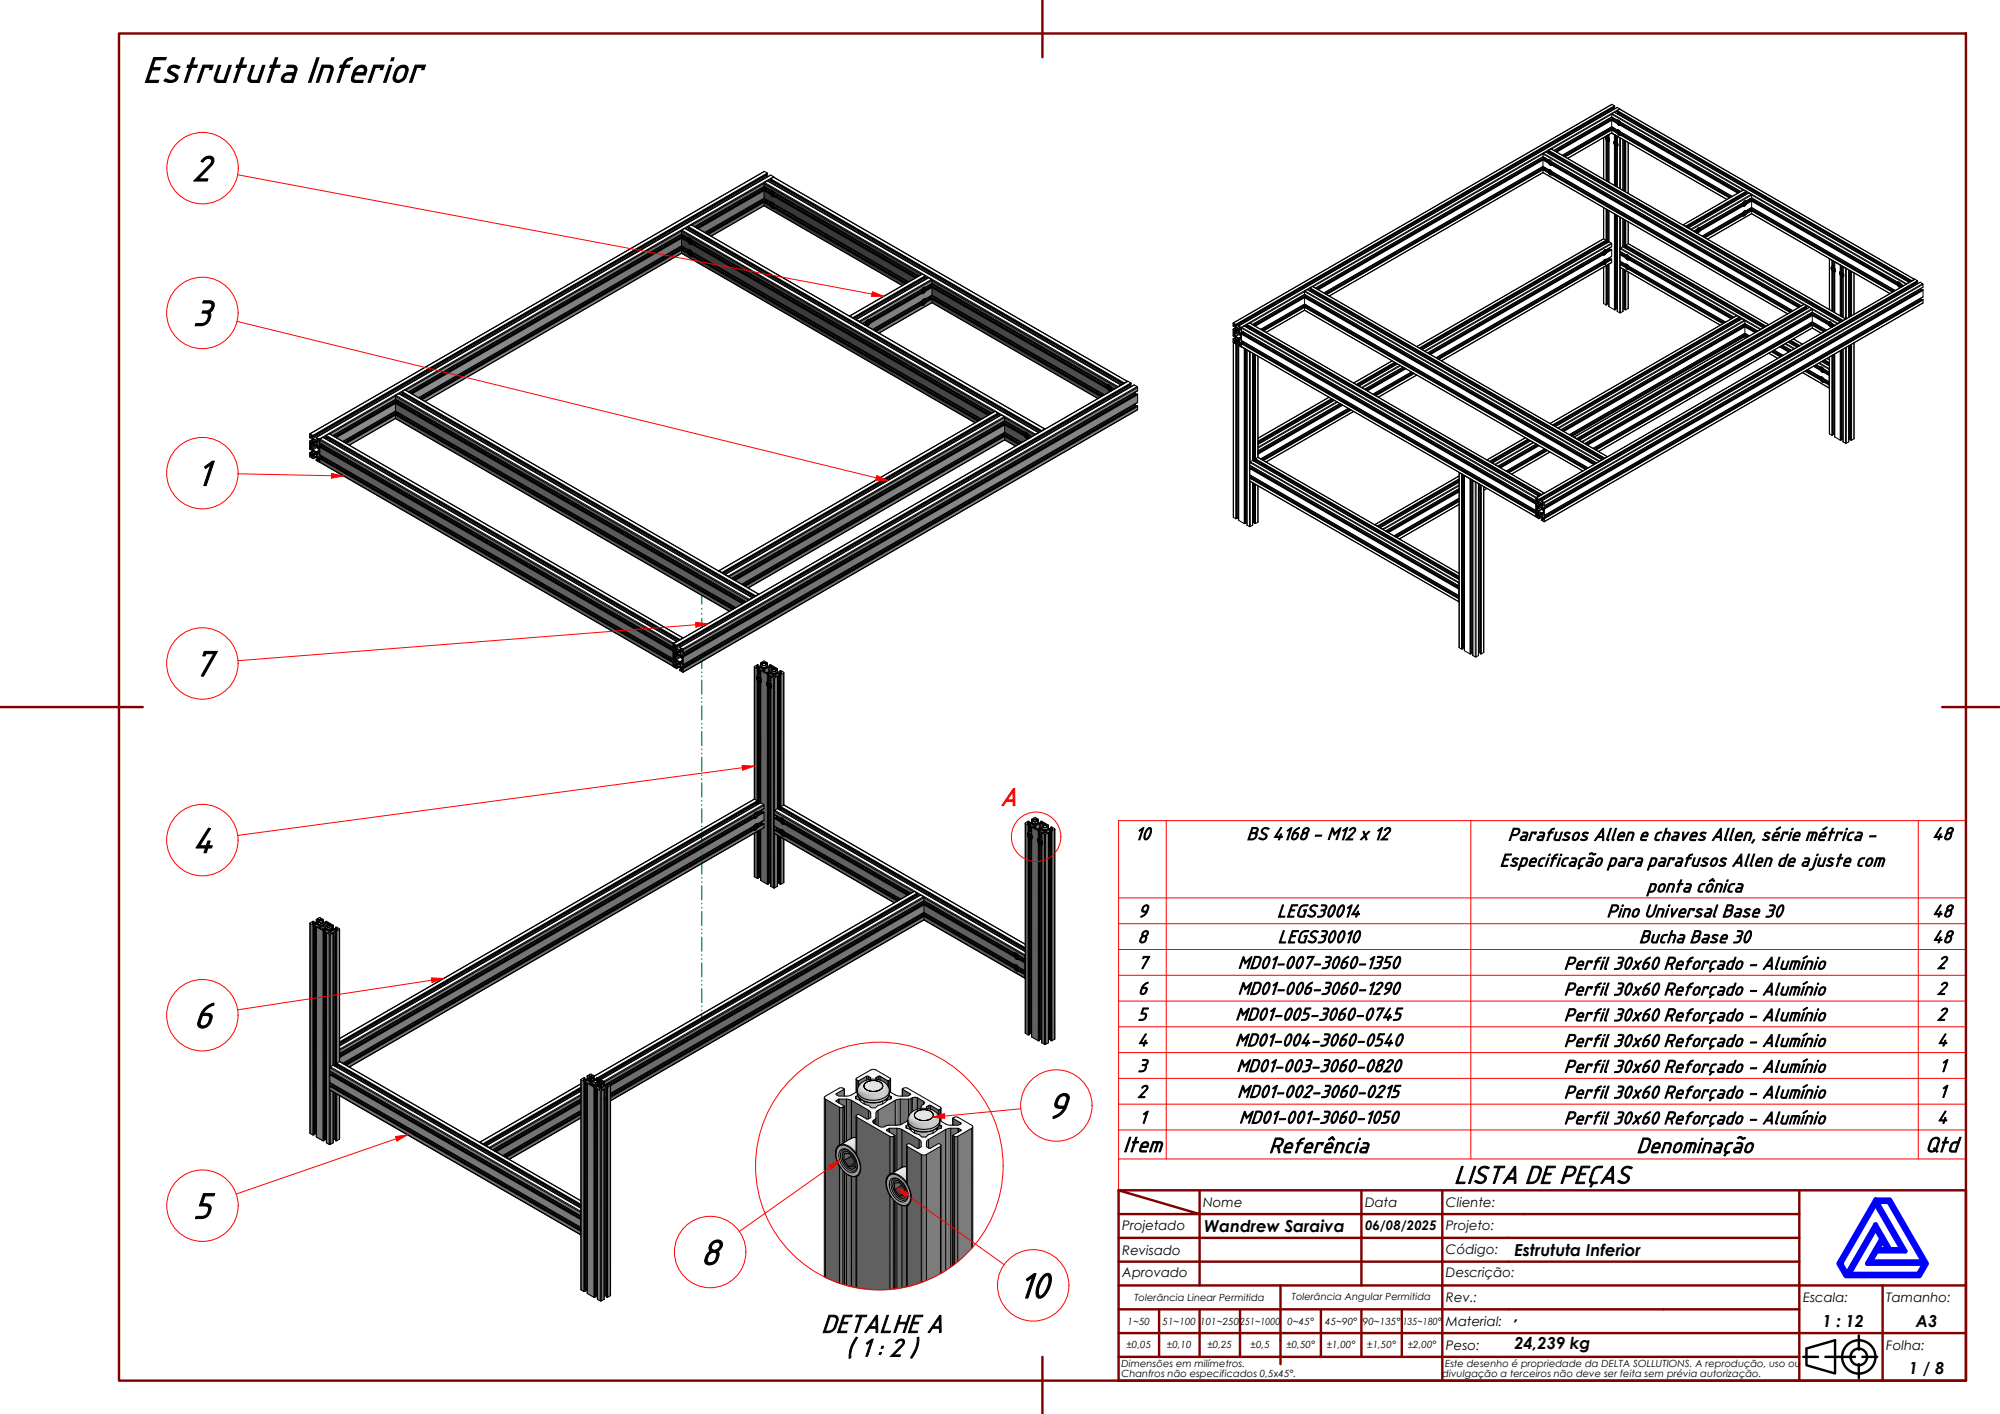
[picture p177: page 1]
DETALHE A ( 1 : 2 ); Estrututa Inferior

10 | BS 4168 - M12 x 12 | Parafusos Allen e chaves Allen, série métrica -Especificação para parafusos Allen de ajuste com ponta cônica | 48

9 | LEGS30014 | Pino Universal Base 30 | 48
8 | LEGS30010 | Bucha Base 30 | 48
7 | MD01-007-3060-1350 | Perfil 30x60 Reforçado - Alumínio | 2
6 | MD01-006-3060-1290 | Perfil 30x60 Reforçado - Alumínio | 2
5 | MD01-005-3060-0745 | Perfil 30x60 Reforçado - Alumínio | 2
4 | MD01-004-3060-0540 | Perfil 30x60 Reforçado - Alumínio | 4
3 | MD01-003-3060-0820 | Perfil 30x60 Reforçado - Alumínio | 1
2 | MD01-002-3060-0215 | Perfil 30x60 Reforçado - Alumínio | 1
1 | MD01-001-3060-1050 | Perfil 30x60 Reforçado - Alumínio | 4
Item | Referência | Denominação | Qtd

LISTA DE PEÇAS

Projetado | Nome | Data | Cliente:

Wandrew Saraiva | 06/08/2025 | Projeto:

Revisado | | | Código: Estrututa Inferior

Aprovado | | | Descrição:
Tolerância Linear Permitida | Tolerância Angular Permitida | Rev.: | Escala: 1 : 12 | Tamanho: A3
1~50 | 51~100 | 101~250 | | | | 90~135° 135~180° | | , Material:

±1,00° | | ±2,00° | 24,239 kg Peso: | Folha: 1 / 8

Dimensões em milímetros.

Chanfros não especificados 0,5x45°. | | | | | | | | Este desenho é propriedade da DELTA SOLLUTIONS. A reprodução, uso ou divulgação a terceiros não deve ser feita sem prévia autorização.

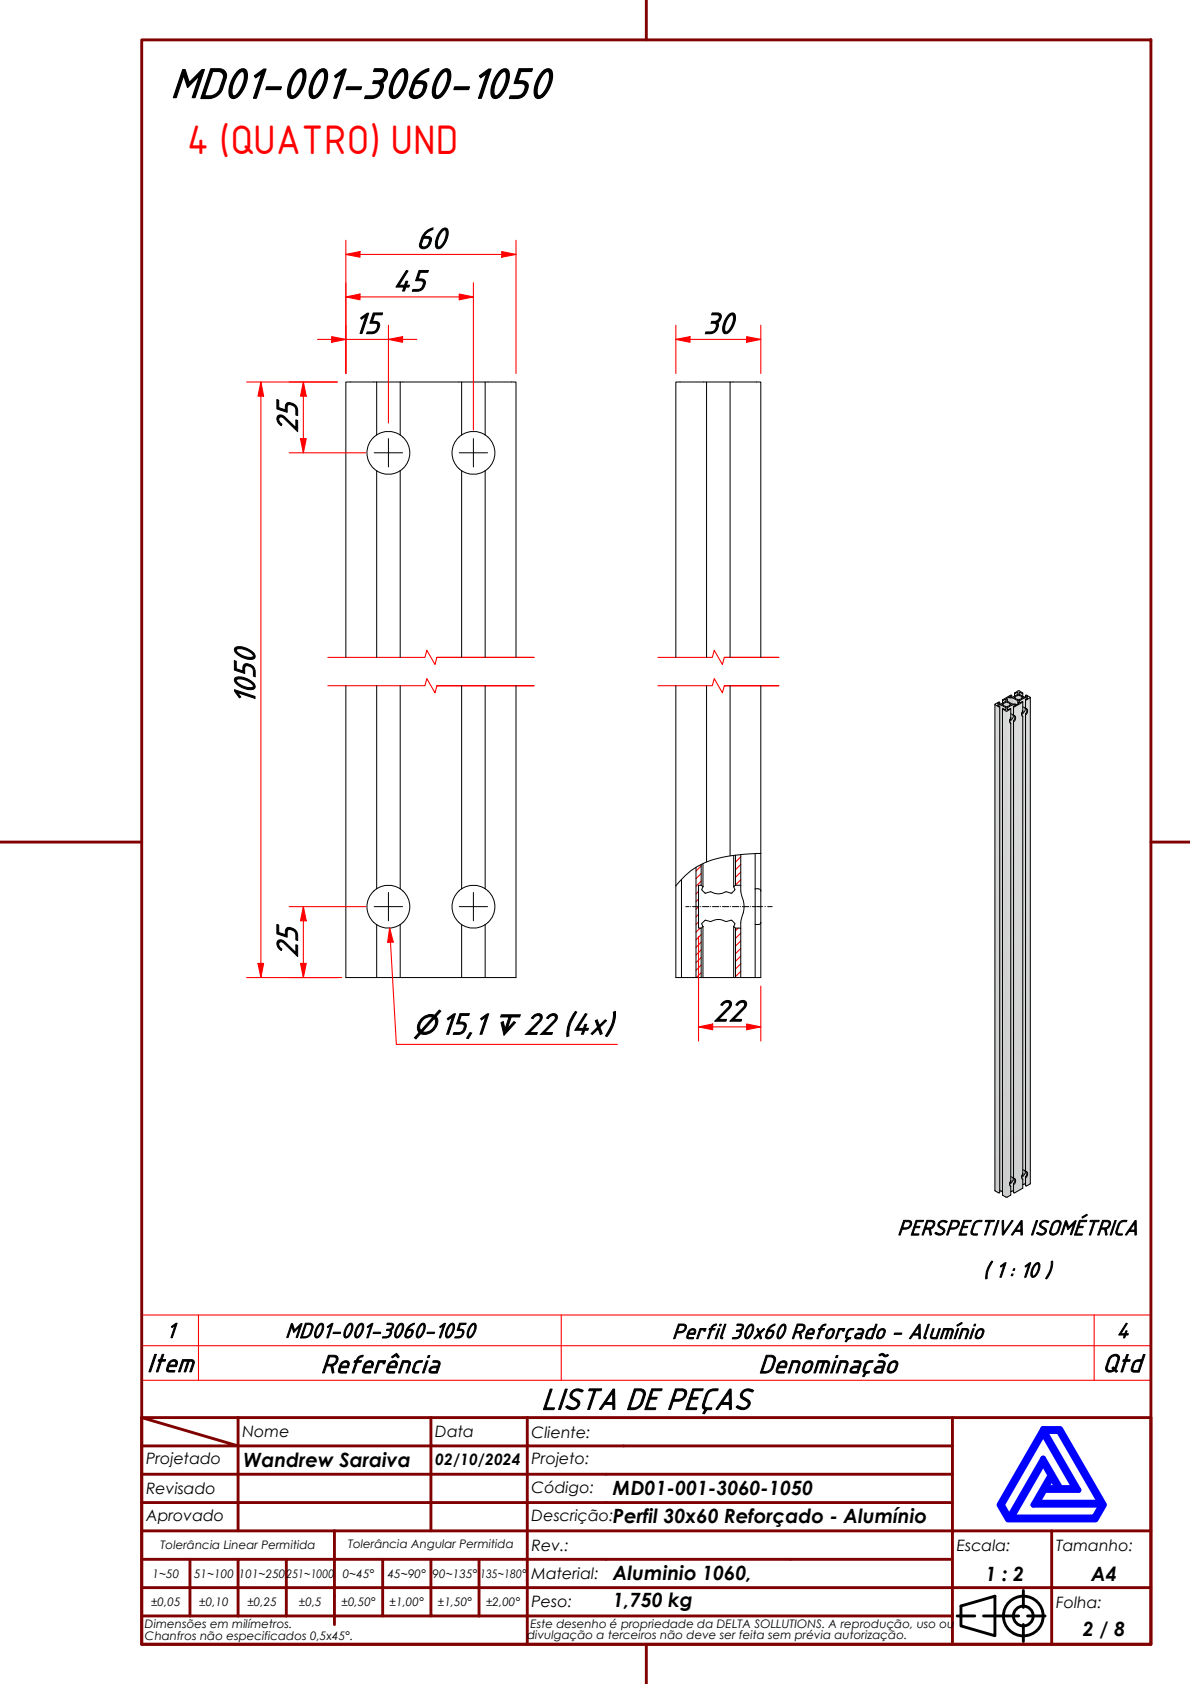
[picture p178: page 2]
PERSPECTIVA ISOMÉTRICA; 4 (QUATRO) UND

1 | MD01-001-3060-1050 | Perfil 30x60 Reforçado - Alumínio | 4
Item | Referência | Denominação | Qtd

LISTA DE PEÇAS

Projetado | Nome | Data | Cliente:

Wandrew Saraiva | 02/10/2024 | Projeto:

Revisado | | | Código: MD01-001-3060-1050
Aprovado | | | Perfil 30x60 Reforçado - Alumínio Descrição:

Aluminio 1060,
1,750 kg | 2 / 8

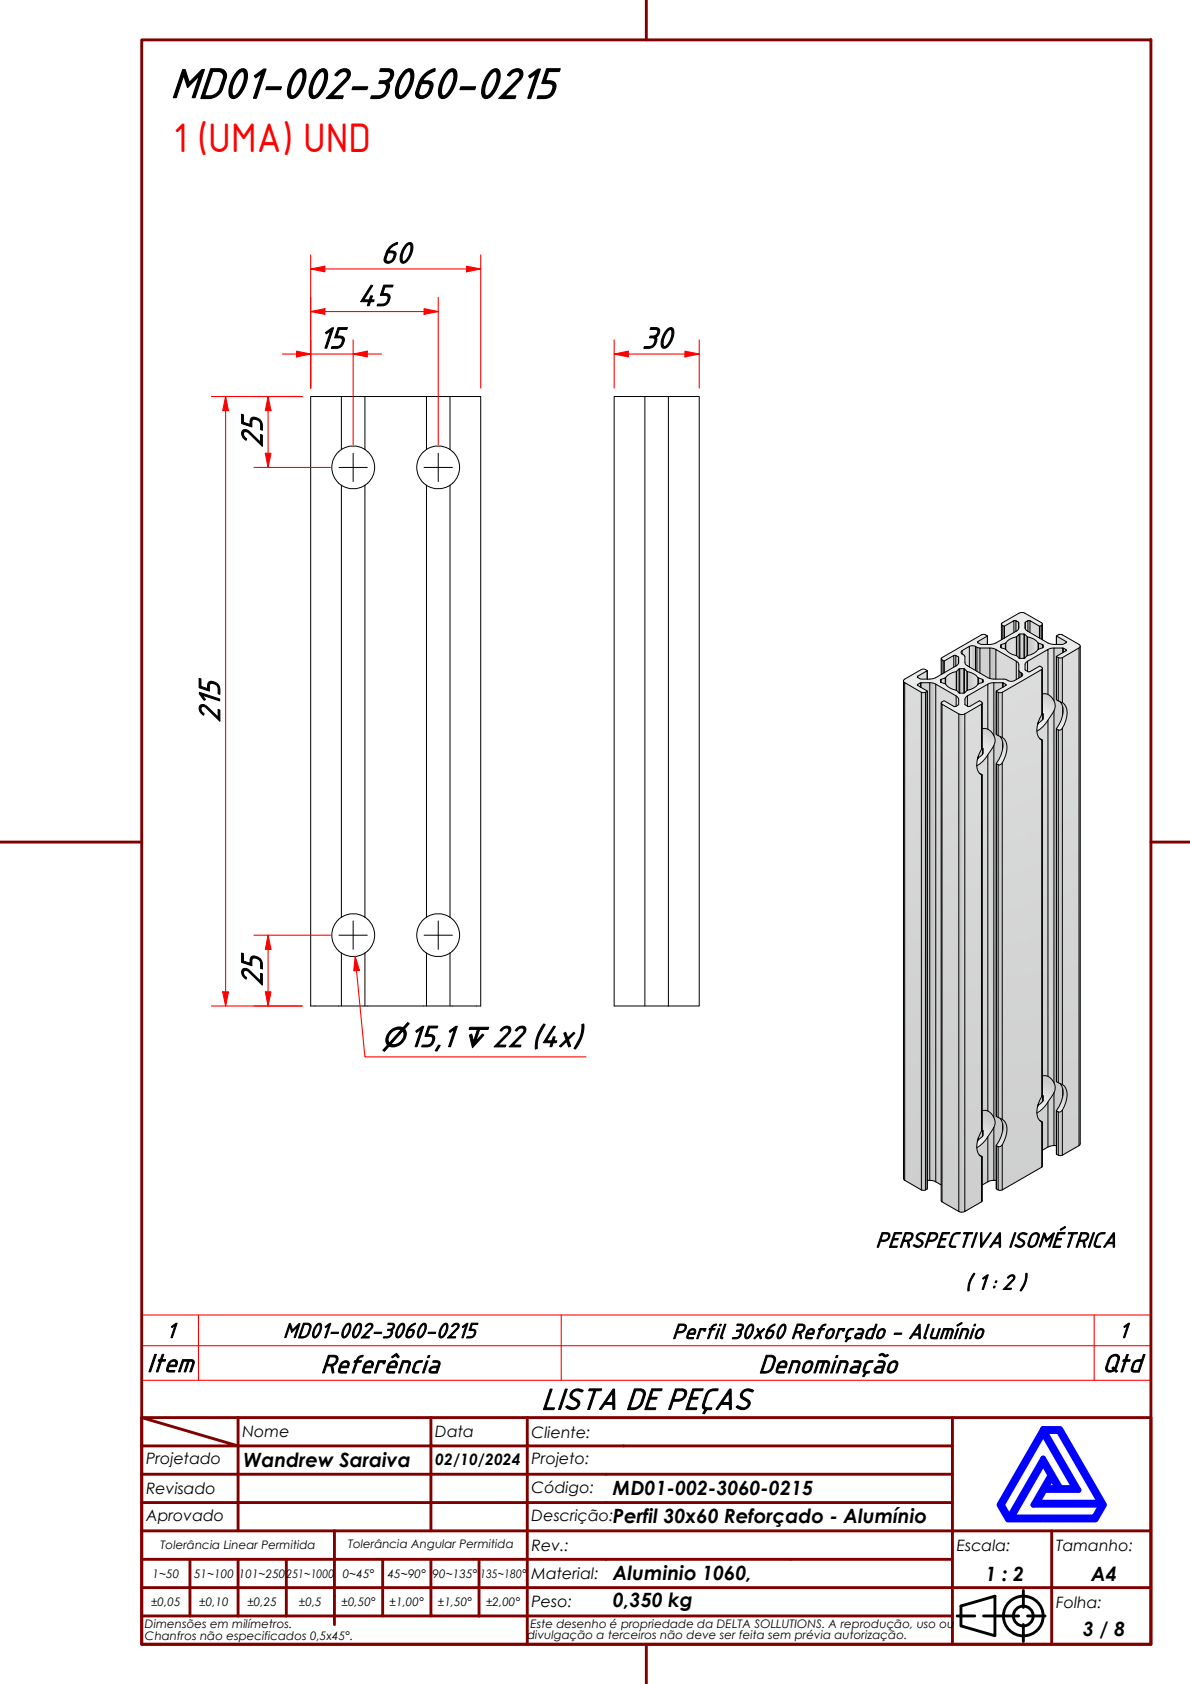
[picture p179: page 3]
PERSPECTIVA ISOMÉTRICA; 1 (UMA) UND

1 | MD01-002-3060-0215 | Perfil 30x60 Reforçado - Alumínio | 1
Item | Referência | Denominação | Qtd

LISTA DE PEÇAS

Projetado | Nome | Data | Cliente:

Wandrew Saraiva | 02/10/2024 | Projeto:

Revisado | | | Código: MD01-002-3060-0215
Aprovado | | | Perfil 30x60 Reforçado - Alumínio Descrição:

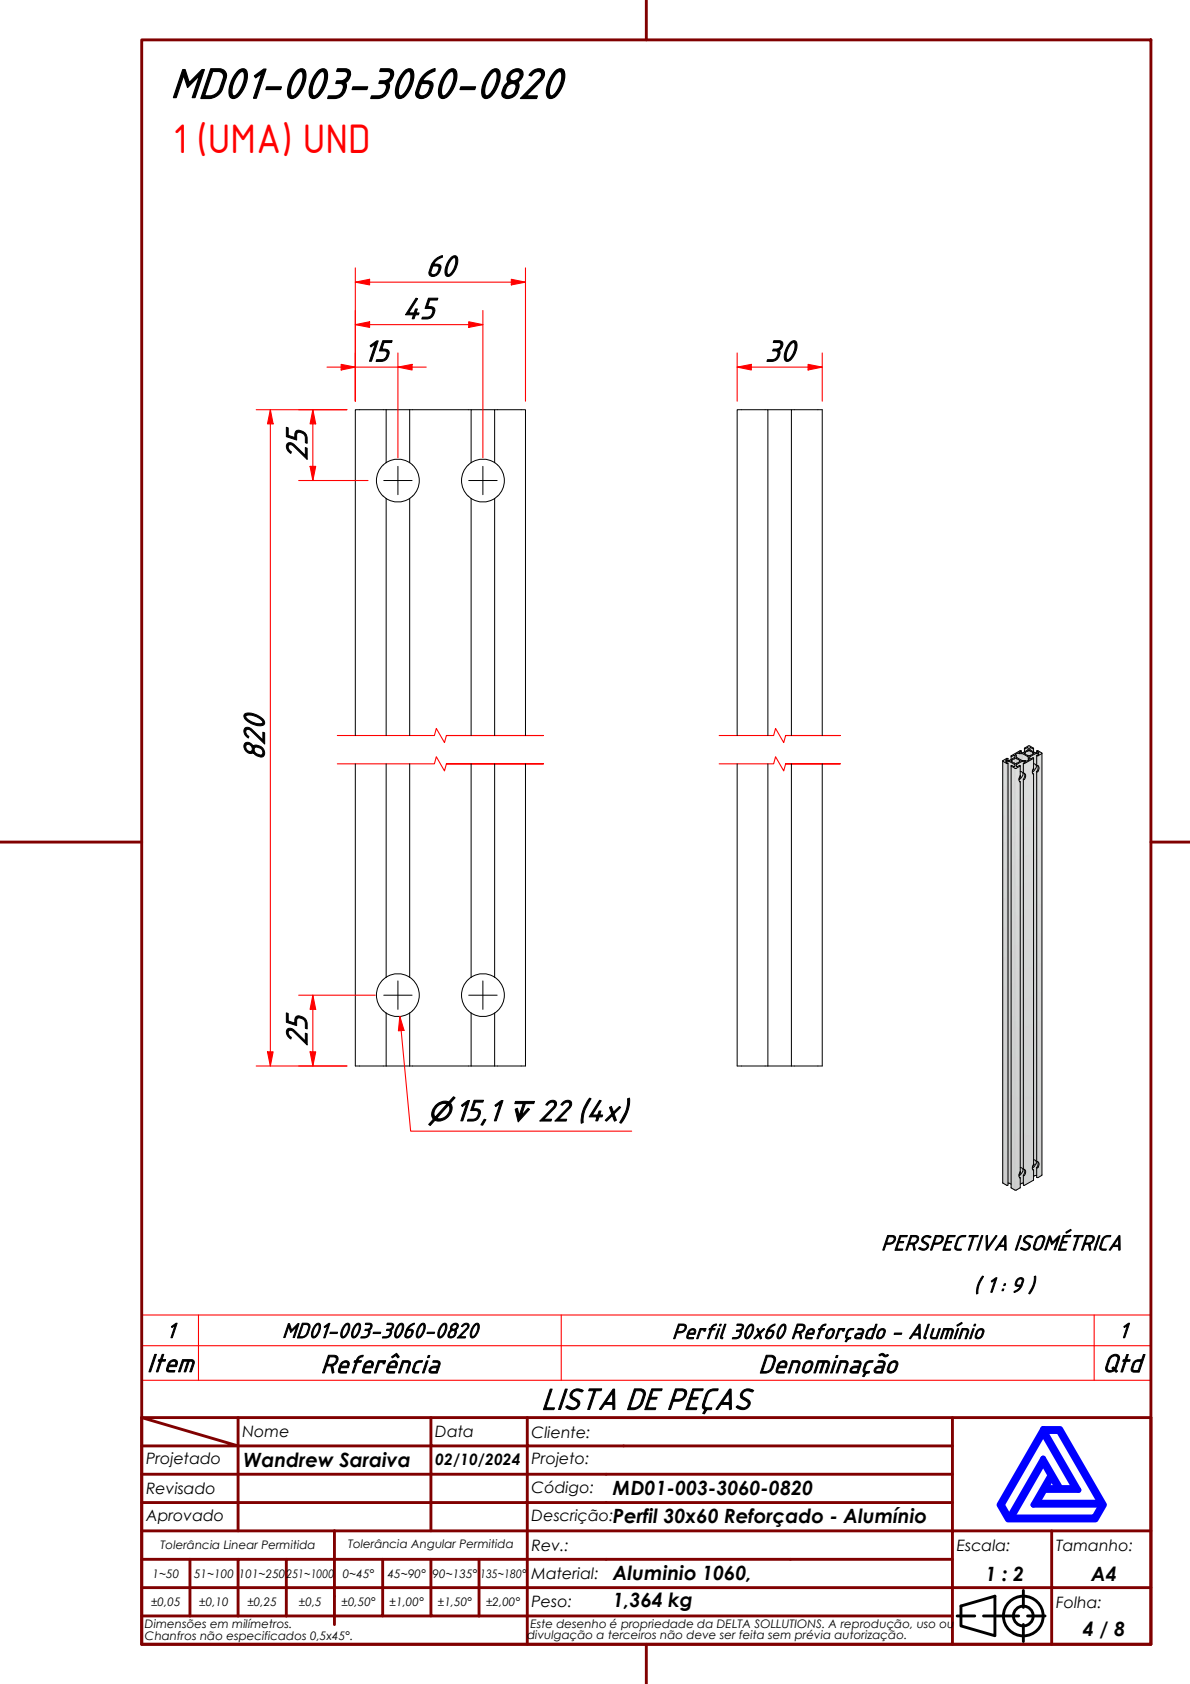
[picture p180: page 4]
PERSPECTIVA ISOMÉTRICA; 1 (UMA) UND

1 | MD01-003-3060-0820 | Perfil 30x60 Reforçado - Alumínio | 1
Item | Referência | Denominação | Qtd

LISTA DE PEÇAS

Projetado | Nome | Data | Cliente:

Wandrew Saraiva | 02/10/2024 | Projeto:

Revisado | | | Código: MD01-003-3060-0820
Aprovado | | | Perfil 30x60 Reforçado - Alumínio Descrição:

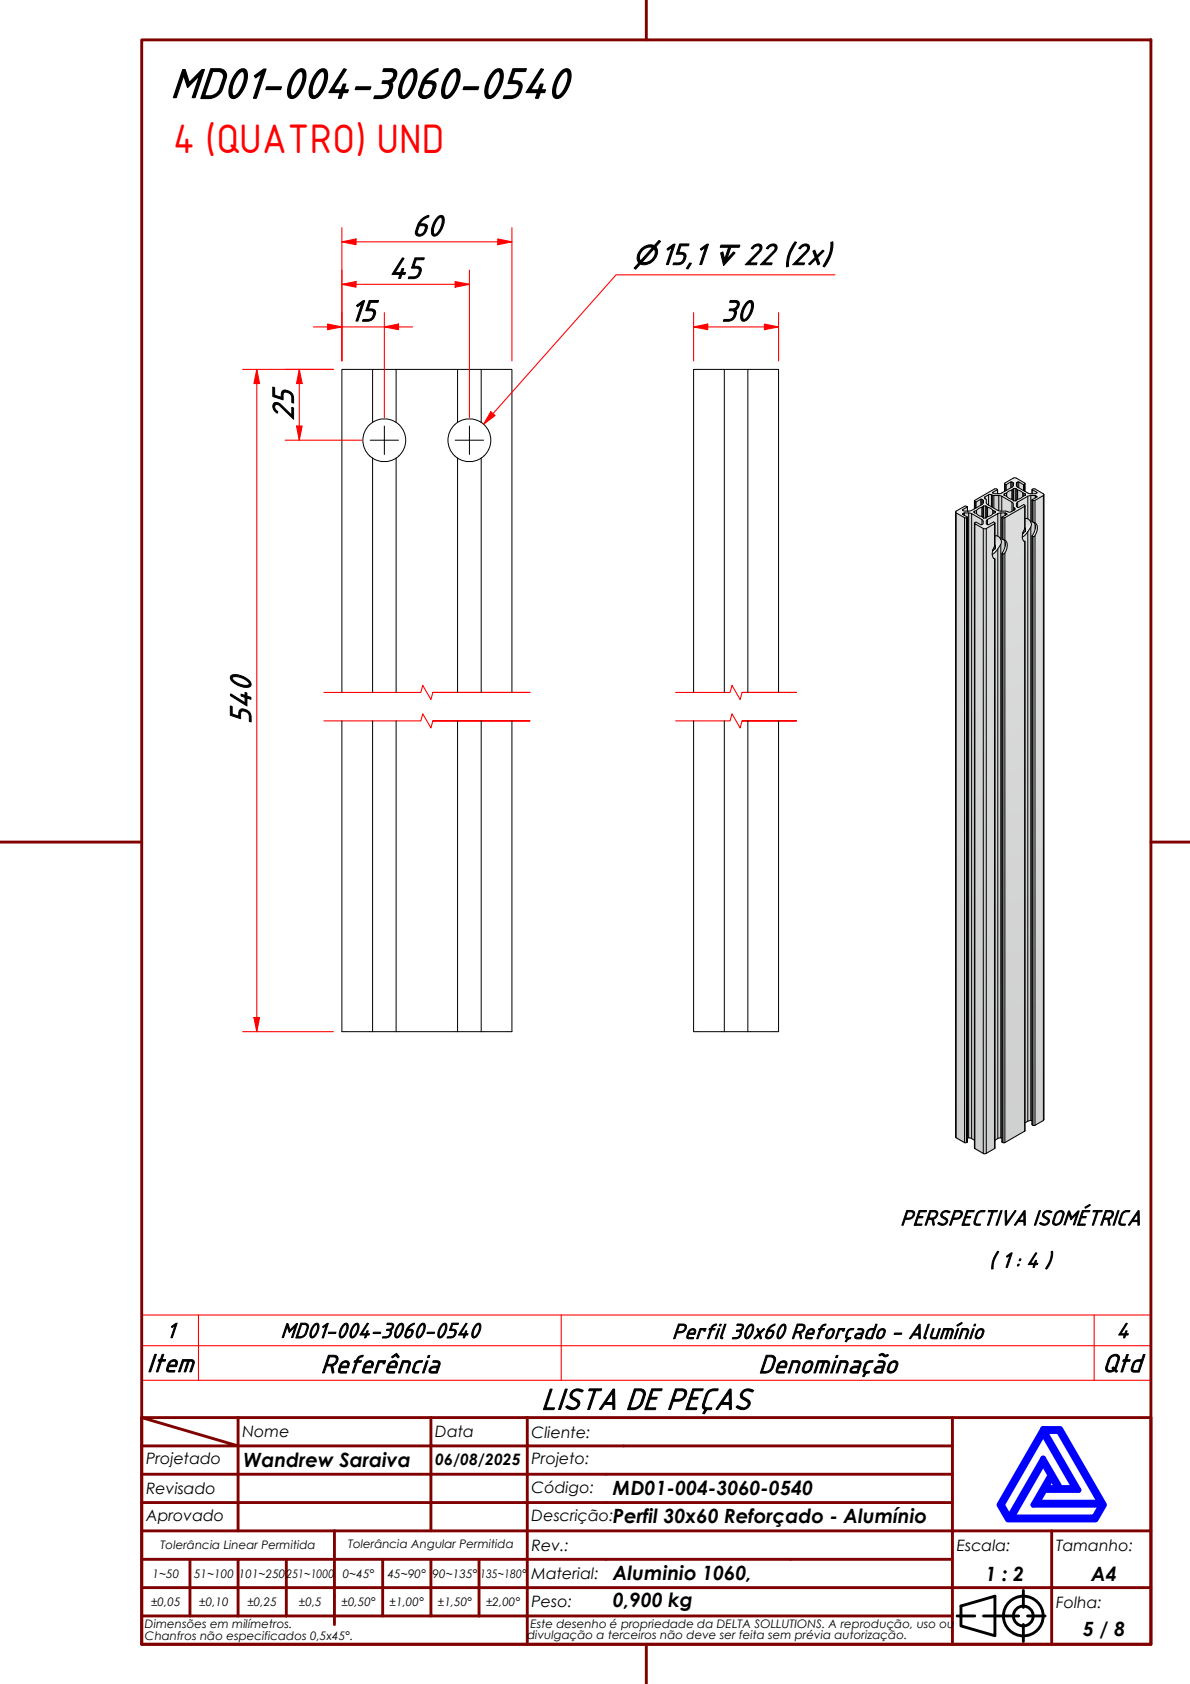
[picture p181: page 5]
PERSPECTIVA ISOMÉTRICA; 4 (QUATRO) UND

1 | MD01-004-3060-0540 | Perfil 30x60 Reforçado - Alumínio | 4
Item | Referência | Denominação | Qtd

LISTA DE PEÇAS

Projetado | Nome | Data | Cliente:

Wandrew Saraiva | 06/08/2025 | Projeto:

Revisado | | | Código: MD01-004-3060-0540
Aprovado | | | Perfil 30x60 Reforçado - Alumínio Descrição:

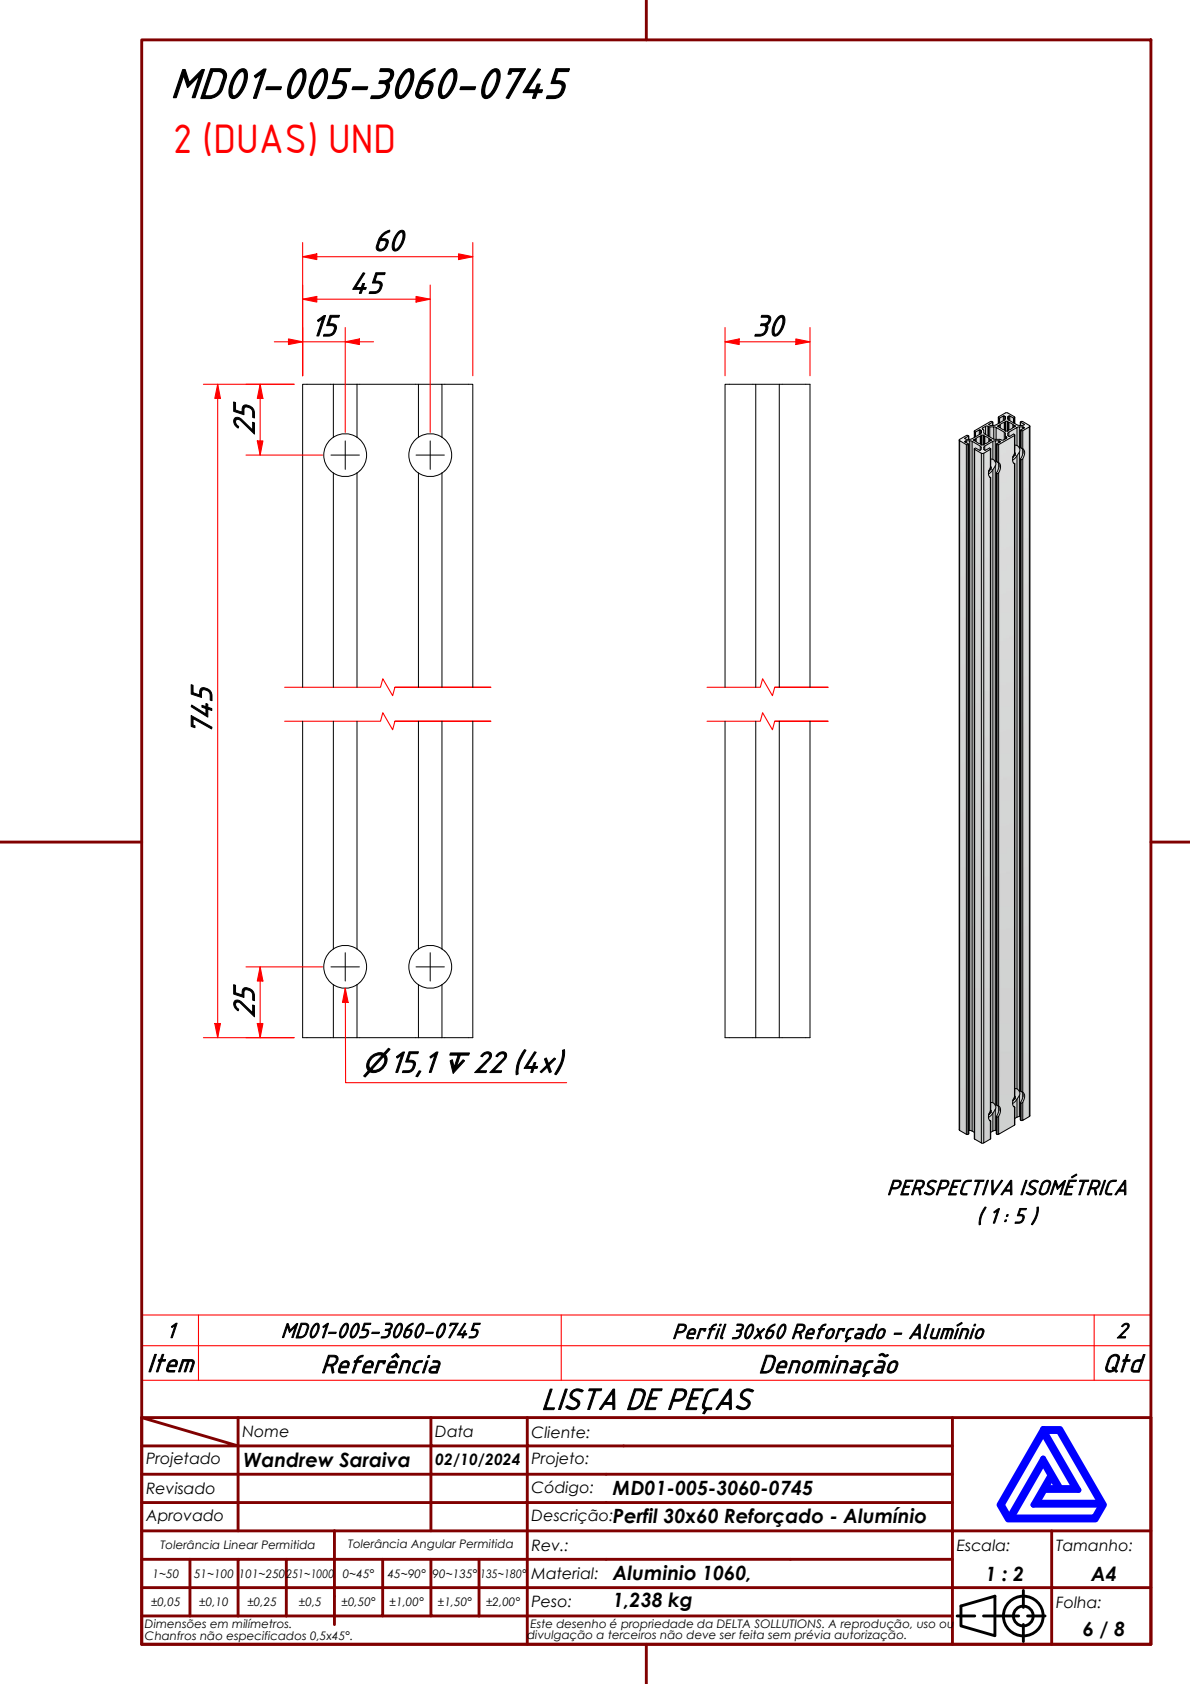
[picture p182: page 6]
PERSPECTIVA ISOMÉTRICA; 2 (DUAS) UND

1 | MD01-005-3060-0745 | Perfil 30x60 Reforçado - Alumínio | 2
Item | Referência | Denominação | Qtd

LISTA DE PEÇAS

Projetado | Nome | Data | Cliente:

Wandrew Saraiva | 02/10/2024 | Projeto:

Revisado | | | Código: MD01-005-3060-0745
Aprovado | | | Perfil 30x60 Reforçado - Alumínio Descrição:

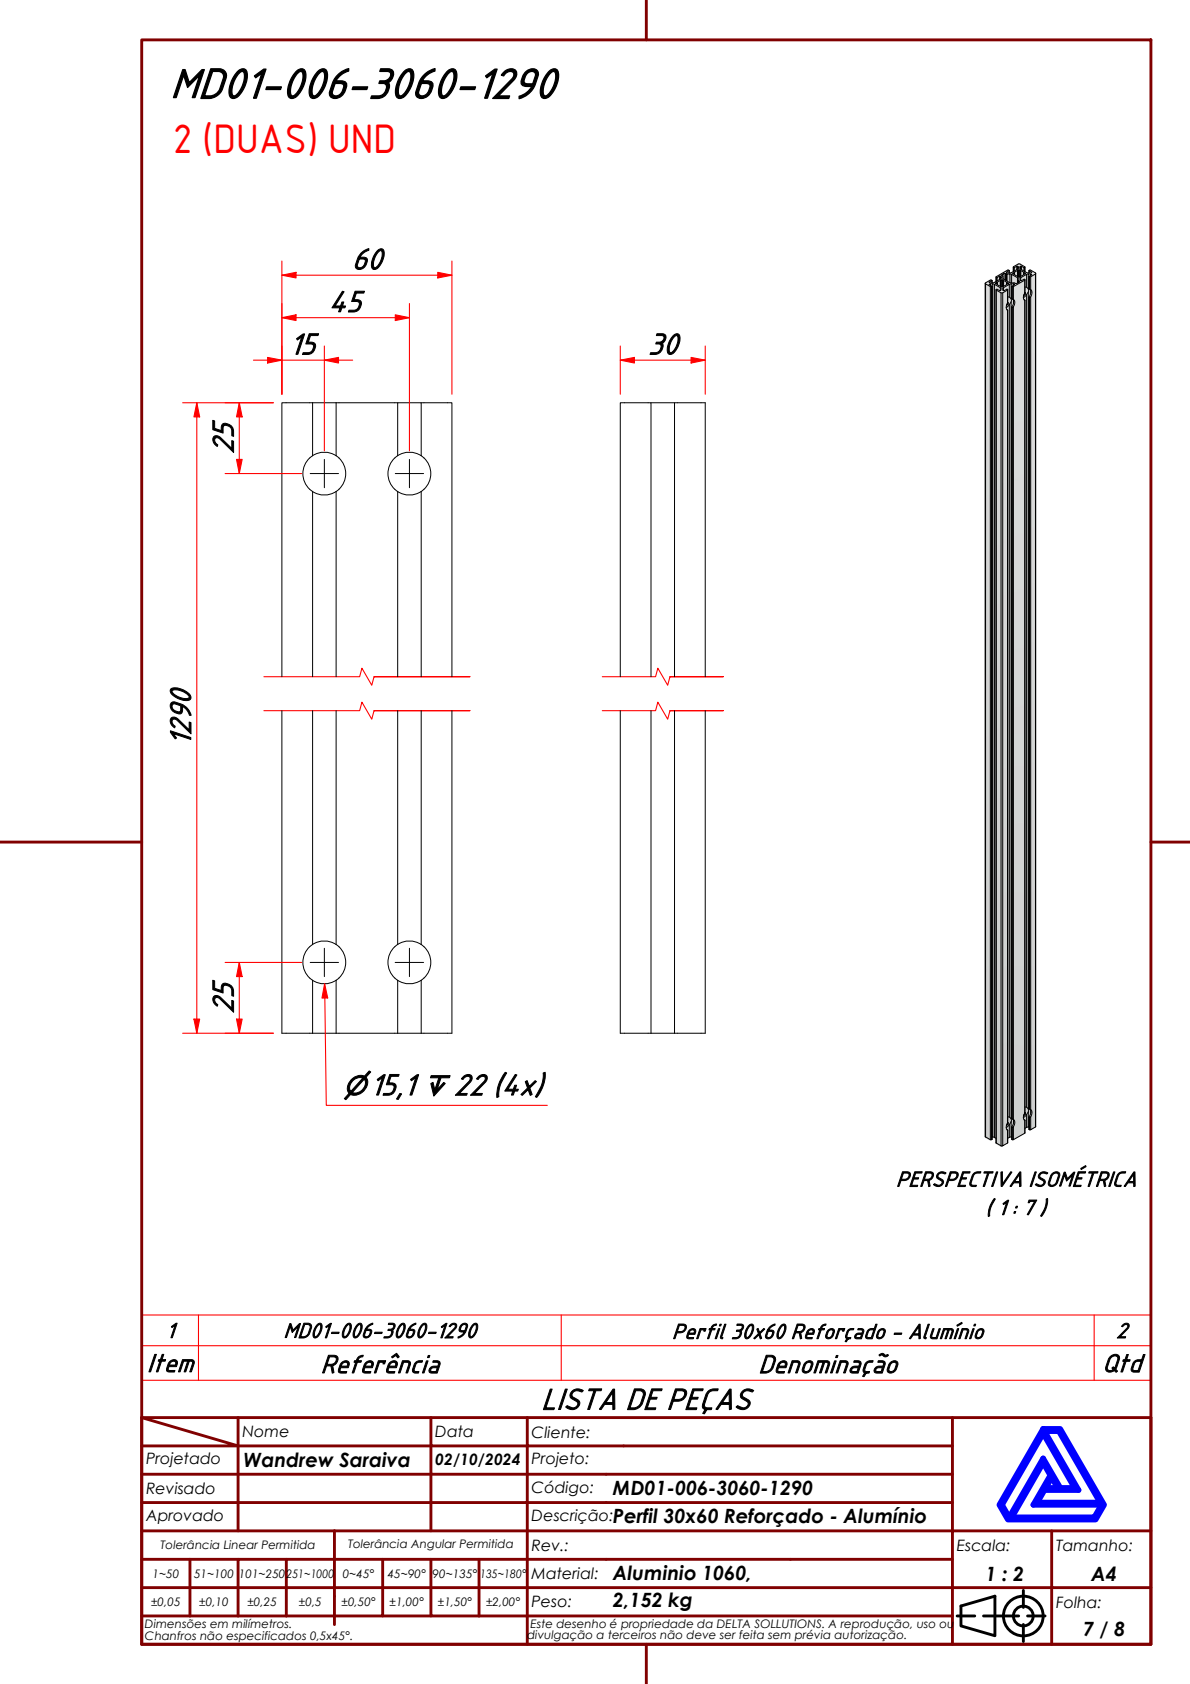
[picture p183: page 7]
PERSPECTIVA ISOMÉTRICA; 2 (DUAS) UND

1 | MD01-006-3060-1290 | Perfil 30x60 Reforçado - Alumínio | 2
Item | Referência | Denominação | Qtd

LISTA DE PEÇAS

Projetado | Nome | Data | Cliente:

Wandrew Saraiva | 02/10/2024 | Projeto:

Revisado | | | Código: MD01-006-3060-1290
Aprovado | | | Perfil 30x60 Reforçado - Alumínio Descrição:

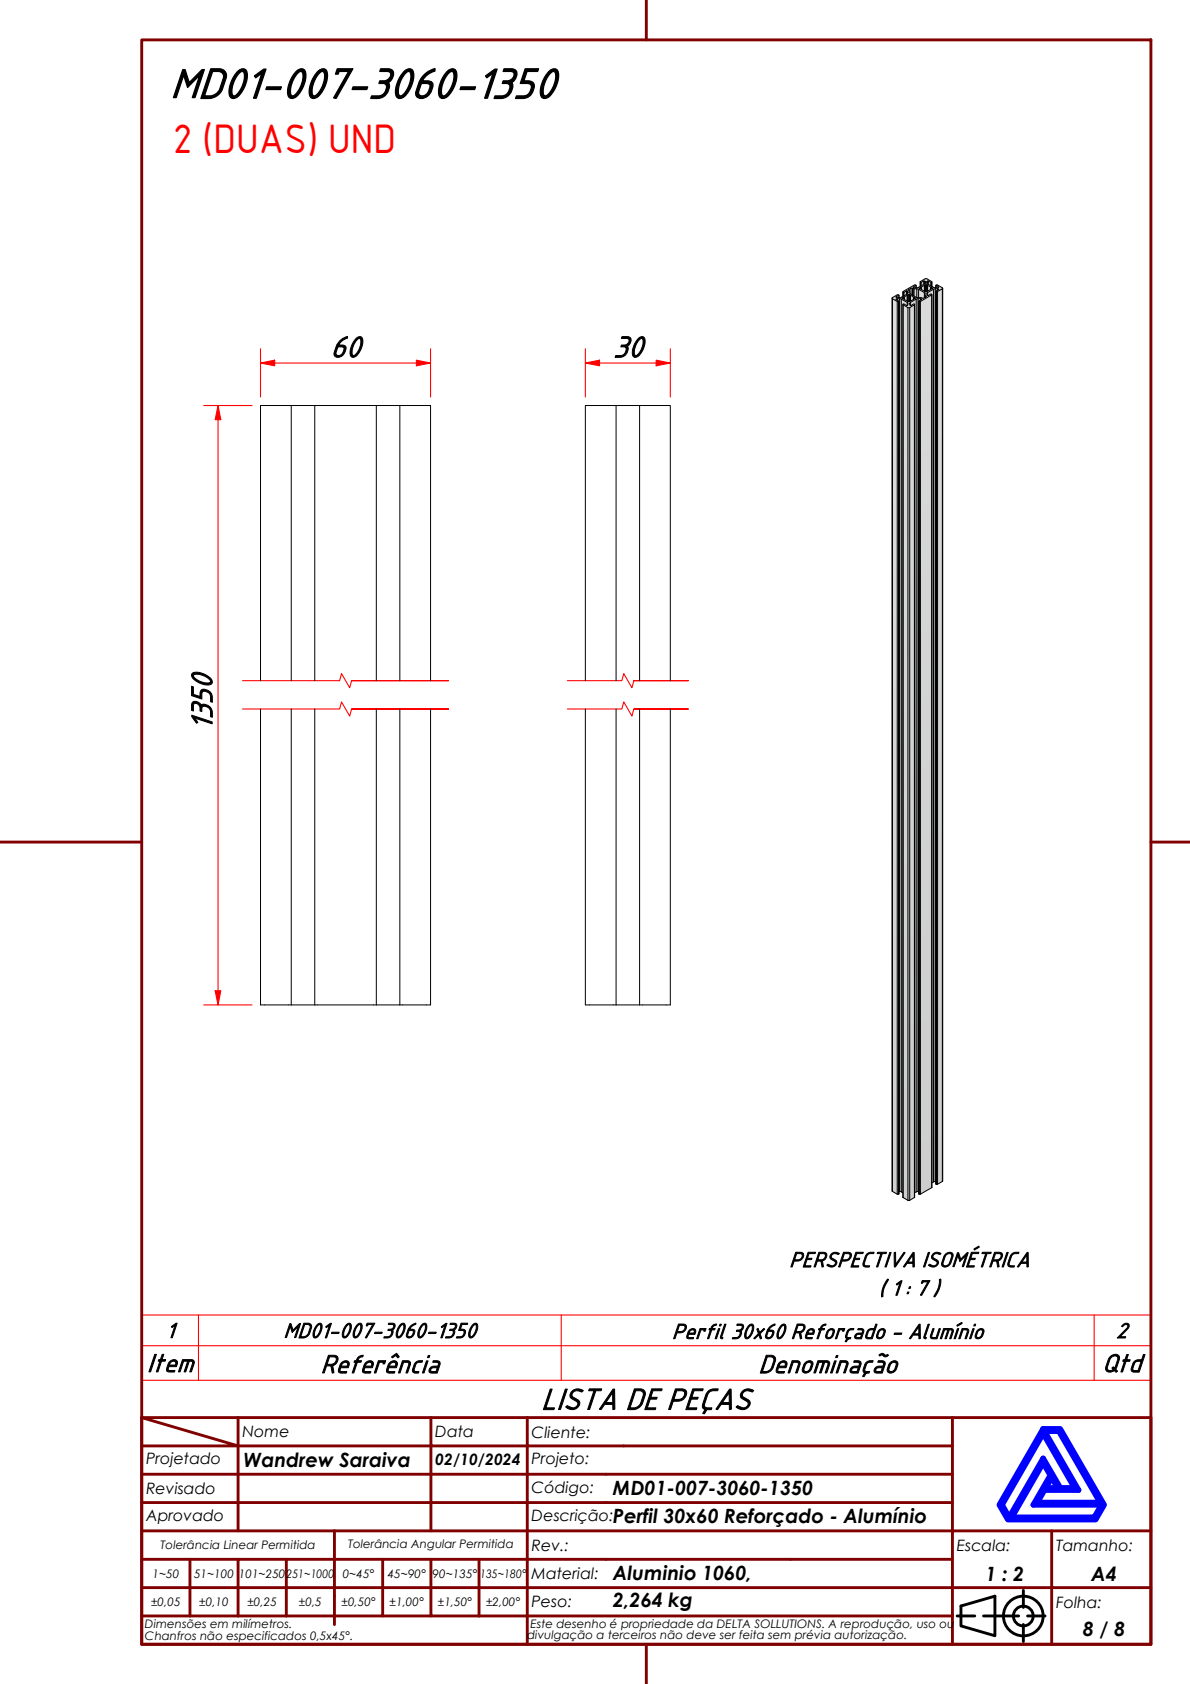
[picture p184: page 8]
PERSPECTIVA ISOMÉTRICA; 2 (DUAS) UND

1 | MD01-007-3060-1350 | Perfil 30x60 Reforçado - Alumínio | 2
Item | Referência | Denominação | Qtd

LISTA DE PEÇAS

Projetado | Nome | Data | Cliente:

Wandrew Saraiva | 02/10/2024 | Projeto:

Revisado | | | Código: MD01-007-3060-1350
Aprovado | | | Perfil 30x60 Reforçado - Alumínio Descrição:
