pvrezende/Dashboard/uploads/anexo-1755206462820-552463318.pdf

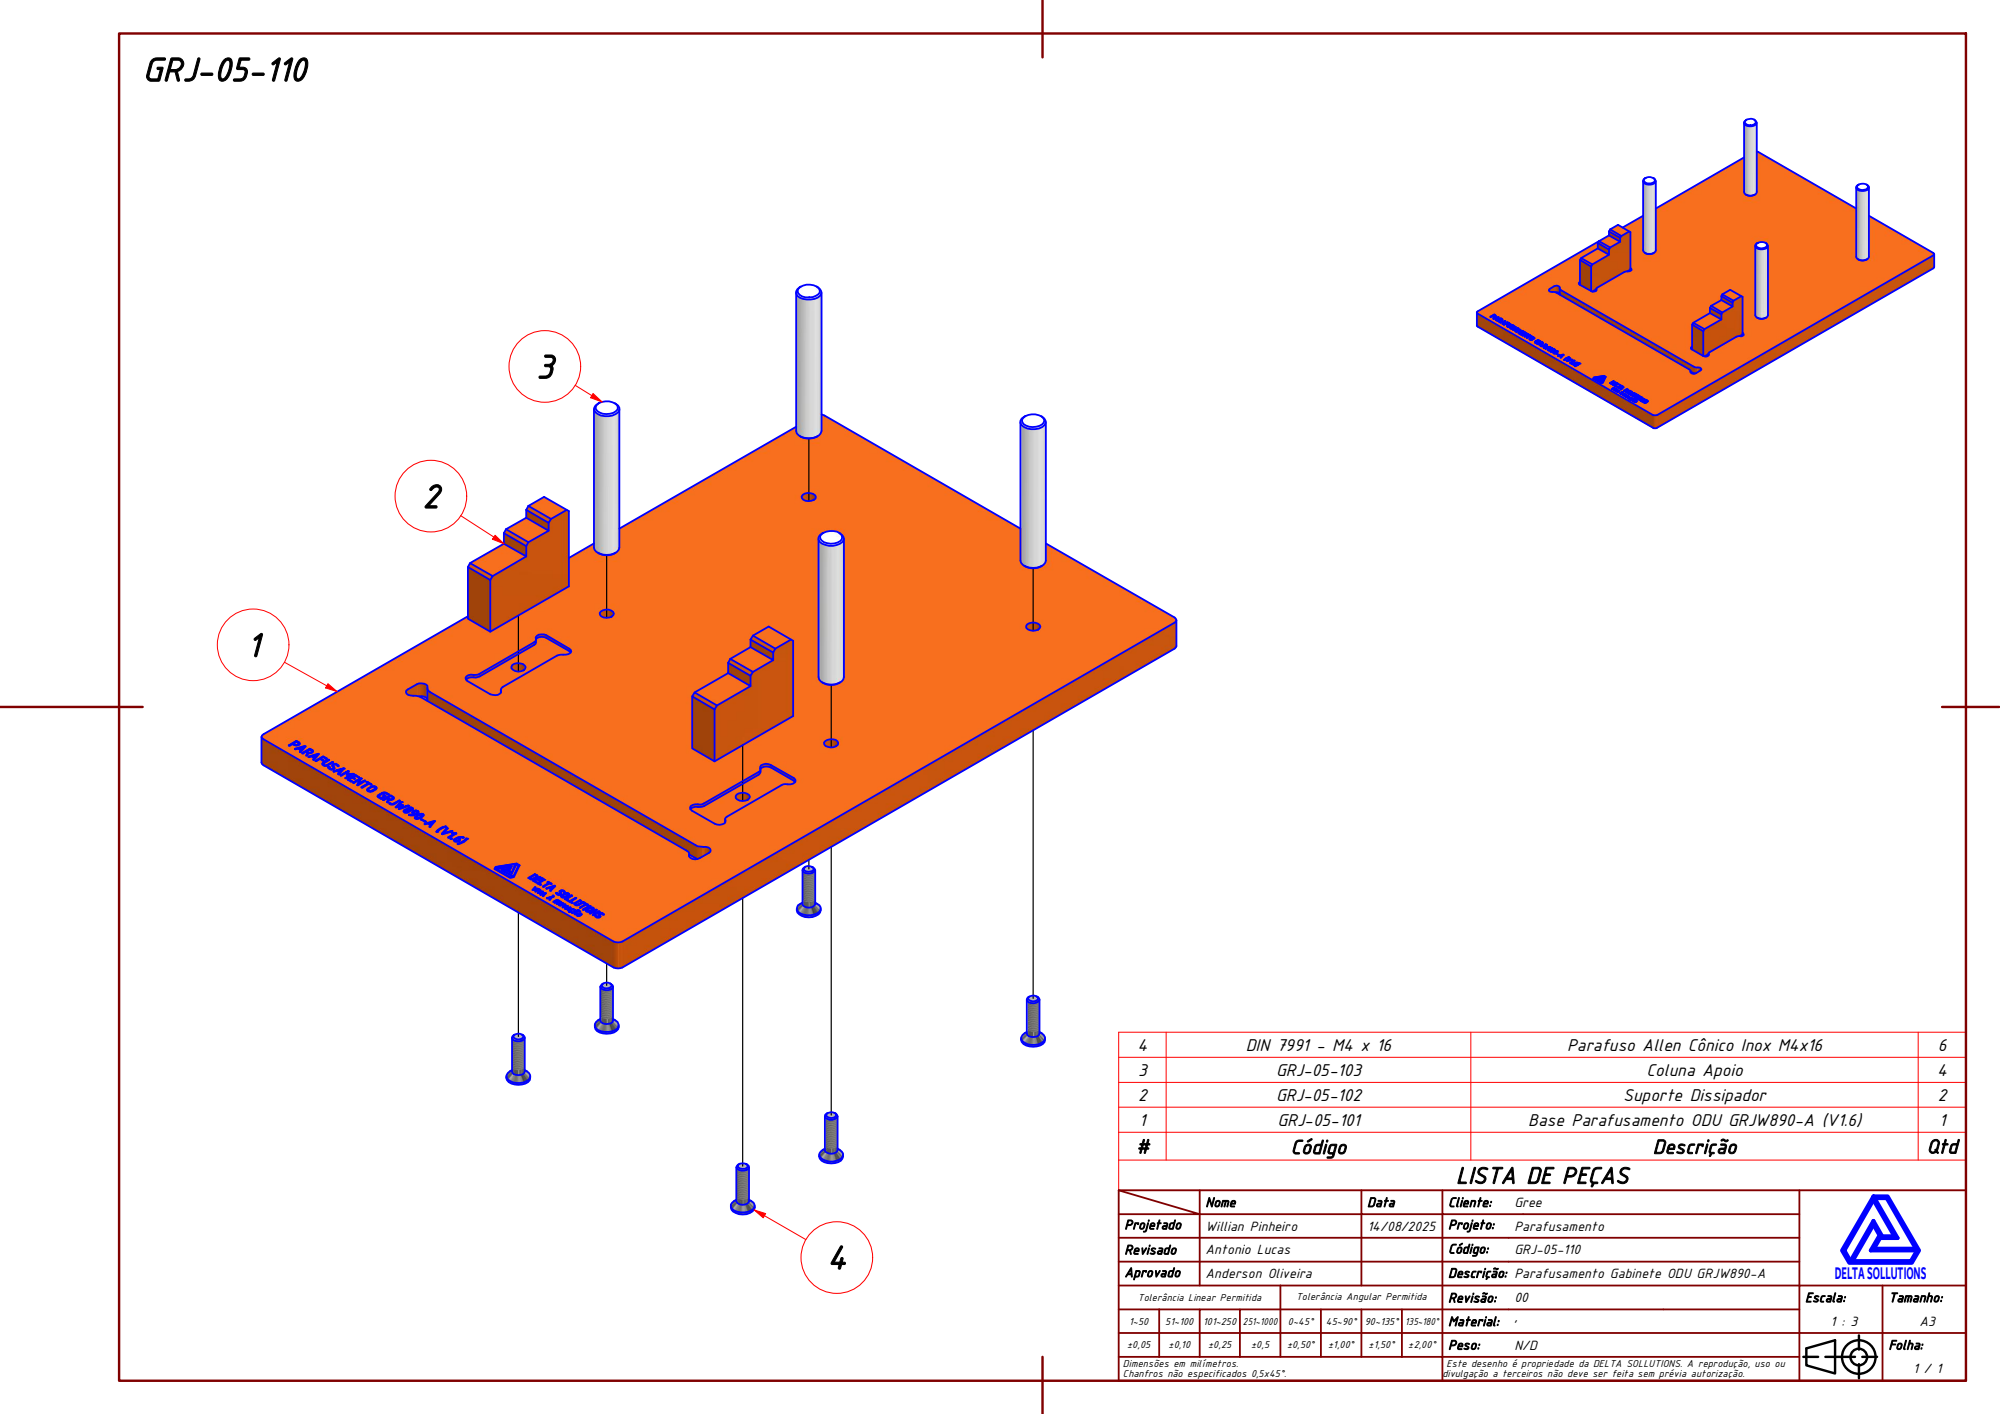
[picture p185: page 1]
DELTA SOLLUTIONS

4 | DIN 7991 - M4 x 16 | Parafuso Allen Cônico Inox M4x16 | 6
3 | GRJ-05-103 | Coluna Apoio | 4
2 | GRJ-05-102 | Suporte Dissipador | 2
1 | GRJ-05-101 | Base Parafusamento ODU GRJW890-A (V1.6) | 1
# | Código | Descrição | Qtd

LISTA DE PEÇAS

Projetado | Nome | Data | Cliente: Gree

Willian Pinheiro | 14/08/2025 | Projeto: Parafusamento

Revisado | Antonio Lucas | | Código: GRJ-05-110

Aprovado | Anderson Oliveira | | Descrição: Parafusamento Gabinete ODU GRJW890-A

Tolerância Linear Permitida | Tolerância Angular Permitida | Revisão: 00 | Escala: 1 : 3 | Tamanho: A3

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
