pvrezende/Dashboard/uploads/anexo-1755207757151-726828165.pdf

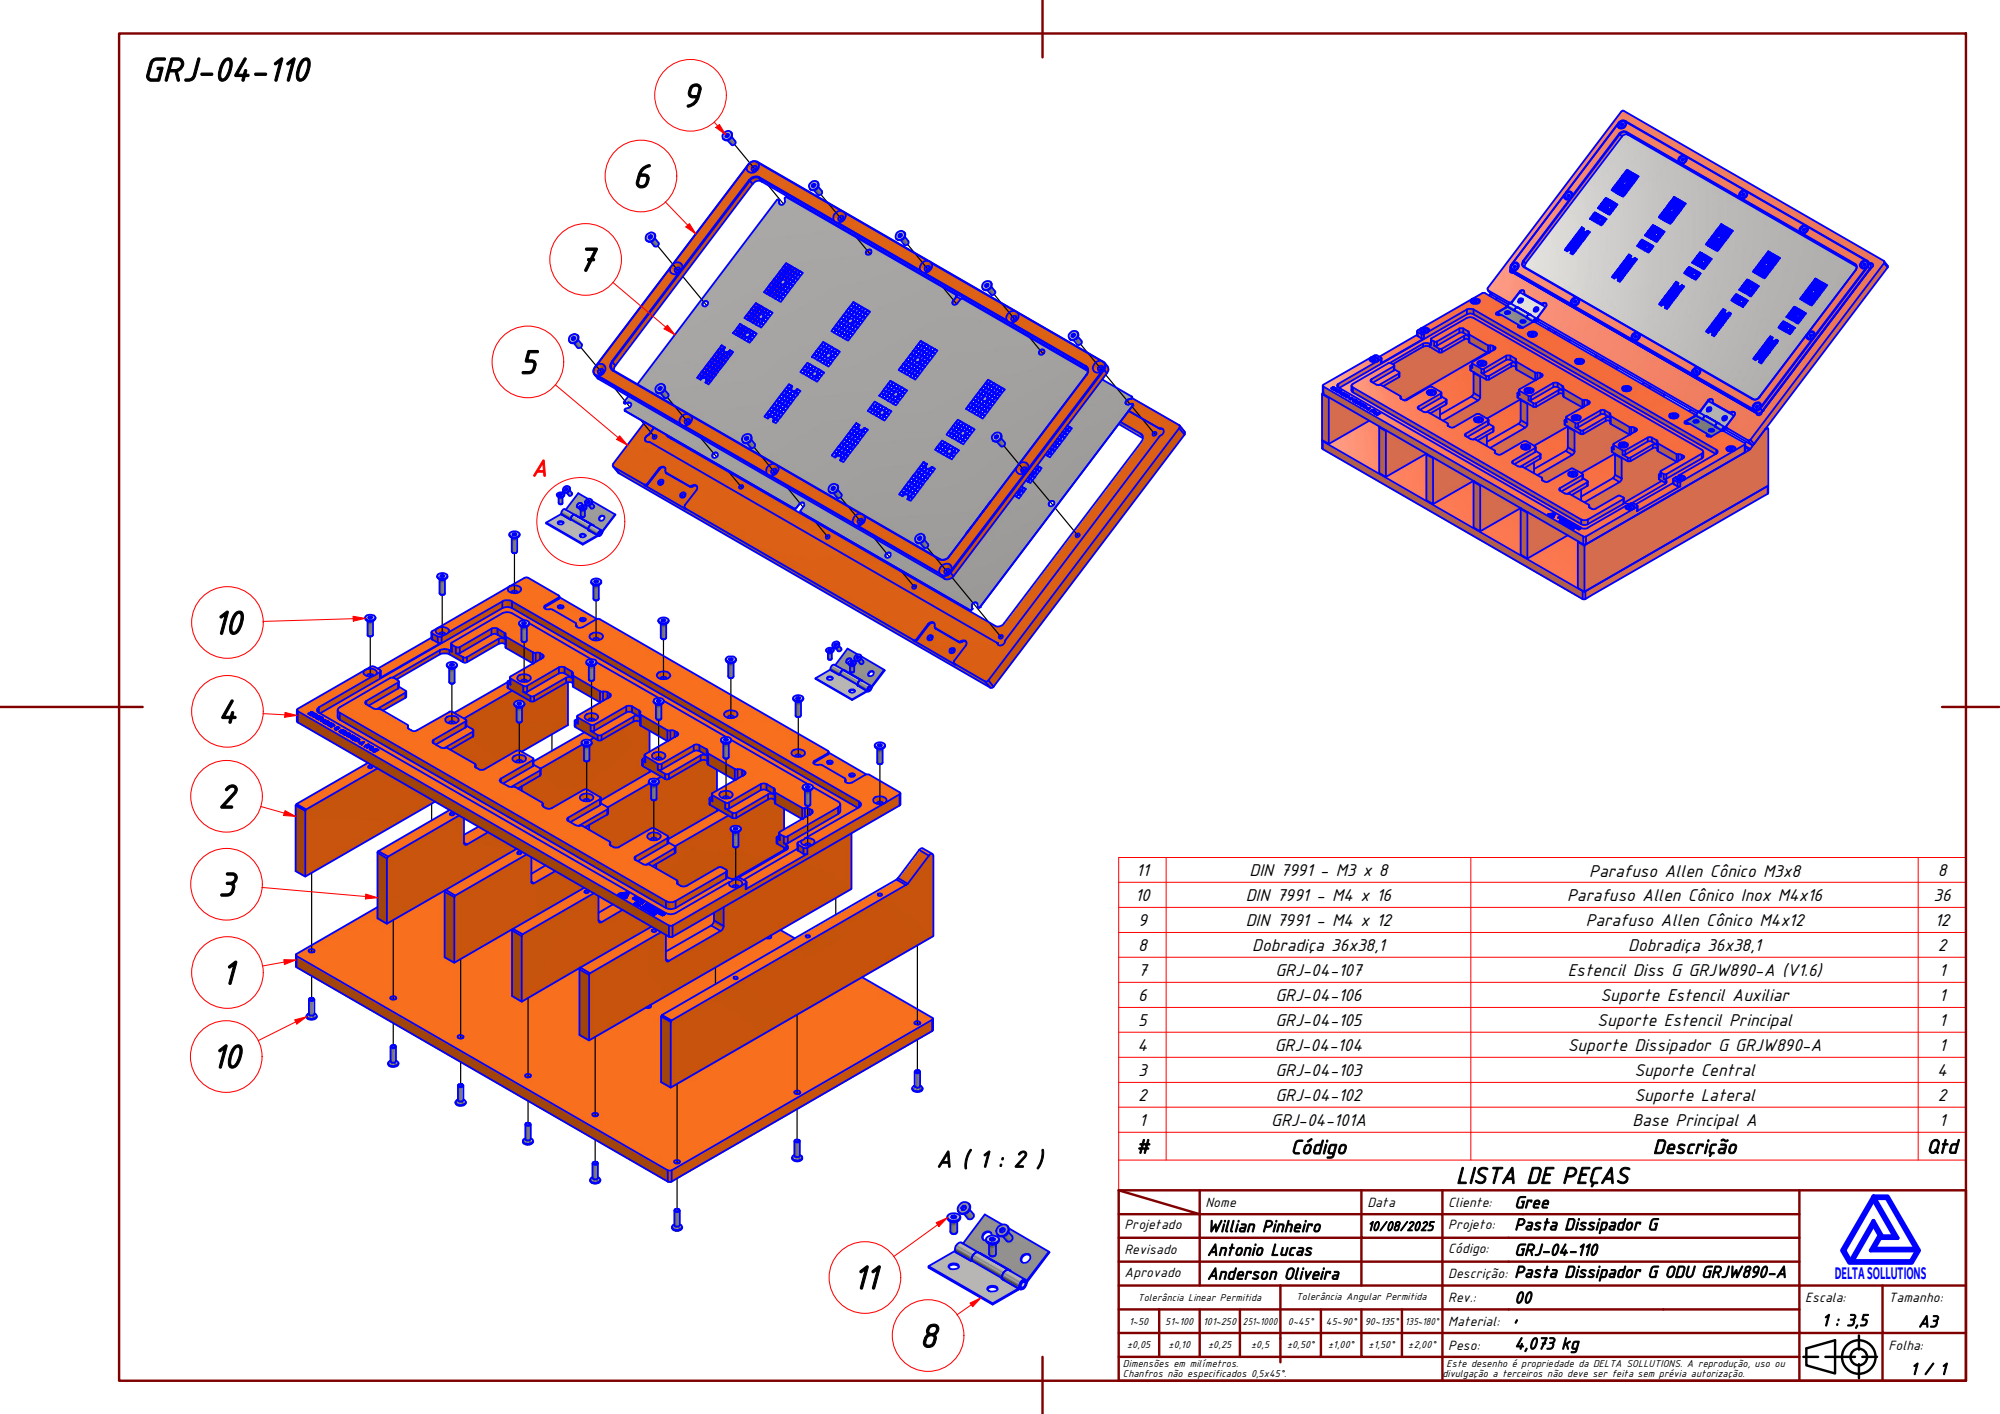
[picture p186: page 1]
DIN 7991 - M3 x 8; Parafuso Allen Cônico M3x8; DIN 7991 - M4 x 16; Parafuso Allen Cônico Inox M4x16; DIN 7991 - M4 x 12; Parafuso Allen Cônico M4x12; Dobradiça 36x38,1; GRJ-04-107; Estencil Diss G GRJW890-A (V1.6); GRJ-04-106; Suporte Estencil Auxiliar; GRJ-04-105; Suporte Estencil Principal; GRJ-04-104; Suporte Dissipador G GRJW890-A; GRJ-04-103; Suporte Central; GRJ-04-102; Suporte Lateral; GRJ-04-101A; Base Principal A; Willian Pinheiro; Antonio Lucas; Anderson Oliveira; DELTA SOLLUTIONS

LISTA DE PEÇAS

Gree
Pasta Dissipador G
GRJ-04-110
Pasta Dissipador G ODU GRJW890-A

Tolerância Linear Permitida

Tolerância Angular Permitida

Dimensões em milímetros.
Chanfros não especificados 0,5x45°.

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
