pvrezende/Dashboard/uploads/anexo-1755615529699-607536951.pdf

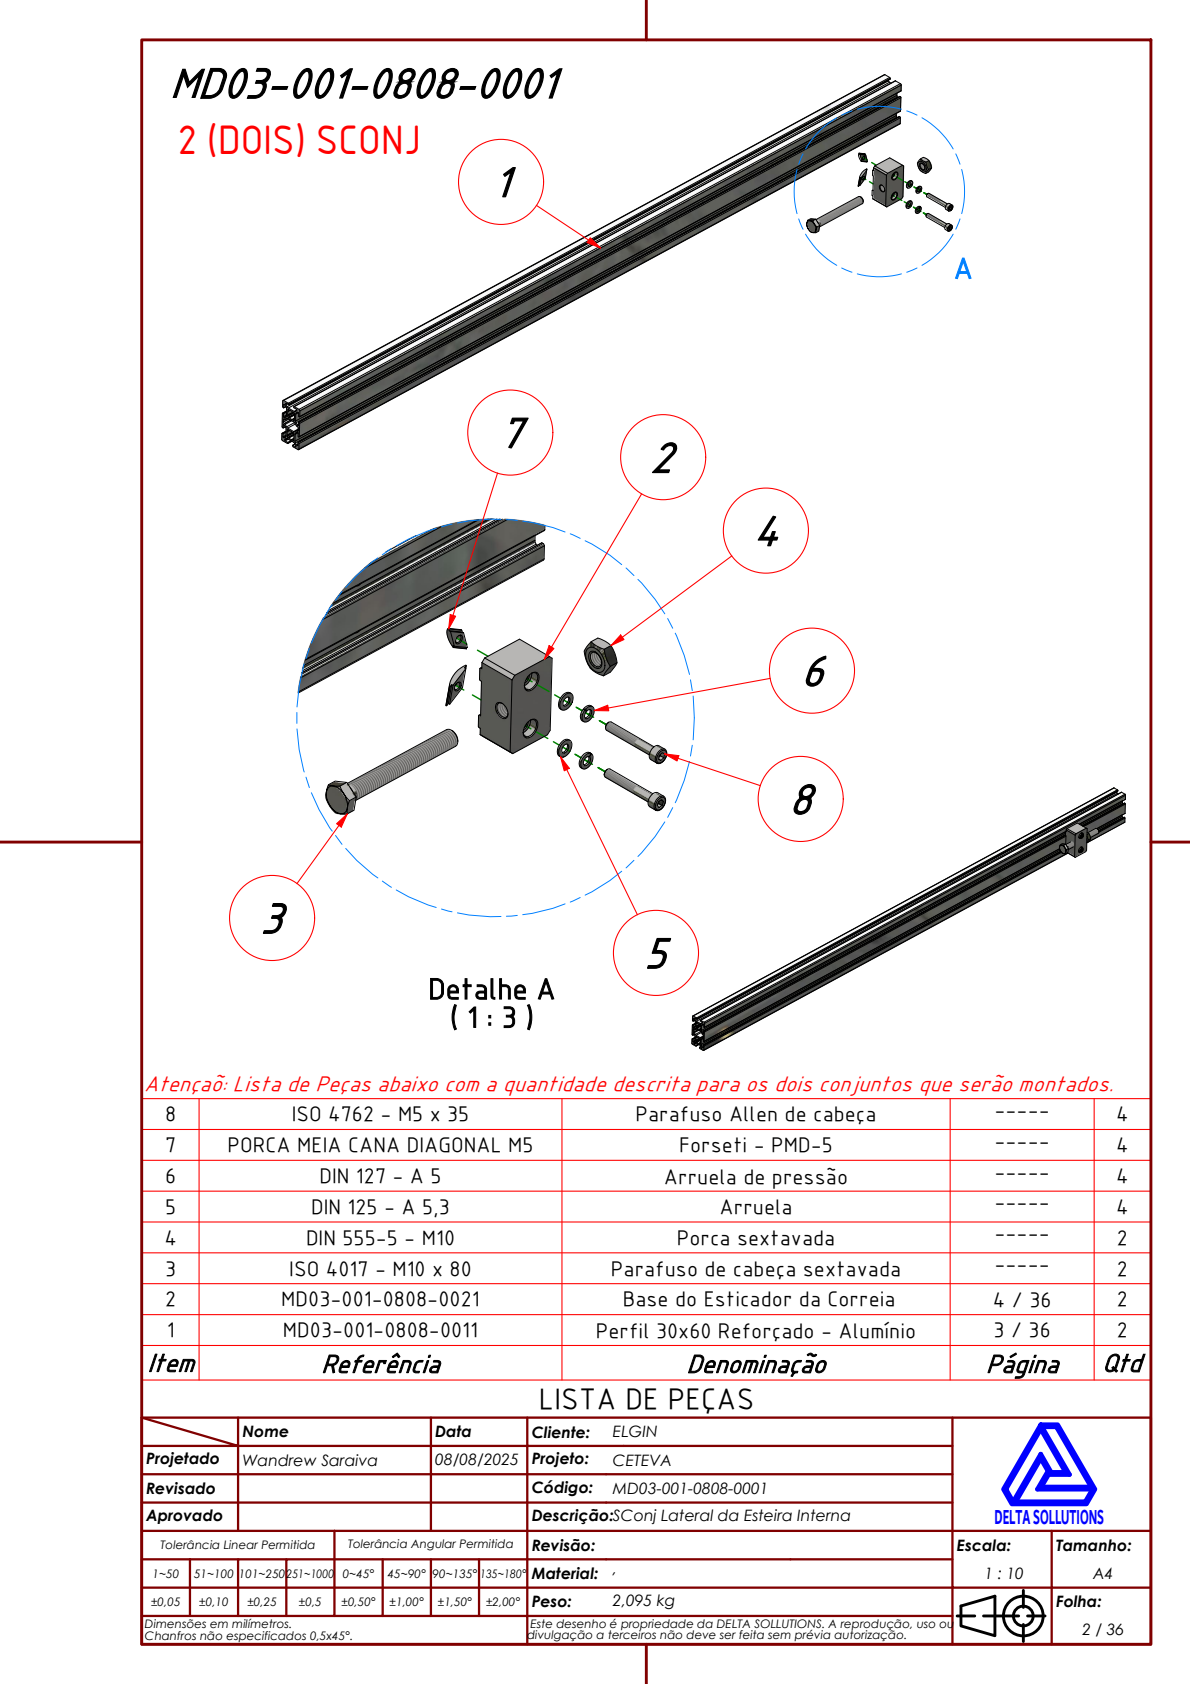
[picture p187: page 1]
Detalhe A ( 1 : 3 ); 2 (DOIS) SCONJ

Atençaõ: Lista de Peças abaixo com a quantidade descrita para os dois conjuntos que serão montados.

8 | ISO 4762 - M5 x 35 | Parafuso Allen de cabeça | ----- | 4
7 | PORCA MEIA CANA DIAGONAL M5 | Forseti - PMD-5 | ----- | 4
6 | DIN 127 - A 5 | Arruela de pressão | ----- | 4
5 | DIN 125 - A 5,3 | Arruela | ----- | 4
4 | DIN 555-5 - M10 | Porca sextavada | ----- | 2
3 | ISO 4017 - M10 x 80 | Parafuso de cabeça sextavada | ----- | 2
2 | MD03-001-0808-0021 | Base do Esticador da Correia | 4 / 36 | 2
1 | MD03-001-0808-0011 | Perfil 30x60 Reforçado - Alumínio | 3 / 36 | 2
Item | Referência | Denominação | Página | Qtd

LISTA DE PEÇAS

Projetado | Nome | Data | Cliente: ELGIN | | DELTA SOLLUTIONS

Wandrew Saraiva | 08/08/2025 | Projeto: CETEVA

Revisado | | | Código: MD03-001-0808-0001

Aprovado | | | Descrição: SConj Lateral da Esteira Interna

Tolerância Linear Permitida | Tolerância Angular Permitida | Revisão: | Escala: 1 : 10 | Tamanho: A4

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

±0,05 | ±0,10 | ±0,25 | ±0,5 | ±0,50° | ±1,00° | ±1,50° | ±2,00° | Peso: 2,095 kg | Folha: 2 / 36

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
