pvrezende/Dashboard/uploads/anexo-1755619726515-939474444.pdf

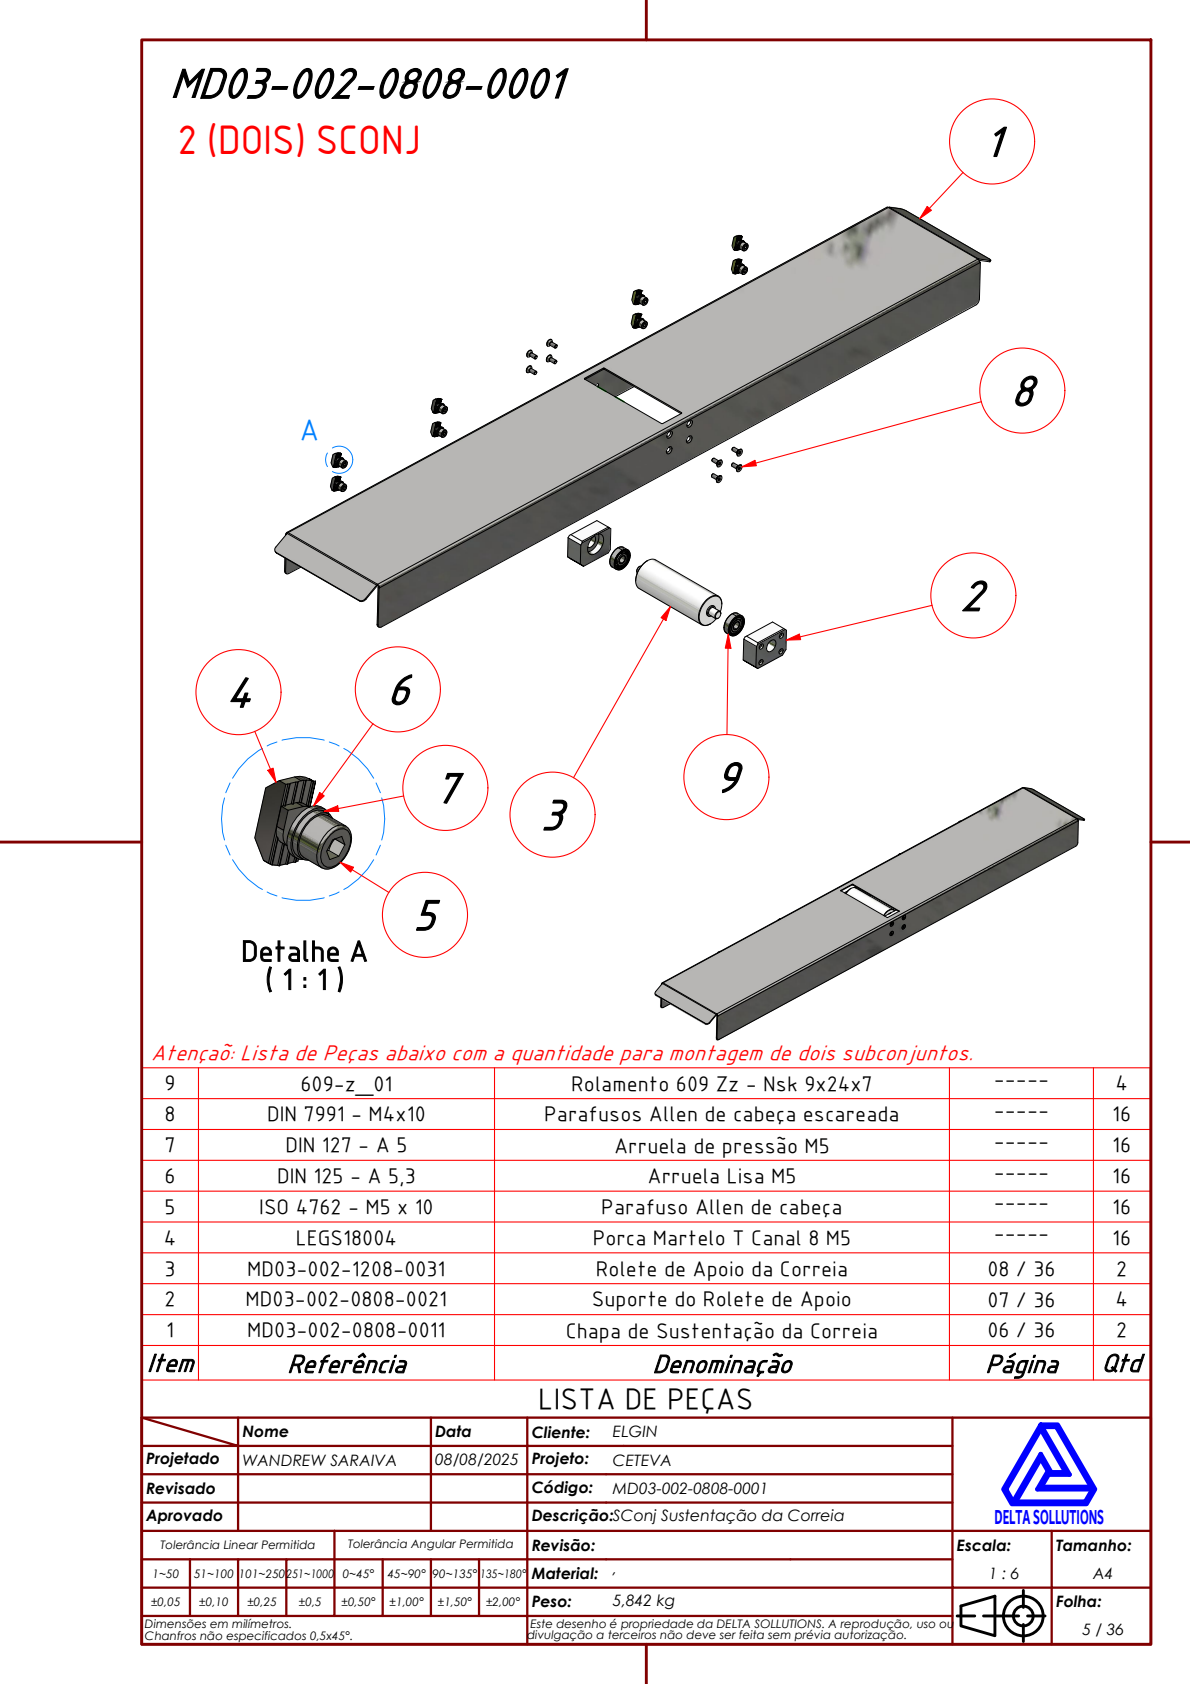
[picture p188: page 1]
Detalhe A ( 1 : 1 ); 2 (DOIS) SCONJ

Atençaõ: Lista de Peças abaixo com a quantidade para montagem de dois subconjuntos.

9 | 609-z_01 | Rolamento 609 Zz - Nsk 9x24x7 | ----- | 4
8 | DIN 7991 - M4x10 | Parafusos Allen de cabeça escareada | ----- | 16
7 | DIN 127 - A 5 | Arruela de pressão M5 | ----- | 16
6 | DIN 125 - A 5,3 | Arruela Lisa M5 | ----- | 16
5 | ISO 4762 - M5 x 10 | Parafuso Allen de cabeça | ----- | 16
4 | LEGS18004 | Porca Martelo T Canal 8 M5 | ----- | 16
3 | MD03-002-1208-0031 | Rolete de Apoio da Correia | 08 / 36 | 2
2 | MD03-002-0808-0021 | Suporte do Rolete de Apoio | 07 / 36 | 4
1 | MD03-002-0808-0011 | Chapa de Sustentação da Correia | 06 / 36 | 2
Item | Referência | Denominação | Página | Qtd

LISTA DE PEÇAS

Projetado | Nome | Data | Cliente: ELGIN | | DELTA SOLLUTIONS

WANDREW SARAIVA | 08/08/2025 | Projeto: CETEVA

Revisado | | | Código: MD03-002-0808-0001

Aprovado | | | Descrição: SConj Sustentação da Correia

Tolerância Linear Permitida | Tolerância Angular Permitida | Revisão: | Escala: 1 : 6 | Tamanho: A4

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

±0,05 | ±0,10 | ±0,25 | ±0,5 | ±0,50° | ±1,00° | ±1,50° | ±2,00° | Peso: 5,842 kg | Folha: 5 / 36

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
