pvrezende/Dashboard/uploads/anexo-1755622045067-350366982.pdf

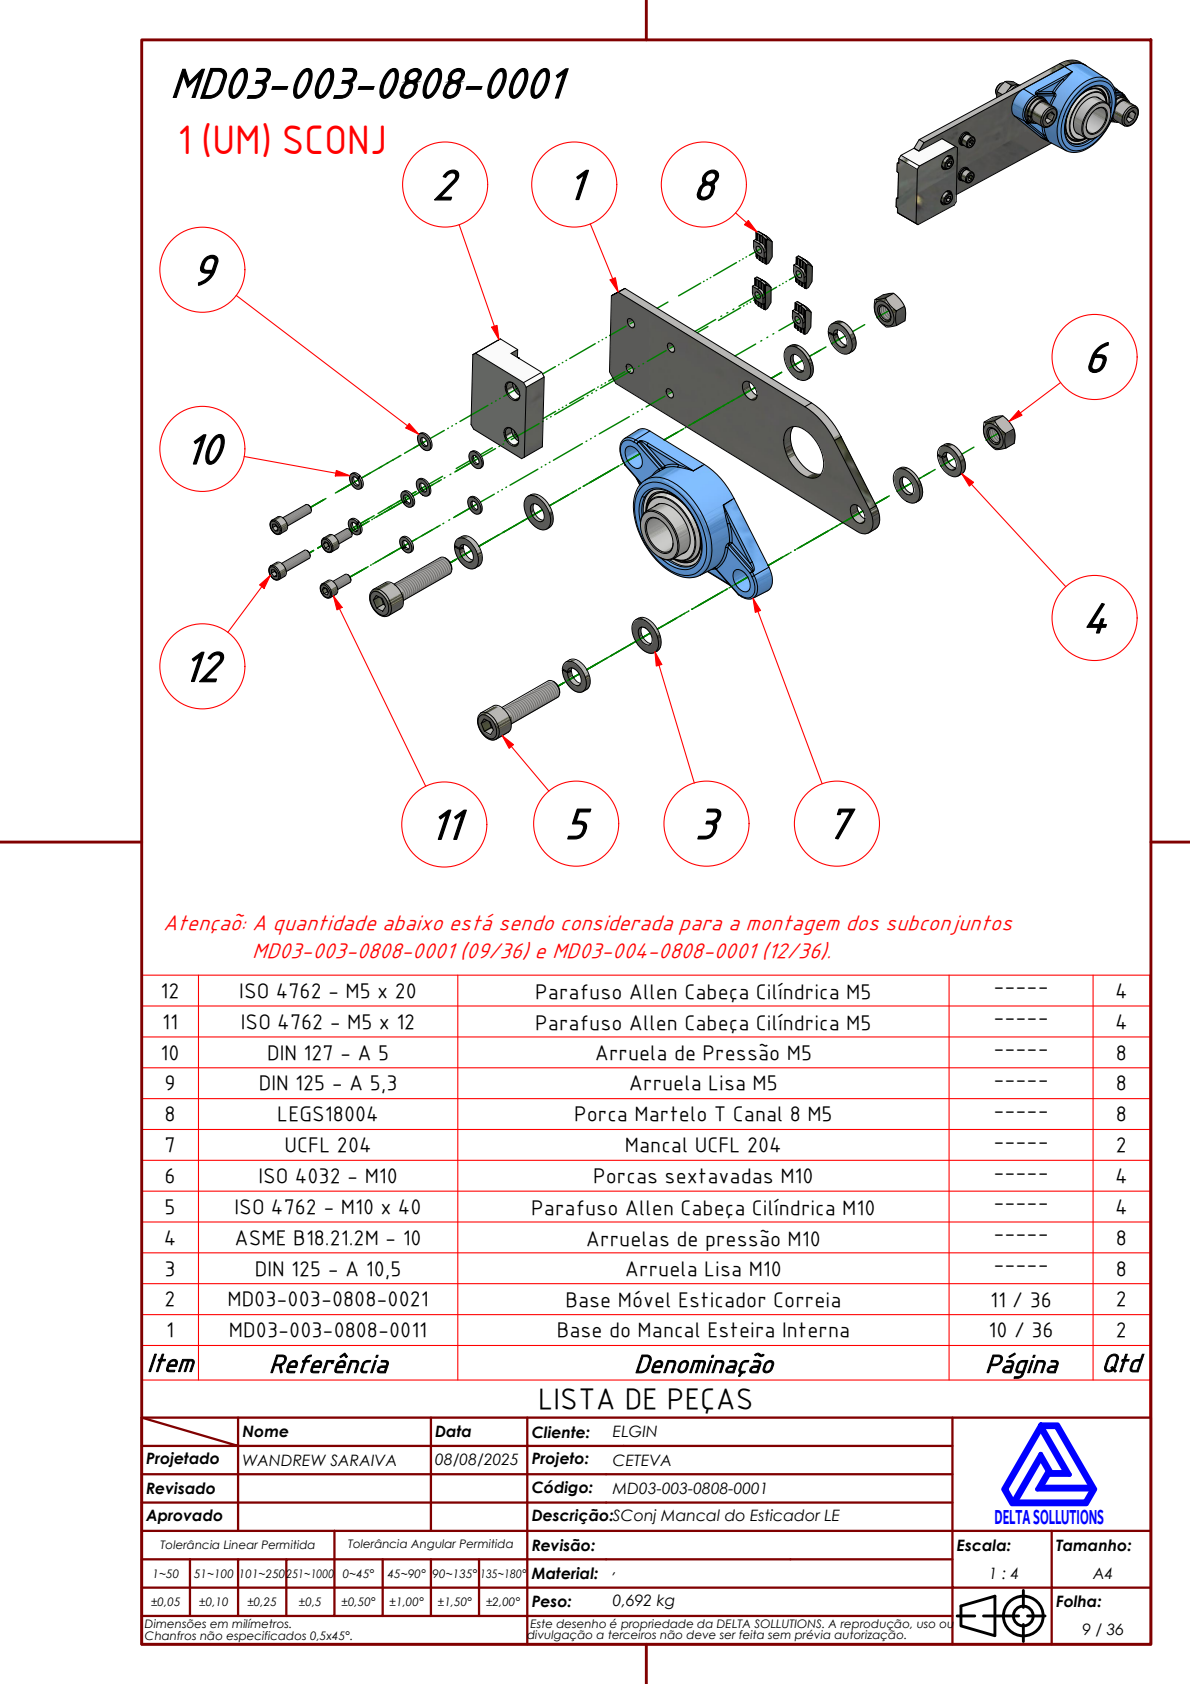
[picture p189: page 1]
1 (UM) SCONJ

Atençaõ: A quantidade abaixo está sendo considerada para a montagem dos subconjuntos

12 | ISO 4762 - M5 x 20 | Parafuso Allen Cabeça Cilíndrica M5 | ----- | 4
11 | ISO 4762 - M5 x 12 | Parafuso Allen Cabeça Cilíndrica M5 | ----- | 4
10 | DIN 127 - A 5 | Arruela de Pressão M5 | ----- | 8
9 | DIN 125 - A 5,3 | Arruela Lisa M5 | ----- | 8
8 | LEGS18004 | Porca Martelo T Canal 8 M5 | ----- | 8
7 | UCFL 204 | Mancal UCFL 204 | ----- | 2
6 | ISO 4032 - M10 | Porcas sextavadas M10 | ----- | 4
5 | ISO 4762 - M10 x 40 | Parafuso Allen Cabeça Cilíndrica M10 | ----- | 4
4 | ASME B18.21.2M - 10 | Arruelas de pressão M10 | ----- | 8
3 | DIN 125 - A 10,5 | Arruela Lisa M10 | ----- | 8
2 | MD03-003-0808-0021 | Base Móvel Esticador Correia | 11 / 36 | 2
1 | MD03-003-0808-0011 | Base do Mancal Esteira Interna | 10 / 36 | 2
Item | Referência | Denominação | Página | Qtd

LISTA DE PEÇAS

Projetado | Nome | Data | Cliente: ELGIN | | DELTA SOLLUTIONS

WANDREW SARAIVA | 08/08/2025 | Projeto: CETEVA

Revisado | | | Código: MD03-003-0808-0001

Aprovado | | | Descrição: SConj Mancal do Esticador LE

Tolerância Linear Permitida | Tolerância Angular Permitida | Revisão: | Escala: 1 : 4 | Tamanho: A4

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

±0,05 | ±0,10 | ±0,25 | ±0,5 | ±0,50° | ±1,00° | ±1,50° | ±2,00° | Peso: 0,692 kg | Folha: 9 / 36

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
