pvrezende/Dashboard/uploads/anexo-1755640849104-361333278.pdf

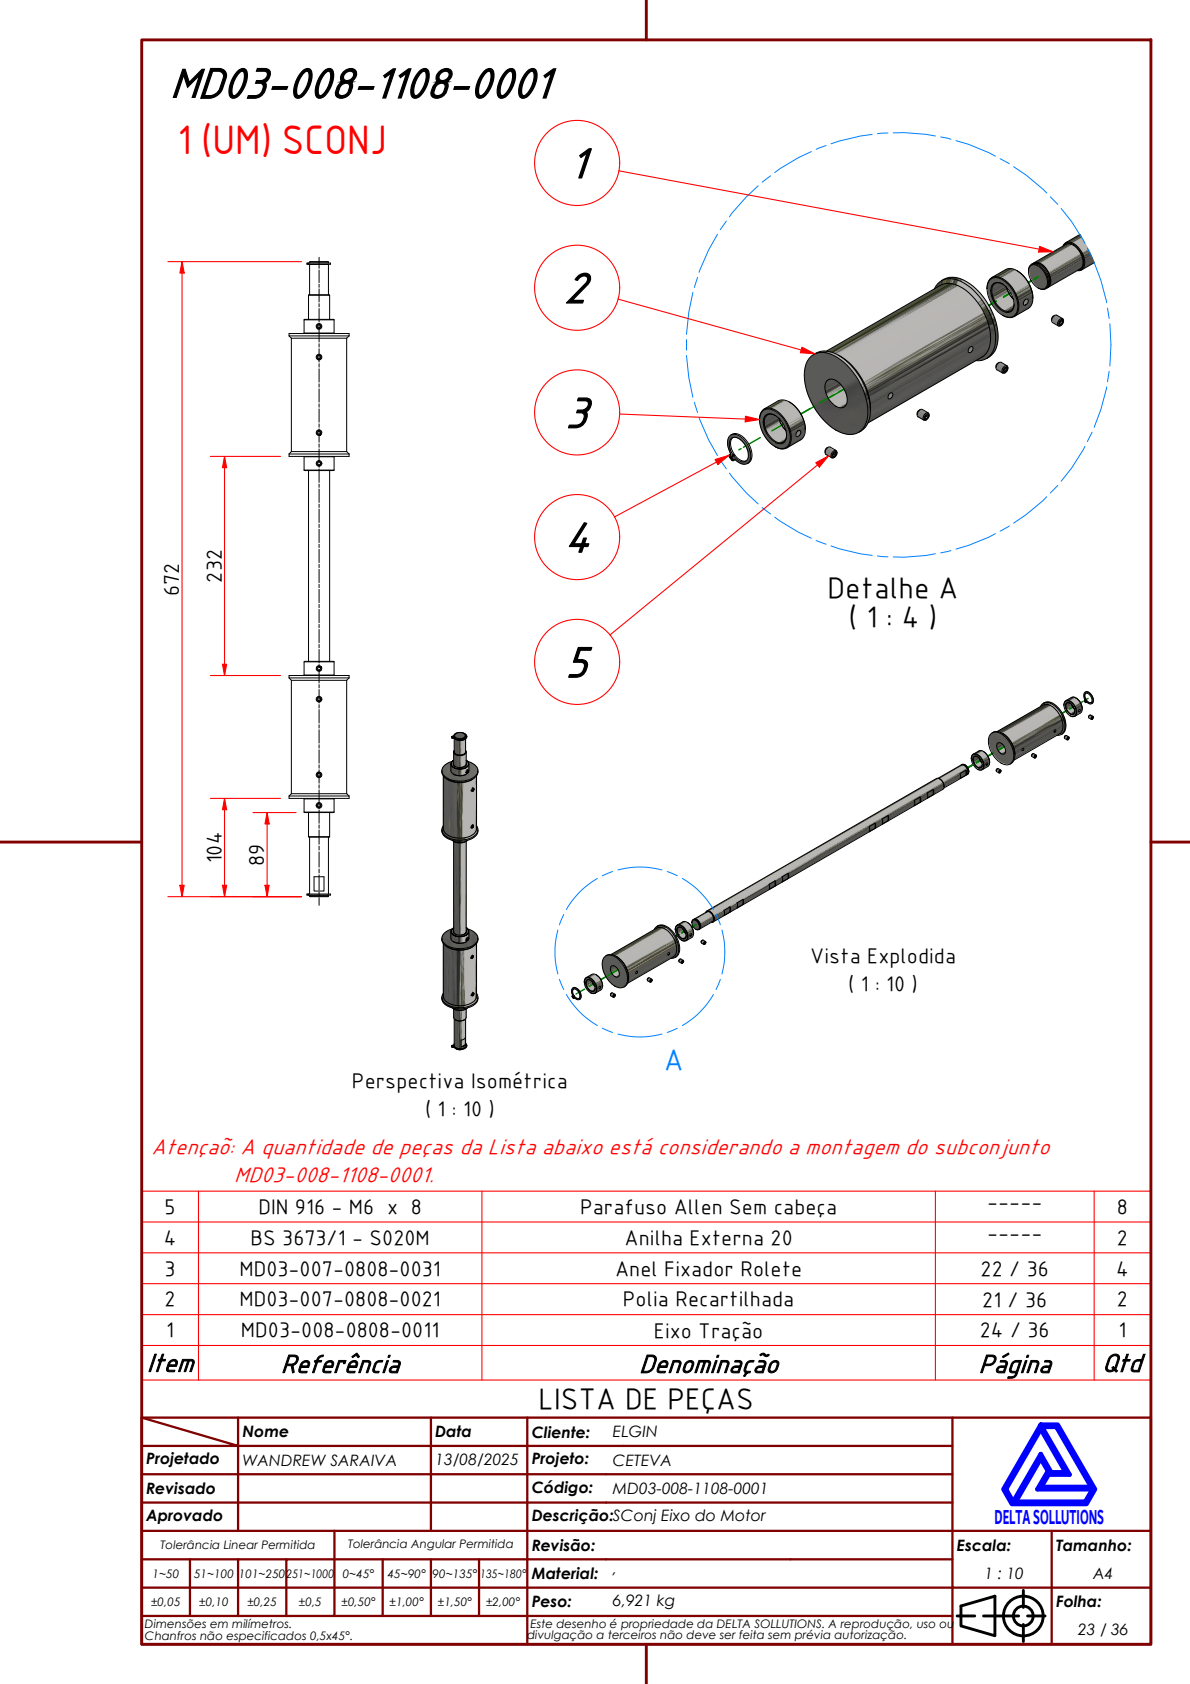
[picture p190: page 1]
Vista Explodida ( 1 : 10 ); Detalhe A ( 1 : 4 ); Perspectiva Isométrica ( 1 : 10 ); 1 (UM) SCONJ

Atençaõ: A quantidade de peças da Lista abaixo está considerando a montagem do subconjunto

5 | DIN 916 - M6 x 8 | Parafuso Allen Sem cabeça | ----- | 8
4 | BS 3673/1 - S020M | Anilha Externa 20 | ----- | 2
3 | MD03-007-0808-0031 | Anel Fixador Rolete | 22 / 36 | 4
2 | MD03-007-0808-0021 | Polia Recartilhada | 21 / 36 | 2
1 | MD03-008-0808-0011 | Eixo Tração | 24 / 36 | 1
Item | Referência | Denominação | Página | Qtd

LISTA DE PEÇAS

Projetado | Nome | Data | Cliente: ELGIN | | DELTA SOLLUTIONS

WANDREW SARAIVA | 13/08/2025 | Projeto: CETEVA

Revisado | | | Código: MD03-008-1108-0001

Aprovado | | | Descrição: SConj Eixo do Motor

Tolerância Linear Permitida | Tolerância Angular Permitida | Revisão: | Escala: 1 : 10 | Tamanho: A4

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

±0,05 | ±0,10 | ±0,25 | ±0,5 | ±0,50° | ±1,00° | ±1,50° | ±2,00° | Peso: 6,921 kg | Folha: 23 / 36

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
