pvrezende/Dashboard/uploads/anexo-1755641055616-296170043.pdf

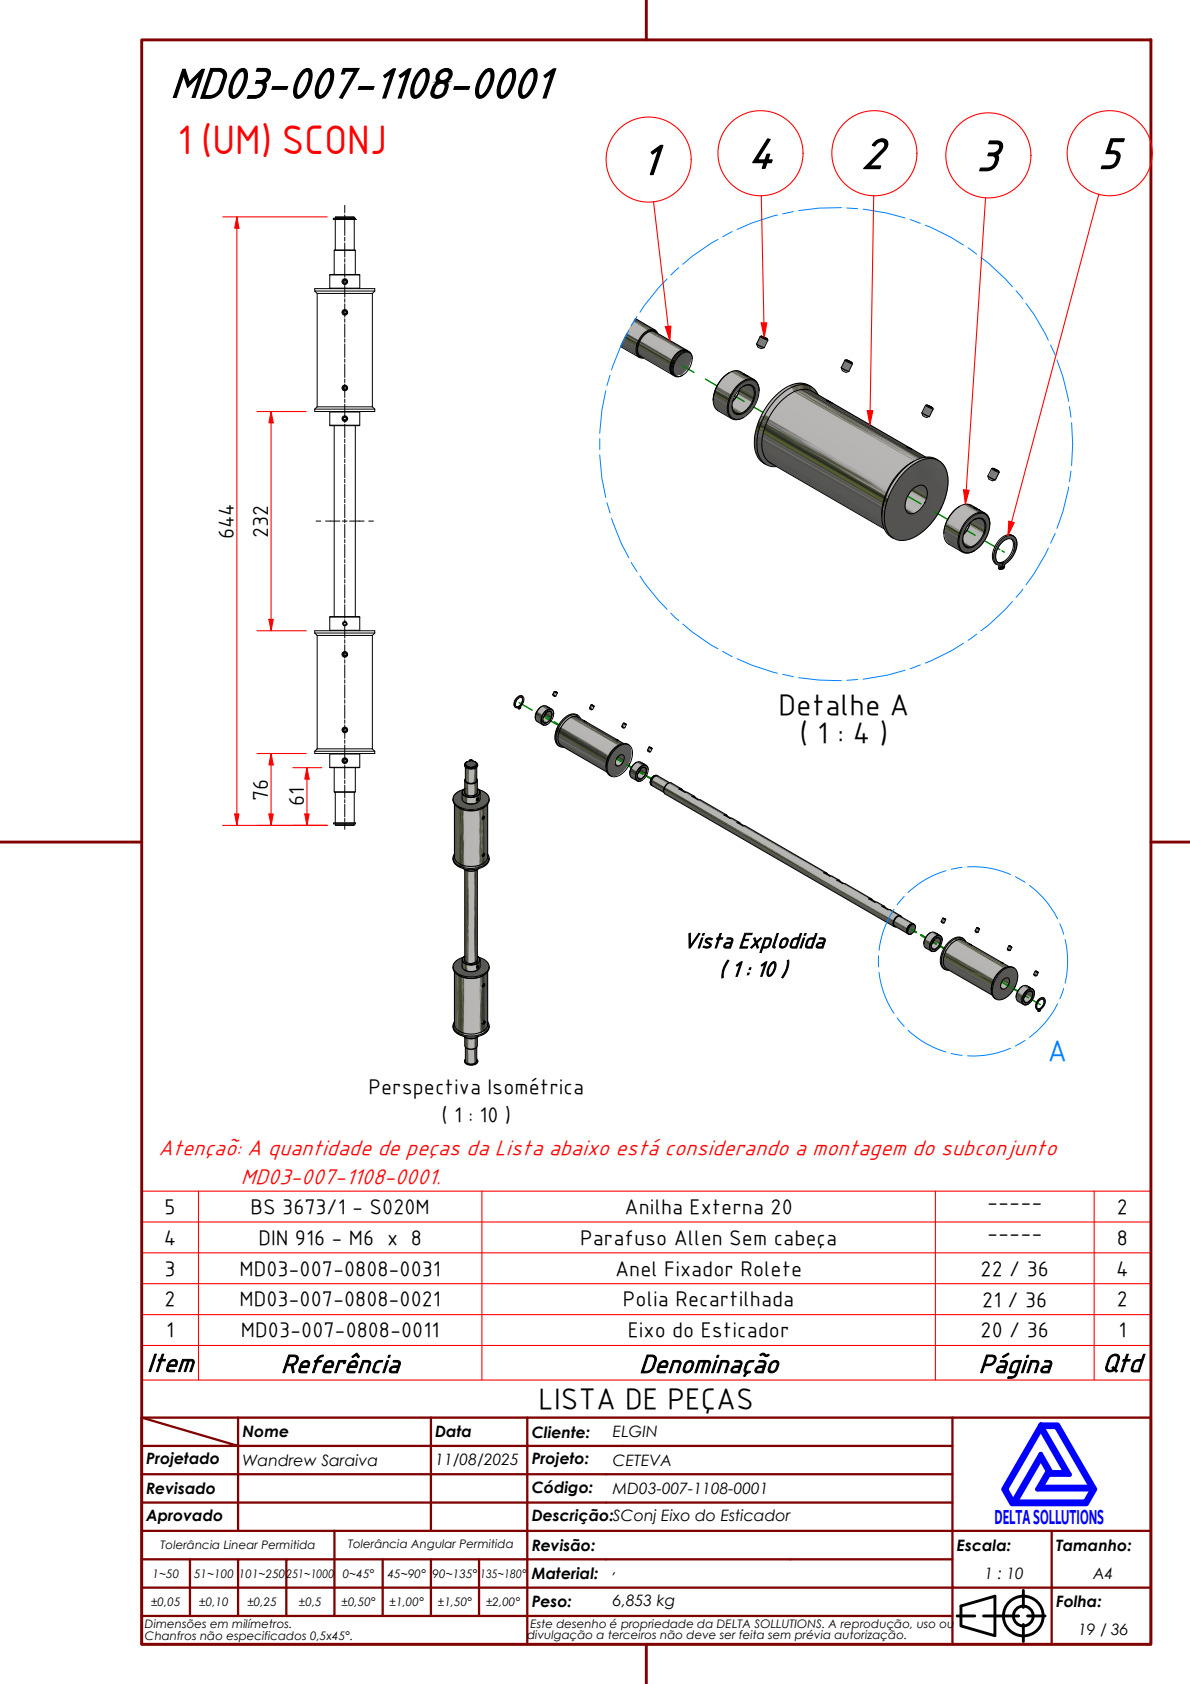
[picture p191: page 1]
Vista Explodida ( 1 : 10 ); Detalhe A ( 1 : 4 ); Perspectiva Isométrica ( 1 : 10 ); 1 (UM) SCONJ

Atençaõ: A quantidade de peças da Lista abaixo está considerando a montagem do subconjunto

5 | BS 3673/1 - S020M | Anilha Externa 20 | ----- | 2
4 | DIN 916 - M6 x 8 | Parafuso Allen Sem cabeça | ----- | 8
3 | MD03-007-0808-0031 | Anel Fixador Rolete | 22 / 36 | 4
2 | MD03-007-0808-0021 | Polia Recartilhada | 21 / 36 | 2
1 | MD03-007-0808-0011 | Eixo do Esticador | 20 / 36 | 1
Item | Referência | Denominação | Página | Qtd

LISTA DE PEÇAS

Projetado | Nome | Data | Cliente: ELGIN | | DELTA SOLLUTIONS

Wandrew Saraiva | 11/08/2025 | Projeto: CETEVA

Revisado | | | Código: MD03-007-1108-0001

Aprovado | | | Descrição: SConj Eixo do Esticador

Tolerância Linear Permitida | Tolerância Angular Permitida | Revisão: | Escala: 1 : 10 | Tamanho: A4

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

±0,05 | ±0,10 | ±0,25 | ±0,5 | ±0,50° | ±1,00° | ±1,50° | ±2,00° | Peso: 6,853 kg | Folha: 19 / 36

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
