pvrezende/Dashboard/uploads/anexo-1755690163643-576966969.pdf

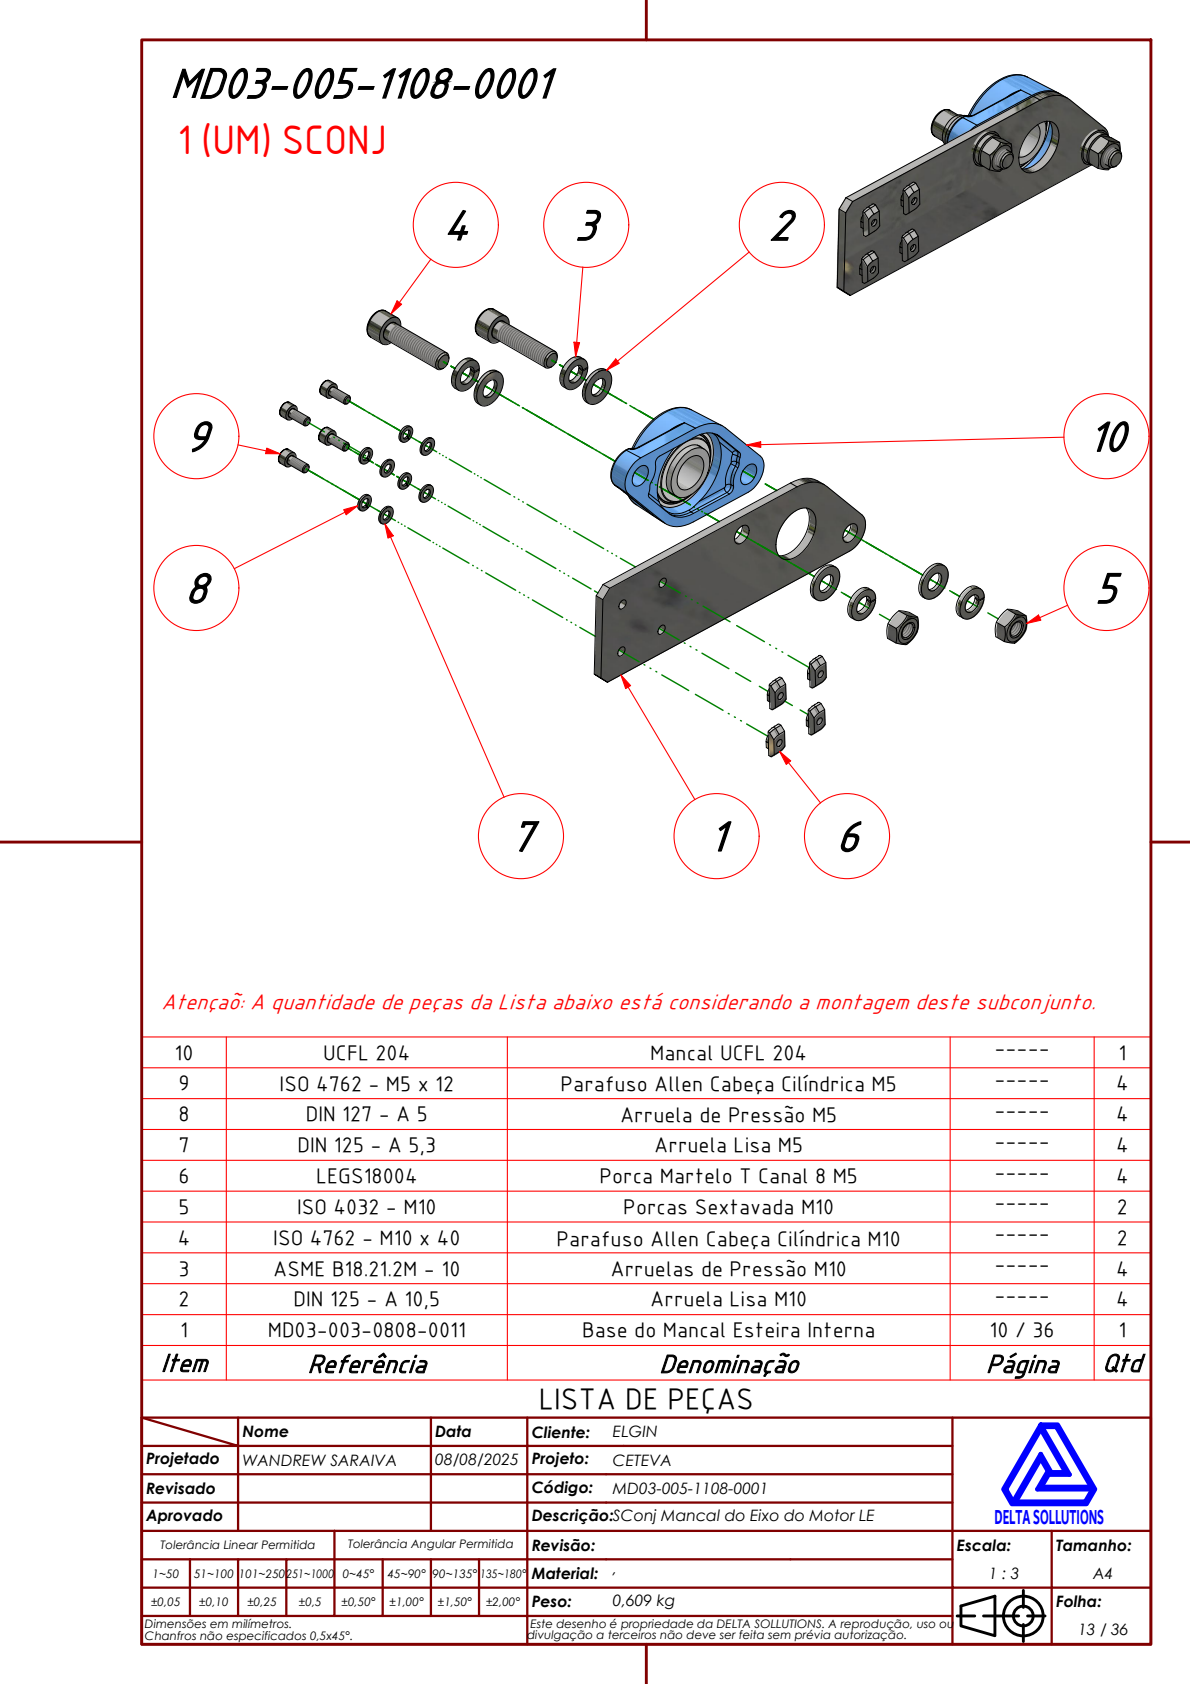
[picture p192: page 1]
1 (UM) SCONJ

Atençaõ: A quantidade de peças da Lista abaixo está considerando a montagem deste subconjunto.

10 | UCFL 204 | Mancal UCFL 204 | ----- | 1
9 | ISO 4762 - M5 x 12 | Parafuso Allen Cabeça Cilíndrica M5 | ----- | 4
8 | DIN 127 - A 5 | Arruela de Pressão M5 | ----- | 4
7 | DIN 125 - A 5,3 | Arruela Lisa M5 | ----- | 4
6 | LEGS18004 | Porca Martelo T Canal 8 M5 | ----- | 4
5 | ISO 4032 - M10 | Porcas Sextavada M10 | ----- | 2
4 | ISO 4762 - M10 x 40 | Parafuso Allen Cabeça Cilíndrica M10 | ----- | 2
3 | ASME B18.21.2M - 10 | Arruelas de Pressão M10 | ----- | 4
2 | DIN 125 - A 10,5 | Arruela Lisa M10 | ----- | 4
1 | MD03-003-0808-0011 | Base do Mancal Esteira Interna | 10 / 36 | 1
Item | Referência | Denominação | Página | Qtd

LISTA DE PEÇAS

Projetado | Nome | Data | Cliente: ELGIN | | DELTA SOLLUTIONS

WANDREW SARAIVA | 08/08/2025 | Projeto: CETEVA

Revisado | | | Código: MD03-005-1108-0001

Aprovado | | | Descrição: SConj Mancal do Eixo do Motor LE

Tolerância Linear Permitida | Tolerância Angular Permitida | Revisão: | Escala: 1 : 3 | Tamanho: A4

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

±0,05 | ±0,10 | ±0,25 | ±0,5 | ±0,50° | ±1,00° | ±1,50° | ±2,00° | Peso: 0,609 kg | Folha: 13 / 36

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
