pvrezende/Dashboard/uploads/anexo-1755691489625-74462948.pdf

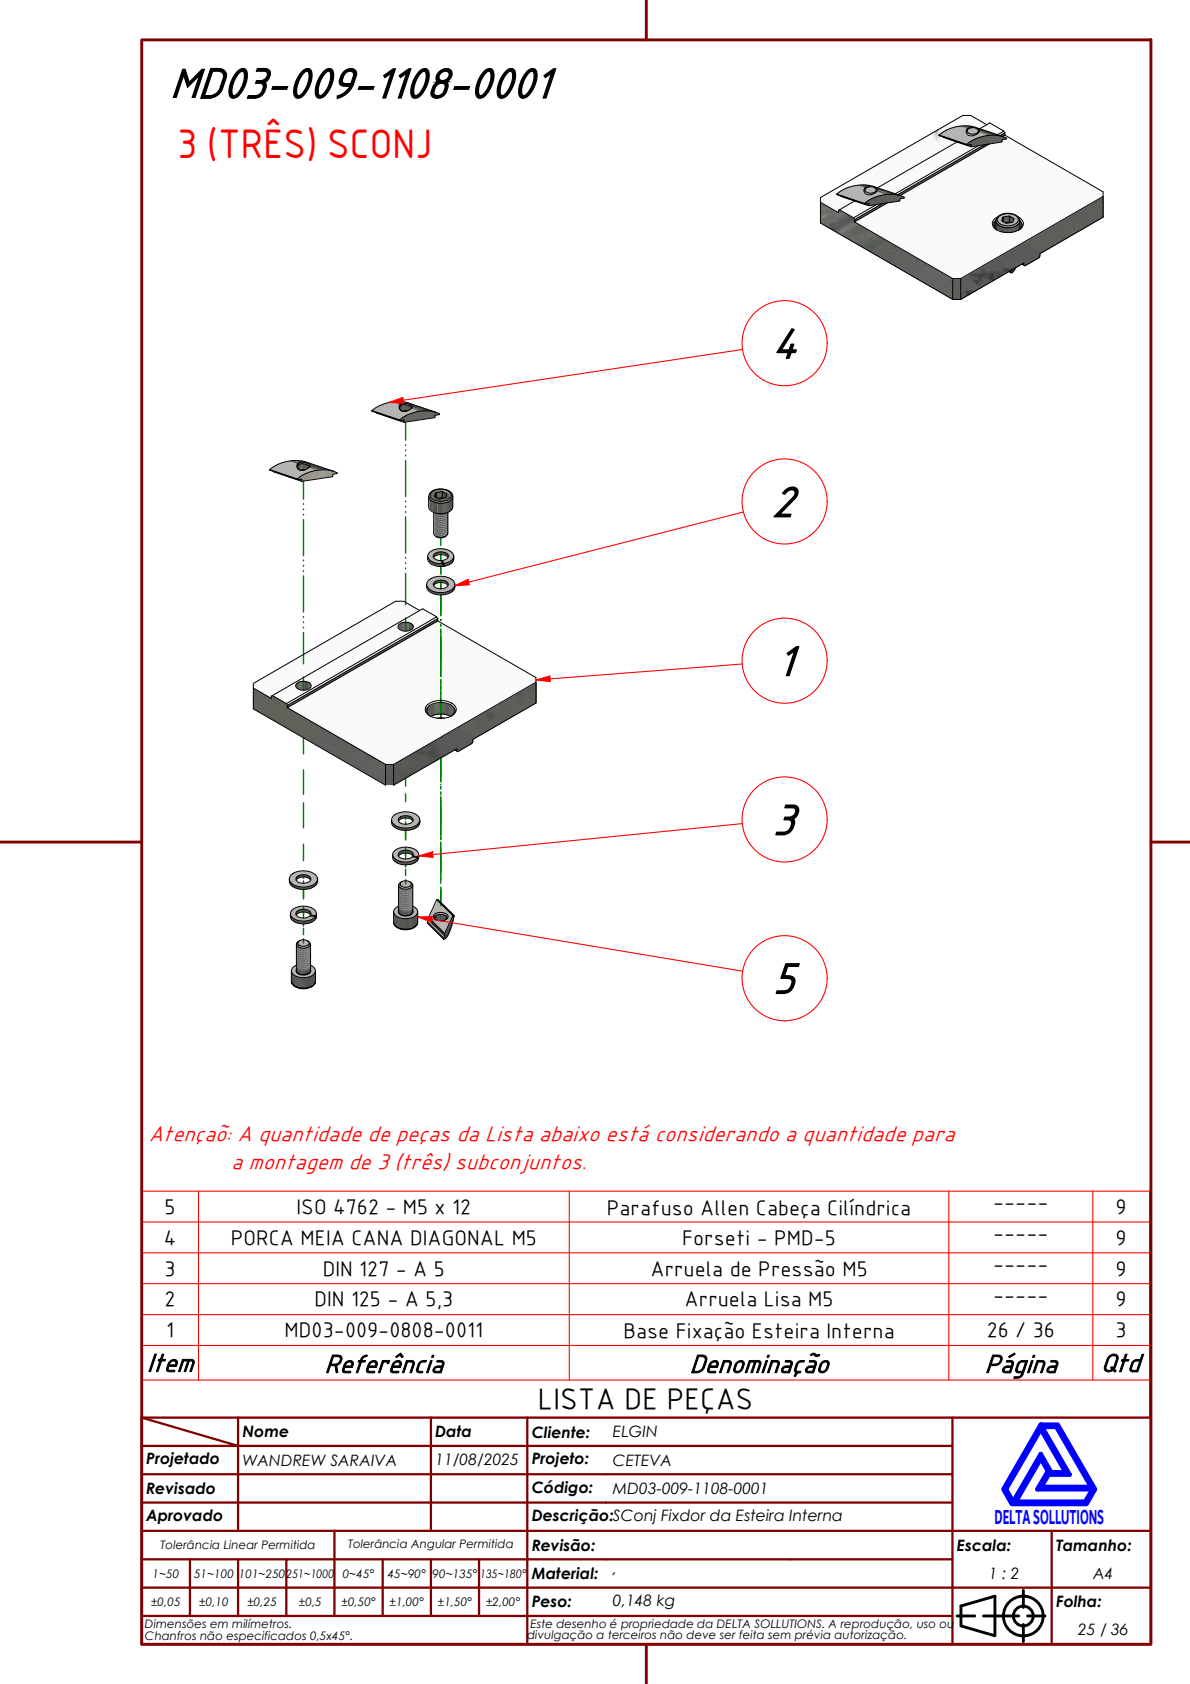
[picture p193: page 1]
3 (TRÊS) SCONJ

Atençaõ: A quantidade de peças da Lista abaixo está considerando a quantidade para

a montagem de 3 (três) subconjuntos.

5 | ISO 4762 - M5 x 12 | Parafuso Allen Cabeça Cilíndrica | ----- | 9
4 | PORCA MEIA CANA DIAGONAL M5 | Forseti - PMD-5 | ----- | 9
3 | DIN 127 - A 5 | Arruela de Pressão M5 | ----- | 9
2 | DIN 125 - A 5,3 | Arruela Lisa M5 | ----- | 9
1 | MD03-009-0808-0011 | Base Fixação Esteira Interna | 26 / 36 | 3
Item | Referência | Denominação | Página | Qtd

LISTA DE PEÇAS

Projetado | Nome | Data | Cliente: ELGIN | | DELTA SOLLUTIONS

WANDREW SARAIVA | 11/08/2025 | Projeto: CETEVA

Revisado | | | Código: MD03-009-1108-0001

Aprovado | | | Descrição: SConj Fixdor da Esteira Interna

Tolerância Linear Permitida | Tolerância Angular Permitida | Revisão: | Escala: 1 : 2 | Tamanho: A4

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

±0,05 | ±0,10 | ±0,25 | ±0,5 | ±0,50° | ±1,00° | ±1,50° | ±2,00° | Peso: 0,148 kg | Folha: 25 / 36

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
