pvrezende/Dashboard/(commit log)

2025-12-10 Primeiro commit subindo para aws
    [BOM - MIDEA.xlsx]
2025-12-10 Adicionando a pasta uploads
    [anexo-1751643768782-981930391.ipt, anexo-1751643780337-355326594.dwg, anexo-1753897428863-523399233.ipt, anexo-1753907579141-375331155.ipt, anexo-1753908394499-345636678.ipt, anexo-1753908779612-905146315.ipt, anexo-1753910552024-620583933.ipt, anexo-1753971729075-584286076.ipt]
2025-12-10 Adicionando o arquivo rar de segurança
